chithigun23/DesktopSpeaker/ai-files/reports/web-viewer-realism-2026-11-03/mobile_gallery.jpg

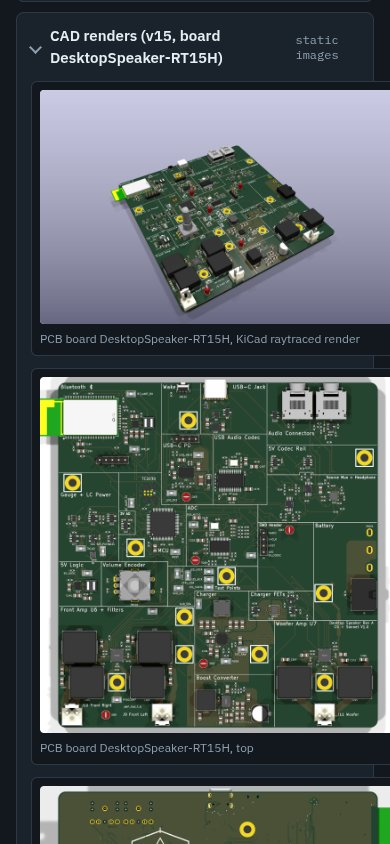
ai-files/reports/web-viewer-realism-2026-11-03/mobile_gallery.jpg
