chithigun23/DesktopSpeaker/ai-files/bom/hardware-buy-list.md

# Hardware and consumables buy list (one unit + second-unit column)

First compiled 2026-10-12; **updated 2026-11-03 for the fastener schedule and the CAD completeness review fixes** (`reports/fastener-schedule-2026-11-03.md`, `reports/project-review-cad-completeness-2026-11-03.md`, decisions in `reports/review-fixes-2026-11-03.md`). Everything needed to build one complete DesktopSpeaker that is NOT on `bom/DesktopSpeaker_JLC_BOM.csv` (SW101 is excluded from that BOM and is listed here). Machine-readable source: `bom/hardware-buy-list.csv`; this file is rendered from it by `helpers/render_hardware_buylist_md.py` (# = CSV data row, numbering stable: new lines are appended at the end, superseded lines keep their number with quantity 0 and a dated note).

**All prices and stock figures are snapshots (2026-10-12 or 2026-11-03, date per line; some from search-result snippets). They are not quotes. Re-check every line at order time. Shipping, GST/import duty and currency fees are not included.** Digi-Key, Mouser, LCSC, Parts Express and Tag-Connect prices are USD; Australian stores are AUD (Core, Jaycar and Bolt and Nut figures include GST). Digi-Key AU prices are AUD **ex GST**; Polymax is GBP inc VAT. Totals convert USD at an ASSUMED 1.50 AUD/USD and GBP at 2.00 AUD/GBP (rates not looked up).

Price status: **confirmed** = price read from the store page/listing; **estimate** = guessed or snippet-only figure; **TBD** = no source or quote; **printed** = made from the filament line, no purchase; lines marked *optional* or *superseded* are excluded from subtotals. Spares: at least 10 % on every new fastener and seal line (2026-11-03).

## Drivers

| # | Item | Qty (unit 1) | 2nd unit | Spec | Source / part number | Unit price | Line price | Stock / date | Status | Notes |
|---|---|---|---|---|---|---|---|---|---|---|
| 1 | Full-range driver Dayton Audio ND65-4 | 2 | 2 | 2.5 in aluminium cone, 4 ohm, 64 mm flange | [Parts Express (US)](https://www.parts-express.com/Dayton-Audio-ND65-4-2-1-2-Aluminum-Cone-Full-Range-Driver-290-204): 290-204 | USD 23.98 | USD 47.96 | 395 in stock (PE page via search, undated) | confirmed | Rear-mounted; needs 59.5 mm aperture (CAD has it). Solder tabs: no connectors needed at the driver. |
| 2 | Woofer Tang Band W3-2052SC | 1 | 1 | 3 in, 4 ohm, flange 82.55, cutout 76.2 | [Parts Express (US)](https://www.parts-express.com/Tang-Band-W3-2052SC-3-RBM-Neodymium-Subwoofer-4-Ohm-299-572): 299-572 | USD 29.98 | USD 29.98 | In stock, ships next business day (PE page 2026-10-12) | confirmed | 2026-11-03: CAD v13+ geometry: square 82.55 frame (R4), 4 x 3.4 holes on a 96.52 mm bolt circle (68.25 mm square), frame block 13.3, factory 3.3 mm foam gasket, seated directly on the floor (no ring, no recess); screws button post-Torx M3x20 (row 44). All are photo estimates (+-1.5): caliper the sample before printing; check its termination (PHR-2 pigtail in the photo, UNVERIFIED). Was: Bolt circle/hole size UNVERIFIED; measure before fixing screws (CAD v11.2 conflict, clamp-ring fallback). |

## Acoustic

| # | Item | Qty (unit 1) | 2nd unit | Spec | Source / part number | Unit price | Line price | Stock / date | Status | Notes |
|---|---|---|---|---|---|---|---|---|---|---|
| 3 | Acoustic stuffing Acousta-Stuf polyfill | 1 bag (454 g) | 0 (bag covers) | polyester fill; 2026-11-03: 6-8 g per unit in the woofer chamber only, loose, 10 mm off the magnet and the cone back (Qtc about 0.70); the main chamber gets the 10 mm foam lining (row 54). Was: polyester fill; about 30 g per unit (about 10 g woofer chamber, about 20 g main chamber, ASSUMED) | [Parts Express (US)](https://parts-express.com/Acousta-Stuf-Polyfill-1-lb.-Bag-260-317): 260-317 | USD 15.98 | USD 15.98 | In stock on product page; back-ordered on category page (conflicting snapshots) | confirmed | Tune by ear/measurement; one bag serves many units. |
| 4 | Acoustic grille cloth, black | 1 yd (70 in wide) | 0 (covers) | polyester, not flame retardant | [Parts Express (US)](https://www.parts-express.com/Speaker-Grill-Cloth-Black-Yard-70-Wide-260-335): 260-335 | USD 9.98 | USD 9.98 | Listed (category page 2026-10-12) | confirmed | Backs the front grille plate; Mellotone 260-332 is the flame-retardant option (USD 26.80/yd). 2026-11-03: also backs the woofer grille against debris (review S13); the yard covers both plates. |
| 54 | Acoustic lining for the main chamber, about 10 mm (wadding or open-cell foam) | 1 sheet | 0 (covers) | about 0.04 m2: top wall over the drivers (not under the cable path) and the side walls in front of the insert; keeps fibres off the PCB, encoder and jacks | [Jaycar (AU)](https://www.jaycar.com.au/650gsm-acrylic-speaker-dampening-material/p/AX3694): Jaycar AX3694 650 gsm acrylic speaker dampening material | TBD | TBD | not read (Jaycar returned 403) | TBD | 2026-11-03: UNVERIFIED (price, size and thickness not read; 650 gsm wadding is usually thicker than 10 mm uncompressed: trim or compress). Fallback Monacor MDM-3002 open-cell PU foam 480 x 378 x 10 mm, GBP 13.35 ex VAT (Rapid Online UK, UNVERIFIED). |

## Switch

| # | Item | Qty (unit 1) | 2nd unit | Spec | Source / part number | Unit price | Line price | Stock / date | Status | Notes |
|---|---|---|---|---|---|---|---|---|---|---|
| 5 | Battery rocker SW101 CW Industries GRB112B802BR1 | 1 | 1 | SPST 20 A/14 VDC, 20.2 mm hole + key, 0.187 in fastons, panel 1.5-2.5 | [Digi-Key](https://www.digikey.com/en/products/detail/cw-industries/GRB112B802BR1/2349683): GRB112B802BR1 (DK 2349683) | USD 5.09 | USD 5.09 | 7,073 (reports/sourcing-2026-10-12.md) | confirmed | Not on the JLC BOM (panel part). LED unused on the 1S rail. |

## Connectors

| # | Item | Qty (unit 1) | 2nd unit | Spec | Source / part number | Unit price | Line price | Stock / date | Status | Notes |
|---|---|---|---|---|---|---|---|---|---|---|
| 6 | Faston receptacle 0.187 in, fully insulated, 22-18 AWG | 3 | 3 | tab 0.187 x 0.032 in (4.75 x 0.8), red | [Digi-Key](https://www.digikey.com/en/products/result?keywords=2-520194-2): TE 2-520194-2 (DK A27806-ND) | USD 0.35 | USD 1.05 | 58,881 (DK 2026-10-12) | confirmed | 2 used (in/out), 1 to insulate the unused lamp tab. Tab thickness 0.032 assumed from the CAD stand-in (4.8 x 0.8). Note 2-520184-2 is the 0.250 in size (wrong). |
| 7 | J5 mating housing Molex Micro-Fit 3.0 receptacle 3-way | 1 | 1 | 43645-0300, 3.0 mm pitch | [Digi-Key](https://www.digikey.com/en/products/result?keywords=0436450300): Molex 43645-0300 (DK WM1846-ND) | USD 0.42 | USD 0.42 | 115,485 (DK 2026-10-12) | confirmed | Pack RFQ asks the vendor to fit this housing; then this line is a spare/service lead. |
| 8 | Micro-Fit female crimp, 18 AWG, tin (PACK+/PACK-) | 1 strip of 100 | 0 (covers) | 43030-0038, 18 AWG, insulation OD <= 1.85 | [Digi-Key](https://www.digikey.com/en/products/detail/molex/0430300038/6098601): Molex 43030-0038 (DK WM13070CT-ND) | USD 8.19 | USD 8.19 | 583,204 (DK 2026-10-12); cut tape min 100 | confirmed | 43030-0007 does NOT take 18 AWG (20-24 AWG only). Check silicone wire OD against 1.85 mm (FIT0585 OD not stated). |
| 9 | Micro-Fit female crimp, 20-24 AWG, tin (NTC pin) | 2 | 1 | 43030-0007 | [Digi-Key](https://www.digikey.com/en/products/result?keywords=0430300007): Molex 43030-0007 (DK WM1837-ND) | USD 0.2 | USD 0.40 | 701,377 (DK 2026-10-12) | confirmed | For the 24 AWG NTC lead; a 26 AWG lead needs a 26-30 AWG terminal instead. |
| 10 | J9-J11 mating housing JST VHR-2N | 3 (MOQ 20) | 0 (MOQ covers) | VH 3.96 mm, 2-way | [LCSC](https://datasheet.lcsc.com/lcsc/2304140030_JST-VHR-2N_C157900.pdf): JST VHR-2N (LCSC C157900) | USD 0.031 | USD 0.62 | about 249,600 (LCSC listing via search 2026-10-12) | confirmed | Order with the JLC/LCSC batch. Digi-Key alternative 455-VHR-2N-ND USD 0.11 (90,067). |
| 11 | JST VH crimp SVH-21T-P1.1 | 6 (MOQ 100) | 0 (MOQ covers) | 18-22 AWG | [LCSC](https://www.lcsc.com/product-detail/C160349.html): JST SVH-21T-P1.1 (LCSC C160349) | USD 0.0282 | USD 2.82 | 247,900 (LCSC 2026-10-12) | confirmed | Digi-Key sells it on full reels only. |

## Wire

| # | Item | Qty (unit 1) | 2nd unit | Spec | Source / part number | Unit price | Line price | Stock / date | Status | Notes |
|---|---|---|---|---|---|---|---|---|---|---|
| 12 | Speaker wire 20 AWG figure-8 | 1 m | 1 m | 2 x 20/0.18; drivers 2 x about 0.25 m + woofer about 0.15 m (J11 lead through the grommet) | [Core Electronics (AU)](https://core-electronics.com.au/20-awg-figure-8-speaker-cable-per-metre.html): AW2116 | AUD 1.7 | AUD 1.70 | 127 (Core 2026-10-12) | confirmed | Jaycar WB1704 (21 AWG, A$0.80/m) is an alternative. 2026-11-03 (review S9 slack for the assembly order): cut J9 about 110 mm, J10 modelled + 40 (about 336 / 292 mm), J11 adapter modelled + 40 (about 235 mm): about 0.7 m of pair; 1 m still covers. |
| 13 | Silicone wire 18 AWG, 1 m red + 1 m black | 1 pack (optional) | 0 (optional) | 0.75 mm2 tinned, 22 A, -60..200 C | [Core Electronics (AU)](https://core-electronics.com.au/high-temperature-resistant-silicone-wire-18awg-0-75mm2-1m-red-black.html): DFRobot FIT0585 | AUD 5.28 | AUD 5.28 | 17 (Core 2026-10-12) | confirmed (optional, excluded) | 2026-11-03: optional alternative for the rocker leads (more flexible; insulation OD not stated, too thick for Micro-Fit crimps). Default is the thin-wall 18 AWG wire of row 57 for both the rocker leads and a J5 service lead. Was: Rocker leads (2 x about 0.12 m) and a spare/DIY pack lead. RFQ lead is 150 mm but the CAD harness route is about 230 mm: align before ordering the pack. (2026-11-03: the 1S4P RFQ asks for about 180 mm; CAD v15 route about 131 mm.) |
| 57 | Thin-wall hook-up wire 18 AWG ETFE, OD 1.52 mm, 2 ft red + 2 ft black | 4 ft (2 + 2) | 4 ft | TE Raychem Spec 55, 19/30 tinned copper, 600 V, -65..150 C. Rocker SW101 leads 2 x about 150 mm with a 60-80 mm service loop; J5 service/spare lead (fits the Micro-Fit 43030-0038, insulation max 1.85) | [Digi-Key AU](https://www.digikey.com.au/en/products/detail/te-connectivity-raychem-cable-protection/55A0111-18-0/2399856): TE 55A0111-18-0 black (A$2.67/ft) + 55A0111-18-2 red (A$2.53/ft) | AUD 2.60 | AUD 10.40 | 2,217 ft black / 3,256 ft red (DK AU 2026-11-03) | confirmed | 2026-11-03: VERIFIED. Unit price is the mean of the two colours per foot (line = 2 x 2.67 + 2 x 2.53). 18 AWG kept for the rocker (pack current path, up to about 9 A); the 20 AWG 55A0111-20-x (OD 1.27, A$1.93/ft) was not chosen. Row 13 silicone becomes optional. |

## Mechanical

| # | Item | Qty (unit 1) | 2nd unit | Spec | Source / part number | Unit price | Line price | Stock / date | Status | Notes |
|---|---|---|---|---|---|---|---|---|---|---|
| 14 | Encoder knob (SW102) | 0 (superseded 2026-11-03) | 1 | 29 x 14 mm solid aluminium, grub screw, 1/4 in (6.35) bore | [Jaycar (AU)](https://www.jaycar.com.au/29mm-black-anodised-knob/p/HK7011): HK7011 | AUD 10.95 | AUD 0.00 | Available for delivery (Jaycar category page 2026-10-12) | superseded | 2026-11-03: superseded by row 64 (true 6 mm bore; the 6.35 bore sits 0.35 mm off-centre on the 6 mm shaft). Was: ASSUMED fit: 6.35 bore on the 6 mm D shaft with the grub screw on the flat (0.35 mm offset). 29 mm in the 36 mm dish (3.5 mm radial gap). No 30 mm 6 mm-D knob found in AU stock; UK alternative Cliff CL172989 (30 x 13, 6 mm set screw, GBP 7.01, Maplin Pro). |
| 15 | Heat-set insert M3 x 5.7, OD 4.6, hole 4.0 | 1 bag of 100 | 0 (51 + 46 = 97 of 100) | brass, 46 per unit (2026-11-03: lid 11, drivers 8, woofer 4, PCB 11, feet 4, knob cup 4, woofer-chamber insert 4); 51 with 10 % spares | [RS Australia](https://ie.rs-online.com/web/p/products/2040616): RS PRO 204-0616 | AUD 30 | AUD 30.00 | AUD price/stock NOT read (RS AU blocks fetch); IE price EUR 17.39 ex VAT per 100 | estimate | AUD figure is an estimate. Confirmed but expensive fallback: Amazon AU ruthex GE-M3x57-001 A$76.59 in stock (2026-10-12); 3DJake EUR 7.49 + EUR 40.49 DHL to AU. |
| 16 | Socket cap screw M3 x 10, 316 stainless | 0 (superseded 2026-11-03) | 0 (23+23 = 46) | ISO 4762 type; 23 per unit (8 drivers + 4 woofer + 11 lid) | [Miniature Bearings Australia](https://miniaturebearings.com.au/collections/screws-socket-cap-stainless): SC030M-010-C-SK-S6 | AUD 8.77 | AUD 0.00 | Available (store JSON 2026-10-12) | superseded | 2026-11-03: superseded everywhere (lid, drivers, knob cup, insert: row 40; woofer: row 44). Was: 2026-11-03: drivers and lid now use the countersunk post-Torx T10 M3x10 (lines 41-43); the woofer uses M3x20 since CAD v13 (not on this list). Was: Woofer screws may change (bolt circle unverified; M2.5 or clamp-ring fallback). |
| 17 | Socket cap screw M3 x 16, 304 stainless | 0 (superseded 2026-11-03) | 0 (covers) | 11 per unit (PCB H1-H9, HA1, HA2) | [Miniature Bearings Australia](https://miniaturebearings.com.au/collections/screws-socket-cap-stainless): SC030M-016-C-SK-S4 | AUD 7.68 | AUD 0.00 | Available (store JSON 2026-10-12) | superseded | 2026-11-03: superseded by button post-Torx M3x10 (row 43) on Wurth 971100321 M/F standoffs (row 46); ball-end hex keys are not used any more. Was: H8 sits under the knob dish floor: drive with a 2.5 mm ball-end key before the lid goes on. |
| 18 | Socket cap screw M3 x 6, 304 stainless (OPTIONAL) | 0 (8 if pads removed) | 0 | only if the 11 mm driver pads are removed (3 mm baffle) | [Miniature Bearings Australia](https://miniaturebearings.com.au/collections/screws-socket-cap-stainless): SC030M-006-C-SK-S4 (pack 100) | AUD 9.59 | AUD 0.00 | Available (store JSON 2026-10-12) | confirmed (optional, excluded) | Not needed for the v11.2 CAD (pads present). Excluded from subtotals. |
| 19 | Hex spacer M3 F/F 10 mm, 5.5 AF | 0 (superseded 2026-11-03) | 11 | steel zinc, WA-SSTII | [Digi-Key](https://www.digikey.com/en/products/result?keywords=970100321): Wurth 970100321 (DK 732-10541-ND) | USD 0.29 | USD 0.00 | 26,262 (DK 2026-10-12) | superseded | 2026-11-03: superseded by the M/F standoff Wurth 971100321 (row 46, steel) and a nylon standoff at H9 (row 47). Was: PCB stack: roof z 57 -> 10 mm spacer -> PCB -> M3x16. |
| 20 | Feet stud M3 M/F, 12 mm body, 6 mm male | 4 | 4 | steel; = RS 176-8061 | [Digi-Key](https://www.digikey.com/en/products/result?keywords=1768061): Wurth 971120321 (DK, page search) | USD 0.48 | USD 1.92 | 3,120 (DK 2026-10-12) | confirmed | The brief's "Wurth 1768061" is the RS stock number 176-8061; the Wurth MPN is 971120321. |
| 21 | Rubber foot disc 12.7 dia x 3.5 | 0 (superseded 2026-11-03) | 4 | 3M Bumpon SJ5312 clear PU dome, adhesive | [element14 AU](https://my.element14.com/3m/sj-5312-clear/feet-protective-bumper-pu-3-5mm/dp/2674622): 3M SJ-5312 CLEAR (e14 2674622) | AUD 0.35 | AUD 0.00 | AUD not read; Farnell IE EUR 0.19, 2,270-2,763 in stock | superseded | 2026-11-03: a glued bumper on the 5.5 AF stud end shears off when the speaker is slid (review S12): superseded by screw-in rubber feet (row 63). Was: 12.7 x 3.5 vs CAD 12 x 3: feet gap 15.5 instead of 15. Glue to the stud end (5.5 AF face is small; add CA/epoxy). |
| 22 | Nylon flat washer M3 (lid screw seal) | 0 (removed 2026-11-03, superseded) | 11 | 3.2 x 8.0 x 0.8 nylon | [Digi-Key](https://www.digikey.com/en/products/result?keywords=nylon%20washer%20M3%20flat): Essentra 16M03080080 | USD 0.1 | USD 0.00 | 30,563 (DK 2026-10-12) | superseded | 2026-11-03: removed: a flat washer cannot sit under the flush countersunk lid screws. The 4 lid screws inside the woofer-chamber loop get foam washers cut from the 1.5 mm sheet in boss counterbores (CAD v16) or a non-curing butyl dab. Was: Plain nylon washer, not a bonded sealing washer (none found in AU stock); add a dab of sealant if the lid leaks. |
| 23 | Snap bushing / grommet, woofer leads | 2 | 1 | Heyco 2000: 0.250 in (6.35) hole, panel <= 0.062 in (1.57), ID 0.140 in (3.56), PA66 black | [Digi-Key](https://azcus.digikey.com/en/products/detail/heyco-products-corporation/2000/15906424): Heyco 2000 (DK 3720-2000-ND) | USD 0.1 | USD 0.20 | 265,521 (DK via search 2026-10-12) | confirmed | 2026-11-03: CAD v16 sets the hole to 6.35 mm and the web to 1.5 mm (inside the 1.57 rating); no reaming. Re-checked on Digi-Key AU 2026-11-03: A$0.15 ex GST, 221,582 in stock, lead time 3 weeks. ID: Digi-Key 3.56 mm (0.140 in) but a GlobalSpec datasheet copy says 0.125 in (3.18): the J11 pair (2 x OD 1.75 = 3.5 x 1.75) needs the 3.56 figure: confirm on the part. Was: CAD hole is 6.0: ream to 6.35 or change the CAD to 6.35. Web is 1.6 (0.03 over the 1.57 rating, check fit). Seal leads with Sikaflex. |
| 24 | Hook-and-loop strap (battery) | 1 | 1 | 2026-11-03 (1S4P pack): loop about 330 mm (2 x (87 + 22) + anchors): order >= 350 mm. CE09642 is 300 mm (210 loop + 60 hook): too short for 1S4P; width NOT stated | [Core Electronics (AU)](https://core-electronics.com.au/hook-and-loop-strap-with-buckle.html): CE09642 | AUD 0.39 | AUD 0.39 | 399 (Core 2026-10-12) | estimate | 1S4P: one 20 mm strap around the brick in the X-Z plane (CAD v15, tunnels 22 x 2.5 in the two side anchor blocks). Order a >= 350 mm strap or cut one from the VELCRO ONE-WRAP 20 mm roll (element14 3499736, price not read). The price shown is for the 300 mm CE09642 (too short) and is kept as a placeholder. Width and buckle thickness UNVERIFIED. |
| 40 | Countersunk post-Torx (T10 security) machine screw M3 x 10, A2-70 (304) stainless | 30 | 27 | M3 x 0.5, 90 deg countersunk, head 5.90 x 2.00, T10 post (pin) Torx, length 10 overall incl. head; 27 per unit: 11 lid + 8 drivers (on cup washers, row 42) + 4 knob cup + 4 woofer-chamber insert; 30 with 10 % spares | [Bolt and Nut Australia (Hobson Engineering)](https://www.boltandnut.com.au/m3-x-0-50p-coarse-stainless-a2-70-g304-countersunk-post-torx-t10-machine-screws): 22CPTS310 (maker MPN YCXSA2M3X10) | AUD 0.63 | AUD 18.90 | 29,590 (page JSON 2026-11-03) | confirmed | 2026-11-03 fastener schedule: tiers per piece 10+ 1.00, 20+ 0.75, 30+ 0.63, 50+ 0.42 (50 cost AUD 21.00 and cover a second unit). Lid thread 6.0 below the lid, driver about 7.5 engaged (5.7 insert full). Was: qty 19, price not read. |
| 42 | Cup washer 6g (3.5 mm) G304 stainless, OD 11.0-11.4, ID 4.1-4.5, cup 2.1-2.3, 90 deg | 10 | 8 | under the countersunk M3 post-Torx heads on the 0.75 mm ND65 flanges (8 per unit) + 2 spares | [Bolt and Nut Australia (Hobson Engineering)](https://www.boltandnut.com.au/washers/cup-washers/6g-3-5mm-g304-stainless-cup-washers): 71CS6 | AUD 0.64 | AUD 6.40 | In stock (page 2026-11-03) | confirmed | 2026-11-03: replaces the unsourced 8 x 1.6 countersunk washer (same row). 10+ tier; 10 cost less than 9. Fit of the 5.90 head in the 6g cup calculated from geometry, not tested; CAD v16 checks the 11.4 OD against the ND65 basket ribs. |
| 43 | Button post-Torx (T10 security) machine screw M3 x 10, A2-70 (304) stainless | 12 | 10 | M3 x 0.5, button head 5.11-5.70 x 1.60-1.80, length 10 under the head; PCB H1-H8, HA1, HA2 into the Wurth 971100321 standoffs (8.4 mm in the steel thread); 10 per unit + 10 % + 1 so H9 can fall back to steel | [Bolt and Nut Australia (Hobson Engineering)](https://www.boltandnut.com.au/security-fasteners/machine-screws/m3-x-0-50p-coarse-stainless-a2-70-g304-button-post-torx-t10-machine-screws): 22BPTS310 | AUD 1.00 | AUD 12.00 | 20,345 (page JSON 2026-11-03) | confirmed | 2026-11-03 fastener schedule; replaces row 17 (M3x16 socket). Tiers 10+ 1.00, 20+ 0.70. H9 uses a nylon screw (row 48). |
| 44 | Button post-Torx (T10 security) machine screw M3 x 20, A2-70 (304) stainless | 5 | 4 | M3 x 0.5, button head 5.11-5.70 x 1.60-1.80, length 20 under the head; woofer W3-2052SC (frame 13.3 + factory gasket 3.3) | [Bolt and Nut Australia (Hobson Engineering)](https://www.boltandnut.com.au/security-fasteners/machine-screws/m3-x-0-50p-coarse-stainless-a2-70-g304-button-post-torx-t10-machine-screws): 22BPTS320 | AUD 1.60 | AUD 8.00 | 29,639 (page JSON 2026-11-03) | confirmed | 2026-11-03: replaces the never-listed ISO 4762 M3x20 (review 3.2 #1). Engagement 3.4 mm free / 4.4 mm compressed (marginal); 5.4-5.7 with the optional 2 mm floor-boss tweak after calipering. 20 is the longest M3 button post-Torx at Bolt and Nut. |
| 46 | Hex standoff M3 M/F, 10 mm body + 6 mm stud, 5.5 AF, steel zinc | 12 | 10 | PCB H1-H8, HA1, HA2: stud into the roof insert, button M3x10 into the female end; 10 per unit + 10 % + 1 for an H9 steel fallback | [Digi-Key](https://www.digikey.com/en/products/result?keywords=971100321): Wurth 971100321 (DK 732-10398-ND) | USD 0.33 | USD 3.96 | 32,433 (DK 2026-11-03) | confirmed | 2026-11-03: replaces row 19 (F/F 970100321 + M3x16). Female thread depth UNVERIFIED (RS listing: hole depth 10); if < 8.5 mm use button M3x8 (Bolt and Nut 22BPTS38). |
| 47 | Nylon (polyamide) hex standoff M3 M/F, 10 mm body + 8 mm stud, 6 mm hex, black (H9) | 2 | 1 | H9 only (nearest metal to the BM83 antenna, 16.3 mm): stud into the roof insert, nylon screw into the female end. **Trim the 8 mm stud to 6 mm** (pilot floor is 6.7 below the insert top) or add a nylon washer | [Digi-Key AU](https://www.digikey.com.au/en/products/detail/w%C3%BCrth-elektronik/971100365/9488760): Wurth 971100365 (DK 732-13056-ND) | AUD 1.33 | AUD 2.66 | 4,877 (DK AU 2026-11-03) | confirmed | 2026-11-03: VERIFIED. Wurth nylon M/F appears to come only with an 8 mm stud. Fallback Wurth 970100365 nylon F/F 10 mm (AUD 1.27, 2,424) is not usable here (no screw can enter the roof insert from below). Price ex GST (assumed; not labelled). |
| 48 | Nylon (PA66) machine screw M3 x 10, pan head Phillips (H9) | 2 | 1 | M3, 10 under the head, pan head 5.5 mm; through the PCB (1.6) into the nylon standoff (about 8.4 mm engaged) | [Digi-Key AU](https://www.digikey.com.au/en/products/detail/w%C3%BCrth-elektronik/97791003111/10056389): Wurth 97791003111 (DK 732-13706-ND) | AUD 0.38 | AUD 0.76 | 14,984 (DK AU 2026-11-03) | confirmed | 2026-11-03: VERIFIED. Not tamper-resistant (Phillips), acceptable inside the sealed box. Bolt and Nut showed no nylon M3 screw or standoff (partial read of the pan-head list; nylon washers only). |
| 63 | Screw-in rubber foot, M3 x 6 male stud, 8 mm dia x 8 mm (into the stud female end) | 5 | 4 | screws into the female end of the Wurth 971120321 foot stud (row 20); floor gap becomes 12 + 8 = 20 mm (CAD v16 updates the woofer gap and tipping). 4 + 1 spare | RS Components AU: RS PRO 196-1356 (M3 x 6 male buffer, 8 x 8 mm, 45 Shore A) | TBD | TBD | not read (RS AU returned 403) | TBD | 2026-11-03: UNVERIFIED. No 12-16 mm diameter buffer with an M3 stud was found anywhere (catalogue M3 buffers are 8 mm). Options: (a) this 8 x 8 M3 buffer on the stud (keeps the stud, small contact patch; a 12.7 mm Bumpon can be stuck on its face); (b) Ruland VMS8-8-M3-55-SSNR/10PK 8 x 8 (UNVERIFIED stock); (c) change the 4 foot inserts to M4 and drop the stud: Small Parts and Bearings CMB01513040MR60 15 x 13 mm M4 buffer (gap 13 mm; UNVERIFIED, site 429). Owner/CAD decision. Replaces row 21. |
| 64 | Encoder knob, knurled aluminium, 6.00 mm bore, 2 set screws, 31.75 mm skirt x 15.88 mm (SW102) | 1 | 1 | Kilo International DDS-90-4-7, black matte, skirted, arrow on the skirt; knurled body 23.5 mm. For the Alps EC11E18244AU 6 mm flat (D) shaft, 20 mm actuator (Alps product list: flat shaft, 20 mm) [the 6 mm diameter is from the CAD stand-in / EC11 family, D]. Tighten one set screw on the flat | [Digi-Key AU](https://www.digikey.com.au/en/products/detail/kilo-international/DDS-90-4-7/305224): Kilo DDS-90-4-7 (DK 305224) | AUD 26.82 | AUD 26.82 | 26 (DK AU 2026-11-03); maker lead time 12 weeks after stock | confirmed | 2026-11-03: VERIFIED (ex GST; A$29.50 inc). Replaces row 14 (6.35 bore). In the 36 mm cup: about 2.1 mm radial gap at the skirt; the knurled body above the skirt gives the grip the review S6 asked for; 15.88 tall vs the 14 mm stand-in, so CAD v16 must re-check the top height. No finger dimple. Fallbacks: Kilo DDS-75-3-7 (25.4 skirt, A$25.84, 37); Same Sky SAK-002 (28.9 x 12, 6 mm D bore: ideal, but MOQ 2268, not orderable); Altronics H6224 29 x 14 (A$5.05) has the 6.35 bore problem. |

## Seal

| # | Item | Qty (unit 1) | 2nd unit | Spec | Source / part number | Unit price | Line price | Stock / date | Status | Notes |
|---|---|---|---|---|---|---|---|---|---|---|
| 25 | Lid gasket cord, closed-cell EPDM sponge 3 mm | 0 (superseded 2026-11-03) | 0 (covers) | 0.75 m per unit (outer loop 0.51 + chamber U 0.23); allow 1 m | [Essentra Components AU](https://ecompreprod.essentracomponents.com/en-au/p/round-cord-gasket/551809): 551809 | AUD 9.52 | AUD 0.00 | Price from a search snippet of the Essentra AU preprod site; stock not read | superseded | 2026-11-03: 3 mm cord fills the 2.0 x 1.5 groove 235 % (review S4): superseded by 2 mm cord (row 50). Was: Verify on essentracomponents.com/en-au. Groove is 2 x 1.5: 3 mm sponge compresses about 50 %. |
| 26 | Driver/woofer gasket, closed-cell foam sheet 0.5-1 mm | 0 (superseded 2026-11-03) | 0 (covers) | 2 x 63 mm square rings (aperture 59.5) + 1 ring 83 OD/76.2 ID | NOT SOURCED: - | TBD | TBD | - | superseded | 2026-11-03: superseded by the sourced foam sheets rows 51-53 (3 mm for the driver gaskets per the coordinator; woofer ring only if the factory gasket is missing). Was: No source confirmed. PE gasket tape 260-542 is 3.2 mm thick and 12.7 wide: too thick/wide for the 0.5 mm recess. Use 0.5-1 mm neoprene/EPDM/PE foam sheet with adhesive. |
| 27 | PU sealant/adhesive Sikaflex-11FC, black 300 ml | 1 | 0 (covers) | 2026-11-03: grille plates and grommet leads only; the woofer-chamber insert is now screwed on a 1.5 mm foam gasket (removable), not bonded. Was: chamber insert to shell grooves, grille plates, grommet leads | [Bunnings (AU)](https://www.bunnings.com.au/sika-300ml-black-sikaflex-11fc-purform_p0628964): Sika 11FC black 300 ml (Bunnings p0628964) | AUD 27 | AUD 27.00 | Listed A$27 (Bunnings via search, undated) | confirmed | One PU product replaces separate epoxy/silicone. Needs a caulking gun. |
| 50 | Lid gasket cord, EPDM sponge 2 mm round | 2 m | 0 (covers) | lid groove 2.0 x 1.5: outer loop 0.51 + chamber U 0.23 = 0.75 m per unit; 2 m covers spares and one refit. Also usable for the woofer-chamber insert floor groove if CAD v16 cuts one | [Polymax (UK)](https://www.polymax.co.uk/epdm-sponge-cord-2mm): Polymax 2004200 | GBP 3.55 | GBP 7.10 | In stock (page 2026-11-03) | estimate | 2026-11-03: price VERIFIED (inc VAT, per metre); **closed-cell not stated on the page** (EPDM sponge cord normally is: confirm); 2.0 +-0.5 mm, 45 Shore A; AU freight not checked. No AU retail 2 mm source found (Associated Gaskets lists EPDM sponge cord from 3 mm). Replaces row 25. |
| 51 | Closed-cell foam sheet 2 mm, adhesive one side (connector-face seals) | about 150 x 100 mm | 0 (covers) | lid inner face around J1 (cut-out 8.6 x 2.9), J2/J3 (holes 5.0 or the v16 bore), SW100 (5.0): one die-cut piece or four pads; about 25 % compression against the connector faces | NOT SOURCED (Clark Rubber store cut suggested): - | TBD | TBD | - | TBD | 2026-11-03: UNVERIFIED: no A4-size adhesive 2 mm closed-cell sheet verified at an AU retailer (RS AU blocked fetches). Options: Clark Rubber or Foam Sales store cut; craft EVA self-adhesive A4 sheet (Spotlight/Officeworks, not verified, EVA is closed-cell). |
| 52 | Closed-cell neoprene self-adhesive tape 12 mm x 3 mm (driver gaskets, encoder washer) | 2 m | 0 (covers) | driver gaskets: 63 mm square frame of strips (ring width 1.75 mm at the flats, cut from the 12 mm strip), 2 drivers about 0.5 m; encoder washer ID 7 / **OD 12** (the strip is 12 mm wide; review asked OD 14) x 3 mm; woofer ring only if the sample has no factory gasket | [Clark Rubber (AU)](https://www.clarkrubber.com.au/products/15471p-neoprene-cr-self-adhesive-tape-3mm-black): Clark Rubber 15471P neoprene (CR) self-adhesive tape 3 mm | AUD 5.50 | AUD 11.00 | not shown (buy online or in store, 2026-11-03) | confirmed | 2026-11-03: price VERIFIED ("from" A$5.50 per metre on the category page; range stated closed-cell). Softer alternative Clark Rubber 15496P EPDM414 supersoft 12 x 3 mm from A$3.95/m. Replaces row 26. 3 mm is the coordinator choice: CAD v16 sets the driver recess for it. |
| 53 | Closed-cell foam sheet 1.5 mm, adhesive one side (woofer-chamber insert gasket, knob-cup ring, lid screw washers) | 1 piece about 200 x 150 mm | 0 (covers) | woofer-chamber insert floor gasket (removable insert), knob-cup flange ring (46 mm), 4 lid-screw washers ID 3.2 / OD 7.5 if CAD v16 adds the boss counterbores | [RS Components AU (or Clark Rubber store cut)](https://hkcn.rs-online.com/web/p/rubber-sheets/7336753): RS PRO 733-6731 closed-cell neoprene sponge 1.5 mm, 1 x 2 m (adhesive backing unconfirmed) | TBD | TBD | not read (RS AU returned 403) | TBD | 2026-11-03: UNVERIFIED (listings conflict on adhesive backing; 1 x 2 m is far more than needed). Alternatives: Inseal 3259 closed-cell PVC tape 1.5 x 30 mm x 50 m A$87.40 + GST (PB Tech, UNVERIFIED); a 2 mm cord in a groove instead of the flat gasket if CAD v16 chooses it. |
| 66 | Encoder foam washer ID 7 / OD 12 x 3 mm (cut from row 52) | 2 (1 + spare) | 1 | on the SW102 bushing top under the knob-cup floor, compresses to about 2.1 mm; closes the 1.25 mm radial shaft gap (review S1b, 28.5 mm2) | cut from row 52: - | - | - | - | cut (no purchase) | 2026-11-03: no purchase. |

## Grille

| # | Item | Qty (unit 1) | 2nd unit | Spec | Source / part number | Unit price | Line price | Stock / date | Status | Notes |
|---|---|---|---|---|---|---|---|---|---|---|
| 28 | Front grille plate 163 x 100, 0.8 mm, 2 x 56 dia perforated zones (2.0 holes / 3.0 pitch) | 1 order (5 pcs) | 0 (5 pcs) | SPEC CHANGE PROPOSED: 0.8 mm black FR4 with NPTH holes instead of aluminium | [JLCPCB (quote)](https://jlcpcb.com): own Gerber (to be drawn) | USD 15 | USD 15.00 | Not quoted | estimate | Estimate only. Metal option: Metal Mesh (Sefar AU) 1 mm aluminium 2.0/3.5 pitch, custom quote; RS PRO 202-7877 0.6 mm sheet is A$189/3 sheets with 1.5 mm holes (rejected). |
| 29 | Woofer grille disc 90 dia, 0.8 mm, holes to 64 dia | 1 order (5 pcs) | 0 (5 pcs) | same process as the front plate | [JLCPCB (quote)](https://jlcpcb.com): own Gerber (to be drawn) | USD 10 | USD 10.00 | Not quoted | estimate | Estimate only. |

## Print

| # | Item | Qty (unit 1) | 2nd unit | Spec | Source / part number | Unit price | Line price | Stock / date | Status | Notes |
|---|---|---|---|---|---|---|---|---|---|---|
| 30 | Filament PETG 1.75 mm, black, 1 kg | 1 | 1 | (384 + 101 + 60) cm3 x 1.27 g/cm3 = 692 g, +20 % = 831 g | [Jaycar (AU)](https://jaycar-prod.australia-southeast1.gcp.storefrontcloud.io/1-75mm-black-esun-petg-filament-1kg-roll/p/TL4465): eSUN PETG TL4465 | AUD 39.95 | AUD 39.95 | Listed A$39.95 (Jaycar via search, undated) | confirmed | STL volumes treated as solid (conservative). 831 g leaves little margin for a failed print. ASA is the heat/UV alternative. 2026-11-03: add the knob cup, 3 SW100 plungers and the tie bridges (small; volumes from CAD v16). One roll is tight: a second roll for reprints is advisable. |
| 67 | Printed main shell (PETG), incl. printed cable-tie bridges | 1 | 1 | CAD v16 (`ai-files/cad/v16/`): knob-cup opening and insert bosses, floor screw holes for the removable insert, tie bridges, cradle re-cut from the vendor drawing | printed (row 30): CAD v16 STL | - | - | - | printed (no purchase) | 2026-11-03: do not print before CAD v16 passes its insertion-path and tool-access check and the woofer has been calipered. |
| 68 | Printed rear lid 4 mm (PETG) | 1 | 1 | CAD v16: SW100 counterbore 7.4 x 1.0, gasket groove 2.0 x 1.5, 11 countersinks; vents drilled after printing (row 65) | printed (row 30): CAD v16 STL | - | - | - | printed (no purchase) | 2026-11-03: outer face on the bed; labels (if added in v16) print mirrored. |
| 69 | Printed woofer-chamber insert (PETG), removable | 1 | 1 | CAD v16: 4 boss feet with inserts for the floor screws, foam gasket land, grommet hole 6.35 / web 1.5 | printed (row 30): CAD v16 STL | - | - | - | printed (no purchase) | 2026-11-03: roof down, no supports (as v15). |
| 70 | Printed knob cup (PETG), new | 1 | 1 | CAD v16: 36 mm dish, 3 mm wall and floor, 8.5 shaft hole, 46 mm flange, 4 countersunk screw holes | printed (row 30): CAD v16 STL | - | - | - | printed (no purchase) | 2026-11-03: new part (review M1 option b). |
| 71 | Printed SW100 plunger (PETG), 3 variants | 3 (fit 1) | 3 | nub lengths 0.4 / 0.6 / 0.8 mm; shank 4.6, flange 7.0 x 0.8, nub 1.8 dia | printed (row 30): CAD v16 STL | - | - | - | printed (no purchase) | 2026-11-03: keep the variant that clicks without preload (TE travel unknown, about 0.25 mm assumed). |

## Battery

| # | Item | Qty (unit 1) | 2nd unit | Spec | Source / part number | Unit price | Line price | Stock / date | Status | Notes |
|---|---|---|---|---|---|---|---|---|---|---|
| 31 | 1S4P 21700, 20 Ah (4 x INR21700-50S, same lot, matched within 10 mV before welding), PCM >= 10 A continuous / 20 A for 1 s, over-current trip 12-20 A, charge limit >= 5 A, OV 4.25 V, per-cell fusible links, 10k NTC (B3435) glued between the two middle cells, max 87.0 x 75.0 x 22.3 mm including wrap, PCM, fuse and TCO, 15 A PACK+ fuse, about 85 C thermal cut-off, PCM on the positive end, thin-wall 18 AWG leads (OD <= 1.7) about 180 mm, Micro-Fit 43645-0300 | 1 | 1 | Owner decision 2026-11-03 (was 1S2P 10 Ah, max 73 x 44 x 22); CAD v15 cradle allows 87.4 x 75.7; see reports/battery-pack-rfq.md | [RFQ: Keeppower / CM Batteries](https://cmbatteries.com/project/1s2p-battery-pack/): quote | TBD | TBD | No price; quote needed | TBD | PLACEHOLDER: not in any subtotal. No price; cell price unknown. Ask the vendor for the fusing and PCM specification (part number, OCP trip and delay, OV, charge limit, drain). UN38.3 documents and shipping to AU not confirmed. 2026-11-03 review fixes: the RFQ adds a 15 A fuse in PACK+ and an about 85 C thermal cut-off (rows 60-61) and limits the thickness to 22.3 mm (cradle usable thickness; 23.0 superseded). |
| 32 | Spare NTC 103AT-2 (10k, B 3435) | 1 | 1 | Semitec 103AT-2 | [Digi-Key](https://www.digikey.com/en/products/result?keywords=103AT-2): 4316-103AT-2-ND | USD 0.68 | USD 0.68 | 5,077 (DK 2026-10-12) | confirmed | For bench testing of the TS network or a DIY pack. |
| 60 | PACK+ fuse 15 A (fitted by the pack vendor; RFQ item 2) | 1 (in the pack) | 1 (in the pack) | secondary protection at the PCM output: carries 10 A continuous and 20 A for 1 s; interrupting rating at 5 V DC above the pack short-circuit current. Example proposed to the vendor: Littelfuse NANO2 0453015.MR (15 A, 65 V, 6.1 x 2.7 x 2.7 mm SMD) | [Pack vendor (RFQ)](https://www.digikey.com.au/en/products/detail/littelfuse-inc/0453015-MR/552266): example Littelfuse 0453015.MR (DK F3142CT-ND, A$5.02 ex GST, 7,141 in stock) | TBD | TBD | vendor to state | TBD | 2026-11-03: part of the pack quote, not a separate purchase (placeholder outside every subtotal). The 0453015 listing is VERIFIED; its 50 A breaking rating (at rated voltage) is UNVERIFIED as adequate for a 4P short (hundreds of A): the vendor must state the interrupting rating. There is no 15 A part in the Littelfuse 456 series (it starts at 20 A). |
| 61 | Thermal cut-off about 85 C (fitted by the pack vendor; RFQ item 2) | 1 (in the pack) | 1 (in the pack) | in thermal contact with the cells, in series with PACK+; >= 15 A DC breaking; hold current >= 10 A at 45 C. Example proposed: Bourns (Komatsulite) NR85AB0 mini-breaker, 85 +-5 C trip, 40 C reset, 5 mOhm, breaks 60 A at 5 V DC | [Pack vendor (RFQ)](https://www.digikey.com.au/en/products/result?keywords=NR85AB0): example Bourns NR85AB0 (DK NR85AB0-ND, A$2.54 ex GST, 19,995 in stock) | TBD | TBD | vendor to state | TBD | 2026-11-03: part of the pack quote (placeholder outside every subtotal). Datasheet https://www.bourns.com/docs/Product-Datasheets/nr.pdf read by the sourcing agent: the A-type also trips on self-heating, about 13 A at room temperature and less when warm, so the hold current at 45 C must be confirmed against the 8.5 A amplifier peaks. Tabs must be welded, not reflowed. Vendor-only alternative Bourns AC85ABD (35 A / 28 V, MOQ 3000). |
| 62 | Inline mini-blade fuse holder + 15 A mini blade fuse (OPTIONAL fallback) | 0 (1 if the vendor declines the fuse) | 0 | in the PACK+ lead between the pack and J5 if the pack vendor cannot fit the 15 A fuse (the 180 mm lead has about 49 mm of slack); confirm the holder leads take 16-18 AWG | [Altronics / Jaycar (AU)](https://www.altronics.com.au/p/s6035-30a-in-line-mount-mini-blade-fuse-holder/): Altronics S6035 holder (A$7.95, in stock) + Jaycar SF1915 15 A mini blade (A$1.30, snippet) | AUD 9.25 | AUD 0.00 | holder in stock; fuse stock not read (2026-11-03) | confirmed (optional, excluded) | 2026-11-03: holder VERIFIED, fuse UNVERIFIED (Altronics S5919 15 A out of stock; S5485 low-profile A$1.15 snippet). Excluded from subtotals. CAD would need to model the holder. |

## Tools

| # | Item | Qty (unit 1) | 2nd unit | Spec | Source / part number | Unit price | Line price | Stock / date | Status | Notes |
|---|---|---|---|---|---|---|---|---|---|---|
| 33 | ST-LINK/V3 MINIE debugger | 1 | 0 | STDC14 output, USB-C | [Digi-Key](https://www.digikey.com/en/products/result?keywords=STLINK-V3MINIE): STLINK-V3MINIE (DK 497-STLINK-V3MINIE-ND) | USD 25.51 | USD 25.51 | 3,490 (DK 2026-10-12) | confirmed | One per workbench, not per unit. |
| 34 | Tag-Connect cable for J7 (legged), STDC14 | 1 | 0 | TC2030 6-pin legged to 14-pin STDC14 (SWD + SWO) | [Tag-Connect (direct)](https://www.tag-connect.com/product/tc2030-ctx-stdc14-for-use-with-stm32-processors-with-stlink-v3): TC2030-CTX-STDC14 | USD 43 | USD 43.00 | Price from tag-connect.com via search; stock not read | confirmed | Replaces the brief's TC2030-IDC-NL: J7 is the legged footprint and the IDC cable would need a separate adapter to the V3MINIE. Digi-Key search found no TC2030-IDC-NL. |
| 35 | USB-I2C/UART adapter, 3.3 V (J4 STUSB4500 NVM, J8 BM83 UART) | 1 | 0 | Adafruit MCP2221A breakout, USB-C | [Core Electronics (AU)](https://core-electronics.com.au/adafruit-mcp2221a-breakout-general-purpose-usb-to-gpio-adc-i2c-stemma-qt-qwiic.html): ADA4471 | AUD 12.3 | AUD 12.30 | OUT OF STOCK on the product page (2026-10-12) | confirmed | UNVERIFIED that MCP2221A UART speed suits isUpdate/Config Tool; a CP2102 3.3 V module is the fallback for J8. |
| 36 | Female-female jumper wires 20 cm, 40 pcs | 1 | 0 | 2.54 mm Dupont for J4/J6/J8 | [Core Electronics (AU)](https://core-electronics.com.au/solderless-breadboard-jumper-cable-wires-female-female-40-pieces.html): CE05098 | AUD 3.95 | AUD 3.95 | Listed (Core via search 2026-10-12) | confirmed |  |
| 37 | USB-C PD tester (PDO/contract readout, up to 240 W EPR) | 1 | 0 | FNIRSI FNB-C2 | [Core Electronics (AU)](https://core-electronics.com.au/test-equipment/usb-meters.html): CE11101 | AUD 58.49 | AUD 58.49 | Listed A$58.49 (Core via search, stock not read) | confirmed | Cheaper V/I-only option: Adafruit ADA6271 A$28.05. |
| 38 | Heat-set insert tip, Hakko T18 (OPTIONAL) | 0 | 0 | M3 / #4-40 | [Core Electronics (AU)](https://core-electronics.com.au/heat-set-insert-for-soldering-irons-4-40-m3-inserts.html): ADA4239 | AUD 22.2 | AUD 0.00 | Listed (Core via search) | confirmed (optional, excluded) | Only if the iron takes Hakko T18 tips. Excluded from subtotals. |
| 39 | Crimp tool for Micro-Fit and VH open-barrel (OPTIONAL) | 0 | 0 | open-barrel ratchet crimper, 18-24 AWG | user choice: - | TBD | TBD | - | TBD (optional, excluded) | Not priced. Avoid by having the pack vendor terminate J5 and by soldering/ordering pre-crimped VH leads. |
| 41 | T10 x 25 mm post-Torx (security, pin) driver bit | 2 | 0 | 1/4 in hex insert bit, T10 with centre hole for the post; Alpha TXSE1025; one + spare | [Bolt and Nut Australia](https://www.boltandnut.com.au/t10-x-25mm-alpha-post-torx-insert-security-standard-driver-bit): 11PT1025A (Alpha TXSE1025) | AUD 7.00 | AUD 14.00 | In stock (page 2026-11-03) | confirmed | 2026-11-03: standalone price 9.00, 2+ 7.00; the screw pages offer it as a bundle at AUD 3.00 (quantity rule not verified). A plain T10 bit does not fit the post. Was: qty 1, bundle AUD 3.00. |
| 45 | T10 post-Torx L-key 90 mm, short arm 19 mm | 2 | 0 | Hobson ISKPT10, alloy tool steel; one for the PCB and woofer screws, one to cut to about 8 mm short arm for H8 (fallback once the knob cup is removable) | [Bolt and Nut Australia](https://www.boltandnut.com.au/t10-x-90mm-hobson-post-torx-security-allen-key): 11PTK10H (Hobson ISKPT10) | AUD 6.00 | AUD 12.00 | In stock (page 2026-11-03) | confirmed | 2026-11-03: standalone 9.00, 2+ 6.00; bundle price 5.00 on the screw pages (quantity rule not verified). Ball-end keys do not fit post-Torx. HA1/HA2 are about 120 mm deep: check the reach with the real key. |
| 49 | 1/4 in hex magnetic bit holder / extension 300 mm | 1 | 0 | for the 8 driver screws driven through the empty shell (about 190 mm deep); takes 25 mm insert bits | [Bunnings (AU)](https://www.bunnings.com.au/kango-300mm-hypertorque-impact-magnetic-bit-holder_p0727956): Kango 300 mm HyperTorque impact magnetic bit holder (Bunnings I/N 0727956) | AUD 19.99 | AUD 19.99 | store stock only (page 2026-11-03) | confirmed | 2026-11-03: VERIFIED page. Check that the post-Torx bit sits fully in the holder. Fallback Wera 05160981001 300 mm (UNVERIFIED for AU). |
| 65 | PCB drill bit set 0.3-1.2 mm, 10 pcs (0.5 mm for the vents) | 1 set | 0 | two 0.5 mm pressure-equalisation holes through the printed lid (woofer zone and main chamber), in a pin vice or drill stand | [Altronics (AU)](https://www.altronics.com.au/product/t2329-pcb-drill-set-10pk): Altronics T2329 | AUD 16.95 | AUD 16.95 | In stock (page 2026-11-03) | confirmed | 2026-11-03: price/stock VERIFIED; carbide and 1/8 in shank not stated on the page. Carbide bits are brittle: use a stand. Cover each hole inside with a dot of grille cloth (row 4) or felt. |

## Consumables

| # | Item | Qty (unit 1) | 2nd unit | Spec | Source / part number | Unit price | Line price | Stock / date | Status | Notes |
|---|---|---|---|---|---|---|---|---|---|---|
| 55 | Nylon cable ties 2.5 x 100 mm, black UV-stabilised, pack of 100 | 1 pack | 0 (covers) | 9 anchor points (review M4) + driver lead ties; pack covers many units | [Altronics (AU)](https://www.altronics.com.au/product/h4031a-100mm-black-uv-resistant-cable-ties-pk-100): Altronics H4031A | AUD 4.55 | AUD 4.55 | stock not shown (page 2026-11-03) | confirmed | 2026-11-03: VERIFIED price. Natural colour H4012A same price. Jaycar HP1203 is 2.0 mm wide. |
| 56 | Adhesive cable-tie mounts 21 x 21 mm, pack of 25 | 1 pack | 0 (covers) | where CAD v16 does not print a tie bridge; add a dab of CA glue on PETG | [Altronics (AU)](https://www.altronics.com.au/p/h4110a-21mm-adhesive-cable-tie-mounts-pk-25/): Altronics H4110A | AUD 9.15 | AUD 9.15 | In stock (page 2026-11-03) | confirmed | 2026-11-03: VERIFIED. Maximum tie width not stated (this size normally takes 2.5-4.8 mm). Needs a 21 mm flat land: check against the wall curvature in CAD v16. |
| 58 | Heat-shrink assortment 2:1 black, 160 pcs x 100 mm (1.6-9.5 mm) | 1 pack | 0 (covers) | J11 splice sleeves in the woofer chamber, rocker and J5 service-lead joints, lamp-tab insulation backup | [Altronics (AU)](https://www.altronics.com.au/p/w0886-160pc-100mm-black-heatshrink-pack/): Altronics W0886 | AUD 22.95 | AUD 22.95 | In stock (page 2026-11-03) | confirmed | 2026-11-03: VERIFIED. Count per size not stated. Review 3.2 #11 (heat-shrink absent). |
| 59 | Polyimide (Kapton) tape 12 mm x 33 m | 1 roll | 0 (covers) | insulation where leads cross metal (driver baskets, PCM edge, splices); 60 um, 260 C | [Altronics (AU)](https://www.altronics.com.au/p/t2972a-12mm-x-33m-high-temperature-polyimide-tape/): Altronics T2972A | AUD 14.50 | AUD 14.50 | In stock (page 2026-11-03) | confirmed | 2026-11-03: VERIFIED. Review 3.2 #11 (Kapton absent). |

## Subtotals per source (unit 1 order; second-unit extra)

| Source | Currency | Confirmed, unit 1 | Confirmed, 2nd-unit extra | Estimate, unit 1 | Estimate, 2nd-unit extra |
|---|---|---|---|---|---|
| Parts Express (US) | USD | 103.90 | 77.94 | 0.00 | 0.00 |
| Digi-Key | USD | 47.42 | 12.76 | 0.00 | 0.00 |
| LCSC | USD | 3.44 | 0.00 | 0.00 | 0.00 |
| Core Electronics (AU) | AUD | 76.44 | 1.70 | 0.39 | 0.39 |
| RS Australia | AUD | 0.00 | 0.00 | 30.00 | 0.00 |
| Bunnings (AU) | AUD | 46.99 | 0.00 | 0.00 | 0.00 |
| JLCPCB (quote) | USD | 0.00 | 0.00 | 25.00 | 0.00 |
| Jaycar (AU) | AUD | 39.95 | 39.95 | 0.00 | 0.00 |
| Tag-Connect (direct) | USD | 43.00 | 0.00 | 0.00 | 0.00 |
| Bolt and Nut Australia (Hobson Engineering) | AUD | 45.30 | 38.53 | 0.00 | 0.00 |
| Bolt and Nut Australia | AUD | 26.00 | 0.00 | 0.00 | 0.00 |
| Digi-Key AU | AUD | 40.64 | 38.93 | 0.00 | 0.00 |
| Polymax (UK) | GBP | 0.00 | 0.00 | 7.10 | 0.00 |
| Clark Rubber (AU) | AUD | 11.00 | 0.00 | 0.00 | 0.00 |
| Altronics (AU) | AUD | 68.10 | 0.00 | 0.00 | 0.00 |

- **Unit 1, confirmed prices: about A$651.06** (A$410.61 build parts + A$240.44 one-off tools).
- Plus estimates: about A$82.09. **Unit 1 including estimates: about A$733.15.**
- Second unit extra (from the 2nd-unit column x unit price): about A$255.55.
- **Not included anywhere:** the battery pack (RFQ, no price; the 15 A fuse and thermal cut-off are asked from the pack vendor), lines marked TBD, optional or superseded, printed parts (filament line only), shipping and duty, the PCB/stencil order and the electronics BOM. **This is a partial cost, not a complete product cost.**

## Lines without a confirmed source or price

- #15 Heat-set insert M3 x 5.7, OD 4.6, hole 4.0: estimate (AUD figure is an estimate. Confirmed but expensive fallback: Amazon AU ruthex GE-M3x57-001 A$76.59 in stock (2026-10-12); 3DJake EUR 7.49 + EUR 40.49 DHL to AU.)
- #24 Hook-and-loop strap (battery): estimate (1S4P: one 20 mm strap around the brick in the X-Z plane (CAD v15, tunnels 22 x 2.5 in the two side anchor blocks). Order a >= 350 mm strap or cut one from the VELCRO ONE-WRAP 20 mm roll (element14 3499736, price not read)
- #28 Front grille plate 163 x 100, 0.8 mm, 2 x 56 dia perforated zones (2.0 holes / 3.0 pitch): estimate (Estimate only. Metal option: Metal Mesh (Sefar AU) 1 mm aluminium 2.0/3.5 pitch, custom quote; RS PRO 202-7877 0.6 mm sheet is A$189/3 sheets with 1.5 mm holes (rejected).)
- #29 Woofer grille disc 90 dia, 0.8 mm, holes to 64 dia: estimate (Estimate only.)
- #31 1S4P 21700, 20 Ah (4 x INR21700-50S, same lot, matched within 10 mV before welding), PCM >= 10 A continuous / 20 A for 1 s, over-current trip 12-20 A, charge limit >= 5 A, OV 4.25 V, per-cell fusible links, 10k NTC (B3435) glued between the two middle cells, max 87.0 x 75.0 x 22.3 mm including wrap, PCM, fuse and TCO, 15 A PACK+ fuse, about 85 C thermal cut-off, PCM on the positive end, thin-wall 18 AWG leads (OD <= 1.7) about 180 mm, Micro-Fit 43645-0300: TBD (PLACEHOLDER: not in any subtotal. No price; cell price unknown. Ask the vendor for the fusing and PCM specification (part number, OCP trip and delay, OV, charge limit, drain). UN38.3 documents and shipping to AU not conf)
- #50 Lid gasket cord, EPDM sponge 2 mm round: estimate (2026-11-03: price VERIFIED (inc VAT, per metre); **closed-cell not stated on the page** (EPDM sponge cord normally is: confirm); 2.0 +-0.5 mm, 45 Shore A; AU freight not checked. No AU retail 2 mm source found (Associate)
- #51 Closed-cell foam sheet 2 mm, adhesive one side (connector-face seals): TBD (2026-11-03: UNVERIFIED: no A4-size adhesive 2 mm closed-cell sheet verified at an AU retailer (RS AU blocked fetches). Options: Clark Rubber or Foam Sales store cut; craft EVA self-adhesive A4 sheet (Spotlight/Officework)
- #53 Closed-cell foam sheet 1.5 mm, adhesive one side (woofer-chamber insert gasket, knob-cup ring, lid screw washers): TBD (2026-11-03: UNVERIFIED (listings conflict on adhesive backing; 1 x 2 m is far more than needed). Alternatives: Inseal 3259 closed-cell PVC tape 1.5 x 30 mm x 50 m A$87.40 + GST (PB Tech, UNVERIFIED); a 2 mm cord in a gro)
- #54 Acoustic lining for the main chamber, about 10 mm (wadding or open-cell foam): TBD (2026-11-03: UNVERIFIED (price, size and thickness not read; 650 gsm wadding is usually thicker than 10 mm uncompressed: trim or compress). Fallback Monacor MDM-3002 open-cell PU foam 480 x 378 x 10 mm, GBP 13.35 ex VAT ()
- #60 PACK+ fuse 15 A (fitted by the pack vendor; RFQ item 2): TBD (2026-11-03: part of the pack quote, not a separate purchase (placeholder outside every subtotal). The 0453015 listing is VERIFIED; its 50 A breaking rating (at rated voltage) is UNVERIFIED as adequate for a 4P short (hun)
- #61 Thermal cut-off about 85 C (fitted by the pack vendor; RFQ item 2): TBD (2026-11-03: part of the pack quote (placeholder outside every subtotal). Datasheet https://www.bourns.com/docs/Product-Datasheets/nr.pdf read by the sourcing agent: the A-type also trips on self-heating, about 13 A at ro)
- #63 Screw-in rubber foot, M3 x 6 male stud, 8 mm dia x 8 mm (into the stud female end): TBD (2026-11-03: UNVERIFIED. No 12-16 mm diameter buffer with an M3 stud was found anywhere (catalogue M3 buffers are 8 mm). Options: (a) this 8 x 8 M3 buffer on the stud (keeps the stud, small contact patch; a 12.7 mm Bumpon)

## Superseded lines (kept for history, quantity 0)

- #14 Encoder knob (SW102): 0 (superseded 2026-11-03)
- #16 Socket cap screw M3 x 10, 316 stainless: 0 (superseded 2026-11-03)
- #17 Socket cap screw M3 x 16, 304 stainless: 0 (superseded 2026-11-03)
- #19 Hex spacer M3 F/F 10 mm, 5.5 AF: 0 (superseded 2026-11-03)
- #21 Rubber foot disc 12.7 dia x 3.5: 0 (superseded 2026-11-03)
- #22 Nylon flat washer M3 (lid screw seal): 0 (removed 2026-11-03, superseded)
- #25 Lid gasket cord, closed-cell EPDM sponge 3 mm: 0 (superseded 2026-11-03)
- #26 Driver/woofer gasket, closed-cell foam sheet 0.5-1 mm: 0 (superseded 2026-11-03)

## Design points found while sourcing (2026-10-12, refreshed 2026-11-03)

- Micro-Fit crimps: 43030-0007 is 20-24 AWG only. PACK+/PACK- 18 AWG need 43030-0038 (insulation OD <= 1.85; use thin-wall wire, OD <= 1.7). Pin 2 (NTC, 24 AWG) uses 43030-0007.
- Pack lead: RFQ about 180 mm against the 131 mm CAD v15 route; the slack is dressed on a tie point on the J5 path.
- Tag-Connect: J7 is the legged TC2030 footprint and the STLINK-V3MINIE has STDC14, so TC2030-CTX-STDC14 plugs straight in.
- J4 (PD controller I2C) and J8 (BM83 UART) need a 3.3 V USB adapter. The MCP2221A UART speed for isUpdate/Config Tool is unverified.
- Grilles: proposed as 0.8 mm black FR4 with NPTH holes from JLCPCB (CAD mass still uses steel). Both grilles are backed with the black cloth (row 4).
- Filament: about 692 g solid-volume basis (+20 % = 831 g) before the knob cup, plungers and tie bridges: one roll per unit is tight.
- Grommet: Heyco 2000 needs a 6.35 mm hole and a panel of at most 1.57 mm: CAD v16 uses 6.35 / 1.5.
- Feet: Wurth 971120321 = RS 176-8061 (M3 M/F, 12 mm body, 6 mm stud); the rubber foot screws into its female end (row 63).
- Rocker fastons: TE 2-520194-2 (0.187 x 0.032 in tab assumed from the CAD stand-in).
- History: the 2026-10-12 version of this file (hand-written, with the A$473.59 confirmed snapshot) is in git history and `ai-files/backups/hardware-buy-list.md.pre-reviewfix-20261103`.

## Tools note (2026-11-03)

- Every enclosure screw is **T10 post-Torx (pin Torx)**: a plain T10 bit or key does not fit, and **ball-end keys do not work with post-Torx**. The old "2.5 mm ball-end hex key" instructions (M3x16 socket screws) are superseded.
- Bits: T10 post-Torx 25 mm insert bits (row 41, x2: one + spare) in a 1/4 in driver. The 8 driver screws are driven through the empty shell, about 190 mm deep: use the **1/4 in bit extension of 200 mm or more** (row 49) before the woofer-chamber insert goes in.
- L-keys: T10 post-Torx 90 mm L-key (row 45, x2). Short arm 19 mm. **H8** (under the knob dish) has 11.7 mm of headroom when the dish is part of the shell: cut the short arm of the second key to about 8 mm. With the separate knob cup (CAD v16) H8 is reached from above with the cup removed, so the cut key is a fallback. HA1/HA2 are about 120 mm in from the rear opening: check the reach with the real key.
- Woofer screws (M3x20 button) are driven before the insert goes in (77 mm vertical space): L-key or a stubby 1/4 in holder.
- Vent holes: 0.5 mm carbide PCB drill (row 65) in a pin vice; do not print 1 mm holes.
- Heat-set inserts: soldering iron with an M3 insert tip (row 38 optional) or a plain conical tip.
