chithigun23/DesktopSpeaker/ai-files/reports/cad-v14-2026-11-03.md

# CAD v14: rebuild from the RT-14 routing draft (2026-11-03)

Agent: "CAD v14 rebuild from RT-14". Input: board `ai-files/pcb/work-route14/RT-14.kicad_pcb` (SHA-256 `a200d97b...cdc4eb9a`). Pipeline: the v13 scripts copied to `ai-files/cad/v14/scripts/`; the enclosure is the v13 2-cell (1S2P) design, unchanged (the 4-cell variant in `ai-files/cad/v13p4` is not included). Nothing in `DesktopSpeaker-kicad/`, `ai-files/cad/v13/`, `ai-files/cad/v13p4/` or earlier work folders was edited. Not committed.

## 1. Result

| Item | v13 (RT-3) | v14 (RT-14) |
|---|---|---|
| Board | RT-3 + models-v13 map | RT-14 routing draft (12 unconnected, DRC 0). The models-v13 map was already present on the board: 0 footprints changed |
| Footprint errors (audit) | 4 open, modelled as drawn | **0 open**: J2/J3 pegs, U1 pad 56, SW100, C275 are fixed on RT-14 (checked in the board file) |
| Board parts with a model / within 0.5 mm | 346 / 340 | 346 / 340. PCB nodes: **340 `<0.5mm`, 6 unverified** (SW100 placement now verified; v13 had 339 / 7) |
| Solids / unintended / intended overlaps | 164 / 0 / 89 | **164 / 0 / 89** (same pairs; J2/J3 vs board 3.72 -> 2.82 mm3: the front pegs now sit in their holes) |
| Woofer chamber net | 0.525 L (gross 0.627) | **0.525 L** (gross 0.627, displaced 0.103 + 0.020 front air) |
| Main chamber net | 1.962 L | **1.962 L** (gross 2.182, displaced 0.220) |
| Printed bodies | 380.5 / 59.5 / 102.4 cm3 | **380.5 / 59.5 / 102.4 cm3**. 3 valid single solids, no supports; the STLs are byte-identical to v13 |
| Lid cutouts (radial) | J1 1.53, J2/J3 1.25, SW100 1.5 | same; all aligned. Bore centres are unchanged (SW100 X -14.68, Z 70.30) |
| SW100 actuator tip to lid inner / outer face | 2.80 / 6.80 mm | **0.50 / 4.50 mm** (tip at the board edge, 0.00 mm past it) |
| Tightest part (excluding knob/shaft) | C288/C301 2.00 mm | **SW100 1.35 mm to the lid**, then J2/J3 1.51, J1 1.53, J5 1.55, J11 1.61, C288/C301 2.00, R209 2.01 |

## 2. Changes

### 2.1 Scripts (`ai-files/cad/v14/scripts/`, copies of v13)
- Paths and versions: default CAD_OUT is `cad/v14` and WORKDIR is `pcb/work-cad14`; version "v14"; board "RT-14".
- `rebuild_cad.sh`: the fit_check baseline can now be overridden with `OLD_STEP`/`OLD_LAYOUT`. The default is **the v13 board** (`ai-files/pcb/work-cad13/board.step` + `layout.json`, RT-3), so `moved_mm` shows RT-3 -> RT-14.
- Content changes, needed because RT-14 fixed the footprints (otherwise the site would still say "not fixed"):
  - `build_speaker_cad.py`: `FP_ERR` notes now say "fixed in RT-14"; the SW100 "placement unverified" special case is removed.
  - `make_web_meta.py`: `FOOTPRINT_ERRORS` is now empty; new `FOOTPRINT_FIXES` (meta `accuracy_audit.footprint_fixes_rt14`, per node `footprint_fixed`); the SW100 special case is removed; the title, board and copper descriptions are updated; `changes_vs_v13` replaces `changes_vs_v12`.
- No geometry parameter changed.

### 2.2 Board differences RT-3 -> RT-14 (42 references)
Exact minimum distance to every enclosure body. This was computed with a scratch FreeCAD script with no bounding-box prefilter (`fit.json` `nearest` is prefiltered to 6 mm and reports the shell for far parts). Harness = the nearer schematic harness tube.

| ref | moved mm | rot deg | min to enclosure | harness mm |
|---|---|---|---|---|
| C106 | 1.65 | -90 -> -90 | 5.53 Screw_M3x16_PcbScrew_3_H3 | 40.9 |
| C110 | 0.29 | -90 -> -90 | 8.19 Standoff_M3_10mm_PcbScrew_3_H3 | 43.63 |
| C212 | 0.35 | 90 -> 90 | see C215 | - |
| C230 | 5.76 | 0 -> -90 | 11.60 Insert_woofer_chamber | 43.09 |
| C231 | 5.41 | -90 -> -90 | 11.60 Insert_woofer_chamber | 42.11 |
| C232 | 5.85 | 0 -> 0 | 11.60 Insert_woofer_chamber | 40.0 |
| C233 | 8.06 | 180 -> 180 | 11.60 Insert_woofer_chamber | 38.97 |
| C236 | 0.81 | -90 -> -90 | 11.60 Insert_woofer_chamber | 41.03 |
| C237 | 7.46 | 90 -> 180 | 11.60 Insert_woofer_chamber | 40.21 |
| C238 | 7.11 | 90 -> 0 | 11.60 Insert_woofer_chamber | 42.18 |
| C239 | 7.09 | 0 -> 0 | 11.60 Insert_woofer_chamber | 40.58 |
| C240 | 5.19 | 0 -> 0 | 11.60 Insert_woofer_chamber | 40.23 |
| C275 | 0.00 | 0 -> 0 | 12.06 Insert_woofer_chamber | 21.82 |
| R102 | 3.55 | 0 -> -90 | 7.09 Screw_M3x16_PcbScrew_3_H3 | 42.59 |
| R110 | 0.00 | 90 -> -90 | 11.60 Insert_woofer_chamber | 32.48 |
| R113 | 0.08 | 90 -> 90 | 4.74 Lid_rear | 83.82 |
| R142 | 2.42 | 180 -> 180 | 11.60 Insert_woofer_chamber | 102.0 |
| R209 | 0.01 | 90 -> 90 | 2.01 Screw_M3x16_PcbScrew_2_H2 | 49.43 |
| R220 | 2.22 | 0 -> 180 | 11.60 Insert_woofer_chamber | 43.34 |
| R221 | 5.12 | 90 -> -90 | 11.60 Insert_woofer_chamber | 41.62 |
| R222 | 2.84 | -90 -> 90 | 11.60 Insert_woofer_chamber | 40.87 |
| R223 | 8.85 | -90 -> 90 | 11.60 Insert_woofer_chamber | 38.95 |
| R225 | 5.79 | 90 -> 180 | 11.60 Insert_woofer_chamber | 49.38 |
| R226 | 5.68 | 180 -> -90 | 11.60 Insert_woofer_chamber | 42.53 |
| R227 | 6.51 | 90 -> -90 | 11.60 Insert_woofer_chamber | 41.52 |
| R228 | 7.91 | 90 -> 90 | 11.60 Insert_woofer_chamber | 40.28 |
| R229 | 7.47 | 90 -> 90 | 11.60 Insert_woofer_chamber | 39.53 |
| R230 | 8.76 | -90 -> -90 | 11.60 Insert_woofer_chamber | 42.76 |
| R231 | 7.72 | -90 -> -90 | 11.60 Insert_woofer_chamber | 42.9 |
| R234 | 8.82 | 0 -> 0 | 11.60 Insert_woofer_chamber | 39.52 |
| R235 | 9.99 | -90 -> 90 | 11.60 Insert_woofer_chamber | 42.74 |
| R237 | 4.84 | 180 -> 0 | 11.60 Insert_woofer_chamber | 35.49 |
| R238 | 3.27 | -90 -> 0 | 11.60 Insert_woofer_chamber | 35.39 |
| R258 | 5.73 | -90 -> -90 | 8.07 Standoff_M3_10mm_PcbScrew_6_H6 | 28.8 |
| R262 | 5.40 | 90 -> -90 | 11.60 Insert_woofer_chamber | 82.51 |
| SW100 | 2.29 | 0 -> 0 | 1.35 Lid_rear | 80.7 |
| TP12 | 3.10 | 0 -> 0 | 3.15 Screw_M3x16_PcbScrew_2_H2 | 53.05 |
| TP14 | 3.10 | 0 -> 0 | 3.06 Screw_M3x16_PcbScrew_2_H2 | 52.65 |
| TP2 | 1.00 | 0 -> 0 | 2.55 Screw_M3x16_PcbScrew_3_H3 | 39.54 |
| TP20 | 40.78 | 0 -> 0 | 8.54 Standoff_M3_10mm_PcbScrew_4_H4 | 70.58 |
| U8 | 6.99 | 0 -> 0 | 11.60 Insert_woofer_chamber | 40.29 |
| U9 | 3.35 | 0 -> 180 | 11.60 Insert_woofer_chamber | 40.77 |

- C212 (0.35 mm) has no solid of its own: it is 0.14 mm from C215, and the per-reference split assigns its model to C215. C215 shows a "moved 0.53" artefact for the same reason.
- R110 changed only its rotation; C275 changed only its footprint.

## 3. Checks and fit findings

### 3.1 OK
- Interference: 0 unintended. The 89 intended overlaps are the same pairs as v13 (49 thread engagements, 38 inserts, 2 J2/J3 nose-in-board).
- Woofer chamber net 0.525 L (in the 0.525 +- 0.05 window); main 1.962 L.
- Print bodies valid; lid cutouts aligned.
- **TP20** (moved 40.8 mm to (123.9, 111.25), Keystone 5015, 1.5 mm high):
  - 8.54 mm from the H4 PCB spacer (8.77 to its M3x16 head), 11.6 mm from the insert roof, 11.99 mm from the shell.
  - Woofer harness 70.6 mm; 26.9 mm under the top wall.
- **Moved parts:** all clear.
  - Tightest: TP2 2.55 mm to the H3 screw head (v13 3.52), TP14 3.06 and TP12 3.15 to the H2 head (they swapped places).
  - SW100 1.35 mm to the lid; R113 4.74 mm to the lid.
  - R225 and R142: 11.6 mm to the insert roof (next body 12.05 / 13.8 mm).
  - Jack-switch block (C230-C240, R220-R238, U8, U9): 11.6 mm to the insert roof and >= 17.9 mm to the screws and woofer.
- **C275** CP_Elec_6.3x7.7 (same position): 7.7 mm high, 20.7 mm under the top wall, 12.06 mm to the insert roof, 13.39 mm to the right ND65, 21.8 mm to the woofer harness.
- **J2/J3:** the two 0.448 mm3 peg/board collisions per jack in v13 are gone (pegs in the x -4.75 NPTH). Lid bores unchanged (radial 1.25, 1.51 mm from the lid).
- **U1 pad 56:** pad-only change. Model and offset unchanged; 6.05 mm from the shell.
- fit_check distance artefacts guarded: C244 and R223 vs the woofer harness (true distance about 40 mm).

### 3.2 Problems
1. **SW100 still cannot be pressed through the lid.**
   - The redrawn TE footprint (switch moved 2.295 mm, y 25.245 -> 22.95) puts the actuator tip exactly at the board edge (Y 202.10). That is 0.50 mm short of the lid inner face and 4.50 mm behind the outer face (RT-5 estimate 4.5 mm: confirmed). The switch body is 1.35 mm from the lid.
   - A printed plunger in the 5.0 bore must bridge 4.50 mm plus its protrusion and travel.
   - Only 0.5 mm is free behind the lid, so a retaining collar needs a counterbore in the lid inner face. This is not modelled: v14 keeps the v13 lid.
   - Switch travel was not extracted (the TE PDF is a drawing without text).
2. **Woofer screw engagement is marginal** (unchanged): M3x20 gives 3.4 / 4.4 mm in the 5.7 mm insert; M3x22 would give 5.4-6.4 mm.
3. The pcb.glb vs CAD component box differs for SW102 (0.77) and C275 (1.0). This is an exporter difference, as in v13.

### 3.3 Screw table
Unchanged from v13 (ND65 M3x10 ok, woofer M3x20 marginal, PCB M3x16 ok, lid M3x10 ok, feet studs ok).

## 4. Web export (published to `ai-files/website/desktopSpeaker-site/cad/`)
Staged first in `ai-files/cad/v14/web-staging/`; all checks passed, then cad files only were copied. No `app.js`, `index.html` or `data/` changes.

| File | Size | Notes |
|---|---|---|
| `enclosure.glb` | 13.8 MB | 108 mesh nodes, 474,801 triangles; mesh/B-rep volume 0.996-1.001 for every node |
| `pcb.glb` | 15.4 MB | 413 meshes, 415,736 triangles |
| `pcb_copper.glb` | 24.9 MB | optional; RT-14 copper (v13 18.1 MB) |
| `meta.json` / `cad_status.json` | | version "v14", title "DesktopSpeaker internal CAD v14 (RT-14 draft): board RT-14 + models-v13 accurate models"; `footprint_fixes_rt14`, `changes_vs_v13`, v14 checks/findings/open items |
| `renders/` | | 9 PNG, new for v14 (three.js r128 page, scratch copy `cad14_preview/preview.html`, the v13 page with the v14 label) |
| `downloads/` | | 3 STL (identical to v13) + `DesktopSpeaker_internal.step` (48.8 MB, RT-14 board) + `SHA256SUMS` (verified) |

**Validation** (`ai-files/cad/v14/work/glb_validation.json`):
- No extensions.
- Board body 0.084 mm; hole walls on the standoff axes <= 0.007 mm.
- Component boxes vs CAD <= 0.005 mm for J1, J2, J3, J5, J9, J11, SW100, U1, U2, U24, TP1, U3, L201, J4; TP23 0.11 mm.
- Headless Chrome load: 1009 meshes, 890,537 triangles, all 9 views DONE. Renders inspected.

## 5. Owner asks
1. **SW100:** approve a printed lid plunger (bridges 4.50 mm, collar pocket in the lid inner face) or another press solution; confirm the switch travel.
2. Caliper the W3-2052SC before printing; choose M3x20 (marginal) or source M3x22.
3. Make a JST-PH to VH adapter lead for the woofer pigtail to J11.
4. Select the knob, rubber feet, PCM board, gaskets and grommet (still placeholders).
5. Coordinator: confirm the TP20 relocation (RT-14 report); for CAD it is fine.

## 6. Files and rebuild
- `ai-files/cad/v14/`:
  - Model and outputs: FCStd, STEP, `print/*.stl`, `renders/` (14 FreeCAD renders), `interference.md`, `volumes.md`, `meta.json`.
  - `fit_findings.json`: hand-written for v14, including the `moved_parts` list.
  - `scripts/`, `work/`, `web-staging/` (about 100 MB duplicate of the site files; do not commit).
- `ai-files/pcb/work-cad14/`: board copy, `board.step`, `layout.json`, raw GLBs and logs (scratch, 80 MB).
- Site: `ai-files/website/desktopSpeaker-site/cad/` (the files listed in 4).
- Command (run end to end in this session; the web PNGs were made afterwards with the preview page):
  ```
  PYVENV=<venv with numpy> ai-files/cad/v14/scripts/rebuild_cad.sh BOARD [LIB] [CAD_OUT] [WEB_OUT] [WORKDIR]
  ```

## Iterations
- Build, check, fit and export: 1 each, no failures.
