chithigun23/DesktopSpeaker/ai-files/reports/routing-toolchain-oct-2026-11-01.md

# Routing toolchain: exact-octilinear A* router `route_oct` (2026-11-01)

Agent: "Routing toolchain: exact-octilinear A* router". Scratch work only: boards in `ai-files/pcb/work-oct/`, code in `ai-files/helpers/route_oct*`. Nothing in `DesktopSpeaker-kicad/` was edited. No rule, net class or board-setup value was changed (rule AG1); every final board's `.kicad_dru` and `.kicad_pro` have the same SHA-256 as the project files. Nothing committed. Board under test: copy of `DesktopSpeaker-kicad/DesktopSpeaker.kicad_pcb` at commit 2858f93 (sha256 d5ae57fb..., the same file the Freerouting trial used); placement was not changed. Headless throughout: KiCad 10.0.7 AppImage `kicad-cli` and `python3.11`. The AppImage python has no numpy, so the routing core runs in a scratch venv (numpy 2.5.4, shapely 2.2.0) that reads a pcbnew JSON export.

**Verdict first.**
- **Geometry: solved by construction.** An independent checker confirmed it on every routed board:
  - 100.000 % of routed length exactly 0/45/90 deg (max deviation 0.0000 deg);
  - 0 corners of 90 deg away from pads, 0 colinear splits, 0 dangling ends, 0 bend-spacing faults, 0 shorts;
  - 0 clearance or width DRC errors under the frozen rules, sentinel rule fires, stage locks verified.
  - Three defect classes surfaced on the 140-net run and were fixed in code: paths touching themselves, an in-pad dogleg meeting a second stub at 45 deg, and NPTH edge clearance. The fixes were re-verified on the trial set and on one hard run (section 5).
- **Completion: not solved.**
  - Trial set (Freerouting's 11 nets, 38 airwires): 15-17 closed. Freerouting: 17.
  - All 140 signal nets (283 connections): 130-136 closed (46-48 %); 34-37 nets complete.
  - Median length / octilinear minimum on complete nets: 1.14-1.16. 95th percentile: 4.6. The strict runs pass the 1.15 median and the LA2 run does not; all runs fail the 1.4 p95.

Go / no-go: **no-go as an unattended router for the restart; go as the geometry and checking engine** for nets whose escapes and topology are already free (section 7).

## 1. Files and command line

| file | role |
|---|---|
| `helpers/route_oct.py` | router (one stage per call) |
| `helpers/route_oct_core.c` | C core: octilinear A* with forced runs after bends and vias, scanline polygon fill; compiled by `route_oct.py` with gcc into the work folder |
| `helpers/route_oct_rules.py` | clearance model transcribed from `DesktopSpeaker.kicad_dru`; refuses to run if the rule file's SHA-256 differs |
| `helpers/route_oct_export.py` | pcbnew (AppImage python) export of pads, tracks, vias, zone fills, rule areas, courtyards and outline to JSON |
| `helpers/route_oct_strip.py` | text-level strip of nets (by list, or `--all-signals`) |
| `helpers/route_oct_order.py` | stage assignment (OR1) and order inside a stage (OR2) |
| `helpers/route_oct_refill.py` | zone refill in a separate pcbnew process |
| `helpers/route_oct_stage.sh` | one locked stage: export, route, refill, DRC (restores pristine project files beside each board) |
| `helpers/route_oct_lock.py` | canonical SHA-256 of a stage's copper (manifest) |
| `helpers/route_oct_check.py` | independent measurement (does not import the router) |
| `helpers/route_oct_sentinel.sh` | proves the rule file is read (one sentinel rule appended on a copy) |
| `helpers/route_oct_debug.py` | PNG of the A* window rasters for one connection (diagnosis) |
| `pcb/work-oct/run_all.sh` | S1..S3 for one net file with its own manifest |

```
cd ai-files/pcb/work-oct ; V=<venv>/bin/python ; K=~/Applications/kicad.AppImage
# prepare a stripped copy (project .kicad_pro/.kicad_dru copied beside it as STEM.kicad_pro/.kicad_dru)
python3 ../../helpers/route_oct_strip.py base.kicad_pcb H0-raw.kicad_pcb --all-signals base.kicad_pro --list H0.nets.txt
$K python3.11 ../../helpers/route_oct_refill.py H0-raw.kicad_pcb H0.kicad_pcb
$K python3.11 ../../helpers/route_oct_export.py H0.kicad_pcb H0.geo.json
python3 ../../helpers/route_oct_order.py H0.geo.json H0.nets.txt hard-nets.txt
# route S1..S3 (each stage: export -> route -> refill -> DRC), final parameter set
sh run_all.sh Hfa- hard-nets.txt H0 --via-cost 1.5 --pair-avoid 1 --hweight 1 --max-exp 3e7
# measure
$K python3.11 ../../helpers/route_oct_export.py Hfa-3.kicad_pcb Hfa-3.geo.json
$V ../../helpers/route_oct_check.py Hfa-3.kicad_pcb Hfa-3.geo.json hard-nets.txt --drc Hfa-3.drc.json --manifest Hfa--manifest.json \
   --rules Hfa-3.kicad_dru Hfa-3.kicad_pro --json Hfa-3.check.json
sh ../../helpers/route_oct_sentinel.sh $PWD Hfa-3
```
Net file lines: `STAGE NET [pair=<partner>] [bcu=no|gnd|yes] [width=mm]`. Router options are listed by `route_oct.py --help`.

## 2. Design

- **Lattice and layers.**
  - 0.05 mm grid. Routing only on F.Cu and B.Cu; In1 and In2 are never used.
  - Moves are the 8 lattice directions, so every routed segment is exactly 0/45/90 deg.
  - The lattice origin is chosen per connection (up to 2 candidates) so the pad centre lines fall on lattice lines. Angles depend only on coordinate differences, so exactness is kept. This removes the 0.005-0.025 mm offsets that 1172 of 1192 pads have from a fixed 0.05 mm grid.
- **Bends.**
  - A* state = (layer, cell, direction). The only direction change is +-45 deg.
  - Each bend is followed by a forced straight run of max(0.4 mm, 3 x width): 15 cells orthogonal or 11 diagonal at 0.25 mm. So 90 or 135 deg corners and short segments between bends cannot be generated.
  - A via is followed by the same forced run.
- **Pads.** Stubs are computed in integer nanometres.
  - Variant A runs along the pad axis on a lattice line to a node at least pad edge + 0.3 mm. When the centre is off that line, an octilinear micro-dogleg of at most 0.035 mm sits inside the pad copper; the checker counts these as `micro_segs_in_pad`. Since the last fix, a pad's second track starts on the lattice line inside the pad with no centre dogleg.
  - Variants B+/B- run on the exact pad centre line, then at 45 deg to the first lattice node.
  - Exit directions:
    - fine-pitch pads (part with >= 8 pads, pad <= 0.45 mm wide) leave outward only (FO1);
    - other elongated pads leave along their long axis;
    - square-ish pads may leave in 4 directions.
  - Stubs may neck to 0.2 mm only inside the neck_ic areas, and USB inside NECK_U2_USB, as the rule file allows.
  - Facing pads on a common line are joined by one straight segment (LE5).
- **Topology.**
  - Multi-pin nets are routed as a daisy chain: exact search over orders up to 7 pads, otherwise nearest-neighbour plus 2-opt, using octilinear distance, with fine-pitch pads pushed to the chain ends.
  - A second connection at a fine-pitch pad branches at its stub node.
  - The post-pass only merges colinear segments; there is no shortcut step.
- **Clearances.**
  - Each connection gets window rasters built from shapely buffers of every foreign item: clearance + w/2 + 0.04 mm sweep margin, filled by a C scanline.
  - Clearance values:
    - max of the matching class rules: audio 0.5, clk 0.4, vbus 0.4, pvdd 0.3, switch 1.0/2.0, USB pair 0.15;
    - 0.2 inside the neck_ic areas, as DRC uses, but the switch-node clearances are kept there;
    - edge 0.5 (NPTH holes included), hole 0.25;
    - antenna keep-out, BKO_* on B.Cu, J7 no-via.
  - Vias also clear In1/In2 copper and In2 islands, every SMD pad by 0.25 mm, and holes by 0.3 mm.
  - Every committed segment and via is re-checked exactly with shapely (DRC semantics, against foreign copper and against the path itself) before it is accepted.
- **Reference plane.**
  - Sensitive nets (I2S_CLK, AUDIO, AUD_SDA/SCL) are F.Cu only (`bcu=no`) in the strict policy. USB uses `bcu=gnd` in both policies because the USB-C row interleave needs a jumper.
  - The LA2 policy allows all sensitive nets on B.Cu, but only over In2 GND.
  - Other nets:
    - B.Cu step x1.3 over In2 GND and x3.9 over islands or voids;
    - B.Cu forbidden over POWER_HI, PVDD and SPK_OUT islands;
    - F.Cu step +2 over an In1 void;
    - +10 % against the layer direction (F horizontal, B vertical).
- **Spacing (SP1).** For I2S_CLK and USB nets, every other signal track gets a 0.6 mm halo, and vice versa. The halo is hard outside the neck areas and is dropped within 1.2 mm of the connection's own pads. USB_DN is routed after USB_DP with a x0.6 cost on the 0.15-0.25 mm gap rail.
- **Order and locks.**
  - Stages (OR1): S1 USB, clocks and I2S; S2 audio plus amplifier I2C; S3 the rest.
  - Inside a stage (OR2): fine-pitch nets first, then longest MST first.
  - Before a stage, the escape (stub plus forced run) of every fine-pitch pad of the nets still to route is reserved. There is also a soft cost near pads of nets still to route.
  - Rip-up and reroute is transactional:
    1. A conflict search makes same-stage copper passable at a penalty.
    2. The hit nets (max 3) are ripped and everything is rerouted.
    3. The change is rolled back unless the group's completed connections increase.
  - Each stage writes a manifest entry with the SHA-256 of its canonical copper. The next stage refuses to run if an earlier stage's copper has changed.
- **Write-back.** `segment`/`via` blocks are inserted as text. Zones are refilled in a separate pcbnew process with pristine copies of the project `.kicad_pro/.kicad_dru` beside the board. pcbnew's save rewrites the `.kicad_pro`; it only adds `td_enabled: false` defaults and the file name (checked), and the script restores the pristine copy.

## 3. Validation method

- **Strip.** For the 11 nets, `route_oct_strip.py` removed exactly what the Freerouting trial removed: 273 segments, 1 arc, 65 vias, 193 teardrops.
  - Refilled stripped board: DRC 0 violations / 38 unconnected. Untouched copy: 0 / 0.
  - Full signal strip (`--all-signals`): 140 nets (1461 segments, 13 arcs, 335 vias, 1162 teardrops); DRC 0 violations / 279 unconnected.
- **Measurement.** `route_oct_check.py` parses the saved board.
  - Calibrated on the original board for the 11 nets: it reproduces the trial report's 1433.8 mm, 38.72 % exact and 65 vias.
  - It is stricter than KiCad: it also flags 19 dangling or overlapping joints in the original copper.
  - `r7_metrics.py` and `r7_bench.py` were run as well. Whole-board acute joints (< 80 deg) were 33 before and after routing, so the router added none.
- **DRC.** `kicad-cli pcb drc --severity-all --all-track-errors` on every refilled stage board.
  - Sentinel (`route_oct_sentinel.sh`): a copy with one appended rule (I2S_CLK width >= 5 mm) fires: 81 track-width violations on the base board, "FIRES" on the final trial board.
- **Rules.** SHA-256 of `.kicad_dru` and `.kicad_pro` of every final board equals the project files (checker key `rules`).

- **Process notes.**
  - Two background pipelines once ran concurrently on the same files. That produced a false lock violation; those runs were discarded.
  - An `ln -sf` in the first version of the sentinel script followed an existing symlink and created a stray symlink `DesktopSpeaker-kicad/kicad-library/kicad-library`. It was removed and the script fixed. `git status` of `DesktopSpeaker-kicad/` now shows only the `.kicad_prl` change that predates this work.
  - `ai-files/pcb/work-oct/` holds about 0.8 GB of scratch boards; commit only the helpers and this report.
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
