chithigun23/DesktopSpeaker/ai-files/Battery_Charger-storage-wake-preview.png

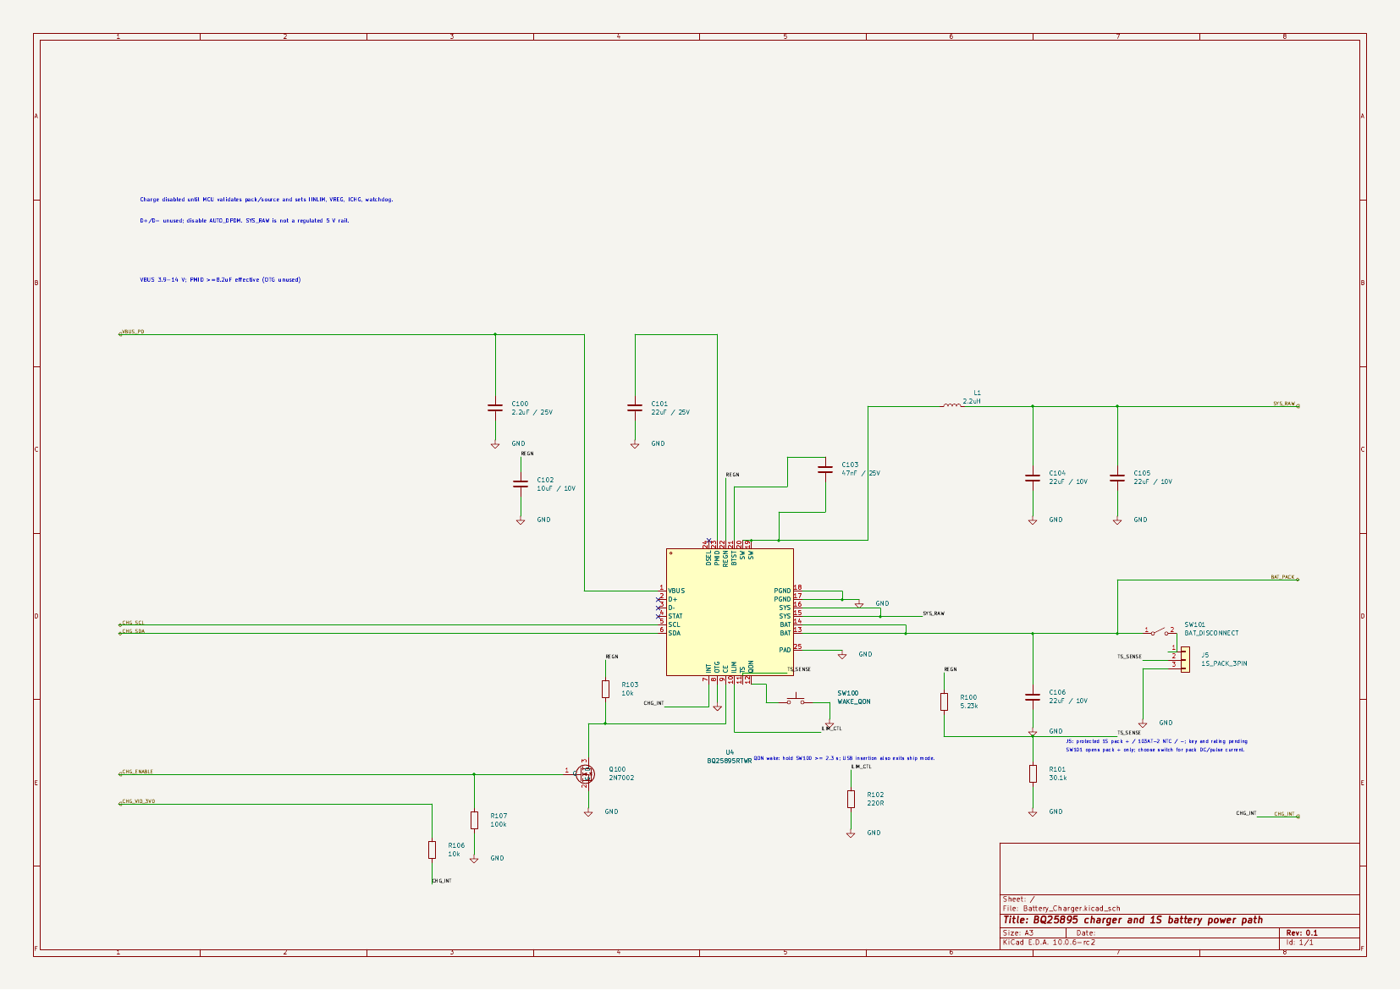
ai-files/Battery_Charger-storage-wake-preview.png
