chithigun23/DesktopSpeaker/ai-files/cad/models-v13/downloads/tangband_W3-2052SC/img_ALT_2.jpg

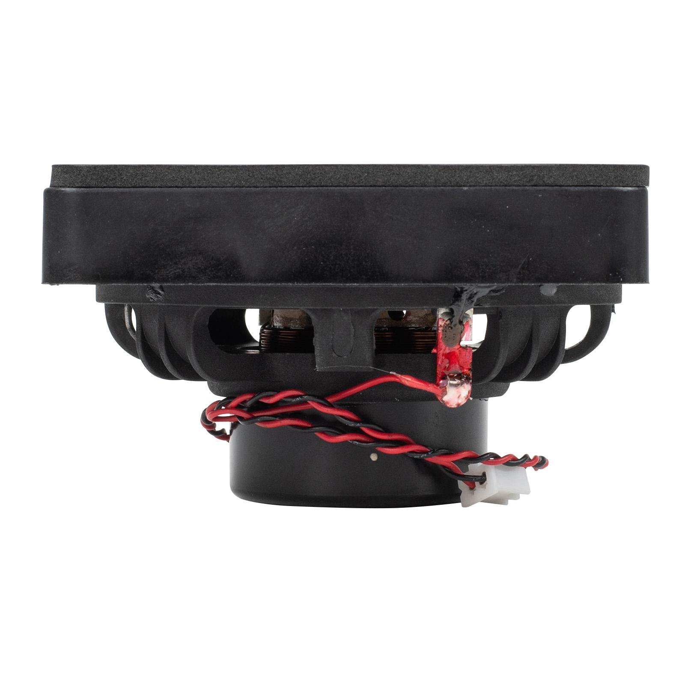
ai-files/cad/models-v13/downloads/tangband_W3-2052SC/img_ALT_2.jpg
