chithigun23/DesktopSpeaker/ai-files/cad/models-v13/renders/after_front_J1_J2_SW100.png

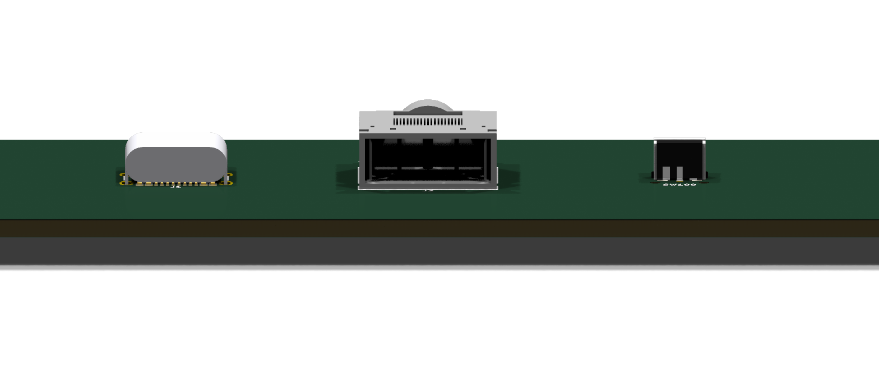
ai-files/cad/models-v13/renders/after_front_J1_J2_SW100.png
