chithigun23/DesktopSpeaker/ai-files/cad/models-v13/renders/after_g1.png

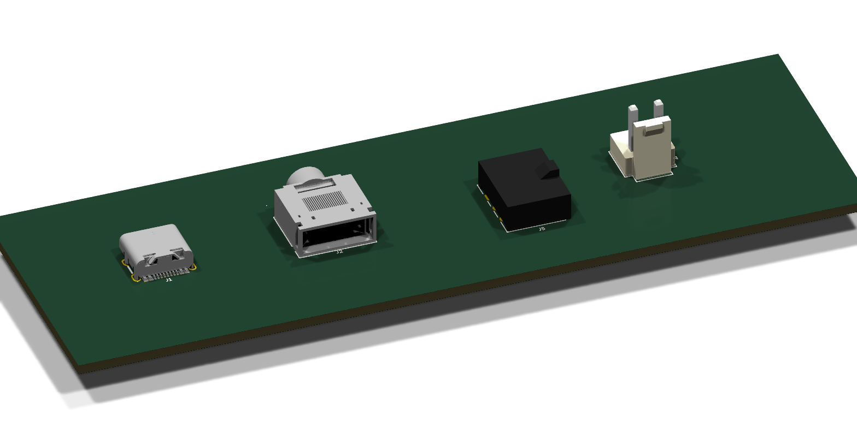
ai-files/cad/models-v13/renders/after_g1.png
