chithigun23/DesktopSpeaker/ai-files/cad/models-v13/renders/after_g2.png

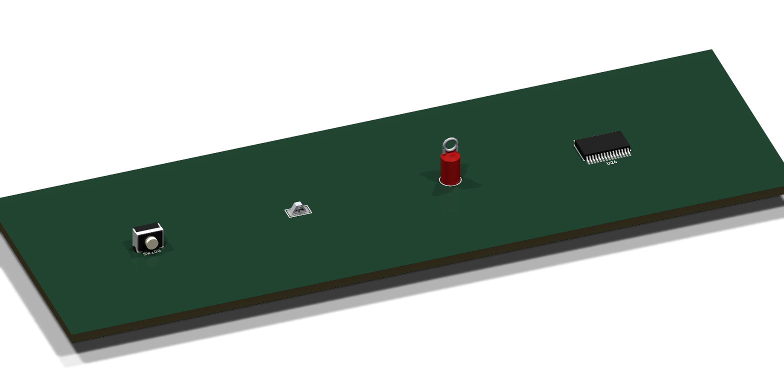
ai-files/cad/models-v13/renders/after_g2.png
