chithigun23/DesktopSpeaker/ai-files/cad/models-v13/renders/after_rear_J5_J9_TP1_U1.png

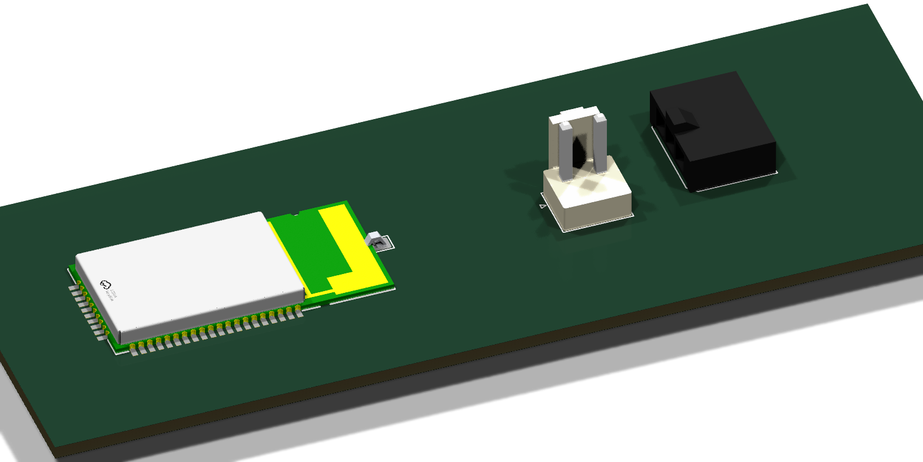
ai-files/cad/models-v13/renders/after_rear_J5_J9_TP1_U1.png
