chithigun23/DesktopSpeaker/ai-files/cad/models-v13/renders/before_g2.png

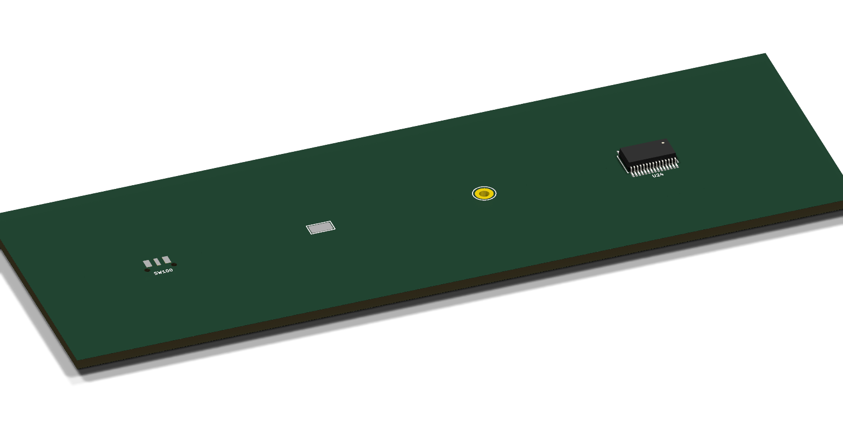
ai-files/cad/models-v13/renders/before_g2.png
