chithigun23/DesktopSpeaker/ai-files/cad/models-v13/renders/mech_2.png

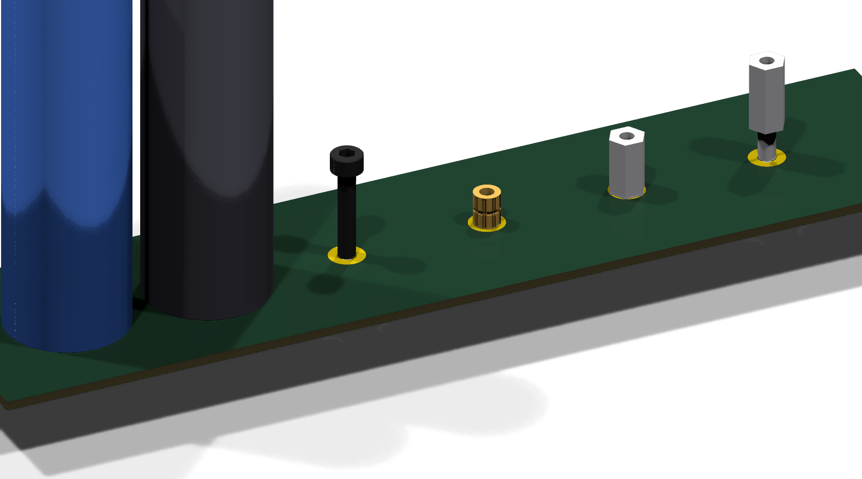
ai-files/cad/models-v13/renders/mech_2.png
