chithigun23/DesktopSpeaker/ai-files/cad/v13p4/2P/renders/batt_open_view.png

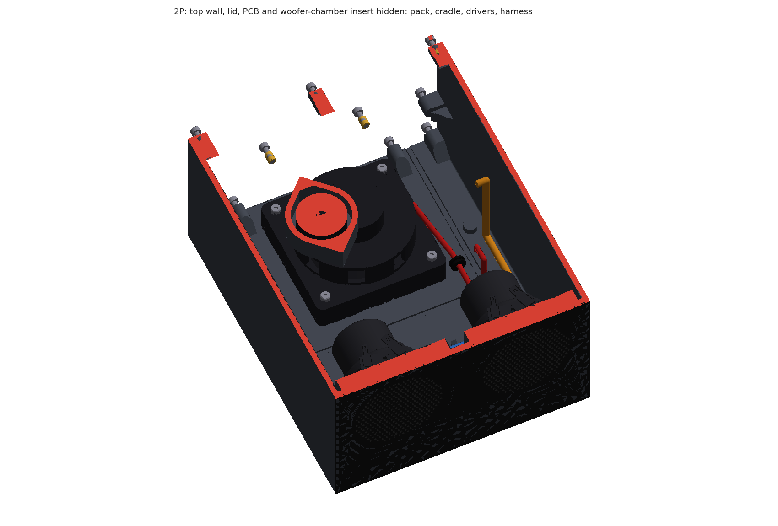
ai-files/cad/v13p4/2P/renders/batt_open_view.png
