chithigun23/DesktopSpeaker/ai-files/cad/v13p4/2P/renders/batt_section_x0_side.png

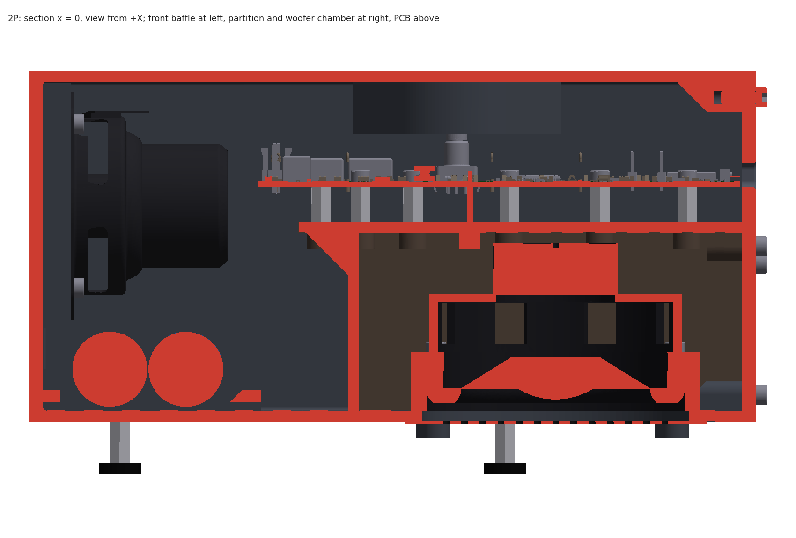
ai-files/cad/v13p4/2P/renders/batt_section_x0_side.png
