chithigun23/DesktopSpeaker/ai-files/cad/v13p4/2P/renders/batt_section_y40_front.png

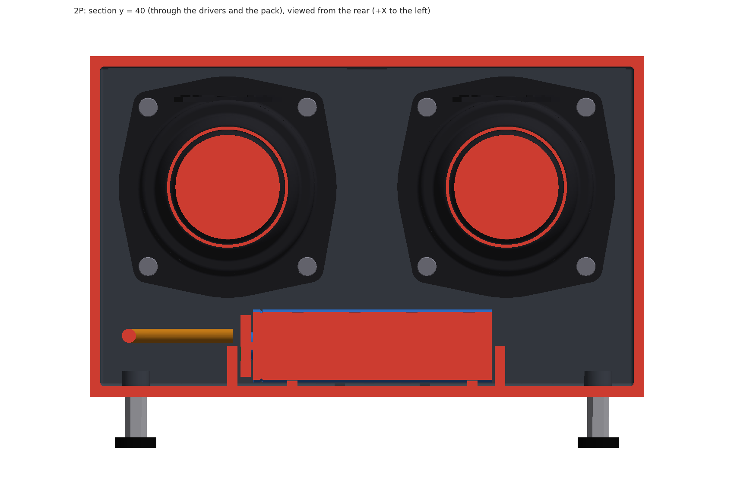
ai-files/cad/v13p4/2P/renders/batt_section_y40_front.png
