chithigun23/DesktopSpeaker/ai-files/cad/v13p4/2P/renders/batt_section_z15_top.png

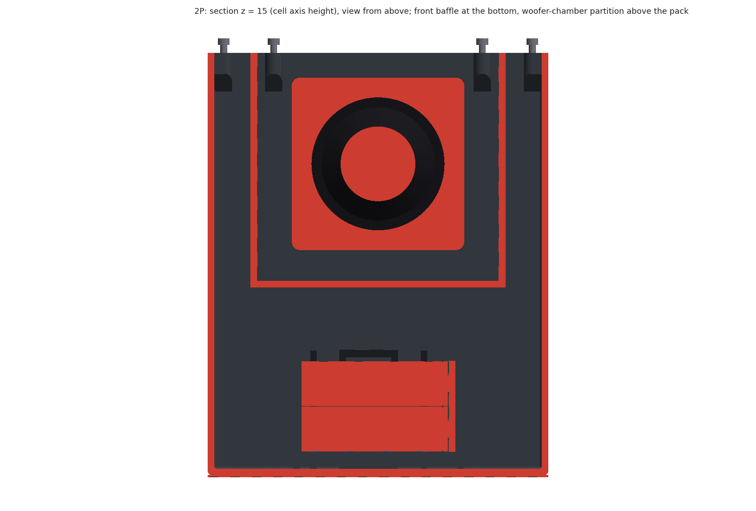
ai-files/cad/v13p4/2P/renders/batt_section_z15_top.png
