chithigun23/DesktopSpeaker/ai-files/cad/v13p4/4P/renders/batt_section_x10.85_side.png

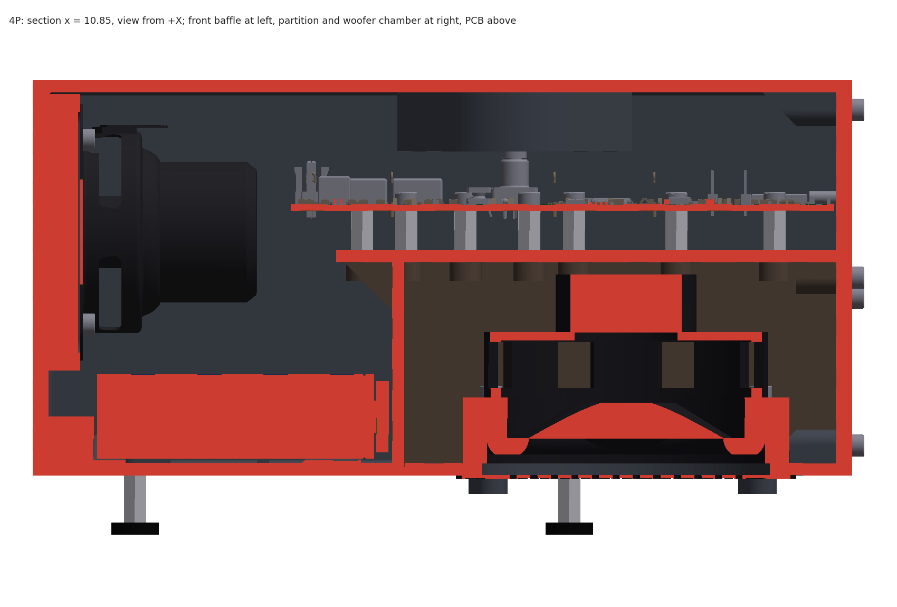
ai-files/cad/v13p4/4P/renders/batt_section_x10.85_side.png
