chithigun23/DesktopSpeaker/ai-files/cad/v15/renders/exploded_front_right.png

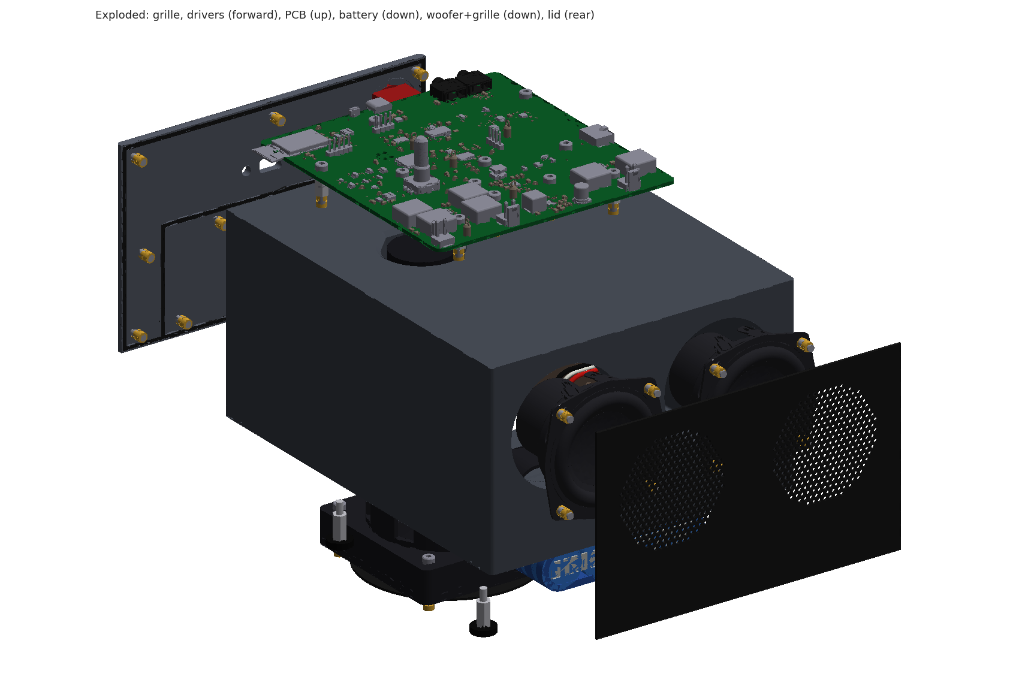
ai-files/cad/v15/renders/exploded_front_right.png
