chithigun23/DesktopSpeaker/ai-files/cad/v15/renders/exploded_rear_left.png

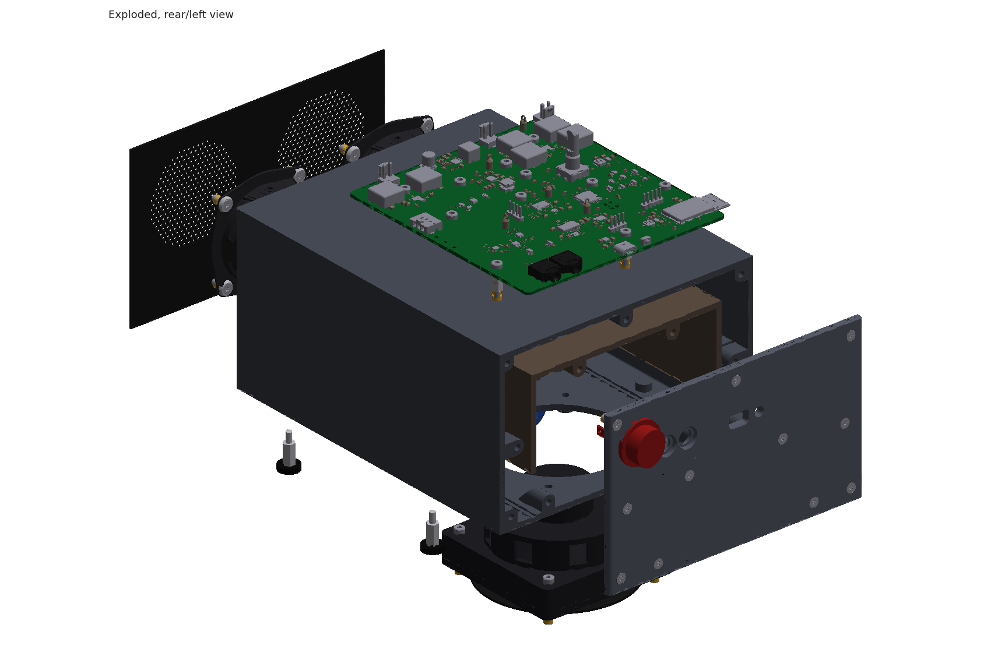
ai-files/cad/v15/renders/exploded_rear_left.png
