chithigun23/DesktopSpeaker/ai-files/cad/v15/renders/open_top_view.png

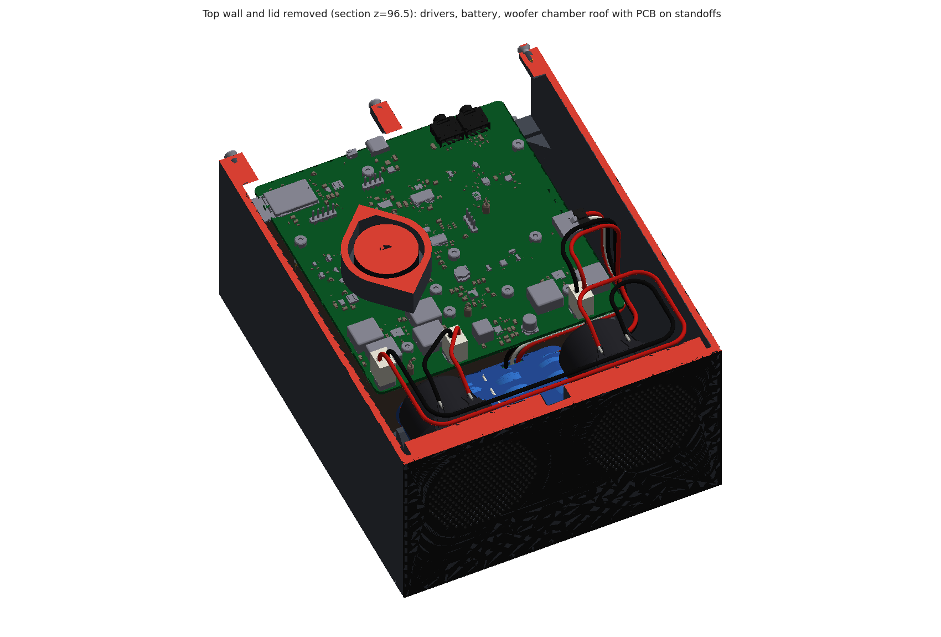
ai-files/cad/v15/renders/open_top_view.png
