chithigun23/DesktopSpeaker/ai-files/cad/v15/renders/rear_lid_drawing.png

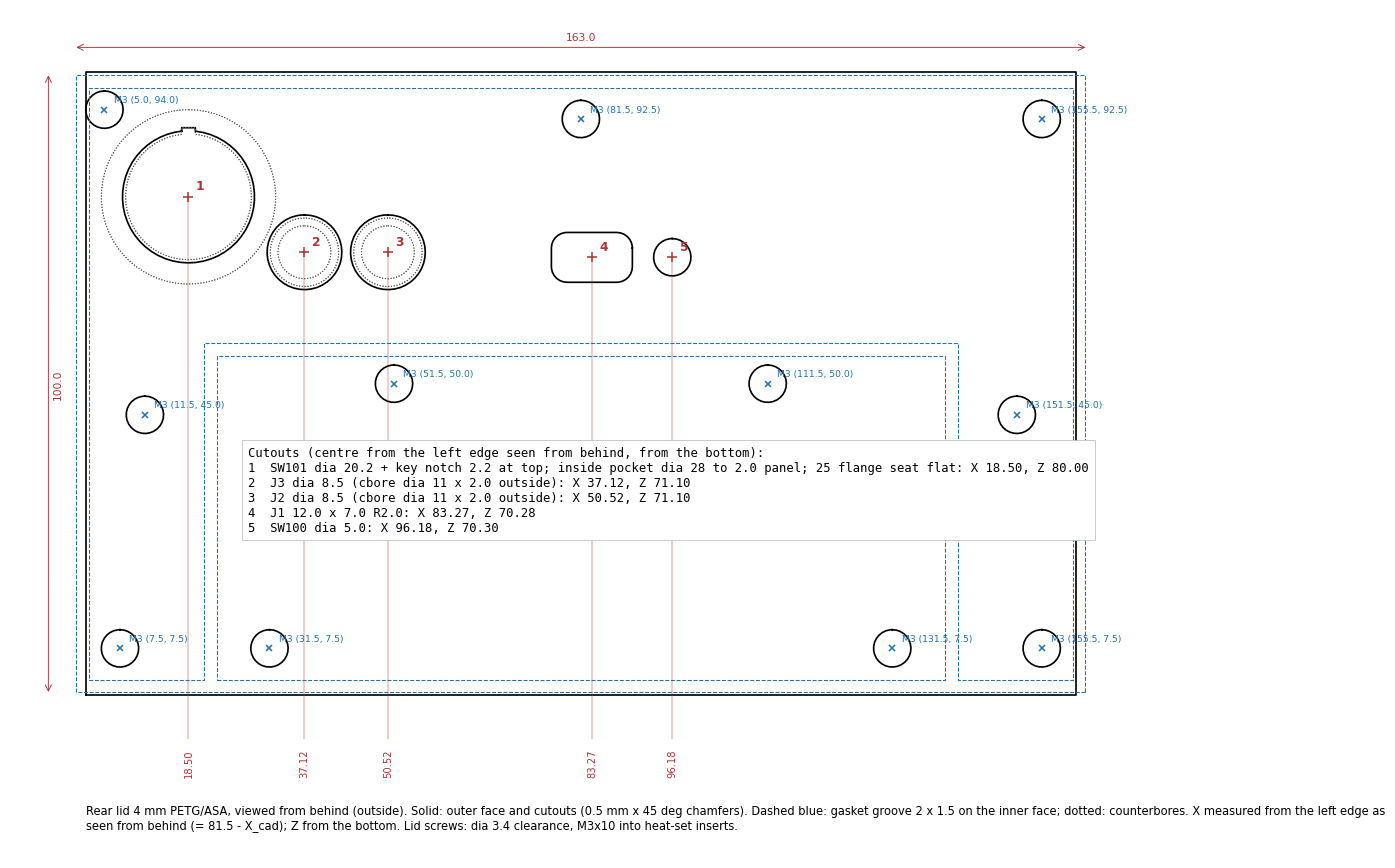
ai-files/cad/v15/renders/rear_lid_drawing.png
