chithigun23/DesktopSpeaker/ai-files/cad/v15/renders/section_x0_woofer.png

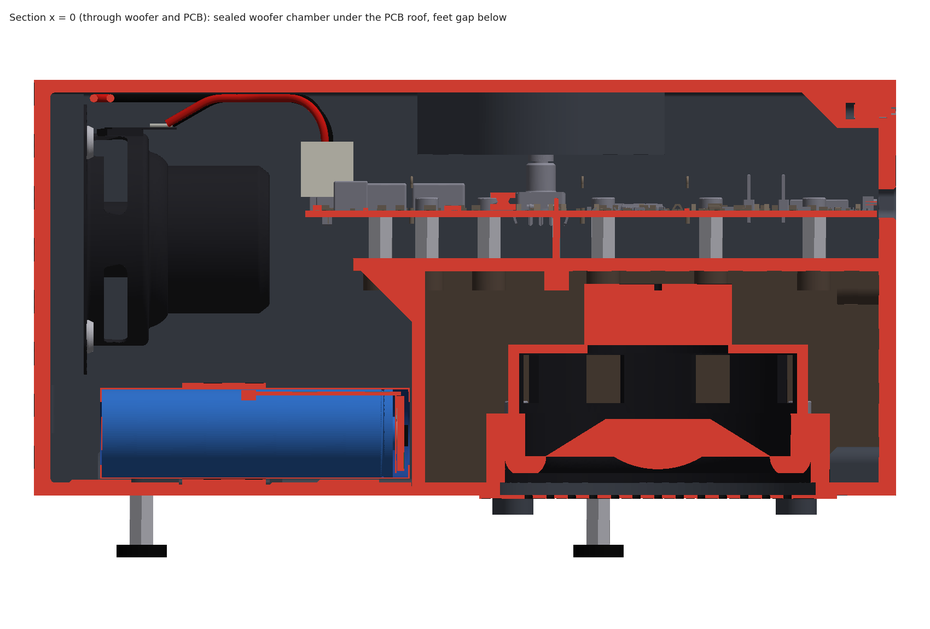
ai-files/cad/v15/renders/section_x0_woofer.png
