chithigun23/DesktopSpeaker/ai-files/cad/v15/renders/section_x-41_driver.png

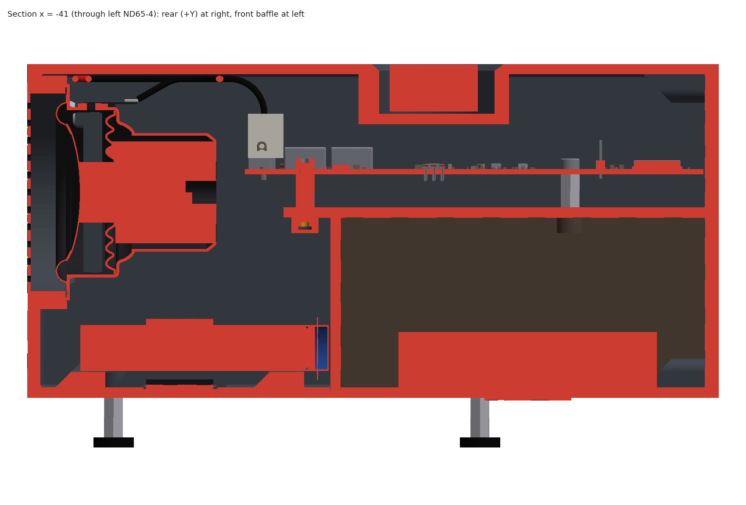
ai-files/cad/v15/renders/section_x-41_driver.png
