chithigun23/DesktopSpeaker/ai-files/cad/v15/renders/section_z75_top.png

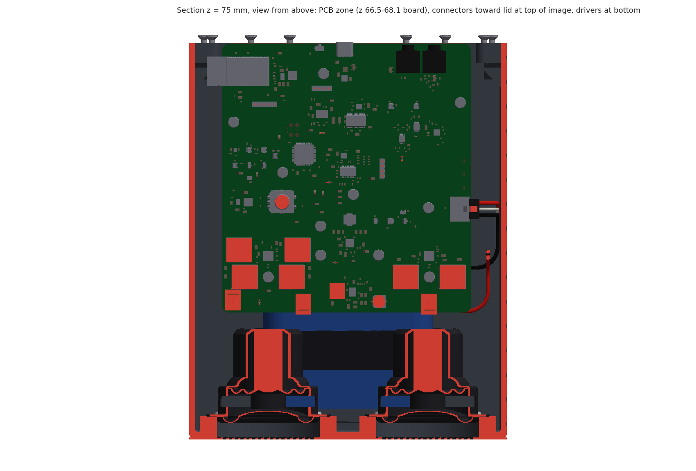
ai-files/cad/v15/renders/section_z75_top.png
