chithigun23/DesktopSpeaker/ai-files/cad/v15/renders/v15_pack_nickel_links.png

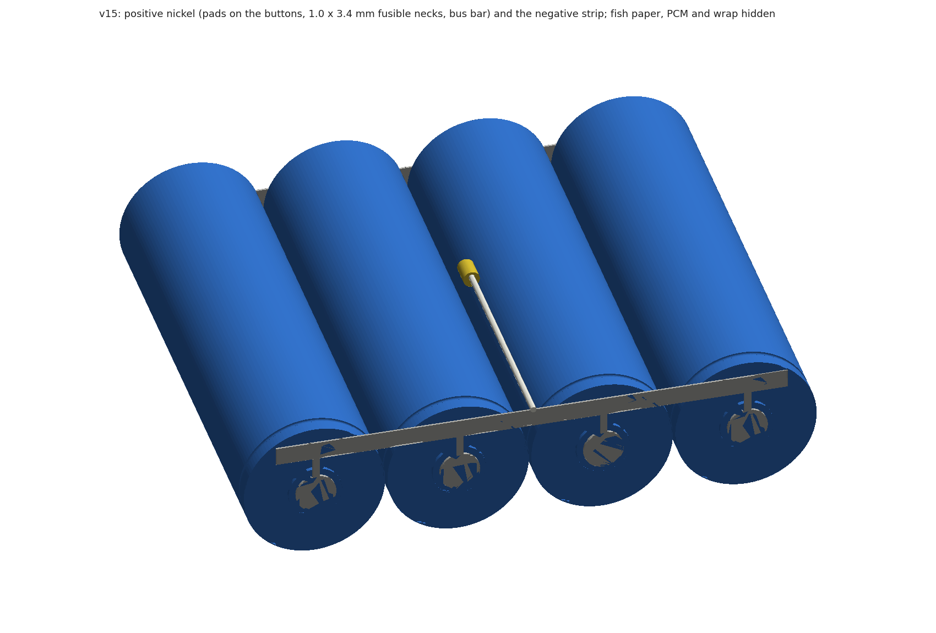
ai-files/cad/v15/renders/v15_pack_nickel_links.png
