chithigun23/DesktopSpeaker/ai-files/cad/v15/renders/v15_pack_positive_end.png

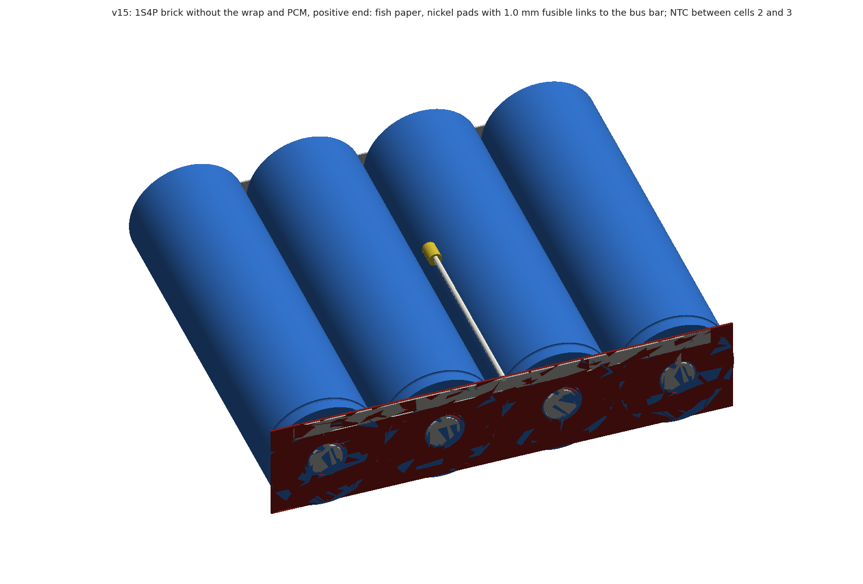
ai-files/cad/v15/renders/v15_pack_positive_end.png
