chithigun23/DesktopSpeaker/ai-files/cad/v15/renders/v15_pack_section_strap.png

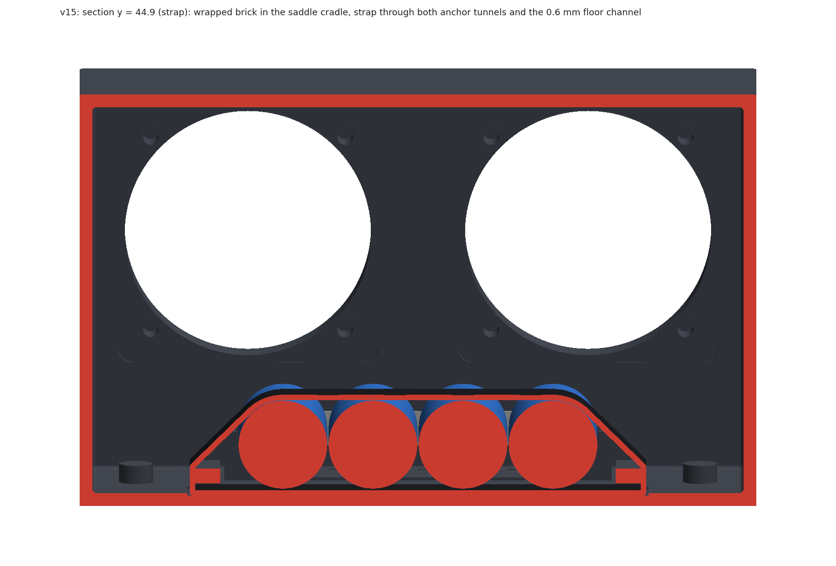
ai-files/cad/v15/renders/v15_pack_section_strap.png
