chithigun23/DesktopSpeaker/ai-files/candidates/Battery_Charger-candidate-page.png

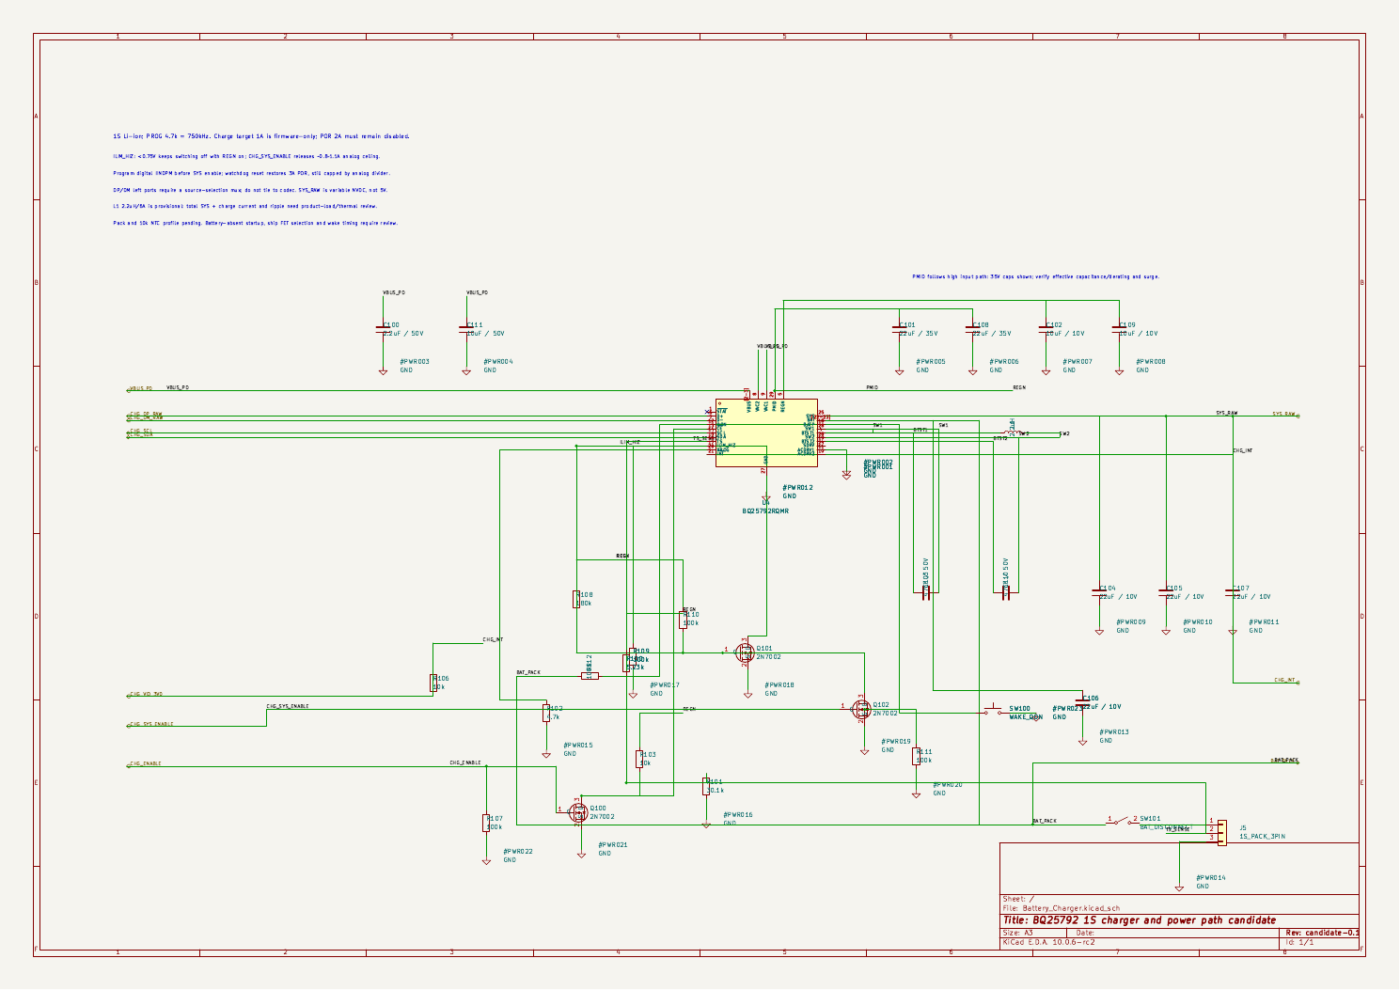
ai-files/candidates/Battery_Charger-candidate-page.png
