chithigun23/DesktopSpeaker/ai-files/candidates/REF0038A_alignment_top.png

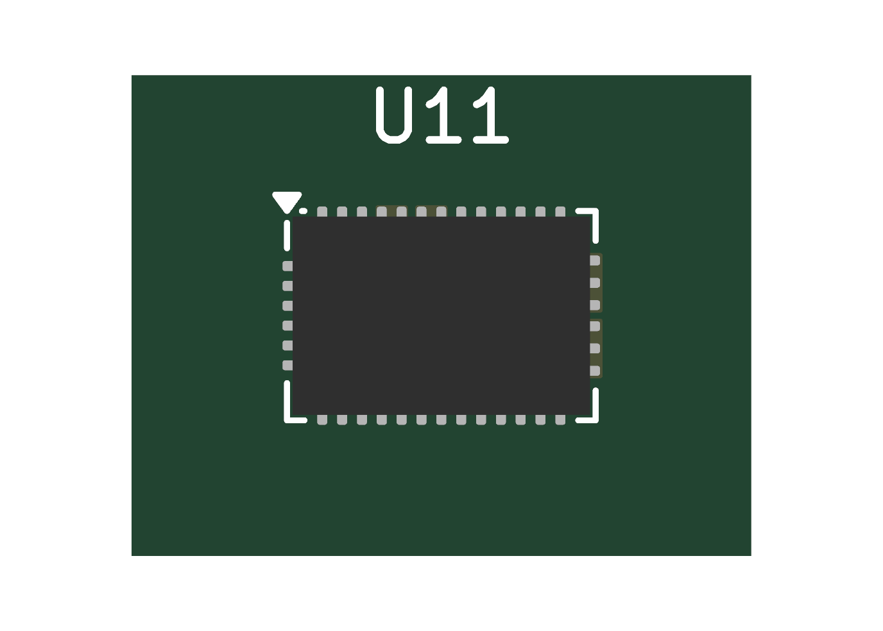
ai-files/candidates/REF0038A_alignment_top.png
