chithigun23/DesktopSpeaker/ai-files/candidates/REF0038A_iso.png

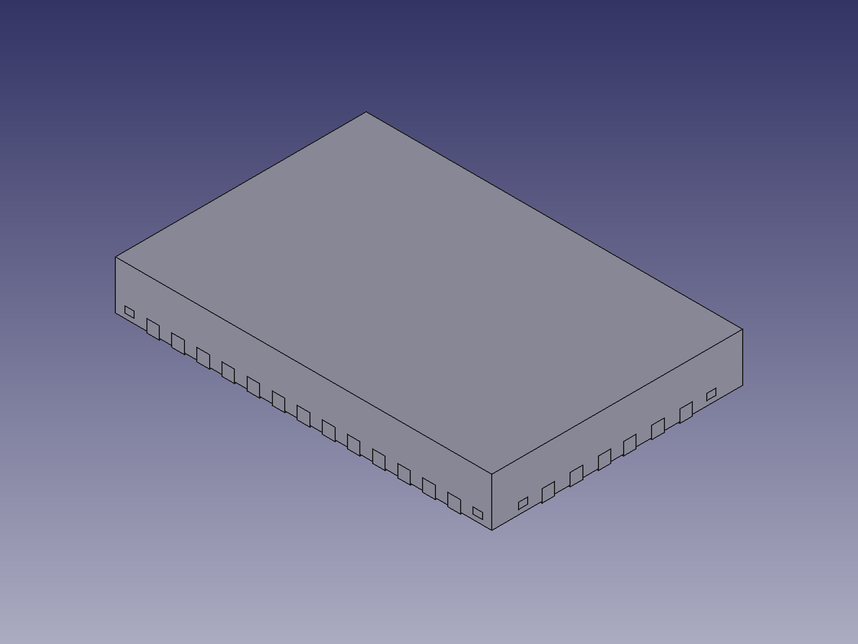
ai-files/candidates/REF0038A_iso.png
