chithigun23/DesktopSpeaker/ai-files/candidates/TPS3839-pinmap-05.png

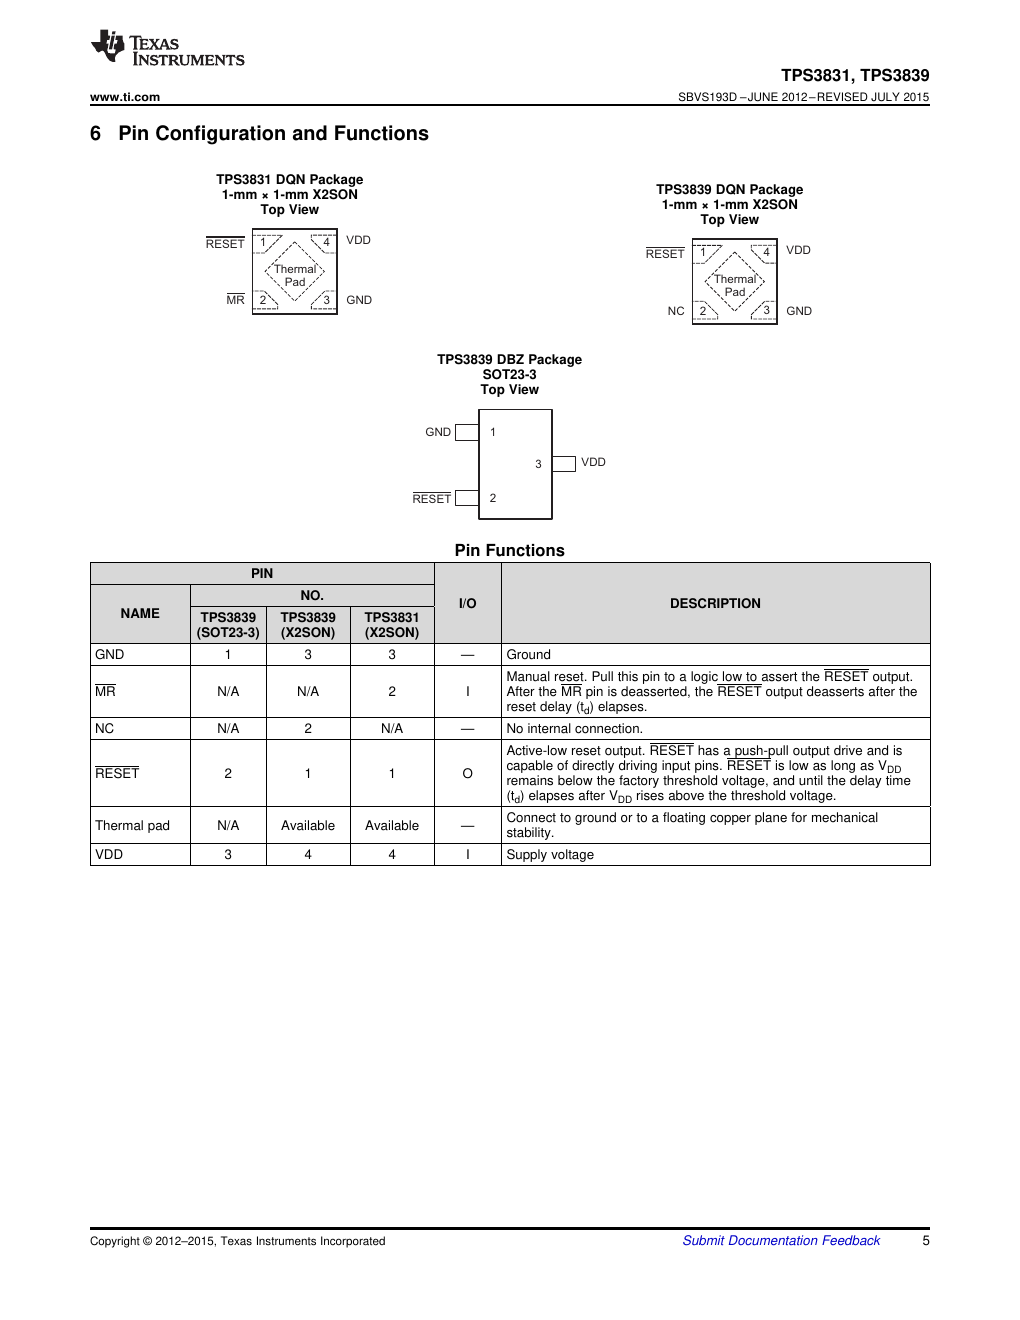
ai-files/candidates/TPS3839-pinmap-05.png
