chithigun23/DesktopSpeaker/ai-files/candidates/TPS25730D_USB_PD_candidate-page.png

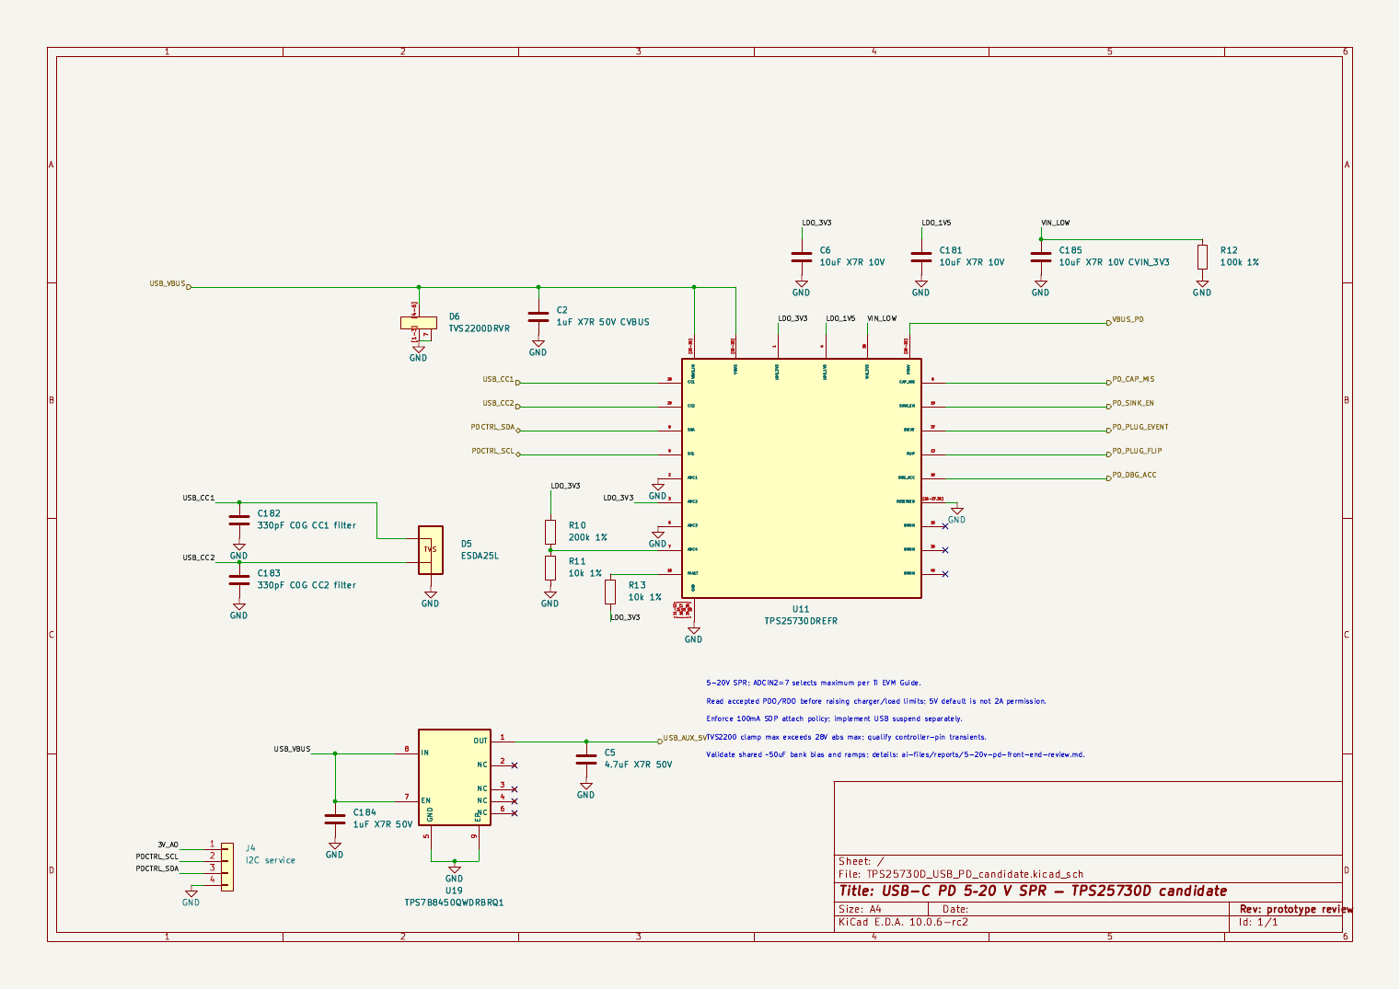
ai-files/candidates/TPS25730D_USB_PD_candidate-page.png
