chithigun23/DesktopSpeaker/ai-files/pcb/layout-top-full.png

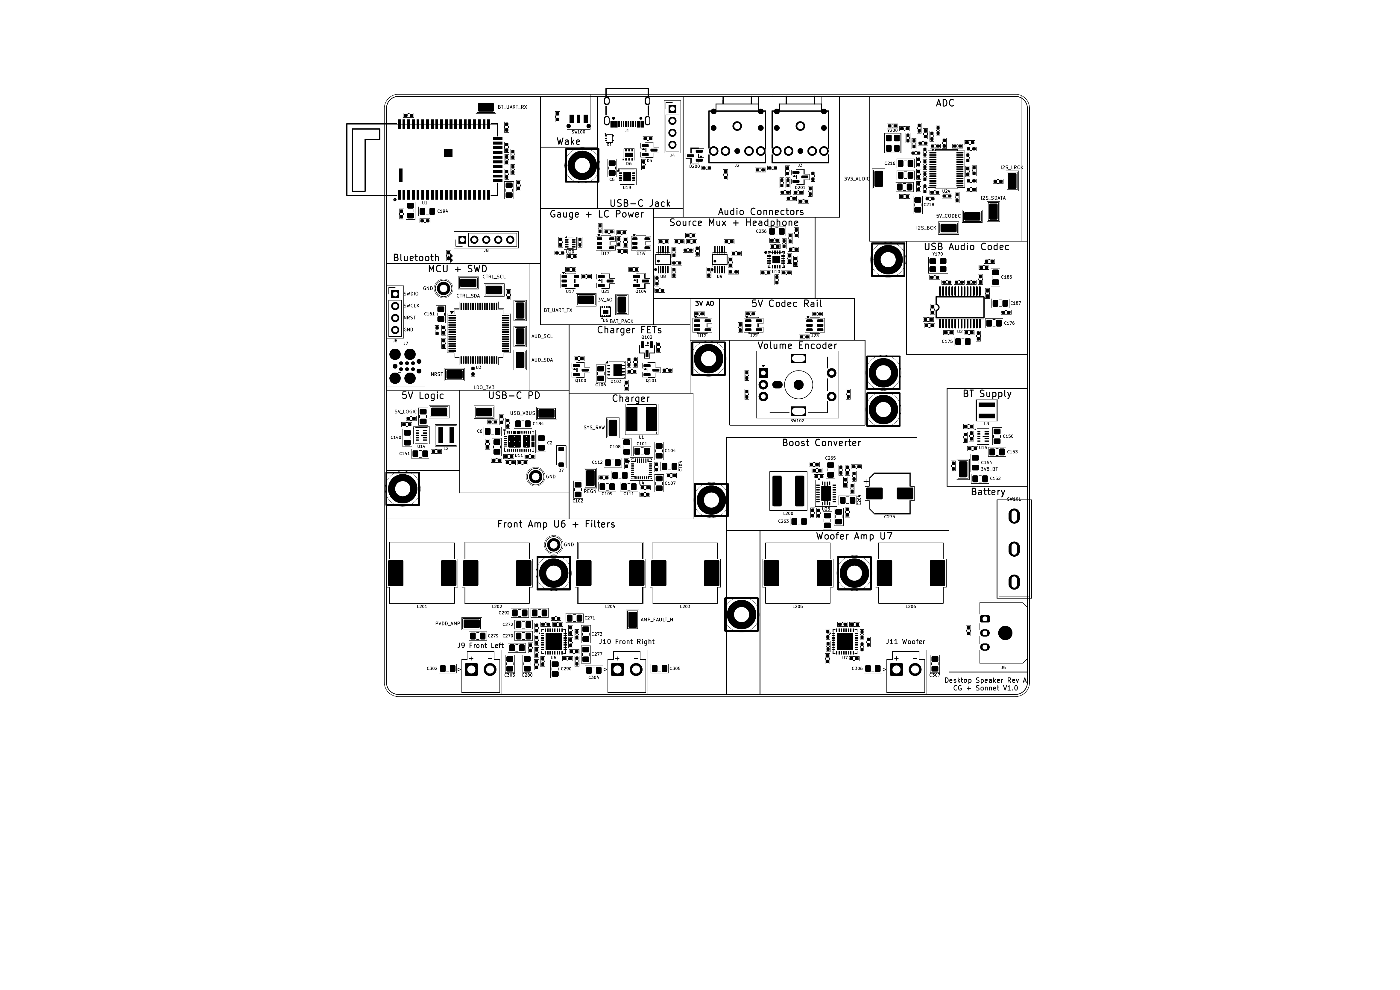
ai-files/pcb/layout-top-full.png
