chithigun23/DesktopSpeaker/ai-files/pcb/layout-v8-top.png

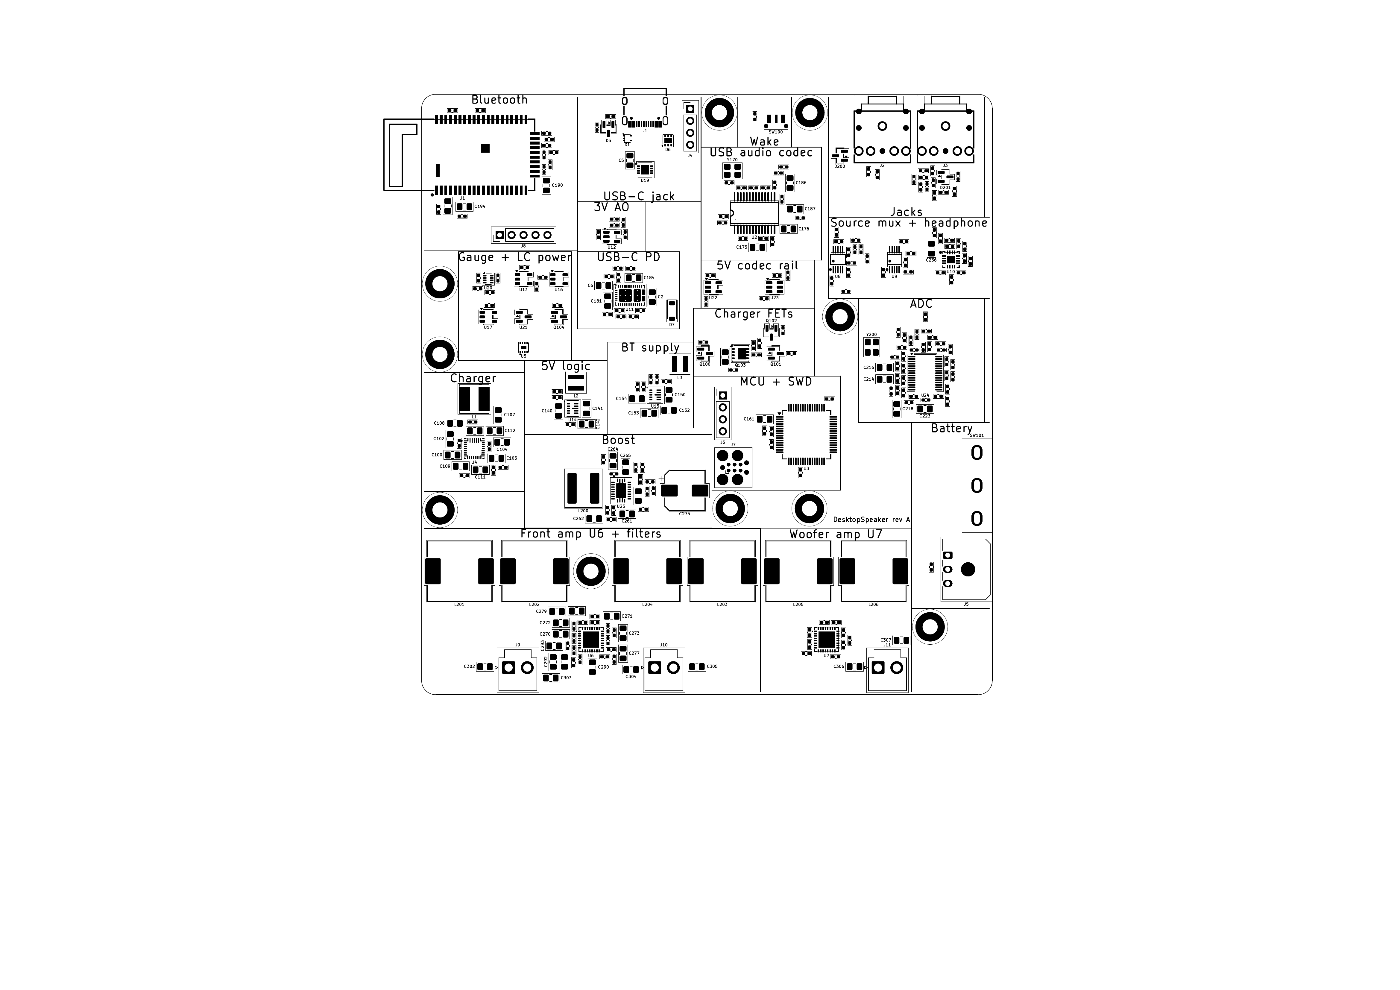
ai-files/pcb/layout-v8-top.png
