chithigun23/DesktopSpeaker/ai-files/pcb/layout-v9-top.png

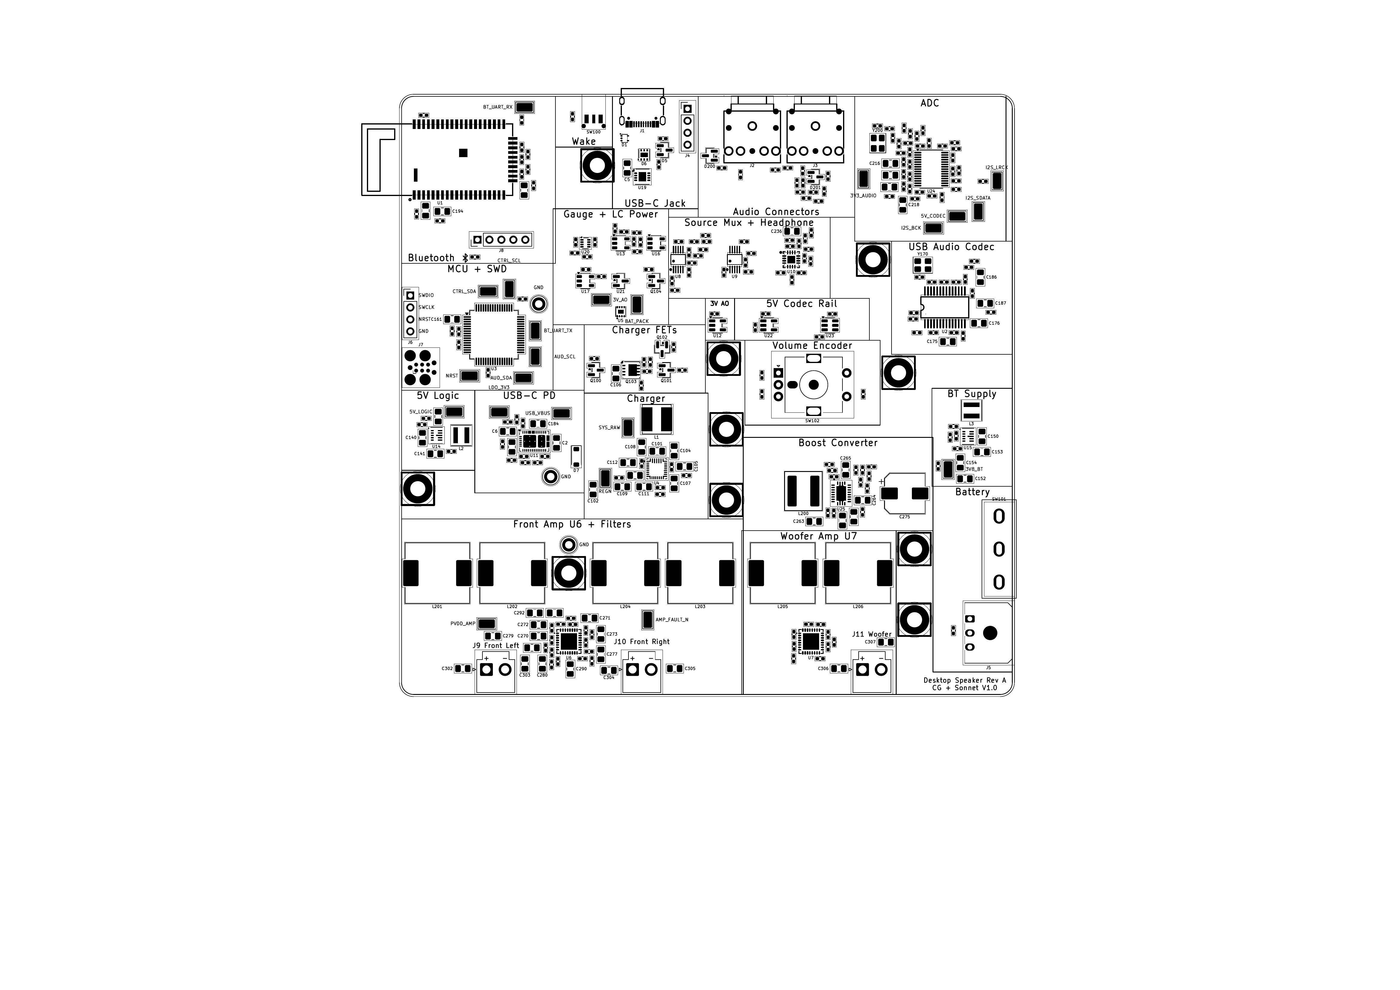
ai-files/pcb/layout-v9-top.png
