chithigun23/DesktopSpeaker/ai-files/pcb/layout-v10-top.png

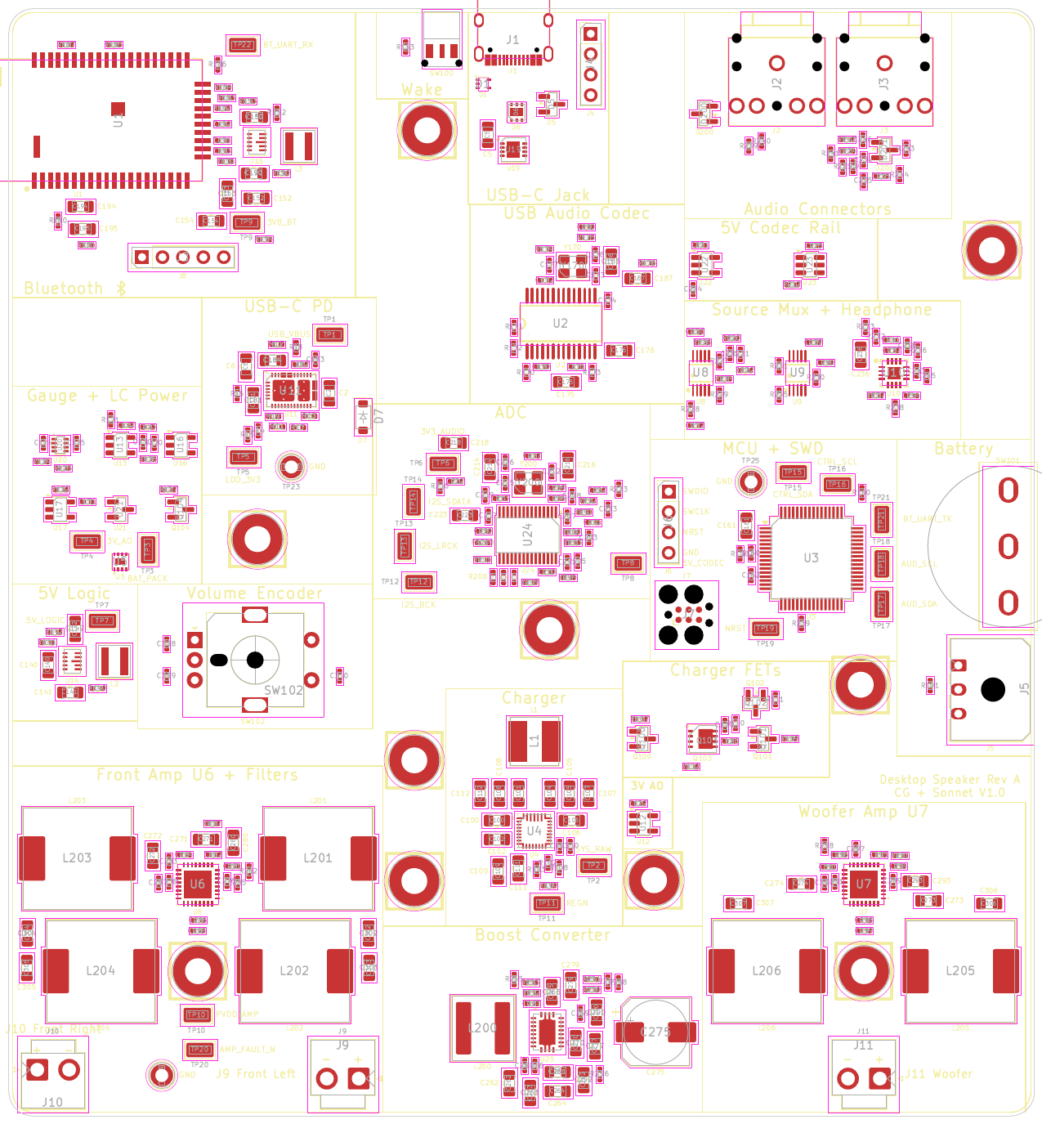
ai-files/pcb/layout-v10-top.png
