chithigun23/DesktopSpeaker/ai-files/pcb/layout-v10b-top.png

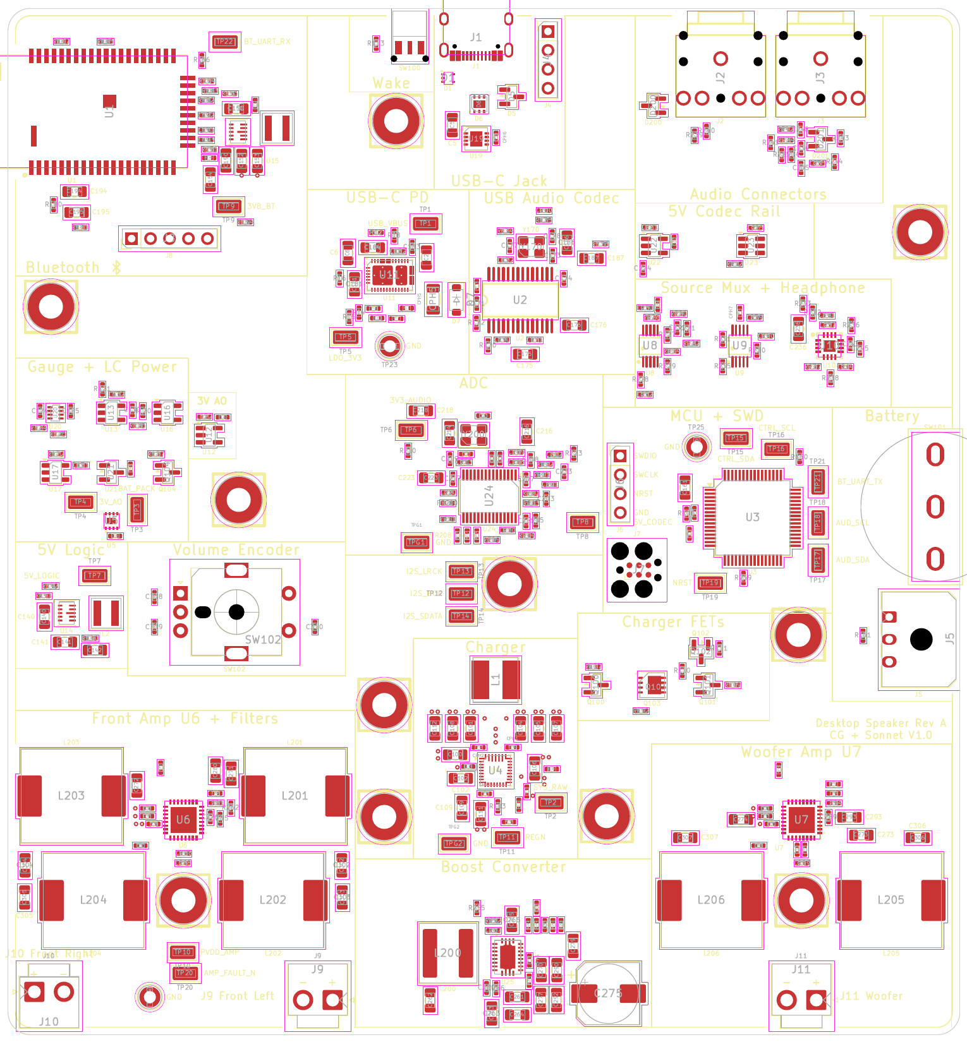
ai-files/pcb/layout-v10b-top.png
