chithigun23/DesktopSpeaker/ai-files/pcb/reference-bspd-silkscreen.png

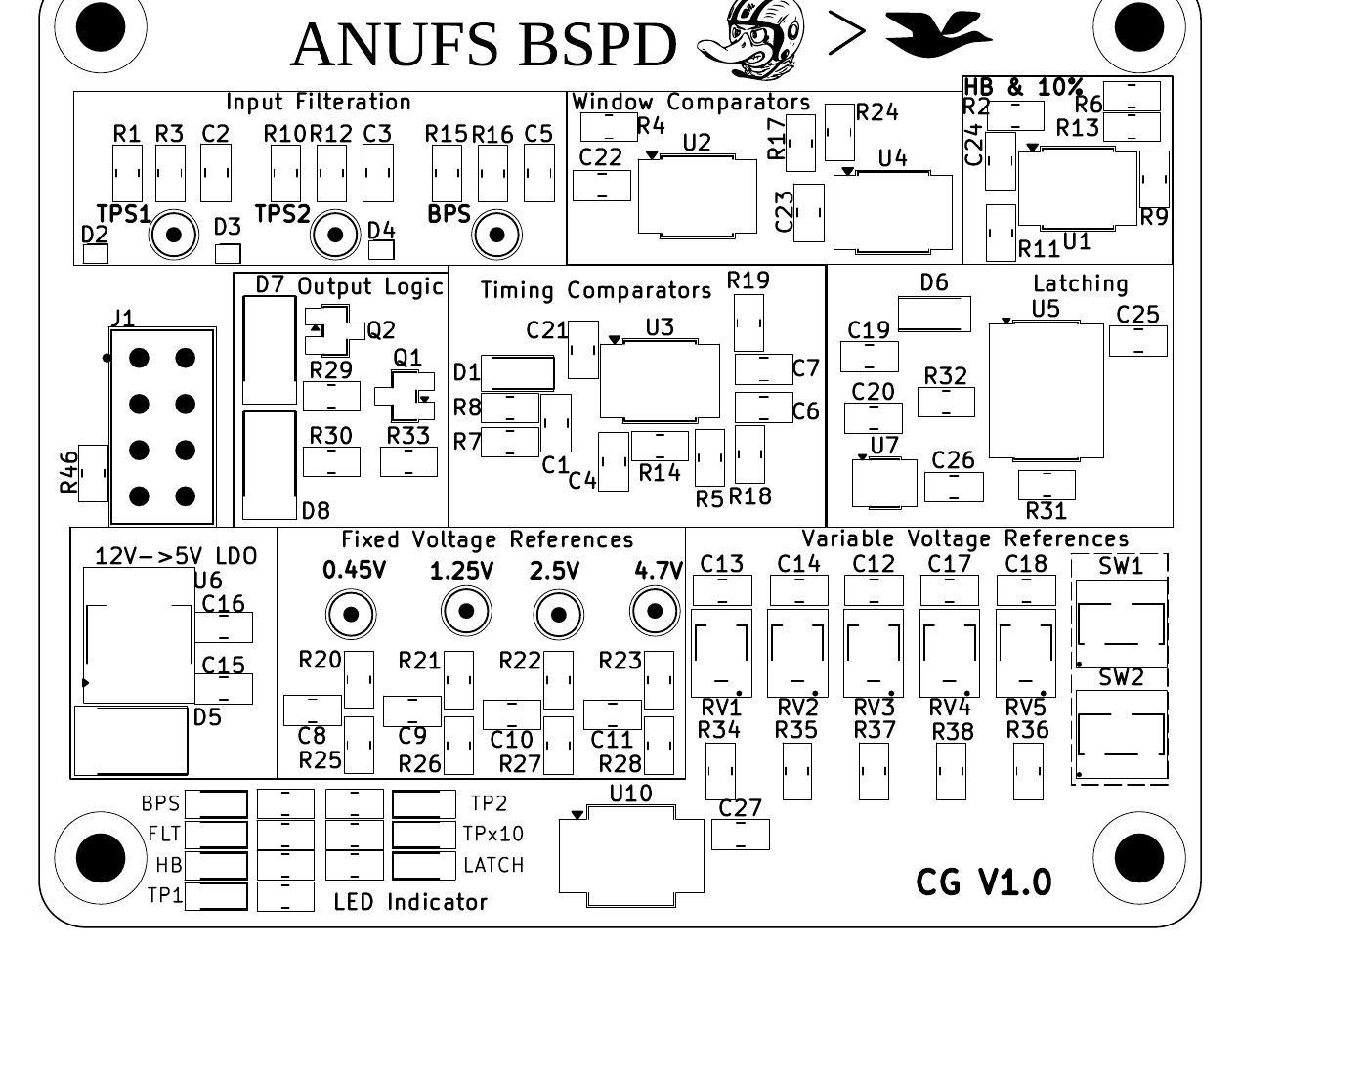
ai-files/pcb/reference-bspd-silkscreen.png
