chithigun23/DesktopSpeaker/ai-files/pcb/renders/board-r8-iso-4k.png

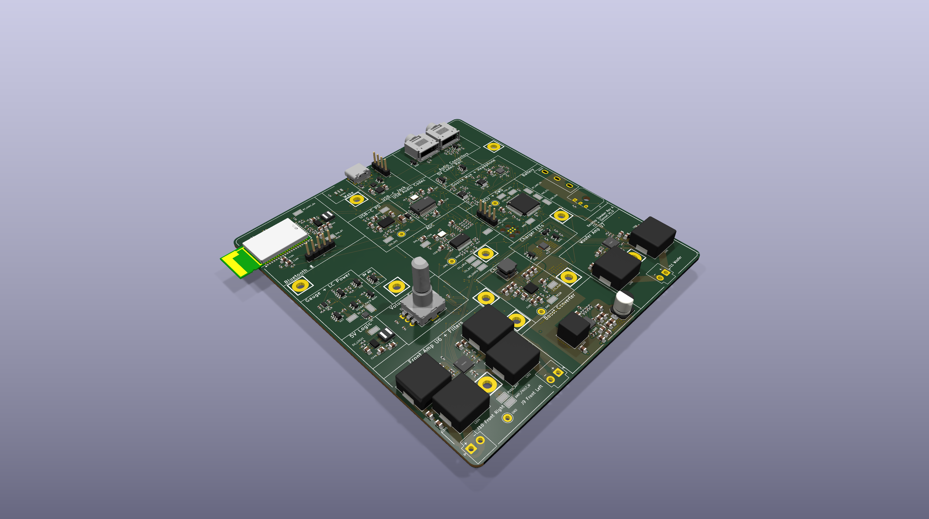
ai-files/pcb/renders/board-r8-iso-4k.png
