chithigun23/DesktopSpeaker/ai-files/pcb/route-p0-plot-F.Cu.png

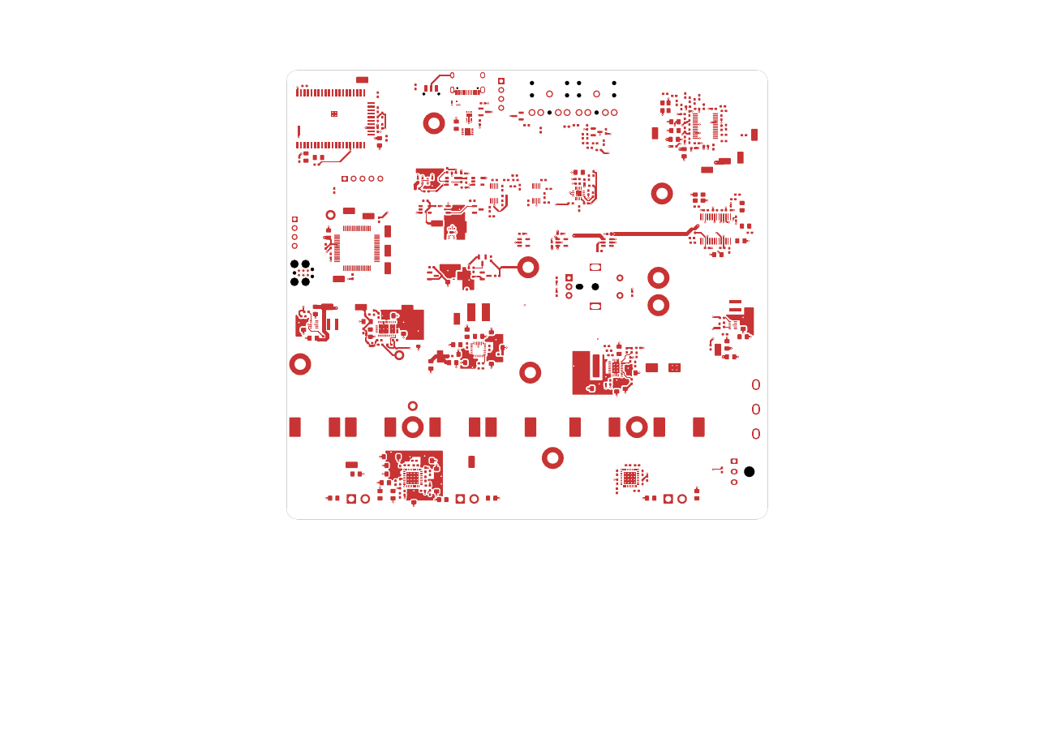
ai-files/pcb/route-p0-plot-F.Cu.png
