chithigun23/DesktopSpeaker/ai-files/pcb/route-p0-plot-In2.Cu.png

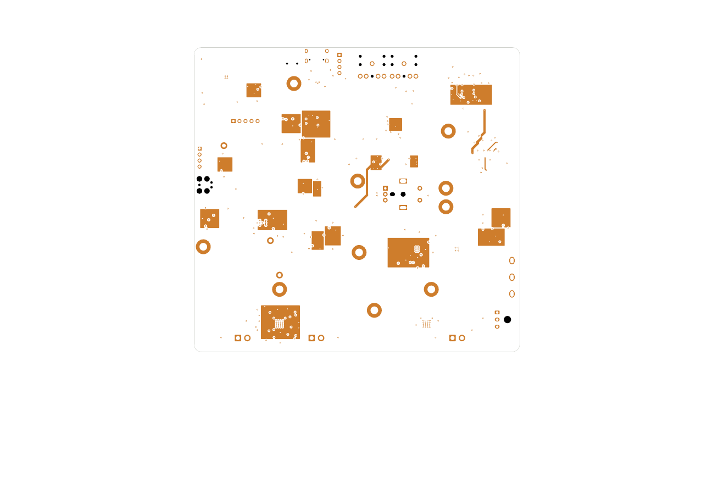
ai-files/pcb/route-p0-plot-In2.Cu.png
