chithigun23/DesktopSpeaker/ai-files/pcb/route-p0-top.png

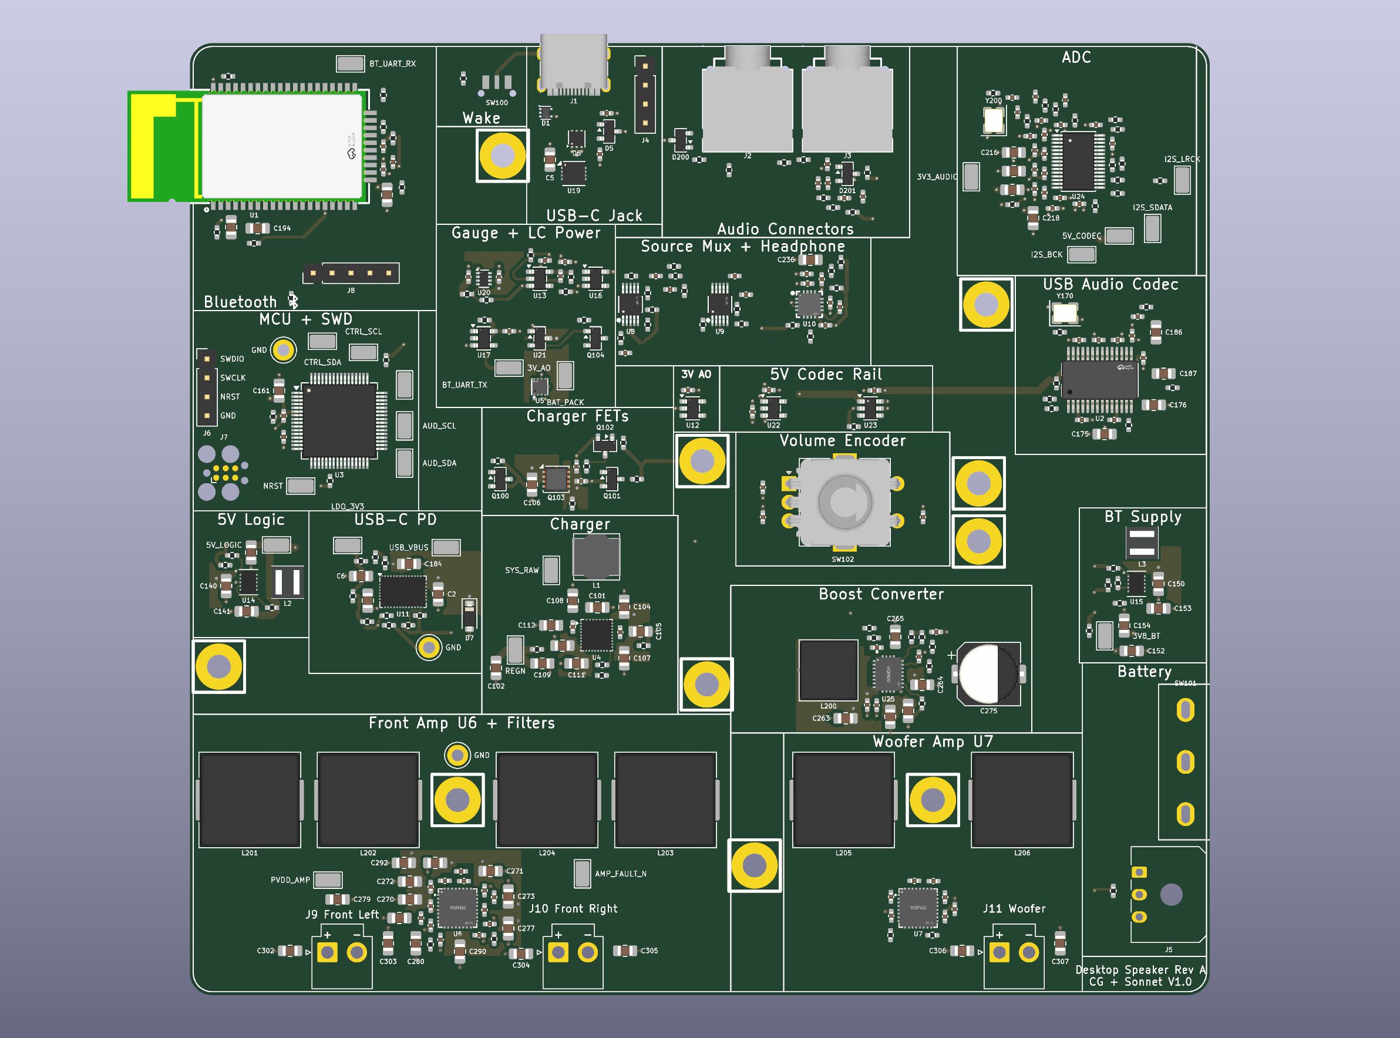
ai-files/pcb/route-p0-top.png
