chithigun23/DesktopSpeaker/ai-files/pcb/route-p2-top.png

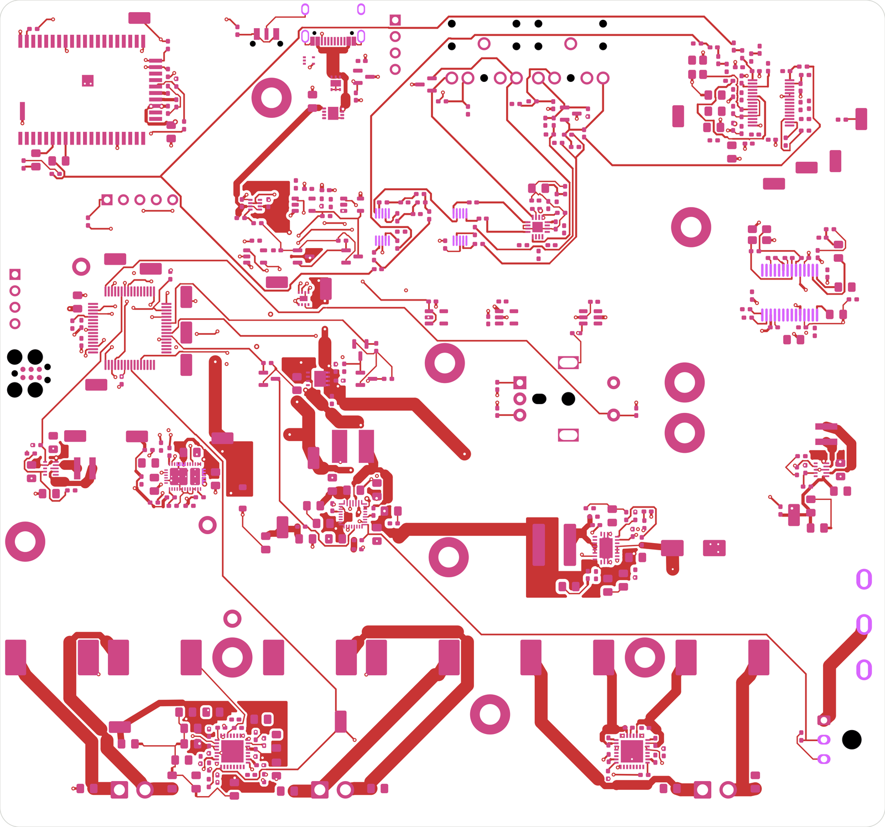
ai-files/pcb/route-p2-top.png
