chithigun23/DesktopSpeaker/ai-files/pcb/route-p3-top.png

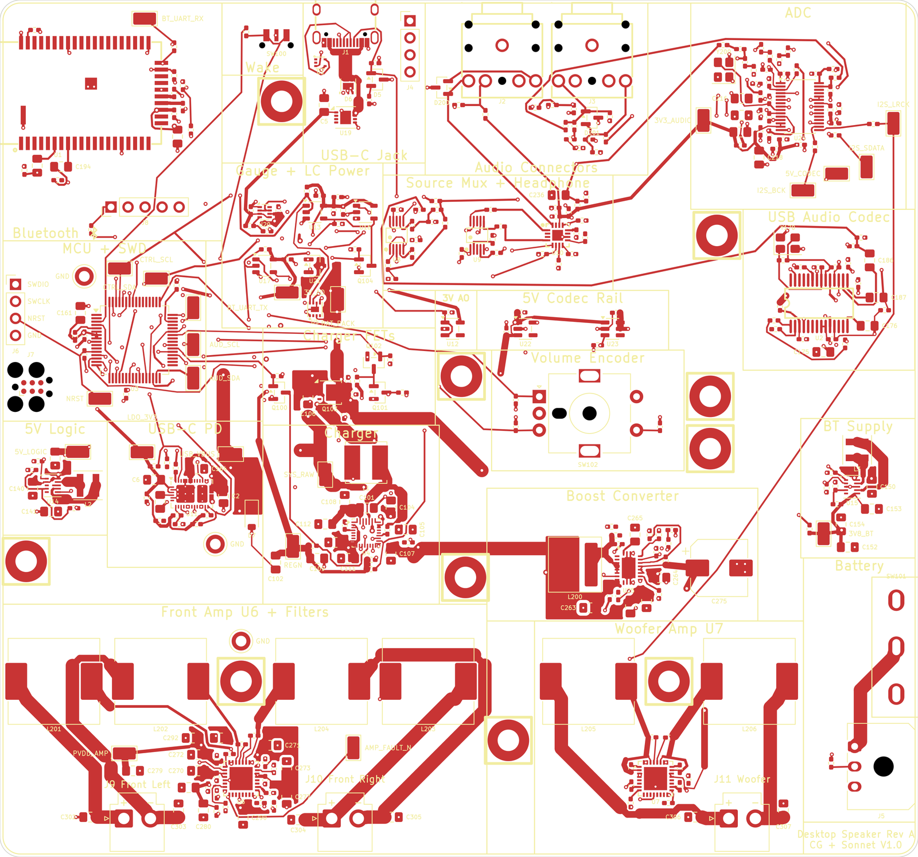
ai-files/pcb/route-p3-top.png
