chithigun23/DesktopSpeaker/ai-files/pcb/route-r6a-power-F.png

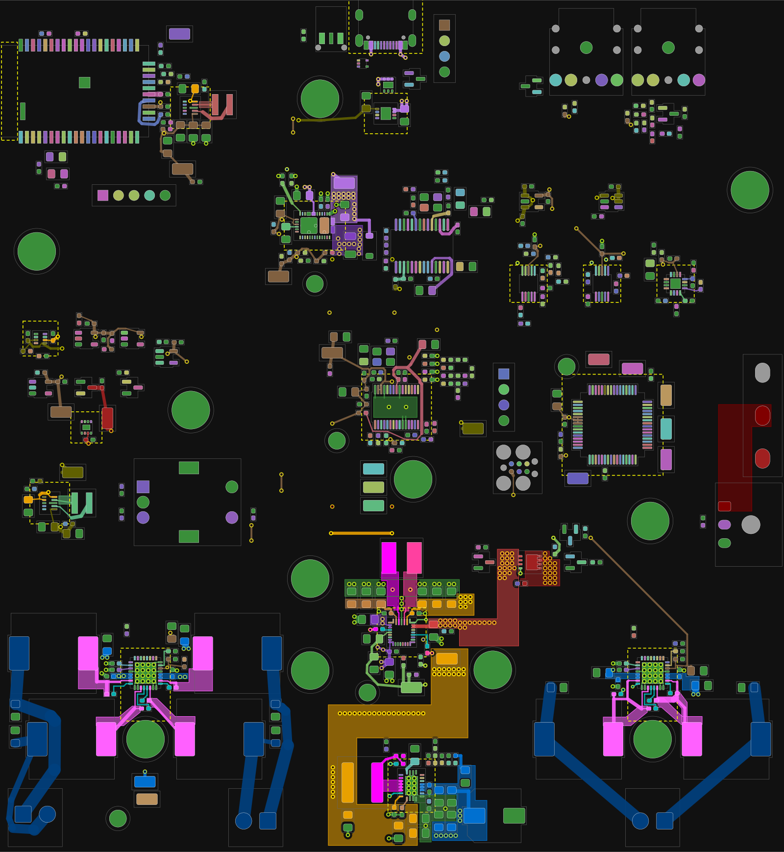
ai-files/pcb/route-r6a-power-F.png
