chithigun23/DesktopSpeaker/ai-files/pcb/route-r6a-power-In2B.png

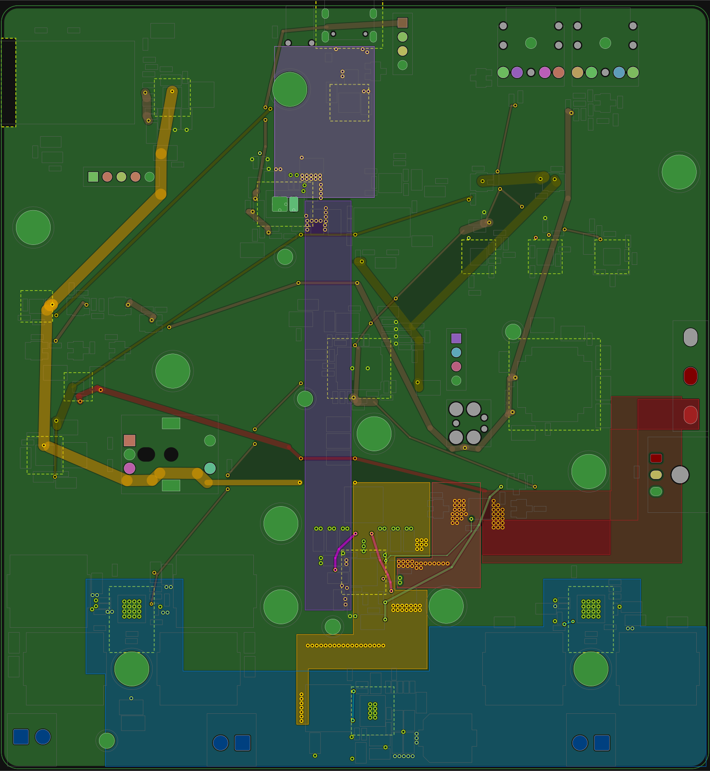
ai-files/pcb/route-r6a-power-In2B.png
