chithigun23/DesktopSpeaker/ai-files/pcb/route-r6b-bottom.png

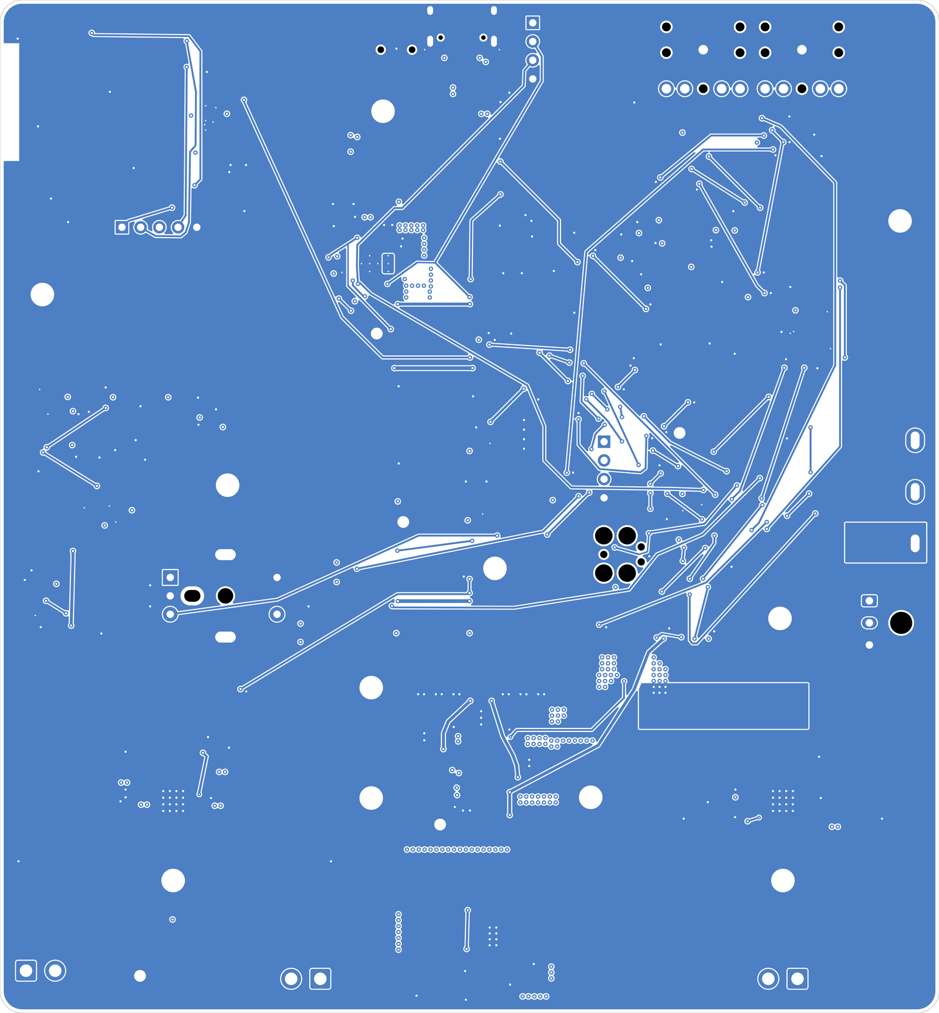
ai-files/pcb/route-r6b-bottom.png
