chithigun23/DesktopSpeaker/ai-files/pcb/route-r6b-top.png

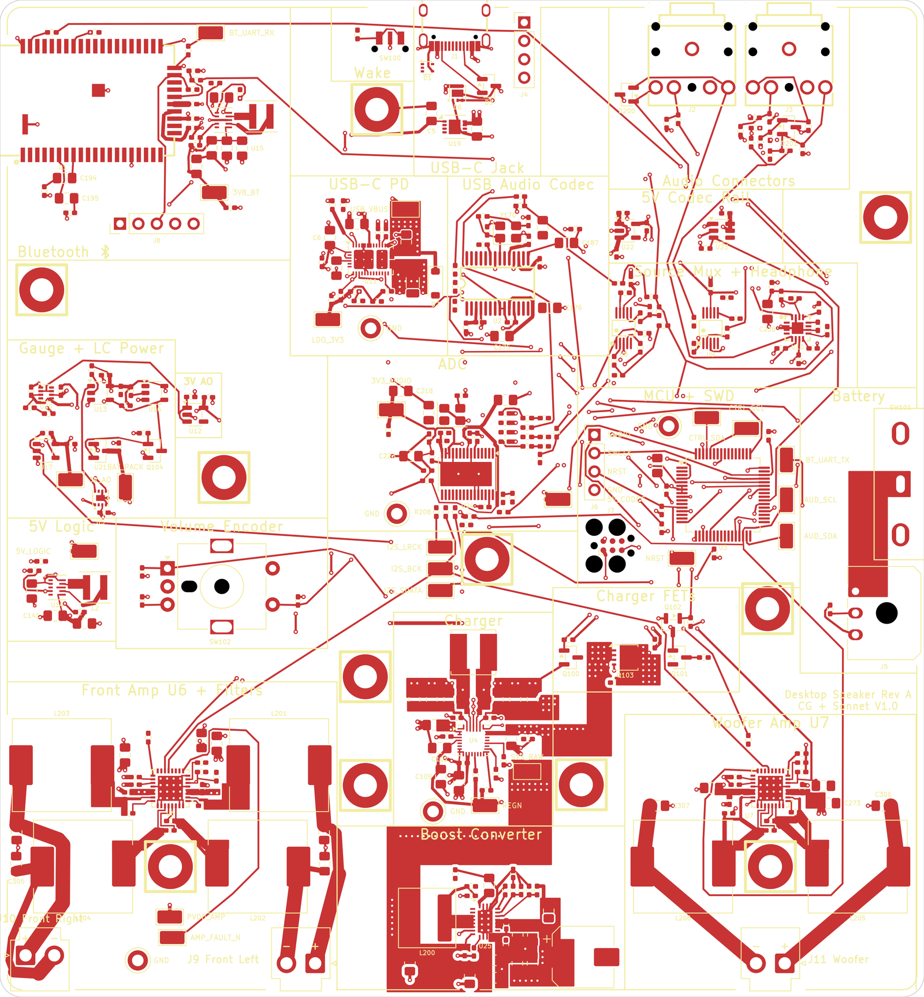
ai-files/pcb/route-r6b-top.png
