chithigun23/DesktopSpeaker/ai-files/pcb/route-r6c-bottom.png

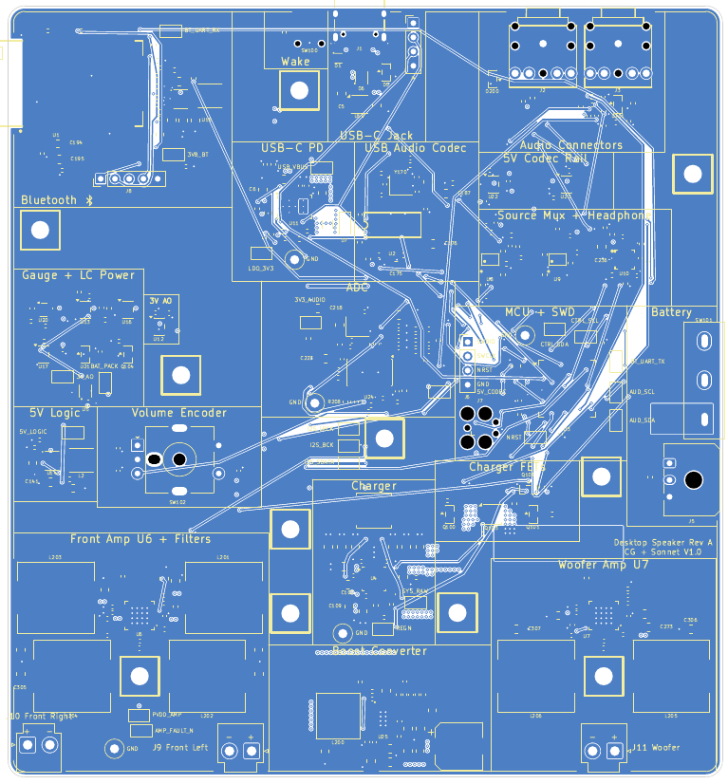
ai-files/pcb/route-r6c-bottom.png
