chithigun23/DesktopSpeaker/ai-files/pcb/route-r6c-top.png

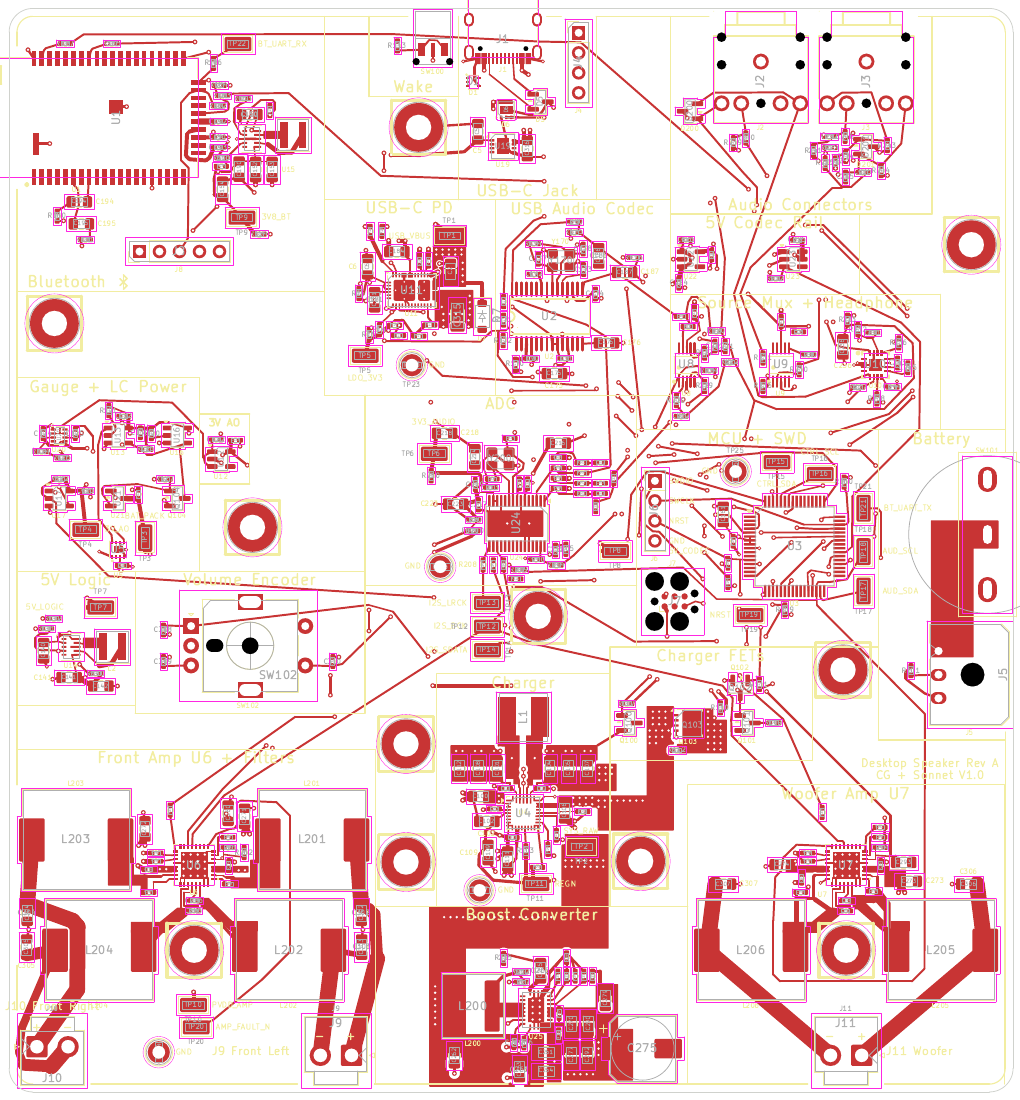
ai-files/pcb/route-r6c-top.png
