chithigun23/DesktopSpeaker/ai-files/pcb/route-r6f-bottom.png

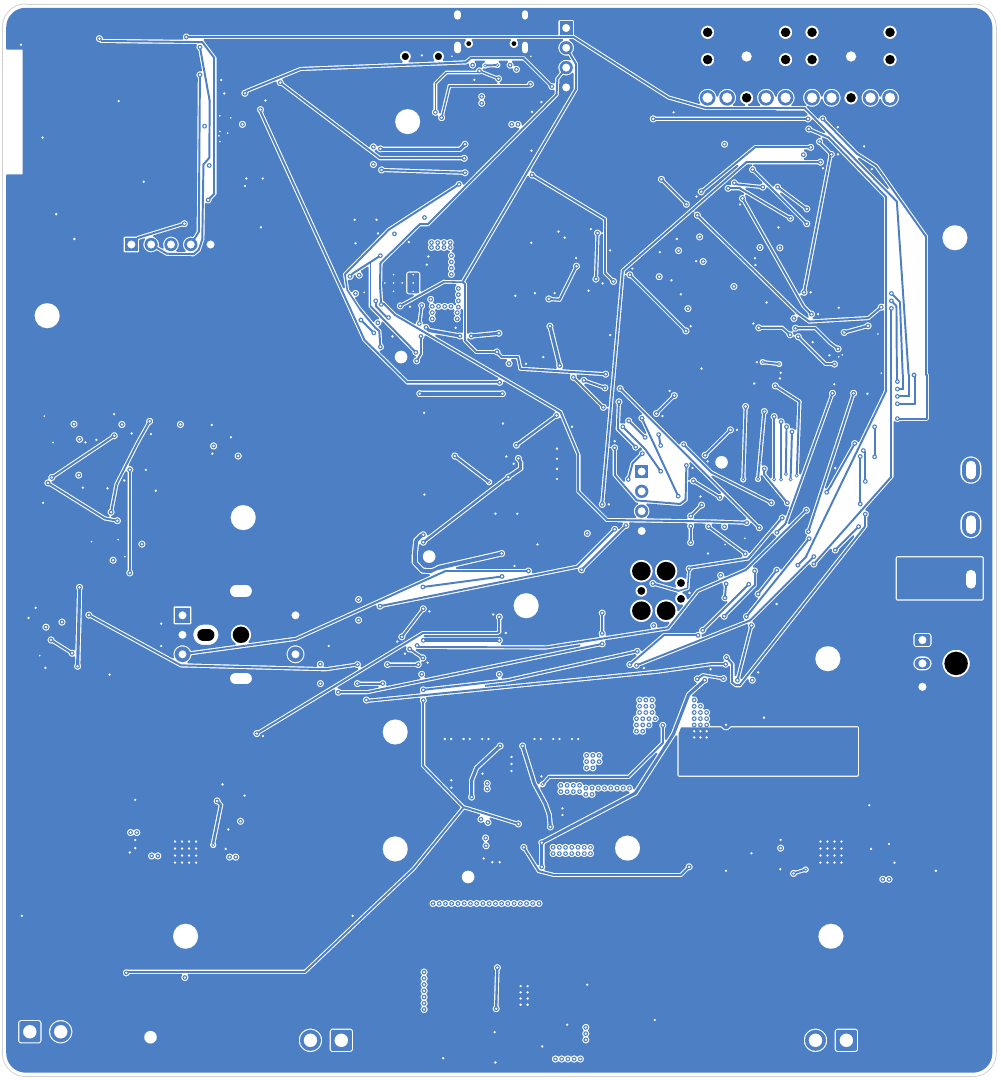
ai-files/pcb/route-r6f-bottom.png
