chithigun23/DesktopSpeaker/ai-files/pcb/route-r6g-bottom.png

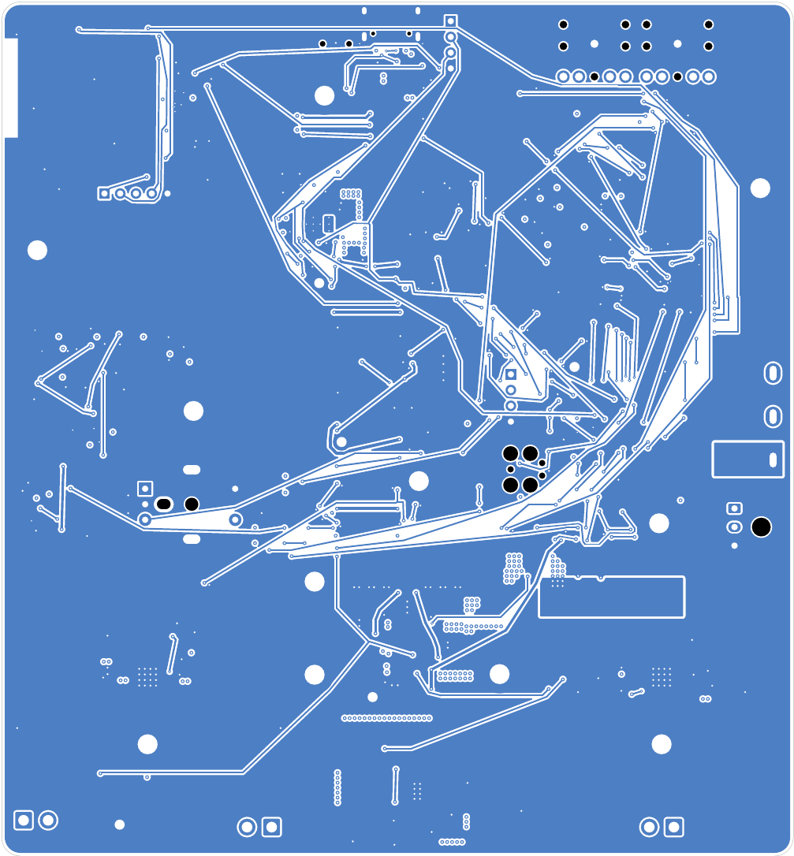
ai-files/pcb/route-r6g-bottom.png
