chithigun23/DesktopSpeaker/ai-files/pcb/route-r6h-bottom.png

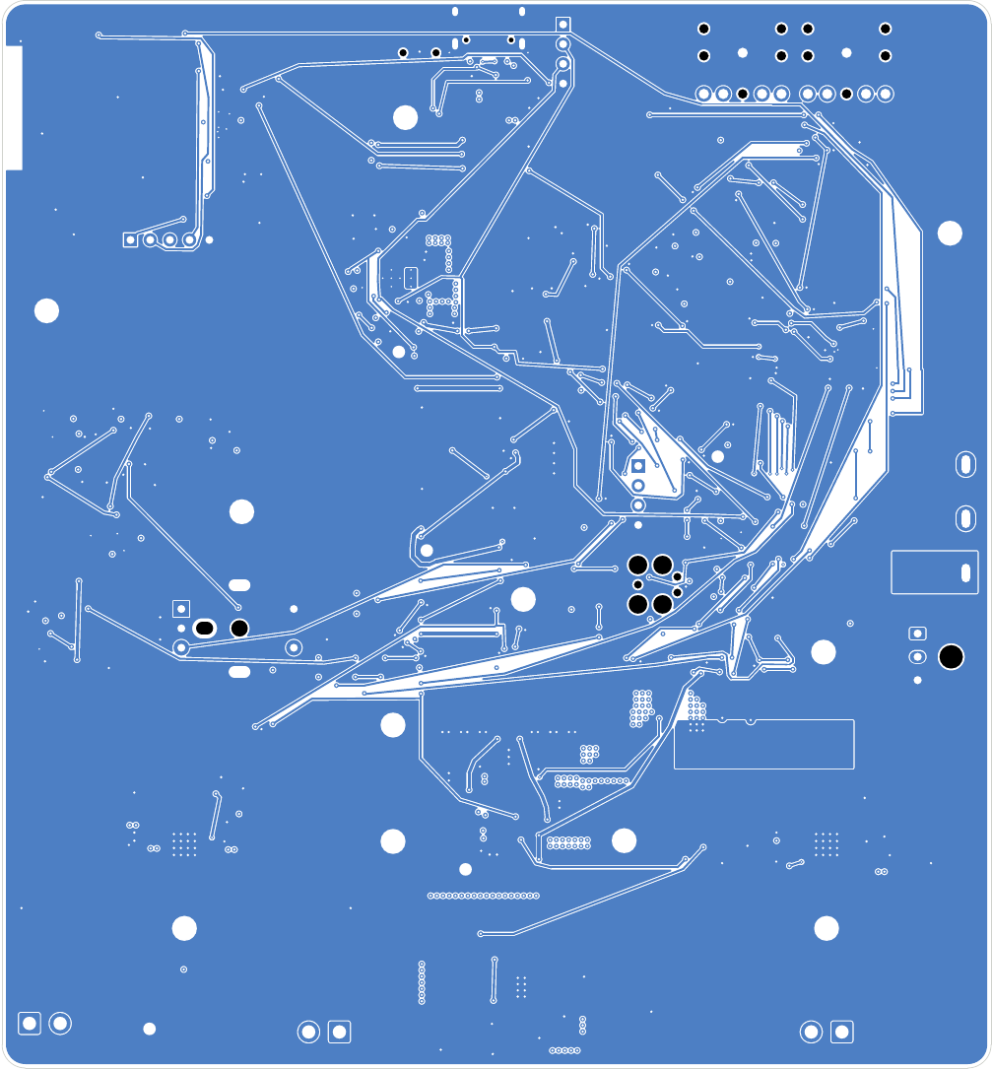
ai-files/pcb/route-r6h-bottom.png
