chithigun23/DesktopSpeaker/ai-files/pcb/route-r6h-top.png

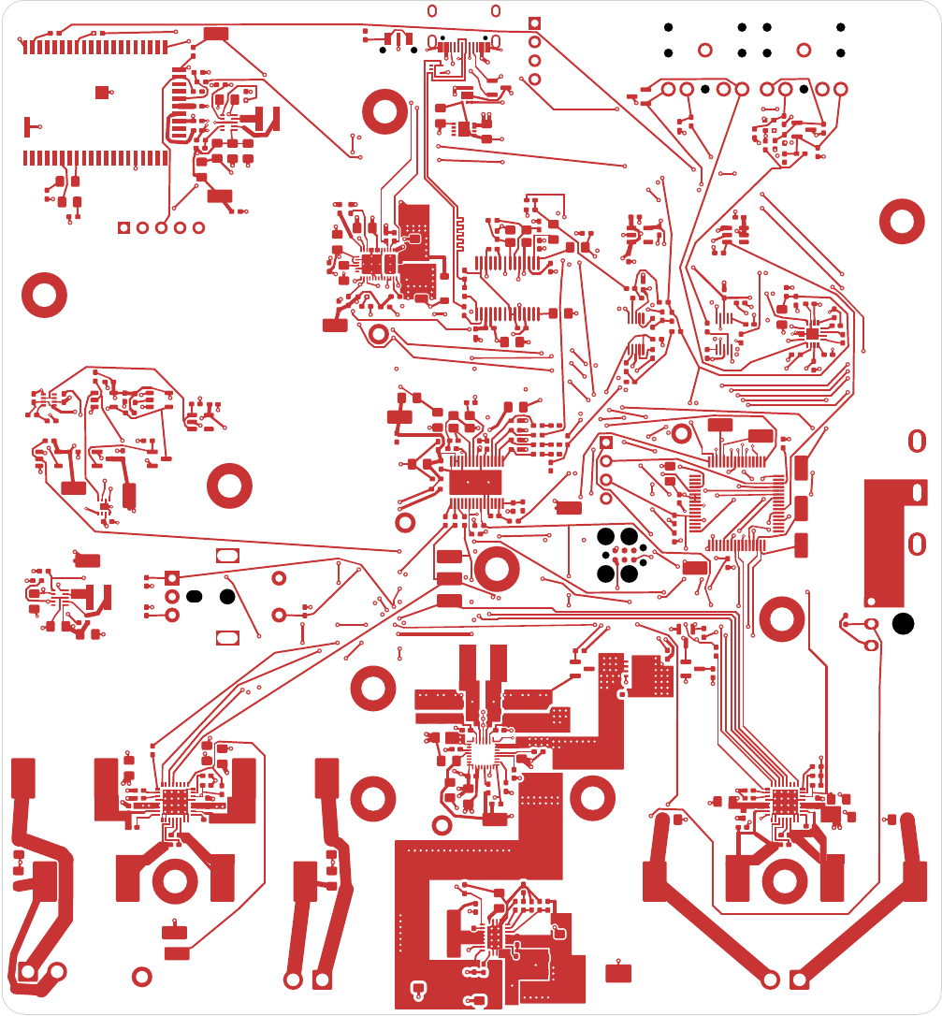
ai-files/pcb/route-r6h-top.png
