chithigun23/DesktopSpeaker/ai-files/pcb/route-r6i-in2.png

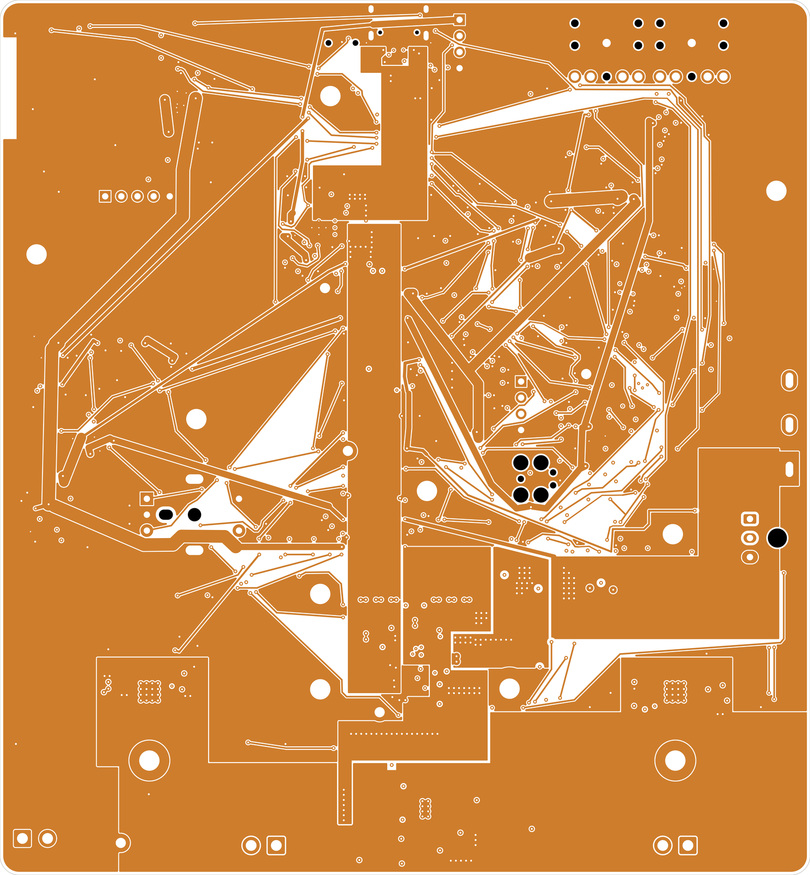
ai-files/pcb/route-r6i-in2.png
