chithigun23/DesktopSpeaker/ai-files/pcb/route-r6j-in2.png

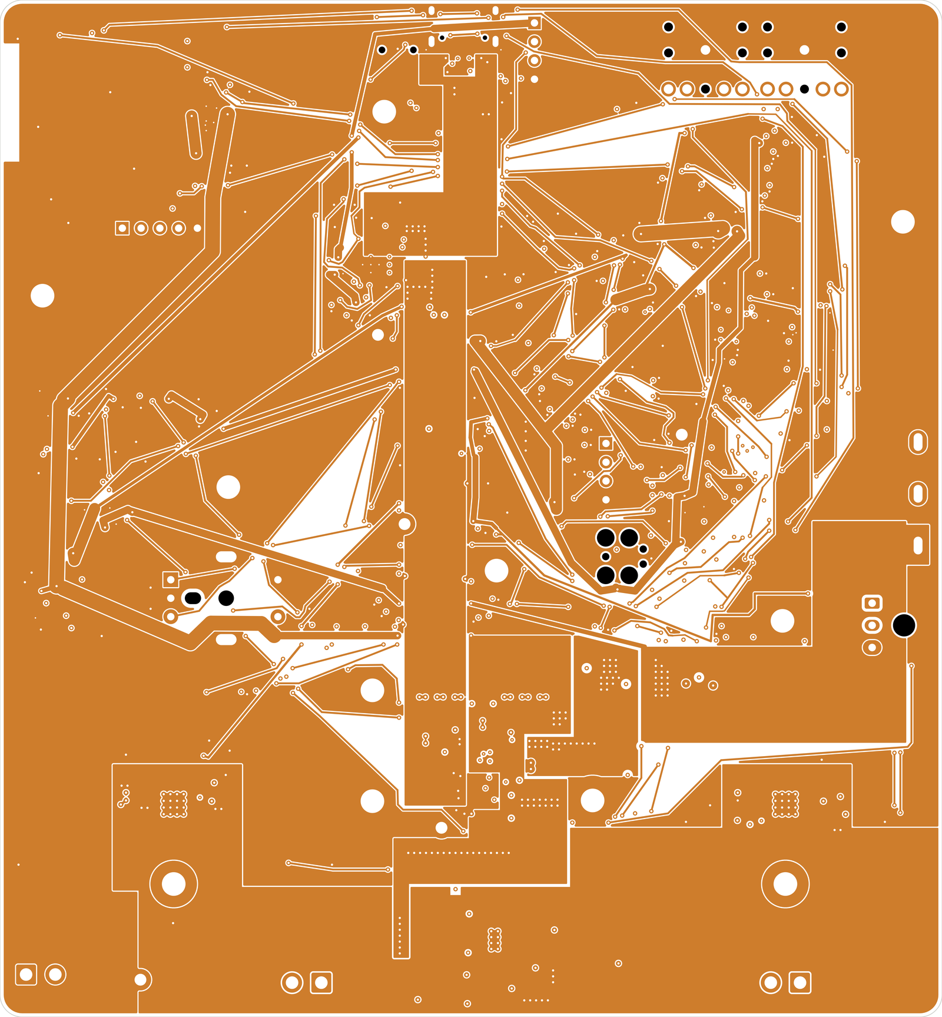
ai-files/pcb/route-r6j-in2.png
