chithigun23/DesktopSpeaker/ai-files/pcb/route-r6j-top.png

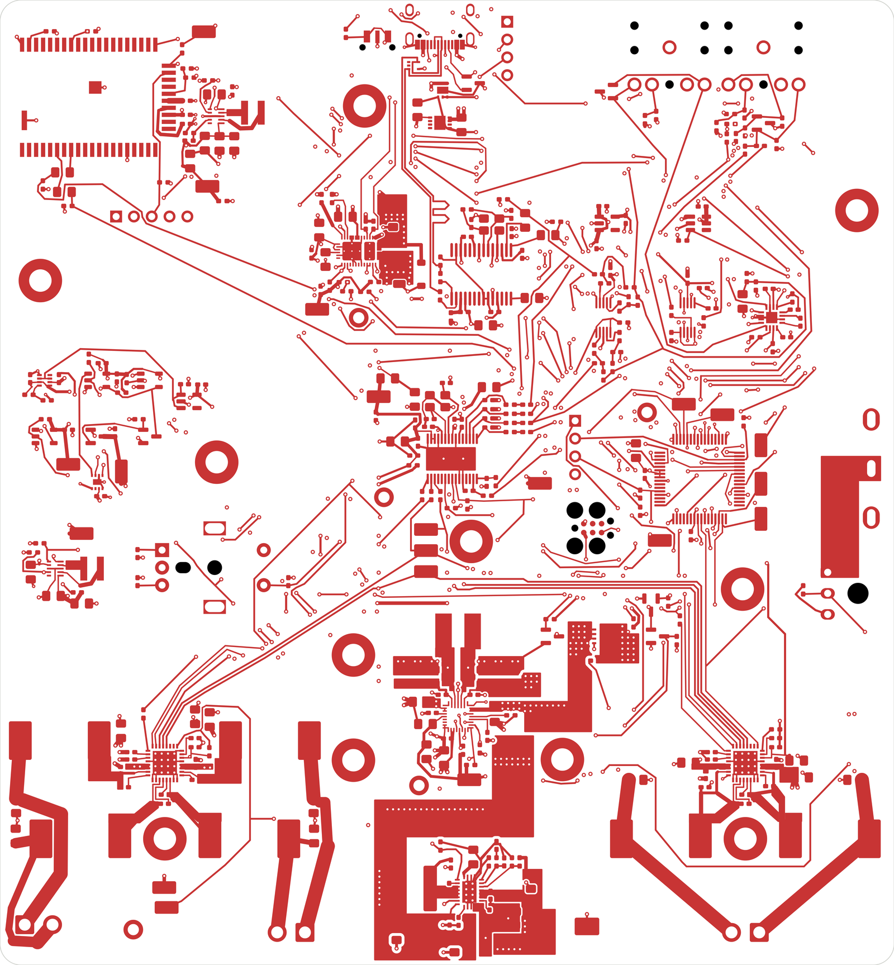
ai-files/pcb/route-r6j-top.png
