chithigun23/DesktopSpeaker/ai-files/pcb/route-r6k-bottom.png

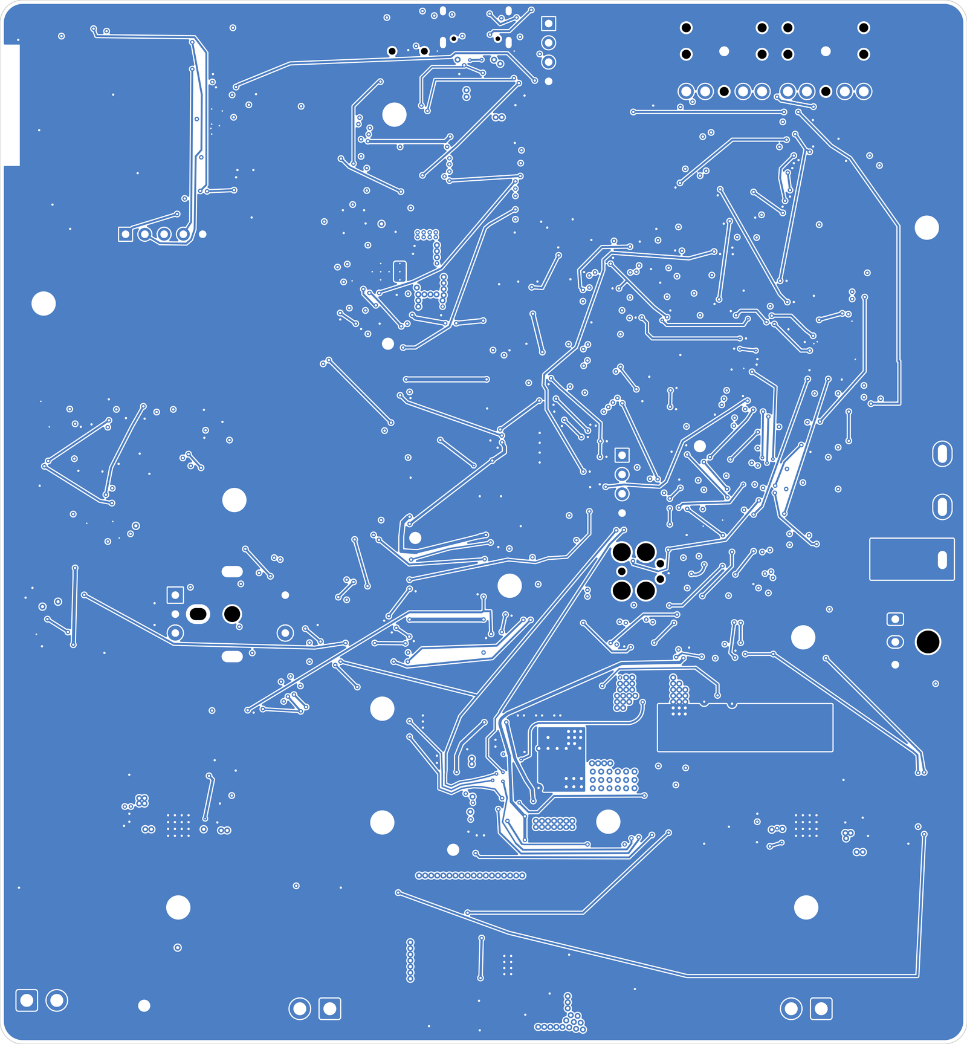
ai-files/pcb/route-r6k-bottom.png
