chithigun23/DesktopSpeaker/ai-files/pcb/route-r6l-in2.png

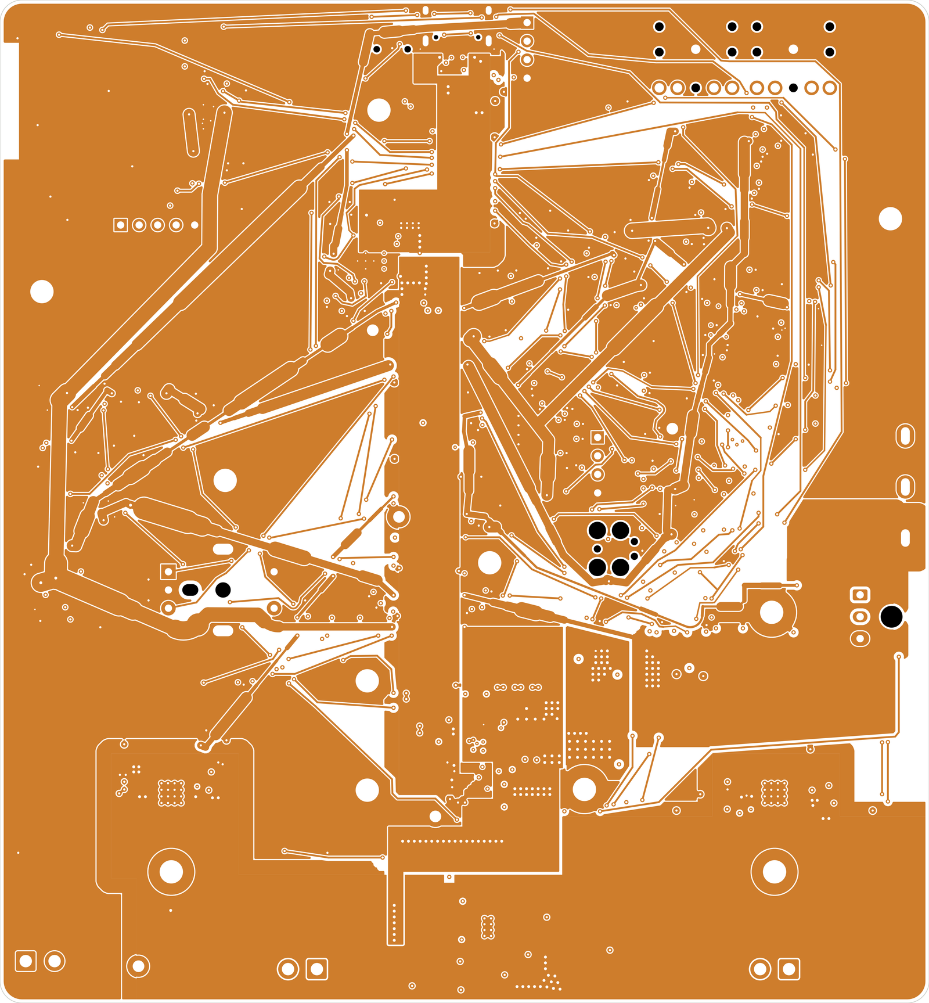
ai-files/pcb/route-r6l-in2.png
