chithigun23/DesktopSpeaker/ai-files/pcb/route-r6n-top.png

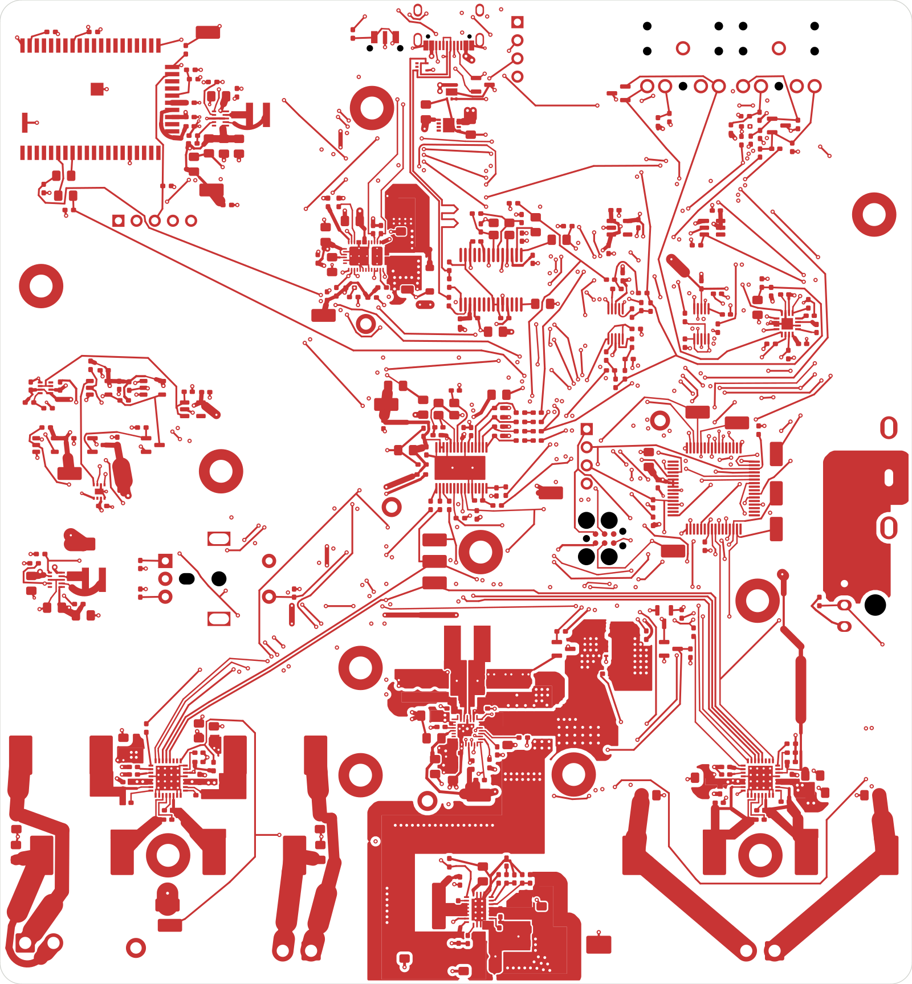
ai-files/pcb/route-r6n-top.png
