chithigun23/DesktopSpeaker/ai-files/pcb/route-r6p-bottom.png

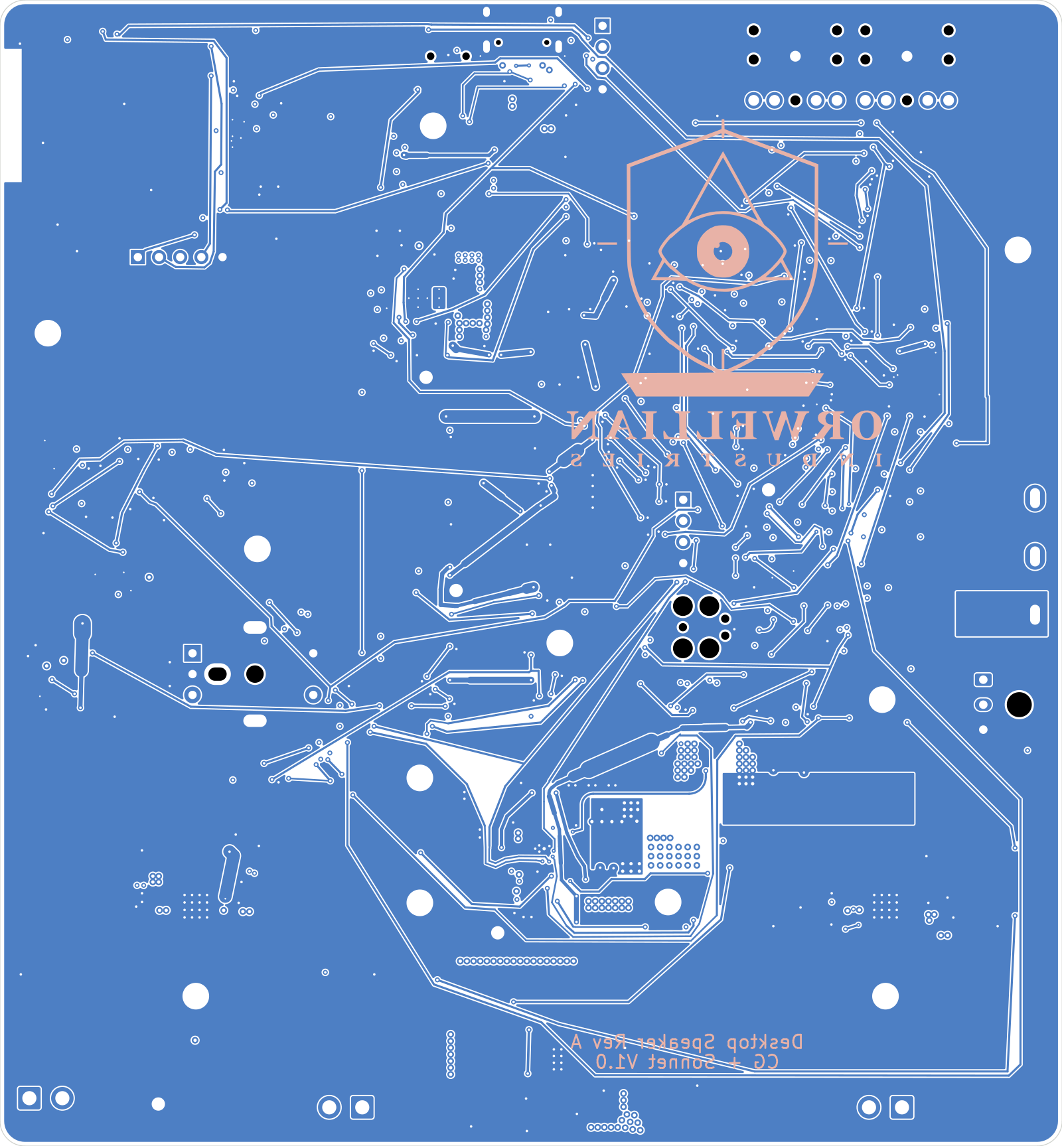
ai-files/pcb/route-r6p-bottom.png
