chithigun23/DesktopSpeaker/ai-files/pcb/work-route3/evidence/rt2-silk-mask.png

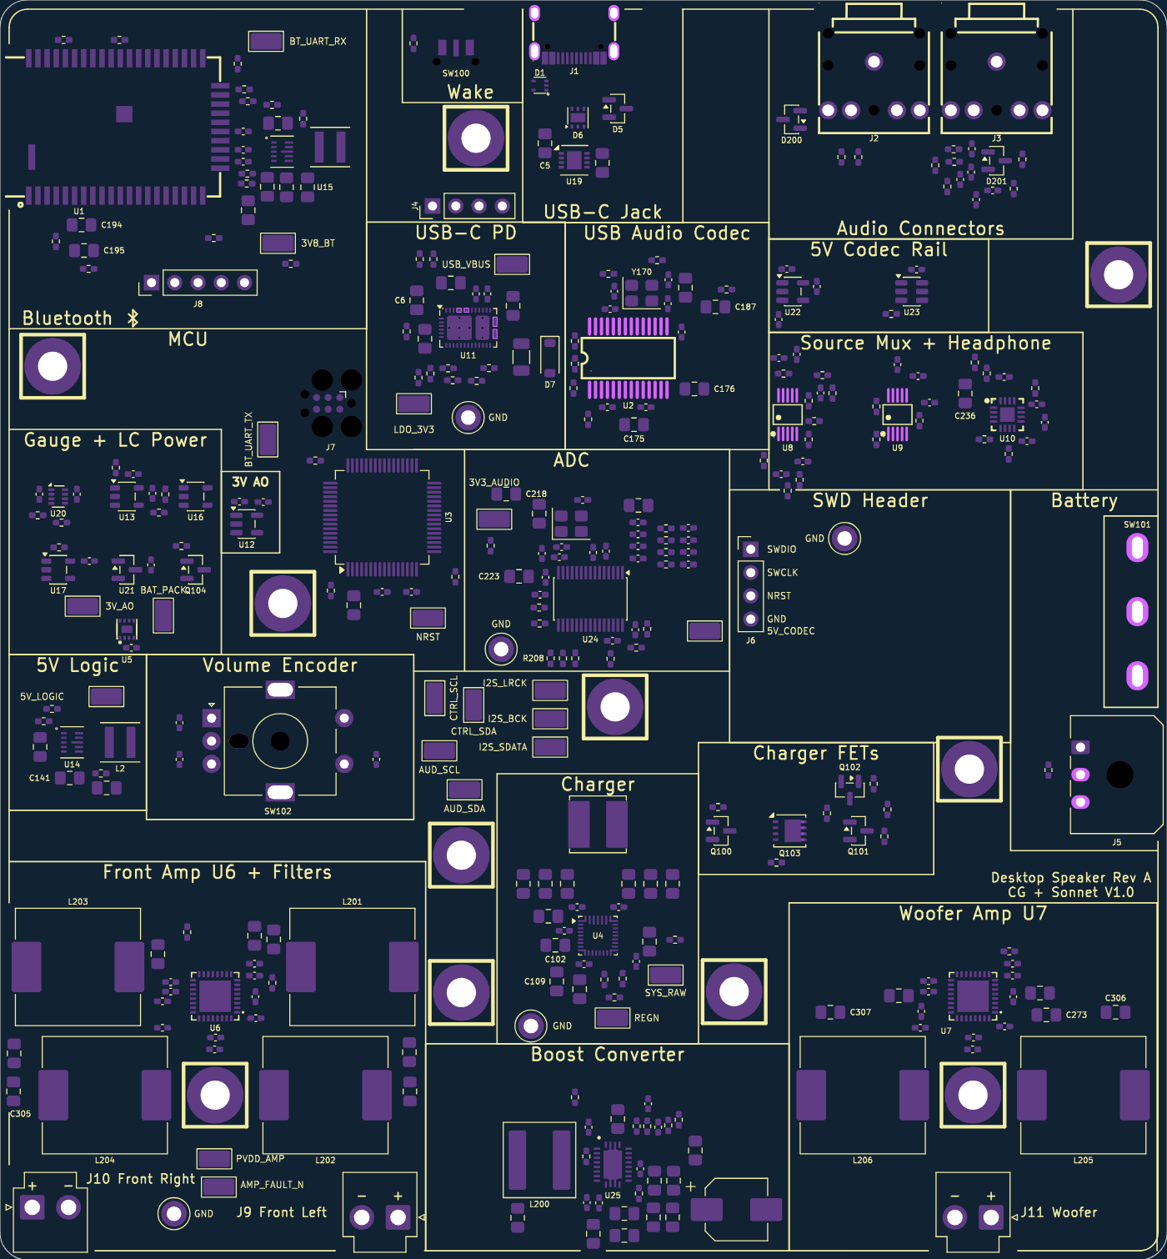
ai-files/pcb/work-route3/evidence/rt2-silk-mask.png
