chithigun23/DesktopSpeaker/ai-files/pcb/work-route4/evidence/u4-before.png

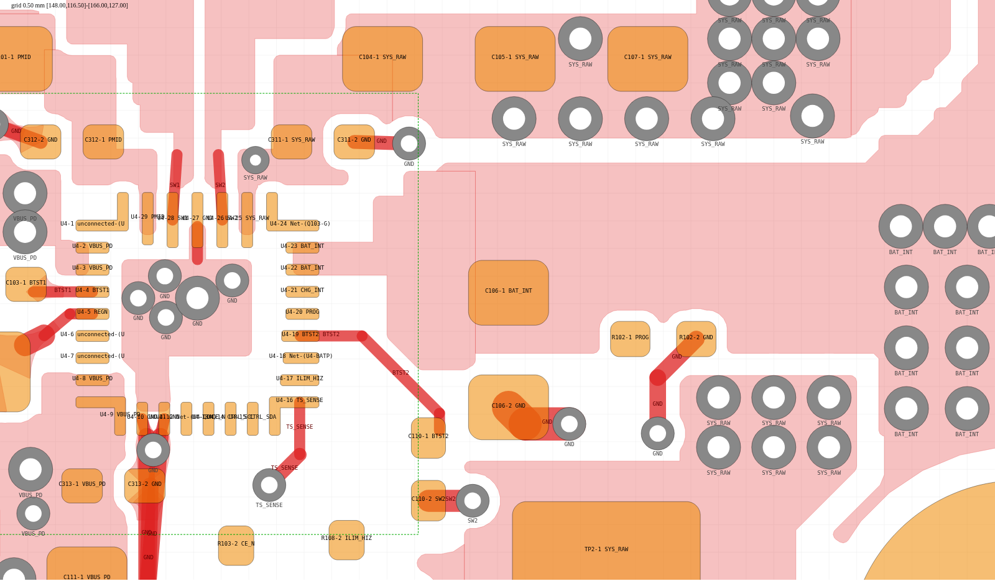
ai-files/pcb/work-route4/evidence/u4-before.png
