chithigun23/DesktopSpeaker/ai-files/pcb/work-route6/evidence/rt6-B.png

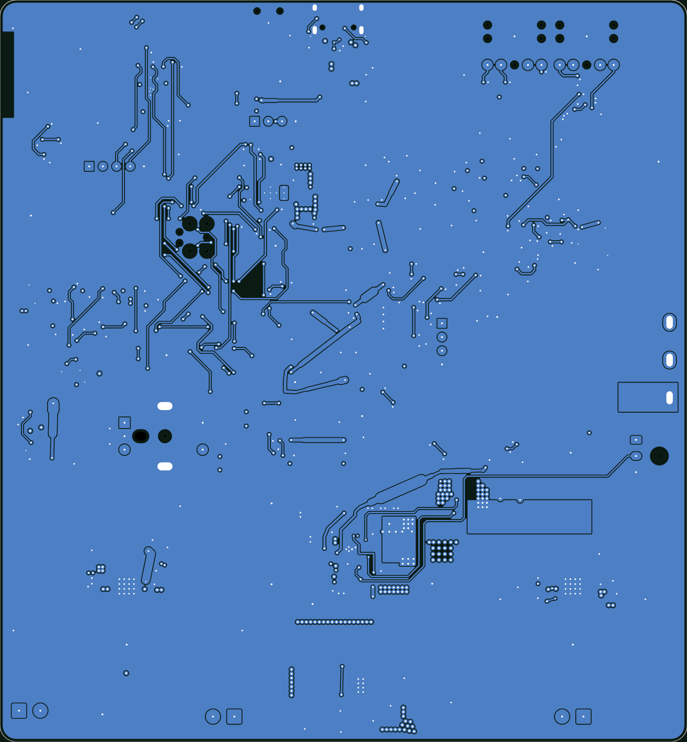
ai-files/pcb/work-route6/evidence/rt6-B.png
