chithigun23/DesktopSpeaker/ai-files/pcb/work-route6/evidence/u4-east-B.png

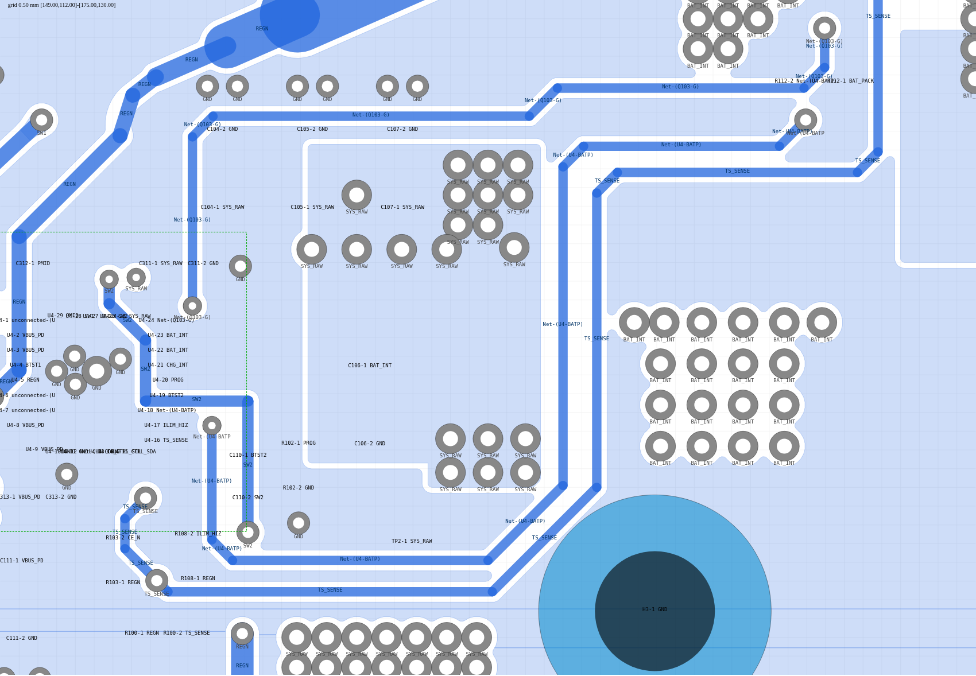
ai-files/pcb/work-route6/evidence/u4-east-B.png
