chithigun23/DesktopSpeaker/ai-files/pcb/work-route6/evidence/u4-fanout-F.png

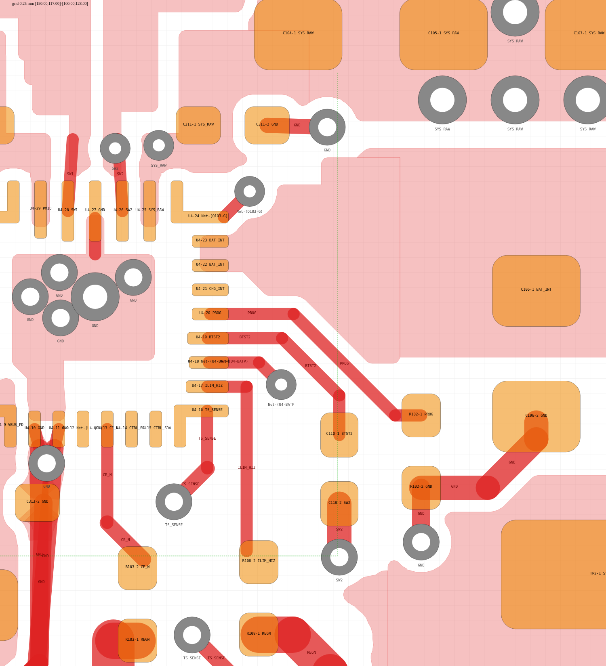
ai-files/pcb/work-route6/evidence/u4-fanout-F.png
