chithigun23/DesktopSpeaker/ai-files/pcb/work-route7/evidence/u4s.png

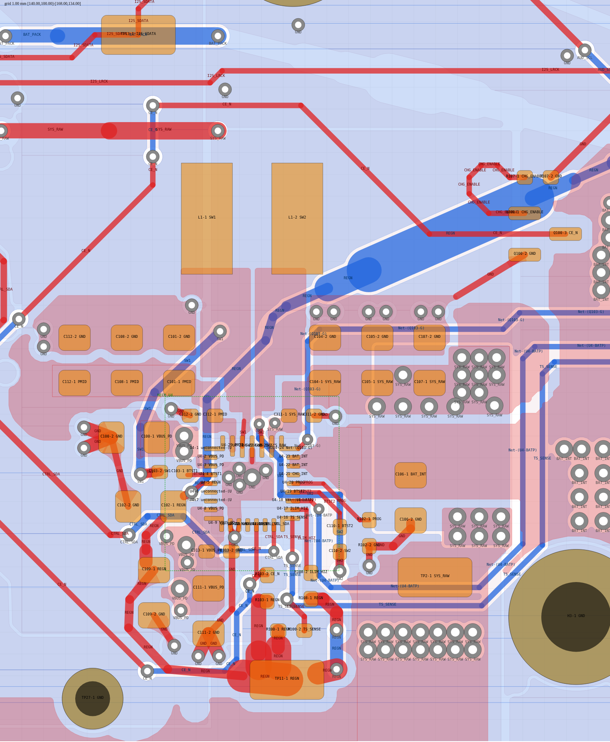
ai-files/pcb/work-route7/evidence/u4s.png
