chithigun23/DesktopSpeaker/ai-files/pcb/work-route7/evidence/u6fan.png

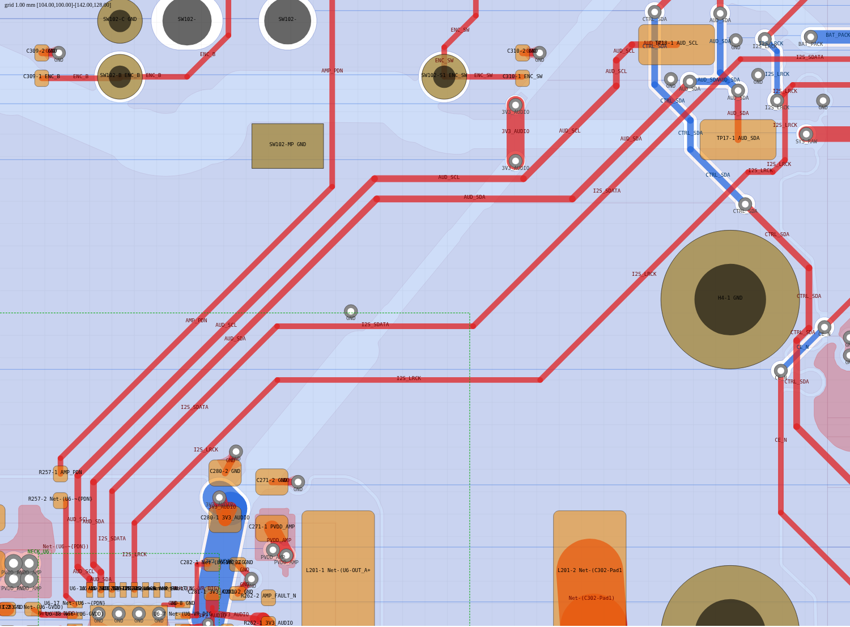
ai-files/pcb/work-route7/evidence/u6fan.png
