chithigun23/DesktopSpeaker/ai-files/pcb/work-route7/evidence/u24.png

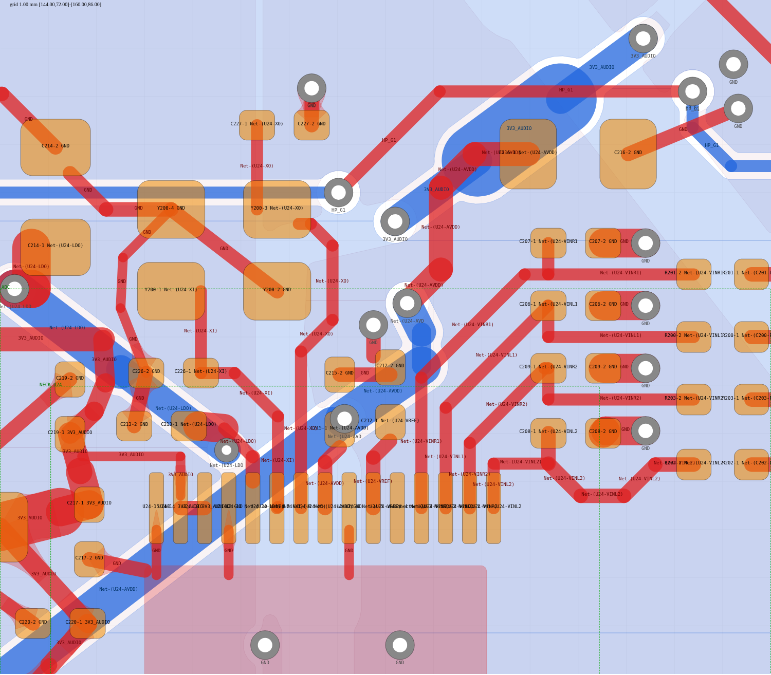
ai-files/pcb/work-route7/evidence/u24.png
