chithigun23/DesktopSpeaker/ai-files/pcb/work-route7/evidence/u25.png

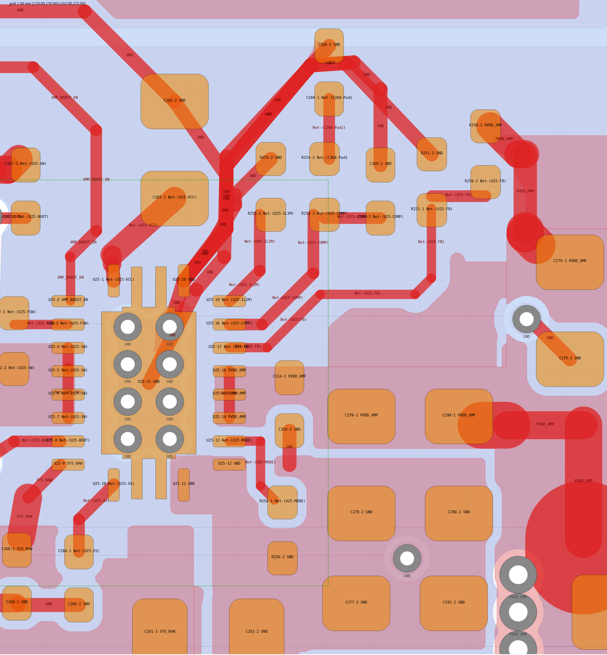
ai-files/pcb/work-route7/evidence/u25.png
