chithigun23/DesktopSpeaker/ai-files/pcb/work-route8/evidence/q101.png

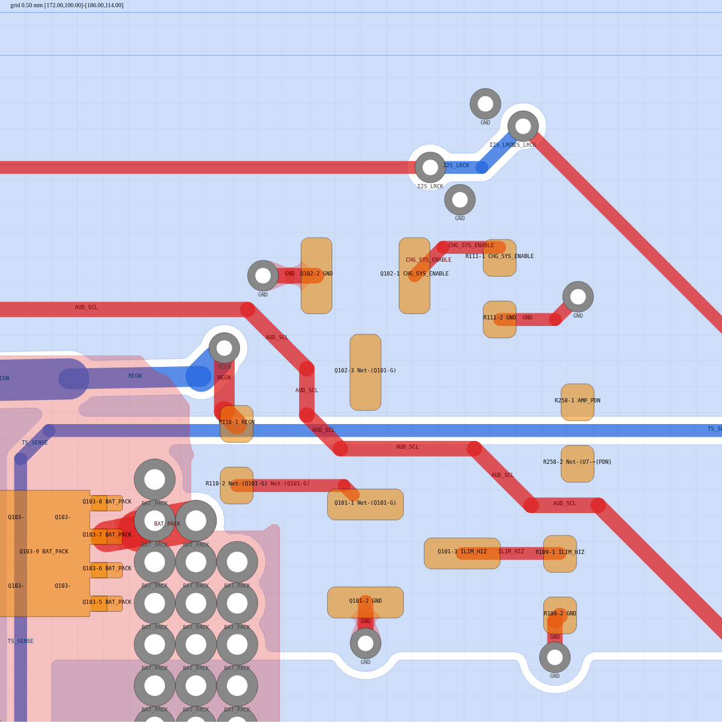
ai-files/pcb/work-route8/evidence/q101.png
