chithigun23/DesktopSpeaker/ai-files/pcb/work-route8/evidence/u3-B-In2.png

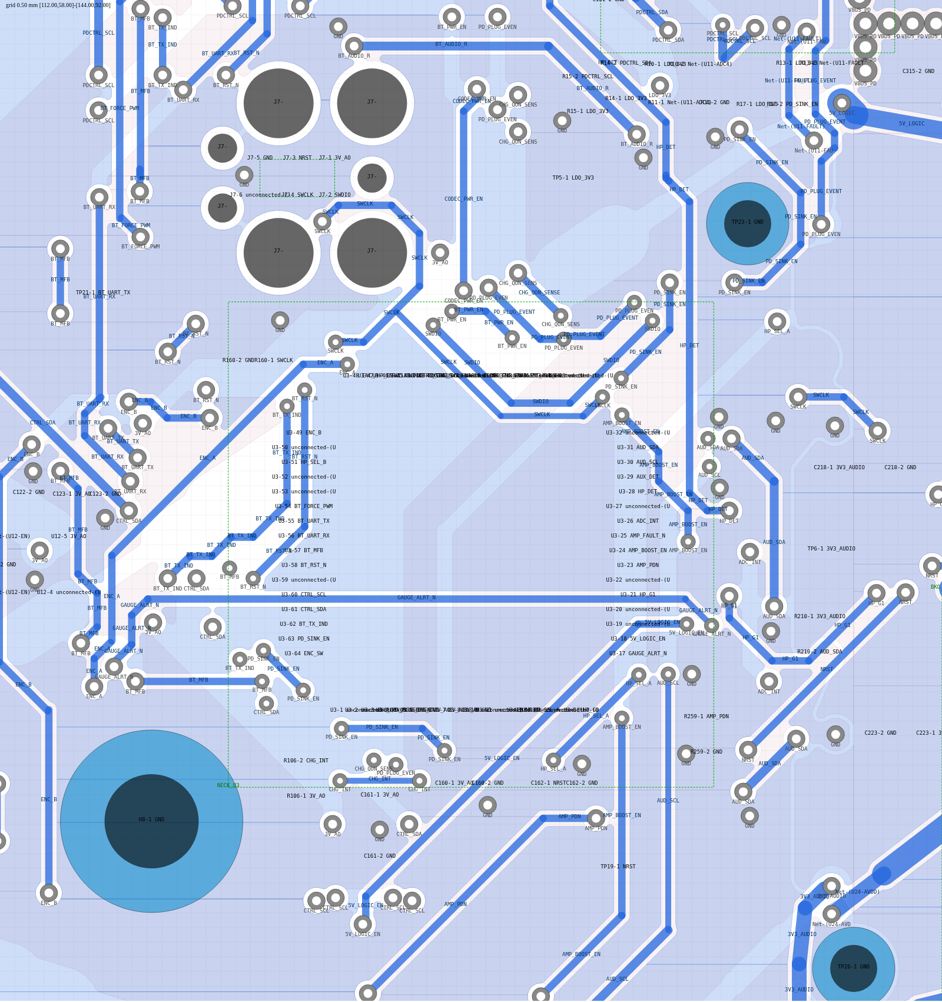
ai-files/pcb/work-route8/evidence/u3-B-In2.png
