chithigun23/DesktopSpeaker/ai-files/pcb/work-route8/evidence/u3-F.png

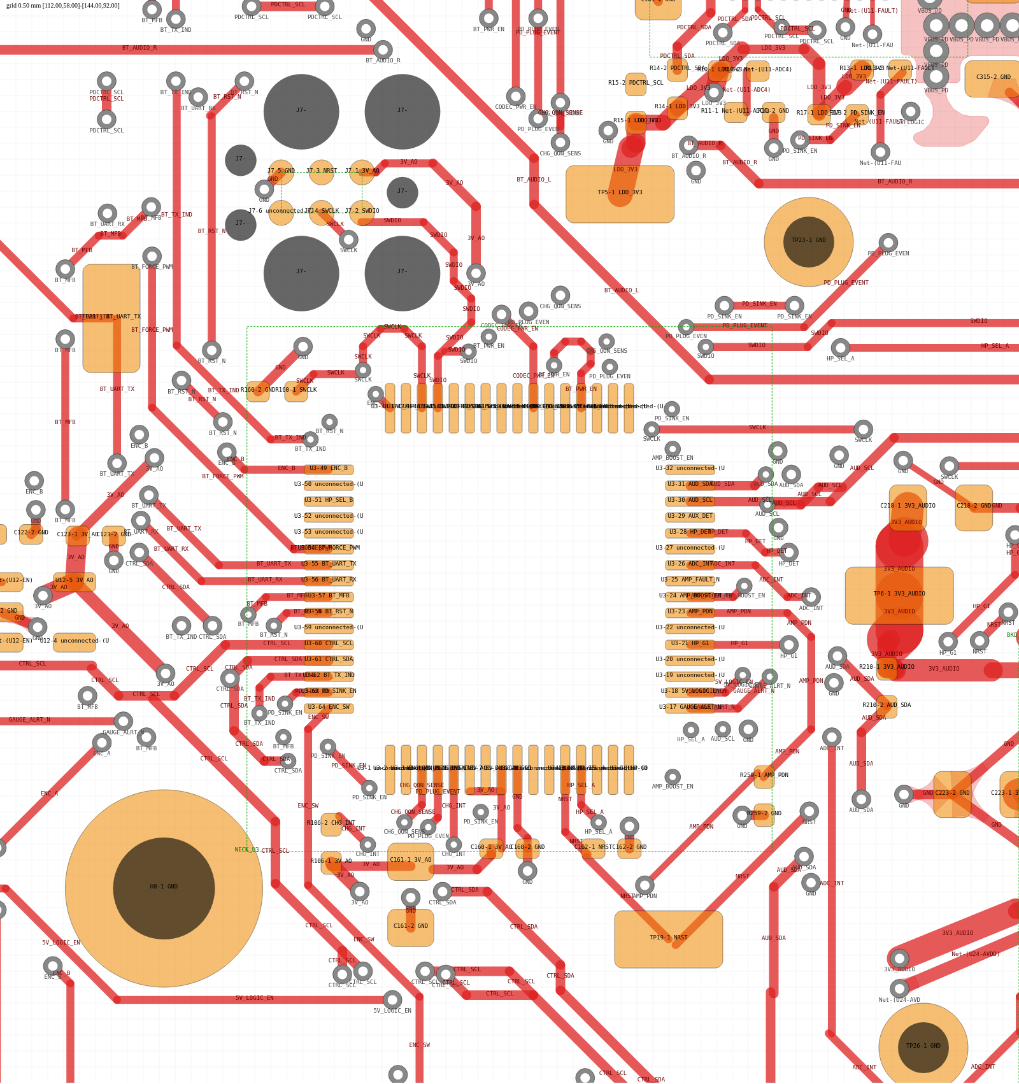
ai-files/pcb/work-route8/evidence/u3-F.png
