chithigun23/DesktopSpeaker/ai-files/pcb/work-route9/evidence/rt9-syscfg.png

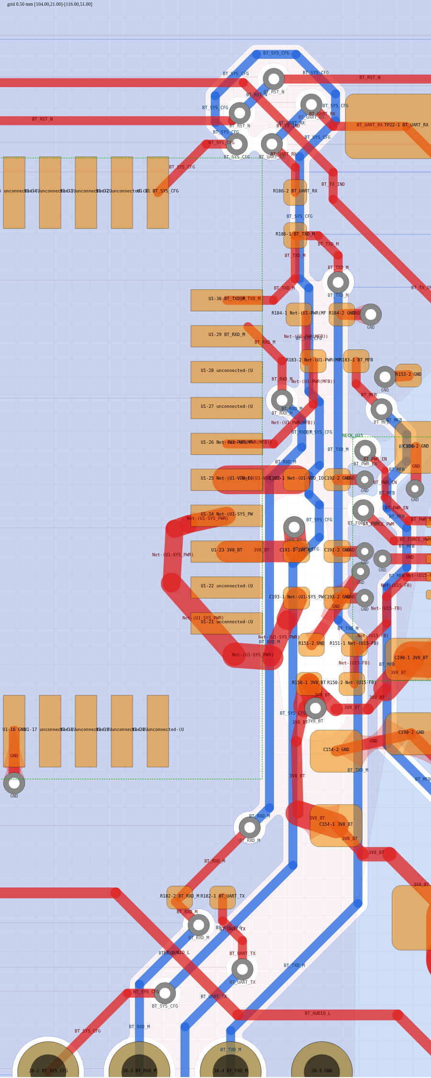
ai-files/pcb/work-route9/evidence/rt9-syscfg.png
