chithigun23/DesktopSpeaker/ai-files/pcb/work-route9p/evidence/rt9p-sda33.png

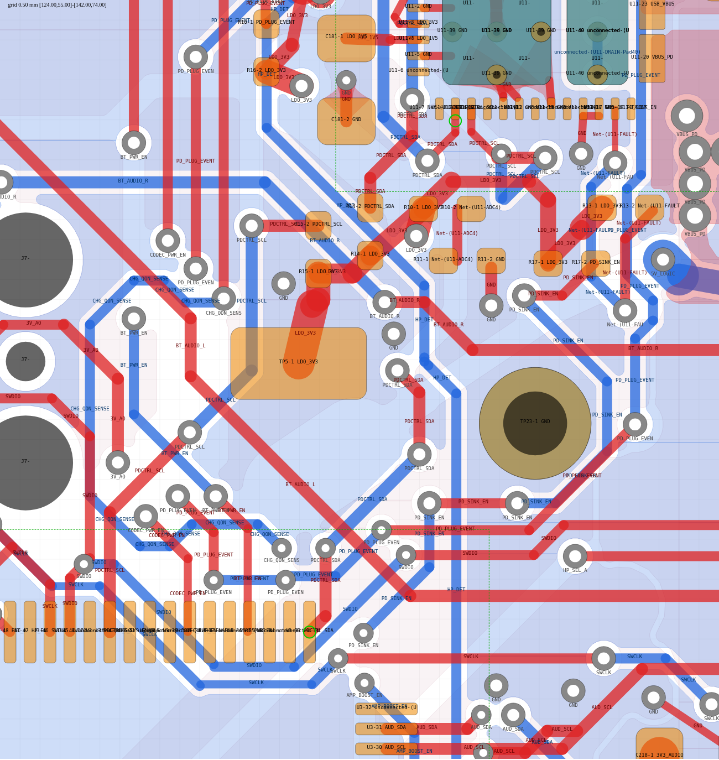
ai-files/pcb/work-route9p/evidence/rt9p-sda33.png
