chithigun23/DesktopSpeaker/ai-files/pcb/work-route10/evidence/cause-q102-r258.png

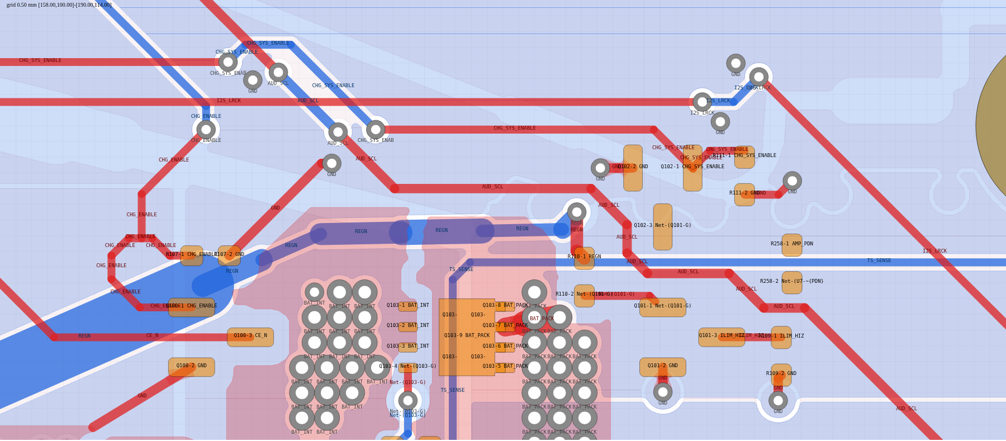
ai-files/pcb/work-route10/evidence/cause-q102-r258.png
