chithigun23/DesktopSpeaker/ai-files/pcb/work-route10/evidence/cause-r262.png

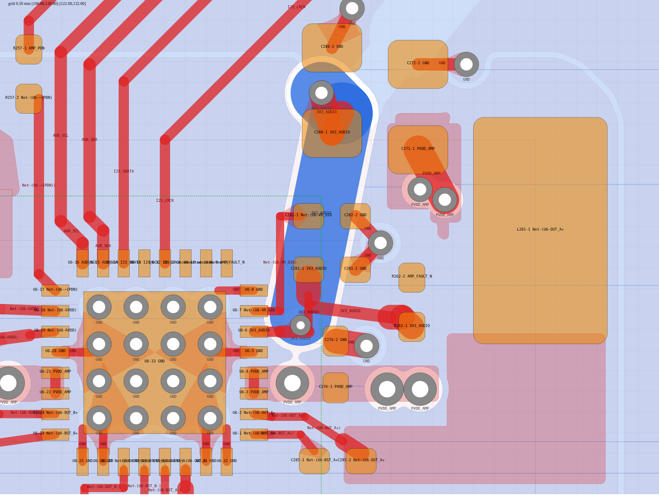
ai-files/pcb/work-route10/evidence/cause-r262.png
