chithigun23/DesktopSpeaker/ai-files/pcb/work-route10/evidence/cause-u4.png

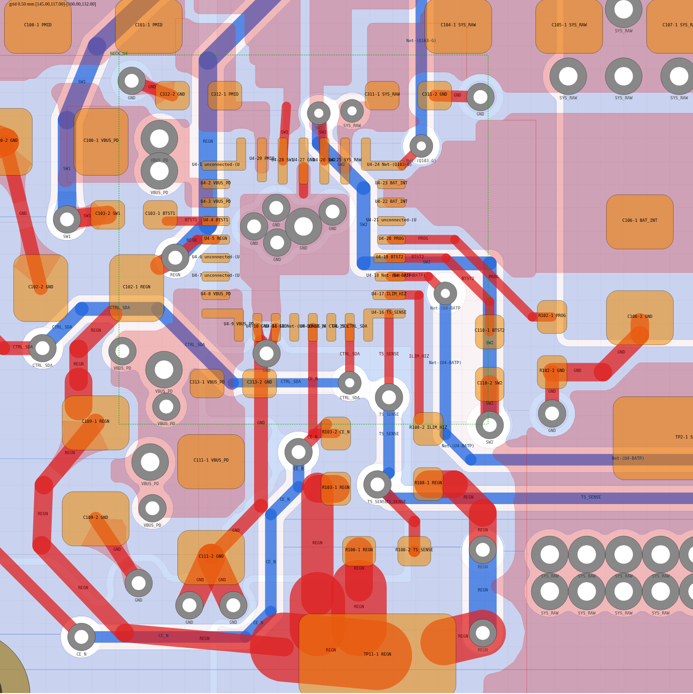
ai-files/pcb/work-route10/evidence/cause-u4.png
