chithigun23/DesktopSpeaker/ai-files/pcb/work-route10/evidence/cause-u14.png

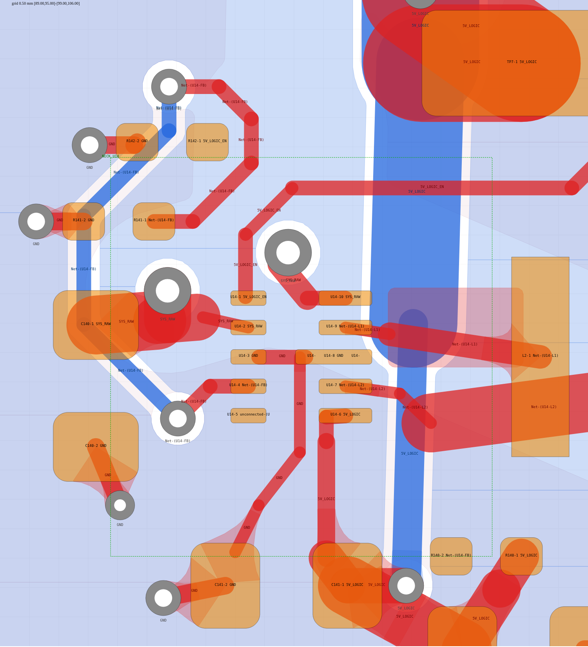
ai-files/pcb/work-route10/evidence/cause-u14.png
