chithigun23/DesktopSpeaker/ai-files/pcb/work-route10/evidence/rt10-chg-east.png

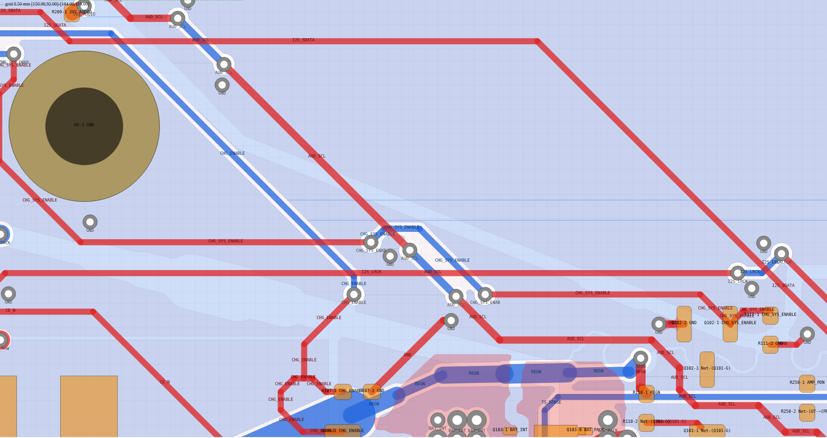
ai-files/pcb/work-route10/evidence/rt10-chg-east.png
