chithigun23/DesktopSpeaker/ai-files/pcb/work-route10/evidence/rt10-In2.png

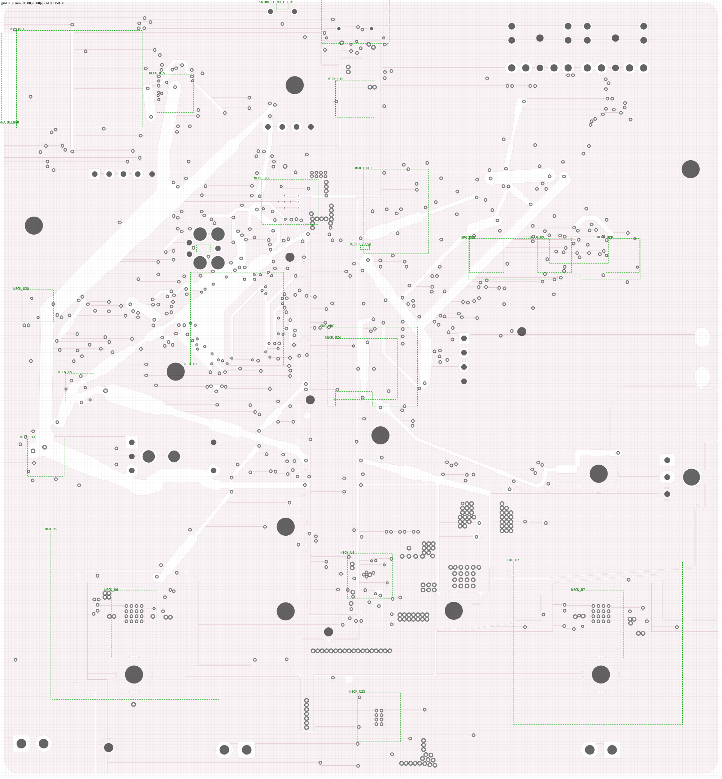
ai-files/pcb/work-route10/evidence/rt10-In2.png
