chithigun23/DesktopSpeaker/ai-files/pcb/work-route11/evidence/a10-block.png

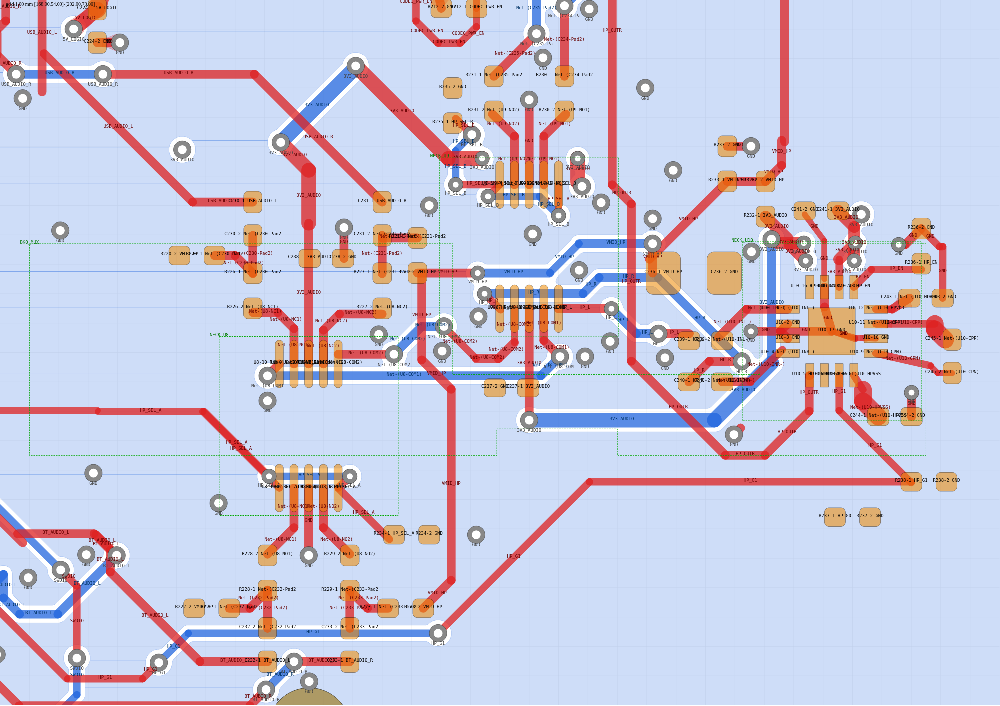
ai-files/pcb/work-route11/evidence/a10-block.png
