chithigun23/DesktopSpeaker/ai-files/pcb/work-route11/evidence/f14-mid.png

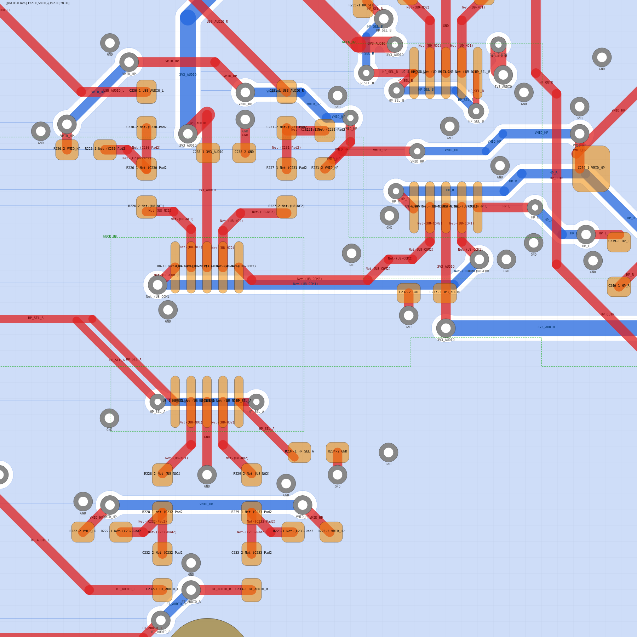
ai-files/pcb/work-route11/evidence/f14-mid.png
