chithigun23/DesktopSpeaker/ai-files/pcb/work-route11/evidence/i2c-u9.png

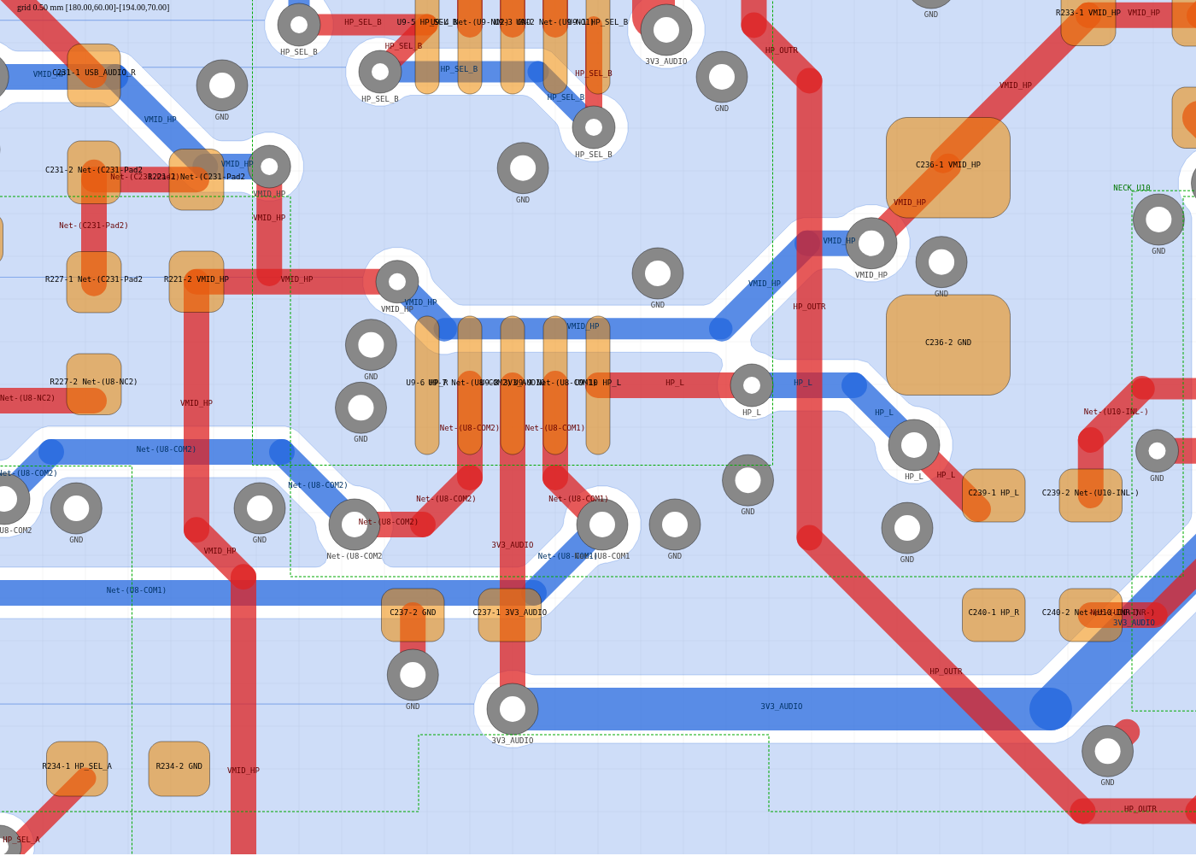
ai-files/pcb/work-route11/evidence/i2c-u9.png
