chithigun23/DesktopSpeaker/ai-files/pcb/work-route11/evidence/p3-block.png

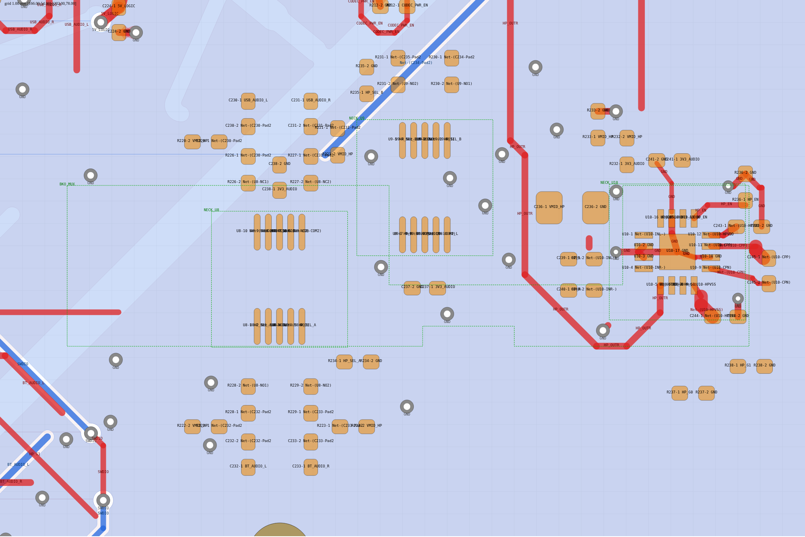
ai-files/pcb/work-route11/evidence/p3-block.png
