chithigun23/DesktopSpeaker/ai-files/pcb/work-route11/evidence/r17-jack.png

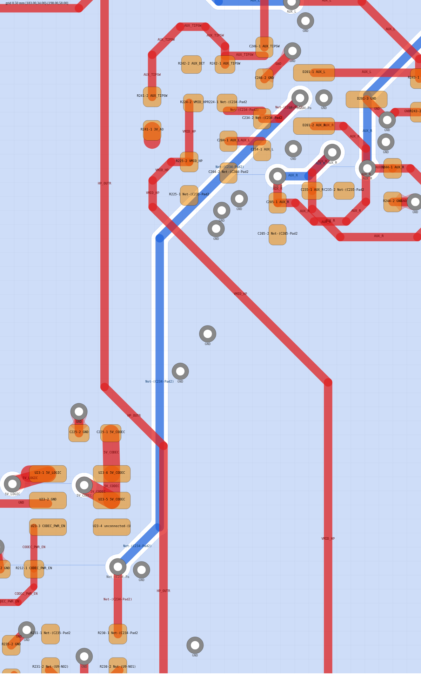
ai-files/pcb/work-route11/evidence/r17-jack.png
