chithigun23/DesktopSpeaker/ai-files/pcb/work-route11/evidence/rt10-hub.png

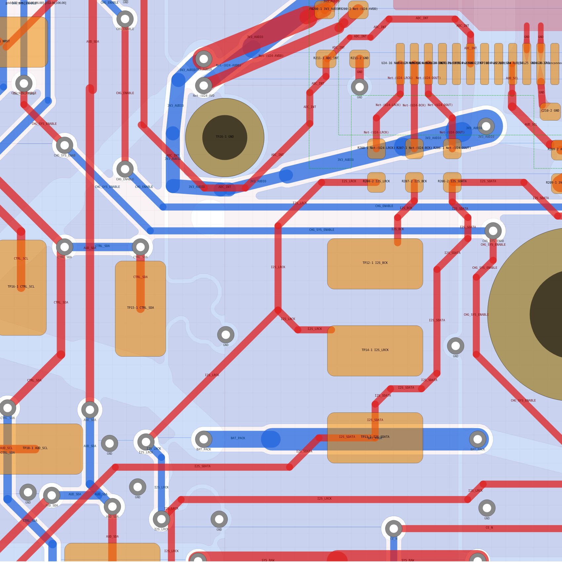
ai-files/pcb/work-route11/evidence/rt10-hub.png
