chithigun23/DesktopSpeaker/ai-files/pcb/work-route11/evidence/rt10-mux-B.png

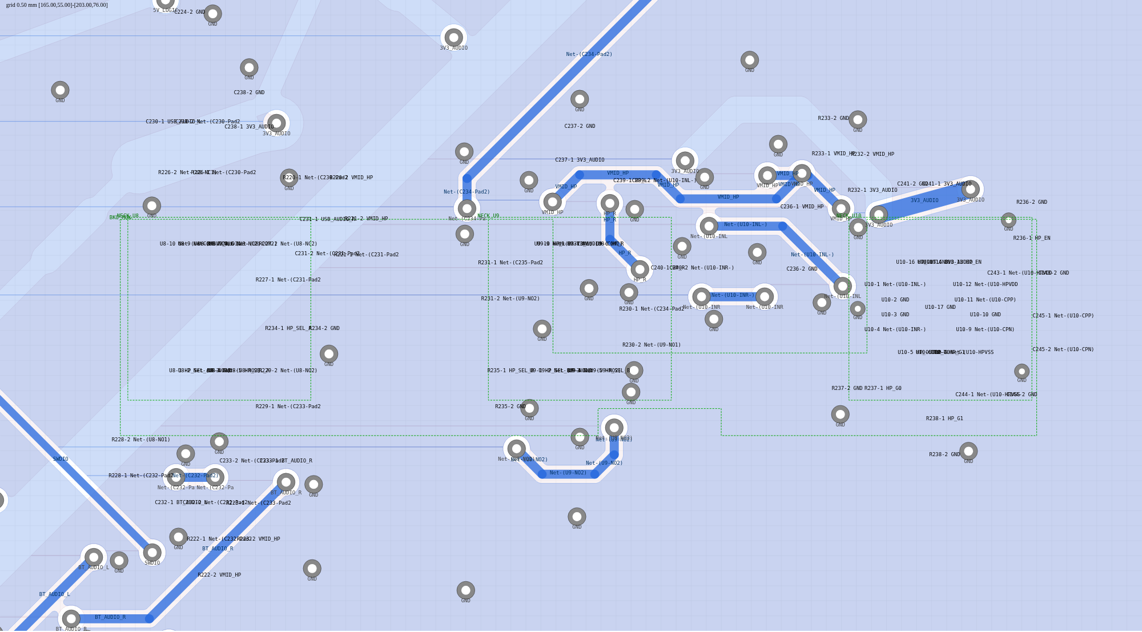
ai-files/pcb/work-route11/evidence/rt10-mux-B.png
