chithigun23/DesktopSpeaker/ai-files/pcb/work-route11/evidence/rt10-u8.png

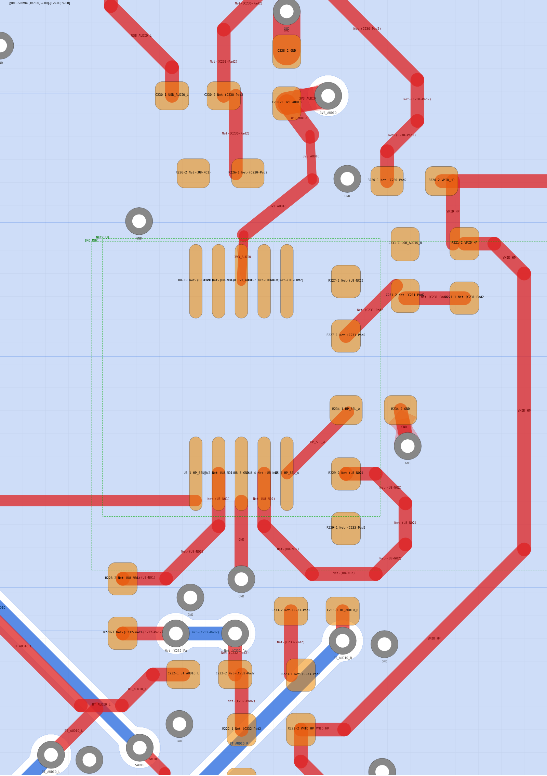
ai-files/pcb/work-route11/evidence/rt10-u8.png
