chithigun23/DesktopSpeaker/ai-files/pcb/work-route11/evidence/rt10-u9u10.png

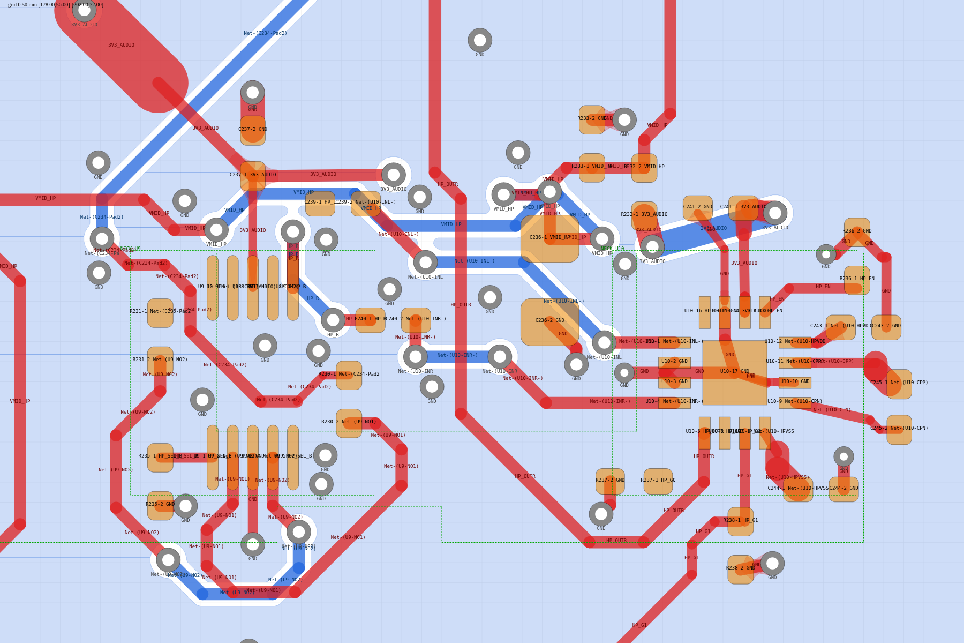
ai-files/pcb/work-route11/evidence/rt10-u9u10.png
