chithigun23/DesktopSpeaker/ai-files/pcb/work-route11/evidence/rt11-B.png

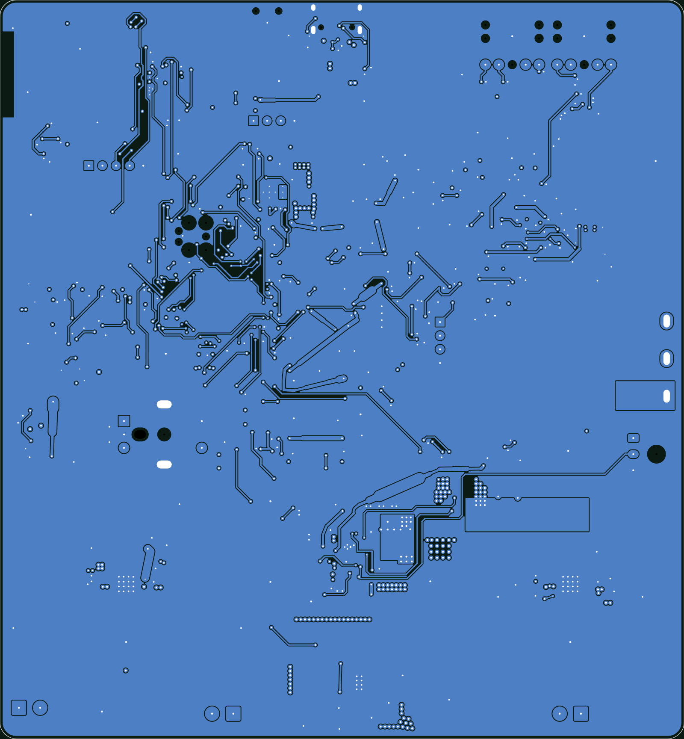
ai-files/pcb/work-route11/evidence/rt11-B.png
