chithigun23/DesktopSpeaker/ai-files/pcb/work-route11/evidence/rt11-block-In2.png

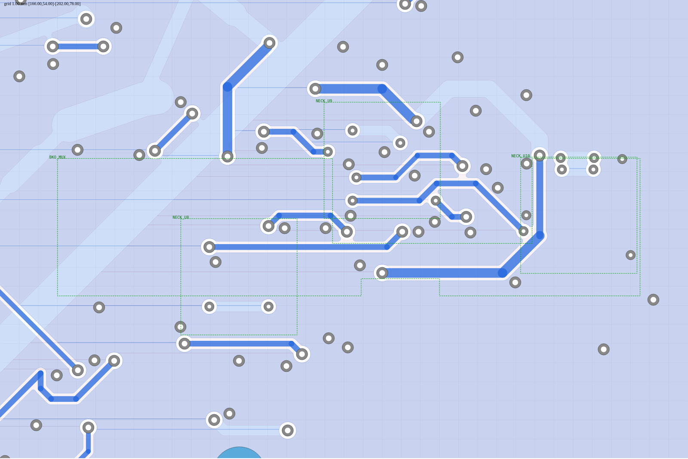
ai-files/pcb/work-route11/evidence/rt11-block-In2.png
