chithigun23/DesktopSpeaker/ai-files/pcb/work-route11/evidence/rt11-F.png

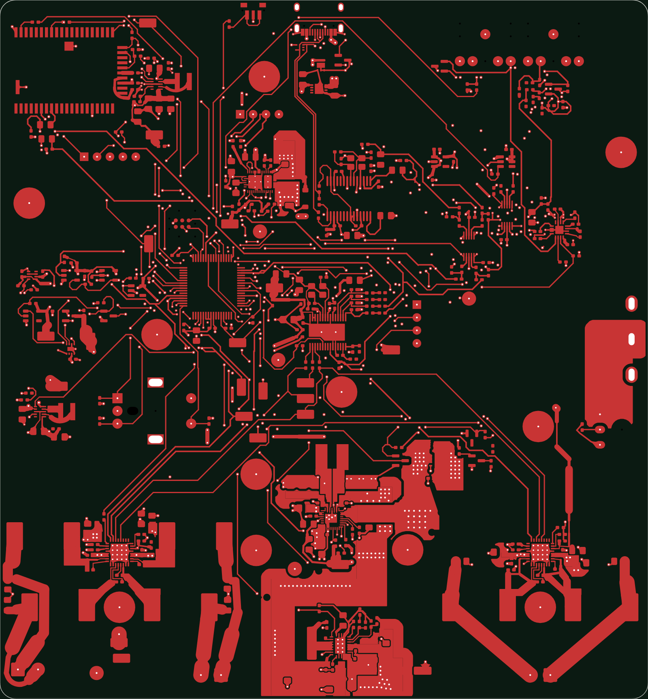
ai-files/pcb/work-route11/evidence/rt11-F.png
