chithigun23/DesktopSpeaker/ai-files/pcb/work-route12/evidence/rt11-r262.png

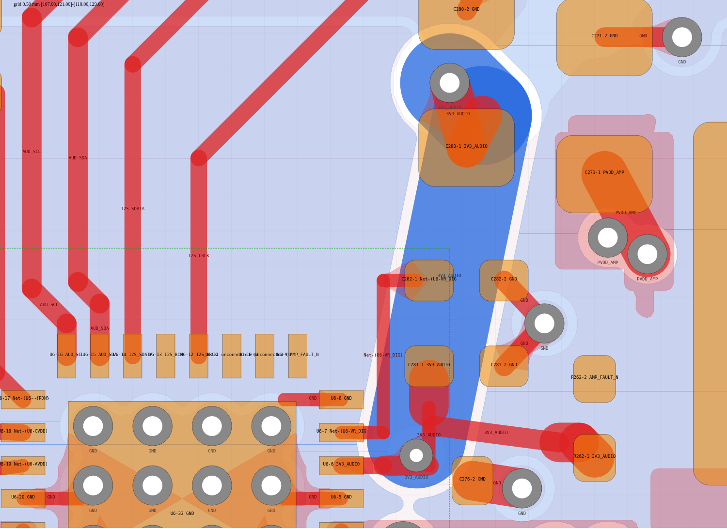
ai-files/pcb/work-route12/evidence/rt11-r262.png
