chithigun23/DesktopSpeaker/ai-files/pcb/work-route12/evidence/rt12-r258u7.png

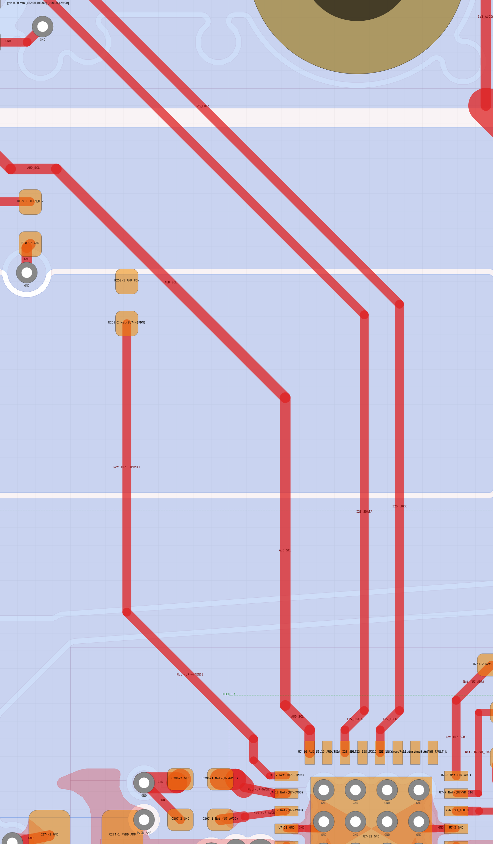
ai-files/pcb/work-route12/evidence/rt12-r258u7.png
