chithigun23/DesktopSpeaker/ai-files/pcb/work-route12/evidence/rt12-u17.png

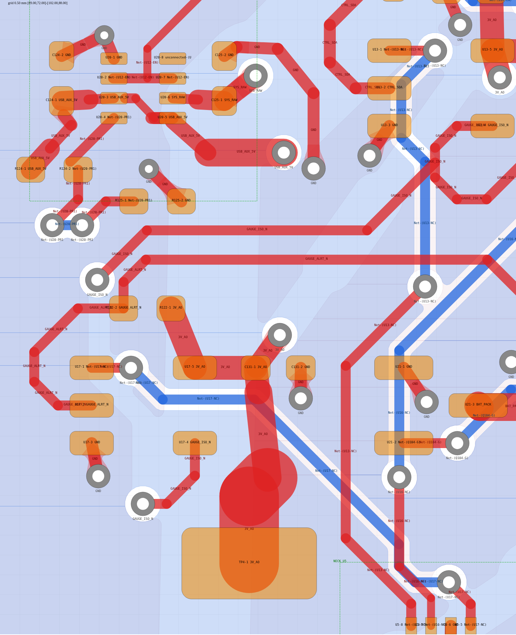
ai-files/pcb/work-route12/evidence/rt12-u17.png
