chithigun23/DesktopSpeaker/ai-files/pcb/work-route13/evidence/rt13-B.png

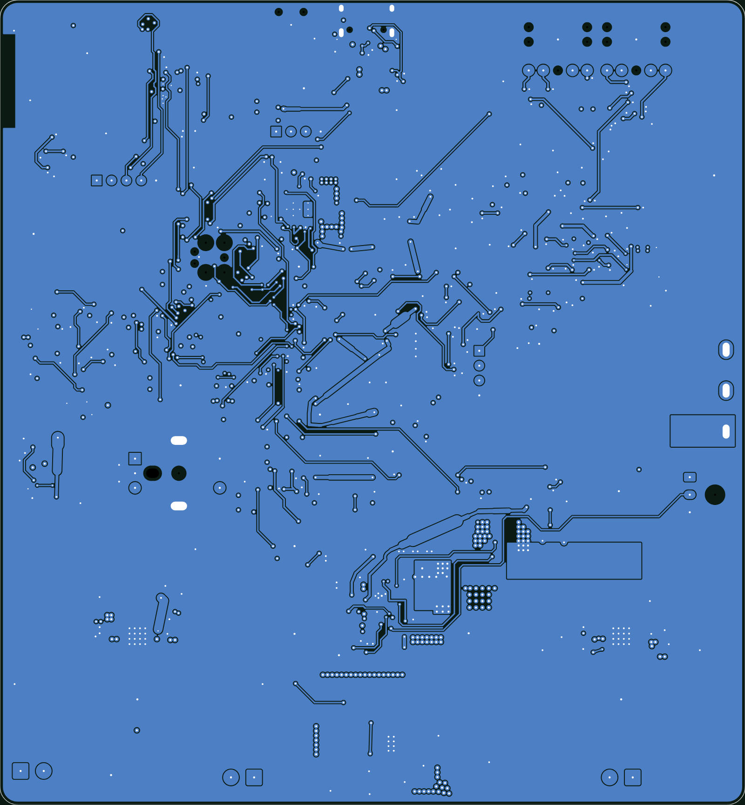
ai-files/pcb/work-route13/evidence/rt13-B.png
