chithigun23/DesktopSpeaker/ai-files/pcb/work-route13/evidence/rt13-u4.png

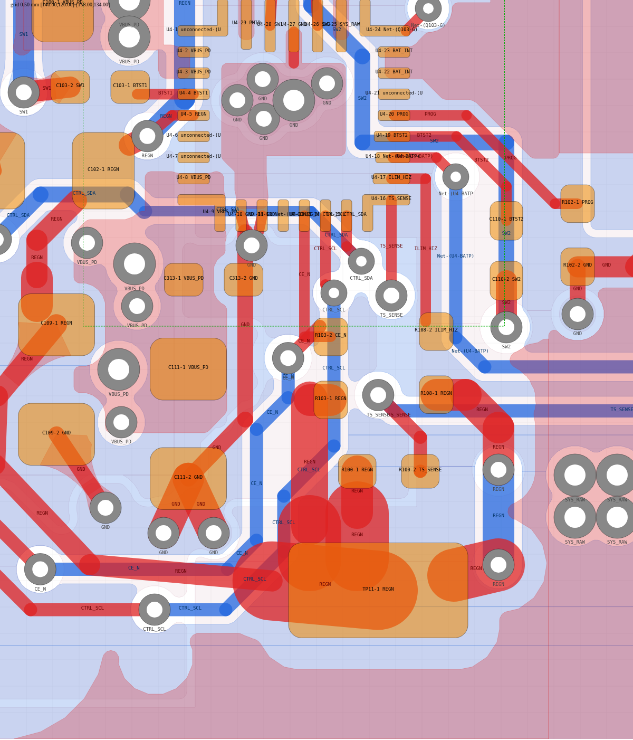
ai-files/pcb/work-route13/evidence/rt13-u4.png
