chithigun23/DesktopSpeaker/ai-files/pcb/work-route14/evidence/rt13p-u4qon.png

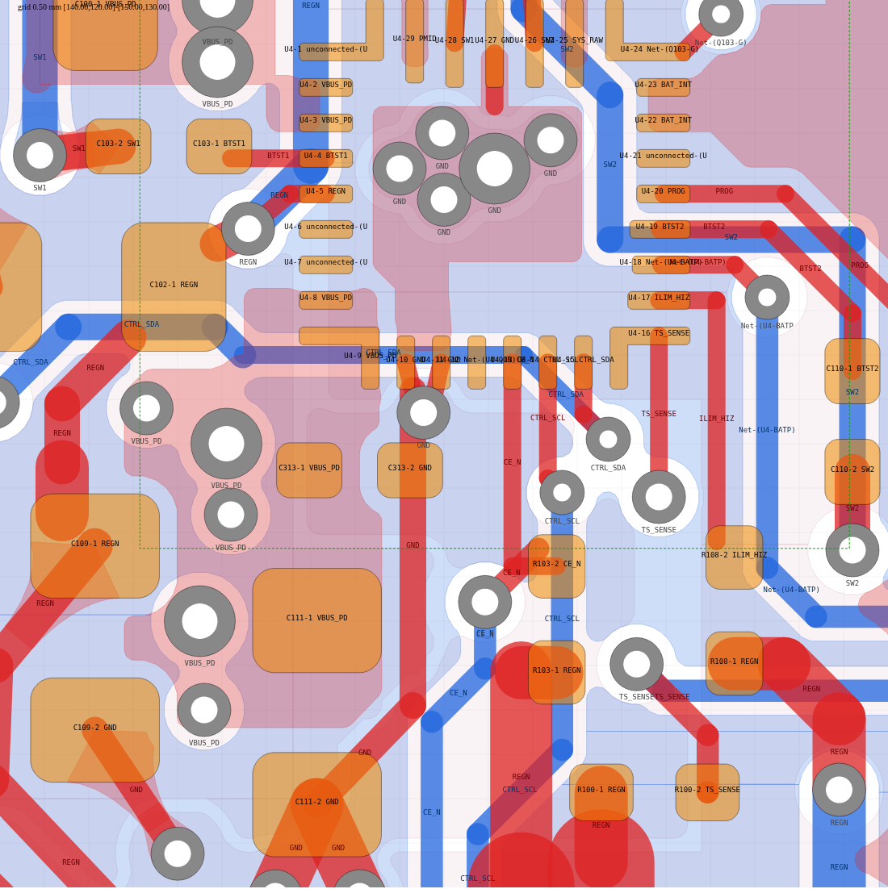
ai-files/pcb/work-route14/evidence/rt13p-u4qon.png
