chithigun23/DesktopSpeaker/ai-files/pcb/work-route14/evidence/rt14-qon.png

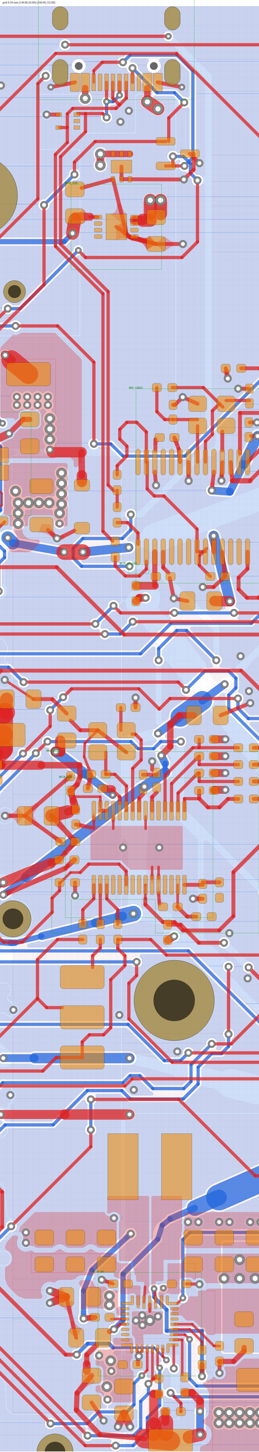
ai-files/pcb/work-route14/evidence/rt14-qon.png
