chithigun23/DesktopSpeaker/ai-files/pcb/work-route15/evidence/rt15-audscl.png

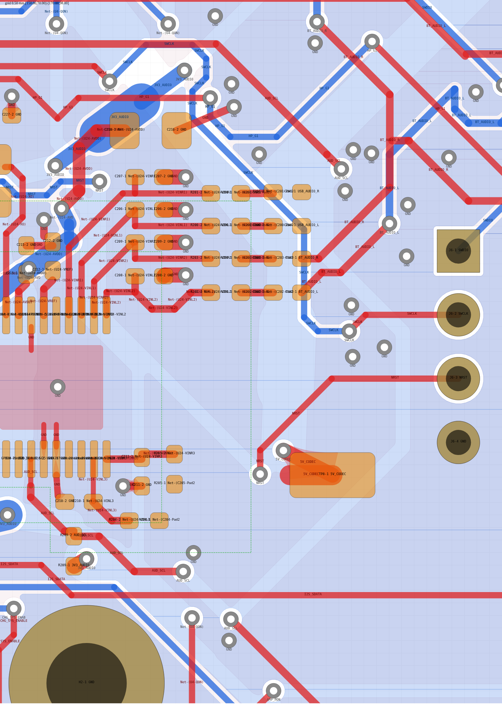
ai-files/pcb/work-route15/evidence/rt15-audscl.png
