chithigun23/DesktopSpeaker/ai-files/previews/adopt-r6m-MCU-p7.png

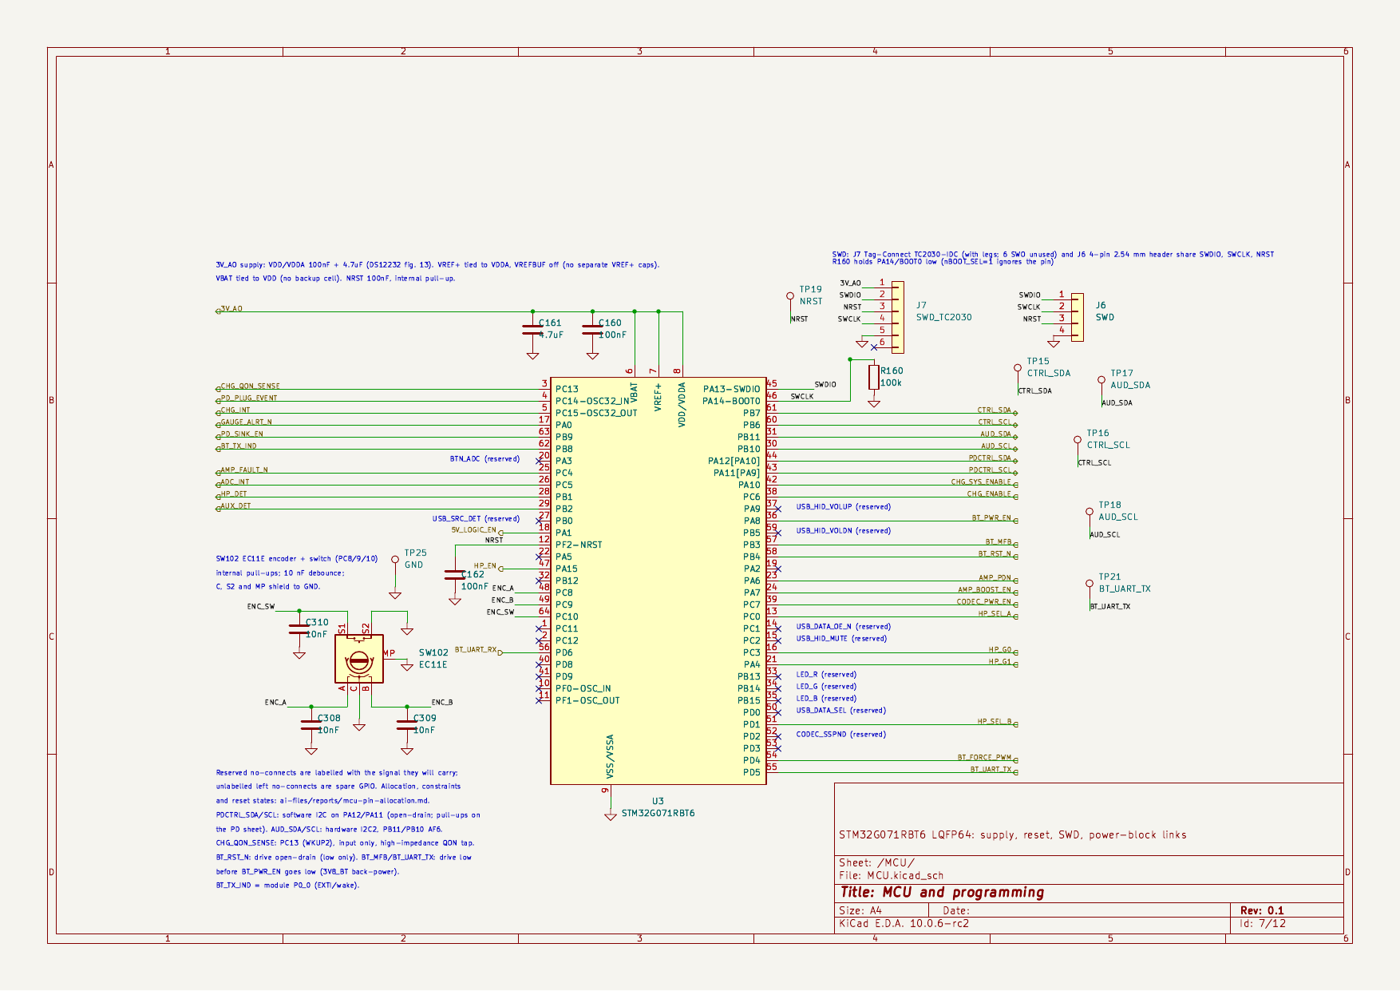
ai-files/previews/adopt-r6m-MCU-p7.png
