chithigun23/DesktopSpeaker/ai-files/previews/sync-c275-after-6.3x7.7-iso.png

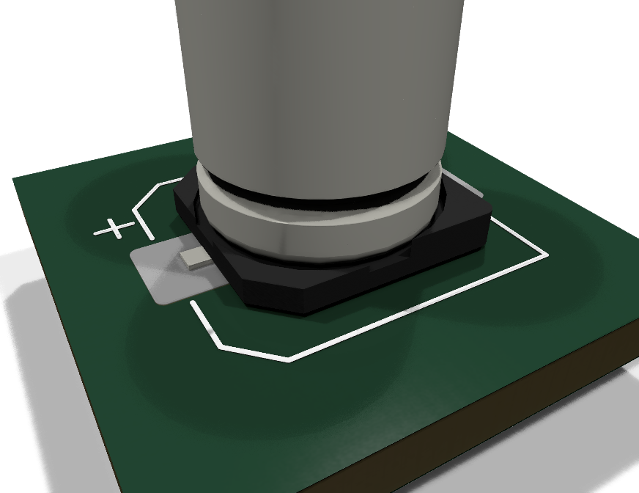
ai-files/previews/sync-c275-after-6.3x7.7-iso.png
