chithigun23/DesktopSpeaker/ai-files/previews/sync-c275-after-top.png

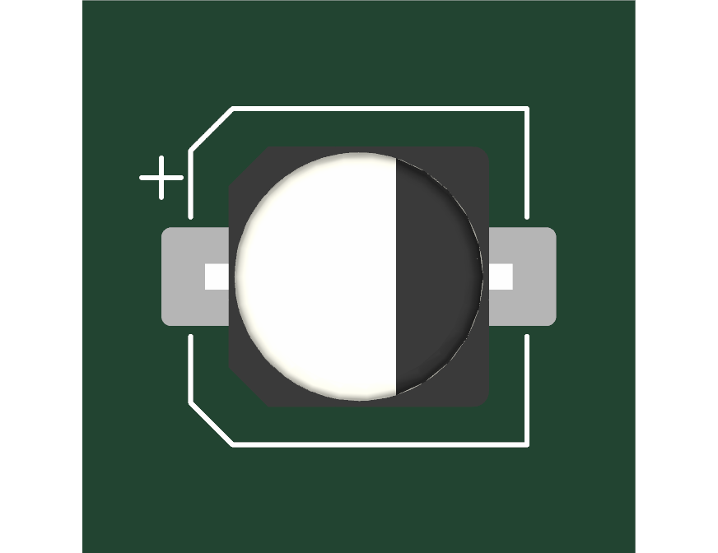
ai-files/previews/sync-c275-after-top.png
