chithigun23/DesktopSpeaker/ai-files/previews/sync-y200-schematic-crop.png

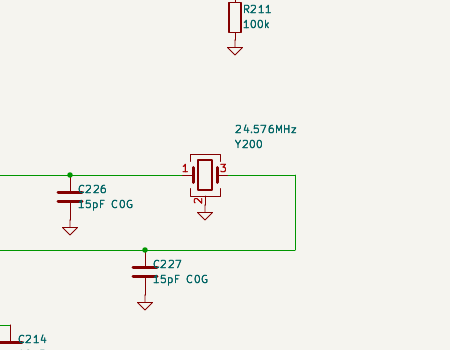
ai-files/previews/sync-y200-schematic-crop.png
