chithigun23/DesktopSpeaker/ai-files/reports/amp/amp-1.png

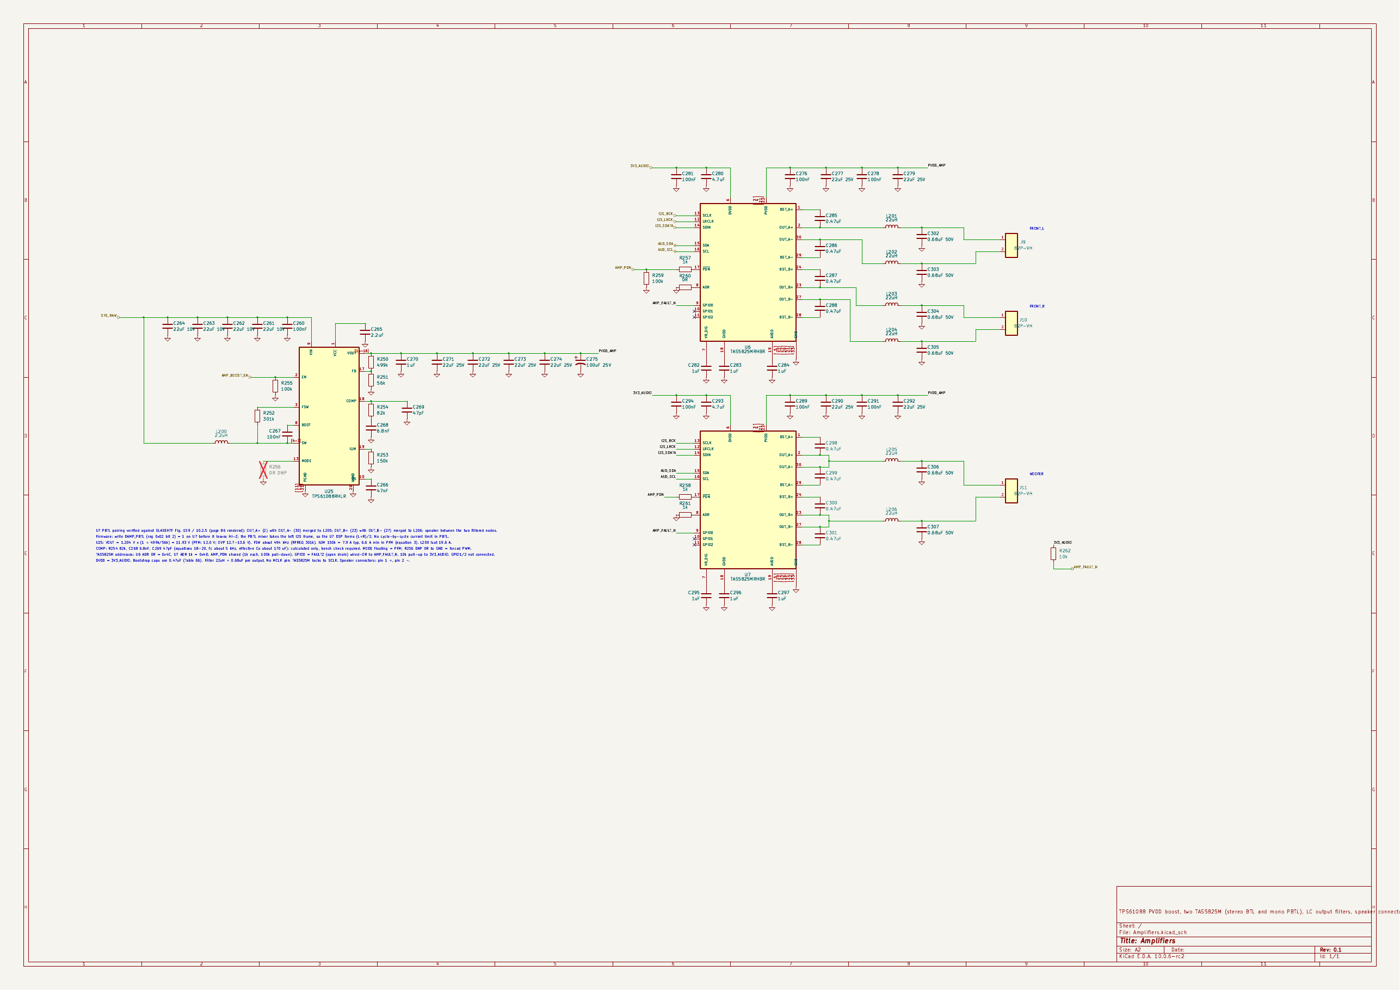
ai-files/reports/amp/amp-1.png
