chithigun23/DesktopSpeaker/ai-files/reports/amp/crop1-1.png

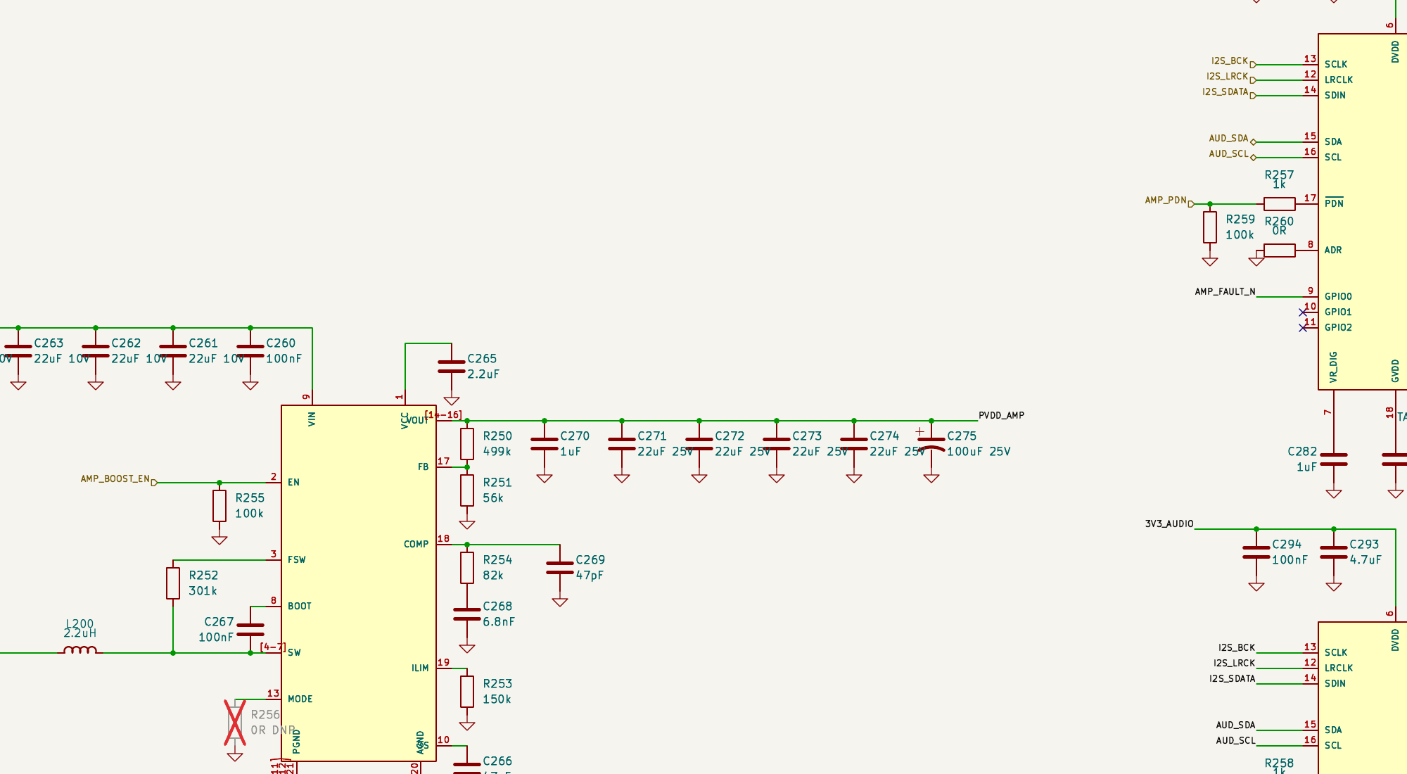
ai-files/reports/amp/crop1-1.png
