chithigun23/DesktopSpeaker/ai-files/reports/amp/crop2-1.png

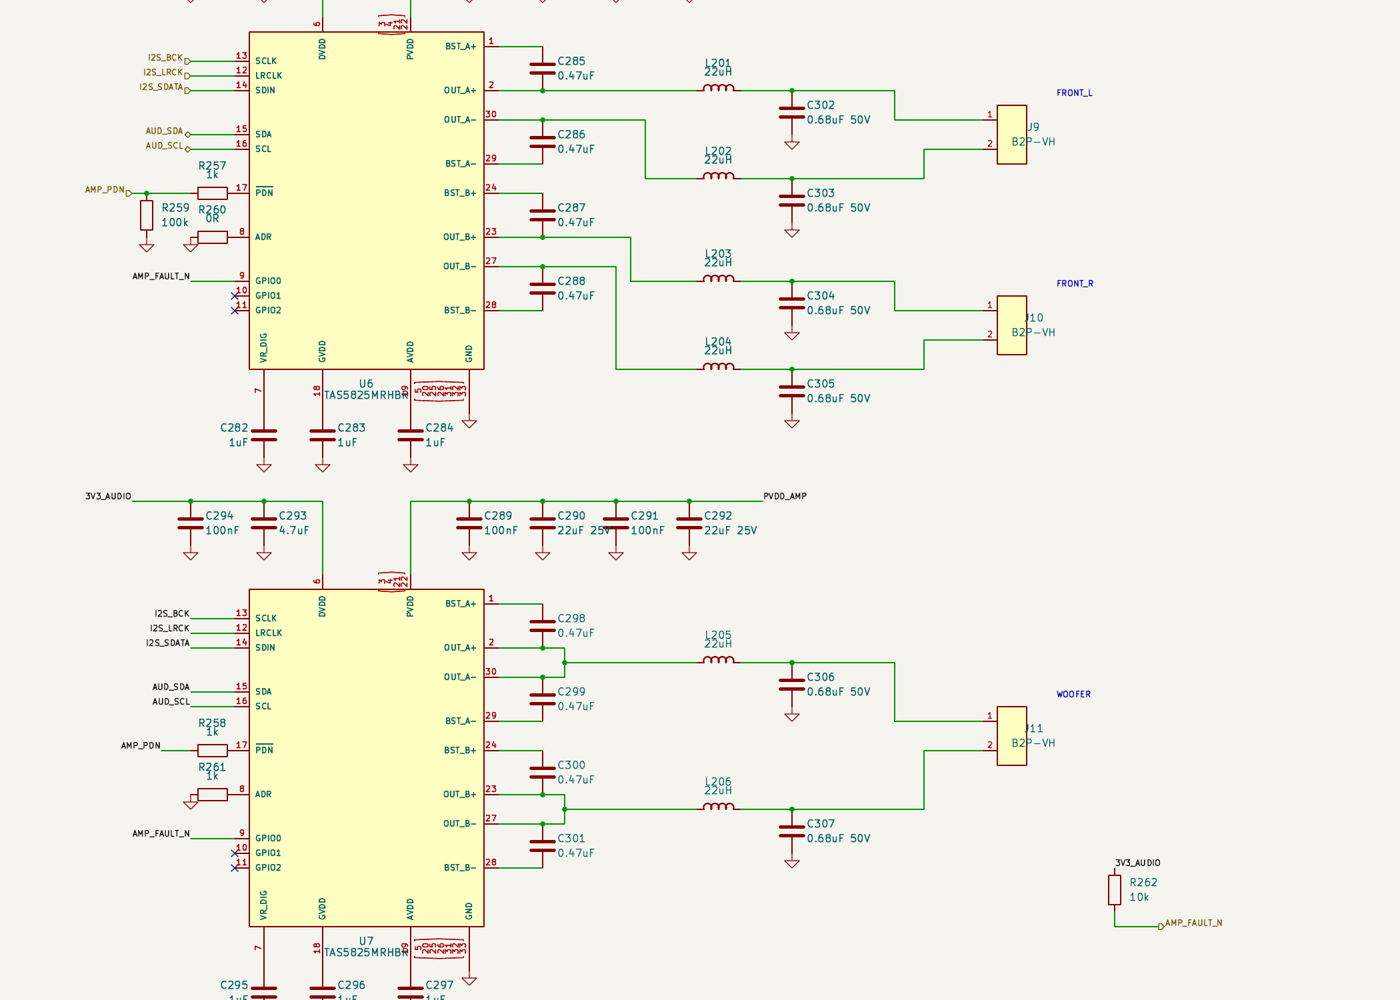
ai-files/reports/amp/crop2-1.png
