chithigun23/DesktopSpeaker/ai-files/reports/aux-mux-review/candidate-page.png

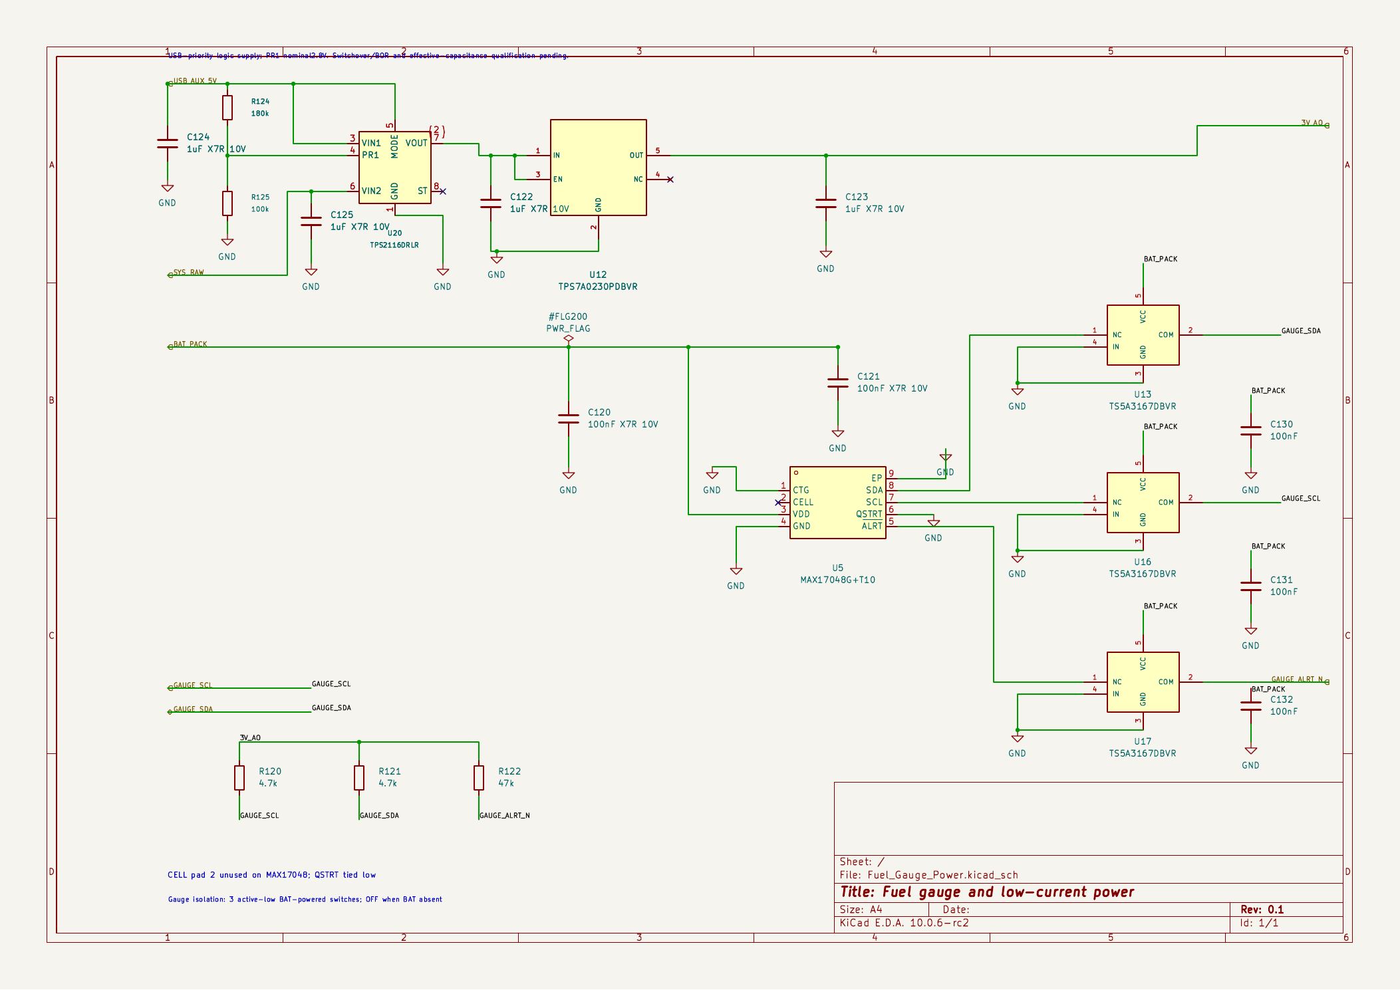
ai-files/reports/aux-mux-review/candidate-page.png
