chithigun23/DesktopSpeaker/ai-files/reports/Bluetooth-model-import-preview.png

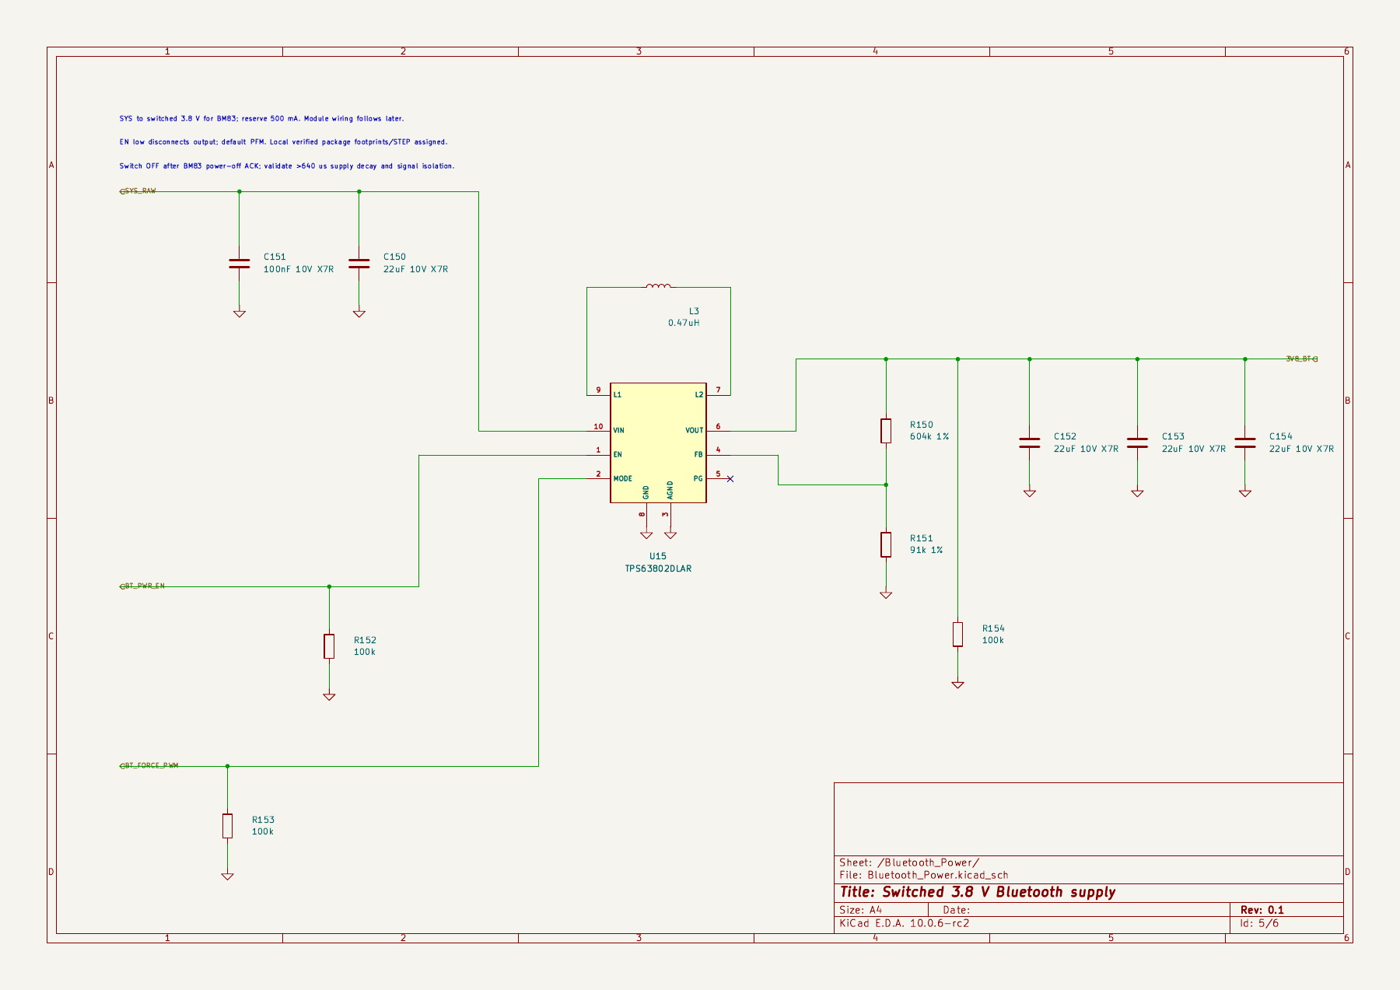
ai-files/reports/Bluetooth-model-import-preview.png
