chithigun23/DesktopSpeaker/ai-files/reports/bq25792-board-layout.png

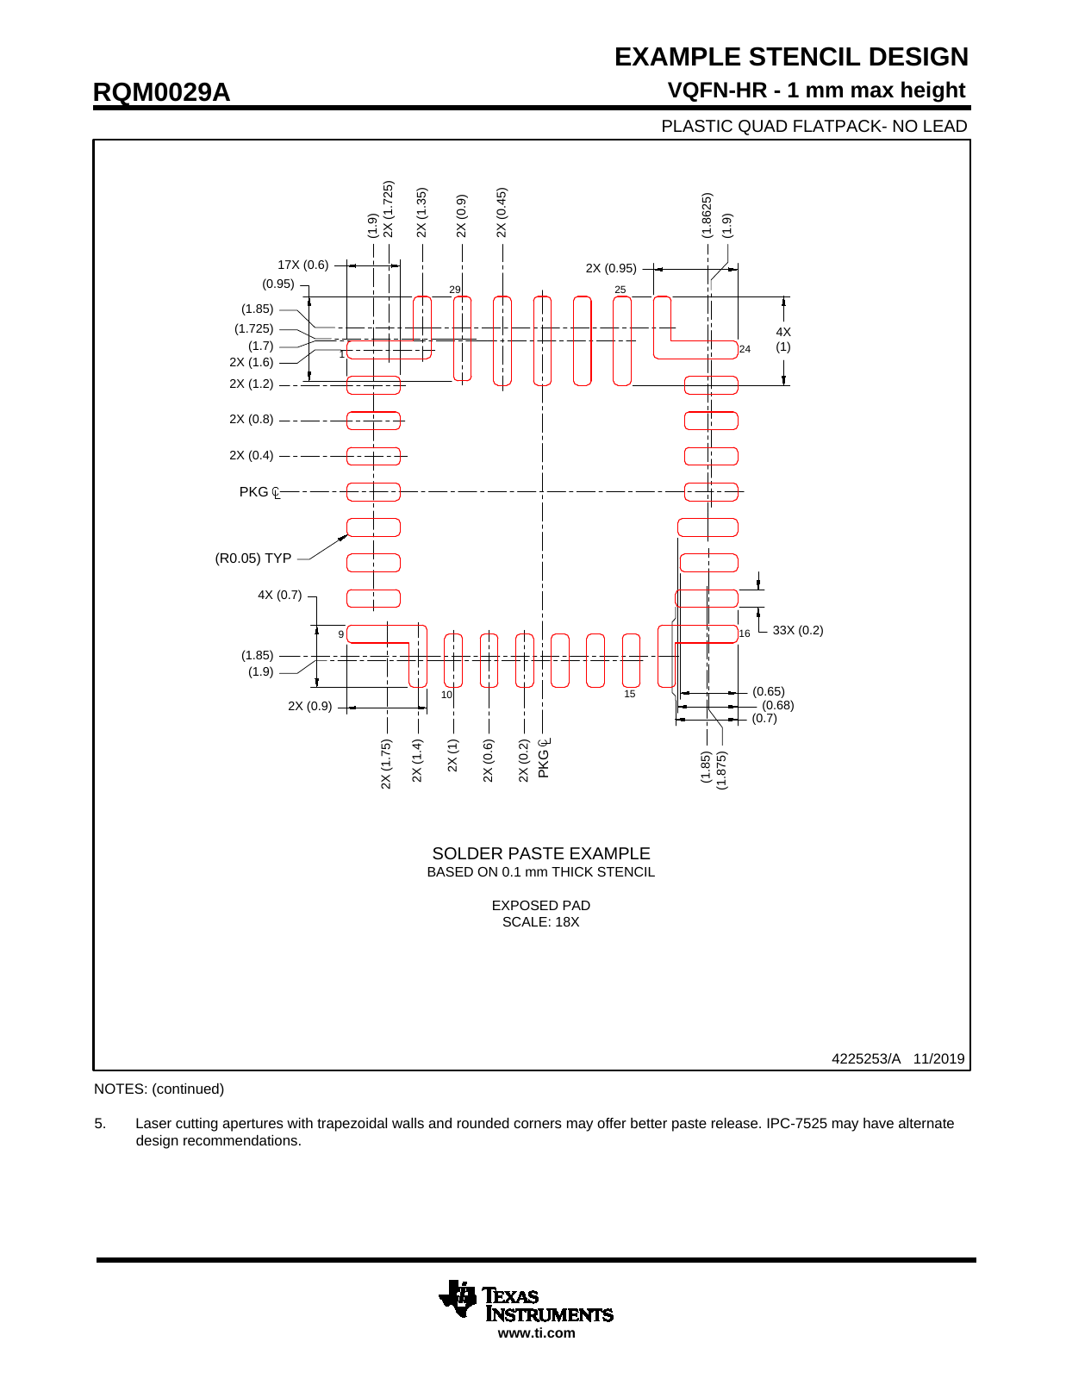
ai-files/reports/bq25792-board-layout.png
