chithigun23/DesktopSpeaker/ai-files/reports/bq25792-package-outline.png

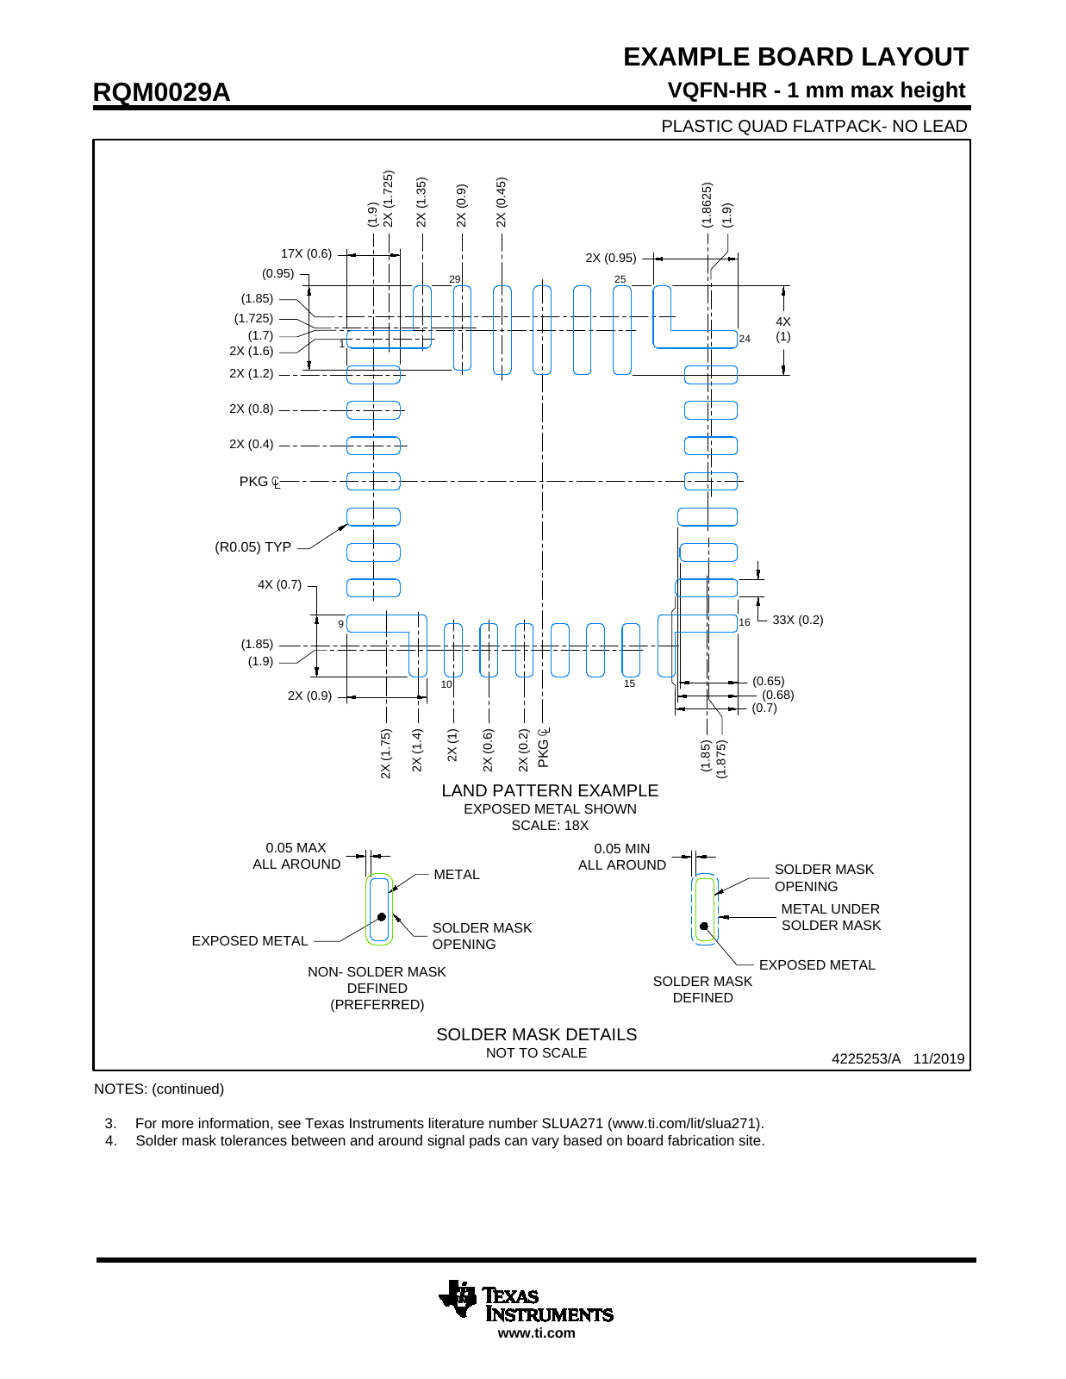
ai-files/reports/bq25792-package-outline.png
