chithigun23/DesktopSpeaker/ai-files/reports/bq25792-ship-047.png

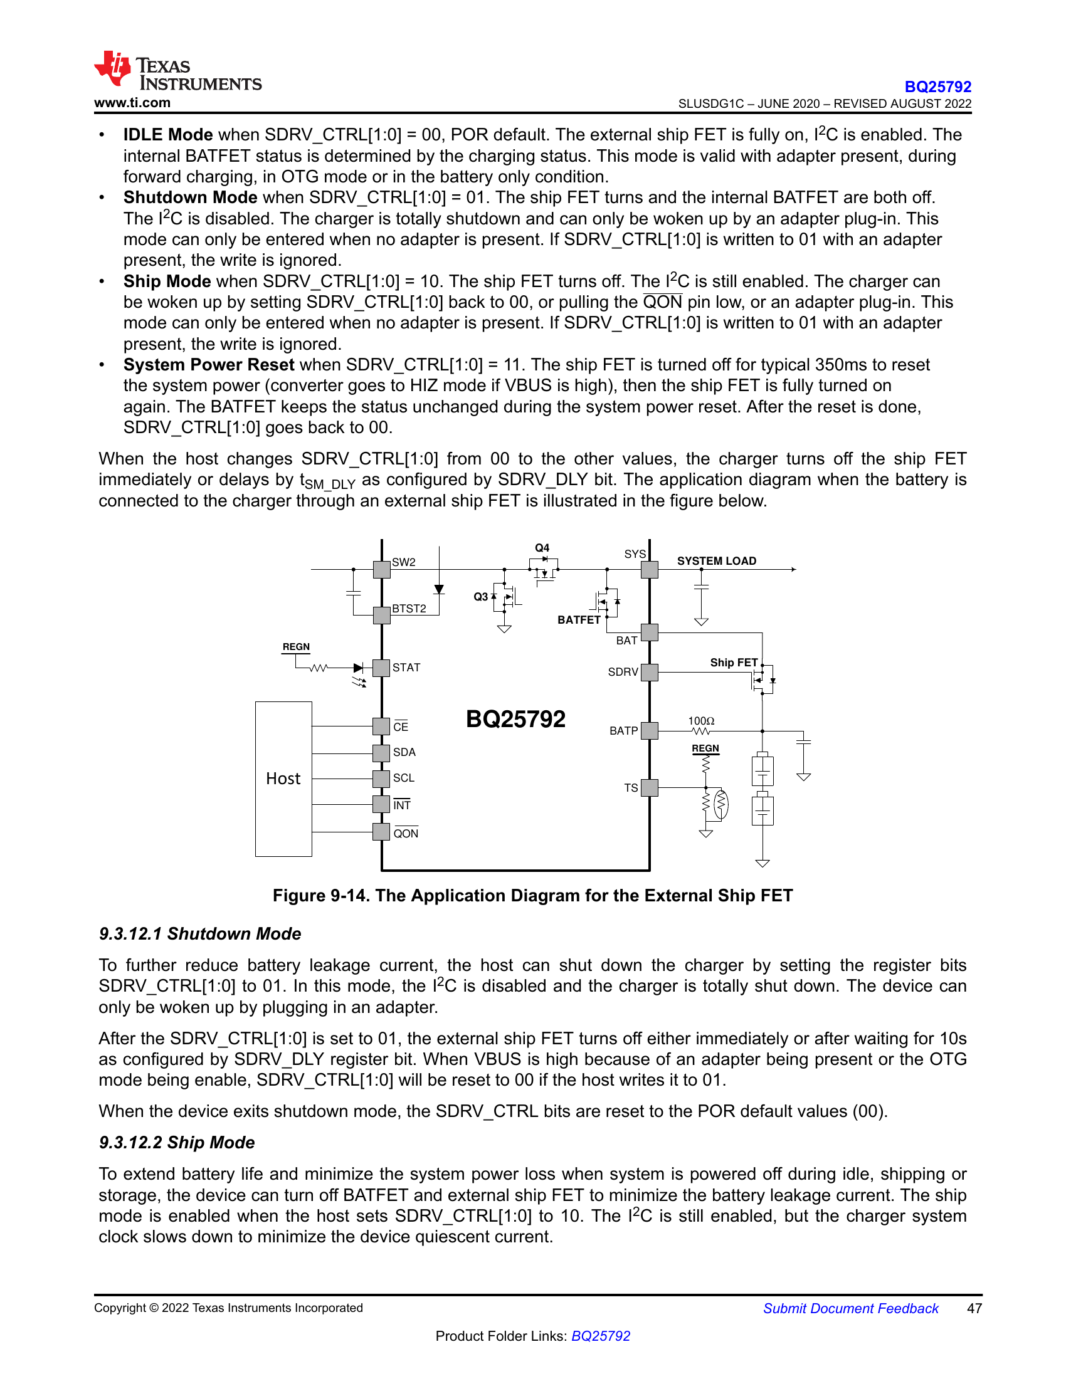
ai-files/reports/bq25792-ship-047.png
