chithigun23/DesktopSpeaker/ai-files/reports/bq25792-symbol-svg/BQ25792RQMR_unit1.png

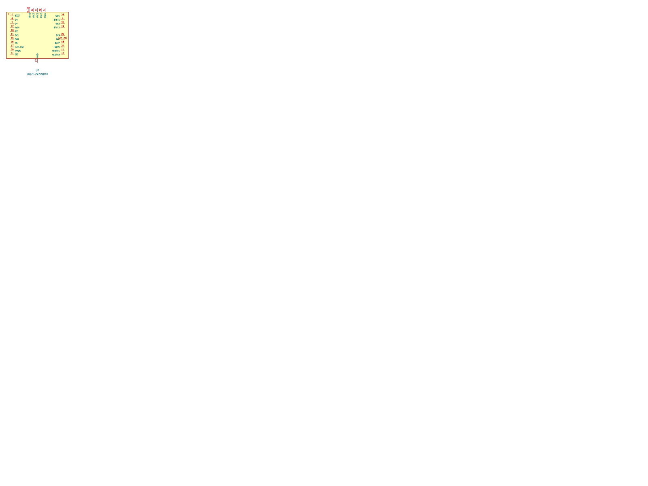
ai-files/reports/bq25792-symbol-svg/BQ25792RQMR_unit1.png
