chithigun23/DesktopSpeaker/ai-files/reports/bq25792-ti-render/page-140.png

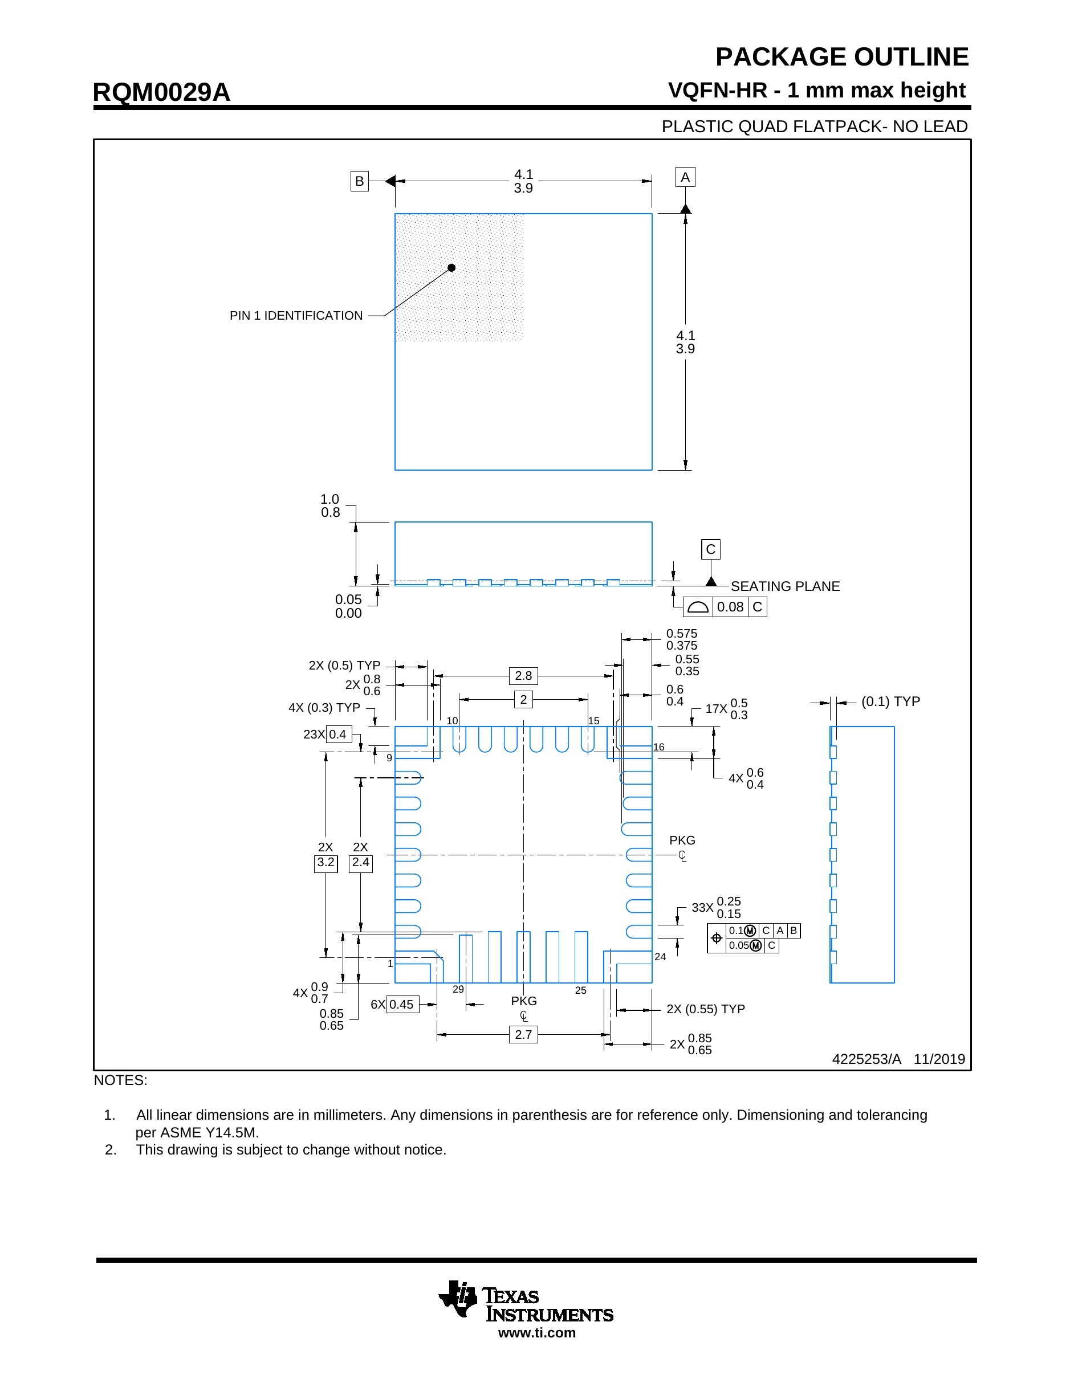
ai-files/reports/bq25792-ti-render/page-140.png
