chithigun23/DesktopSpeaker/ai-files/reports/charger-current-passives.png

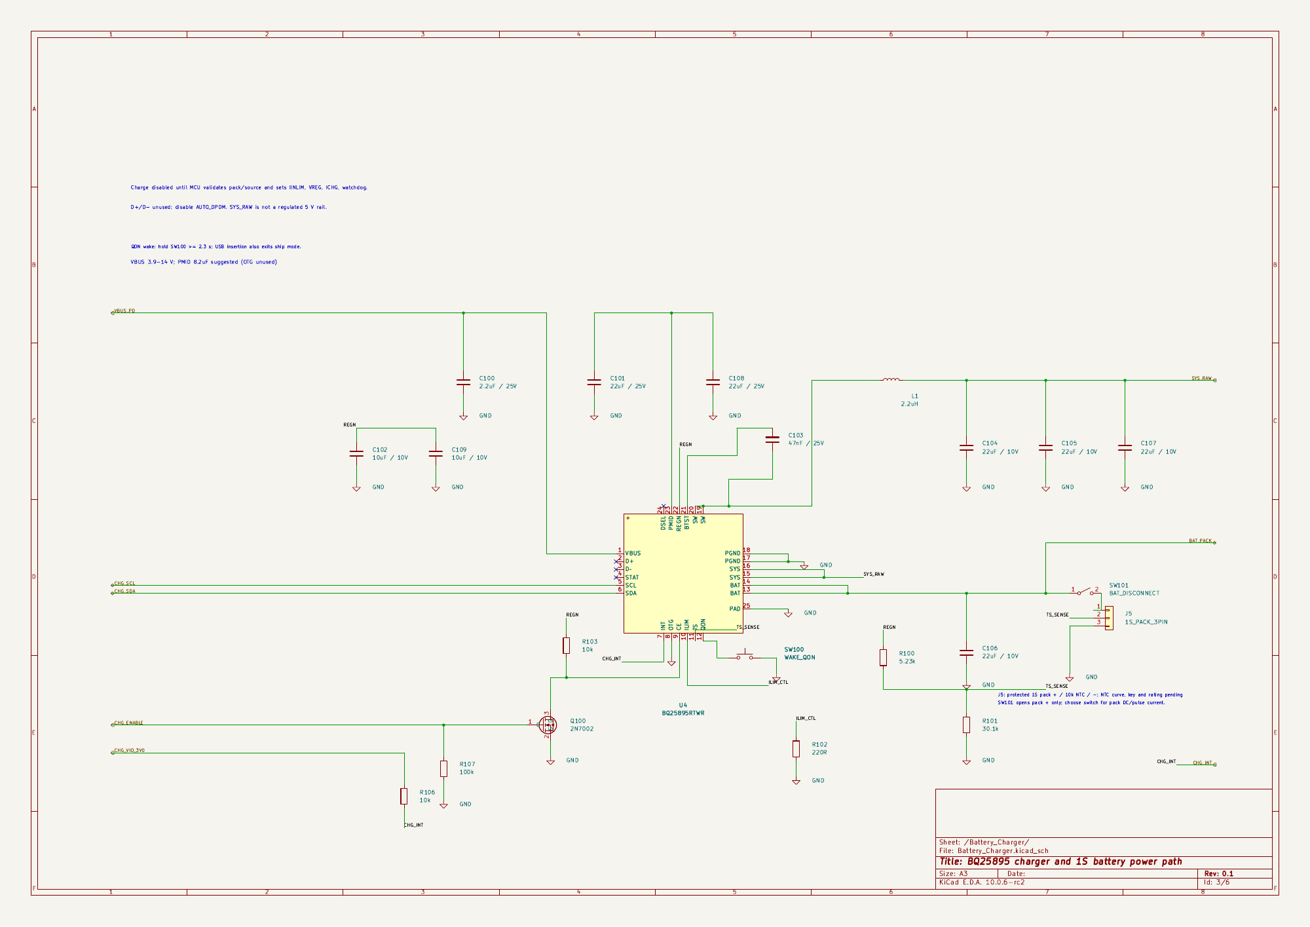
ai-files/reports/charger-current-passives.png
