chithigun23/DesktopSpeaker/ai-files/reports/codec-d4-c103.png

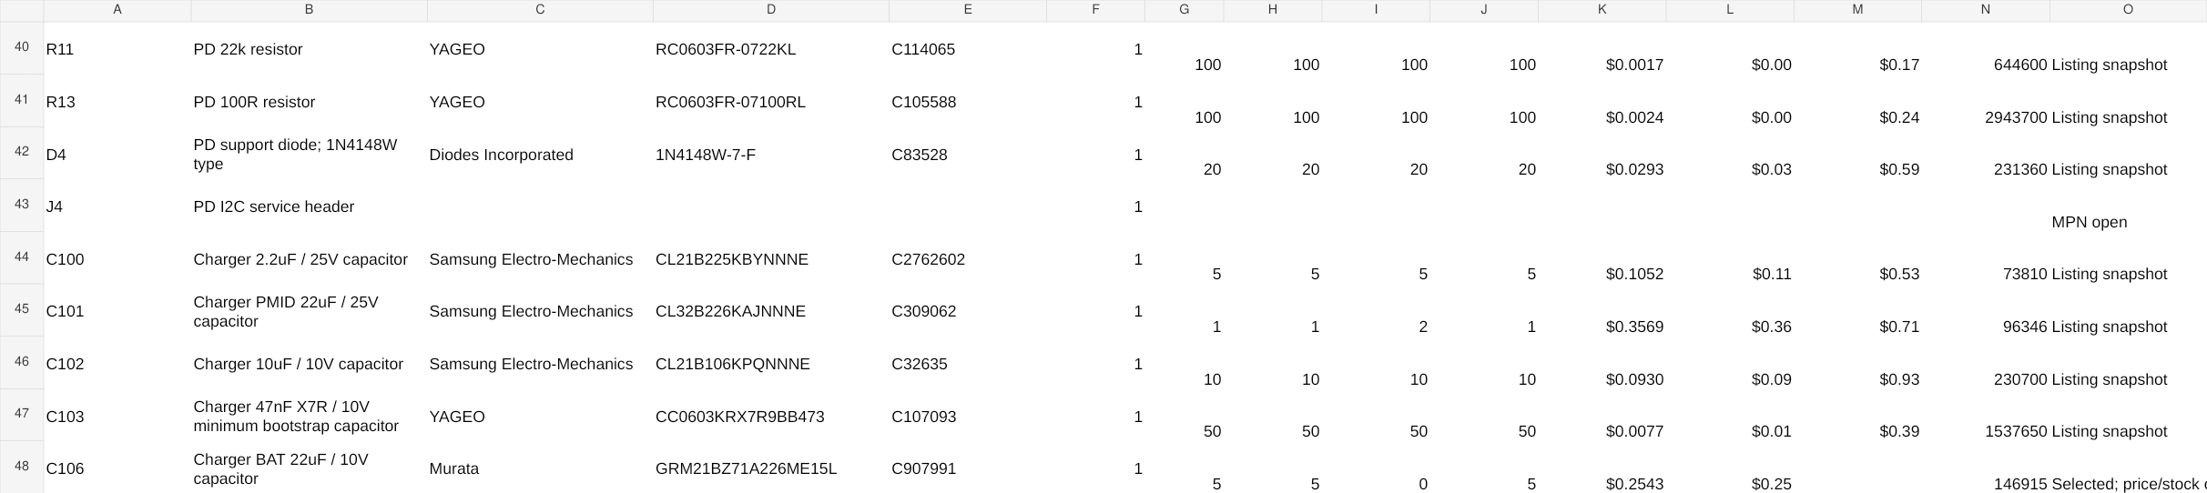
ai-files/reports/codec-d4-c103.png
