chithigun23/DesktopSpeaker/ai-files/reports/codec-resistor-split.png

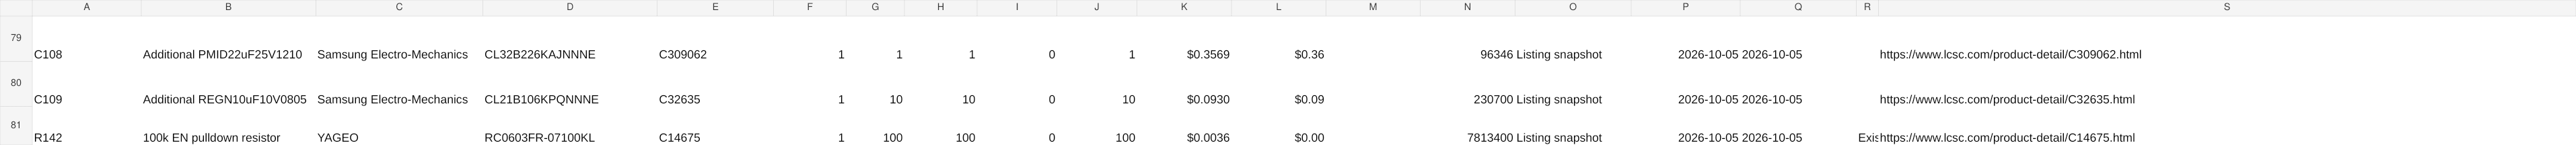
ai-files/reports/codec-resistor-split.png
