chithigun23/DesktopSpeaker/ai-files/reports/codec-resistors.png

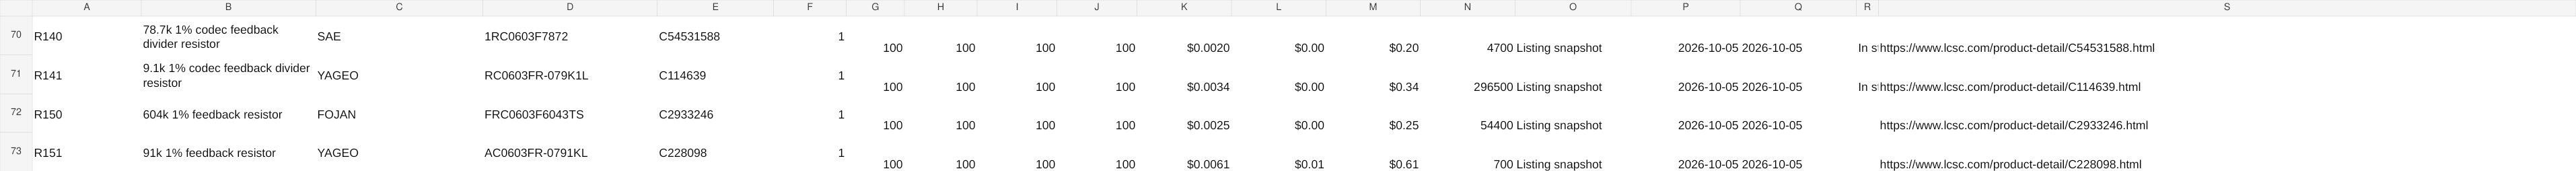
ai-files/reports/codec-resistors.png
