chithigun23/DesktopSpeaker/ai-files/reports/codec-totals.png

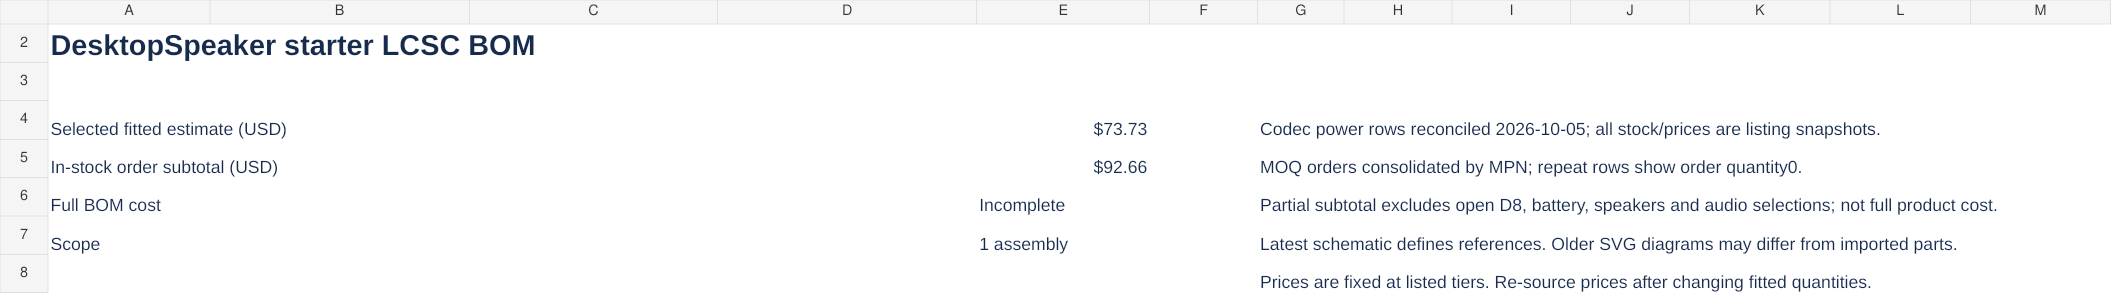
ai-files/reports/codec-totals.png
