chithigun23/DesktopSpeaker/ai-files/reports/critical-power-page-2.png

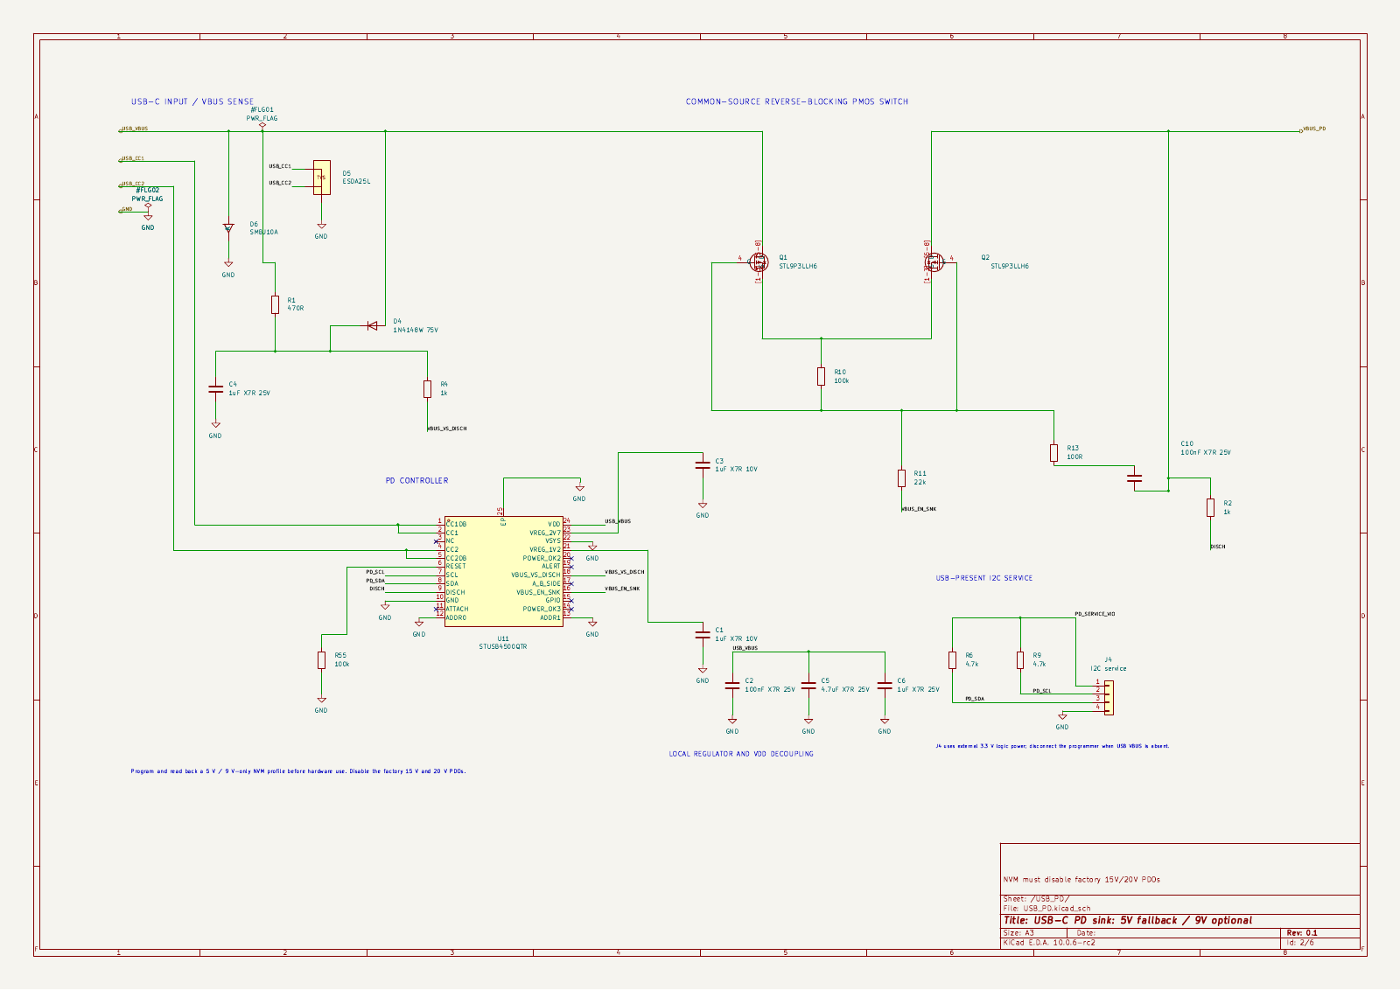
ai-files/reports/critical-power-page-2.png
