chithigun23/DesktopSpeaker/ai-files/reports/critical-power-page-4.png

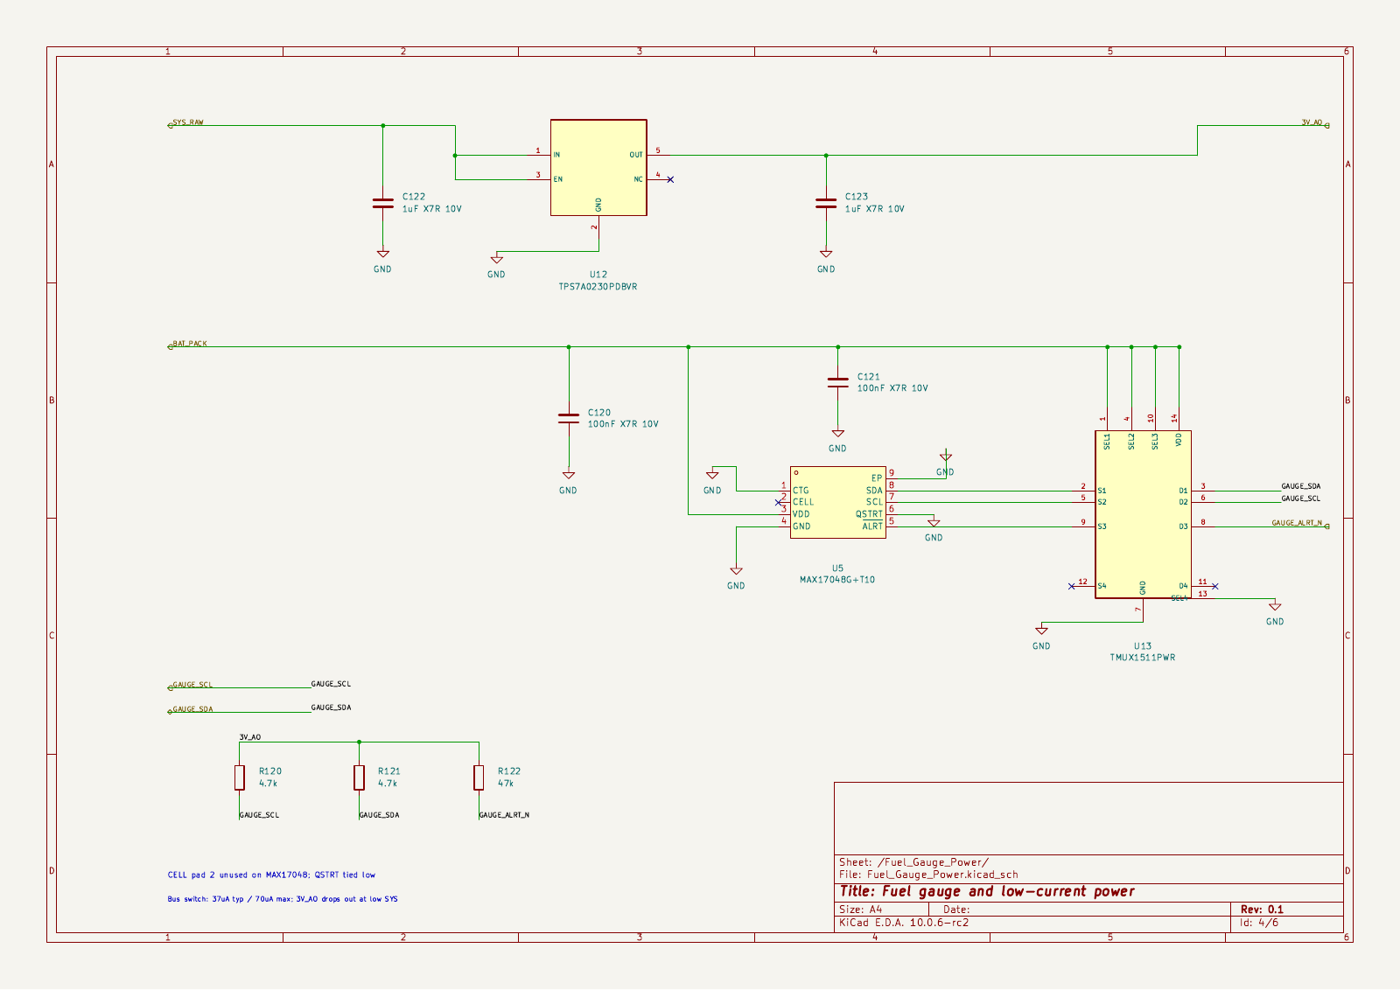
ai-files/reports/critical-power-page-4.png
