chithigun23/DesktopSpeaker/ai-files/reports/critical-power-page-5.png

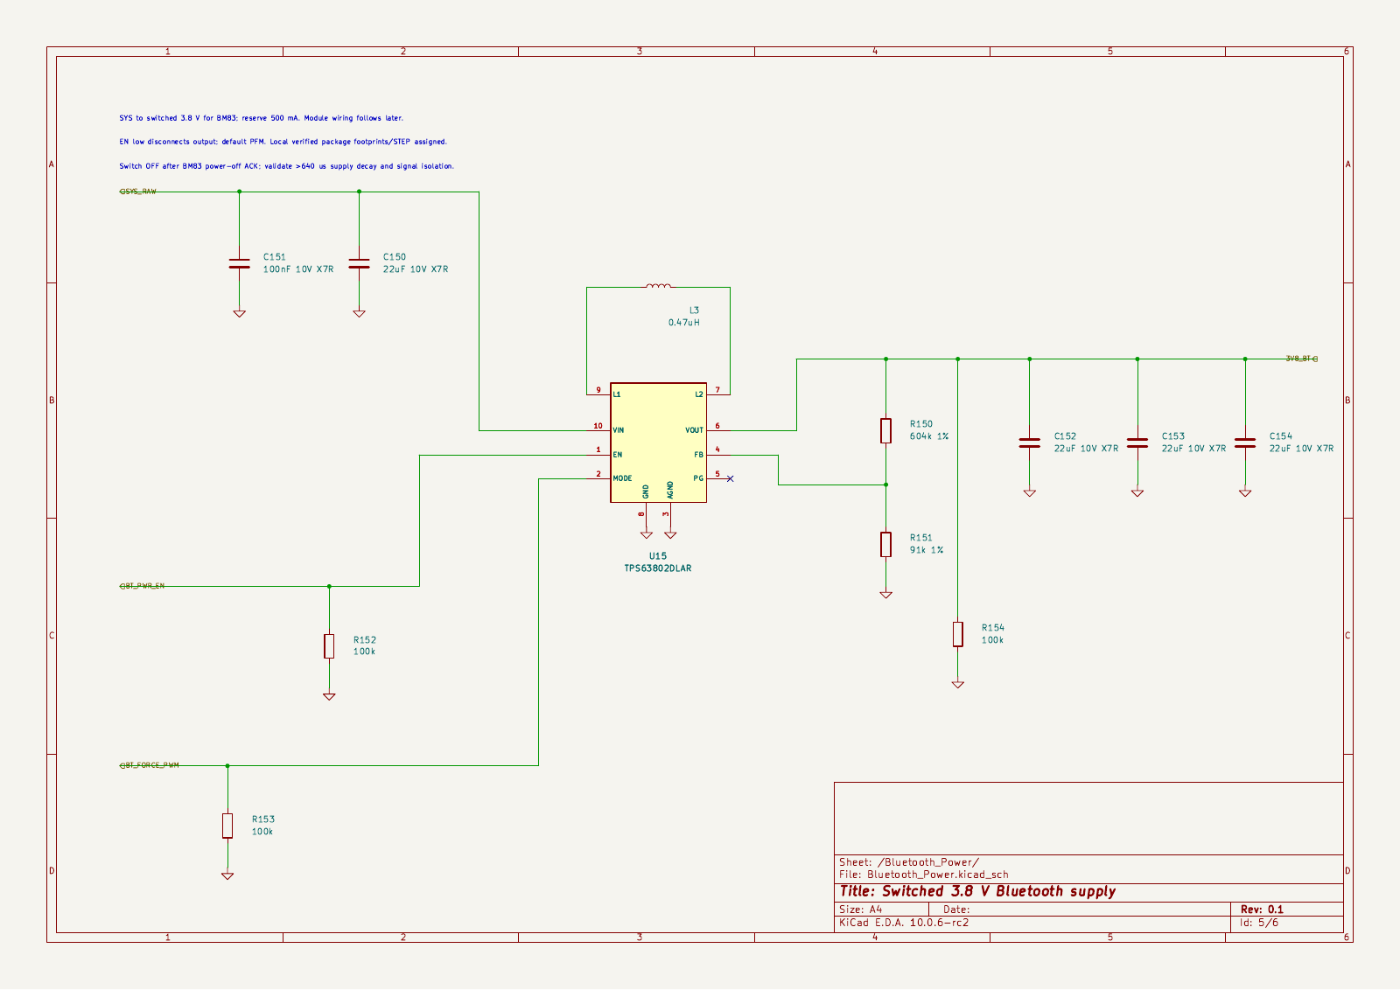
ai-files/reports/critical-power-page-5.png
