chithigun23/DesktopSpeaker/ai-files/reports/critical-power-page-6.png

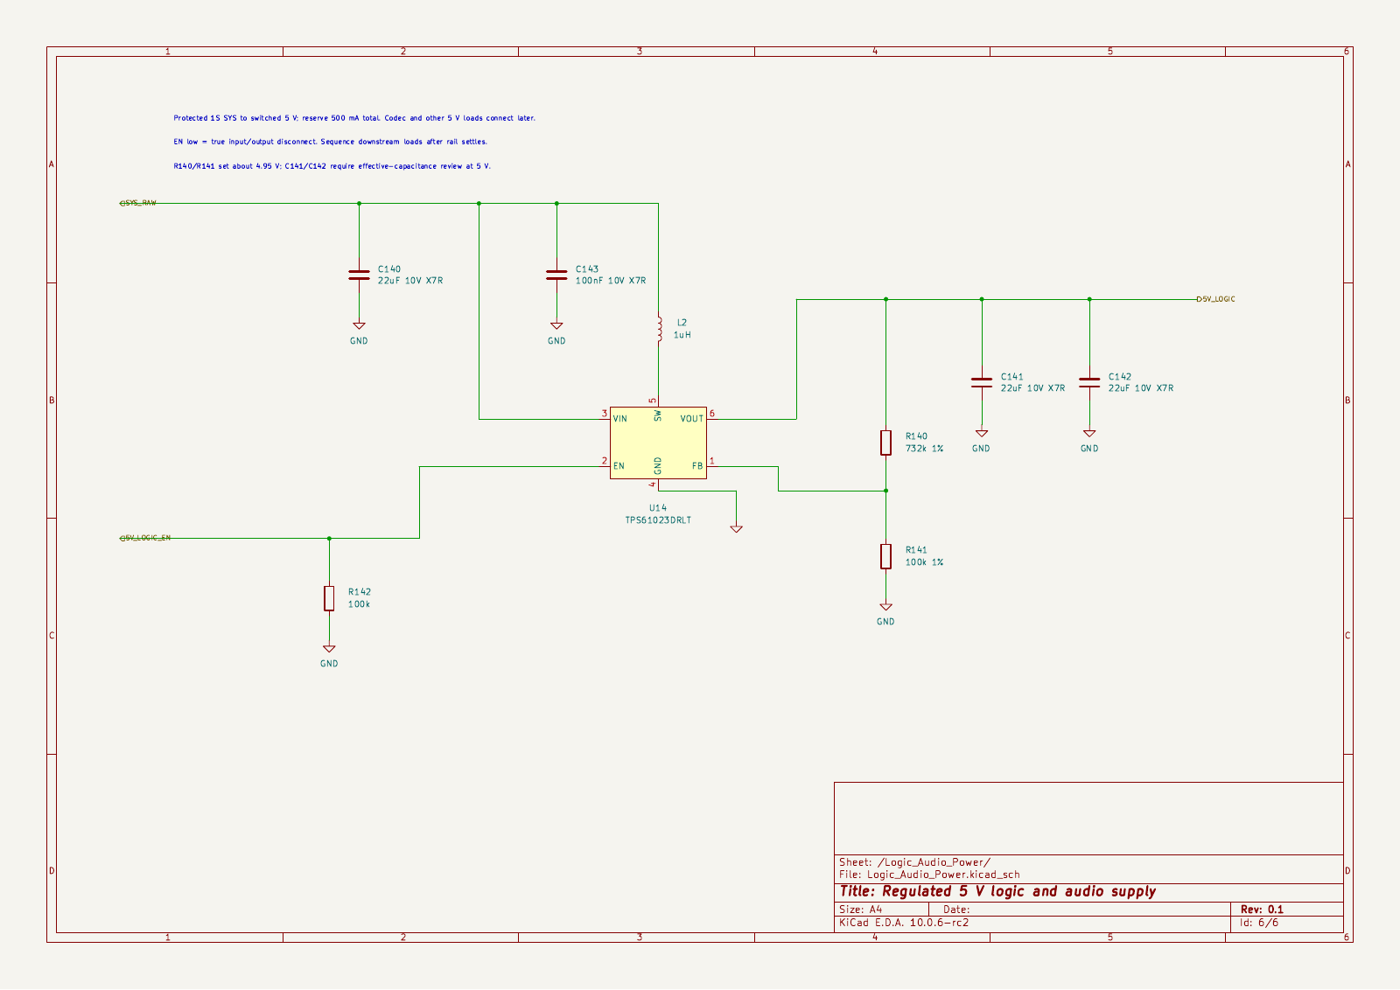
ai-files/reports/critical-power-page-6.png
