chithigun23/DesktopSpeaker/ai-files/reports/critical-power-root-1.png

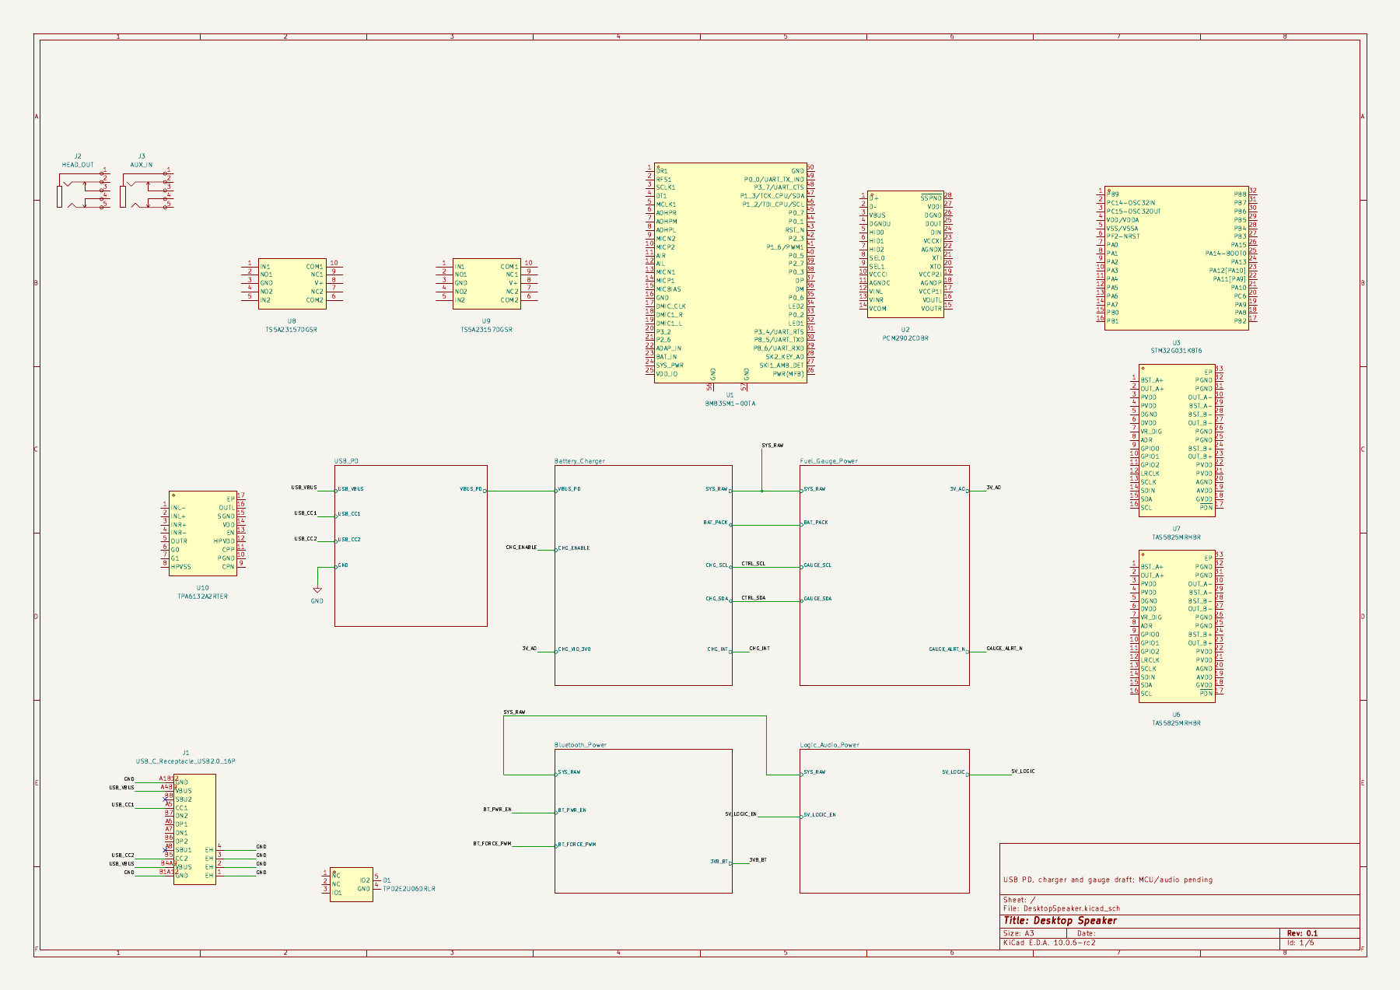
ai-files/reports/critical-power-root-1.png
