chithigun23/DesktopSpeaker/ai-files/reports/csd17579-package-09.png

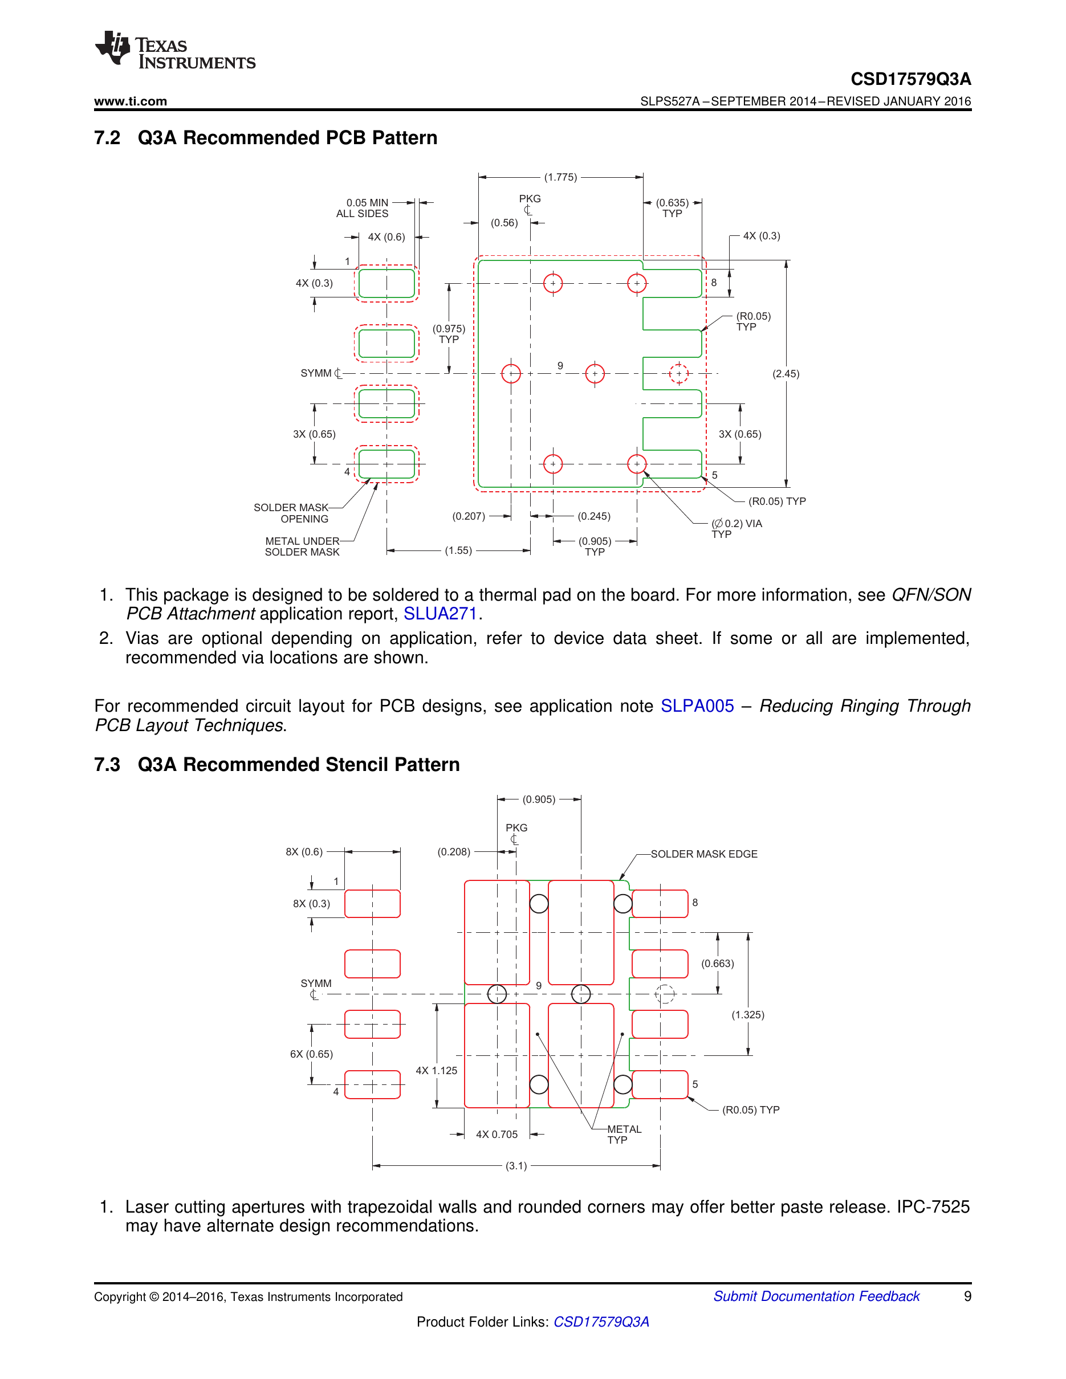
ai-files/reports/csd17579-package-09.png
