chithigun23/DesktopSpeaker/ai-files/reports/CSD17579Q3A_footprint.png

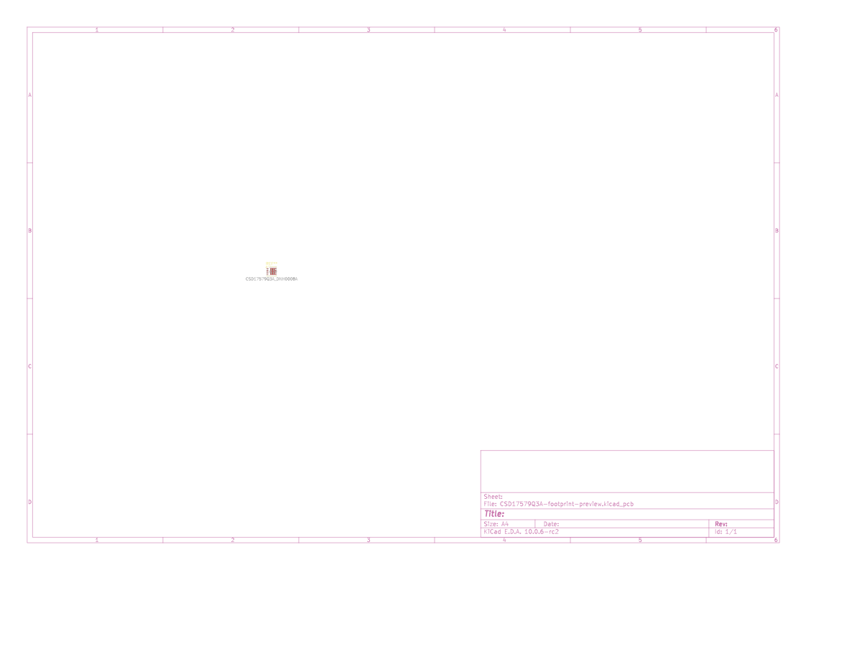
ai-files/reports/CSD17579Q3A_footprint.png
