chithigun23/DesktopSpeaker/ai-files/reports/csd-stencil-review/datasheet-pdf-page10-10.png

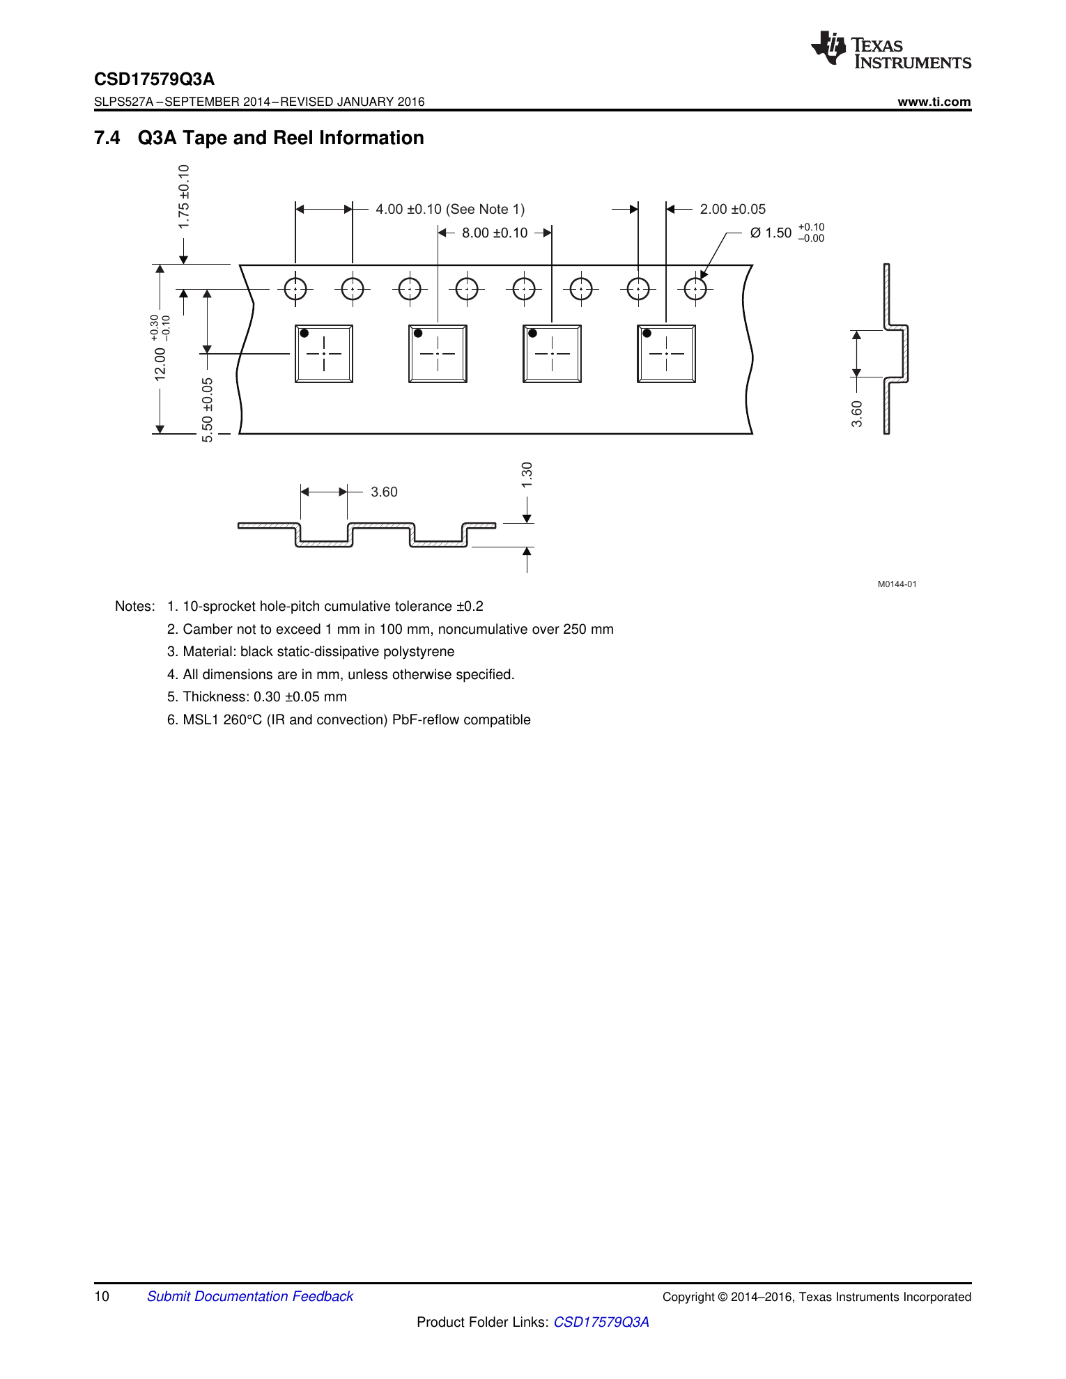
ai-files/reports/csd-stencil-review/datasheet-pdf-page10-10.png
