chithigun23/DesktopSpeaker/ai-files/reports/csd-stencil-review/footprint-large-1.png

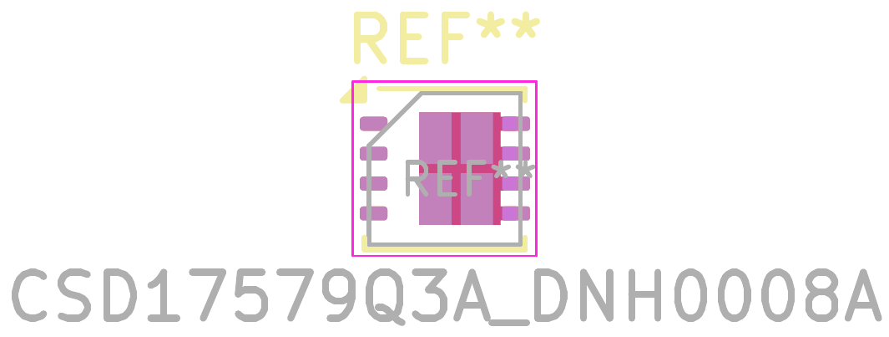
ai-files/reports/csd-stencil-review/footprint-large-1.png
