chithigun23/DesktopSpeaker/ai-files/reports/current-review-page-2.png

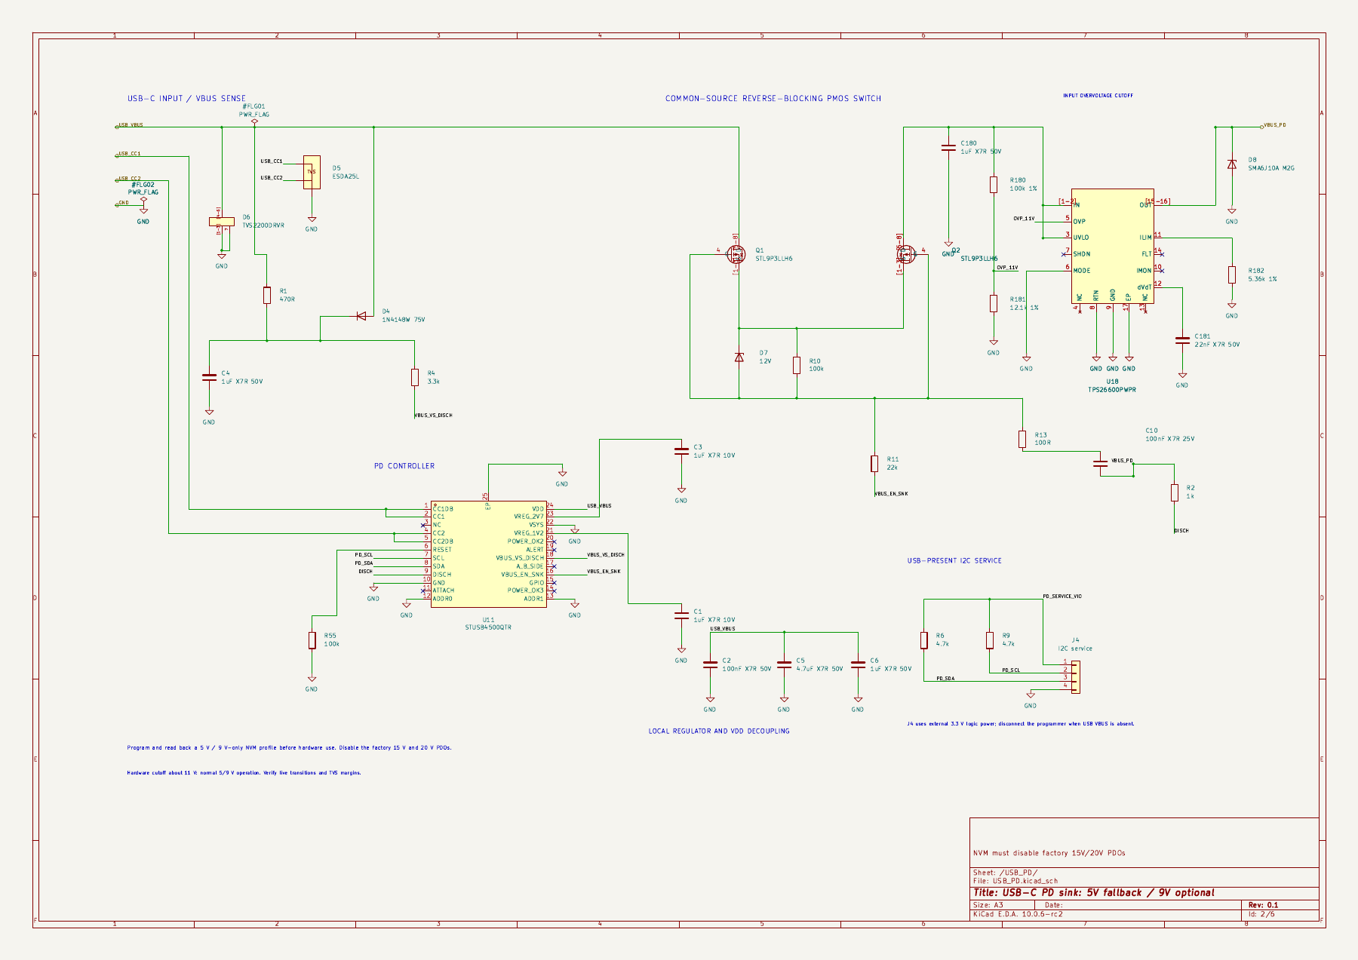
ai-files/reports/current-review-page-2.png
