chithigun23/DesktopSpeaker/ai-files/reports/current-review-page-3.png

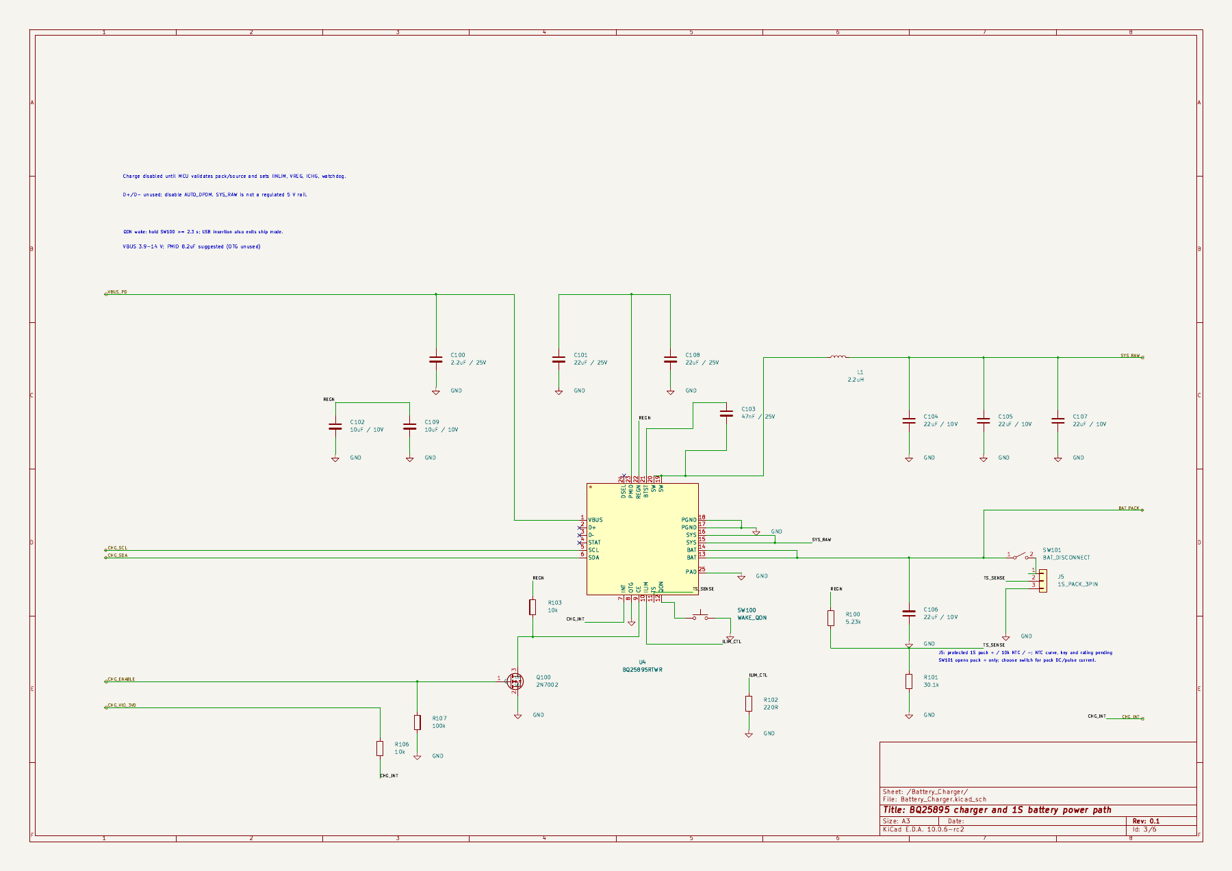
ai-files/reports/current-review-page-3.png
