chithigun23/DesktopSpeaker/ai-files/reports/current-review-page-4.png

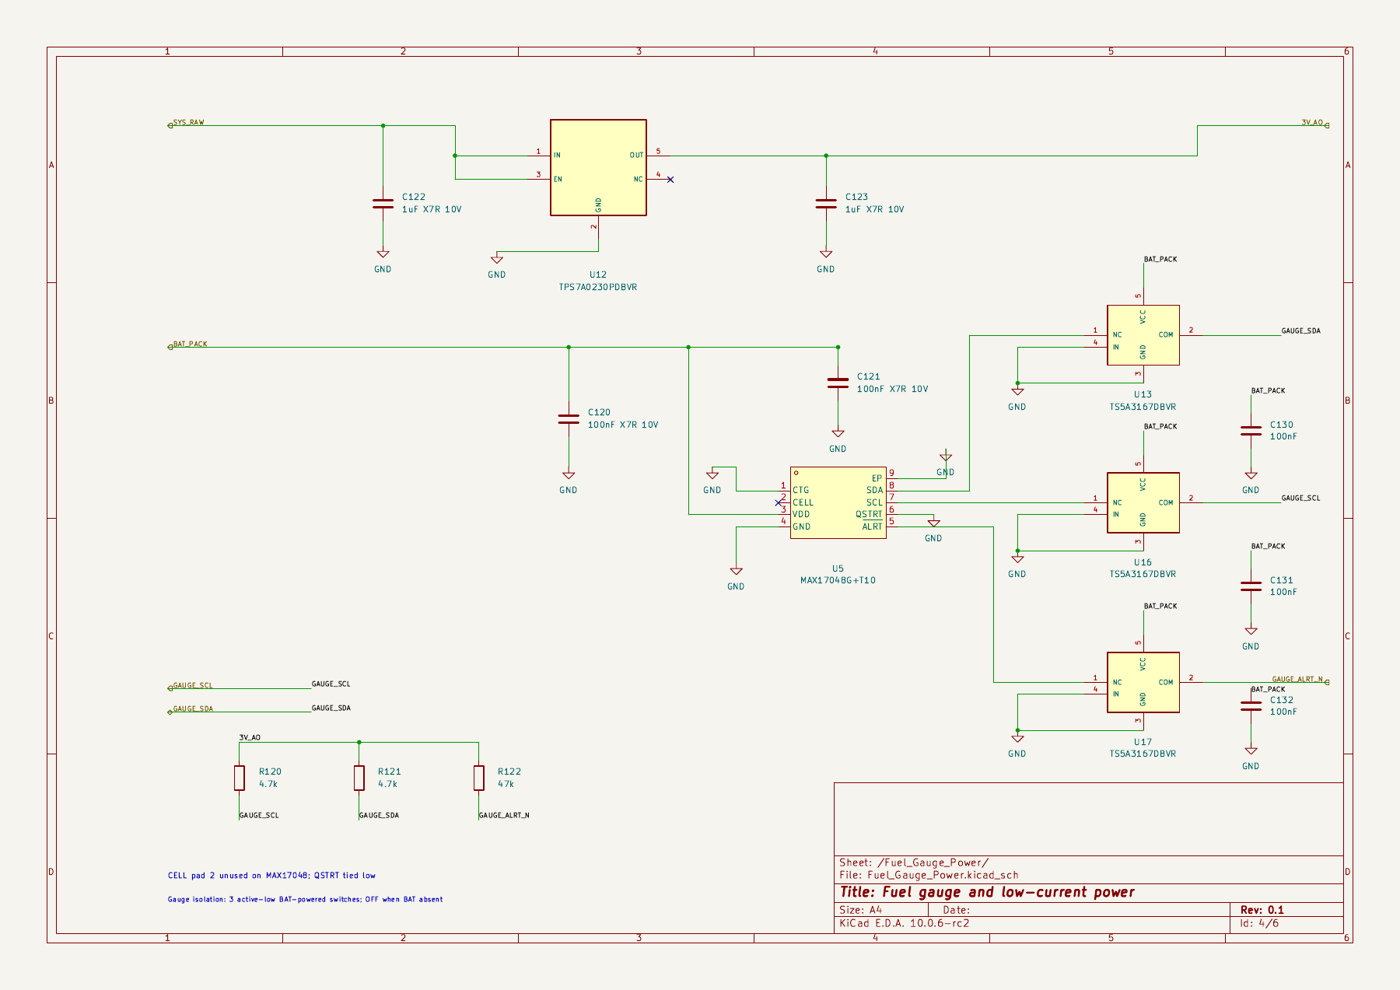
ai-files/reports/current-review-page-4.png
