chithigun23/DesktopSpeaker/ai-files/reports/efuse-after-inrush-detail.png

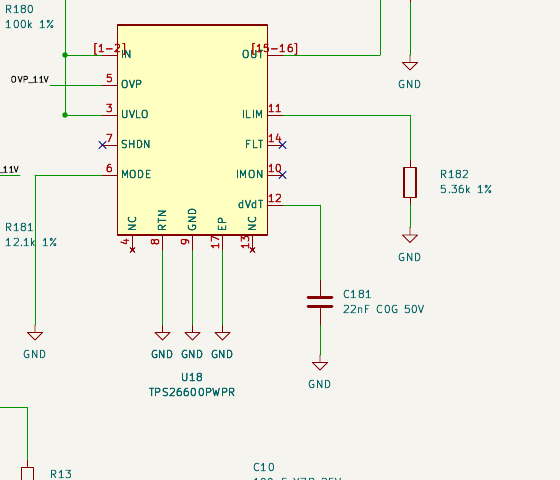
ai-files/reports/efuse-after-inrush-detail.png
