chithigun23/DesktopSpeaker/ai-files/reports/efuse-before-inrush-detail.png

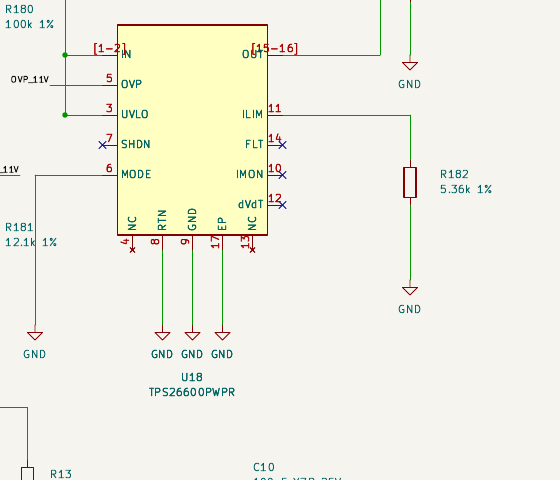
ai-files/reports/efuse-before-inrush-detail.png
