chithigun23/DesktopSpeaker/ai-files/reports/efuse-model-corrected-native.png

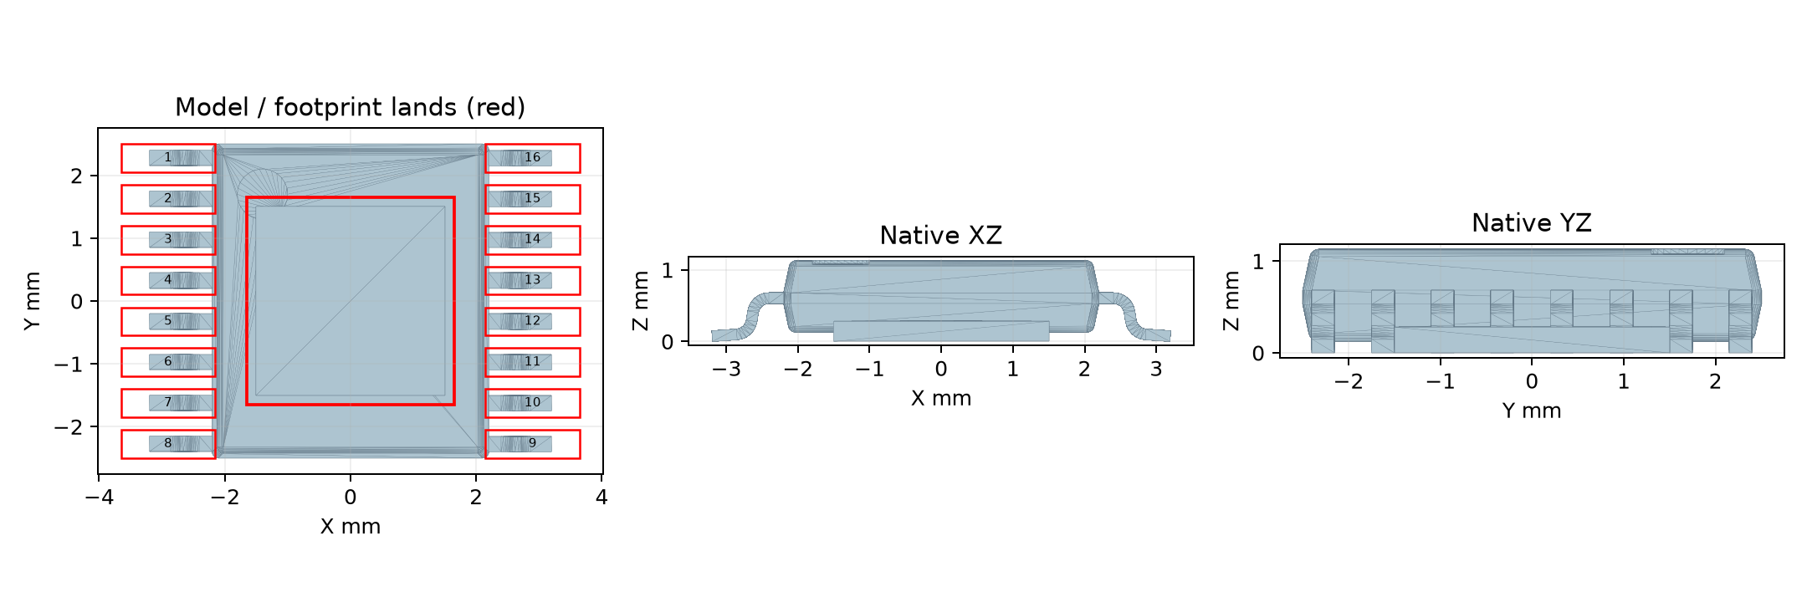
ai-files/reports/efuse-model-corrected-native.png
