chithigun23/DesktopSpeaker/ai-files/reports/erc-cleanup/j1-after-01.png

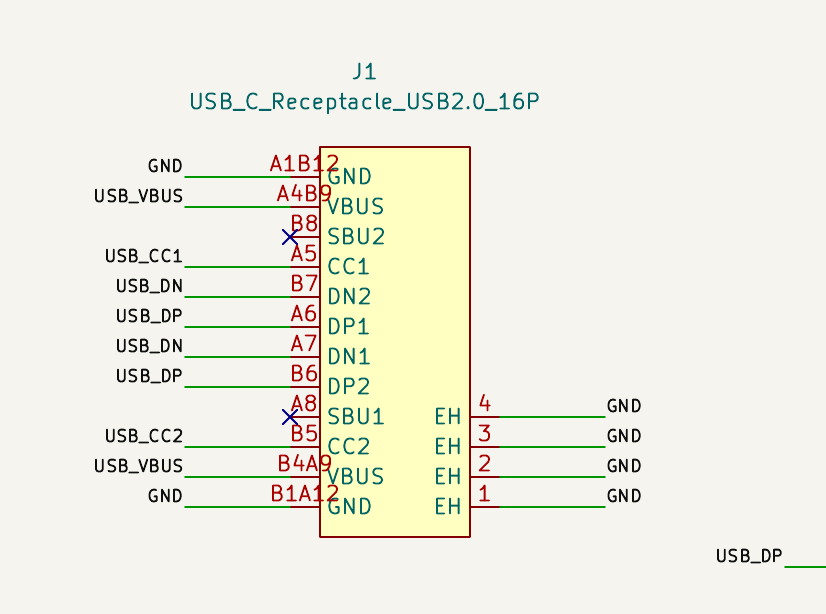
ai-files/reports/erc-cleanup/j1-after-01.png
