chithigun23/DesktopSpeaker/ai-files/reports/erc-cleanup/j1-before-01.png

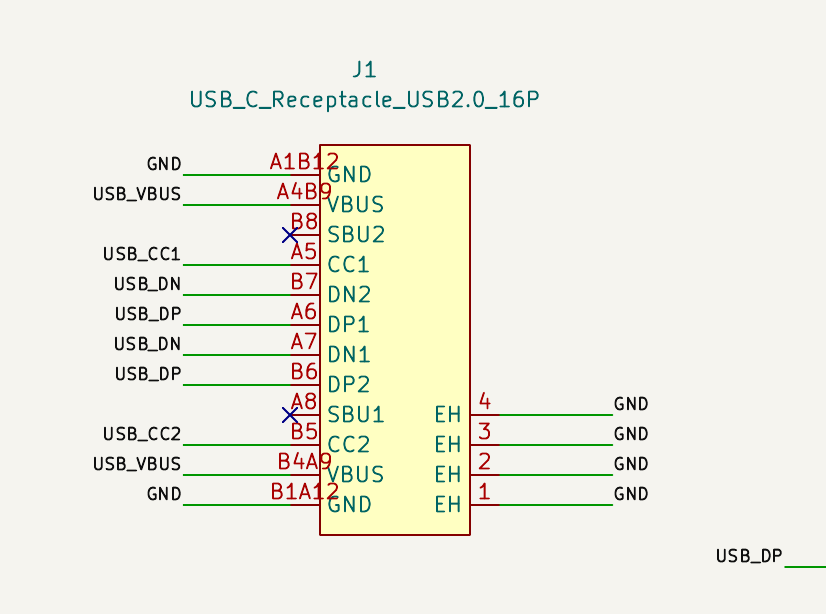
ai-files/reports/erc-cleanup/j1-before-01.png
