chithigun23/DesktopSpeaker/ai-files/reports/erc-cleanup/usba-after-08.png

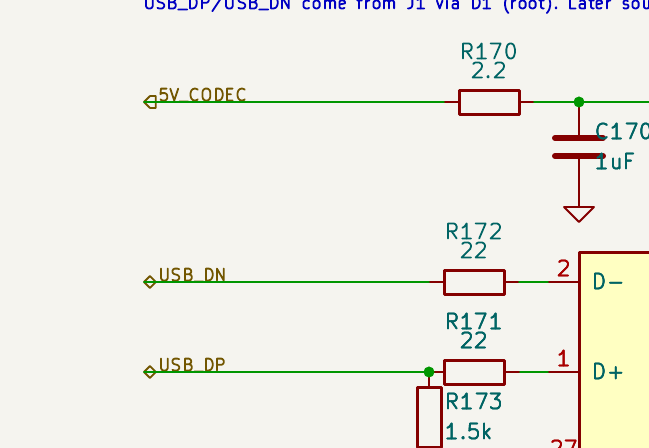
ai-files/reports/erc-cleanup/usba-after-08.png
