chithigun23/DesktopSpeaker/ai-files/reports/final-usb-pd-preview.png

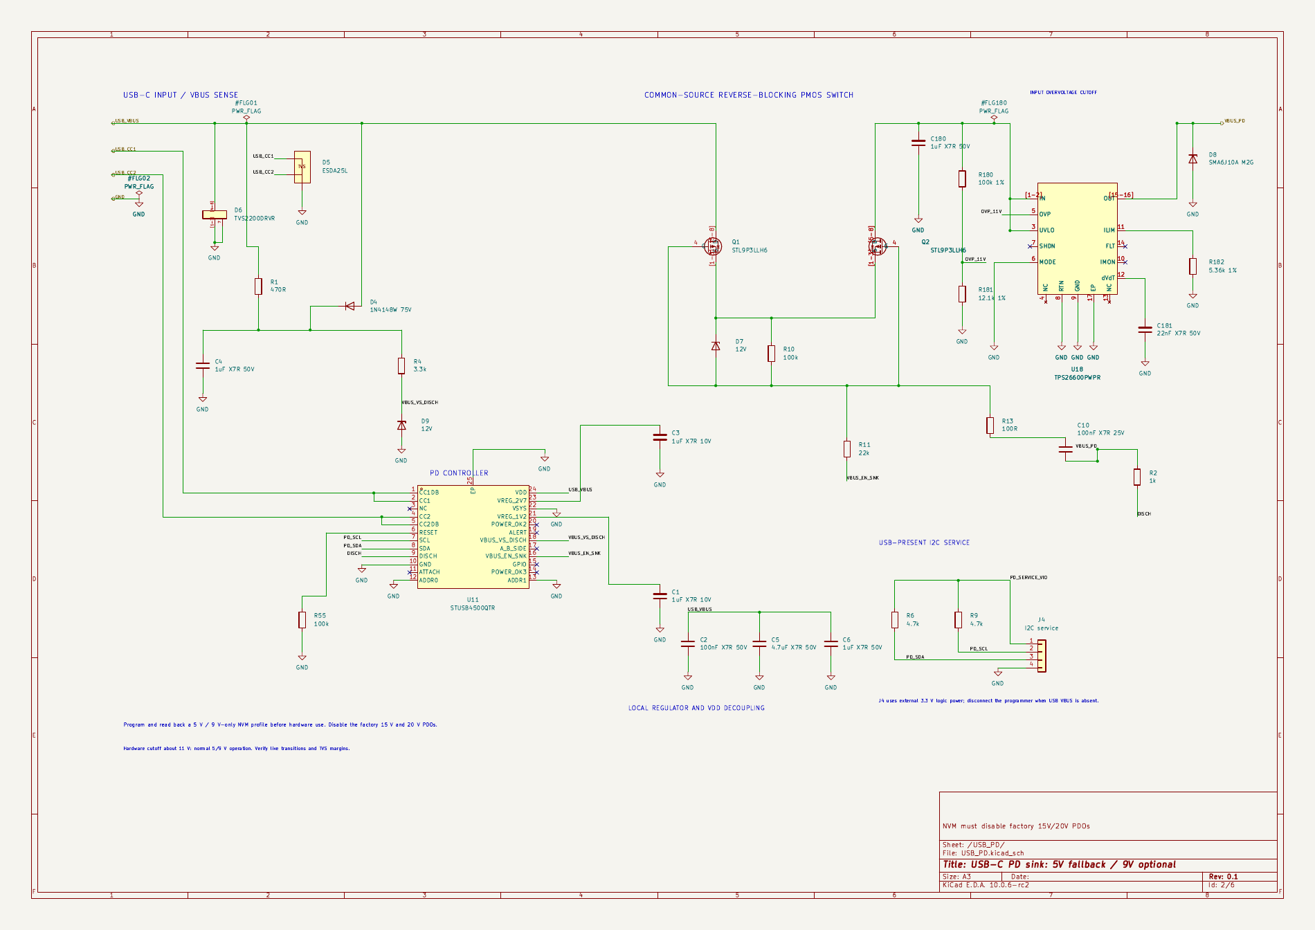
ai-files/reports/final-usb-pd-preview.png
