chithigun23/DesktopSpeaker/ai-files/reports/fixed-metadata-page-3.png

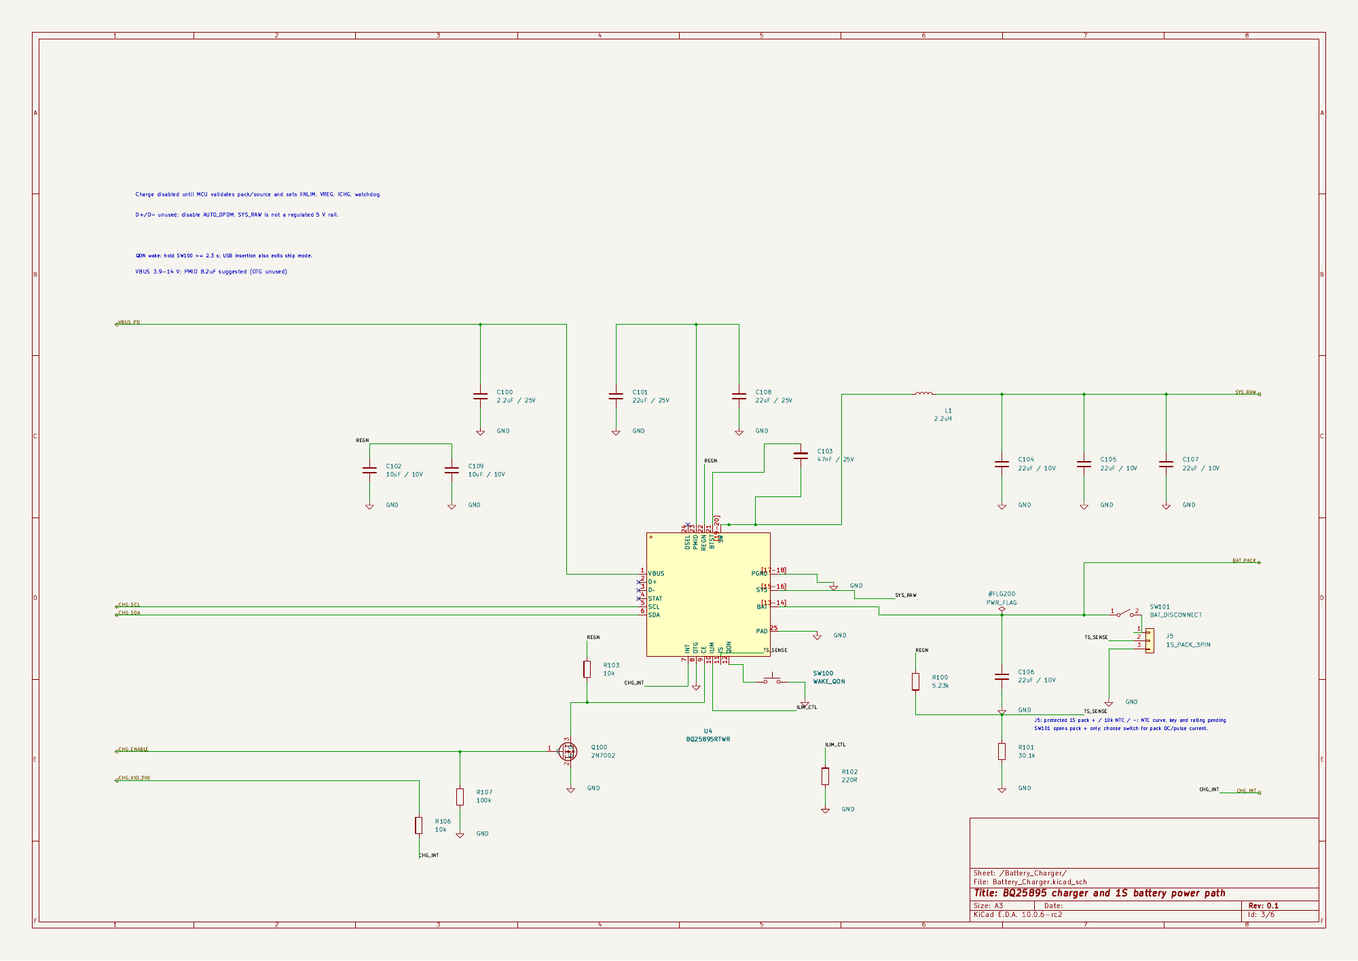
ai-files/reports/fixed-metadata-page-3.png
