chithigun23/DesktopSpeaker/ai-files/reports/gauge-voltage-domain-preview.png

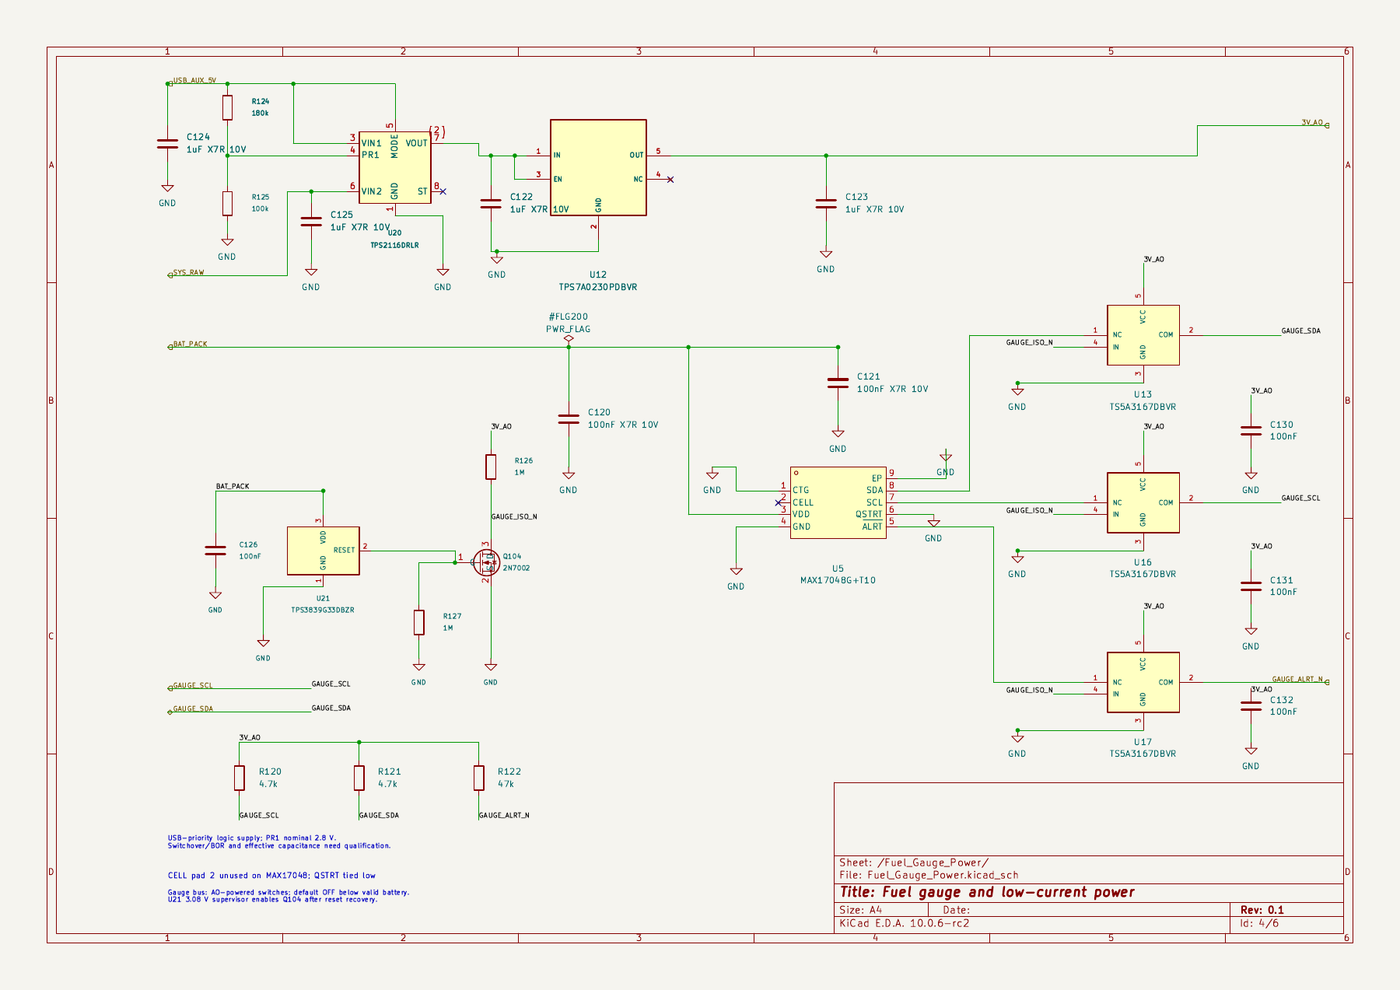
ai-files/reports/gauge-voltage-domain-preview.png
