chithigun23/DesktopSpeaker/ai-files/reports/pd-integrated-review.png

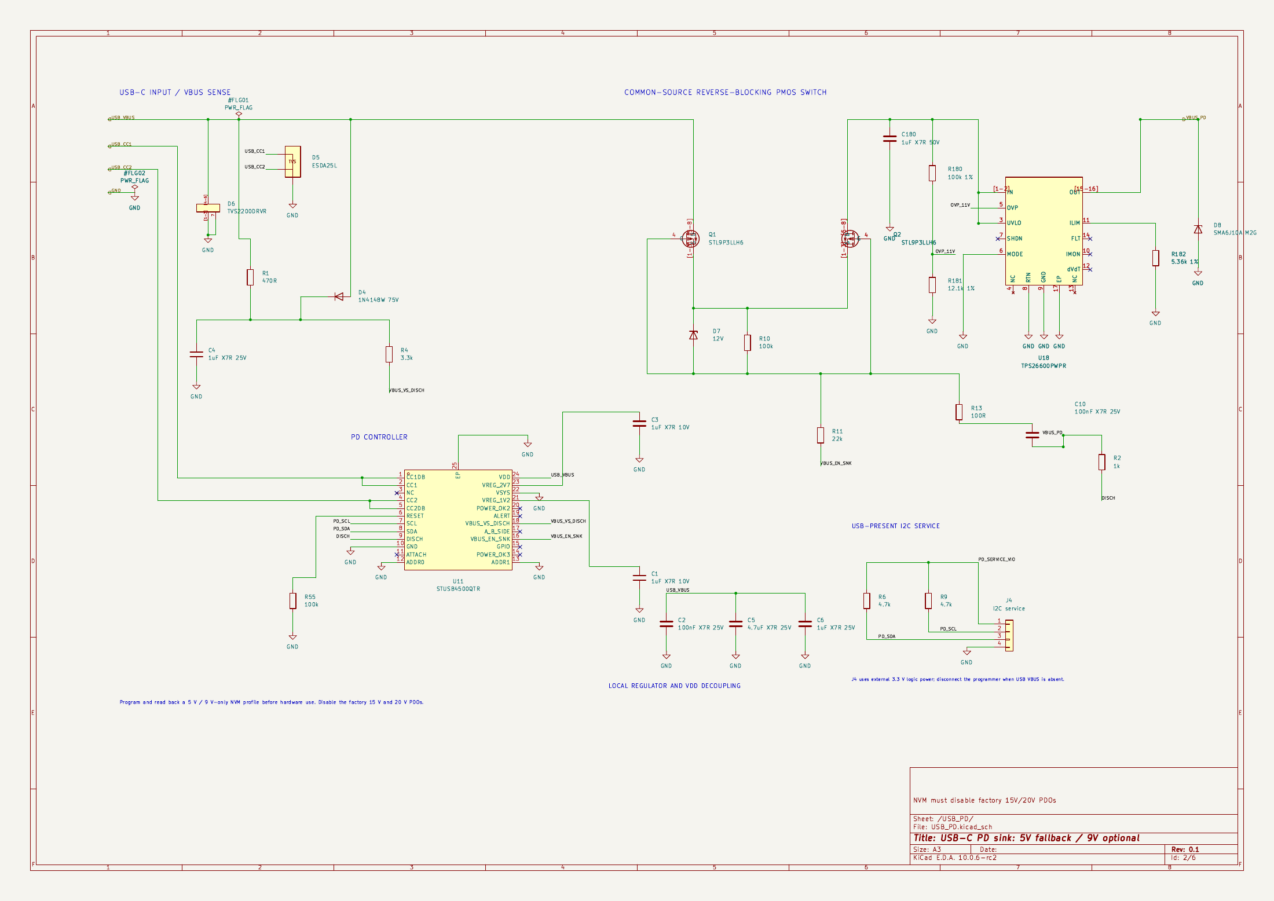
ai-files/reports/pd-integrated-review.png
