chithigun23/DesktopSpeaker/ai-files/reports/pd-ovp-page2.png

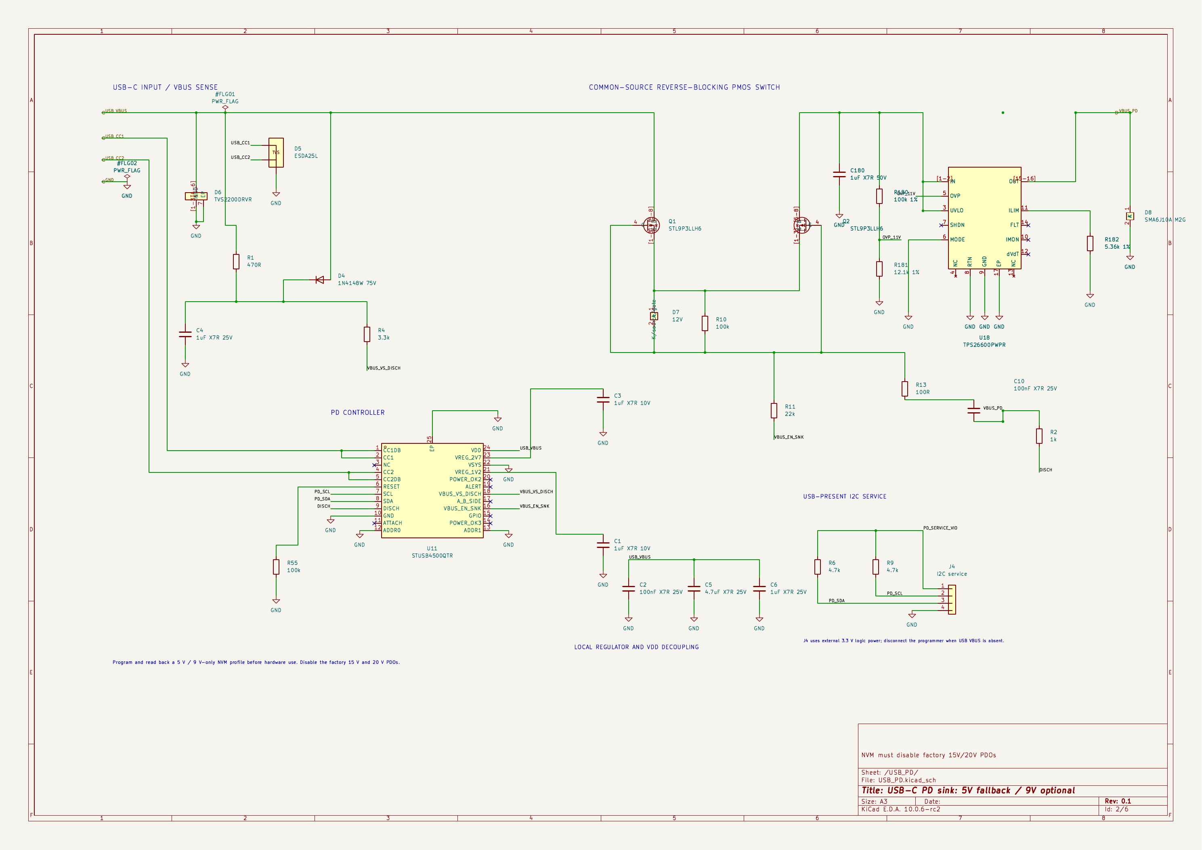
ai-files/reports/pd-ovp-page2.png
