chithigun23/DesktopSpeaker/ai-files/reports/power-model-alignment.png

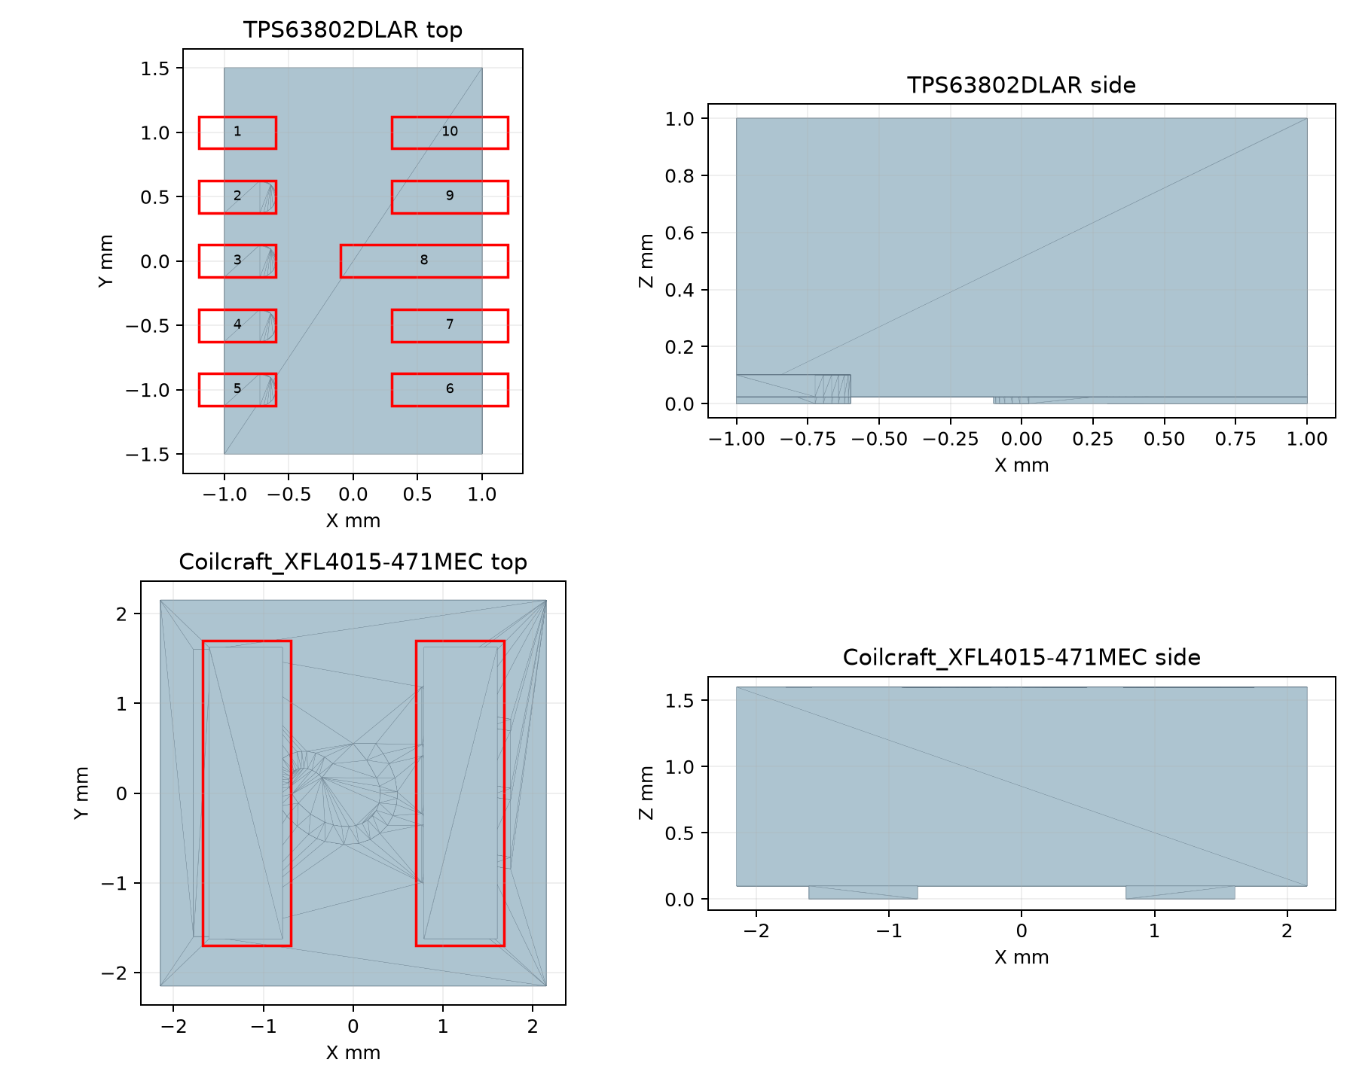
ai-files/reports/power-model-alignment.png
