chithigun23/DesktopSpeaker/ai-files/reports/review-2026-11-03/driver_screw_L1_L2_access_section.png

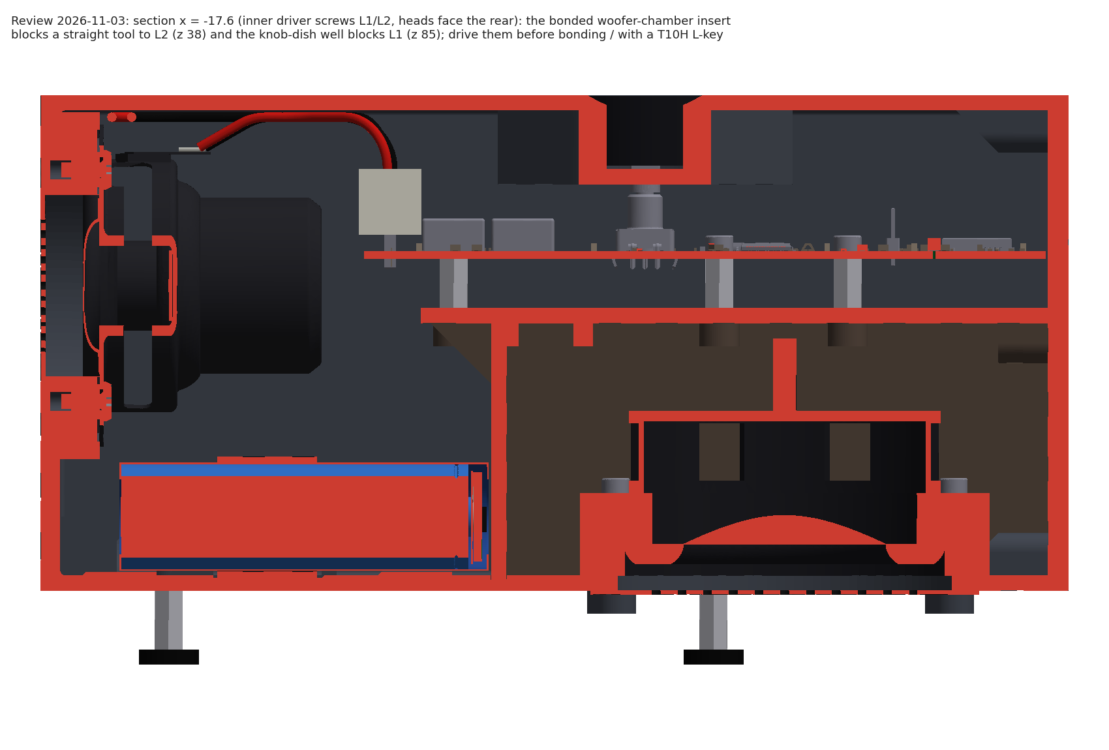
ai-files/reports/review-2026-11-03/driver_screw_L1_L2_access_section.png
