chithigun23/DesktopSpeaker/ai-files/reports/review-2026-11-03/encoder_dish_section.png

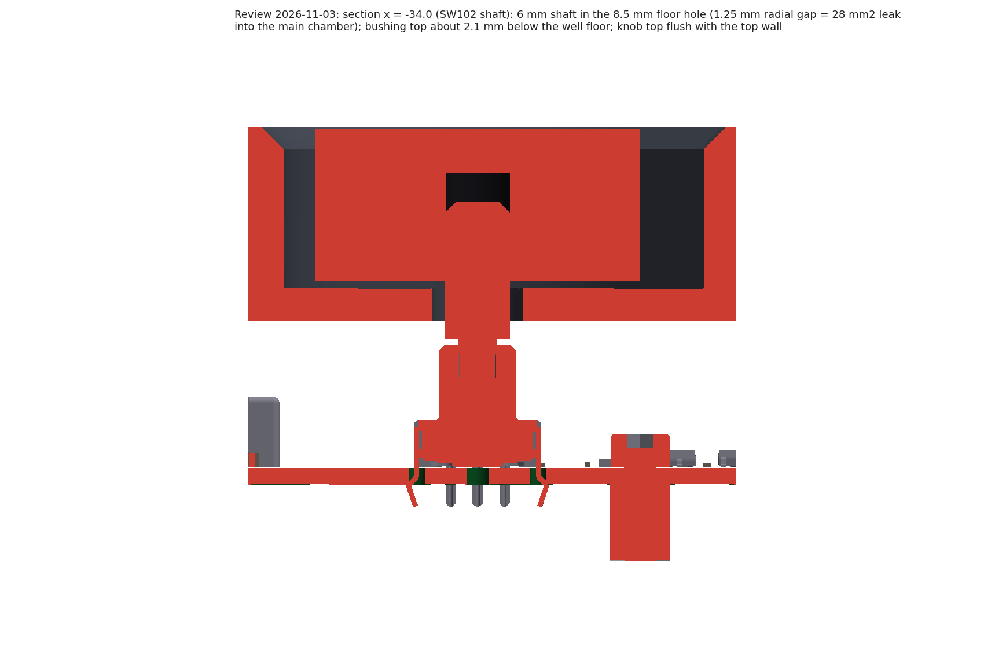
ai-files/reports/review-2026-11-03/encoder_dish_section.png
