chithigun23/DesktopSpeaker/ai-files/reports/review-2026-11-03/jack_J2_recess_section.png

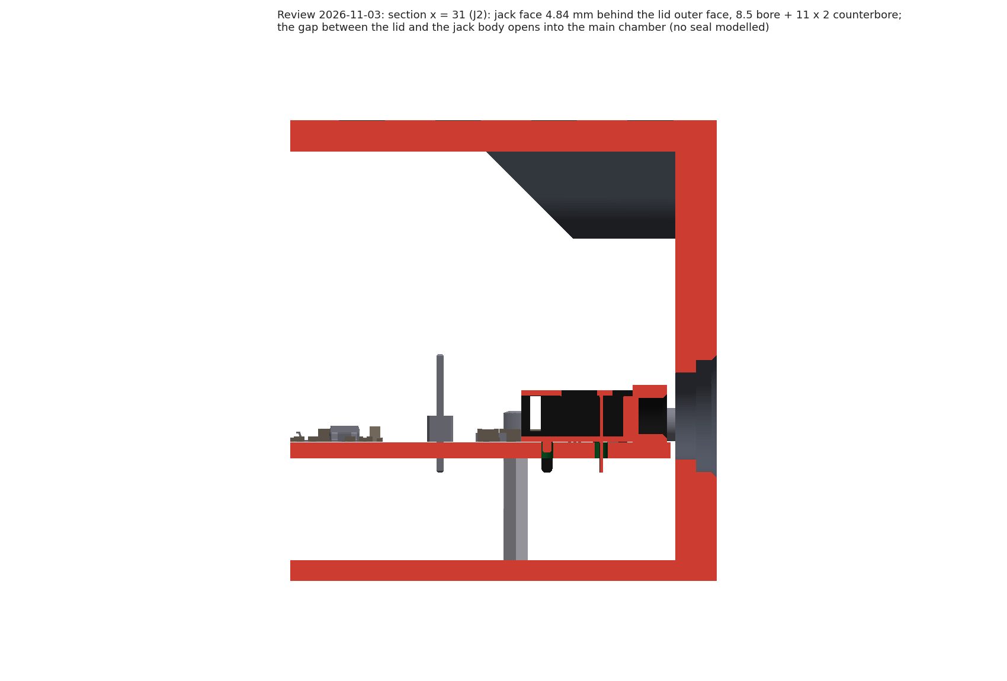
ai-files/reports/review-2026-11-03/jack_J2_recess_section.png
