chithigun23/DesktopSpeaker/ai-files/reports/review-active-gauge-2026-10-05.png

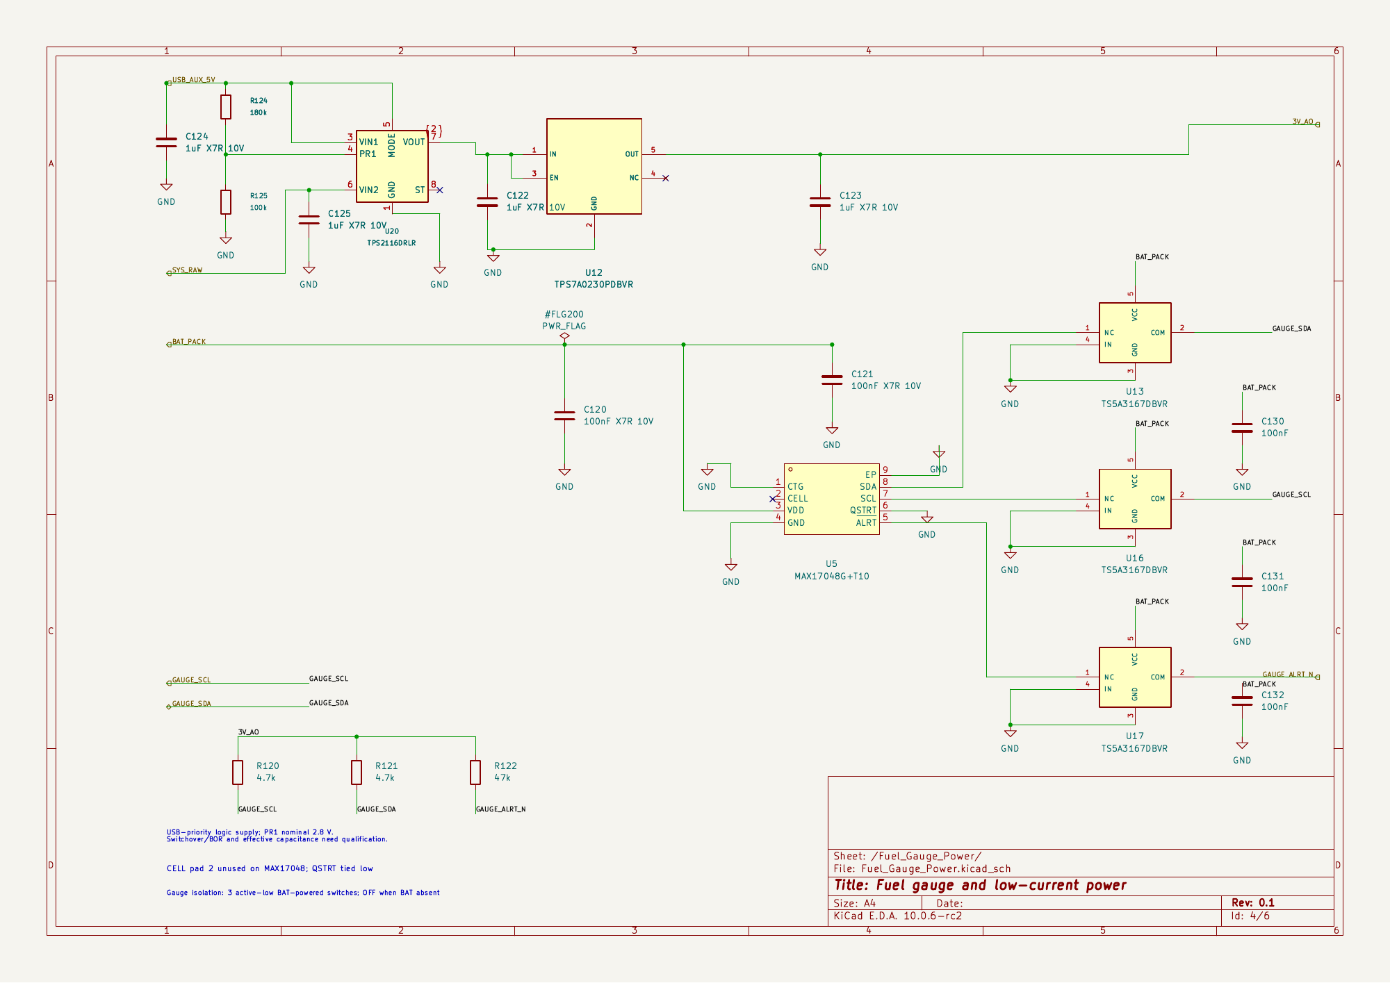
ai-files/reports/review-active-gauge-2026-10-05.png
