chithigun23/DesktopSpeaker/ai-files/reports/tps2116-ti-render/page-20.png

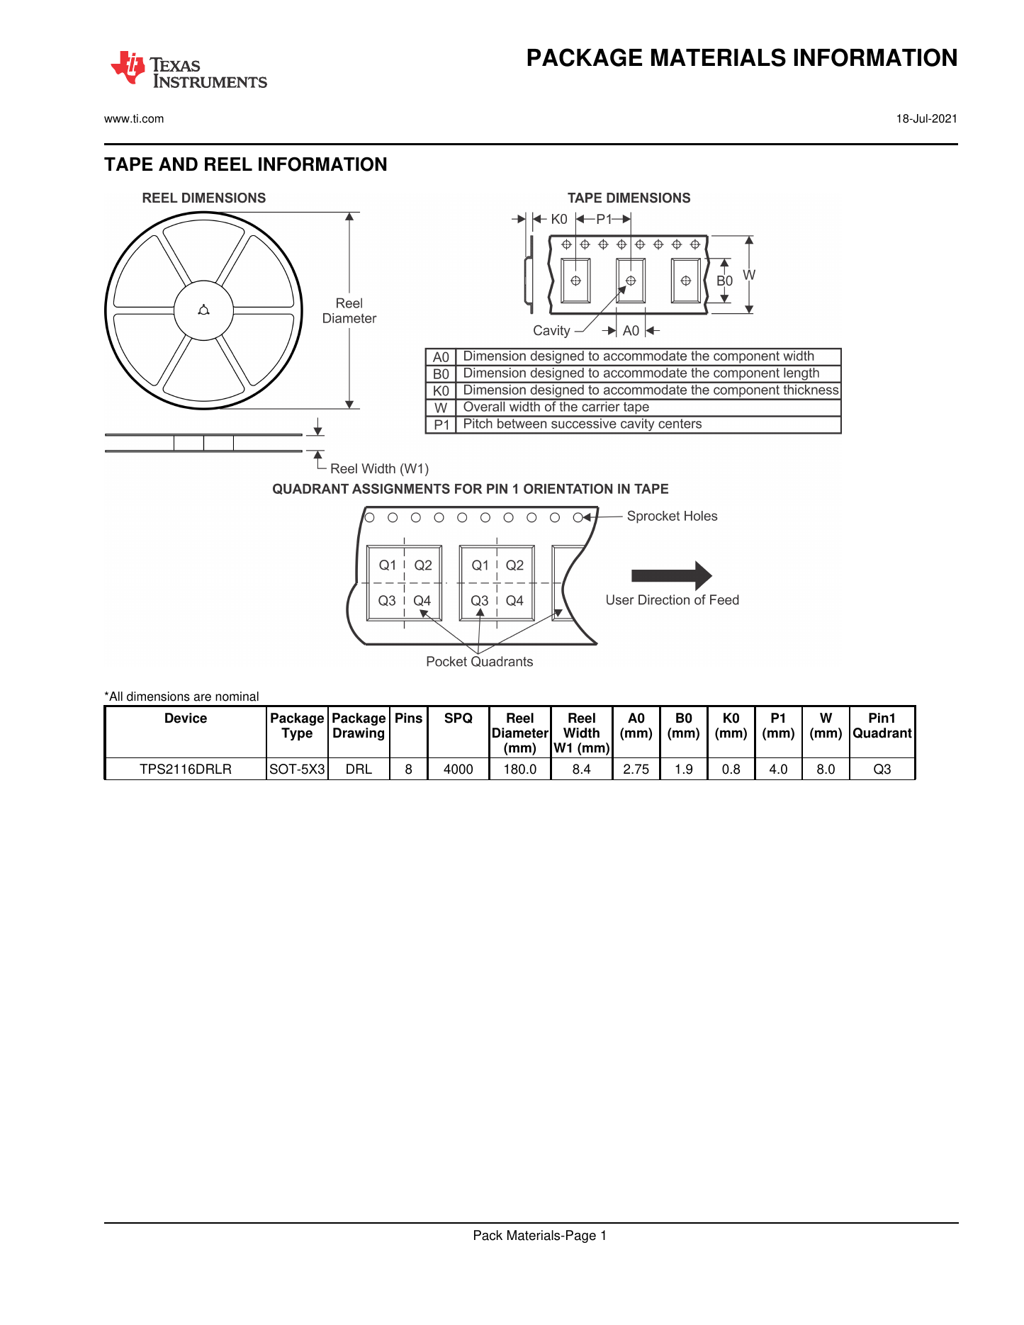
ai-files/reports/tps2116-ti-render/page-20.png
