chithigun23/DesktopSpeaker/ai-files/reports/tps2116-ti-render/page-21.png

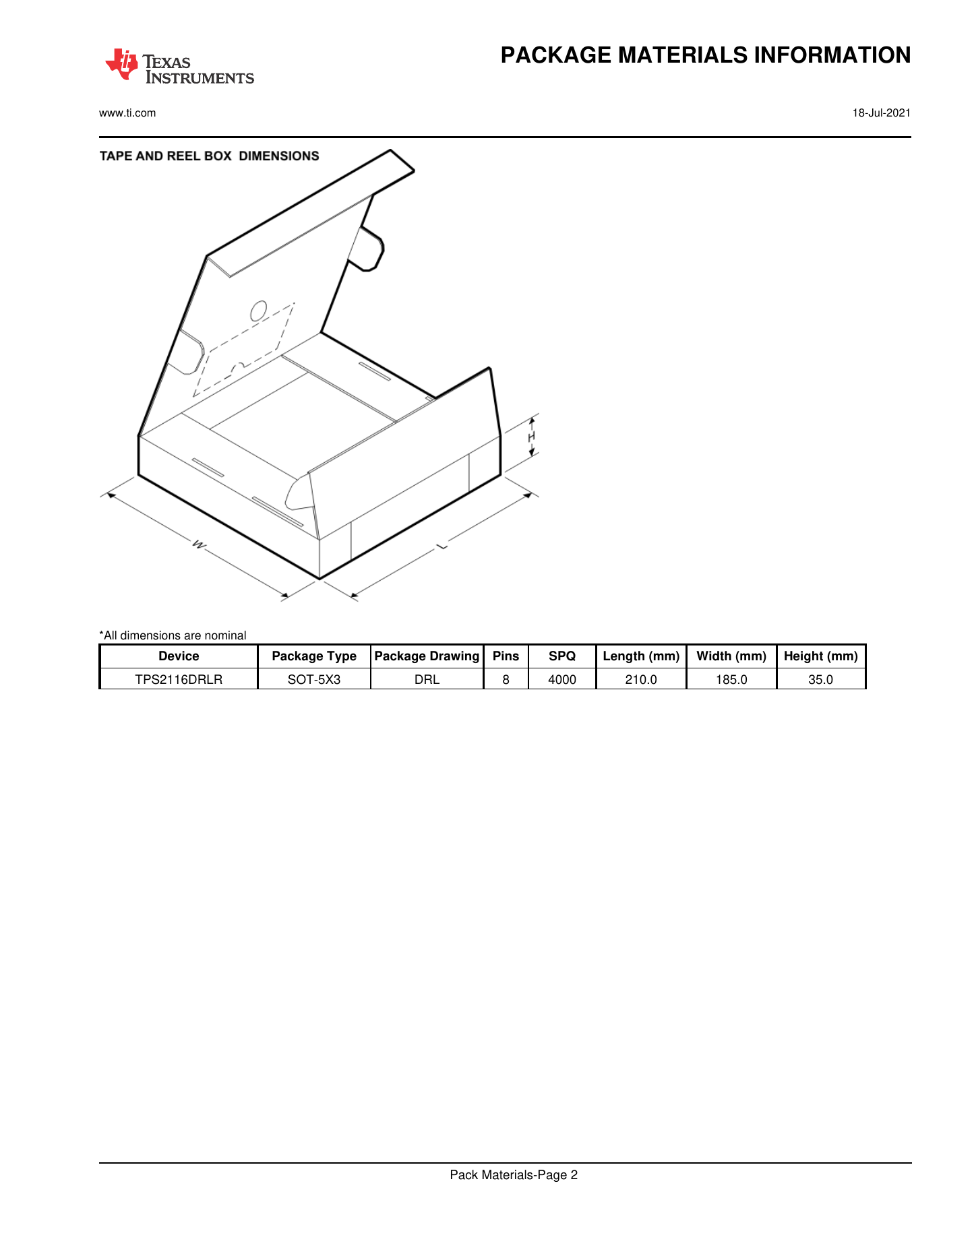
ai-files/reports/tps2116-ti-render/page-21.png
