chithigun23/DesktopSpeaker/ai-files/reports/tps25730-capacitance-table.png

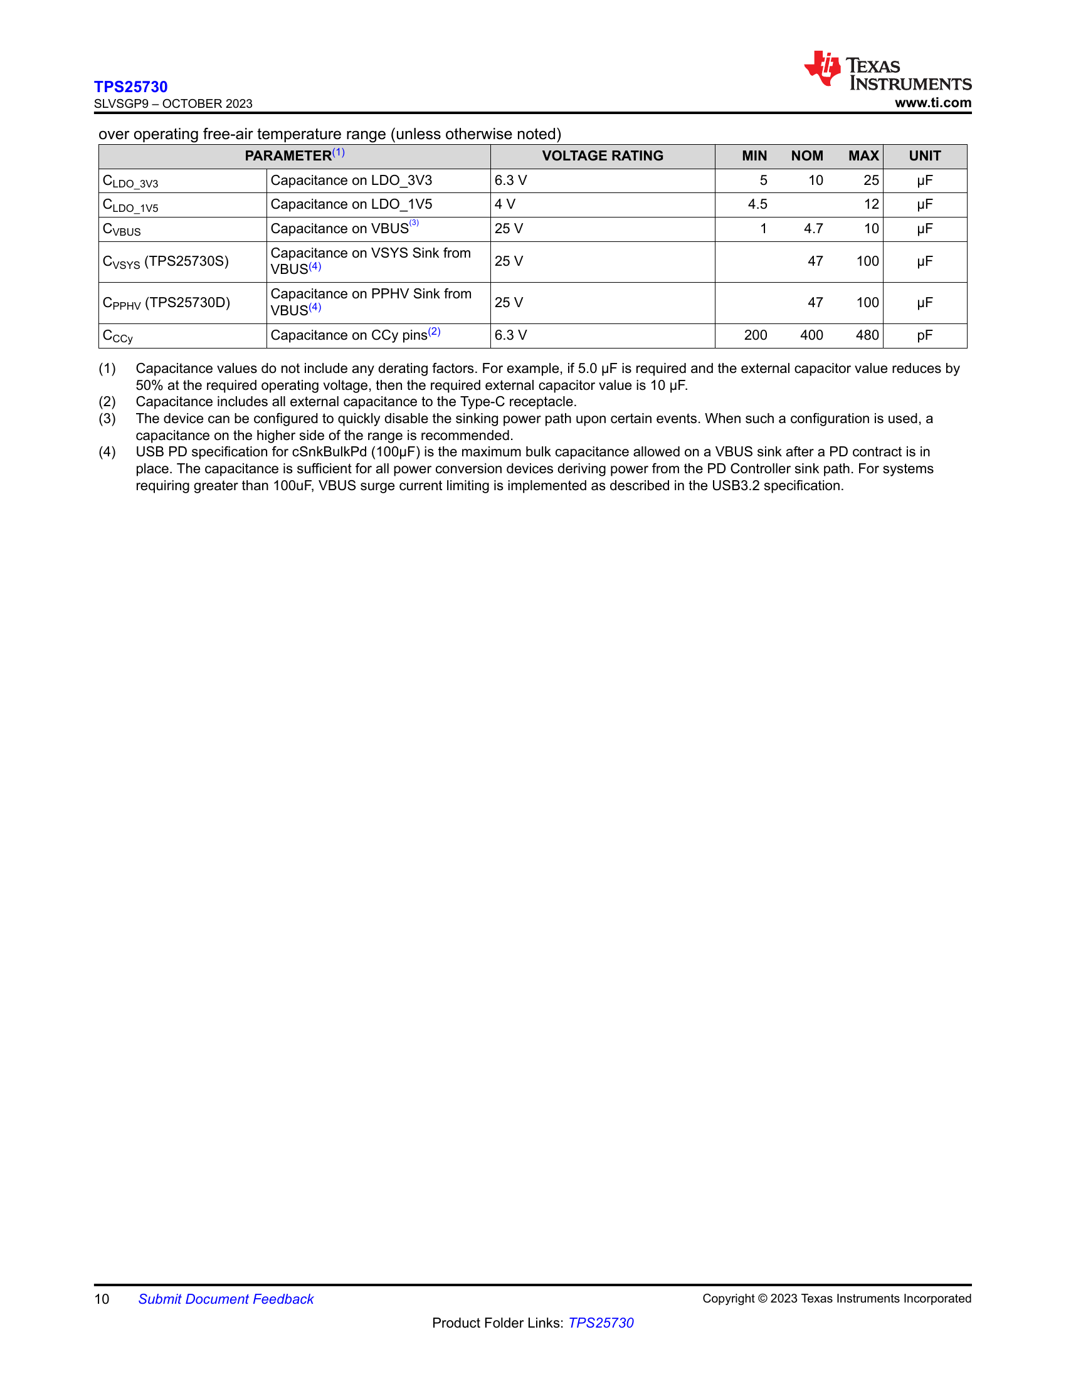
ai-files/reports/tps25730-capacitance-table.png
