chithigun23/DesktopSpeaker/ai-files/reports/tps25730d-first-review.png

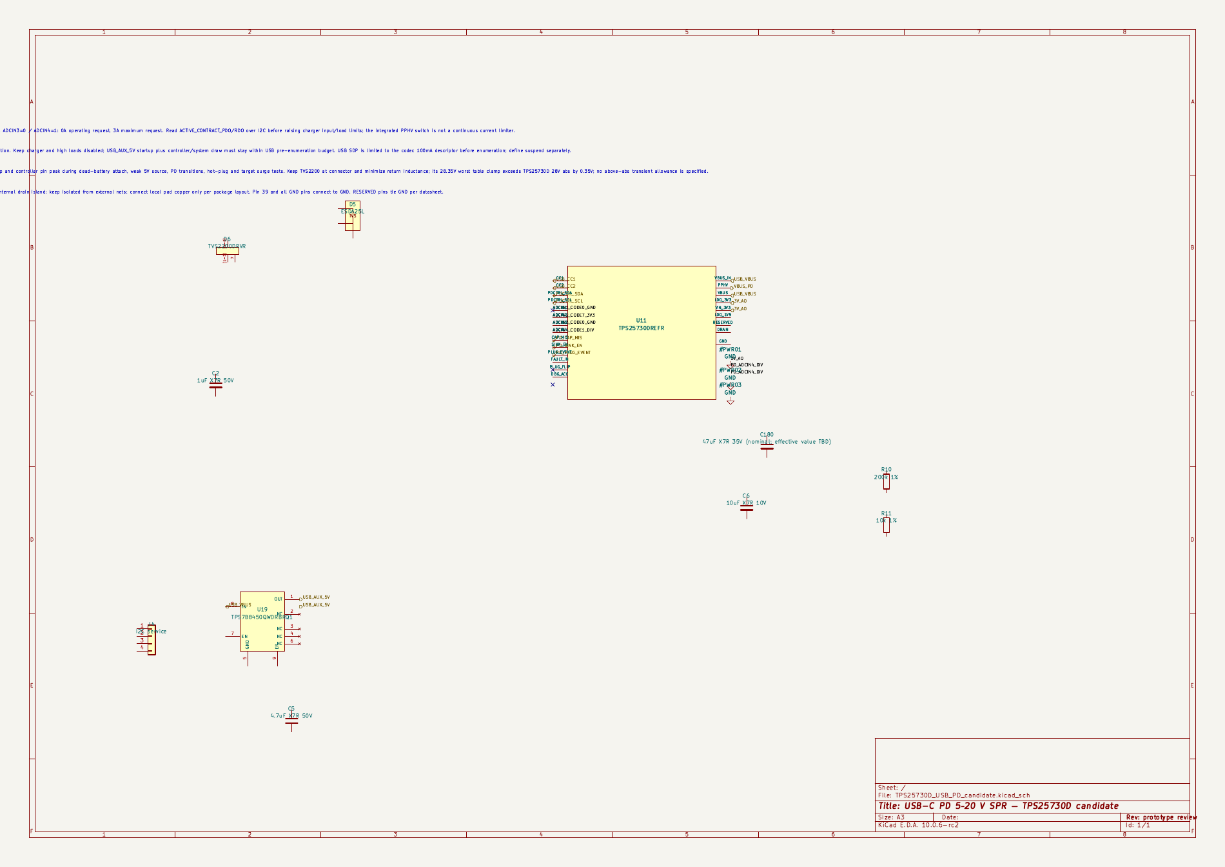
ai-files/reports/tps25730d-first-review.png
