chithigun23/DesktopSpeaker/ai-files/reports/TPS63802-board.png

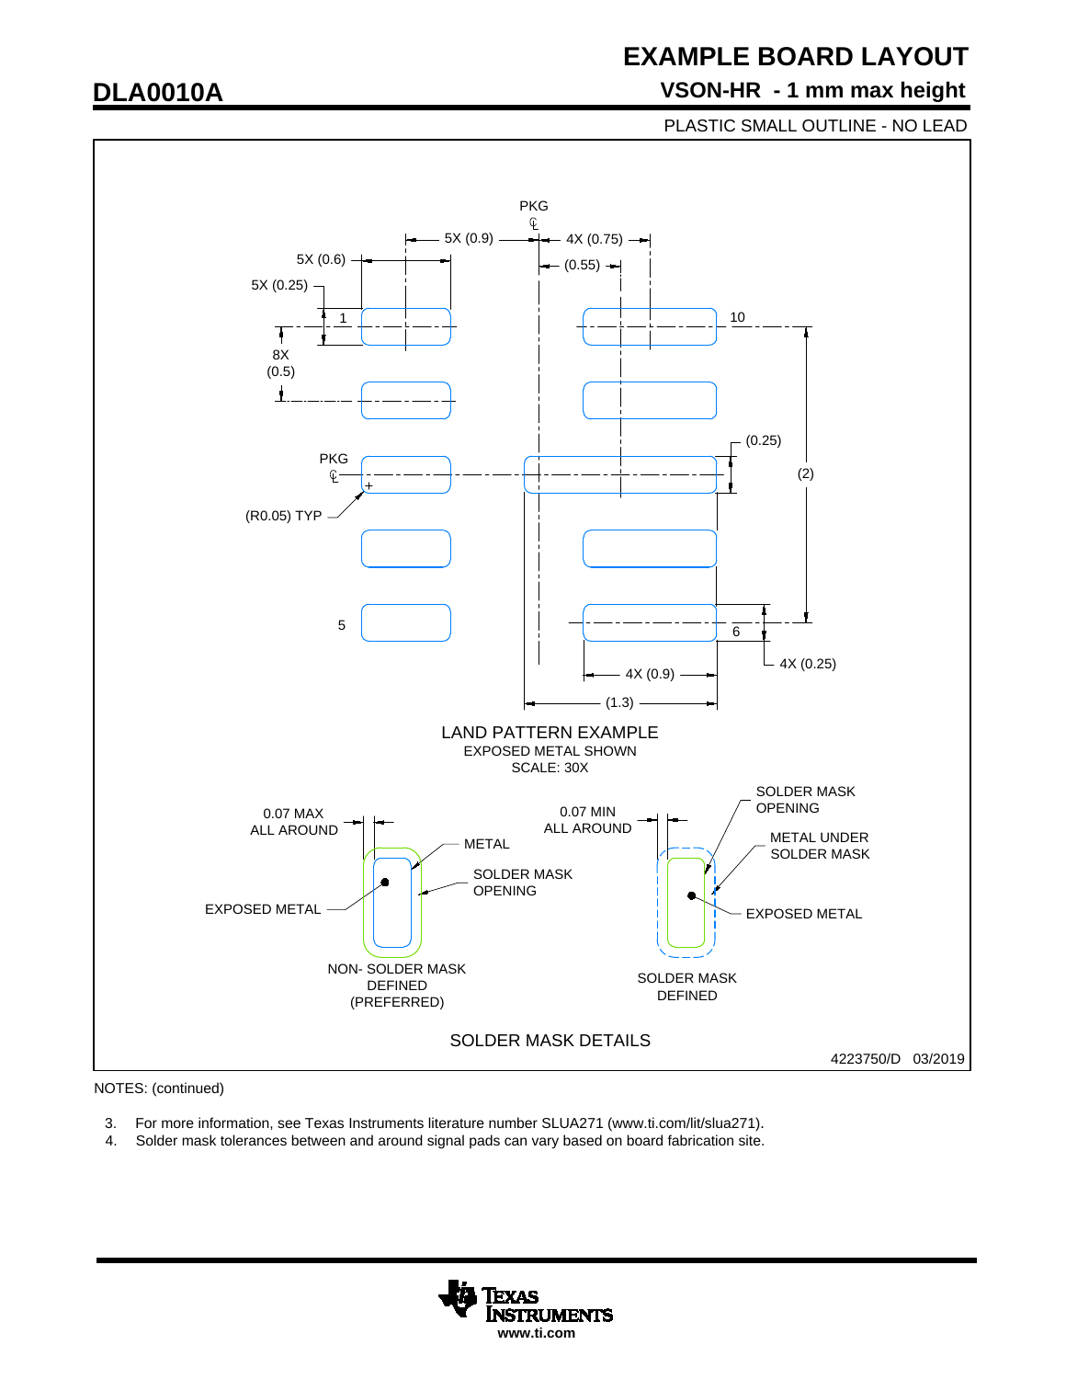
ai-files/reports/TPS63802-board.png
