chithigun23/DesktopSpeaker/ai-files/reports/TPS63802-land.png

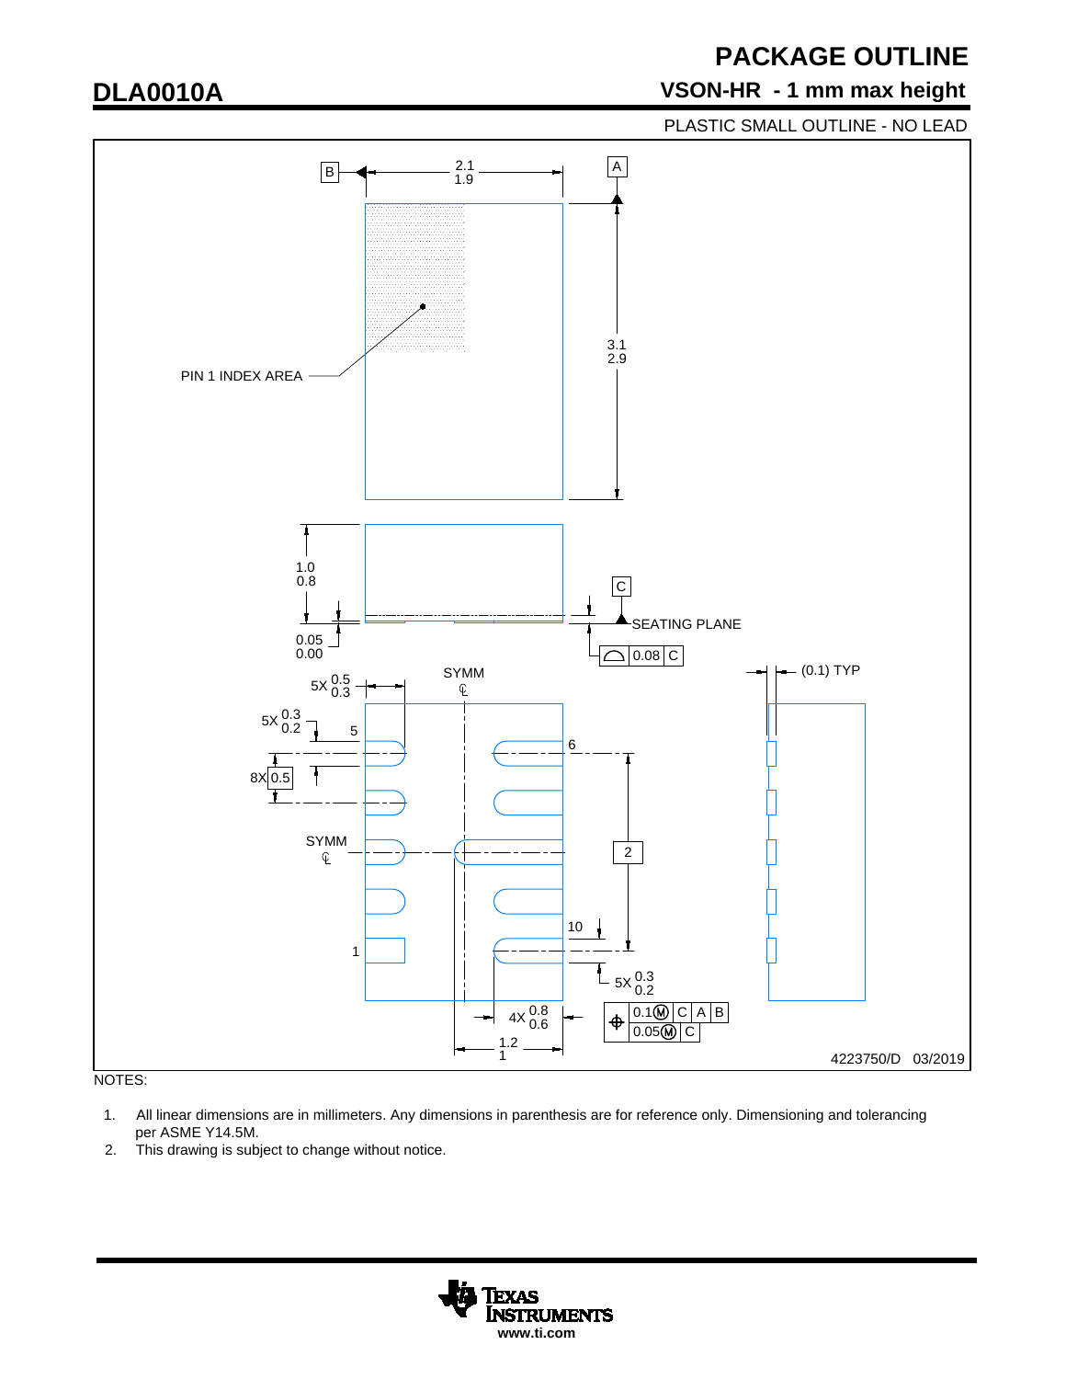
ai-files/reports/TPS63802-land.png
