chithigun23/DesktopSpeaker/ai-files/reports/u14-supply/after.png

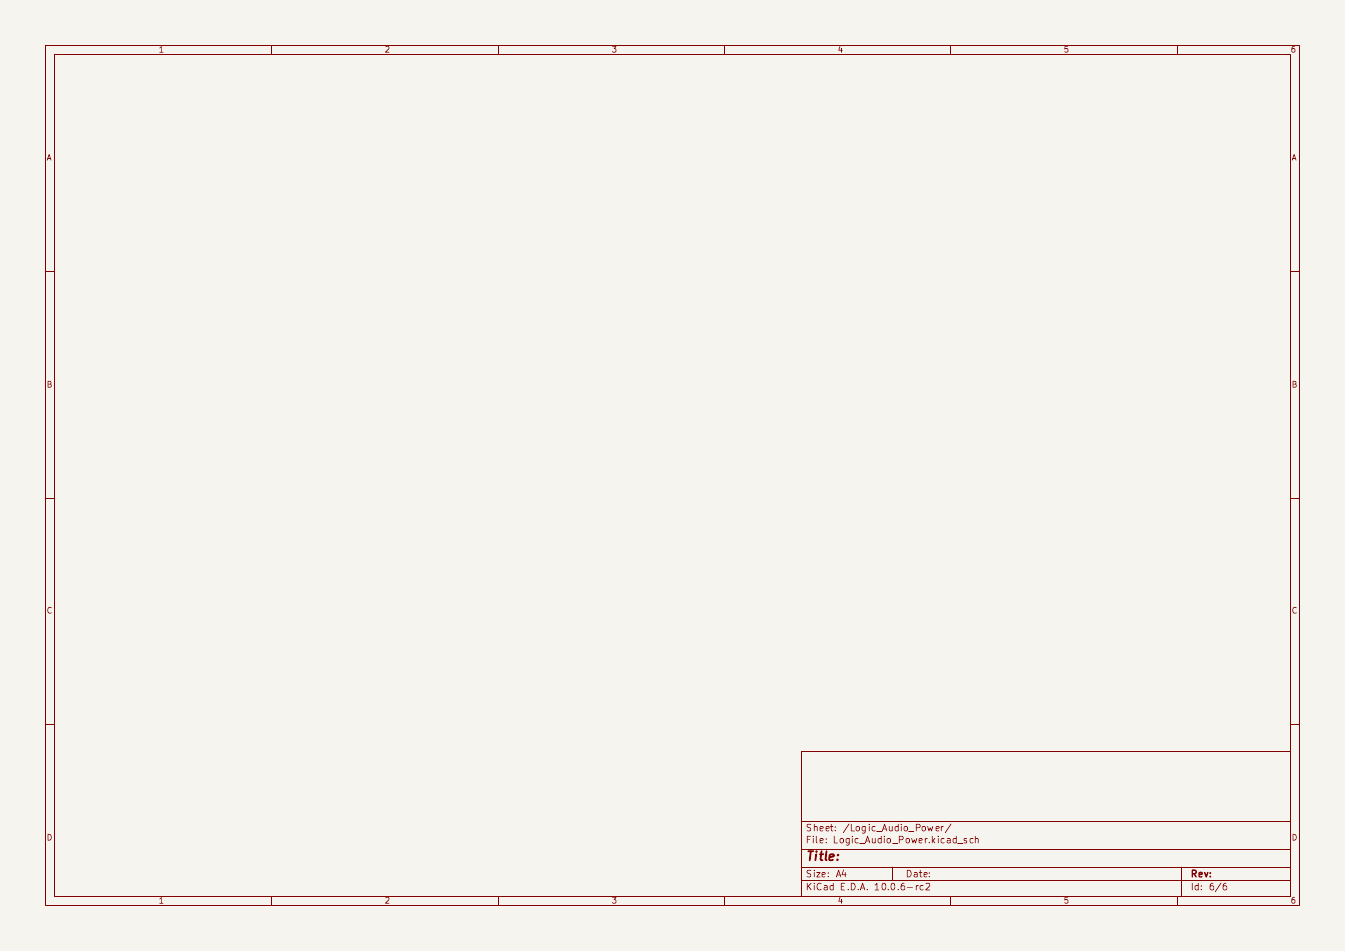
ai-files/reports/u14-supply/after.png
