chithigun23/DesktopSpeaker/ai-files/reports/u14-supply/logic.png

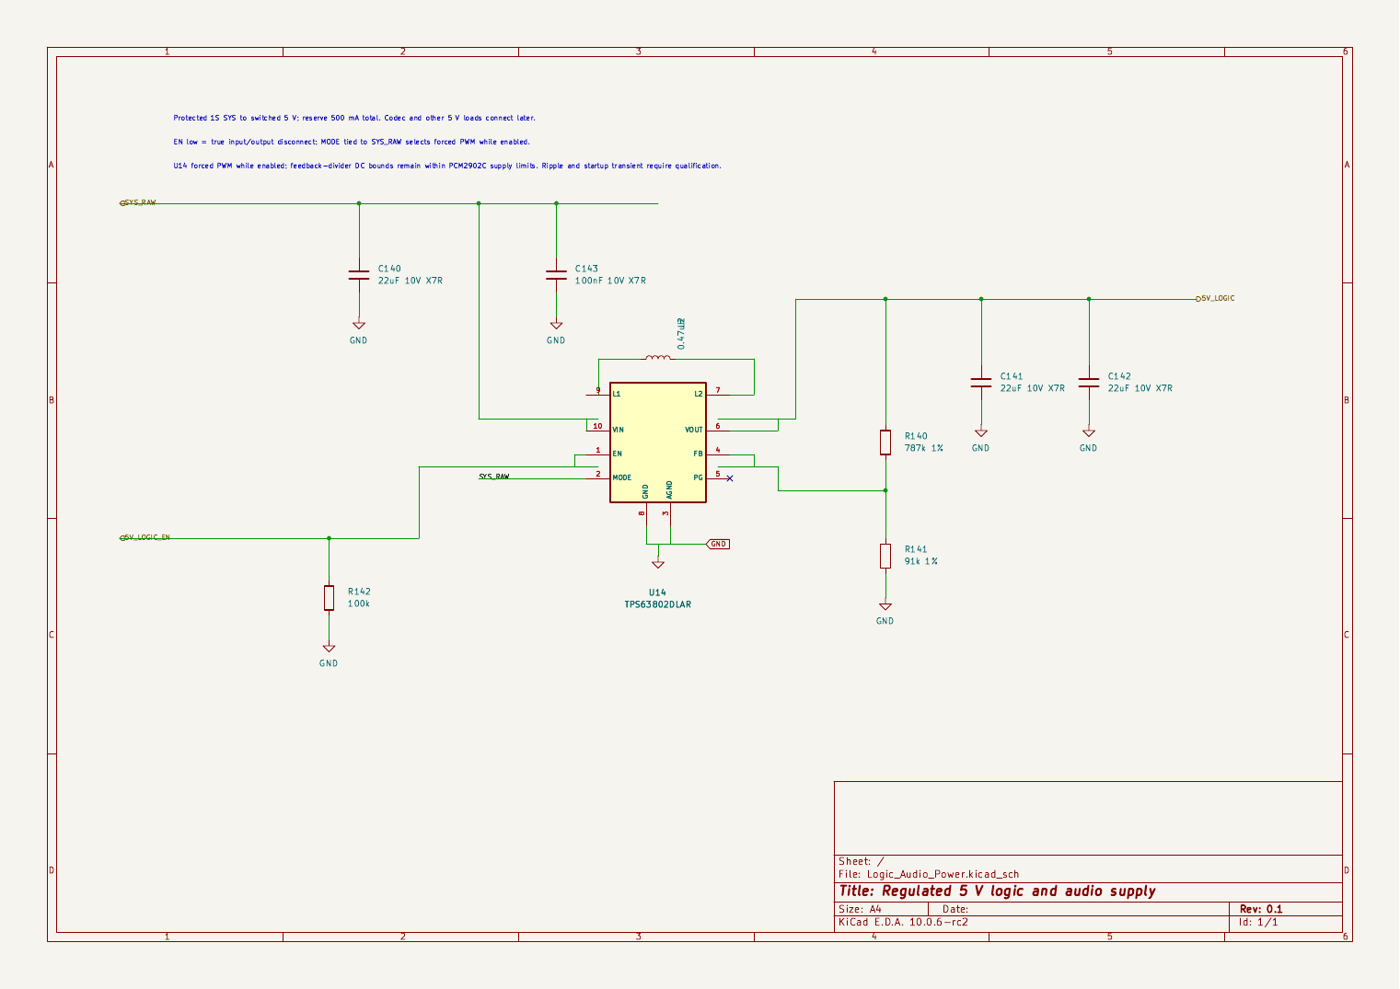
ai-files/reports/u14-supply/logic.png
