chithigun23/DesktopSpeaker/ai-files/reports/usb-aux-pd-review.png

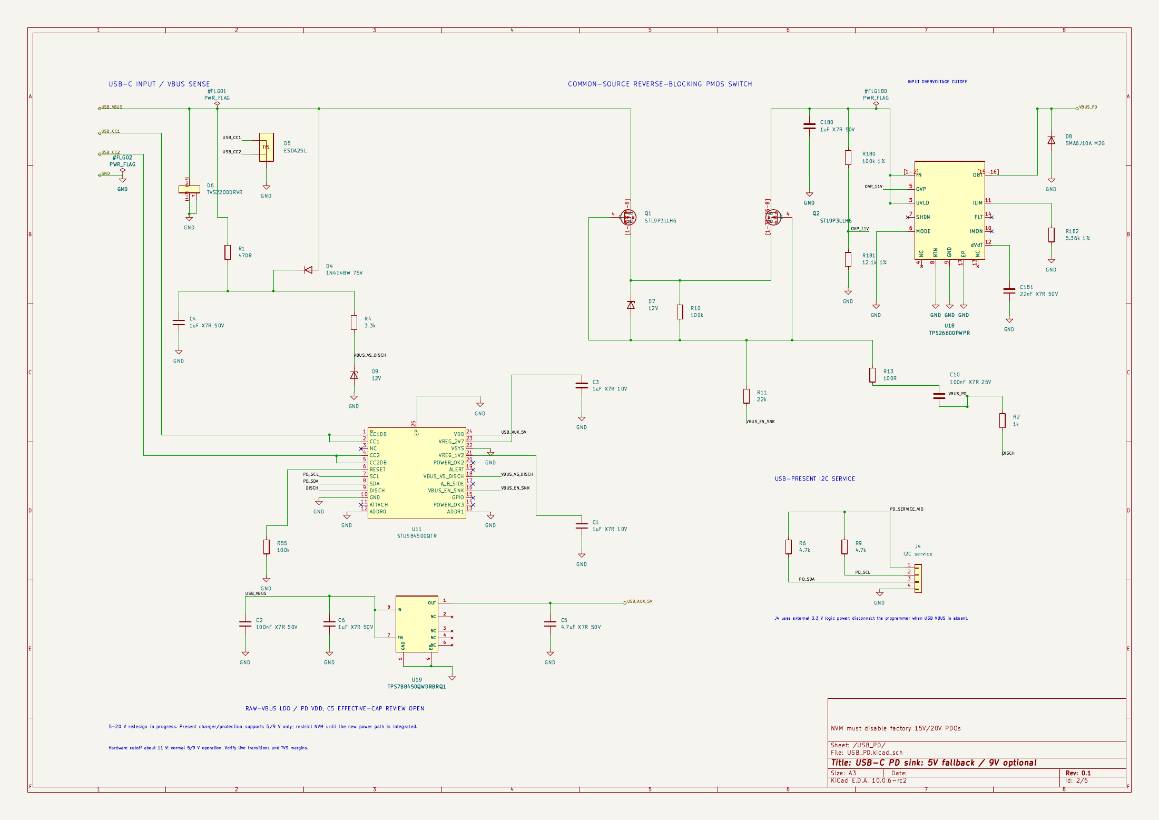
ai-files/reports/usb-aux-pd-review.png
