chithigun23/DesktopSpeaker/ai-files/reports/vdd-ldo-open-selections.png

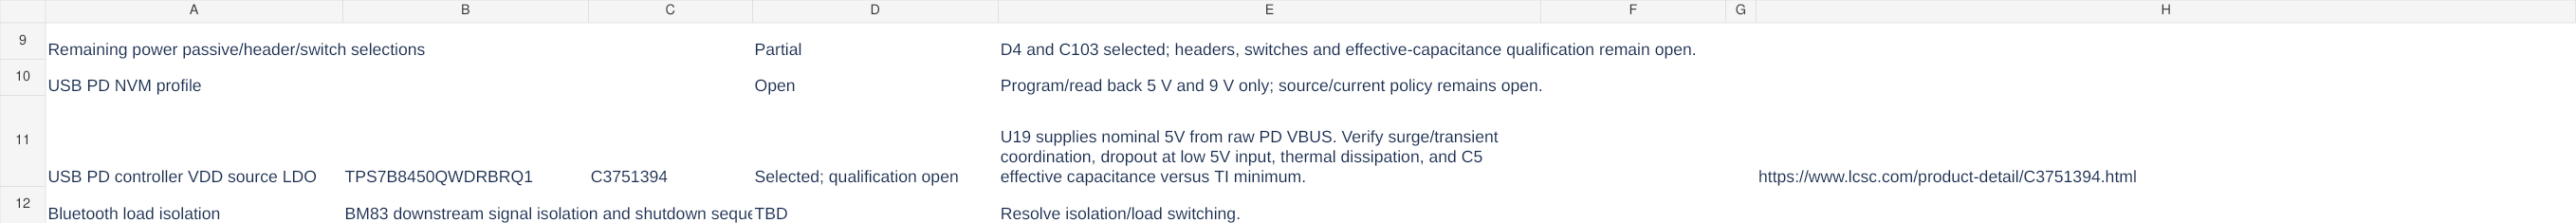
ai-files/reports/vdd-ldo-open-selections.png
