chithigun23/DesktopSpeaker/ai-files/reports/vdd-ldo-preview.png

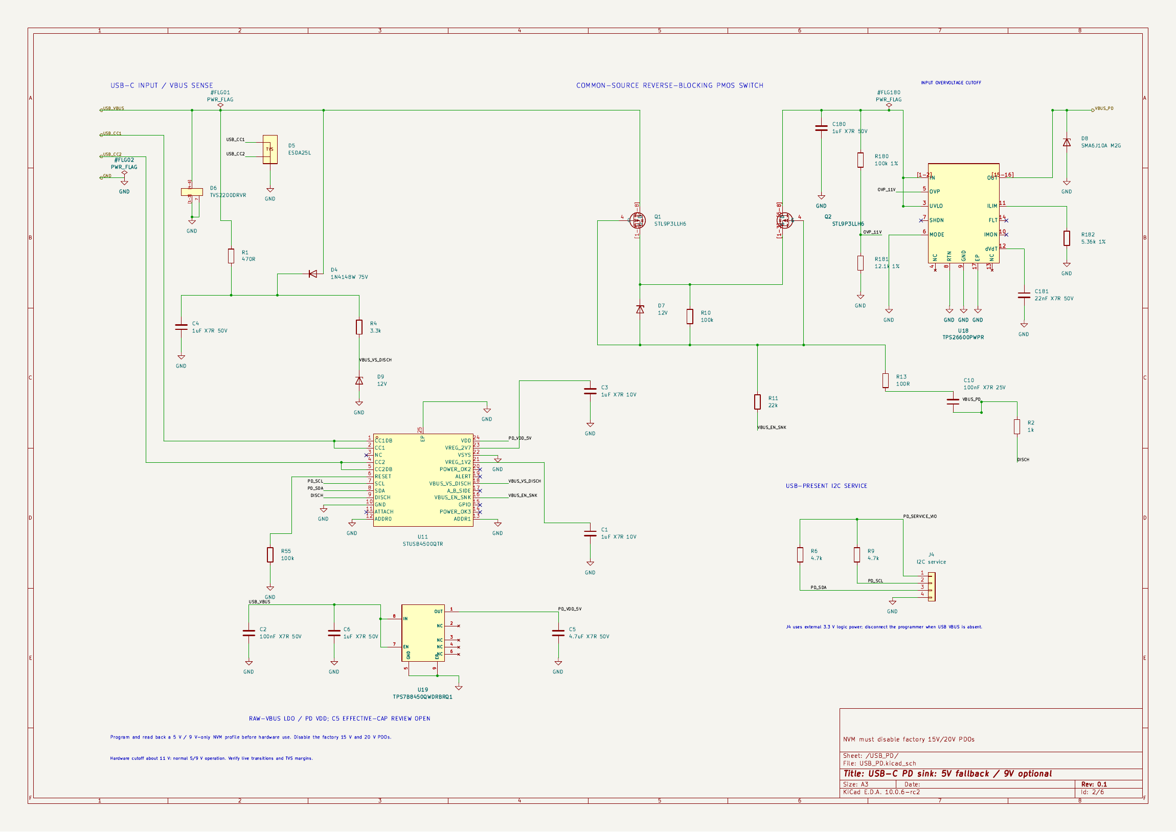
ai-files/reports/vdd-ldo-preview.png
