chithigun23/DesktopSpeaker/ai-files/reports/web-viewer-realism-2026-11-03/after_full_iso_dark.jpg

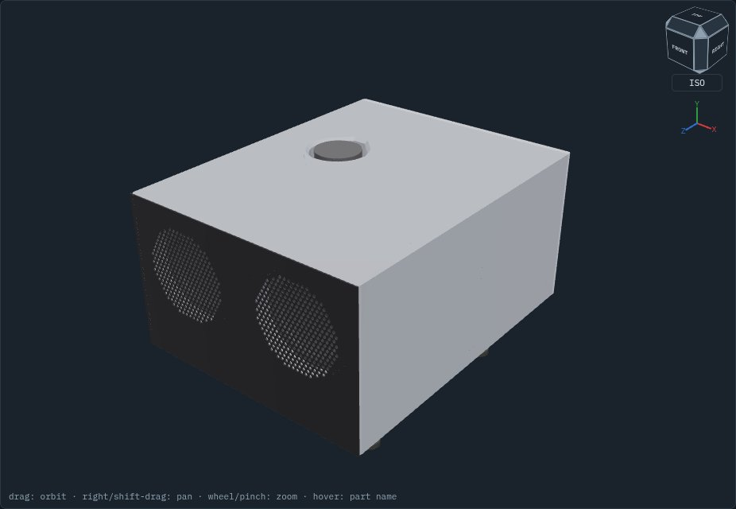
ai-files/reports/web-viewer-realism-2026-11-03/after_full_iso_dark.jpg
