chithigun23/DesktopSpeaker/ai-files/reports/web-viewer-realism-2026-11-03/after_pcb_top.jpg

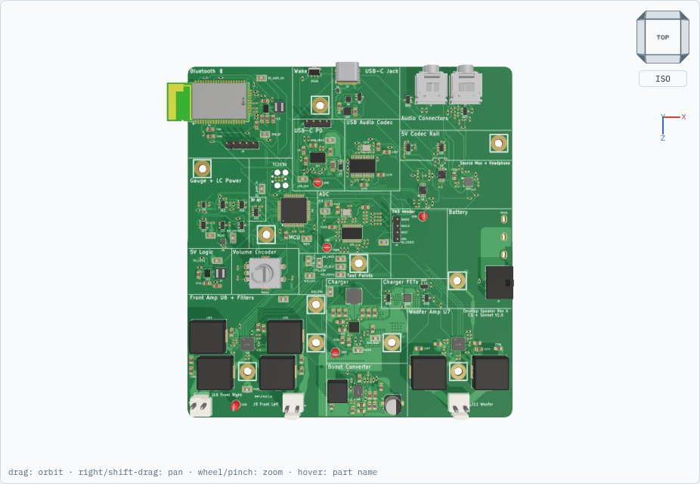
ai-files/reports/web-viewer-realism-2026-11-03/after_pcb_top.jpg
