chithigun23/DesktopSpeaker/ai-files/reports/web-viewer-realism-2026-11-03/before_after_bottom_mcu_amp.jpg

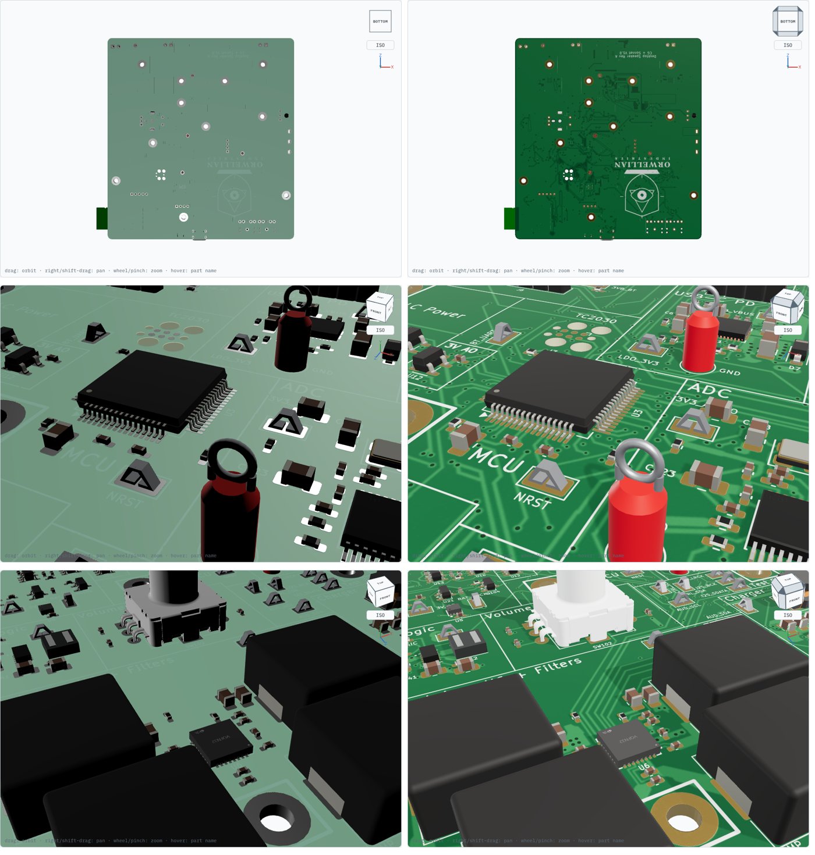
ai-files/reports/web-viewer-realism-2026-11-03/before_after_bottom_mcu_amp.jpg
