chithigun23/DesktopSpeaker/ai-files/reports/web-viewer-realism-2026-11-03/before_after_enclosure_iso.jpg

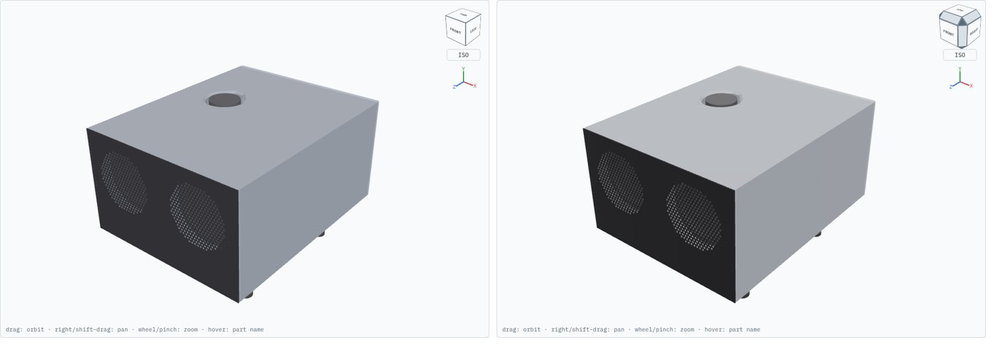
ai-files/reports/web-viewer-realism-2026-11-03/before_after_enclosure_iso.jpg
