chithigun23/DesktopSpeaker/ai-files/reports/web-viewer-realism-2026-11-03/before_after_full_top_oblique.jpg

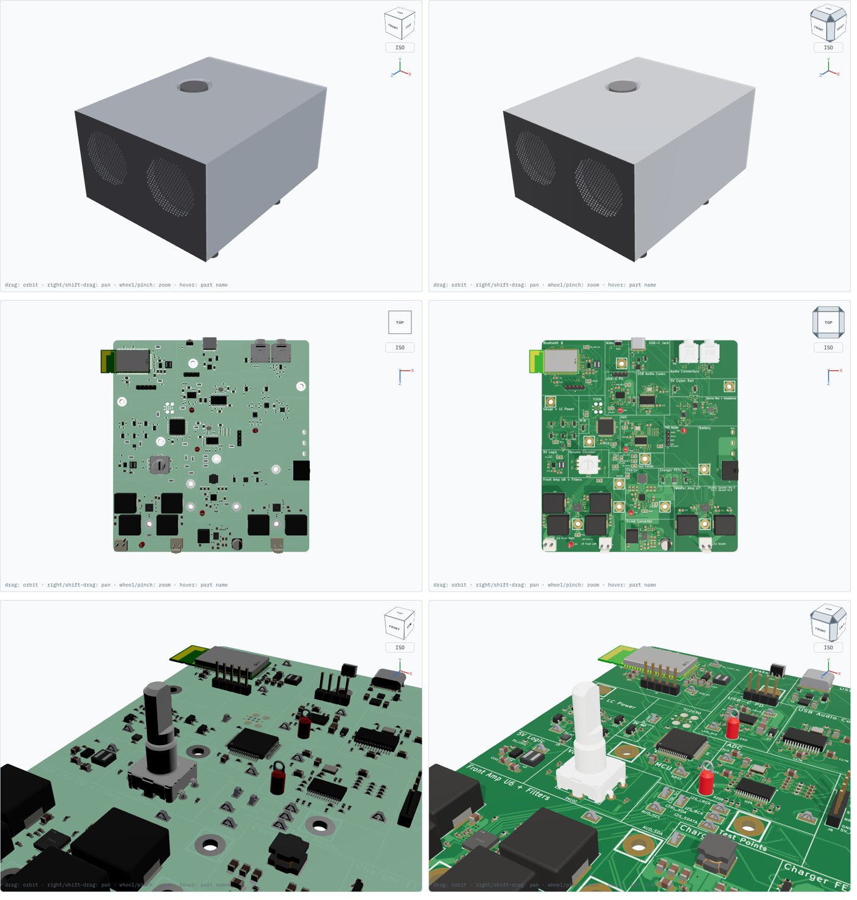
ai-files/reports/web-viewer-realism-2026-11-03/before_after_full_top_oblique.jpg
