chithigun23/DesktopSpeaker/ai-files/reports/web-viewer-realism-2026-11-03/cube_hover_face_edge_corner_dark_tap.jpg

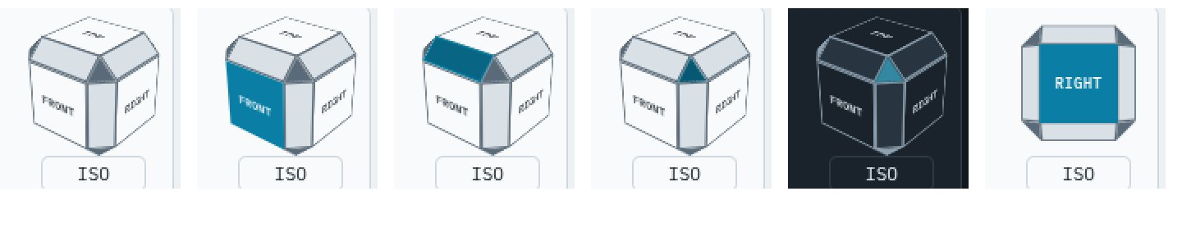
ai-files/reports/web-viewer-realism-2026-11-03/cube_hover_face_edge_corner_dark_tap.jpg
