chithigun23/DesktopSpeaker/ai-files/reports/web-viewer-realism-2026-11-03/cube_snapped_views.jpg

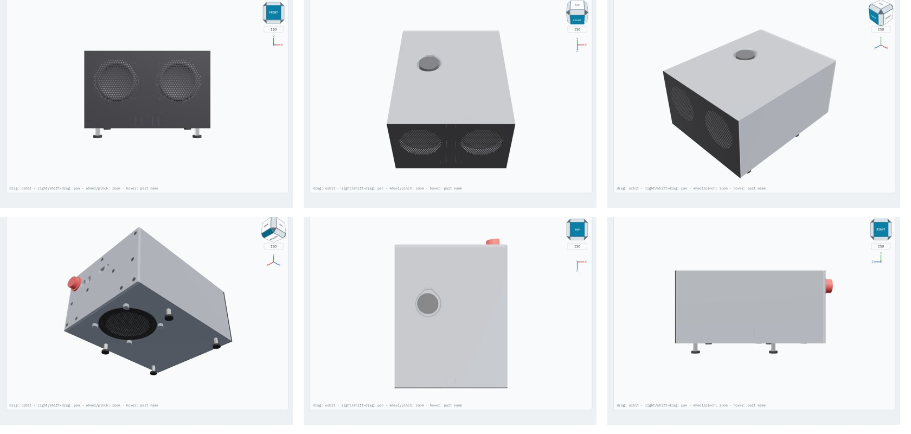
ai-files/reports/web-viewer-realism-2026-11-03/cube_snapped_views.jpg
