chithigun23/DesktopSpeaker/ai-files/reports/web-viewer-realism-2026-11-03/mobile_390px_light_dark.jpg

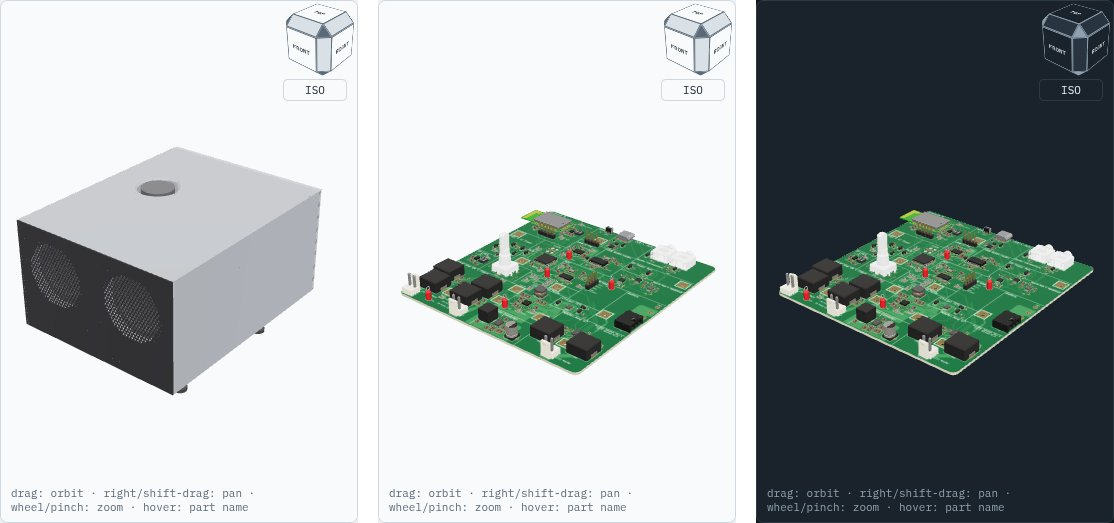
ai-files/reports/web-viewer-realism-2026-11-03/mobile_390px_light_dark.jpg
