chithigun23/DesktopSpeaker/ai-files/reports/website-build-evidence/nc-specs.png

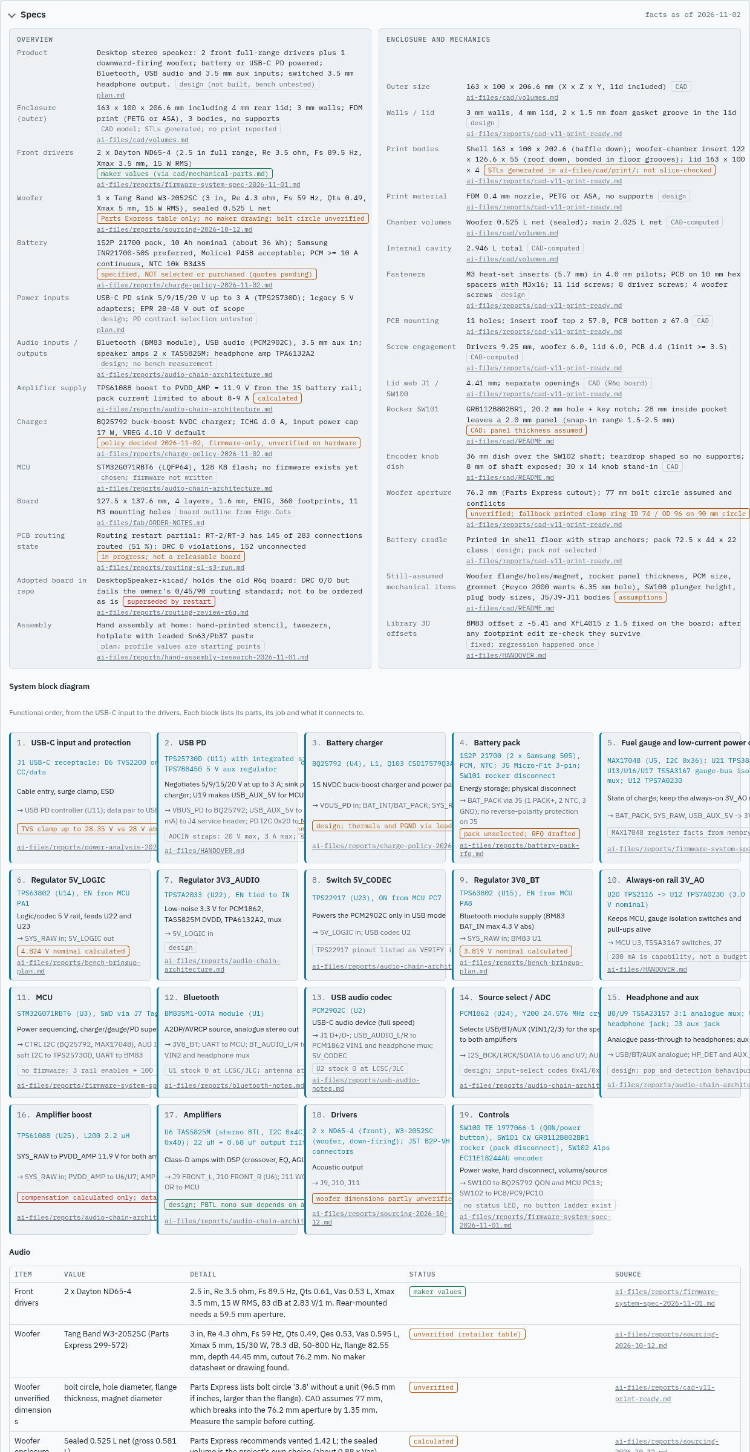
ai-files/reports/website-build-evidence/nc-specs.png
