chithigun23/DesktopSpeaker/ai-files/website/desktopSpeaker-site/cad/pcb_textures/bottom_rmb.jpg

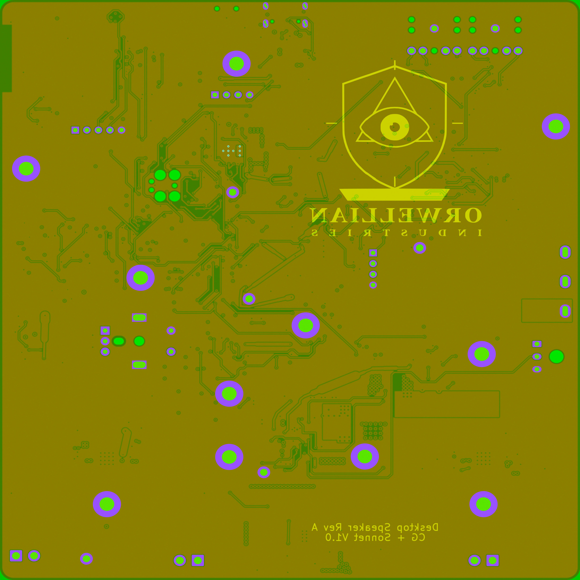
ai-files/website/desktopSpeaker-site/cad/pcb_textures/bottom_rmb.jpg
