chithigun23/DesktopSpeaker/ai-files/website/desktopSpeaker-site/cad/pcb_textures/top_albedo_2k.jpg

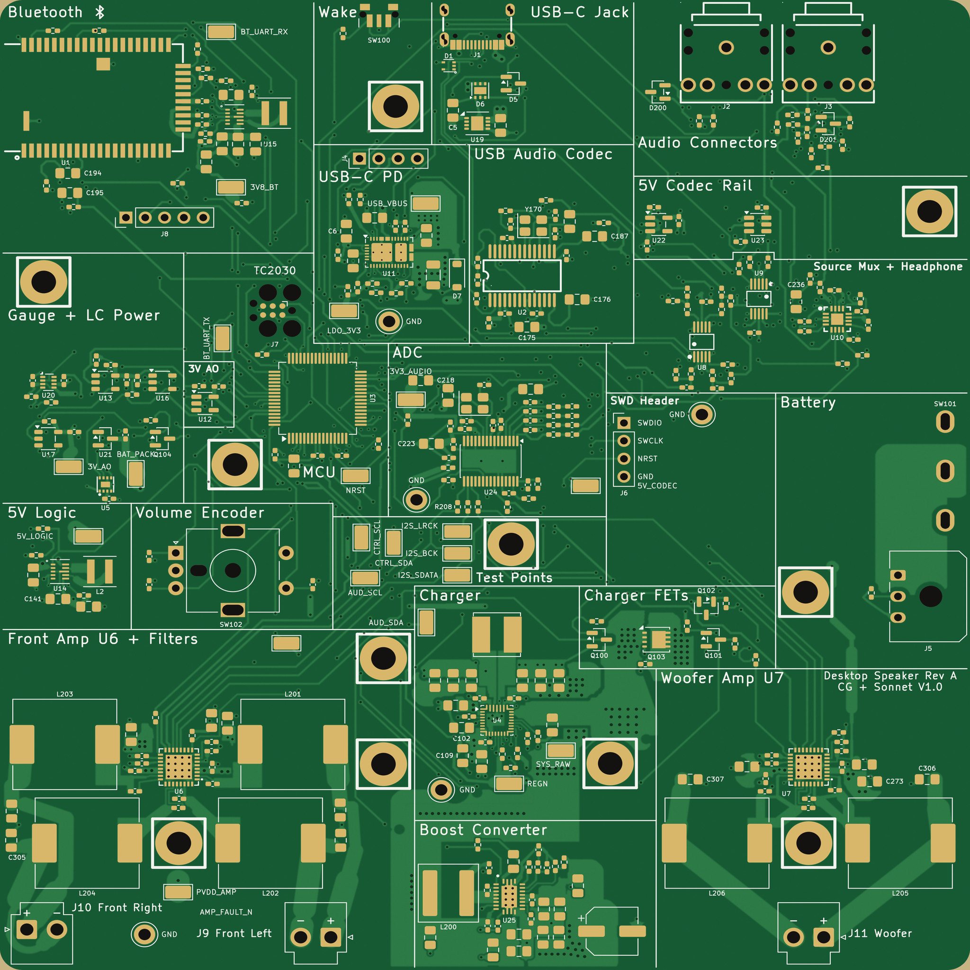
ai-files/website/desktopSpeaker-site/cad/pcb_textures/top_albedo_2k.jpg
