chithigun23/DesktopSpeaker/ai-files/website/desktopSpeaker-site/cad/pcb_textures/top_rmb.jpg

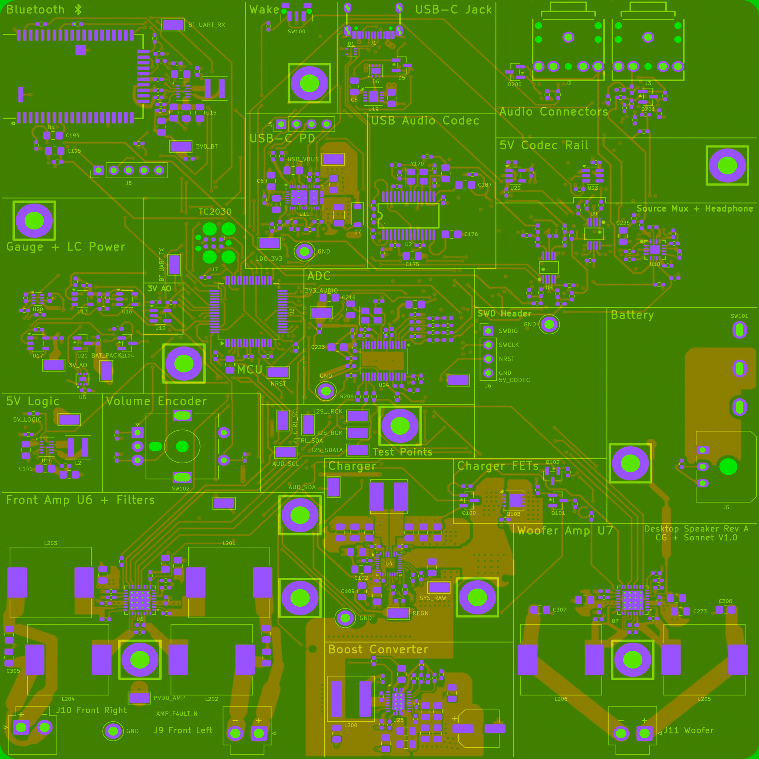
ai-files/website/desktopSpeaker-site/cad/pcb_textures/top_rmb.jpg
