chithigun23/DesktopSpeaker/ai-files/website/desktopSpeaker-site/cad/renders/exploded.png

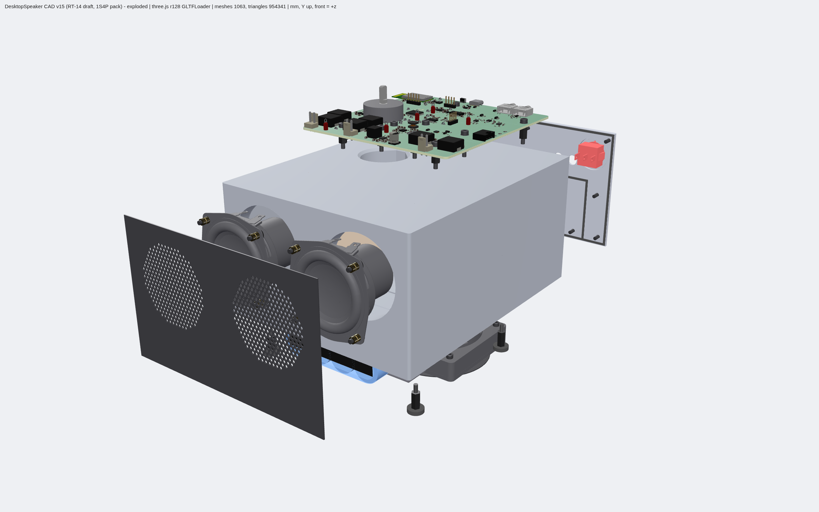
ai-files/website/desktopSpeaker-site/cad/renders/exploded.png
