chithigun23/DesktopSpeaker/ai-files/website/desktopSpeaker-site/cad/renders/front.png

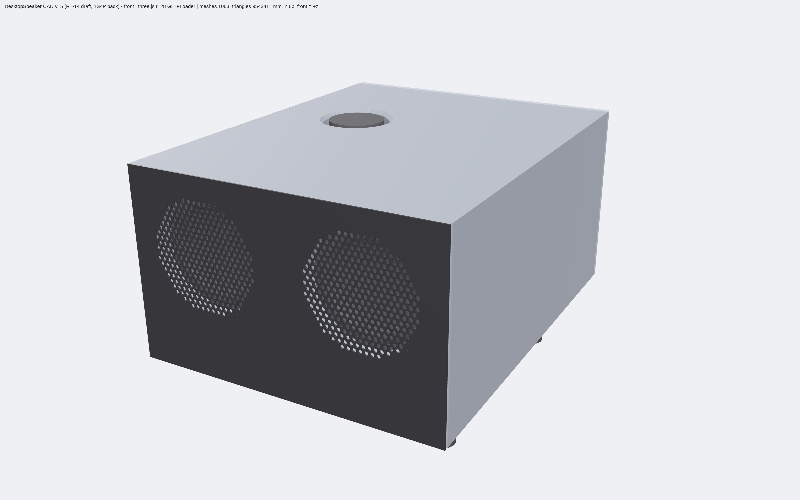
ai-files/website/desktopSpeaker-site/cad/renders/front.png
