chithigun23/DesktopSpeaker/ai-files/website/desktopSpeaker-site/cad/renders/open_top.png

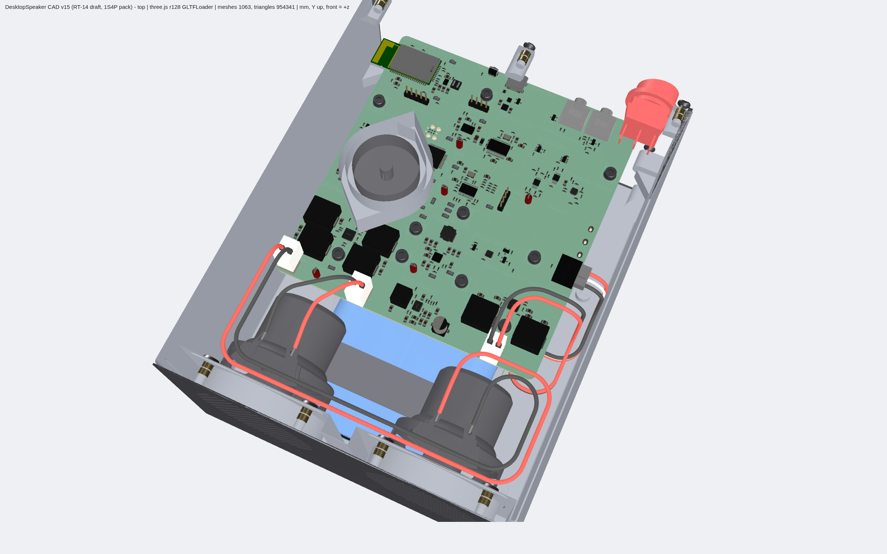
ai-files/website/desktopSpeaker-site/cad/renders/open_top.png
