chithigun23/DesktopSpeaker/ai-files/website/desktopSpeaker-site/cad/renders/pcb.png

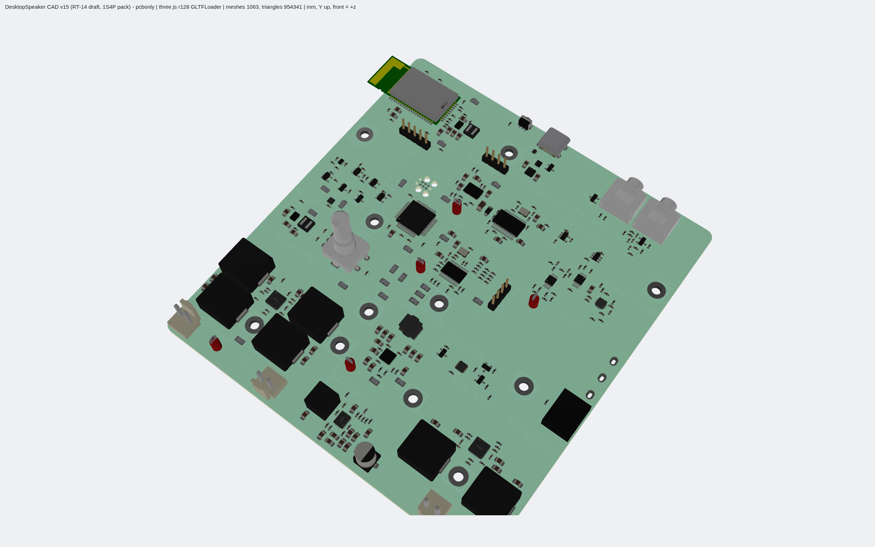
ai-files/website/desktopSpeaker-site/cad/renders/pcb.png
