chithigun23/DesktopSpeaker/ai-files/website/desktopSpeaker-site/cad/renders/pcb_real_iso.png

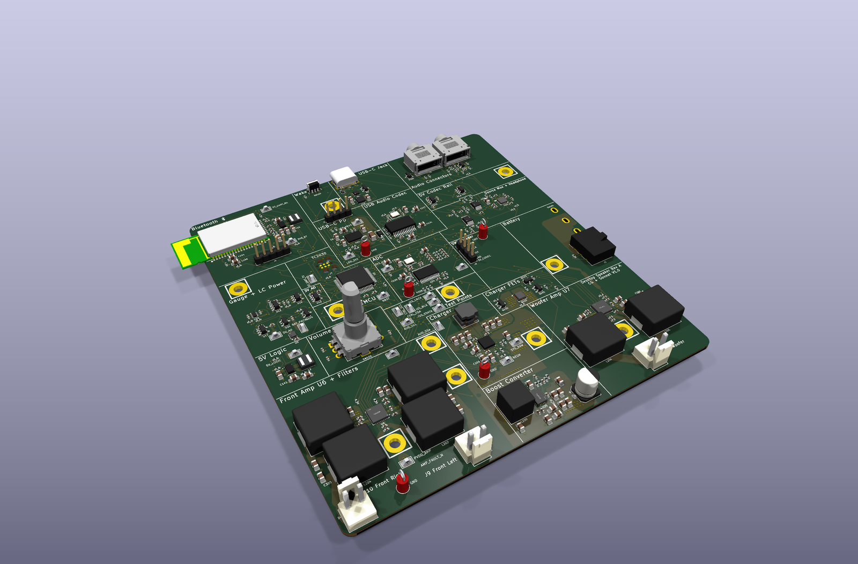
ai-files/website/desktopSpeaker-site/cad/renders/pcb_real_iso.png
