chithigun23/DesktopSpeaker/ai-files/website/desktopSpeaker-site/cad/renders/pcb_real_top.png

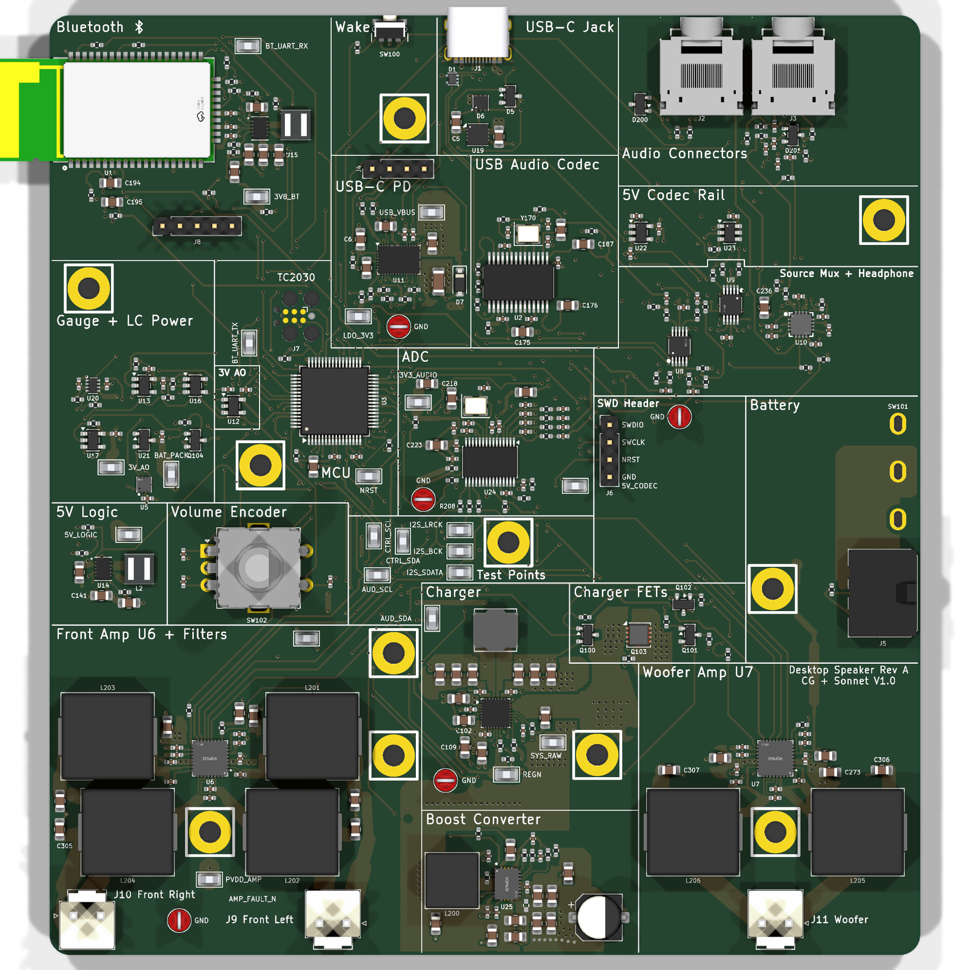
ai-files/website/desktopSpeaker-site/cad/renders/pcb_real_top.png
