chithigun23/DesktopSpeaker/ai-files/website/desktopSpeaker-site/cad/renders/rear.png

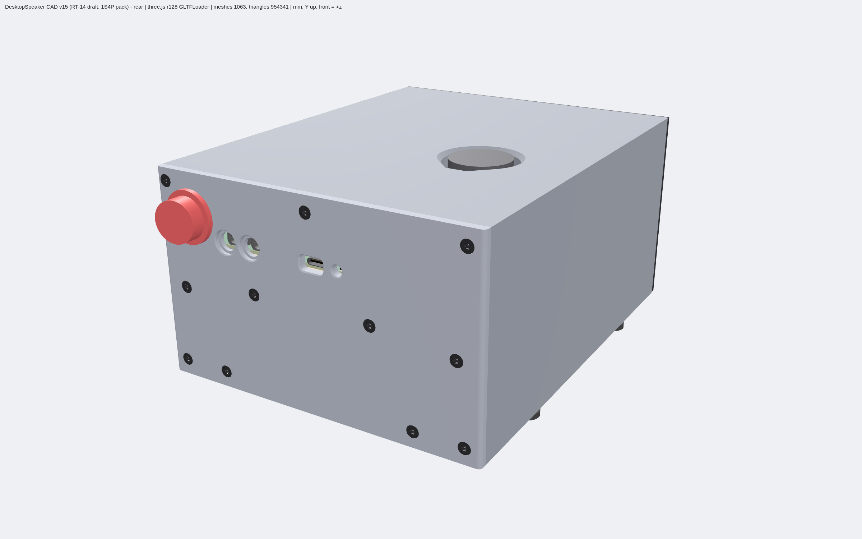
ai-files/website/desktopSpeaker-site/cad/renders/rear.png
