chithigun23/DesktopSpeaker/ai-files/website/desktopSpeaker-site/cad/renders/section_woofer.png

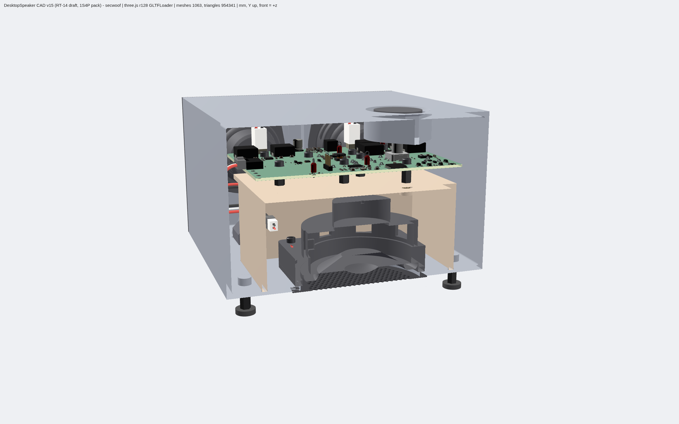
ai-files/website/desktopSpeaker-site/cad/renders/section_woofer.png
