chithigun23/DesktopSpeaker/ai-files/website/desktopSpeaker-site/cad/renders/section_x0.png

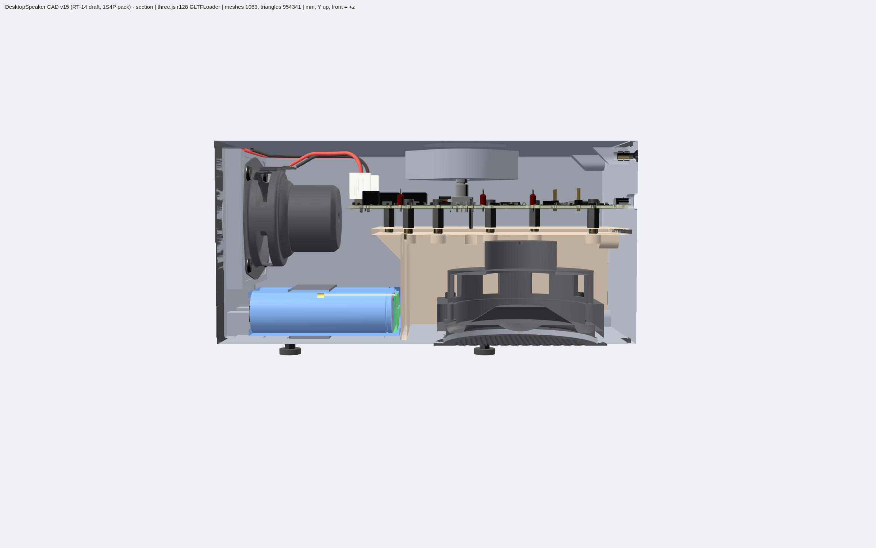
ai-files/website/desktopSpeaker-site/cad/renders/section_x0.png
