chithigun23/DesktopSpeaker/ai-files/website/desktopSpeaker-site/cad/renders/underside.png

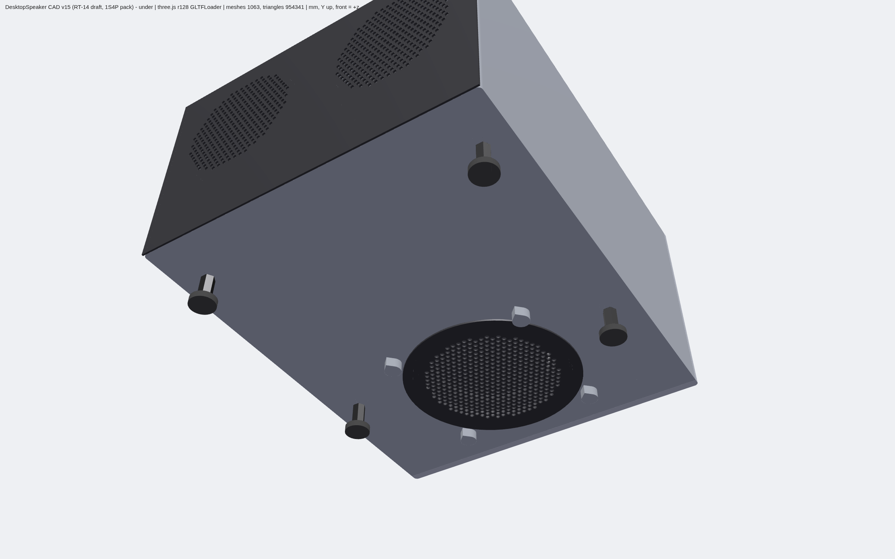
ai-files/website/desktopSpeaker-site/cad/renders/underside.png
