chithigun23/DesktopSpeaker/ai-files/website/desktopSpeaker-site/cad/renders/v15_driver_screw_section.png

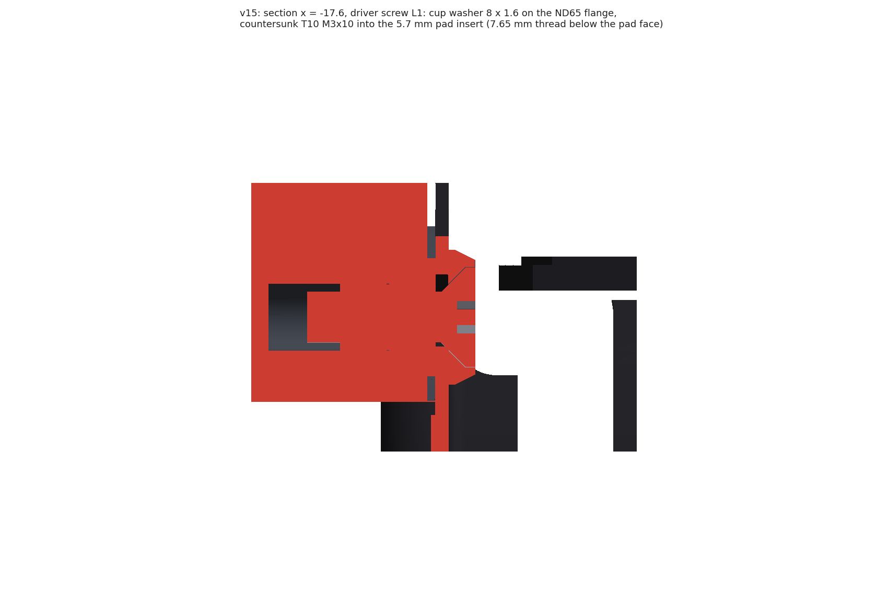
ai-files/website/desktopSpeaker-site/cad/renders/v15_driver_screw_section.png
