chithigun23/DesktopSpeaker/ai-files/website/desktopSpeaker-site/cad/renders/v15_lid_countersunk.png

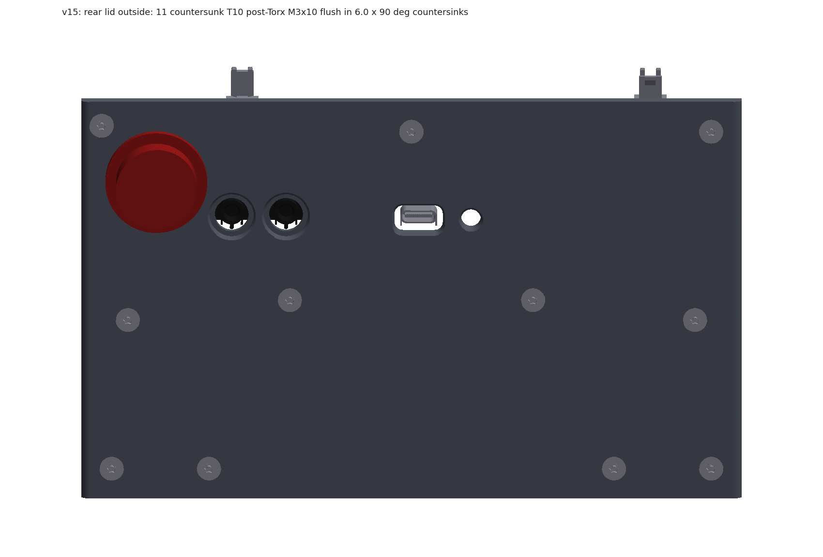
ai-files/website/desktopSpeaker-site/cad/renders/v15_lid_countersunk.png
