chithigun23/DesktopSpeaker/ai-files/website/desktopSpeaker-site/routing/rt2_silk.png

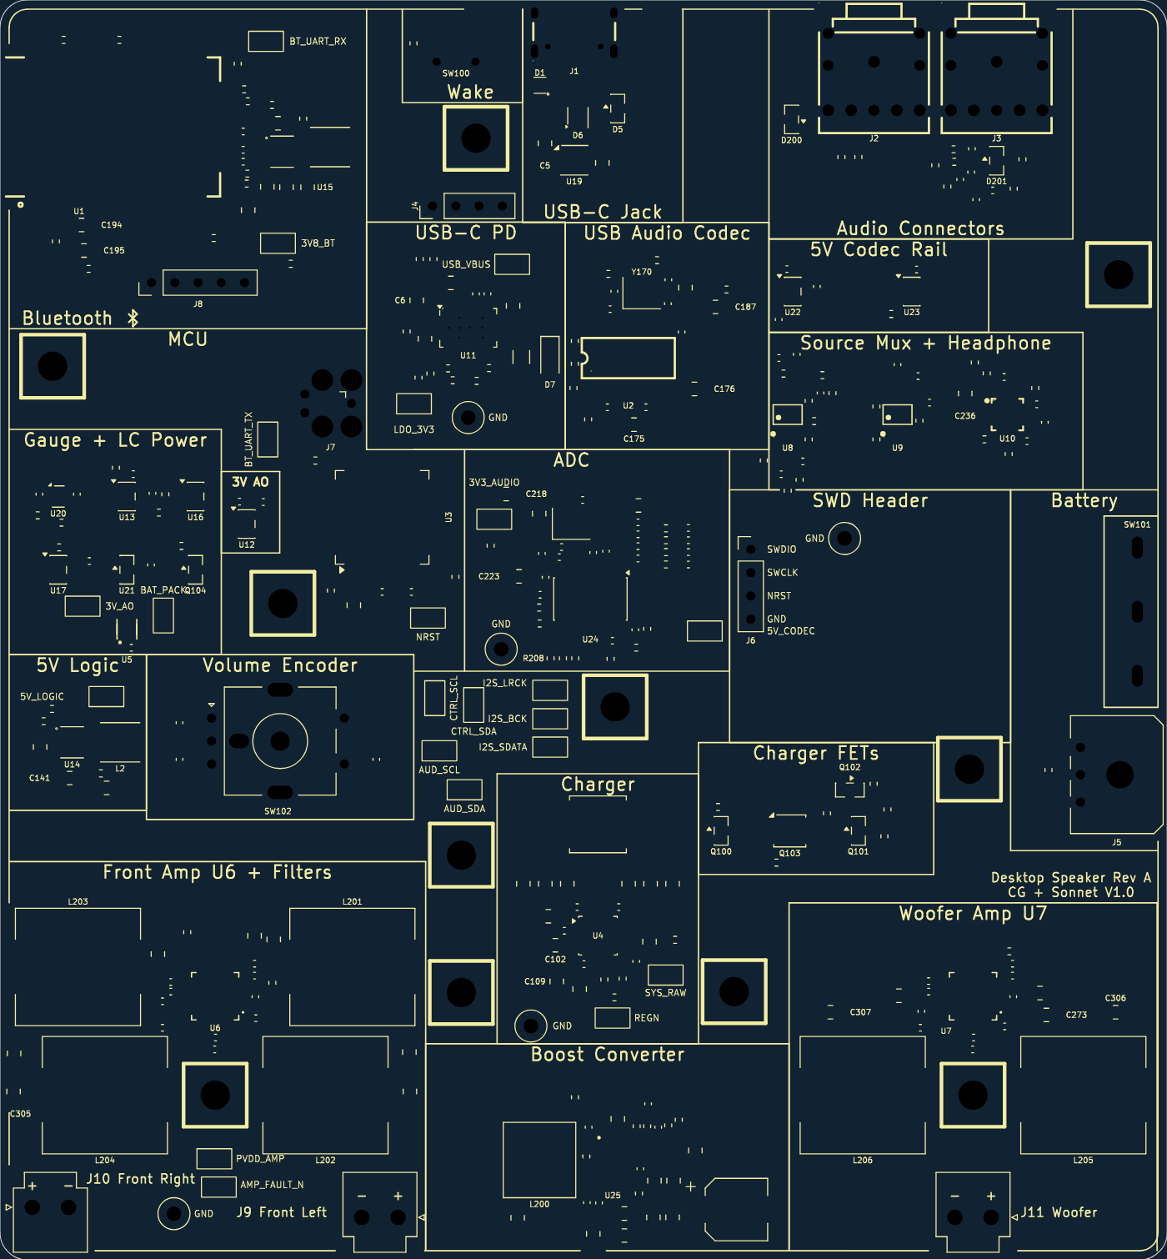
ai-files/website/desktopSpeaker-site/routing/rt2_silk.png
