chithigun23/DesktopSpeaker/ai-files/website/desktopSpeaker-site/routing/rt4_back.png

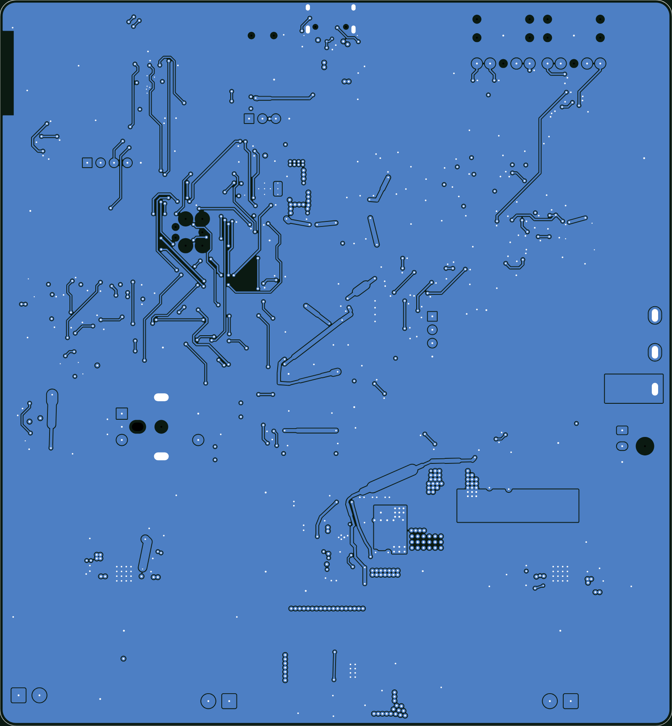
ai-files/website/desktopSpeaker-site/routing/rt4_back.png
