chithigun23/DesktopSpeaker/ai-files/website/desktopSpeaker-site/routing/rt13_back.png

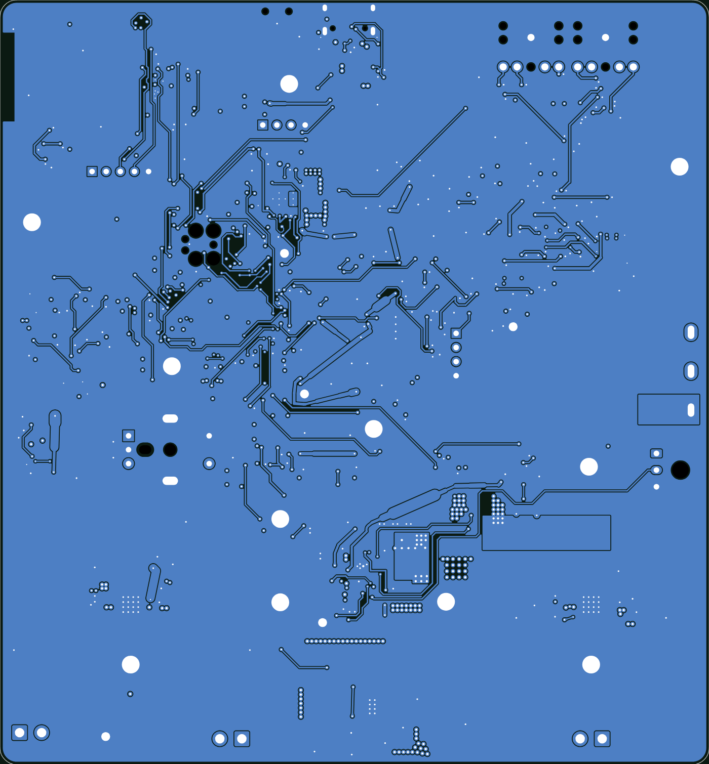
ai-files/website/desktopSpeaker-site/routing/rt13_back.png
