chithigun23/DesktopSpeaker/ai-files/website/routing-progress/rt8_back.png

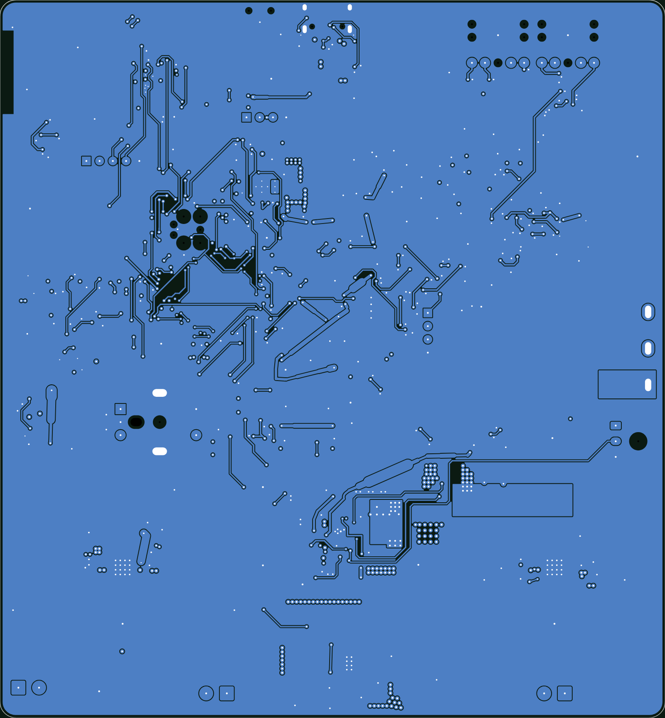
ai-files/website/routing-progress/rt8_back.png
