chithigun23/DesktopSpeaker/ai-files/cad/mechanical-bom.md

# Mechanical bill of parts (current design 2026-11-03: CAD v15 geometry + review-fix decisions; CAD v16 pending)

> **2026-11-03 (review fixes).** This table states the **current design**: CAD v15 (`ai-files/cad/v15/`) plus the decisions taken after `reports/project-review-cad-completeness-2026-11-03.md` and `reports/fastener-schedule-2026-11-03.md` (record: `reports/review-fixes-2026-11-03.md`; HANDOVER "Review fixes 2026-11-03"). Rows marked **(v16)** are decided but not yet modelled: CAD v16 (`ai-files/cad/v16/`) builds them and may refine the numbers. Buy-list row numbers refer to `ai-files/bom/hardware-buy-list.csv` / `.md` (# column). The previous table (v11 print-ready, with the 1S4P/screw notes of earlier on 2026-11-03) is kept unchanged under "History" at the end. Superseded statements: woofer bolt circle 77 and the 83.4 x 1.0 flange recess (CAD v13+ uses the square 82.55 frame, 96.52 bolt circle, factory 3.3 mm gasket, no recess); rocker body "about 11 behind the panel" (CAD stand-in 22.4); M3x16 socket PCB screws and F/F spacers; nylon lid washers; 3 mm lid cord; bonded insert; grommet 6.0 hole / 1.6 web; RFQ thickness 23.0.

| Item | Qty | Spec / source | Model / status |
|---|---|---|---|
| Printed main shell (baffle, walls, driver pads, woofer seat and bosses, lid bosses, feet bosses, battery cradle, printed cable-tie bridges) | 1 | PETG, 163 x 100 x 202.6, baffle down, no supports. **(v16)** top wall gets a 42 mm opening with a 1 mm recess for the 46 mm knob-cup flange and 4 insert bosses; floor gets 4 countersunk screw holes for the removable woofer-chamber insert; tie bridges (slot 3.0 x 1.4, bridge 1.5) at the review M4 positions; cradle re-cut from the vendor drawing (usable thickness 22.3) | parametric (v15), v16 pending |
| Printed knob cup **(new, v16)** | 1 | the former shell dish as a separate part: 36 mm dish, 3 mm wall and floor, 8.5 mm shaft hole, 46 mm flange; drops in from above after the PCB; **4 x countersunk post-Torx M3x10 into 4 inserts**; sealed with a ring cut from the 1.5 mm foam sheet (row 53). Lets the PCB slide in under the top wall (review finding 1, option M1(b)); H8 is reachable from above with the cup out | v16 |
| Printed woofer-chamber insert (partition, side walls, roof, PCB shelf, bosses, grommet boss) | 1 | 122 x 126.6 x 55, roof down, no supports. **Removable (v16):** sits on a 1.5 mm closed-cell foam gasket (row 53) in the floor grooves and is held by **4 x countersunk post-Torx M3x10 from below through the floor into 4 inserts** in bosses on the insert wall feet (replaces the Sikaflex bond). Service order: lid, PCB, woofer, insert, then battery or drivers. Grommet hole **6.35 mm, web 1.5 mm** for the Heyco 2000 (v16; v15 had 6.0 / 1.6). Roof stiffening ribs (review S16) left to CAD v16 | parametric (v15), v16 pending |
| Printed rear lid 4 mm | 1 | 163 x 100 x 4, outer face down; gasket groove 2.0 x 1.5; cut-outs USB-C 12 x 7 R2, SW100 5.0, jacks 8.5 (+ 11 x 2.0 counterbore outside), rocker 20.2 + key notch (28 mm pocket, 2.0 mm panel); 11 countersinks 6.0 x 90 deg. **(v16)** SW100 counterbore 7.4 x 1.0 on the inner face; review S7 openings (USB-C 13.0 x 7.5, jack bores 10.0) and S14 debossed labels are CAD-agent scope | parametric (v15), v16 pending |
| Printed SW100 plunger **(new, v16)** | 3 variants (fit 1) | PETG; shank 4.6 through the 5.0 bore, flange 7.0 x 0.8 in the lid counterbore, nub 1.8 dia; **nub lengths 0.4 / 0.6 / 0.8 mm**: keep the one that clicks without preload; outer face 0.3-0.5 below the lid face (recessed against accidental ship/wake presses). Fitted from inside before the lid | v16 |
| Dayton Audio ND65-4 full-range | 2 | PE 290-204, 4 ohm, 64 mm square flange 0.75 mm, two flat solder tabs (leads soldered; polarity mark to check on the part) | real maker STEP |
| Driver gasket, closed-cell foam **3 mm** (row 52) | 2 | 63 mm square ring, 59.5 mm hole, adhesive one side. Coordinator choice 2026-11-03: 3 mm foam (the v15 pad recess is 0.5 mm; **CAD v16 sets the recess/stand-off for 3 mm foam**; the review S10 suggestion was 0.8-1.0 mm) | v16 |
| Tang Band W3-2052SC woofer | 1 | PE 299-572. **Square frame 82.55 (R4), 4 holes 3.4 on a 96.52 mm bolt circle (68.25 mm square pattern), frame block 13.3, factory foam gasket 3.3, total 47.75**; seated directly on the floor inner face (no ring pad, no recess); cutout 76.2. All woofer dimensions are **photo estimates (+-1.5 mm)**: caliper the sample before printing. Termination: PHR-2 pigtail seen in the photo, **UNVERIFIED** (confirm on the sample) | models-v13 STEP (photo-based) |
| Woofer screws: button post-Torx T10 M3x20, A2-70 (Bolt and Nut 22BPTS320, row 44) | 4 | head on the frame back, through frame 13.3 + gasket 3.3 into the seat inserts: engagement 3.4 mm (gasket free) / 4.4 mm (1 mm compressed): marginal. Optional 2 mm floor-boss tweak (fastener schedule section 3) gives 5.4-5.7 after calipering. Replaces the unlisted ISO 4762 M3x20 | parametric |
| Woofer gasket | 0 (spare ring only if needed) | factory 3.3 mm gasket assumed (CAD). If the sample has none, cut an 83 OD / 76.2 ID ring from the 3 mm sheet (row 52) | none |
| Cell Samsung INR21700-50S (5 Ah) | 4 | 1S4P, 20 Ah, about 72 Wh, 4 side by side, axes front to back. CAD v15 brick **86.85 x 74.47 x 21.75**; RFQ maximum **87.0 x 75.0 x 22.3** including wrap, PCM, fuse and TCO (23.0 superseded) | models-v13 cell STEP |
| Pack PCM + 10k NTC + **15 A PACK+ fuse + about 85 C thermal cut-off** | 1 | examples proposed to the vendor: Littelfuse 0453015.MR fuse, Bourns NR85AB0 mini-breaker (hold current >= 10 A at 45 C to confirm). PCM on the + end at the rear, 0.63 mm from the partition (rear stop); CAD v15 PCM 60 x 18 x 1.6 + parts. PCM >= 10 A / 20 A 1 s, OCP trip 12-20 A, charge >= 5 A, OV 4.25 V, per-cell fusible links, NTC between the middle cells; secondary fuse and TCO per RFQ item 2 (rows 60-61). Vendor drawing pending (`reports/battery-pack-rfq.md`) | box (vendor drawing pending) |
| Pack stop ribs / pads (review S5) | 2 | printed ribs on the partition at x +-37 with 0.5 mm EVA/PORON pads, clear of the PCM: CAD-agent scope, confirm on the vendor drawing | v16 (proposed) |
| Hook-and-loop strap 20 mm | 1 | around the brick through the two 22 x 2.5 tunnels; path 243 mm + overlap: **order >= 350 mm** (row 24) | modelled path (v15) |
| Pack harness to J5 (Micro-Fit 3.0, 3-way) | 1 | Molex 43645-0300 + 43030-0038 (2 x 18 AWG **thin-wall, OD <= 1.7**) + 43030-0007 (24 AWG NTC); vendor-terminated, lead about 180 mm (CAD route 131 mm: slack dressed on a tie point). Thin-wall wire for a service lead: row 57 | swept wires (v15) |
| Front driver leads J9, J10; woofer adapter J11 | 3 pairs | 20 AWG figure-8 (row 12), VHR-2N + SVH-21T-P1.1. **Cut lengths (review S9):** J9 about 110 mm, J10 modelled + 40 (about 336 / 292 mm), J11 adapter modelled + 40 (about 235 mm); all tied to the anchors. J11 passes the Heyco 2000 grommet; splice to the woofer termination with heat-shrink (row 58) | swept wires (v15) |
| Cable management | 9 anchors | printed tie bridges in the shell (v16) or adhesive tie mounts (row 56) at: 3 on the J10 path (top wall: over the left driver, centre, over the right driver), 1 over the left driver for J9, 2 on the right side wall for J5 (drop at x 77, near the grommet boss), 1 on the insert roof edge for J11, 1 inside the woofer chamber for the inline pair and splices. Ties 2.5 x 100 (row 55). Each ND65 lead also tied or glued to its basket next to the tab; foam tape where a lead crosses a basket | v16 |
| Heyco 2000 snap bushing | 1 (+1 spare) | 6.35 mm hole, panel <= 1.57 mm (CAD v16: 6.35 / 1.5), ID 3.56; seal the leads with a dab of Sikaflex | modelled (v15) |
| Lid gasket: EPDM sponge cord **2 mm** (row 50, Polymax 2004200, closed-cell to confirm) | about 0.75 m (buy >= 1 m) | in the 2.0 x 1.5 groove (outer loop 0.51 + chamber U 0.23). Replaces the 3 mm cord (235 % groove fill). Check closure with a paper strip at first fit | groove only |
| Connector-face seals: 2 mm closed-cell foam, adhesive (row 51) | 1 die-cut piece (or 4) | on the lid inner face: J1 cut-out 8.6 x 2.9, J2/J3 holes 5.0 aligned with the bores (open with the bores if v16 widens them), SW100 hole 5.0 around the plunger. 1.5 mm gap to the connector faces: about 25 % compression | v16 |
| Encoder foam washer (cut from the 3 mm x 12 mm neoprene tape, row 52; washer row 66) | 1 (+1 spare) | ID 7.0 / **OD 12** (tape width; review asked 14) / 3.0 on the encoder bushing under the knob-cup floor (compresses to about 2.1 mm) | v16 |
| Lid screw seals inside the woofer-chamber loop (LidScrew 6, 7, 10, 11) | 4 | foam washers ID 3.2 / OD 7.5 in 7.6 x 0.7 counterbores on the boss tops if CAD v16 adds them (review S2); otherwise a non-curing butyl dab. The 11 nylon flat washers are **removed** (they cannot sit under flush countersunk heads) | v16 / none |
| Pressure-equalisation vents | 2 | one 0.5 mm hole through the lid in the woofer zone and one in the main-chamber zone, drilled with a 0.5 mm carbide PCB drill (row 65), each covered inside with a dot of grille cloth or felt. Do not print a 1 mm hole | drill after print |
| Damping, woofer chamber | 6-8 g | Acousta-Stuf polyfill (row 3), loose, kept 10 mm off the magnet and cone | not modelled |
| Damping, main chamber | about 0.04 m2 (buy a sheet) | 10 mm open-cell acoustic foam lining (row 54) on the top wall over the drivers (not under the cable path) and the side walls in front of the insert; CAD v16 adds a 10 mm placeholder to the volume report | v16 placeholder |
| Front grille plate 0.8 mm, 2.0 holes / 3.0 pitch | 1 | 163 x 100, 2 x 56 perforated zones, bonded, backed with black acoustic cloth (row 4). CAD mass uses steel; the buy list proposes FR4 (state in v16) | parametric |
| Woofer grille plate 0.8 mm, dia 90, holes to dia 64 | 1 | bonded under the floor, **backed with the same black cloth** (row 4) against debris | parametric |
| Countersunk post-Torx T10 M3x10, A2-70 (Bolt and Nut 22CPTS310, row 40) | **27** | lid 11 (flush in 6.0 x 90 countersinks, 6.0 mm thread below the lid), drivers 8 (on cup washers; about 7.5 mm engaged), knob cup 4, woofer-chamber insert 4. Head 5.90 x 2.00, 90 deg | parametric |
| Cup washer 6g G304 (Bolt and Nut 71CS6, row 42) | 8 | OD 11.0-11.4, ID 4.1-4.5, cup 2.1-2.3, 90 deg: under the driver screw heads on the 0.75 mm ND65 flange (CAD v16: 11.2 x 2.2, check against the basket ribs) | parametric (v15: 8 x 1.6) |
| PCB standoff Wurth 971100321, M/F 10 mm + 6 mm stud, steel (row 46) | 10 | H1-H8, HA1, HA2: stud into the roof insert, button screw into the female end (8.4 mm in steel thread; female depth UNVERIFIED, >= 8.5 needed, else button M3x8). Replaces the F/F spacer + M3x16 socket screw | v16 model swap |
| PCB screw: button post-Torx T10 M3x10 (Bolt and Nut 22BPTS310, row 43) | 10 | H1-H8, HA1, HA2 | parametric |
| H9 (nearest metal to the BM83 antenna, 16.3 mm): nylon M3 standoff Wurth 971100365 (M/F, 10 mm body, 6 mm hex, **8 mm stud: trim to 6 mm**) + nylon pan M3x10 Wurth 97791003111 (rows 47-48) | 1 + 1 | replaces steel at H9 only; same 10 mm body height (6 mm hex instead of 5.5) | v16 model swap |
| Heat-set insert M3 x 5.7 (OD 4.6, pilot 4.0) | **46** | lid 11, drivers 8, woofer 4, PCB 11, feet 4, knob cup 4, woofer-chamber insert 4 (row 15) | parametric |
| Foot: Wurth 971120321 M/F stud (12 mm body, M3 male 6) | 4 | male end into the floor insert; unchanged | parametric |
| Foot: screw-in rubber buffer with M3 x 6 male stud, 8 x 8 mm (row 63, RS PRO 196-1356, UNVERIFIED) | 4 (+1) | screws into the stud's female end; replaces the glued 12.7 mm Bumpon (would shear off when slid). Floor gap becomes 12 + 8 = 20 mm: CAD v16 updates the woofer gap and tipping. No 12-16 mm M3-stud buffer exists in catalogues; the alternative is M4 foot inserts with a 15 x 13 mm M4 buffer and no stud (gap 13 mm): owner/CAD decision | v16 |
| SW101 rocker CW Industries GRB112B802BR1 | 1 | 20.2 hole + key, snap-in panel 1.5-2.5 (lid pocket 2.0), 3 x 0.187 in fastons; **CAD stand-in body 22.4 mm behind the panel** (meta `body_depth_behind_panel`; the earlier "about 11" is superseded; measure the real part). Leads: 2 x 18 AWG thin-wall about 150 mm each with a 60-80 mm service loop (row 57), clear of J3; insulate the unused lamp tab (row 7) | stand-in |
| Encoder knob (SW102 = Alps EC11E18244AU, 6 mm flat (D) metal shaft, 20 mm actuator length) | 1 | **Kilo International DDS-90-4-7** (row 64, Digi-Key AU, VERIFIED): knurled aluminium, true 6.00 mm bore, 2 set screws (one on the flat), 31.75 mm skirt x 15.88 mm, knurled body 23.5 mm; about 2.1 mm radial gap in the 36 mm cup. Taller than the 14 mm stand-in: CAD v16 re-checks the top height. Replaces the Jaycar HK7011 (6.35 bore, 0.35 mm off-centre) | stand-in |
| Labels | - | lid deboss (USB-C 5-20 V 3 A, HP OUT, AUX IN, WAKE, BATT OFF/ON) and a pack rating label: CAD-agent scope (review S14) | v16 (proposed) |
| Status indicator | 0 | **none in v1** (owner/coordinator decision 2026-11-03): BM83 voice prompts and phone battery reporting instead; revisit at the next board revision | none |

Counts (current design): 41 screws (27 countersunk M3x10 + 10 button M3x10 + 4 button M3x20) + 1 nylon M3x10 at H9; 46 inserts; 10 steel M/F standoffs + 1 nylon standoff; 8 cup washers; 4 feet studs + 4 screw-in rubber feet; 0 lid washers; printed bodies: shell, lid, woofer-chamber insert, knob cup, SW100 plunger (3 variants).

---

## History (table as of 2026-11-03 before the review fixes; v11 print-ready basis)

Original title: "Mechanical bill of parts (v11 print-ready, 2026-10-12, from DesktopSpeaker_internal.FCStd)".

Generated by hand from `build_speaker_cad.py` (DETAIL=1) and `work/meta.json`. Counts follow the model.

> 2026-11-03: pack decision 1S4P (owner). The battery lines below are updated for CAD v15 (`ai-files/cad/v15/`, `BATT=4P`); the v11 values are kept in brackets as history. The other lines are unchanged from v11.

| Item | Qty | Spec / source | Model |
|---|---|---|---|
| Printed main shell (baffle + walls + driver pads + woofer ring + lid bosses + feet bosses + battery cradle + encoder knob dish) | 1 | PETG/ASA, 163 x 100 x 202.6, baffle down, no supports, `print/DesktopSpeaker_shell.stl` | parametric |
| Printed woofer chamber insert (partition + side walls + roof + PCB shelf + bosses + grommet boss) | 1 | 122 x 126.6 x 55, roof down, no supports; bonded and sealed into the floor grooves (epoxy or PU sealant) | parametric |
| Printed rear lid 4 mm | 1 | 163 x 100 x 4, outer face down; gasket groove 2 x 1.5; cutouts USB-C 12 x 7 R2, SW100 5.0 (4.4 mm web, R6q), jacks 8.5 (+ 11 x 2.0 counterbore outside), rocker 20.2 + key notch (28 mm inside pocket, 2.0 mm panel) | parametric |
| Dayton Audio ND65-4 full-range | 2 | PE 290-204, 4 ohm, 64 mm flange | real maker STEP |
| Tang Band W3-2052SC woofer | 1 | PE 299-572, cutout 76.2, flange 82.55, 44.45 deep; bolt circle 77 ASSUMED and conflicts with the 76.2 cutout (see report v11.2) | parametric |
| Cell Samsung INR21700-50S (5 Ah) | 4 (v11: 2) | 1S4P = 20 Ah, about 72 Wh: 4 side by side in X, axes front to back, brick 86.8 x 73.7 x 21.7 (cells at the datasheet maximum 21.25 x 70.62 on a 21.7 pitch). RFQ maximum 87.0 x 75.0 x 23.0 including wrap and PCM. (v11: 21.7 dia x 70.2, 2P = 10 Ah) | models-v13 cell STEP |
| Pack PCM/protection board + 10k NTC | 1 | on the cell + end at the rear, 1.0 mm from the woofer-chamber partition (the partition is the rear stop); placeholder 60 x 3 x 18. PCM >= 10 A continuous / 20 A for 1 s, OCP trip 12-20 A, charge >= 5 A, OV 4.25 V, per-cell fusible links; NTC between the two middle cells. TO BE SOURCED (`reports/battery-pack-rfq.md`) | box |
| Hook-and-loop strap 20 mm | 1 | 1S4P: one strap around the brick in the X-Z plane at y 44.9, through the 22 x 2.5 tunnels of the two side anchor blocks; CAD v15 path 243 mm (centreline) + 60-80 mm buckle overlap = about 300-320 mm (feasibility estimate 330): **order >= 350 mm** (v11: about 250 mm) | not modelled |
| Pack harness to J5 (Micro-Fit 3.0, 3 way) | 1 | 2026-11-03 (CAD v15): Molex 43645-0300 + 43030-0038 (2 x 18 AWG thin-wall, OD <= 1.85) and 43030-0007 (24 AWG NTC); route: out of the receptacle toward the right wall, down at x 77, forward at z 35-39 (stacked), across under the grommet boss at y 87.4, down onto the PCM top-edge pads through a wrap slit; about 131 mm modelled (cut 140; RFQ lead about 180 with slack). First bend R 9.5 at the receptacle (5.3 x OD: the receptacle faces the wall with 11.05 mm free) (v11: about 230 mm along the floor) | swept wires, housing, crimps |
| Woofer adapter lead J11 -> woofer (2 x 20 AWG, OD 1.75) | 1 pair | 2026-11-03 (CAD v15): JST VHR-2N + 2 x SVH-21T-P1.1 at J11, about 195 mm modelled (cut 205), touching pair through the Heyco 2000 grommet (moved to x 50, z 47), solder splice + heat-shrink to 24 AWG tails, inline JST-PH-compatible 2-pin male mating the woofer pigtail PHR-2 (PH is rated 2 A at 24 AWG: keep the woofer AGL ceiling; re-terminating the pigtail is the alternative) | swept wires, housings, crimps |
| Front driver leads J9 -> left ND65, J10 -> right ND65 (2 x 20 AWG each) | 2 pairs | 2026-11-03 (CAD v15): VHR-2N + SVH-21T-P1.1 at J9/J10, soldered on the ND65 solder tabs (the ND65-4 has two flat solder tabs, no quick-connect); J9 about 50-55 mm, J10 about 252-296 mm modelled (forward over the left driver, across the front, up the right side) | swept wires, housings, crimps |
| Rubber grommet, 6 mm hole, 1.6 mm panel, ID >= 3.4 | 1 | e.g. a 6.4/6.0 mm snap grommet, TO BE SELECTED; seal the leads with a drop of silicone | stand-in |
| Foam cord 3 mm (closed cell EPDM/neoprene) | about 0.75 m | lid groove: outer loop 0.51 m + chamber U 0.23 m | groove fill |
| Driver gasket 0.5 mm foam, 63 mm square minus 59.5 aperture | 2 | in the pad recesses | recess only |
| Woofer gasket 0.5-1 mm foam ring 83 OD / 70 ID | 1 | in the 83.4 x 1.0 flange recess | recess only |
| Screw M3x10 countersunk post-Torx T10, A2-70 (Hobson Engineering, boltandnut.com.au) | 19 | 2026-11-03 (CAD v15): 8 drivers (on cup washers, the 0.75 mm ND65 flange cannot be countersunk) + 11 lid (flush in 6.0 x 90 deg countersinks). Head 5.90 x 2.00, 90 deg; needs a T10 post-Torx bit. Thread below the lid inner face 6.0, below the driver pad face 7.65 (insert 5.7 fully engaged). (v11: 23 x ISO 4762 M3x10 incl. 4 woofer; the woofer uses M3x20 since v13) | parametric (vendor-page values) |
| Countersunk (cup / finishing) washer M3, about 8 x 1.6 | 8 | under the driver screw heads on the ND65 flange; not sourced | parametric |
| Screw M3x16 socket cap ISO 4762 | 11 | PCB (11 holes H1-H9, HA1, HA2; 4.4 mm into the insert) | parametric |
| Nylon sealing washer M3 | 0 (was 11) | 2026-11-03: not usable under the flush countersunk lid screws; seal the lid holes inside the gasket loops with sealant (owner decision) | not modelled |
| Heat-set insert M3 x 5.7 (OD 4.6, pilot 4.0) | 38 | 34 screws + 4 feet studs | parametric |
| Hex spacer M3 x 10, 5.5 AF, through (or F/F) | 11 | PCB holes, on the flat insert roof/shelf | parametric |
| Foot: Wurth 1768061 spacer stud (12 mm body, M3 male 6) | 4 | | parametric |
| Rubber disc 12 dia x 3 | 4 | glued on stud ends (gap 15 mm total) | parametric |
| Front grille plate 0.8 mm, 2.0 holes / 3.0 pitch | 1 | 163 x 100, 2 x 56 dia perforated zones, bonded, black + acoustic cloth | parametric |
| Woofer grille plate 0.8 mm, dia 90, holes to dia 64 | 1 | bonded under the floor | parametric |
| SW101 rocker CW Industries GRB112B802BR1 | 1 | 20.2 hole + 2.2 key notch at the top, 25 flange outside, snap-in 1.5-2.5 (lid pocket to 2.0), body about 11 behind the panel, 3 x 4.8 fastons (3 crimp receptacles) | stand-in |
| Encoder knob D30 x 14, 6 mm D-shaft (EC11E, 20 mm shaft) | 1 | sits in the 36 mm top-wall dish, 8 mm shaft engagement; TO BE SELECTED | stand-in |
| Acoustic damping | as needed | not modelled | none |

Counts (v11): 34 screws (23 M3x10 + 11 M3x16), 38 inserts, 11 spacers, 11 sealing washers, 3 printed bodies. v10 counts: 29 screws, 33 inserts, 10 standoffs, 2 printed bodies (the v10 shell was not printable as one piece: 58 mm cantilever posts and an unsupported partition).
