chithigun23/DesktopSpeaker/ai-files/reports/sourcing-2026-10-12.md

# Sourcing: woofer drawing, encoder, rocker, battery pack (accessed 2026-10-12)

## 1. Tang Band W3-2052SC (Parts Express 299-572)

Source: https://www.parts-express.com/Tang-Band-W3-2052SC-3-RBM-Neodymium-Subwoofer-4-Ohm-299-572 (specs table). No maker PDF or dimension drawing was found (searches returned nothing; the page's "Manuals & Resources" tab links no file in the fetched HTML). `ai-files/datasheets/TangBand_W3-2052SC.pdf` was therefore NOT created.

| Item | Parts Express value | mm | CAD assumption | Difference |
|---|---|---|---|---|
| Overall outside diameter | 3.25 in | 82.55 | 82.6 | none |
| Flange thickness | not given | - | 4 | unverified |
| Baffle cutout diameter | 3 in | 76.2 | aperture 70 | CAD is 6.2 mm SMALLER than the maker cutout; check cone/surround clearance |
| Mounting holes | 4, diameter not given | - | 4 x 3.5 | count matches; diameter unverified |
| Bolt circle | "3.8" (unit not stated) | 96.5 if inches | 77 | inconsistent: 96.5 mm exceeds the 82.55 mm flange, so the unit or value is suspect; 77 mm unverified |
| Depth | 1.75 in | 44.45 | 44.5 | none (reference point behind flange not stated) |
| Magnet diameter | not given (neodymium) | - | 40 | unverified |
| Nominal / cone | 3 in; Sd 28.8 cm2; voice coil 1 in | - | - | - |
| Fs / Qts / Qes / Qms | 59 Hz / 0.49 / 0.53 / 6.48 | - | - | - |
| Vas | 0.021 ft3 | 0.595 L | README "Vas 0.59" | none |
| Recommended volume | vented 0.05 ft3 (1.42 L), F3 44 Hz; no sealed figure | - | sealed 0.525 L net | PE recommends a vented 1.42 L; sealed 0.525 L is our own choice (about 0.88 x Vas) |
| Other | Re 4.3 ohm, Le 1 mH, BL 6.6, Mms 14.8 g, Xmax 5 mm, 15/30 W, 78.3 dB, 50-800 Hz | - | - | - |

Do not confuse with loudspeakerdatabase "W3-2052S" (Fs 50, Qts 0.34, Vas 0.89 L; https://loudspeakerdatabase.com/TangBand/W3-2052S via search snippet): a different model/revision.

Recommendation: enlarge the aperture toward 76.2 mm (or measure the real driver's cone/surround), and measure flange thickness, hole diameter, bolt circle and magnet with calipers when the sample arrives. Do not cut the print before that.

## 2. Volume encoder SW102

Alps EC11E catalog (saved `ai-files/datasheets/Alps_EC11E.pdf`, from https://tech.alpsalpine.com/cms.media/product_catalog_ec_01_ec11e_en_611f078659.pdf): all candidates are vertical, flat shaft, actuator length 20 mm, detent torque 10 +/-7 mN.m, 15,000 cycles, 10 mA 5 V DC. Body dimension drawings (Nos. 1-3) are images in the PDF and were not read; footprint equivalence rests on the same 11 mm EC11E series (unverified from the drawing).

| Part | LCSC | Stock | Price 1 / 10 | Pulses/detents | Switch (travel) |
|---|---|---|---|---|---|
| EC11E15244G1 (current) | C370970 | 0 | $2.20 / $1.90 | 15 / 30 | yes (0.5 mm) |
| EC11E18244A5 | C255515 | 438 | $2.4246 / $2.0932 | 18 / 36 | yes (1.5 mm) |
| EC11E18244AU | C202365 | 398 | $2.2213 / $1.8892 | 18 / 36 | yes (0.5 mm) |

Sources: https://www.lcsc.com/product-detail/C255515.html, https://www.lcsc.com/product-detail/C202365.html, https://www.lcsc.com/product-detail/C370970.html (stock/prices as fetched 2026-10-12; LCSC shows prices that vary between snapshots).

Recommendation: EC11E18244AU (C202365): same 0.5 mm switch travel as the current G1, 18/36 instead of 15/30. A5 is the alternative (1.5 mm travel). Firmware/step counting: 36 detents = 2 edges per detent either way; check the quadrature decoder counts per detent.

## 3. Battery disconnect rocker SW101

LCSC finds: no suitable in-stock round 20 mm rocker with a stated DC rating.
- Shou Han KCD1-201-R C5884429: not available; PC-pin, 23 x 20.5 mm, height 25 mm (https://www.lcsc.com/product-detail/Rocker-Switches_SHOU-HAN-KCD1-201-R_C5884429.html).
- Switch Components RC-1A-DC-1-UL C6637735: out of stock, $7.45, no DC rating or mechanicals listed.
- Shou Han KCD1-202-R C5884426 (20 A, solder lug): stock not confirmed, datasheet not readable.

Fallback candidates (Digi-Key):
1. CW Industries GRB112B802BR1 (red LED, SPST): 7,073 in stock, $5.09 qty 1 / $4.39 qty 10, 12 week factory lead time (https://www.digikey.com/en/products/detail/cw-industries/GRB112B802BR1/2349683). Drawing (https://www.cwind.com/sites/cwind/files/grb112b802br1.pdf, read as image): 20 A 14 VDC (16 A 125 VAC, 10 A 250 VAC), hole 20.2 mm with a 2.2 mm key notch, 0.187 in (4.8 mm) faston terminals x3, flange 25 mm, 11.5 mm above panel, overall 22.4 mm (terminals about 11 mm behind the panel, approximate), IP65. Panel thickness 1.5-2.5 mm (the drawing also shows 19.0 mm hole, 0.7-2.5 mm). Does NOT cover 4 mm. The LED needs 12 VDC (can be left unused only if pin wiring allows; lamp is dependent on pin 3).
2. Switch Components RA1-1A-DC-2-GL (green LED 14 VDC): $2.79 marketplace, 20 A DC, 20.2 mm cutout, 0.187 in faston (https://azcus.digikey.com/en/products/detail/switch-components/RA1-1A-DC-2-GL/11492856); thickness and depth not checked.
3. E-Switch RR511D1121 (20.0 mm cutout, 20 A AC only, no DC rating) - not recommended.

Recommendation: GRB112B802BR1, with a local 2.0-2.5 mm pocket/counterbore in the 4 mm lid around the hole (the snap-in needs 1.5-2.5 mm). 14 VDC rating is below the 16 V maximum: acceptable for a battery-side disconnect at 3.6-4.2 V per cell only if this switch is on the 1S battery rail; if on a 12-16 V rail, verify with the maker.

## 4. Battery pack, 1S2P 21700

> 2026-11-03: the owner chose 1S4P (4 x INR21700-50S, 20 Ah). Ask the vendors below for the 1S4P pack in `battery-pack-rfq.md`; the 1S2P findings are history.

Ready-made, 2P with NTC and 8 A+ PCM, was not found as a catalog item; all are quote-based.
1. Keeppower 1S2P 21700 pack (https://keeppower.com.cn/products_detail.php?id=792): 6000 mAh cells, 12 Ah typ / 10 Ah min, max outline 72.5 x 44.0 x 22.0 mm (matches the 73 x 43 x 22 target), AMASS XT30U connector, customizable capacity, discharge current and connectors; certifications UN38.3, IEC62133. PCM current, NTC, price, MOQ, lead time not listed: request quote. 
2. CM Batteries 1S2P 21700 10 Ah (https://cmbatteries.com/project/1s2p-battery-pack/): 10 Ah nominal (9.7 min), 3.65 V, 10 A continuous, 25-40 A burst, charge 2 A std / 5 A max, 152.8 g, samples with no MOQ. Outline, NTC, connector, price, lead time not listed: quote.
3. DIY: 2 x Samsung INR21700-50S + 1S PCM (about 10 A) + cell holder/nickel strip. A PCM with a 10 k NTC lead was not found in retail searches (1S boards found are 1-10 A without NTC, e.g. https://scccltd.com/products/18650-battery-protection-module-3-7v-10a). Not verified.
Also seen: Epoch 21700 5000 mAh single-cell pack with PCB, 5 A only (https://www.18650batterystore.com:443/products/epoch-batteries-21700-5000mah-5a-battery-with-pcb-and-6-leads): too weak and 1P.

Recommendation: ask Keeppower and CM Batteries to quote the 1S2P with a 10 k NTC (B 3435 K), PCM >= 10 A continuous and 5 A charge, specifying the NTC part so it matches the charger 103AT network. Australia shipping not confirmed for any (cell shipping needs UN38.3 documents, which both list).

## Unverified
- Woofer: flange thickness, hole diameter, true bolt circle (PE "3.8" has no unit), magnet diameter, depth reference, any maker drawing; no PDF saved.
- Aperture 70 vs maker cutout 76.2.
- Alps body outlines/pin layout from drawings (images, not read); LCSC shaft fields are blank on LCSC; shaft length/flat taken from the Alps catalog only.
- LCSC stock/prices are as returned by the page fetch on 2026-10-12 and vary.
- Rocker: depth behind panel (approx 11 mm read off an image), DC rating at 16 V, KCD1-202-R stock, RA1-1A-DC-2-GL mechanicals, whether the LED version suits an unlit use.
- Battery packs: PCM ratings other than CM's 10 A, NTC presence/beta, outline of CM pack, prices, lead times, Australia shipping.
