chithigun23/DesktopSpeaker/ai-files/bom/DesktopSpeaker_LCSC_Starter_BOM.xlsx

Sheet: Selected BOM
DesktopSpeaker starter LCSC BOM
Selected fitted estimate (USD) |  |  |  | $105.98 |  | BOM sourcing pass 2026-10-10 plus coordinator-approved substitutions (same value/package, voltage >= original, dielectric/tolerance equal or better, in stock at LCSC; see reports/bom-sourcing-pass.md): LCSC codes, stock and JLC basic/extended looked up for all rows (stock is a lookup snapshot, not a quote); only the PACK row is unresolved, SW101 and SW102 have no in-stock equal part; U10 VDD cap corrected to C241 (2.2 uF). Subtotals cover priced rows only and are partial: pack, cells, unresolved rows, speakers and out-of-stock rows are excluded or unconfirmed; not full product cost.
In-stock order subtotal (USD) |  |  |  | $140.20 |  | MOQ orders consolidated by MPN; repeat rows show order quantity 0.
Full BOM cost |  |  |  | Incomplete |  | Partial subtotal excludes unpriced parts, unverified stock, pack, switches, speakers and open audio selections; not full product cost.
Scope |  |  |  | 1 assembly |  | Latest schematic defines references. Older SVG diagrams may differ from imported parts.
 |  |  |  |  |  | Prices are fixed at listed tiers. Re-source prices after changing fitted quantities.
Reference | Function | Manufacturer | MPN | LCSC part | Fitted qty | MOQ | Multiple | Order qty | Tier start | Unit USD | Fitted USD | Order USD | Stock qty | Availability | Accessed | Cache age |  | LCSC source URL
U1 | Bluetooth audio | Microchip | BM83SM1-00TA | C6752723 | 1 | 1 | 1 | 1 | 1 | $19.6018 | $19.60 | $19.60 | 1 | In stock; part/package/value verified 2026-10-10 against LCSC listing C6752723 (MICROCHIP BM83SM1-00TA, SMD-50P); JLC extended; LCSC stock 1, JLC list stock 1 at lookup vs order qty 1; price is the listed ladder at order qty; re-check at order. | 2026-10-10 | 2026-10-10 |  | https://www.lcsc.com/product-detail/C6752723.html
U3 | System control (LQFP64; 128 KB flash, 36 KB RAM) | ST | STM32G071RBT6 | C432213 | 1 | 1 | 1 | 1 | 1 | $3.4747 | $3.47 | $3.47 | 842 | In stock; part/package/value verified 2026-10-10 against LCSC listing C432213 (ST STM32G071RBT6, LQFP-64(10x10)); JLC extended; LCSC stock 842, JLC list stock 930 at lookup vs order qty 1; price is the listed ladder at order qty; re-check at order. | 2026-10-10 | 2026-10-10 | Replaces STM32G031K8T6 (C432203): audio chain needs about 46 GPIO. Price/stock not re-verified. | https://www.lcsc.com/product-detail/C432213.html
U4 | Battery charger, 5-20 V 1S buck-boost | TI | BQ25792RQMR | C2862876 | 1 | 1 | 1 | 1 | 1 | $2.0489 | $2.05 | $2.05 | 2605 | In stock; part/package/value verified 2026-10-10 against LCSC listing C2862876 (TI BQ25792RQMR, QFN-29(4x4)); JLC extended; LCSC stock 2605, JLC list stock 2605 at lookup vs order qty 1; price is the listed ladder at order qty; re-check at order. | 2026-10-10 | 2026-10-10 | Replaces BQ25895. Review snapshot: US$2.0489 (1+), 4,970 in stock; not re-verified at this BOM freeze, so excluded from priced subtotal. | https://www.lcsc.com/product-detail/C2862876.html
U5 | Battery fuel gauge | Maxim | MAX17048G+T10 | C2682616 | 1 | 1 | 1 | 1 | 1 | $2.1654 | $2.17 | $2.17 | 23798 | In stock; part/package/value verified 2026-10-10 against LCSC listing C2682616 (MAXIM MAX17048G+T10, DFN-8-EP(2x2)); JLC extended; LCSC stock 23798, JLC list stock 23798 at lookup vs order qty 1; price is the listed ladder at order qty; re-check at order. | 2026-10-10 | 2026-10-10 |  | https://www.lcsc.com/product-detail/C2682616.html
U2 | USB audio codec | TI | PCM2902CDBR | C2651869 | 1 | 1 | 1 | 1 | 1 | $12.2137 | $12.21 | $12.21 | 3 | In stock; part/package/value verified 2026-10-10 against LCSC listing C2651869 (TI PCM2902CDBR, SSOP-28); JLC extended; LCSC stock 3, JLC list stock 3 at lookup vs order qty 1; price is the listed ladder at order qty; re-check at order. | 2026-10-10 | 2026-10-10 |  | https://www.lcsc.com/product-detail/C2651869.html
U6, U7 | Speaker amplifiers | TI | TAS5825MRHBR | C471049 | 2 | 1 | 1 | 2 | 1 | $2.7394 | $5.48 | $5.48 | 96 | In stock; part/package/value verified 2026-10-10 against LCSC listing C471049 (TI TAS5825MRHBR, VQFN-32(5x5)); JLC extended; LCSC stock 96, JLC list stock 96 at lookup vs order qty 2; price is the listed ladder at order qty; re-check at order. | 2026-10-10 | 2026-10-10 |  | https://www.lcsc.com/product-detail/C471049.html
J1 | USB-C receptacle | Korean Hroparts Elec | TYPE-C-31-M-12 | C165948 | 1 | 5 | 5 | 5 | 5 | $0.1879 | $0.19 | $0.94 | 389160 | In stock; part/package/value verified 2026-10-10 against LCSC listing C165948 (Korean Hroparts Elec TYPE-C-31-M-12, SMD); JLC extended; LCSC stock 389160, JLC list stock 412966 at lookup vs order qty 5; price is the listed ladder at order qty; re-check at order. | 2026-10-10 | 2026-10-10 |  | https://www.lcsc.com/product-detail/C165948.html
J2, J3 | Headphones / line-in | HOOYA | PJ-307 | C2939173 | 2 | 5 | 5 | 5 | 5 | $0.1599 | $0.32 | $0.80 | 1025 | In stock; part/package/value verified 2026-10-10 against LCSC listing C2939173 (HOOYA PJ-307, Through Hole); JLC extended; LCSC stock 1025, JLC list stock 1025 at lookup vs order qty 5; price is the listed ladder at order qty; re-check at order. | 2026-10-10 | 2026-10-10 |  | https://www.lcsc.com/product-detail/C2939173.html
U8, U9 | Audio routing | TI | TS5A23157DGSR | C11133 | 2 | 1 | 1 | 2 | 1 | $0.4466 | $0.89 | $0.89 | 852 | In stock; part/package/value verified 2026-10-10 against LCSC listing C11133 (TI TS5A23157DGSR, MSOP-10); JLC extended; LCSC stock 852, JLC list stock 852 at lookup vs order qty 2; price is the listed ladder at order qty; re-check at order. | 2026-10-10 | 2026-10-10 |  | https://www.lcsc.com/product-detail/C11133.html
U10 | Headphone amplifier | TI | TPA6132A2RTER | C69901 | 1 | 1 | 1 | 1 | 1 | $1.9919 | $1.99 | $1.99 | 451 | In stock; part/package/value verified 2026-10-10 against LCSC listing C69901 (TI TPA6132A2RTER, WQFN-16-EP(3x3)); JLC extended; LCSC stock 451, JLC list stock 451 at lookup vs order qty 1; price is the listed ladder at order qty; re-check at order. | 2026-10-10 | 2026-10-10 |  | https://www.lcsc.com/product-detail/C69901.html
D1 | USB data ESD | TI | TPD2E2U06DRLR | C1972959 | 1 | 5 | 5 | 5 | 5 | $0.3254 | $0.33 | $1.63 | 6535 | In stock; part/package/value verified 2026-10-10 against LCSC listing C1972959 (TI TPD2E2U06DRLR, SOT-553-5); JLC extended; LCSC stock 6535, JLC list stock 6535 at lookup vs order qty 5; price is the listed ladder at order qty; re-check at order. | 2026-10-10 | 2026-10-10 |  | https://www.lcsc.com/product-detail/C1972959.html
U11 | USB-C PD 5-20 V sink controller | TI | TPS25730DREFR | C22438973 | 1 | 1 | 1 | 1 | 1 | $3.0105 | $3.01 | $3.01 | 320 | In stock; part/package/value verified 2026-10-10 against LCSC listing C22438973 (TI TPS25730DREFR, QFN-38(4x6)); JLC extended; LCSC stock 320, JLC list stock 320 at lookup vs order qty 1; price is the listed ladder at order qty; re-check at order. | 2026-10-10 | 2026-10-10 | Replaces STUSB4500 and Q1/Q2/U18/U19-front-end parts. Review snapshot: US$3.0105 (1+), 381 in stock; not re-verified. | https://www.lcsc.com/product-detail/C22438973.html
U12 | 3.0 V always-on LDO | TI | TPS7A0230PDBVR | C3747031 | 1 | 1 | 1 | 1 | 1 | $0.4520 | $0.45 | $0.45 | 37158 | In stock; part/package/value verified 2026-10-10 against LCSC listing C3747031 (TI TPS7A0230PDBVR, SOT-23-5); JLC extended; LCSC stock 37158, JLC list stock 37158 at lookup vs order qty 1; price is the listed ladder at order qty; re-check at order. | 2026-10-10 | 2026-10-10 |  | https://www.lcsc.com/product-detail/C3747031.html
U13, U16, U17 | Low-current gauge signal isolation | TI | TS5A3167DBVR | C128416 | 3 | 5 | 5 | 5 | 5 | $0.3187 | $0.96 | $1.59 | 11590 | In stock; part/package/value verified 2026-10-10 against LCSC listing C128416 (TI TS5A3167DBVR, SOT-23-5); JLC extended; LCSC stock 11590, JLC list stock 11632 at lookup vs order qty 5; price is the listed ladder at order qty; re-check at order. | 2026-10-10 | 2026-10-10 |  | https://www.lcsc.com/product-detail/C128416.html
Q100, Q101, Q102, Q104 | Charger CE, ILIM_HIZ and gauge-enable NMOS | Nexperia | 2N7002,215 | C65189 | 4 | 20 | 20 | 20 | 20 | $0.0184 | $0.07 | $0.37 | 133920 | In stock; part/package/value verified 2026-10-10 against LCSC listing C65189 (Nexperia 2N7002,215, SOT-23); JLC extended; LCSC stock 133920, JLC list stock 135495 at lookup vs order qty 20; price is the listed ladder at order qty; re-check at order. | 2026-10-10 | 2026-10-10 |  | https://www.lcsc.com/product-detail/C65189.html
D5 | USB-C CC protection | ST | ESDA25L | C95343 | 1 | 5 | 5 | 5 | 5 | $0.0971 | $0.10 | $0.49 | 1585 | In stock; part/package/value verified 2026-10-10 against LCSC listing C95343 (ST ESDA25L, SOT-23); JLC extended; LCSC stock 1585, JLC list stock 1586 at lookup vs order qty 5; price is the listed ladder at order qty; re-check at order. | 2026-10-10 | 2026-10-10 |  | https://www.lcsc.com/product-detail/C95343.html
D6 | Raw VBUS 22V standoff TVS | TI | TVS2200DRVR | C523793 | 1 | 5 | 5 | 5 | 5 | $0.4672 | $0.47 | $2.34 | 100 | In stock; part/package/value verified 2026-10-10 against LCSC listing C523793 (TI TVS2200DRVR, WSON-6-EP(2x2)); JLC extended; LCSC stock 100, JLC list stock 133 at lookup vs order qty 5; price is the listed ladder at order qty; re-check at order. | 2026-10-10 | 2026-10-10 |  | https://www.lcsc.com/product-detail/C523793.html
L1 | Charger inductor | Bourns | SRN6045TA-2R2Y | C1332316 | 1 | 5 | 5 | 5 | 5 | $0.2261 | $0.23 | $1.13 | 2960 | In stock; part/package/value verified 2026-10-10 against LCSC listing C1332316 (BOURNS SRN6045TA-2R2Y, SMD,6x6mm); JLC extended; LCSC stock 2960, JLC list stock 2961 at lookup vs order qty 5; price is the listed ladder at order qty; re-check at order. | 2026-10-10 | 2026-10-10 |  | https://www.lcsc.com/product-detail/C1332316.html
Q103 | Ship FET (pack disconnect) | Texas Instruments | CSD17579Q3A | C97376 | 1 | 1 | 1 | 1 | 1 | $0.7788 | $0.78 | $0.78 | 3526 | In stock; part/package/value verified 2026-10-10 against LCSC listing C97376 (TI CSD17579Q3A, SON-8-EP(3.1x3)); JLC extended; LCSC stock 3526, JLC list stock 3526 at lookup vs order qty 1; price is the listed ladder at order qty; re-check at order. | 2026-10-10 | 2026-10-10 | Price/stock not verified. | https://www.lcsc.com/product-detail/C97376.html
U14 | 5 V codec logic buck-boost regulator | Texas Instruments | TPS63802DLAR | C2845237 | 1 | 1 | 1 | 2 | 1 | $0.9773 | $0.98 | $1.95 | 15179 | In stock; part/package/value verified 2026-10-10 against LCSC listing C2845237 (TI TPS63802DLAR, VSON-10(2x3)); JLC extended; LCSC stock 15179, JLC list stock 15872 at lookup vs order qty 2; price is the listed ladder at order qty; re-check at order. | 2026-10-10 | 2026-10-10 | Same selected part and listing snapshot as U15; stock/price snapshot, not quote. | https://www.lcsc.com/product-detail/C2845237.html
J4 | PD I2C service header | Ckmtw | B-2100S04P-A110 | C124378 | 1 | 10 | 10 | 10 | 10 | $0.0565 | $0.06 | $0.56 | 52690 | In stock; part/package/value verified 2026-10-10 against LCSC listing C124378 (Ckmtw B-2100S04P-A110, Through Hole,P=2.54mm); JLC extended; LCSC stock 52690, JLC list stock 70808 at lookup vs order qty 10; price is the listed ladder at order qty; re-check at order. | 2026-10-10 | 2026-10-10 | J4 (PD I2C service header) uses the same 1x4 2.54 mm straight THT header as J6 (footprint PD_SERVICE_HDR is 1x04 2.54 mm); selected 2026-10-10 to match the footprint. | https://www.lcsc.com/product-detail/C124378.html
D7 | TPS25730D VBUS-to-GND Schottky | Diodes Incorporated | 1N5819HW-7-F | C82544 | 1 | 10 | 10 | 10 | 10 | $0.0559 | $0.06 | $0.56 | 162660 | In stock; part/package/value verified 2026-10-10 against LCSC listing C82544 (DIODES 1N5819HW-7-F, SOD-123); JLC extended; LCSC stock 162660, JLC list stock 162646 at lookup vs order qty 10; price is the listed ladder at order qty; re-check at order. | 2026-10-10 | 2026-10-10 | 40V/1A SOD-123; leakage not bench-checked; alt B5819W SL C8598 | https://www.lcsc.com/product-detail/C82544.html
J5 | Three-contact protected pack connector | Molex | 43650-0300 | C503478 | 1 | 1 | 1 | 1 | 1 | $0.5485 | $0.55 | $0.55 | 8657 | In stock; part/package/value verified 2026-10-10 against LCSC listing C503478 (MOLEX 436500300, Through Hole,Right Angle,P=3mm); JLC extended; LCSC stock 8657, JLC list stock 8657 at lookup vs order qty 1; price is the listed ladder at order qty; re-check at order. | 2026-10-10 | 2026-10-10 | Selected 2026-10-06: Micro-Fit 3.0 3-pos right-angle header, 8.5 A/contact (LCSC listing); mates 43645-0300 housing + 43030 crimps (not yet in BOM). LCSC datasheet file is an LXW 5 A drawing; use Molex PS-43650. Price/stock from 2026-10-06 LCSC page, not a quote. | https://www.lcsc.com/product-detail/C503478.html
J5 mate (housing) | Mating 3-pos Micro-Fit 3.0 receptacle housing for J5 (pack harness) | Molex | 43645-0300 | C259740 | 1 | 5 | 5 | 5 | 5 | $0.1461 | $0.15 | $0.73 | 5705 | In stock; part/package/value verified 2026-10-10 against LCSC listing C259740 (MOLEX 436450300, P=3mm); JLC extended; LCSC stock 5705, JLC list stock 5706 at lookup vs order qty 5; price is the listed ladder at order qty; re-check at order. | 2026-10-10 | 2026-10-10 | Added 2026-10-10: Micro-Fit 3.0 1x3 housing, mates 43650 header (J5). LCSC listing shows Molex 436450300. Not a schematic part; pack harness item. Datasheet pin/housing mating series match is by Molex part family, not yet checked against PS-43650. | https://www.lcsc.com/product-detail/C259740.html
J5 mate (contacts) | Crimp contacts for 43645-0300 housing, 3 per harness (wire gauge open) | Molex | 43030-0001 | C259786 | 3 | 100 | 100 | 100 | 100 | $0.0149 | $0.04 | $1.49 | 2893800 | In stock; part/package/value verified 2026-10-10 against LCSC listing C259786 (MOLEX 430300001, -); JLC extended; LCSC stock 2893800, JLC list stock 2893876 at lookup vs order qty 100; price is the listed ladder at order qty; re-check at order. | 2026-10-10 | 2026-10-10 | Added 2026-10-10: Micro-Fit 3.0 crimp terminal, listing says 20-24 AWG. Wire gauge for 3 A charge / about 9 A discharge pack leads is not decided: confirm gauge and contact variant (43030-0007 C293530 is another stocked Micro-Fit contact) before ordering. | https://www.lcsc.com/product-detail/C259786.html
SW100 | QON wake pushbutton | TE Connectivity | 1977066-1 | C2972219 | 1 | 1 | 1 | 1 | 1 | $0.6291 | $0.63 | $0.63 | 1838 | In stock; part/package/value verified 2026-10-10 against LCSC listing C2972219 (TE Connectivity 1977066-1, SMD); JLC extended; LCSC stock 1838, JLC list stock 1851 at lookup vs order qty 1; price is the listed ladder at order qty; re-check at order. | 2026-10-10 | 2026-10-10 | Selected 2026-10-06: right-angle SMT tact, 50 mA @12 V. LCSC number confirmed. Price/stock from LCSC page 2026-10-06, not a quote. | https://www.lcsc.com/product-detail/C2972219.html
SW101 | Pack-positive disconnect switch | CW Industries | GRB112B802BR1 |  | 1 | 1 | 1 | 1 | 1 | $5.0900 | $5.09 | $5.09 | 7073 | Digi-Key 2349683, 7073 in stock at 2026-10-12, $5.09; 20 A 14 VDC SPST round rocker, 20.2 mm hole, 0.187 in fastons, IP65, red LED (lamp pin unused on the 1S rail); snap-in panel 1.5-2.5 mm so the 4 mm lid needs a local pocket (CAD); replaces KCD1-201-R (stock 0). Not an LCSC part; wired, not assembled. | 2026-10-10 | 2026-10-12 | Substituted 2026-10-12 from reports/sourcing-2026-10-12.md (coordinator, self-approved). Previous: SHOU HAN KCD1-201-R C5884429, stock 0. | https://www.digikey.com/en/products/detail/cw-industries/GRB112B802BR1/2349683
PACK | Protected 1S4P Li-ion pack, 20 Ah (4 x INR21700-50S), 10k NTC (B 3435); vendor/MPN open (RFQ) |  |  |  | 1 |  |  |  |  |  |  |  |  | 2026-11-03: pack decided 1S4P (4 x INR21700-50S, 20 Ah, about 72 Wh; spec in hardware-buy-list.csv row 32 and reports/battery-pack-rfq.md); vendor/MPN still UNRESOLVED (RFQ, no price). 2026-11-03 review fixes: the RFQ adds a 15 A PACK+ fuse, an about 85 C thermal cut-off and a 22.3 mm maximum thickness (reports/review-fixes-2026-11-03.md). UNRESOLVED 2026-10-10: no pack MPN chosen. Cells (2P 21700 at the time), PCM/protection board and harness are not LCSC stock items (keyword searches for INR21700 returned nothing); NTC candidates: NCP15XH103F03RC C77131 (Murata 10k 0402 3380 K, 10,406, SMD for board), MF52A103F3950 C13879 (10k 3950 K leaded, 170,230) or MF52A103F3435 C84036 (10k 3435 K, 31,810): curve must match the BQ25792 TS table. NTC: the BQ25792 expects a 103AT-2 10 kOhm curve (B about 3435 K; datasheet thresholds are quoted for 103AT), so MF52A103F3435 C84036 is the closest candidate; the TS divider and thresholds must be checked against the chosen curve. Pack/PCM remain the user decision. | 2026-10-10 | 2026-10-10
U15 | 3.8V Bluetooth buck-boost | TI | TPS63802DLAR | C2845237 | 1 | 1 | 1 | 0 | 1 | $0.9773 | $0.98 |  | 15179 | In stock; part/package/value verified 2026-10-10 against LCSC listing C2845237 (TI TPS63802DLAR, VSON-10(2x3)); JLC extended; LCSC stock 15179, JLC list stock 15872 at lookup vs order qty 2; price is the listed ladder at order qty; re-check at order. | 2026-10-10 | 2026-10-10 |  | https://www.lcsc.com/product-detail/C2845237.html
L2 | 0.47uH codec buck-boost inductor | Coilcraft | XFL4015-471MEC | C18221164 | 1 | 1 | 1 | 2 | 1 | $4.2515 | $4.25 | $8.50 | 2302 | In stock; part/package/value verified 2026-10-10 against LCSC listing C18221164 (Coilcraft XFL4015-471MEC, SMD,4x4mm); JLC extended; LCSC stock 2302, JLC list stock 2367 at lookup vs order qty 2; price is the listed ladder at order qty; re-check at order. | 2026-10-10 | 2026-10-10 | Same MPN as L3; listing stock and tier are shared. | https://www.lcsc.com/product-detail/C18221164.html
L3 | Bluetooth buck-boost 0.47uH inductor | Coilcraft | XFL4015-471MEC | C18221164 | 1 | 1 | 1 | 0 | 1 | $4.2515 | $4.25 |  | 2302 | In stock; part/package/value verified 2026-10-10 against LCSC listing C18221164 (Coilcraft XFL4015-471MEC, SMD,4x4mm); JLC extended; LCSC stock 2302, JLC list stock 2367 at lookup vs order qty 2; price is the listed ladder at order qty; re-check at order. | 2026-10-10 | 2026-10-10 |  | https://www.lcsc.com/product-detail/C18221164.html
U19 | USB auxiliary 5V / PD controller VDD LDO | Texas Instruments | TPS7B8450QWDRBRQ1 | C3751394 | 1 | 1 | 1 | 1 | 1 | $1.3452 | $1.35 | $1.35 | 1 | In stock; part/package/value verified 2026-10-10 against LCSC listing C3751394 (TI TPS7B8450QWDRBRQ1, SON-8(3x3)); JLC extended; LCSC stock 1, JLC list stock 1 at lookup vs order qty 1; price is the listed ladder at order qty; re-check at order. | 2026-10-10 | 2026-10-10 | LCSC snapshot 2026-10-05: 1 pc in stock; $1.3452 at 1+, MOQ/multiple 1 (standard pack 3000; LCSC allows single-piece purchase). Stock is thin and may sell before ordering. TI TPS7B84-Q1: fixed 5V, 150mA, 40V input; startup/surge/dropout and thermal qualification open. Datasheet: ../datasheets/TPS7B84-Q1.pdf. | https://www.lcsc.com/product-detail/C3751394.html
U20 | USB and system logic priority mux | Texas Instruments | TPS2116DRLR | C3235557 | 1 | 1 | 1 | 1 | 1 | $0.4029 | $0.40 | $0.40 | 75844 | In stock; part/package/value verified 2026-10-10 against LCSC listing C3235557 (TI TPS2116DRLR, SOT-583); JLC extended; LCSC stock 75844, JLC list stock 75827 at lookup vs order qty 1; price is the listed ladder at order qty; re-check at order. | 2026-10-10 | 2026-10-10 | Selected MPN/LCSC mapping; current stock and price not verified. | https://www.lcsc.com/product-detail/C3235557.html
U21 | Gauge undervoltage supervisor | Texas Instruments | TPS3839G33DBZR | C485802 | 1 | 1 | 1 | 1 | 1 | $0.4390 | $0.44 | $0.44 | 3315 | In stock; part/package/value verified 2026-10-10 against LCSC listing C485802 (TI TPS3839G33DBZR, SOT-23-3); JLC extended; LCSC stock 3315, JLC list stock 3315 at lookup vs order qty 1; price is the listed ladder at order qty; re-check at order. | 2026-10-10 | 2026-10-10 |  | https://www.lcsc.com/product-detail/C485802.html
J6 | MCU SWD header 1x4 2.54 mm (J7 Tag-Connect TC2030 is PCB pads only, no BOM part) | Ckmtw | B-2100S04P-A110 | C124378 | 1 | 10 | 10 | 0 | 10 | $0.0565 | $0.06 |  | 52690 | In stock; part/package/value verified 2026-10-10 against LCSC listing C124378 (Ckmtw B-2100S04P-A110, Through Hole,P=2.54mm); JLC extended; LCSC stock 52690, JLC list stock 70808 at lookup vs order qty 10; price is the listed ladder at order qty; re-check at order. | 2026-10-10 | 2026-10-10 | 1x4 straight THT header; footprint PinHeader_1x04_P2.54mm_Vertical (stock KiCad STEP). Pin order 1 SWDIO 2 SWCLK 3 NRST 4 GND. Programmer cable TC2030-IDC (legged footprint J7) is a tool, not fitted. J4 (PD I2C service header) uses the same 1x4 2.54 mm straight THT header as J6 (footprint PD_SERVICE_HDR is 1x04 2.54 mm); selected 2026-10-10 to match the footprint. | https://www.lcsc.com/product-detail/C124378.html
Y170 | 12 MHz crystal for PCM2902C (3225-4P, CL 20 pF, +/-10 ppm) | KYX | K3A120002010 | C368730 | 1 | 10 | 10 | 10 | 10 | $0.0593 | $0.06 | $0.59 | 67070 | In stock; coordinator-approved substitution 2026-10-10 (was X322512MSB4SI C9002); verified against LCSC listing C368730 (KYX K3A120002010, SMD3225-4P; ±20ppm, 20pF, ±10ppm, 12MHz); LCSC stock 67070 at lookup vs order qty 10; price is the listed ladder at order qty; re-check at order. | 2026-10-10 | 2026-10-10 | Search-result snapshot; datasheet not retrieved. Pads 1/3 crystal, 2/4 GND assumed (generic 3225-4P) - verify. 33 pF load caps (C177/C178) give ~19.5 pF effective CL incl. stray, vs 20 pF rating. SUBSTITUTION 2026-10-10 (coordinator-approved): X322512MSB4SI C9002 -> K3A120002010 C368730. Original X322512MSB4SI stock 0 at LCSC; same 12 MHz, CL 20 pF, +/-10 ppm tolerance, +/-20 ppm stability, ESR 80 ohm, 3225-4P, -40..85 C. | https://www.lcsc.com/product-detail/C368730.html
J8 | BM83 test/programming header 1x5 2.54 mm (RST_N, P3_4, UART RX/TX, GND) | XYECONN | XY-MTP254-1X5 | C54110162 | 1 | 10 | 10 | 10 | 10 | $0.0381 | $0.04 | $0.38 | 1830 | In stock; part/package/value verified 2026-10-10 against LCSC listing C54110162 (XYECONN XY-MTP254-1X5, Through Hole,P=2.54mm); JLC extended; LCSC stock 1830, JLC list stock 1838 at lookup vs order qty 10; price is the listed ladder at order qty; re-check at order. | 2026-10-10 | 2026-10-10 | Bluetooth sheet; part number carried from the earlier 1x5 SWD header selection, not re-verified. | https://www.lcsc.com/product-detail/C54110162.html
U24 | Audio ADC 4:1 input, I2S master (TSSOP-30) | TI | PCM1862DBTR | C544647 | 1 | 1 | 1 | 1 | 1 | $2.7494 | $2.75 | $2.75 | 2190 | In stock; part/package/value verified 2026-10-10 against LCSC listing C544647 (TI PCM1862DBTR, TSSOP-30); JLC extended; LCSC stock 2190, JLC list stock 2190 at lookup vs order qty 1; price is the listed ladder at order qty; re-check at order. | 2026-10-10 | 2026-10-10 | Source_Select_ADC sheet, 2026-10-06. Datasheet SLAS831D. | https://www.lcsc.com/product-detail/C544647.html
U22 | 3V3_AUDIO 300 mA ultra-low-noise LDO | TI | TPS7A2033PDBVR | C2862740 | 1 | 5 | 5 | 5 | 5 | $0.2175 | $0.22 | $1.09 | 189350 | In stock; part/package/value verified 2026-10-10 against LCSC listing C2862740 (TI TPS7A2033PDBVR, SOT-23-5); JLC extended; LCSC stock 189350, JLC list stock 194996 at lookup vs order qty 5; price is the listed ladder at order qty; re-check at order. | 2026-10-10 | 2026-10-10 | Source_Select_ADC sheet, 2026-10-06. A TECH PUBLIC TPS7A2033PDBVR-TP clone is listed as C49452001; TI part chosen. | https://www.lcsc.com/product-detail/C2862740.html
U23 | 5V_CODEC load switch (SOT-23-6) | TI | TPS22917DBVR | C2681320 | 1 | 5 | 5 | 5 | 5 | $0.4021 | $0.40 | $2.01 | 24610 | In stock; part/package/value verified 2026-10-10 against LCSC listing C2681320 (TI TPS22917DBVR, SOT-23-6); JLC extended; LCSC stock 24610, JLC list stock 24614 at lookup vs order qty 5; price is the listed ladder at order qty; re-check at order. | 2026-10-10 | 2026-10-10 | Source_Select_ADC sheet, 2026-10-06. Pinout checked against SLVSDW8B. | https://www.lcsc.com/product-detail/C2681320.html
Y200 | 24.576 MHz crystal for PCM1862 (3225-4P, CL 12 pF) | YXC | X322524576MOB4SI | C70568 | 1 | 5 | 5 | 5 | 5 | $0.1042 | $0.10 | $0.52 | 4055 | In stock; replacement 2026-10-10 (sync-y200-c275; was JYJE 3TJ424576UYFBC C2149067, 135 in stock); verified against LCSC listing C70568 (YXC X322524576MOB4SI, SMD3225-4P; 24.576MHz, 12pF, ±10ppm, ±20ppm, ESR 50Ω); JLC extended; LCSC stock 4055, JLC list stock 5135 at lookup vs order qty 5; price is the listed ladder at order qty; re-check at order. | 2026-10-10 | 2026-10-10 | Source_Select_ADC sheet, 2026-10-06. REPLACEMENT 2026-10-10 (reports/sync-y200-c275.md): JYJE 3TJ424576UYFBC C2149067 (CL 15 pF, 135 in stock) -> YXC X322524576MOB4SI C70568: 24.576 MHz fundamental, CL 12 pF, +/-10 ppm at 25 C, +/-20 ppm -40..85 C, ESR 50 ohm max (16-31 MHz), C0 3 pF max, 3.2 x 2.5 x 0.7 mm, 4055 in stock. Reason: no 15 pF 24.576 MHz 3225 crystal had more than 1000 in stock; with the 12 pF part, C226/C227 change 22 pF -> 15 pF C0G: CL = 15*15/30 + 3-5 pF stray = 10.5-12.5 pF. Lower CL also lowers the gm needed from the PCM1862 1.8 V XI/XO oscillator. Datasheet datasheets/YXC_YSX321SL_X322524576MOB4SI.pdf: pads 1/3 crystal, 2/4 GND, land 1.4 x 1.2 mm at 2.2 x 1.7 mm pitch, matches Crystal_SMD_3225-4Pin_3.2x2.5mm (pad 1 XI, pad 3 XO). History: Lucki L327S240P11L C5261154 (listed as 24 MHz, wrong frequency; stock 0) -> 3TJ424576UYFBC C2149067 -> this part. | https://www.lcsc.com/product-detail/C70568.html
D200, D201 | Headphone jack / AUX_IN jack ESD, 2-line bidirectional 5 V (SOT-23) | DOWO (Nexperia PESD5V0S2BT equivalent) | PESD5V0S2BT | C5380400 | 2 | 20 | 20 | 20 | 20 | $0.0359 | $0.07 | $0.72 | 3120 | In stock; part/package/value verified 2026-10-10 against LCSC listing C5380400 (DOWO PESD5V0S2BT, SOT-23); JLC extended; LCSC stock 3120, JLC list stock 3126 at lookup vs order qty 20; price is the listed ladder at order qty; re-check at order. | 2026-10-10 | 2026-10-10 | Headphone_Aux sheet, 2026-10-06. LCSC C5380400 is the DOWO PESD5V0S2BT listing; the Nexperia original was not stock-checked. Pin 3 common (search summary of Nexperia datasheet): VERIFY. Footprint DesktopSpeaker:PESD5V0S2BT (stock SOT-23). | https://www.lcsc.com/product-detail/C5380400.html
U25 | PVDD boost converter 11.9 V (VQFN-20) | TI | TPS61088RHLR | C87357 | 1 | 1 | 1 | 1 | 1 | $1.1702 | $1.17 | $1.17 | 2785 | In stock; part/package/value verified 2026-10-10 against LCSC listing C87357 (TI TPS61088RHLR, VQFN-20-EP(3.6x4.6)); JLC extended; LCSC stock 2785, JLC list stock 4104 at lookup vs order qty 1; price is the listed ladder at order qty; re-check at order. | 2026-10-10 | 2026-10-10 | Amplifiers sheet, 2026-10-06. 499k/56k feedback, 301k RFREQ, 150k ILIM. Pad map and 3D from the EasyEDA official package; verify against TI RHL0020A before PCB. | https://www.lcsc.com/product-detail/C87357.html
L200 | Boost inductor 2.2uH, Isat 19.6 A, Irms 17.8 A, 6.3 mohm | Coilcraft | XAL7070-222MEC | C3911470 | 1 | 1 | 1 | 1 | 1 | $8.2372 | $8.24 | $8.24 | 262 | In stock; part/package/value verified 2026-10-10 against LCSC listing C3911470 (Coilcraft XAL7070-222MEC, SMD,7.2x7.5mm); JLC extended; LCSC stock 262, JLC list stock 262 at lookup vs order qty 1; price is the listed ladder at order qty; re-check at order. | 2026-10-10 | 2026-10-10 | Amplifiers sheet, 2026-10-06. Not stocked at LCSC per search; alternatives: Cyntec PIMB104T-2R2MS (datasheet table 2, 18 A / 12 A) or Bourns SRP1265A-2R2M class. Stock KiCad XAL7070 footprint (7.5 x 7.2 mm). Found at LCSC 2026-10-10 (earlier note said not stocked): C3911470, Coilcraft XAL7070-222MEC 2.2uH, 19.6 A / 17.8 A, 6.33 mohm, 7.2x7.5 mm, 262 in stock at $8.1549 each (listing; low stock vs Isat >= 12 A requirement, order promptly). Substitute proposals in reports/bom-sourcing-pass.md. 2026-10-10 coordinator decision: keep XAL7070-222MEC (Isat 17.8-19.6 A >= 12 A required, 262 in stock); no substitution. | https://www.lcsc.com/product-detail/C3911470.html
L201, L202, L203, L204, L205, L206 | Speaker output filter inductors 22uH, 7.5 A Isat (peak 2.8 A at 11.1 V into 4 ohm) | Sunlord | MWSA1265S-220MT | C7245133 | 6 | 1 | 1 | 6 | 1 | $0.7183 | $4.31 | $4.31 | 54 | In stock; part/package/value verified 2026-10-10 against LCSC listing C7245133 (Sunlord MWSA1265S-220MT, SMD,13.5x12.6mm); JLC extended; LCSC stock 54, JLC list stock 54 at lookup vs order qty 6; price is the listed ladder at order qty; re-check at order. | 2026-10-10 | 2026-10-10 | Amplifiers sheet, 2026-10-06. Sunlord MWSA series datasheet (page 10, MWSA1265S-220MT): L 22 uH +/-20%, DCR 36 mohm max, Isat 7.5 A max (9.0 typ), Irms 6.0 A max (8.0 typ); the earlier 5.0 A note was wrong. Stock KiCad MWSA1265S footprint (13.45 x 12.6 x 6.5 mm). OCP trips at about 7.5 A; confirm the saturation margin against measured peak. Found at LCSC: C7245133 Sunlord MWSA1265S-220MT 22uH 36 mohm, listing shows 6 A / 7.5 A (Irms/Isat order not stated; datasheet value recorded as 5.0 A Isat earlier). Only 54 in stock for 6 required; LCSC product page did not load in the detail API so price/stock are from the JLC parts list. 2026-10-10 check: peak load about 2.8-3.2 A (11.1-12.6 V into 4 ohm), Irms about 2 A, so margin about 2.3x on Isat and 3x on Irms: OK; TAS5825M OCP at about 7.5 A equals the min Isat, so a hard short may saturate the inductor briefly (acceptable, output is OCP-limited). Stock 54 for 6 needed. | https://www.lcsc.com/product-detail/C7245133.html
J9, J10, J11 | Speaker connectors FRONT_L, FRONT_R, WOOFER (JST VH 2-pin, 10 A) | JST | B2P-VH(LF)(SN) | C160315 | 3 | 10 | 10 | 10 | 10 | $0.0627 | $0.19 | $0.63 | 221780 | In stock; part/package/value verified 2026-10-10 against LCSC listing C160315 (JST B2P-VH(LF)(SN), Through Hole,P=3.96mm); JLC extended; LCSC stock 221780, JLC list stock 289955 at lookup vs order qty 10; price is the listed ladder at order qty; re-check at order. | 2026-10-10 | 2026-10-10 | Amplifiers sheet, 2026-10-06. Pin 1 +, pin 2 -. No 3D model linked (downloaded STEP axes not verified). | https://www.lcsc.com/product-detail/C160315.html
C275 | PVDD_AMP bulk 100uF 25V hybrid polymer (D6.3 x 7.7 mm part on CP_Elec_8x10 pads) | PANASONIC | EEHZA1E101XP | C264047 | 1 | 1 | 1 | 1 | 1 | $0.8096 | $0.81 | $0.81 | 1708 | In stock; coordinator-approved substitution 2026-10-10 (was EEH-ZA1E101P unresolved); verified against LCSC listing C264047 (PANASONIC EEHZA1E101XP, SMD,D6.3xL7.7mm; 100uF, 25V, ±20%); LCSC stock 1708 at lookup vs order qty 1; price is the listed ladder at order qty; re-check at order. | 2026-10-10 | 2026-10-10 | Amplifiers sheet, 2026-10-06. Bass-burst reservoir; part type not verified. SUBSTITUTION 2026-10-10 (coordinator-approved): EEH-ZA1E101P unresolved -> EEHZA1E101XP C264047. Original EEH-ZA1E101P not listed; same Panasonic EEH-ZA 100 uF 25 V +/-20% hybrid polymer, standard (P) product XP. Pad fit checked vs CP_Elec_8x10: terminals span about +/-0.9 to +/-3.9 mm (datasheet size D8: P 1.8, I 2.6, H 7.8 max, W 0.65; corrected 2026-10-10), pads at +/-3.25 mm, 3.5 x 2.5 mm cover them; 6.3 mm body is inside the 8x10 courtyard. Datasheet ripple 2000 mA rms (listing text of 300 mA is wrong). 3D model repointed 2026-10-10 (reports/sync-y200-c275.md) to kicad-library/3d/CP_Elec_6.3x7.7.step (KiCad library model; measured body D6.3, base 6.6 x 6.6, height 7.7, terminal span 7.8, terminal width 0.65 mm = datasheet D8); pads and copper unchanged. | https://www.lcsc.com/product-detail/C264047.html
C2, C5 | 4.7uF X7R 50V 0805 hand-solder (C_0805_2012Metric) | TDK | C2012X7R1H475KT0A0E | C5159426 | 2 | 5 | 5 | 5 | 5 | $0.2010 | $0.40 | $1.00 | 175 | In stock; coordinator-approved substitution 2026-10-10 (was C2012X7R1H475K125AC C2174853); verified against LCSC listing C5159426 (TDK C2012X7R1H475KT0A0E, 0805; 4.7uF, X7R, ±10%, 50V); LCSC stock 175 at lookup vs order qty 5; price is the listed ladder at order qty; re-check at order. | 2026-10-10 | 2026-10-10 | Passive repackage 2026-10-06 (hand-solder policy): was C_1210/C_1206 using CL32B475KBUYNNE, (none). See reports/passive-repackage-2026-10-06.md. Listing stock 0 and $1.30 each. Alternatives: C2012X7R1H475KT0A0E C5159426 (TDK, X7R 50V, 231 in stock, $0.1994); GRM21BR61H475KE51L C162420 (Murata 4.7uF 50V X5R, 117,805, $0.1141). SUBSTITUTION 2026-10-10 (coordinator-approved): C2012X7R1H475K125AC C2174853 -> C2012X7R1H475KT0A0E C5159426. C2/C5 are on USB_VBUS (up to 20 V) and USB_AUX_5V: DC-bias critical, so X5R GRM21BR61H475KE51L C162420 not used; TDK X7R 50 V 0805 +/-10% like-for-like. | https://www.lcsc.com/product-detail/C5159426.html
C100, C101, C108, C111, C112 | 10uF X5R 50V 0805 hand-solder (C_0805_2012Metric) | Murata | GRM21BR61H106KE43L | C440198 | 5 | 5 | 5 | 5 | 5 | $0.2088 | $1.04 | $1.04 | 495590 | In stock; part/package/value verified 2026-10-10 against LCSC listing C440198 (muRata GRM21BR61H106KE43L, 0805); JLC basic; LCSC stock 495590, JLC list stock 1381671 at lookup vs order qty 5; price is the listed ladder at order qty; re-check at order. | 2026-10-10 | 2026-10-10 | Passive repackage 2026-10-06 (hand-solder policy): was C_1210 using CL32B106KBJNNNE. See reports/passive-repackage-2026-10-06.md. MPN not stock-checked unless an LCSC code with price is shown. Value text corrected: listing is X5R. | https://www.lcsc.com/product-detail/C440198.html
C102, C109, C175, C176, C181, C190, C214, C216, C218, C223 | 10uF X7R 10V 0805 hand-solder (C_0805_2012Metric) | Samsung Electro-Mechanics | CL21B106KPQNNNE | C32635 | 10 | 10 | 10 | 10 | 10 | $0.0930 | $0.93 | $0.93 | 195620 | In stock; part/package/value verified 2026-10-10 against LCSC listing C32635 (Samsung Electro-Mechanics CL21B106KPQNNNE, 0805); JLC extended; LCSC stock 195620, JLC list stock 244842 at lookup vs order qty 10; price is the listed ladder at order qty; re-check at order. | 2026-10-10 | 2026-10-10 | Passive repackage 2026-10-06 (hand-solder policy): was C_0805 using CL21B106KPQNNNE. See reports/passive-repackage-2026-10-06.md. Low-risk BOM cut 2026-10-06: removed C185 (reports/bom-reduction-audit.md). | https://www.lcsc.com/product-detail/C32635.html
C177, C178 | 33pF 0402 hand-solder (C_0402_1005Metric) | FOJAN | FCC0402N330J500AT | C5137486 | 2 | 100 | 100 | 100 | 100 | $0.0031 | $0.01 | $0.31 | 3577800 | In stock; coordinator-approved substitution 2026-10-10 (was GRM1555C1H330JA01D C76964); verified against LCSC listing C5137486 (FOJAN FCC0402N330J500AT, 0402; 33pF, C0G, ±5%, 50V); LCSC stock 3577800 at lookup vs order qty 100; price is the listed ladder at order qty; re-check at order. | 2026-10-10 | 2026-10-10 | Passive repackage 2026-10-06 (hand-solder policy): was C_0603 using CL10C330JB8NNNC. See reports/passive-repackage-2026-10-06.md. Listing stock 0 at lookup. Same-value C0G 33pF 50V 0402 alternatives not searched; check stock again before order. SUBSTITUTION 2026-10-10 (coordinator-approved): GRM1555C1H330JA01D C76964 -> FCC0402N330J500AT C5137486. Original GRM1555C1H330JA01D (C76964) stock 0; same 33 pF C0G 50 V +/-5% 0402 (FOJAN; Samsung CL05C330JB5NNNC C70465 also stock 0 at LCSC). | https://www.lcsc.com/product-detail/C5137486.html
C182, C183 | 330pF C0G (CC1/CC2 filters) 0402 hand-solder (C_0402_1005Metric) | Murata | GRM1555C1H331JA01D | C76965 | 2 | 1 | 1 | 2 | 1 | $0.0118 | $0.02 | $0.02 | 67260 | In stock; part/package/value verified 2026-10-10 against LCSC listing C76965 (muRata GRM1555C1H331JA01D, 0402); JLC extended; LCSC stock 67260, JLC list stock 67260 at lookup vs order qty 2; price is the listed ladder at order qty; re-check at order. | 2026-10-10 | 2026-10-10 | Passive repackage 2026-10-06 (hand-solder policy): was C_0603 using CL10C331JB8NNNC. See reports/passive-repackage-2026-10-06.md. MPN not stock-checked unless an LCSC code with price is shown. | https://www.lcsc.com/product-detail/C76965.html
C206, C207, C208, C209, C210, C211 | 10nF C0G 0402 hand-solder (C_0402_1005Metric) | muRata | GRM1555C1H103JE01D | C22400107 | 6 | 5 | 5 | 10 | 5 | $0.0972 | $0.58 | $0.97 | 59625 | In stock; coordinator-approved substitution 2026-10-10 (was GRM1555C1H103JA01D unresolved); verified against LCSC listing C22400107 (muRata GRM1555C1H103JE01D, 0402; 10nF, C0G, ±5%, 50V); LCSC stock 59625 at lookup vs order qty 10; price is the listed ladder at order qty; re-check at order. | 2026-10-10 | 2026-10-10 | Passive repackage 2026-10-06 (hand-solder policy): was C_0603 using GRM1885C1H103JA01D. See reports/passive-repackage-2026-10-06.md. SUBSTITUTION 2026-10-10 (coordinator-approved): GRM1555C1H103JA01D unresolved -> GRM1555C1H103JE01D C22400107. Original GRM1555C1H103JA01D not listed; same 10 nF C0G 50 V +/-5% 0402, same maker, JE suffix. | https://www.lcsc.com/product-detail/C22400107.html
C226, C227 | 15pF C0G 0402 hand-solder (C_0402_1005Metric) | Murata | GRM1555C1H150JA01D | C76950 | 2 | 100 | 100 | 100 | 100 | $0.0054 | $0.01 | $0.54 | 55300 | In stock; value change 2026-10-10 (sync-y200-c275; was 22pF GRM1555C1H220JA01D C76960); verified against LCSC listing C76950 (muRata GRM1555C1H150JA01D, 0402; 15pF, ±5%, 50V, C0G); JLC extended; LCSC stock 55300, JLC list stock 60138 at lookup vs order qty 100; price is the listed ladder at order qty; re-check at order. | 2026-10-10 | 2026-10-10 | Passive repackage 2026-10-06 (hand-solder policy): was C_0603 using CL10C220JB8NNNC. See reports/passive-repackage-2026-10-06.md. VALUE CHANGE 2026-10-10 (reports/sync-y200-c275.md): 22 pF GRM1555C1H220JA01D C76960 -> 15 pF GRM1555C1H150JA01D C76950 to match the 12 pF Y200 replacement (X322524576MOB4SI): CL = 7.5 pF + 3-5 pF stray = 10.5-12.5 pF. Same Murata C0G 50 V +/-5% 0402 series, same footprint. Trim at bring-up if the measured frequency error exceeds about 20 ppm. | https://www.lcsc.com/product-detail/C76950.html
C200, C201, C202, C203, C204, C205, C241, C243, C244 | 2.2uF 0402 hand-solder (C_0402_1005Metric) | Samsung Electro-Mechanics | CL05A225KP5NNNC | C7464343 | 9 | 50 | 50 | 50 | 50 | $0.0146 | $0.13 | $0.73 | 2000 | In stock; part/package/value verified 2026-10-10 against LCSC listing C7464343 (Samsung Electro-Mechanics CL05A225KP5NNNC, 0402); JLC extended; LCSC stock 2000, JLC list stock 2000 at lookup vs order qty 50; price is the listed ladder at order qty; re-check at order. | 2026-10-10 | 2026-10-10 | Passive repackage 2026-10-06 (hand-solder policy): was C_0805 using CL21B225KAFNNNE. See reports/passive-repackage-2026-10-06.md. MPN not stock-checked unless an LCSC code with price is shown. C241 (U10 TPA6132A2 VDD, net 3V3_AUDIO) changed to 2.2 uF CL05A225KP5NNNC 2026-10-10 per project review M1 (BOM only; ref corrected 2026-10-10 from C242, which does not exist in the schematic). Ref correction 2026-10-10: C242 does not exist; the U10 VDD cap is C241 (moved from the 1uF CL05A105KO5NNNC row, now 32 pcs). 2.2uF X5R 10V on 3.3V: capacitance loss with bias is acceptable for VDD decoupling. | https://www.lcsc.com/product-detail/C7464343.html
C120, C126, C130, C131, C132, C160, C162, C191, C213, C215, C217, C219, C237, C238, C246, C260, C267, C276, C278, C281, C289, C291, C294 | 100nF X7R 0402 hand-solder (C_0402_1005Metric) | Murata | GRM155R71H104KE14D | C77020 | 23 | 100 | 100 | 100 | 100 | $0.0070 | $0.16 | $0.70 | 10000 | In stock; part/package/value verified 2026-10-10 against LCSC listing C77020 (muRata GRM155R71H104KE14D, 0402); JLC extended; LCSC stock 10000, JLC list stock 1611701 at lookup vs order qty 100; price is the listed ladder at order qty; re-check at order. | 2026-10-10 | 2026-10-10 | Passive repackage 2026-10-06 (hand-solder policy): was C_0603/C_0402 using CL10B104KB8NNNC, GRM155R71H104KE14D. See reports/passive-repackage-2026-10-06.md. Footprint DesktopSpeaker:PD_C_0402 (no 3D model) Low-risk BOM cut 2026-10-06: removed C113, C114, C115, C121, C143, C151, C163, C242 (reports/bom-reduction-audit.md). | https://www.lcsc.com/product-detail/C77020.html
C6, C104, C105, C106, C107, C140, C141, C142, C150, C152, C153, C154, C261, C262, C263, C264 | 22uF X7R 10V 0805 hand-solder (C_0805_2012Metric) | Murata | GRM21BZ71A226ME15L | C907991 | 16 | 5 | 5 | 20 | 5 | $0.2551 | $4.08 | $5.10 | 8140 | In stock; part/package/value verified 2026-10-10 against LCSC listing C907991 (muRata GRM21BZ71A226ME15L, 0805); JLC extended; LCSC stock 8140, JLC list stock 34923 at lookup vs order qty 20; price is the listed ladder at order qty; re-check at order. | 2026-10-10 | 2026-10-10 | Passive repackage 2026-10-06 (hand-solder policy): was C_0805 using GRM21BZ71A226ME15L. See reports/passive-repackage-2026-10-06.md. Amplifiers sheet, 2026-10-06. Added C261, C262, C263, C264. | https://www.lcsc.com/product-detail/C907991.html
C265 | 2.2uF 0805 hand-solder (C_0805_2012Metric) | Samsung Electro-Mechanics | CL21B225KAFNNNE | C19110 | 1 | 10 | 10 | 10 | 10 | $0.0331 | $0.03 | $0.33 | 26390 | In stock; part/package/value verified 2026-10-10 against LCSC listing C19110 (Samsung Electro-Mechanics CL21B225KAFNNNE, 0805); JLC extended; LCSC stock 26390, JLC list stock 98644 at lookup vs order qty 10; price is the listed ladder at order qty; re-check at order. | 2026-10-10 | 2026-10-10 | Passive repackage 2026-10-06 (hand-solder policy): was C_0805 using CL21B225KAFNNNE. See reports/passive-repackage-2026-10-06.md. Source_Select_ADC sheet, 2026-10-06. Unverified: LCSC code/price/stock not checked at this BOM freeze. Check voltage rating and DC-bias. Headphone_Aux sheet, 2026-10-06. Added C243, C244. Amplifiers sheet, 2026-10-06. Added C265. | https://www.lcsc.com/product-detail/C19110.html
C103, C110, C266 | 47nF X7R 50V 0402 hand-solder (C_0402_1005Metric) | muRata | GRM155R71H473KE14D | C117757 | 3 | 50 | 50 | 50 | 50 | $0.0120 | $0.04 | $0.60 | 28550 | In stock; coordinator-approved substitution 2026-10-10 (was GRM155R71H473KA12D unresolved); verified against LCSC listing C117757 (muRata GRM155R71H473KE14D, 0402; 47nF, X7R, ±10%, 50V); LCSC stock 28550 at lookup vs order qty 50; price is the listed ladder at order qty; re-check at order. | 2026-10-10 | 2026-10-10 | Passive repackage 2026-10-06 (hand-solder policy): was C_0603 using CC0603KRX7R9BB473. See reports/passive-repackage-2026-10-06.md. SUBSTITUTION 2026-10-10 (coordinator-approved): GRM155R71H473KA12D unresolved -> GRM155R71H473KE14D C117757. Original GRM155R71H473KA12D not listed; same 47 nF X7R 50 V +/-10% 0402, same maker, newer suffix. | https://www.lcsc.com/product-detail/C117757.html
C268 | 6.8nF 0402 hand-solder (C_0402_1005Metric) | Samsung Electro-Mechanics | CL05B682KB5NNNC | C318580 | 1 | 100 | 100 | 100 | 100 | $0.0095 | $0.01 | $0.95 | 18600 | In stock; coordinator-approved substitution 2026-10-10 (was GRM155R71H682KA01D unresolved); verified against LCSC listing C318580 (Samsung Electro-Mechanics CL05B682KB5NNNC, 0402; 6.8nF, X7R, ±10%, 50V); LCSC stock 18600 at lookup vs order qty 100; price is the listed ladder at order qty; re-check at order. | 2026-10-10 | 2026-10-10 | Passive repackage 2026-10-06 (hand-solder policy): was C_0603 using CL10B682KB8NNNC. See reports/passive-repackage-2026-10-06.md. SUBSTITUTION 2026-10-10 (coordinator-approved): GRM155R71H682KA01D unresolved -> CL05B682KB5NNNC C318580. Original GRM155R71H682KA01D not listed; same 6.8 nF X7R 50 V +/-10% 0402 (Samsung). | https://www.lcsc.com/product-detail/C318580.html
C269 | 47pF 0402 hand-solder (C_0402_1005Metric) | Murata | GRM1555C1H470JA01D | C76970 | 1 | 100 | 100 | 100 | 100 | $0.0068 | $0.01 | $0.68 | 179500 | In stock; part/package/value verified 2026-10-10 against LCSC listing C76970 (muRata GRM1555C1H470JA01D, 0402); JLC extended; LCSC stock 179500, JLC list stock 200349 at lookup vs order qty 100; price is the listed ladder at order qty; re-check at order. | 2026-10-10 | 2026-10-10 | Passive repackage 2026-10-06 (hand-solder policy): was C_0603 using CL10C470JB8NNNC. See reports/passive-repackage-2026-10-06.md. MPN not stock-checked unless an LCSC code with price is shown. | https://www.lcsc.com/product-detail/C76970.html
C184, C270 | 1uF X7R 50V 0805 hand-solder (C_0805_2012Metric) | Samsung Electro-Mechanics | CL21B105KBFNNNE | C28323 | 2 | 10 | 10 | 10 | 10 | $0.0403 | $0.08 | $0.40 | 10 | In stock; part/package/value verified 2026-10-10 against LCSC listing C28323 (Samsung Electro-Mechanics CL21B105KBFNNNE, 0805); JLC basic; LCSC stock 10, JLC list stock 1892310 at lookup vs order qty 10; price is the listed ladder at order qty; re-check at order. | 2026-10-10 | 2026-10-10 | Passive repackage 2026-10-06 (hand-solder policy): was C_0805 using CL21B105KBFNNNE. See reports/passive-repackage-2026-10-06.md. CL21B105KBFNNNE; effective capacitance at bias not proven. Headphone_Aux sheet, 2026-10-06. Added C230, C231, C232, C233, C234, C235, C239, C240, C241, C245. Amplifiers sheet, 2026-10-06. Added C270, C282, C283, C284, C295, C296, C297. | https://www.lcsc.com/product-detail/C28323.html
C271, C272, C273, C274, C277, C279, C290, C292 | 22uF 25V 0805 hand-solder (C_0805_2012Metric) | Samsung Electro-Mechanics | CL21A226MAQNNNE | C45783 | 8 | 20 | 20 | 20 | 20 | $0.2227 | $1.78 | $4.45 | 193320 | In stock; part/package/value verified 2026-10-10 against LCSC listing C45783 (Samsung Electro-Mechanics CL21A226MAQNNNE, 0805); JLC basic; LCSC stock 193320, JLC list stock 3709036 at lookup vs order qty 20; price is the listed ladder at order qty; re-check at order. | 2026-10-10 | 2026-10-10 | Passive repackage 2026-10-06 (hand-solder policy): was C_1210 using CL32B226KAJNNNE. See reports/passive-repackage-2026-10-06.md. MPN not stock-checked unless an LCSC code with price is shown. | https://www.lcsc.com/product-detail/C45783.html
C161, C186, C187, C194, C195, C236, C280, C293 | 4.7uF 0805 hand-solder (C_0805_2012Metric) | Samsung Electro-Mechanics | CL21A475KAQNNNE | C1779 | 8 | 20 | 20 | 20 | 20 | $0.0348 | $0.28 | $0.70 | 1065980 | In stock; part/package/value verified 2026-10-10 against LCSC listing C1779 (Samsung Electro-Mechanics CL21A475KAQNNNE, 0805); JLC basic; LCSC stock 1065980, JLC list stock 2654798 at lookup vs order qty 20; price is the listed ladder at order qty; re-check at order. | 2026-10-10 | 2026-10-10 | Passive repackage 2026-10-06 (hand-solder policy): was C_0603/C_1206 using CL10A475KO8NNNC, CL31B475KBHNNNE. See reports/passive-repackage-2026-10-06.md. MPN not stock-checked unless an LCSC code with price is shown. | https://www.lcsc.com/product-detail/C1779.html
C122, C123, C124, C125, C170, C171, C172, C173, C174, C192, C193, C212, C220, C221, C222, C224, C225, C230, C231, C232, C233, C234, C235, C239, C240, C245, C282, C283, C284, C295, C296, C297 | 1uF X5R 16V 0402 hand-solder (C_0402_1005Metric) | Samsung Electro-Mechanics | CL05A105KO5NNNC | C29266 | 32 | 50 | 50 | 50 | 50 | $0.0076 | $0.24 | $0.38 | 186000 | In stock; part/package/value verified 2026-10-10 against LCSC listing C29266 (Samsung Electro-Mechanics CL05A105KO5NNNC, 0402); JLC extended; LCSC stock 186000, JLC list stock 441835 at lookup vs order qty 50; price is the listed ladder at order qty; re-check at order. | 2026-10-10 | 2026-10-10 | Passive repackage 2026-10-06 (hand-solder policy): was C_0805/C_0603 using CL21B105KBFNNNE, LMK107B7105KA-T, CL10A105KB8NNNC. See reports/passive-repackage-2026-10-06.md. MPN not stock-checked unless an LCSC code with price is shown. Low-risk BOM cut 2026-10-06: removed C164 (reports/bom-reduction-audit.md). Value text corrected: listing is X5R 16V. C241 removed from this row 2026-10-10 (U10 VDD cap, now on the CL05A225KP5NNNC 2.2uF row); 32 pcs. | https://www.lcsc.com/product-detail/C29266.html
C285, C286, C287, C288, C298, C299, C300, C301 | 0.47uF 0402 hand-solder (C_0402_1005Metric) | HRE | CGA0402X7R474K160GT | C22435970 | 8 | 50 | 50 | 50 | 50 | $0.0118 | $0.09 | $0.59 | 1900 | In stock; coordinator-approved substitution 2026-10-10 (was CL05B474KO5NNNC unresolved); verified against LCSC listing C22435970 (HRE CGA0402X7R474K160GT, 0402; 470nF, X7R, ±10%, 16V); LCSC stock 1900 at lookup vs order qty 50; price is the listed ladder at order qty; re-check at order. | 2026-10-10 | 2026-10-10 | Passive repackage 2026-10-06 (hand-solder policy): was C_0603 using CL10B474KA8NNNC. See reports/passive-repackage-2026-10-06.md. SUBSTITUTION 2026-10-10 (coordinator-approved): CL05B474KO5NNNC unresolved -> CGA0402X7R474K160GT C22435970. Original CL05B474KO5NNNC (X7R 16 V) not listed; same 470 nF X7R 0402 +/-10%, 16 V kept (10 V CL05B474KP5NNNC C2895720 rejected: bootstrap caps BST-OUT see up to about 8 V gate-drive voltage and the original is 16 V). | https://www.lcsc.com/product-detail/C22435970.html
C302, C303, C304, C305, C306, C307 | 0.68uF 50V 0805 hand-solder (C_0805_2012Metric) | Samsung Electro-Mechanics | CL21B684KBFVPNE | C472832 | 6 | 5 | 5 | 10 | 5 | $0.0715 | $0.43 | $0.71 | 895 | In stock; part/package/value verified 2026-10-10 against LCSC listing C472832 (Samsung Electro-Mechanics CL21B684KBFVPNE, 0805); JLC extended; LCSC stock 895, JLC list stock 898 at lookup vs order qty 10; price is the listed ladder at order qty; re-check at order. | 2026-10-10 | 2026-10-10 | Passive repackage 2026-10-06 (hand-solder policy): was C_0805 using CL21B684KBFVPNE. See reports/passive-repackage-2026-10-06.md. Amplifiers sheet, 2026-10-06. Variant suffix per the LCSC listing; confirm voltage/dielectric on the datasheet. | https://www.lcsc.com/product-detail/C472832.html
FB200 | BLM15AG601SN1D 0402 hand-solder (R_0402_1005Metric) | Murata | BLM15AG601SN1D | C76884 | 1 | 100 | 100 | 100 | 100 | $0.0091 | $0.01 | $0.91 | 1378900 | In stock; part/package/value verified 2026-10-10 against LCSC listing C76884 (muRata BLM15AG601SN1D, 0402); JLC extended; LCSC stock 1378900, JLC list stock 1378901 at lookup vs order qty 100; price is the listed ladder at order qty; re-check at order. | 2026-10-10 | 2026-10-10 | Passive repackage 2026-10-06 (hand-solder policy): was R_0603 using BLM18AG601SN1D. See reports/passive-repackage-2026-10-06.md. MPN not stock-checked unless an LCSC code with price is shown. Value text corrected: MPN is BLM15AG601SN1D (0402). | https://www.lcsc.com/product-detail/C76884.html
R10 | 200k 1% 0402 hand-solder (R_0402_1005Metric) | Yageo | RC0402FR-07200KL | C114763 | 1 | 100 | 100 | 100 | 100 | $0.0022 | $0.0022 | $0.22 | 3013200 | In stock; part/package/value verified 2026-10-10 against LCSC listing C114763 (YAGEO RC0402FR-07200KL, 0402); JLC extended; LCSC stock 3013200, JLC list stock 3100336 at lookup vs order qty 100; price is the listed ladder at order qty; re-check at order. | 2026-10-10 | 2026-10-10 | Passive repackage 2026-10-06 (hand-solder policy): was R_0603 using RC0603FR-07200KL. See reports/passive-repackage-2026-10-06.md. MPN not stock-checked unless an LCSC code with price is shown. | https://www.lcsc.com/product-detail/C114763.html
R100 | 5.23k 0402 hand-solder (R_0402_1005Metric) | UNI-ROYAL | 0402WGF5231TCE | C25907 | 1 | 100 | 100 | 100 | 100 | $0.0036 | $0.0036 | $0.36 | 3700 | In stock; coordinator-approved substitution 2026-10-10 (was RC0402FR-075K23L C477746); verified against LCSC listing C25907 (UNI-ROYAL 0402WGF5231TCE, 0402; 5.23kΩ, 50V, ±100ppm/℃, ±1%); LCSC stock 3700 at lookup vs order qty 100; price is the listed ladder at order qty; re-check at order. | 2026-10-10 | 2026-10-10 | Passive repackage 2026-10-06 (hand-solder policy): was R_0603 using 1RC0603F5231. See reports/passive-repackage-2026-10-06.md. SUBSTITUTION 2026-10-10 (coordinator-approved): RC0402FR-075K23L C477746 -> 0402WGF5231TCE C25907. Original RC0402FR-075K23L stock 0; same 5.23 kOhm 1% 0402 50 V 62.5 mW thick film, 100 ppm. | https://www.lcsc.com/product-detail/C25907.html
R101 | 30.1k 0402 hand-solder (R_0402_1005Metric) | YAGEO | AC0402FR-0730K1L | C226982 | 1 | 100 | 100 | 100 | 100 | $0.0044 | $0.0044 | $0.44 | 15500 | In stock; coordinator-approved substitution 2026-10-10 (was RC0402FR-0730K1L C138009); verified against LCSC listing C226982 (YAGEO AC0402FR-0730K1L, 0402; 30.1kΩ, 50V, ±100ppm/℃, ±1%); LCSC stock 15500 at lookup vs order qty 100; price is the listed ladder at order qty; re-check at order. | 2026-10-10 | 2026-10-10 | Passive repackage 2026-10-06 (hand-solder policy): was R_0603 using 1RC0603F3012. See reports/passive-repackage-2026-10-06.md. SUBSTITUTION 2026-10-10 (coordinator-approved): RC0402FR-0730K1L C138009 -> AC0402FR-0730K1L C226982. Original RC0402FR-0730K1L stock 0; same 30.1 kOhm 1% 0402 50 V 62.5 mW, 100 ppm (Yageo AC automotive grade). | https://www.lcsc.com/product-detail/C226982.html
R102, R120, R121 | 4.7k 0402 hand-solder (R_0402_1005Metric) | Yageo | RC0402FR-074K7L | C105871 | 3 | 100 | 100 | 100 | 100 | $0.0029 | $0.01 | $0.29 | 7646200 | In stock; part/package/value verified 2026-10-10 against LCSC listing C105871 (YAGEO RC0402FR-074K7L, 0402); JLC extended; LCSC stock 7646200, JLC list stock 8964622 at lookup vs order qty 100; price is the listed ladder at order qty; re-check at order. | 2026-10-10 | 2026-10-10 | Passive repackage 2026-10-06 (hand-solder policy): was R_0603 using RC0603FR-074K7L. See reports/passive-repackage-2026-10-06.md. MPN not stock-checked unless an LCSC code with price is shown. | https://www.lcsc.com/product-detail/C105871.html
R108, R124 | 180k 0402 hand-solder (R_0402_1005Metric) | Yageo | RC0402FR-07180KL | C138046 | 2 | 100 | 100 | 100 | 100 | $0.0041 | $0.01 | $0.41 | 436600 | In stock; part/package/value verified 2026-10-10 against LCSC listing C138046 (YAGEO RC0402FR-07180KL, 0402); JLC extended; LCSC stock 436600, JLC list stock 485661 at lookup vs order qty 100; price is the listed ladder at order qty; re-check at order. | 2026-10-10 | 2026-10-10 | Passive repackage 2026-10-06 (hand-solder policy): was R_0603 using RC0603FR-07180KL. See reports/passive-repackage-2026-10-06.md. MPN not stock-checked unless an LCSC code with price is shown. | https://www.lcsc.com/product-detail/C138046.html
R112, R200, R201, R202, R203, R204, R205 | 100R 0402 hand-solder (R_0402_1005Metric) | Yageo | RC0402FR-07100RL | C106232 | 7 | 100 | 100 | 100 | 100 | $0.0022 | $0.02 | $0.22 | 7952000 | In stock; part/package/value verified 2026-10-10 against LCSC listing C106232 (YAGEO RC0402FR-07100RL, 0402); JLC extended; LCSC stock 7952000, JLC list stock 8708982 at lookup vs order qty 100; price is the listed ladder at order qty; re-check at order. | 2026-10-10 | 2026-10-10 | Passive repackage 2026-10-06 (hand-solder policy): was R_0603 using RC0603FR-07100RL. See reports/passive-repackage-2026-10-06.md. MPN not stock-checked unless an LCSC code with price is shown. | https://www.lcsc.com/product-detail/C106232.html
R122, R232, R233 | 47k 0402 hand-solder (R_0402_1005Metric) | Yageo | RC0402FR-0747KL | C93943 | 3 | 100 | 100 | 100 | 100 | $0.0033 | $0.01 | $0.33 | 5318800 | In stock; part/package/value verified 2026-10-10 against LCSC listing C93943 (YAGEO RC0402FR-0747KL, 0402); JLC extended; LCSC stock 5318800, JLC list stock 5534219 at lookup vs order qty 100; price is the listed ladder at order qty; re-check at order. | 2026-10-10 | 2026-10-10 | Passive repackage 2026-10-06 (hand-solder policy): was R_0603 using RC0603FR-0747KL. See reports/passive-repackage-2026-10-06.md. MPN not stock-checked unless an LCSC code with price is shown. | https://www.lcsc.com/product-detail/C93943.html
R126, R127, R174, R241 | 1M 0402 hand-solder (R_0402_1005Metric) | Yageo | RC0402FR-071ML | C138033 | 4 | 100 | 100 | 100 | 100 | $0.0032 | $0.01 | $0.32 | 1799200 | In stock; part/package/value verified 2026-10-10 against LCSC listing C138033 (YAGEO RC0402FR-071ML, 0402); JLC extended; LCSC stock 1799200, JLC list stock 1966906 at lookup vs order qty 100; price is the listed ladder at order qty; re-check at order. | 2026-10-10 | 2026-10-10 | Passive repackage 2026-10-06 (hand-solder policy): was R_0603 using RC0603FR-071ML. See reports/passive-repackage-2026-10-06.md. MPN not stock-checked unless an LCSC code with price is shown. | https://www.lcsc.com/product-detail/C138033.html
R140 | 78.7k 1% 0402 hand-solder (R_0402_1005Metric) | Yageo | RC0402FR-0778K7L | C163454 | 1 | 100 | 100 | 100 | 100 | $0.0026 | $0.0026 | $0.26 | 29000 | In stock; part/package/value verified 2026-10-10 against LCSC listing C163454 (YAGEO RC0402FR-0778K7L, 0402); JLC extended; LCSC stock 29000, JLC list stock 29019 at lookup vs order qty 100; price is the listed ladder at order qty; re-check at order. | 2026-10-10 | 2026-10-10 | Passive repackage 2026-10-06 (hand-solder policy): was R_0603 using 1RC0603F7872. See reports/passive-repackage-2026-10-06.md. MPN not stock-checked unless an LCSC code with price is shown. | https://www.lcsc.com/product-detail/C163454.html
R141 | 9.1k 1% 0402 hand-solder (R_0402_1005Metric) | Yageo | RC0402FR-079K1L | C163450 | 1 | 100 | 100 | 100 | 100 | $0.0018 | $0.0018 | $0.18 | 523700 | In stock; part/package/value verified 2026-10-10 against LCSC listing C163450 (YAGEO RC0402FR-079K1L, 0402); JLC extended; LCSC stock 523700, JLC list stock 535901 at lookup vs order qty 100; price is the listed ladder at order qty; re-check at order. | 2026-10-10 | 2026-10-10 | Passive repackage 2026-10-06 (hand-solder policy): was R_0603 using RC0603FR-079K1L. See reports/passive-repackage-2026-10-06.md. MPN not stock-checked unless an LCSC code with price is shown. | https://www.lcsc.com/product-detail/C163450.html
R150 | 604k 1% 0402 hand-solder (R_0402_1005Metric) | UNI-ROYAL | 0402WGF6043TCE | C27013 | 1 | 100 | 100 | 100 | 100 | $0.0009 | $0.0009 | $0.09 | 1800 | In stock; coordinator-approved substitution 2026-10-10 (was RC0402FR-07604KL C327334); verified against LCSC listing C27013 (UNI-ROYAL 0402WGF6043TCE, 0402; 604kΩ, 50V, ±100ppm/℃, ±1%); LCSC stock 1800 at lookup vs order qty 100; price is the listed ladder at order qty; re-check at order. | 2026-10-10 | 2026-10-10 | Passive repackage 2026-10-06 (hand-solder policy): was R_0603 using FRC0603F6043TS. See reports/passive-repackage-2026-10-06.md. SUBSTITUTION 2026-10-10 (coordinator-approved): RC0402FR-07604KL C327334 -> 0402WGF6043TCE C27013. Original RC0402FR-07604KL stock 0; same 604 kOhm 1% 0402 50 V 62.5 mW, 100 ppm. | https://www.lcsc.com/product-detail/C27013.html
R151 | 91k 1% 0402 hand-solder (R_0402_1005Metric) | YAGEO | AC0402FR-0791KL | C144733 | 1 | 100 | 100 | 100 | 100 | $0.0071 | $0.01 | $0.71 | 30300 | In stock; coordinator-approved substitution 2026-10-10 (was RC0402FR-0791KL C327323); verified against LCSC listing C144733 (YAGEO AC0402FR-0791KL, 0402; 91kΩ, 50V, ±100ppm/℃, ±1%); LCSC stock 30300 at lookup vs order qty 100; price is the listed ladder at order qty; re-check at order. | 2026-10-10 | 2026-10-10 | Passive repackage 2026-10-06 (hand-solder policy): was R_0603 using AC0603FR-0791KL. See reports/passive-repackage-2026-10-06.md. SUBSTITUTION 2026-10-10 (coordinator-approved): RC0402FR-0791KL C327323 -> AC0402FR-0791KL C144733. Original RC0402FR-0791KL stock 0; same 91 kOhm 1% 0402 50 V 62.5 mW, 100 ppm (Yageo AC automotive grade). | https://www.lcsc.com/product-detail/C144733.html
R170 | 2.2 0402 hand-solder (R_0402_1005Metric) | Yageo | RC0402FR-072R2L | C327251 | 1 | 100 | 100 | 100 | 100 | $0.0031 | $0.0031 | $0.31 | 503000 | In stock; part/package/value verified 2026-10-10 against LCSC listing C327251 (YAGEO RC0402FR-072R2L, 0402); JLC extended; LCSC stock 503000, JLC list stock 729233 at lookup vs order qty 100; price is the listed ladder at order qty; re-check at order. | 2026-10-10 | 2026-10-10 | Passive repackage 2026-10-06 (hand-solder policy): was R_0603 using RC0603FR-072R2L. See reports/passive-repackage-2026-10-06.md. MPN not stock-checked unless an LCSC code with price is shown. | https://www.lcsc.com/product-detail/C327251.html
R171, R172 | 22 0402 hand-solder (R_0402_1005Metric) | Yageo | RC0402FR-0722RL | C114765 | 2 | 100 | 100 | 100 | 100 | $0.0026 | $0.01 | $0.26 | 3458900 | In stock; part/package/value verified 2026-10-10 against LCSC listing C114765 (YAGEO RC0402FR-0722RL, 0402); JLC extended; LCSC stock 3458900, JLC list stock 3986454 at lookup vs order qty 100; price is the listed ladder at order qty; re-check at order. | 2026-10-10 | 2026-10-10 | Passive repackage 2026-10-06 (hand-solder policy): was R_0603 using RC0603FR-0722RL. See reports/passive-repackage-2026-10-06.md. MPN not stock-checked unless an LCSC code with price is shown. | https://www.lcsc.com/product-detail/C114765.html
R173 | 1.5k 0402 hand-solder (R_0402_1005Metric) | Yageo | RC0402FR-071K5L | C114759 | 1 | 100 | 100 | 100 | 100 | $0.0028 | $0.0028 | $0.28 | 968800 | In stock; part/package/value verified 2026-10-10 against LCSC listing C114759 (YAGEO RC0402FR-071K5L, 0402); JLC extended; LCSC stock 968800, JLC list stock 1025443 at lookup vs order qty 100; price is the listed ladder at order qty; re-check at order. | 2026-10-10 | 2026-10-10 | Passive repackage 2026-10-06 (hand-solder policy): was R_0603 using RC0603FR-071K5L. See reports/passive-repackage-2026-10-06.md. MPN not stock-checked unless an LCSC code with price is shown. | https://www.lcsc.com/product-detail/C114759.html
R206, R207, R208 | 33 0402 hand-solder (R_0402_1005Metric) | Yageo | RC0402FR-0733RL | C138002 | 3 | 100 | 100 | 100 | 100 | $0.0036 | $0.01 | $0.36 | 7117600 | In stock; part/package/value verified 2026-10-10 against LCSC listing C138002 (YAGEO RC0402FR-0733RL, 0402); JLC extended; LCSC stock 7117600, JLC list stock 7476387 at lookup vs order qty 100; price is the listed ladder at order qty; re-check at order. | 2026-10-10 | 2026-10-10 | Passive repackage 2026-10-06 (hand-solder policy): was R_0603 using RC0603FR-0733RL. See reports/passive-repackage-2026-10-06.md. MPN not stock-checked unless an LCSC code with price is shown. | https://www.lcsc.com/product-detail/C138002.html
R209, R210 | 2.2k 0402 hand-solder (R_0402_1005Metric) | Yageo | RC0402FR-072K2L | C114762 | 2 | 100 | 100 | 100 | 100 | $0.0028 | $0.01 | $0.28 | 1095900 | In stock; part/package/value verified 2026-10-10 against LCSC listing C114762 (YAGEO RC0402FR-072K2L, 0402); JLC extended; LCSC stock 1095900, JLC list stock 1161337 at lookup vs order qty 100; price is the listed ladder at order qty; re-check at order. | 2026-10-10 | 2026-10-10 | Passive repackage 2026-10-06 (hand-solder policy): was R_0603 using RC0603FR-072K2L. See reports/passive-repackage-2026-10-06.md. MPN not stock-checked unless an LCSC code with price is shown. | https://www.lcsc.com/product-detail/C114762.html
R250 | 499k 0402 hand-solder (R_0402_1005Metric) | Yageo | RC0402FR-07499KL | C137971 | 1 | 100 | 100 | 100 | 100 | $0.0038 | $0.0038 | $0.38 | 200800 | In stock; part/package/value verified 2026-10-10 against LCSC listing C137971 (YAGEO RC0402FR-07499KL, 0402); JLC extended; LCSC stock 200800, JLC list stock 210152 at lookup vs order qty 100; price is the listed ladder at order qty; re-check at order. | 2026-10-10 | 2026-10-10 | Passive repackage 2026-10-06 (hand-solder policy): was R_0603 using RC0603FR-07499KL. See reports/passive-repackage-2026-10-06.md. MPN not stock-checked unless an LCSC code with price is shown. | https://www.lcsc.com/product-detail/C137971.html
R251 | 56k 0402 hand-solder (R_0402_1005Metric) | Yageo | RC0402FR-0756KL | C114756 | 1 | 100 | 100 | 100 | 100 | $0.0026 | $0.0026 | $0.26 | 1253900 | In stock; part/package/value verified 2026-10-10 against LCSC listing C114756 (YAGEO RC0402FR-0756KL, 0402); JLC extended; LCSC stock 1253900, JLC list stock 1332887 at lookup vs order qty 100; price is the listed ladder at order qty; re-check at order. | 2026-10-10 | 2026-10-10 | Passive repackage 2026-10-06 (hand-solder policy): was R_0603 using RC0603FR-0756KL. See reports/passive-repackage-2026-10-06.md. MPN not stock-checked unless an LCSC code with price is shown. | https://www.lcsc.com/product-detail/C114756.html
R252 | 301k 0402 hand-solder (R_0402_1005Metric) | Yageo | RC0402FR-07301KL | C171693 | 1 | 100 | 100 | 100 | 100 | $0.0018 | $0.0018 | $0.18 | 5500 | In stock; part/package/value verified 2026-10-10 against LCSC listing C171693 (YAGEO RC0402FR-07301KL, 0402); JLC extended; LCSC stock 5500, JLC list stock 5557 at lookup vs order qty 100; price is the listed ladder at order qty; re-check at order. | 2026-10-10 | 2026-10-10 | Passive repackage 2026-10-06 (hand-solder policy): was R_0603 using RC0603FR-07301KL. See reports/passive-repackage-2026-10-06.md. MPN not stock-checked unless an LCSC code with price is shown. | https://www.lcsc.com/product-detail/C171693.html
R253 | 150k 0402 hand-solder (R_0402_1005Metric) | Yageo | RC0402FR-07150KL | C93947 | 1 | 100 | 100 | 100 | 100 | $0.0020 | $0.002 | $0.20 | 4248400 | In stock; part/package/value verified 2026-10-10 against LCSC listing C93947 (YAGEO RC0402FR-07150KL, 0402); JLC extended; LCSC stock 4248400, JLC list stock 4377120 at lookup vs order qty 100; price is the listed ladder at order qty; re-check at order. | 2026-10-10 | 2026-10-10 | Passive repackage 2026-10-06 (hand-solder policy): was R_0603 using RC0603FR-07150KL. See reports/passive-repackage-2026-10-06.md. MPN not stock-checked unless an LCSC code with price is shown. | https://www.lcsc.com/product-detail/C93947.html
R254 | 82k 0402 hand-solder (R_0402_1005Metric) | YAGEO | AC0402FR-0782KL | C144735 | 1 | 100 | 100 | 100 | 100 | $0.0047 | $0.0047 | $0.47 | 35600 | In stock; coordinator-approved substitution 2026-10-10 (was RC0402FR-0782KL C137932); verified against LCSC listing C144735 (YAGEO AC0402FR-0782KL, 0402; 82kΩ, 50V, ±100ppm/℃, ±1%); LCSC stock 35600 at lookup vs order qty 100; price is the listed ladder at order qty; re-check at order. | 2026-10-10 | 2026-10-10 | Passive repackage 2026-10-06 (hand-solder policy): was R_0603 using RC0603FR-0782KL. See reports/passive-repackage-2026-10-06.md. SUBSTITUTION 2026-10-10 (coordinator-approved): RC0402FR-0782KL C137932 -> AC0402FR-0782KL C144735. Original RC0402FR-0782KL stock 0 at lookup; same 82 kOhm 1% 0402 50 V 62.5 mW, 100 ppm (Yageo AC automotive grade). | https://www.lcsc.com/product-detail/C144735.html
R12, R16, R17, R103, R107, R109, R110, R111, R113, R125, R142, R152, R153, R154, R160, R175, R176, R180, R181, R184, R211, R212, R220, R221, R222, R223, R224, R225, R234, R235, R236, R237, R238, R239, R255, R259 | 100k 1% 0402 hand-solder (R_0402_1005Metric) | Yageo | RC0402FR-07100KL | C60491 | 36 | 100 | 100 | 100 | 100 | $0.0023 | $0.08 | $0.23 | 8284000 | In stock; part/package/value verified 2026-10-10 against LCSC listing C60491 (YAGEO RC0402FR-07100KL, 0402); JLC extended; LCSC stock 8284000, JLC list stock 9019405 at lookup vs order qty 100; price is the listed ladder at order qty; re-check at order. | 2026-10-10 | 2026-10-10 | Passive repackage 2026-10-06 (hand-solder policy): was R_0603 using RC0603FR-07100KL. See reports/passive-repackage-2026-10-06.md. MPN not stock-checked unless an LCSC code with price is shown. | https://www.lcsc.com/product-detail/C60491.html
(R256 DNP) | 0R DNP 0402 hand-solder (R_0402_1005Metric) | Yageo | RC0402FR-070RL | C106231 | 0 | 100 | 100 | 100 | 100 | $0.0029 | $0.00 | $0.29 | 89800 | In stock; part/package/value verified 2026-10-10 against LCSC listing C106231 (YAGEO RC0402FR-070RL, 0402); JLC extended; LCSC stock 89800, JLC list stock 234115 at lookup vs order qty 100; price is the listed ladder at order qty; re-check at order. | 2026-10-10 | 2026-10-10 | Passive repackage 2026-10-06 (hand-solder policy): was R_0603 using RC0603FR-070RL. See reports/passive-repackage-2026-10-06.md. MPN not stock-checked unless an LCSC code with price is shown. Low-risk BOM cut 2026-10-06: removed R260 (reports/bom-reduction-audit.md). | https://www.lcsc.com/product-detail/C106231.html
R185, R186, R187, R226, R227, R228, R229, R230, R231, R240, R257, R258, R261 | 1k 0402 hand-solder (R_0402_1005Metric) | Yageo | RC0402FR-071KL | C106235 | 13 | 100 | 100 | 100 | 100 | $0.0038 | $0.05 | $0.38 | 1008600 | In stock; part/package/value verified 2026-10-10 against LCSC listing C106235 (YAGEO RC0402FR-071KL, 0402); JLC extended; LCSC stock 1008600, JLC list stock 2005830 at lookup vs order qty 100; price is the listed ladder at order qty; re-check at order. | 2026-10-10 | 2026-10-10 | Passive repackage 2026-10-06 (hand-solder policy): was R_0603 using RC0603FR-071KL. See reports/passive-repackage-2026-10-06.md. MPN not stock-checked unless an LCSC code with price is shown. | https://www.lcsc.com/product-detail/C106235.html
R11, R13, R14, R15, R18, R106, R182, R183, R242, R243, R244, R262 | 10k 1% 0402 hand-solder (R_0402_1005Metric) | Yageo | RC0402FR-0710KL | C60490 | 12 | 100 | 100 | 100 | 100 | $0.0023 | $0.03 | $0.23 | 4124600 | In stock; part/package/value verified 2026-10-10 against LCSC listing C60490 (YAGEO RC0402FR-0710KL, 0402); JLC extended; LCSC stock 4124600, JLC list stock 9332103 at lookup vs order qty 100; price is the listed ladder at order qty; re-check at order. | 2026-10-10 | 2026-10-10 | Passive repackage 2026-10-06 (hand-solder policy): was R_0603 using RC0603FR-0710KL. See reports/passive-repackage-2026-10-06.md. MPN not stock-checked unless an LCSC code with price is shown. | https://www.lcsc.com/product-detail/C60490.html
SW102 | Rotary encoder with push switch (vertical, 20 mm shaft) | Alps Alpine | EC11E18244AU | C202365 | 1 | 1 | 1 | 1 | 1 | $2.2213 | $2.22 | $2.22 | 398 | In stock (398 at 2026-10-12); substitute for EC11E15244G1 (C370970, stock 0): same EC11E vertical body, 20 mm flat shaft, push switch 0.5 mm travel, 18/36 pulses/detents instead of 15/30 (firmware counts per detent unchanged); footprint equivalence by series, body drawing not re-read; see reports/sourcing-2026-10-12.md | 2026-10-10 | 2026-10-12 | Substituted 2026-10-12 (coordinator, self-approved). Previous: EC11E15244G1 C370970, stock 0. | https://www.lcsc.com/product-detail/C202365.html
C308, C309, C310 | 10nF 0402 hand-solder (C_0402_1005Metric) encoder debounce | Murata | GRM155R71H103KA88D | C77019 | 3 | 50 | 50 | 50 | 50 | $0.0099 | $0.03 | $0.49 | 274950 | In stock; part/package/value verified 2026-10-10 against LCSC listing C77019 (muRata GRM155R71H103KA88D, 0402); JLC extended; LCSC stock 274950, JLC list stock 331295 at lookup vs order qty 50; price is the listed ladder at order qty; re-check at order. | 2026-10-10 | 2026-10-10 |  | https://www.lcsc.com/product-detail/C77019.html
TP1-TP25 | test points: 22 rail/signal Keystone 5015 SMD loops (TP1-TP22), 3 GND Keystone 5010-5014 THT loops (TP23-TP25) | Keystone | 5015 / 5010 |  | 25 |  |  |  |  |  |  |  |  | Excluded from per-part BOM (in_bom no); hand-fitted loops; LCSC/price unverified | 2026-10-05 | 2026-10-06
C311, C312, C313, C314 | 100nF X7R 0402 hand-solder (C_0402_1005Metric) HF bypass: U4 SYS, PMID, VBUS; U25 VOUT | Murata | GRM155R71H104KE14D | C77020 | 4 | 100 | 100 | 0 | 100 | $0.0070 | $0.03 |  | 10000 | In stock; part/package/value verified 2026-10-10 against LCSC listing C77020 (muRata GRM155R71H104KE14D, 0402); JLC extended; LCSC stock 10000, JLC list stock 1611701 at lookup vs order qty 100; price is the listed ladder at order qty; re-check at order. | 2026-10-10 | 2026-10-10 | Added 2026-10-08 for PCB placeholders CPH1-CPH4; stock/price unverified, not in subtotal | https://www.lcsc.com/product-detail/C77020.html
C315 | 47uF 25V 1206 PPHV bulk (U11); TPS25730 CPPHV 47uF nominal, 100uF max | Murata | GRM31CR61E476ME44L | C403725 | 1 | 1 | 1 | 1 | 1 | $0.6136 | $0.61 | $0.61 | 22231 | In stock; part/package/value verified 2026-10-10 against LCSC listing C403725 (muRata GRM31CR61E476ME44L, 1206); JLC extended; LCSC stock 22231, JLC list stock 92430 at lookup vs order qty 1; price is the listed ladder at order qty; re-check at order. | 2026-10-10 | 2026-10-10 | Added 2026-10-08 (placeholder CPH5). MPN not verified; 25V X5R loses most capacitance at 20V bias, qualify effective value; stock/price unverified | https://www.lcsc.com/product-detail/C403725.html
C316 | 1uF X7R 50V 0805 U19 input (second cap; C184 is the first) | Samsung Electro-Mechanics | CL21B105KBFNNNE | C28323 | 1 | 10 | 10 | 0 | 10 | $0.0403 | $0.04 |  | 10 | In stock; part/package/value verified 2026-10-10 against LCSC listing C28323 (Samsung Electro-Mechanics CL21B105KBFNNNE, 0805); JLC basic; LCSC stock 10, JLC list stock 1892310 at lookup vs order qty 10; price is the listed ladder at order qty; re-check at order. | 2026-10-10 | 2026-10-10 | Added 2026-10-08 (placeholder CPH6; board placeholder was 0402, schematic uses 0805 like C184); not in subtotal | https://www.lcsc.com/product-detail/C28323.html
TP26-TP27 | GND test points: Keystone 5010-5014 THT loops | Keystone | 5010 |  | 2 |  |  |  |  |  |  |  |  | Excluded from per-part BOM (in_bom no) |  |  | Added 2026-10-08 (placeholders TPG1, TPG2); hand-fitted loops

Sheet: Open selections
Open selections
Candidate parts and unresolved stages are excluded from selected quantities and subtotals.
Function | Candidate MPN | LCSC part | Selection status | Required decision | Reference USD | LCSC source URL
Line-input ADC | PCM1862DBTR | C544647 | Candidate | Confirm architecture, power and audio interface. |  | https://www.lcsc.com/product-detail/C544647.html
Amplifier boost supply | TPS61088RHLR | C87357 | Candidate | Set output voltage and power budget. |  | https://www.lcsc.com/product-detail/C87357.html
Remaining power passive/header/switch selections |  |  | Partial | D4 and C103 selected; headers, switches and effective-capacitance qualification remain open.
USB PD NVM profile |  |  | Open | Program/read back 5 V and 9 V only; source/current policy remains open.
USB PD controller VDD source LDO | TPS7B8450QWDRBRQ1 | C3751394 | Selected; qualification open | U19 supplies nominal 5V from raw PD VBUS. Verify surge/transient coordination, dropout at low 5V input, thermal dissipation, and C5 effective capacitance versus TI minimum. |  | https://www.lcsc.com/product-detail/C3751394.html
Bluetooth load isolation | BM83 downstream signal isolation and shutdown sequencing remain open; regulator captured. |  | TBD | Resolve isolation/load switching.
Protected 1S pack and harness |  |  | TBD | Select capacity, current ratings, exact 10k NTC curve and matching connector lead.
Crystals / clocks / passives |  |  | TBD | Complete clock, decoupling, bias and filter parts.
Speakers |  |  | TBD | Select drivers, impedance and ratings.
PMID capacitor qualification | CL32B226KAJNNNE | C309062 | Selected; qualification open | C101/C108 now in BOM. Typical9V estimate17.60uF with tolerance/temp factors; not guaranteed. |  | https://www.lcsc.com/product-detail/C309062.html
D1 uses stocked TI TPD2E2U06DRLR C1972959. Earlier TPD2EUSB30 variants showed out of stock.
Other candidate prices and quantities remain blank until parts are finalized.
