chithigun23/DesktopSpeaker/ai-files/cad/parts/nd65pg-1.png

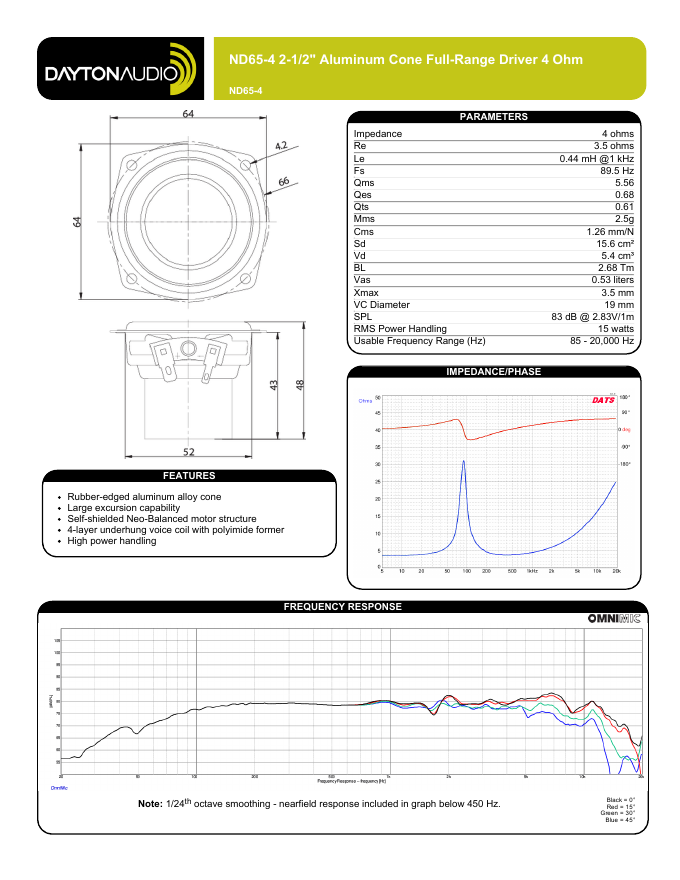
ai-files/cad/parts/nd65pg-1.png
