chithigun23/DesktopSpeaker/ai-files/pcb/work-route3/evidence/rt3-tiling-parts.png

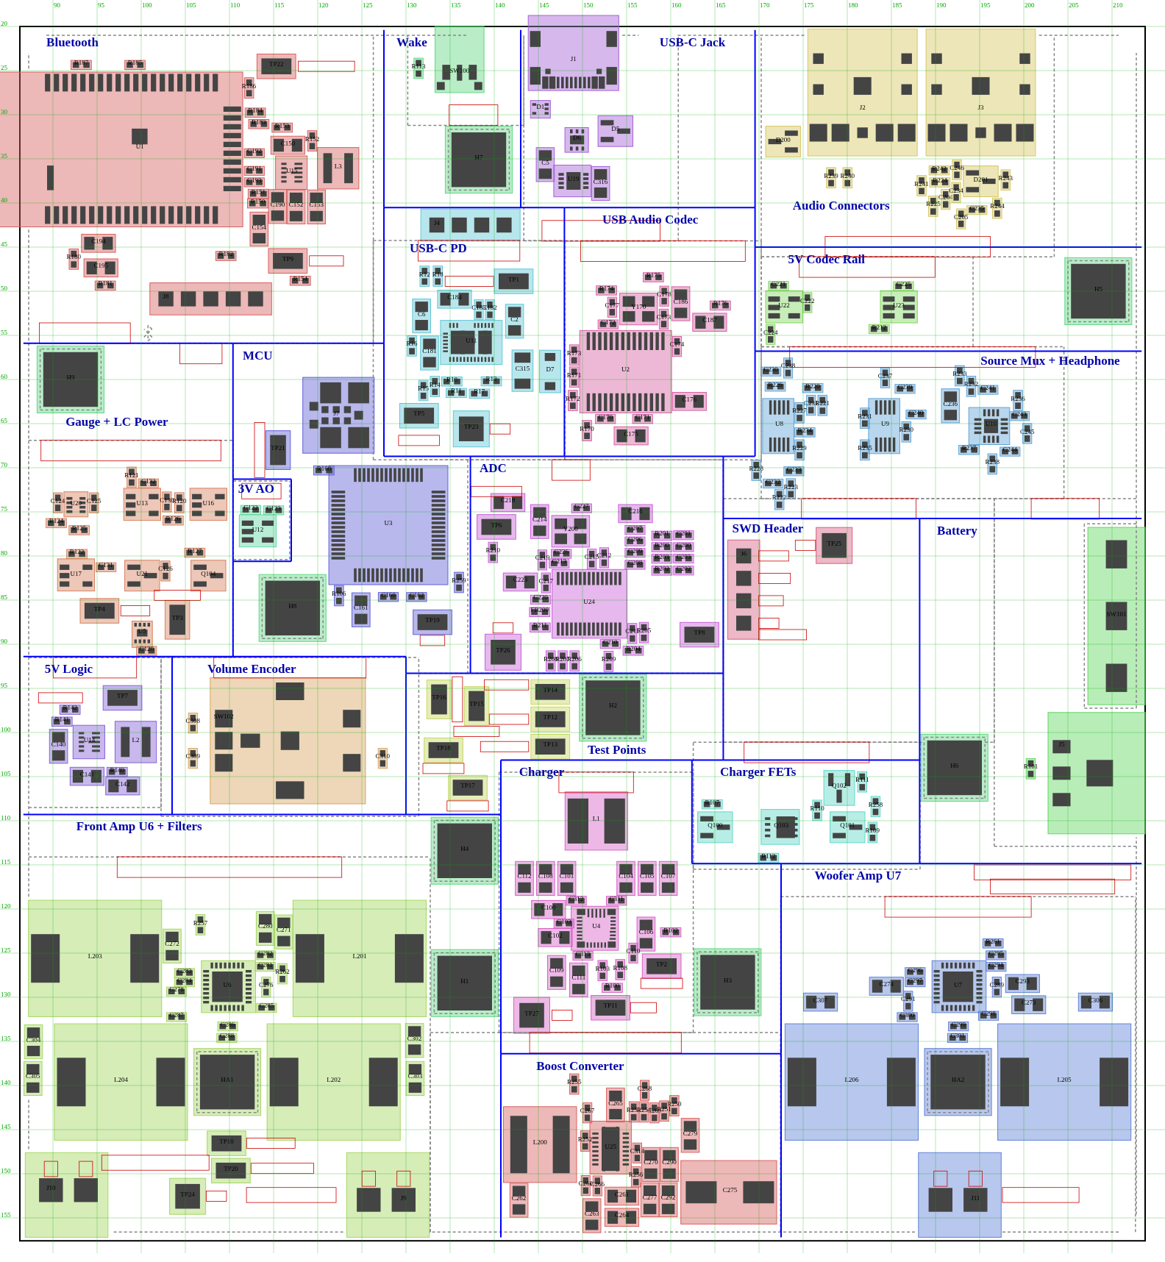
ai-files/pcb/work-route3/evidence/rt3-tiling-parts.png
