chithigun23/DesktopSpeaker/ai-files/reports/bom-before-reconcile.png

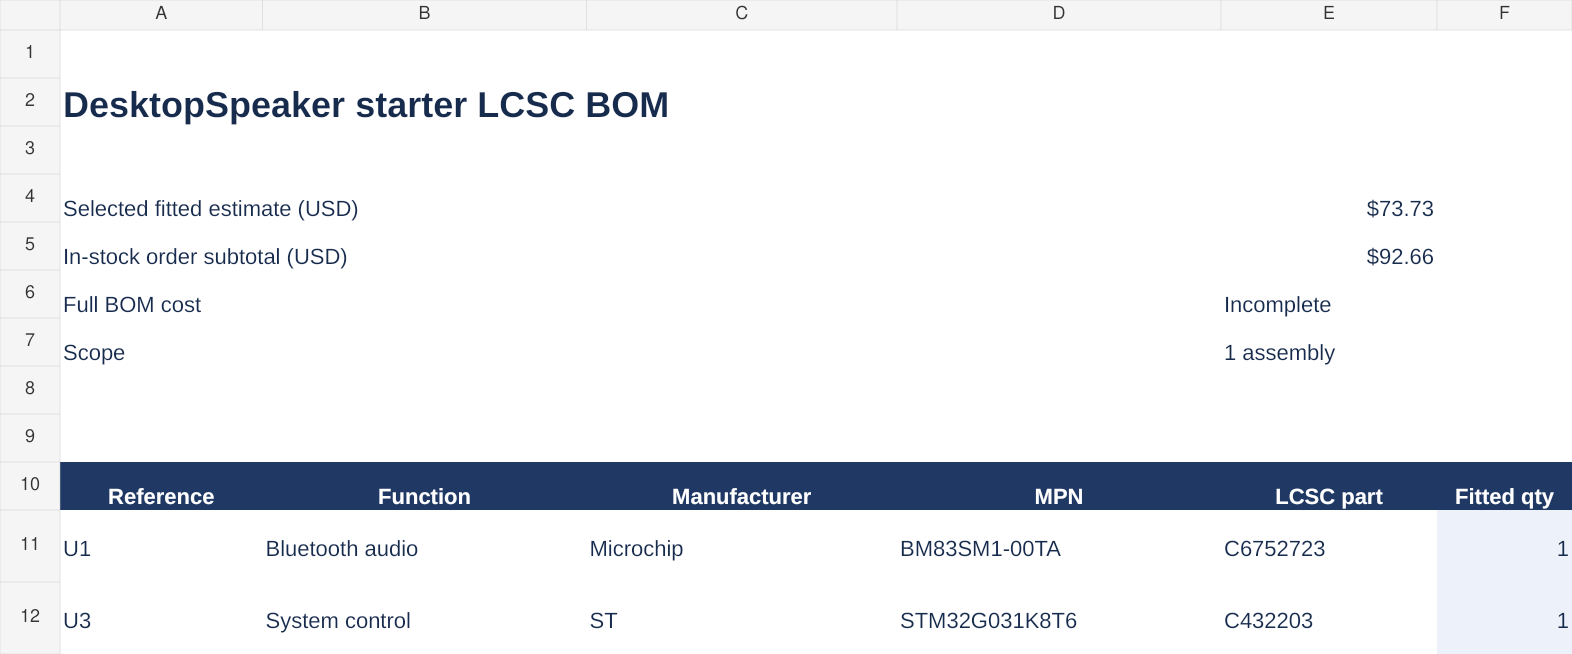
ai-files/reports/bom-before-reconcile.png
