chithigun23/DesktopSpeaker/ai-files/reports/bom-new-power.png

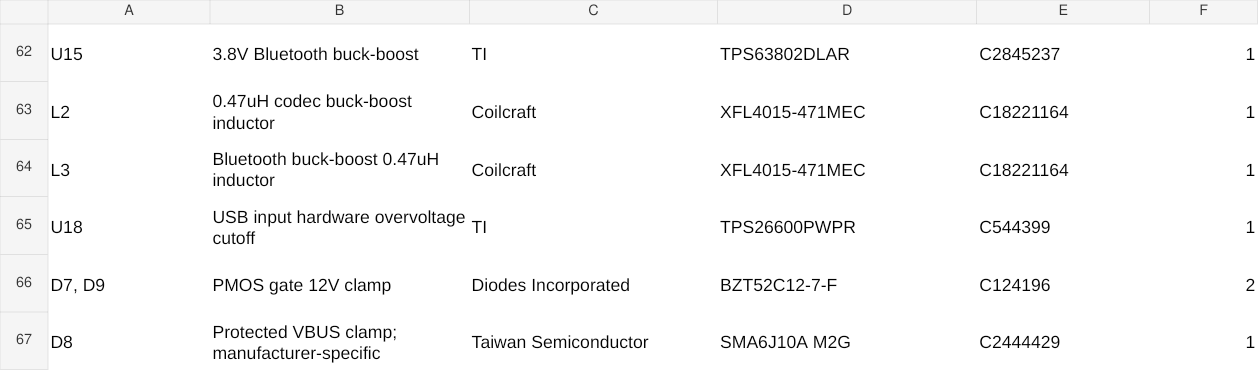
ai-files/reports/bom-new-power.png
