chithigun23/DesktopSpeaker/ai-files/reports/bom-open-selections.png

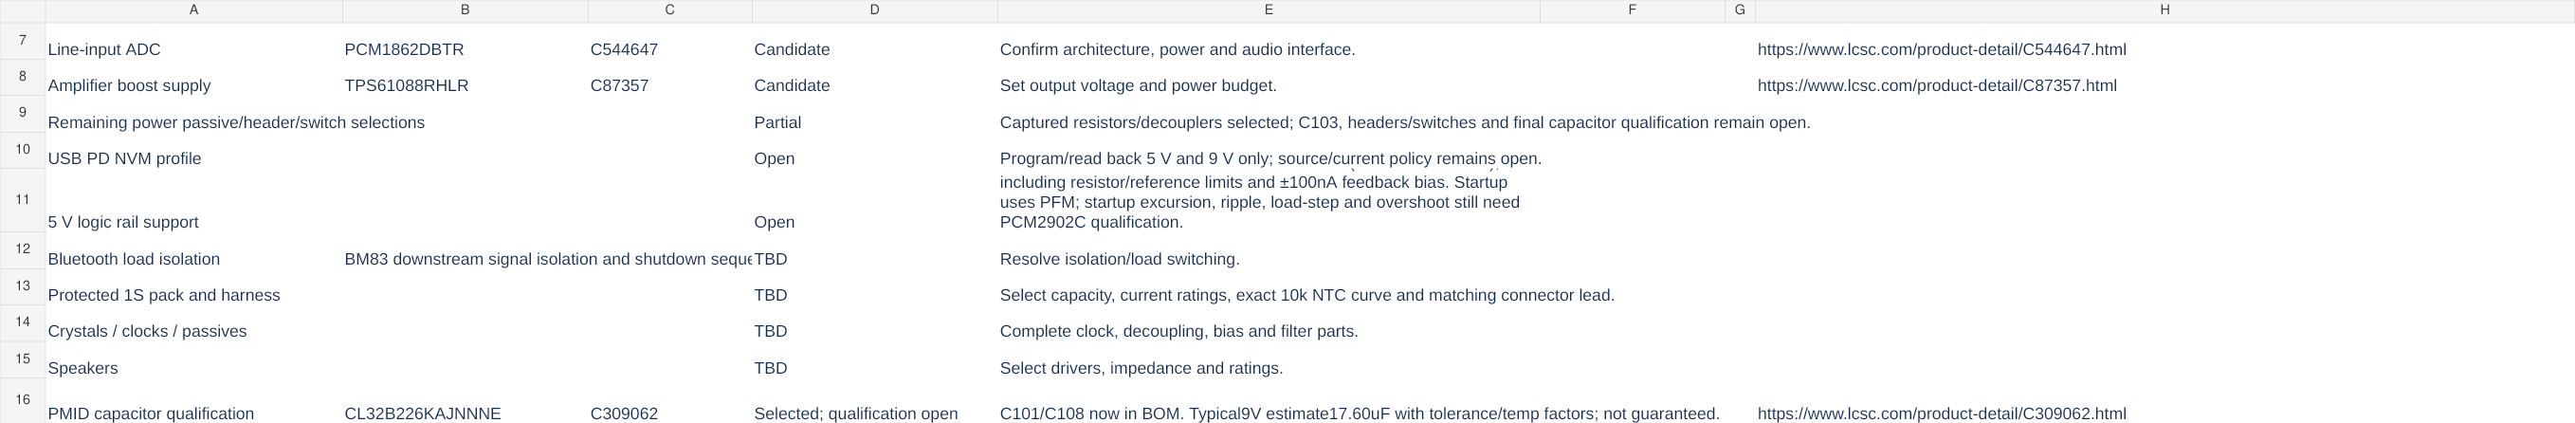
ai-files/reports/bom-open-selections.png
