chithigun23/DesktopSpeaker/ai-files/reports/bom-passive-selections.png

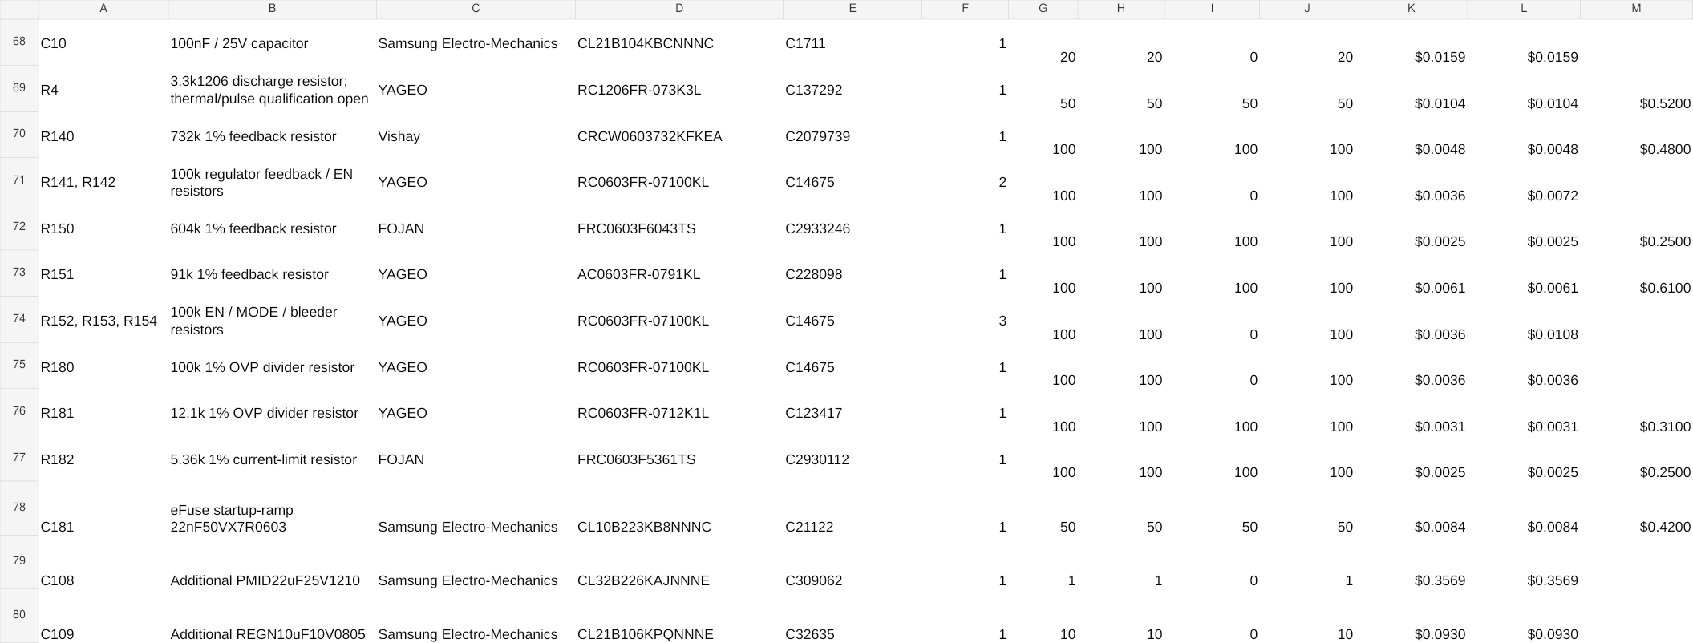
ai-files/reports/bom-passive-selections.png
