chithigun23/DesktopSpeaker/ai-files/reports/bom-replaced-power.png

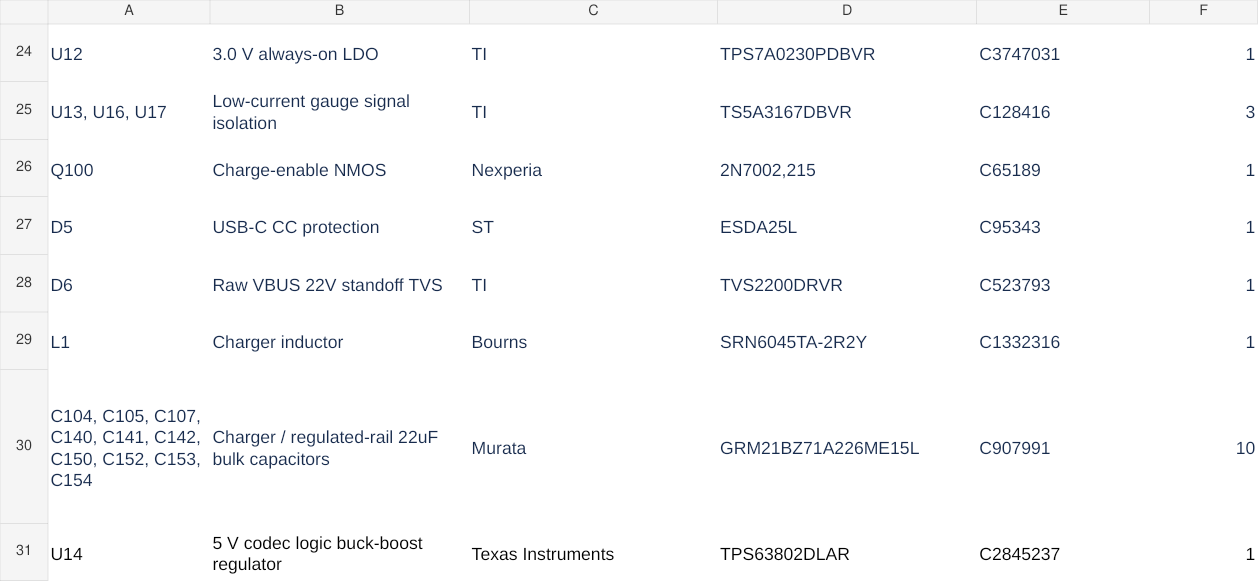
ai-files/reports/bom-replaced-power.png
