chithigun23/DesktopSpeaker/ai-files/reports/codec-parts.png

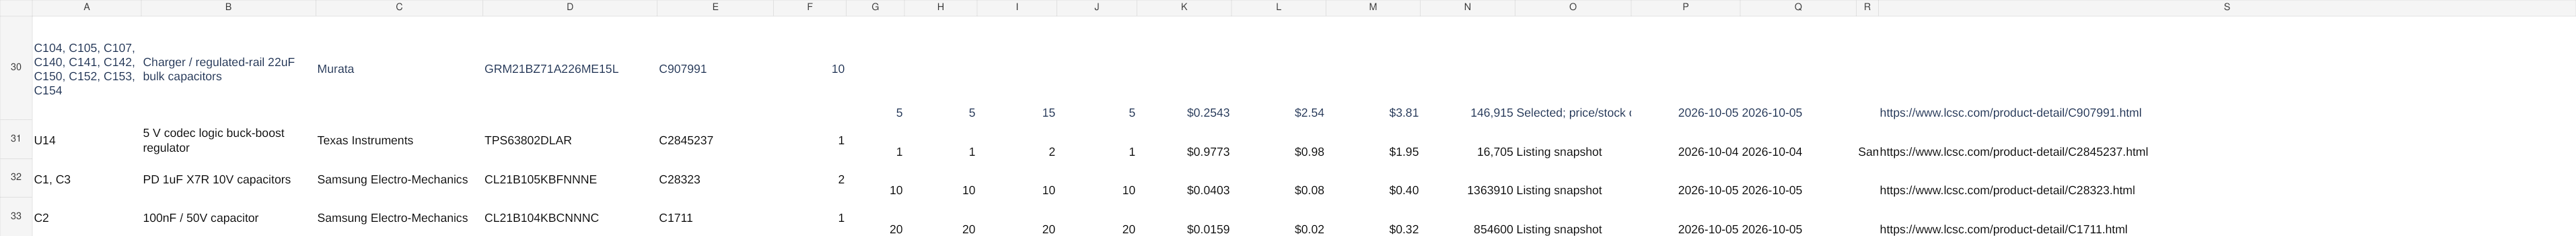
ai-files/reports/codec-parts.png
