chithigun23/DesktopSpeaker/ai-files/reports/gauge-interface-bom-render.png

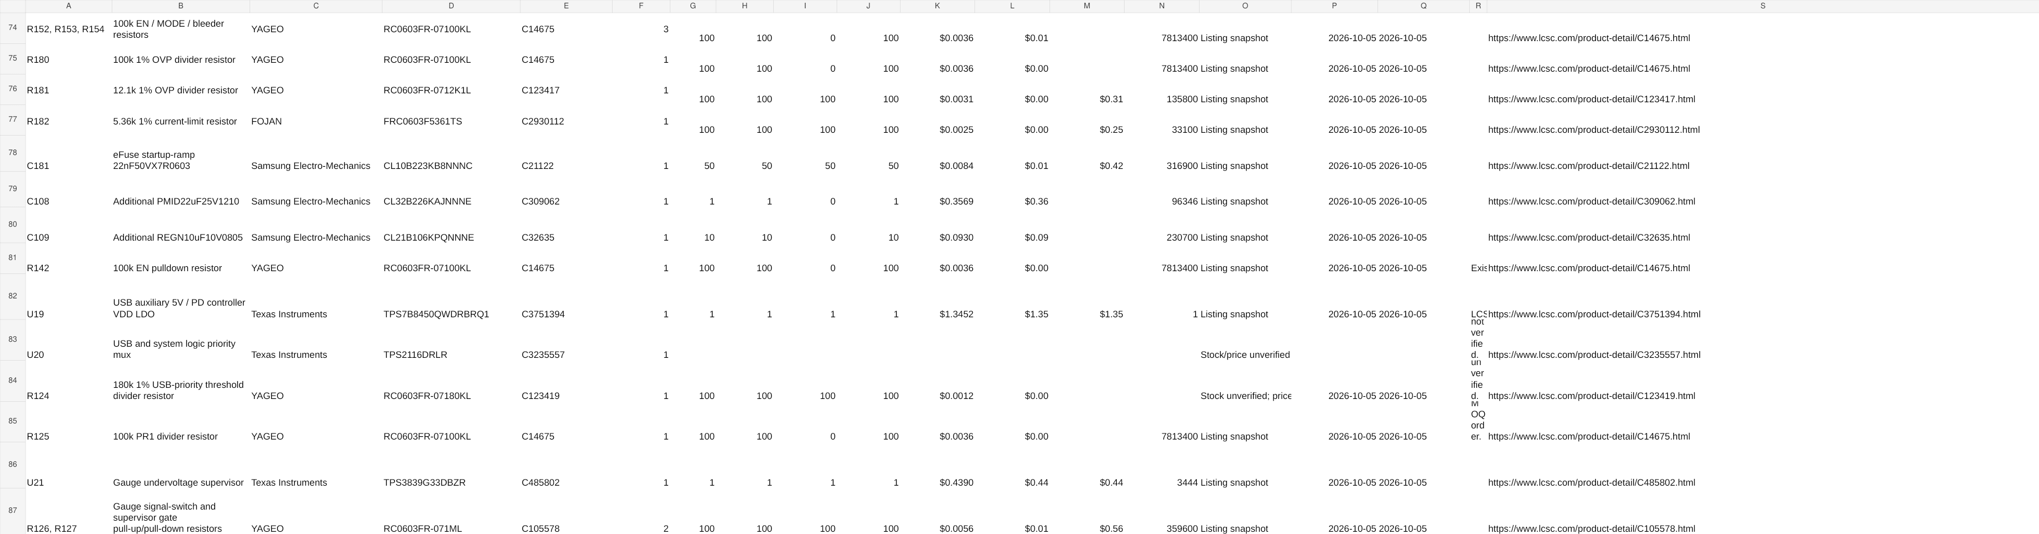
ai-files/reports/gauge-interface-bom-render.png
