chithigun23/DesktopSpeaker/ai-files/reports/gauge-interface-bom-totals-render.png

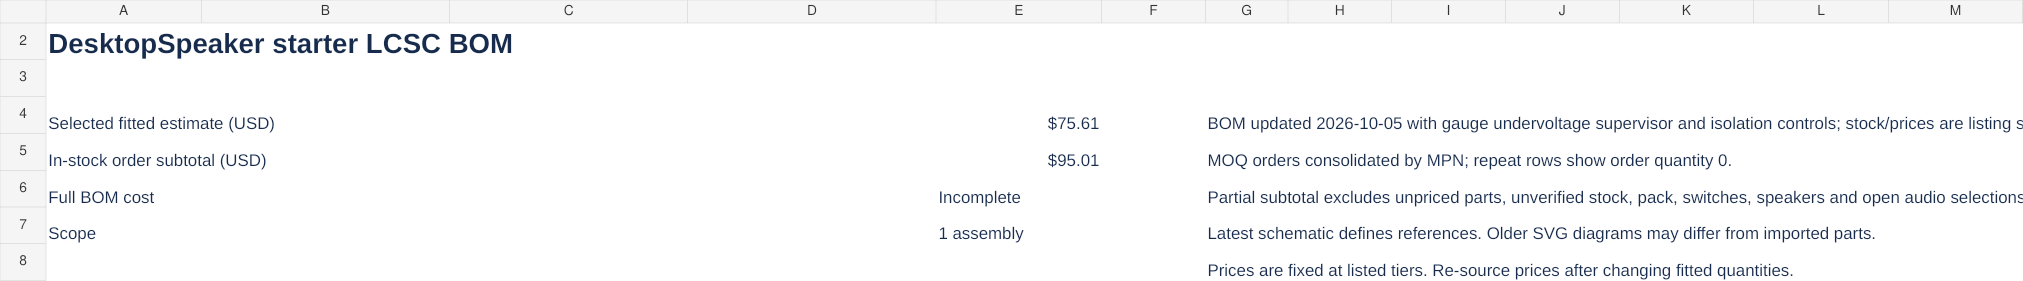
ai-files/reports/gauge-interface-bom-totals-render.png
