chithigun23/DesktopSpeaker/ai-files/reports/usb-aux-bom-changed-parts.png

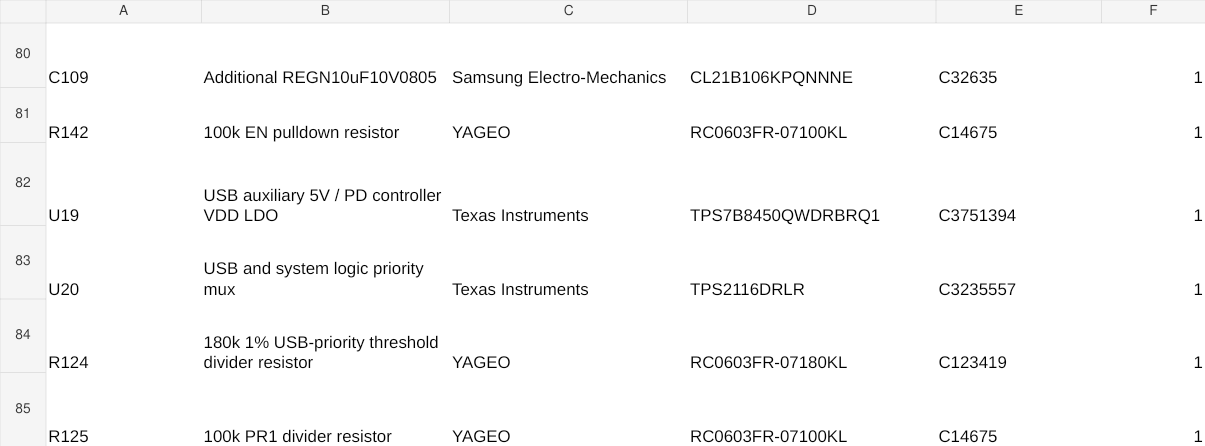
ai-files/reports/usb-aux-bom-changed-parts.png
