chithigun23/DesktopSpeaker/ai-files/reports/usb-aux-bom-order-pricing.png

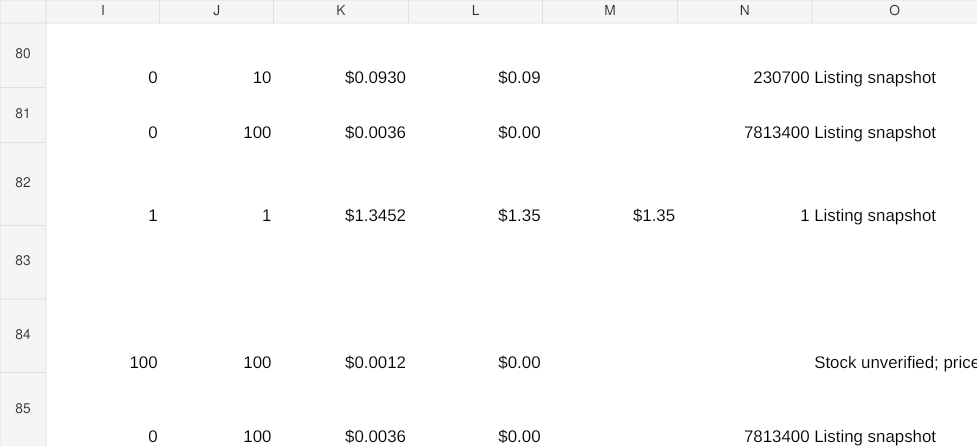
ai-files/reports/usb-aux-bom-order-pricing.png
