chithigun23/DesktopSpeaker/ai-files/reports/usb-aux-bom-rows.png

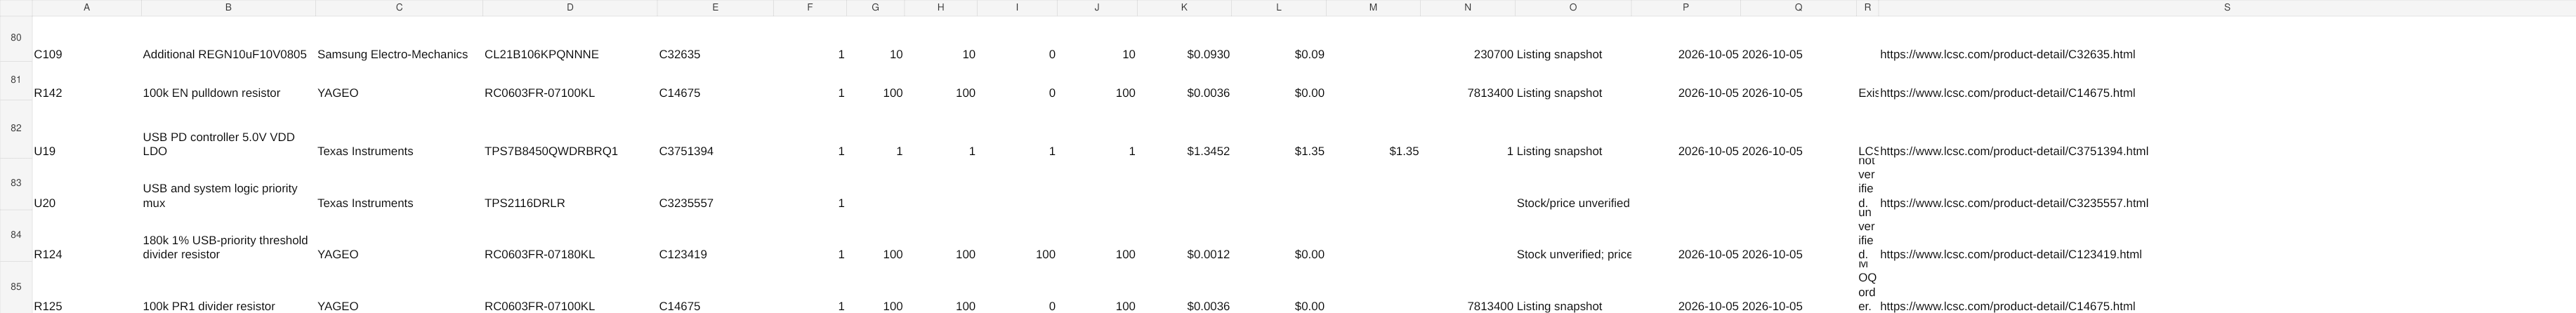
ai-files/reports/usb-aux-bom-rows.png
