chithigun23/DesktopSpeaker/ai-files/reports/vdd-ldo-bom-parts.png

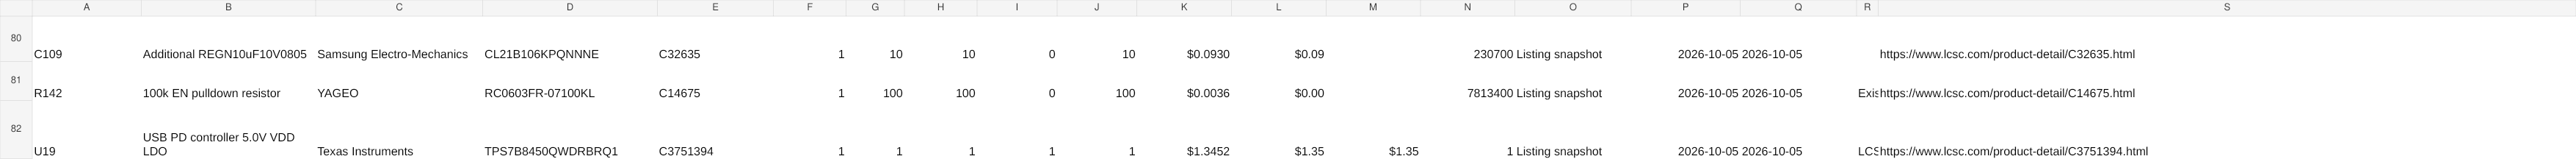
ai-files/reports/vdd-ldo-bom-parts.png
