chithigun23/DesktopSpeaker/ai-files/reports/website-build-evidence/nc-bom.png

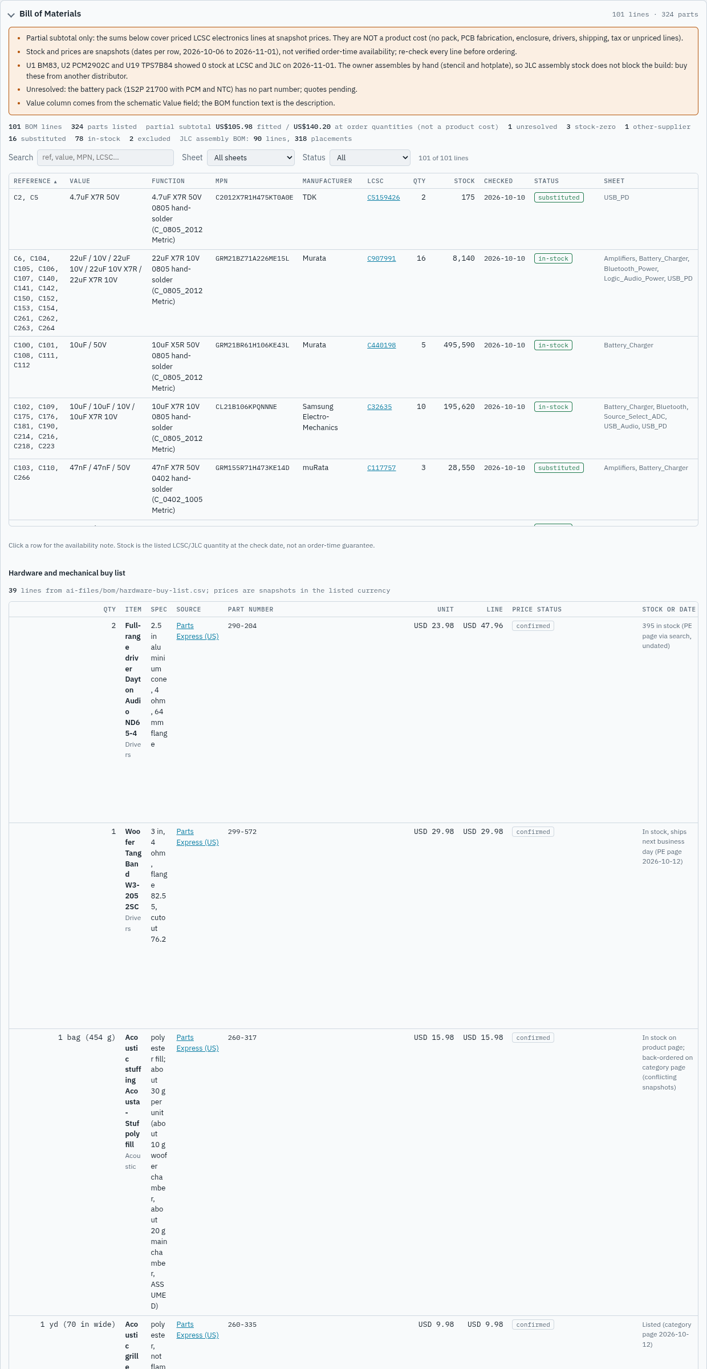
ai-files/reports/website-build-evidence/nc-bom.png
