chithigun23/DesktopSpeaker/ai-files/cad/DesktopSpeaker_internal.step

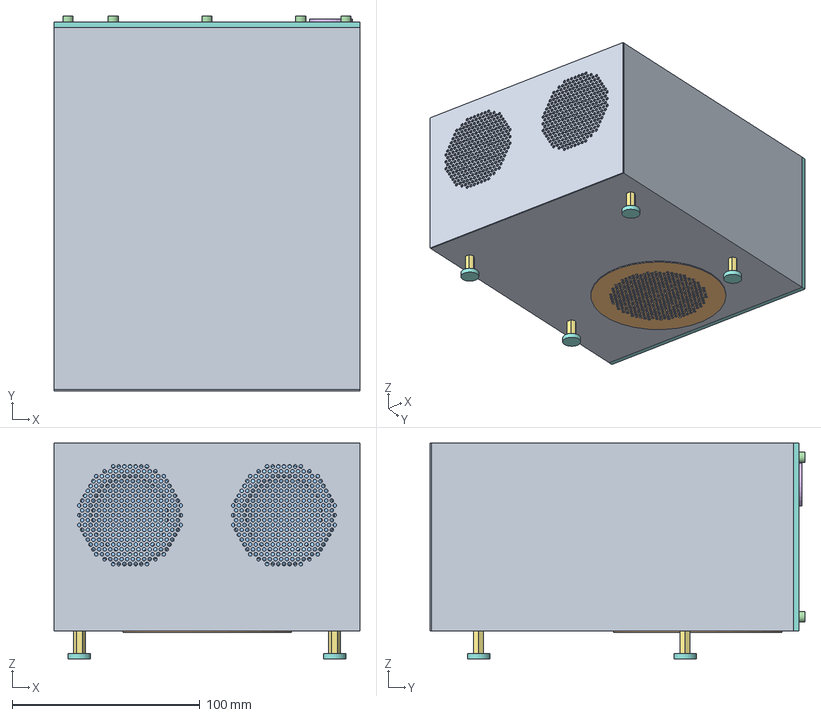
[picture p218: CAD file, 2026-10-06]
ai-files/cad/DesktopSpeaker_internal.step
163.0 x 199.6 x 115.0 mm
Shell_Box
Driver_FrontL_ND65-4
Driver_FrontR_ND65-4
Woofer_W3-2052SC_standin
Battery_Cell1_21700_50S
Battery_Cell2_21700_50S
Battery_PCM_board
PCB_136.9x127.8x1.6
PCB_U1
PCB_U3
PCB_U2
PCB_U24
PCB_U6
PCB_U7
PCB_U25
PCB_L200
PCB_C275
PCB_L201
PCB_L202
PCB_L203
PCB_L204
PCB_L205
PCB_L206
PCB_L1
PCB_L2
PCB_L3
PCB_U4
PCB_U11
PCB_J4
PCB_J6
PCB_J8
PCB_SW102
PCB_J1_USB-C
PCB_J2_3.5mm_jack
PCB_J3_3.5mm_jack
PCB_J5_MicroFit3_standin
PCB_J9_JST_B2P-VH_standin
PCB_J10_JST_B2P-VH_standin
PCB_J11_JST_B2P-VH_standin
PCB_SW100_tact_standin
PCB_SW100_plunger
SW101_rocker_D20_standin
Harness_J5_to_pack_schematic
Lid_rear
Grille_front_perforated
Grille_woofer_dia90
Insert_M3x5.7_DrvScrew_L1
Screw_M3x10_DrvScrew_L1
Insert_M3x5.7_DrvScrew_L2
Screw_M3x10_DrvScrew_L2
Insert_M3x5.7_DrvScrew_L3
Screw_M3x10_DrvScrew_L3
Insert_M3x5.7_DrvScrew_L4
Screw_M3x10_DrvScrew_L4
Insert_M3x5.7_DrvScrew_R1
Screw_M3x10_DrvScrew_R1
Insert_M3x5.7_DrvScrew_R2
Screw_M3x10_DrvScrew_R2
Insert_M3x5.7_DrvScrew_R3
Screw_M3x10_DrvScrew_R3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
