chithigun23/DesktopSpeaker/ai-files/cad/models-v13/downloads/easyeda_C124378/model_62d1dd00f91344f487735a33792f8f57.obj

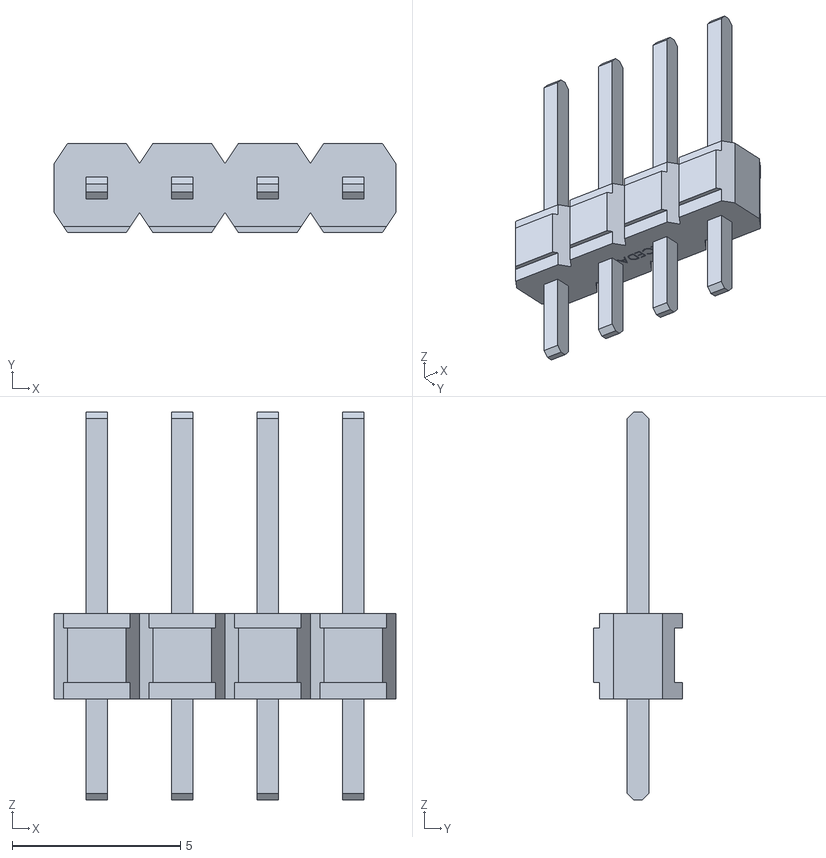
[picture p219: CAD file, 2026-11-02]
ai-files/cad/models-v13/downloads/easyeda_C124378/model_62d1dd00f91344f487735a33792f8f57.obj
10.2 x 2.66 x 11.5
