chithigun23/DesktopSpeaker/ai-files/cad/models-v13/downloads/easyeda_C1332316/model_45a643b41e1c49f092c5295806d5ed99.obj

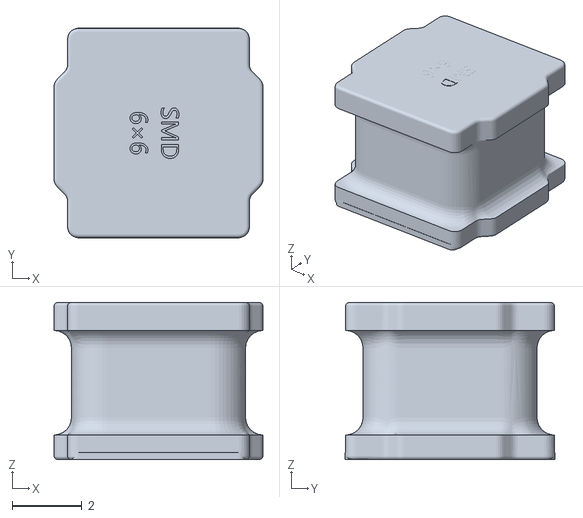
[picture p220: CAD file, 2026-11-02]
ai-files/cad/models-v13/downloads/easyeda_C1332316/model_45a643b41e1c49f092c5295806d5ed99.obj
6.00 x 6.02 x 4.52
