chithigun23/DesktopSpeaker/ai-files/cad/models-v13/downloads/easyeda_C160315/model_0122b456e2ab45a9ad6da6f6a6ef2c44.obj

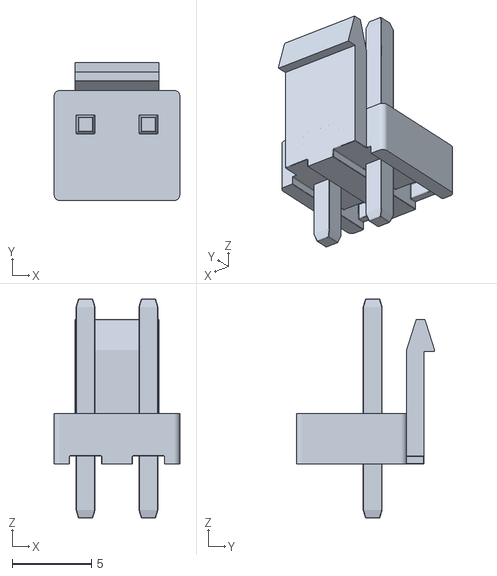
[picture p221: CAD file, 2026-11-02]
ai-files/cad/models-v13/downloads/easyeda_C160315/model_0122b456e2ab45a9ad6da6f6a6ef2c44.obj
7.92 x 8.70 x 13.8
