chithigun23/DesktopSpeaker/ai-files/cad/models-v13/downloads/easyeda_C202365/model_98040a81456e4e72ba6314de5f862cda.obj

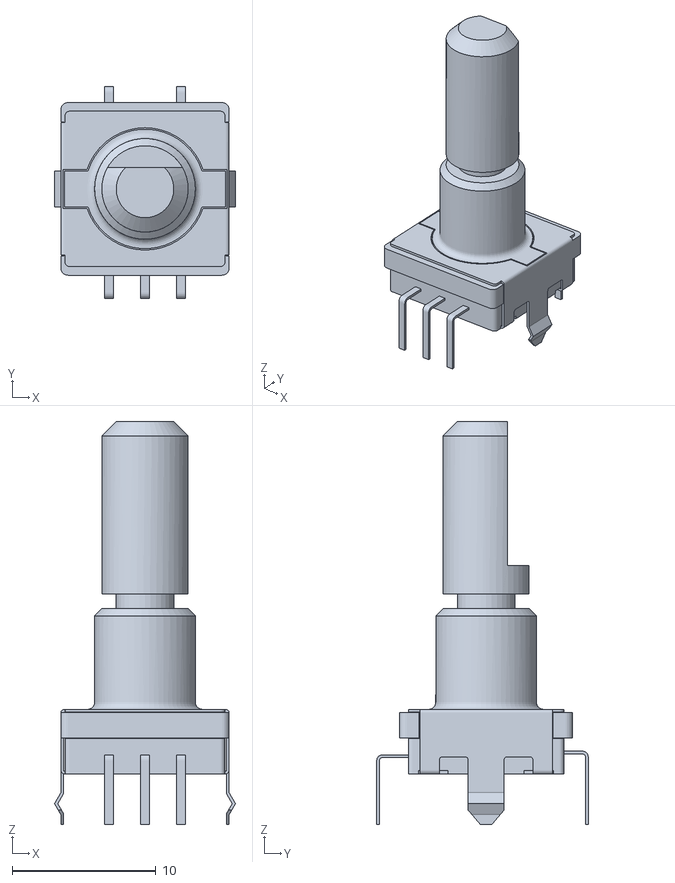
[picture p222: CAD file, 2026-11-02]
ai-files/cad/models-v13/downloads/easyeda_C202365/model_98040a81456e4e72ba6314de5f862cda.obj
12.6 x 14.7 x 28.0
