chithigun23/DesktopSpeaker/ai-files/cad/models-v13/downloads/easyeda_C238128/model_0d00f52e99524e2888e0ab2a427c6bd1.obj

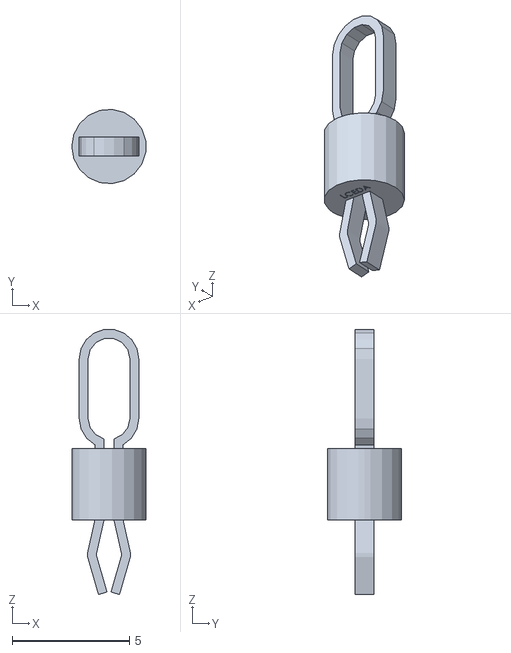
[picture p223: CAD file, 2026-11-02]
ai-files/cad/models-v13/downloads/easyeda_C238128/model_0d00f52e99524e2888e0ab2a427c6bd1.obj
3.17 x 3.16 x 11.3
