chithigun23/DesktopSpeaker/ai-files/cad/models-v13/downloads/easyeda_C2939173/model_fbf8285e3a7e48d5b2dc60c280a5d5d9.obj

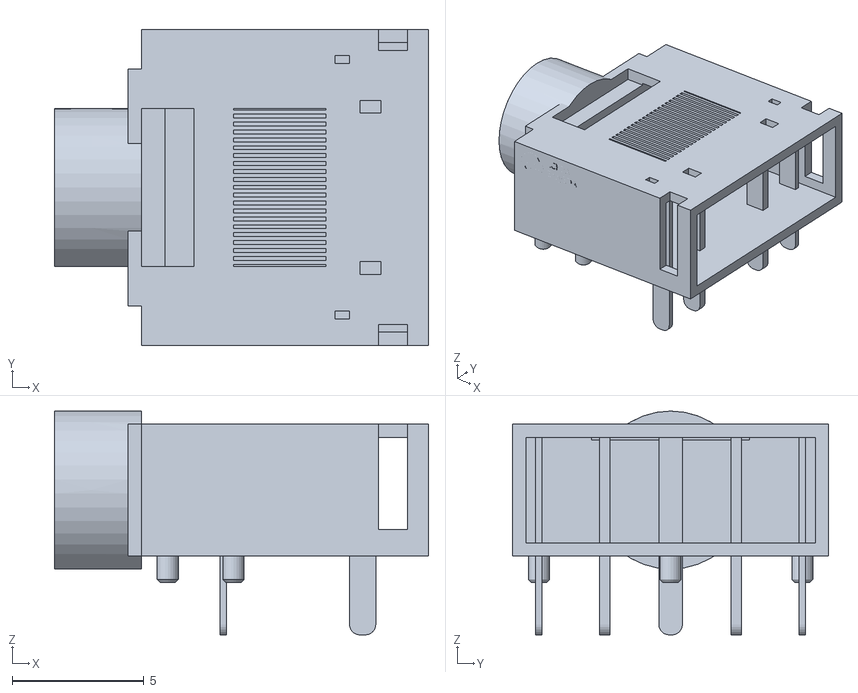
[picture p224: CAD file, 2026-11-02]
ai-files/cad/models-v13/downloads/easyeda_C2939173/model_fbf8285e3a7e48d5b2dc60c280a5d5d9.obj
14.2 x 12.0 x 8.50
