chithigun23/DesktopSpeaker/ai-files/cad/models-v13/downloads/easyeda_C2972219/model_4c08b1da814941cea2ab3941bedb16f7.obj

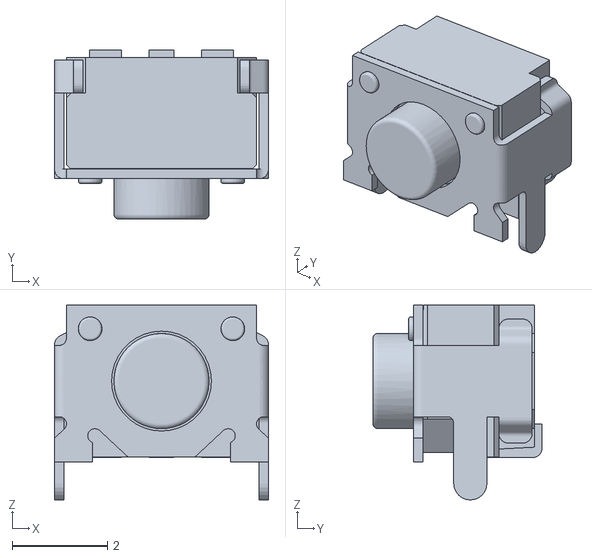
[picture p225: CAD file, 2026-11-02]
ai-files/cad/models-v13/downloads/easyeda_C2972219/model_4c08b1da814941cea2ab3941bedb16f7.obj
4.50 x 3.56 x 4.10
