chithigun23/DesktopSpeaker/ai-files/cad/models-v13/downloads/easyeda_C503478/model_aca6fa2f7c374f19a4c0e548bdfa642f.obj

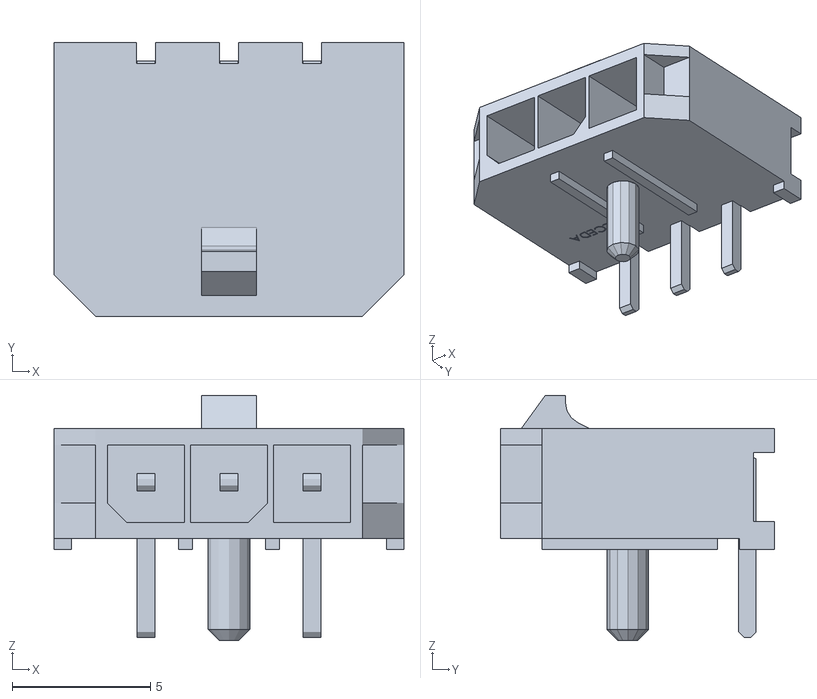
[picture p226: CAD file, 2026-11-02]
ai-files/cad/models-v13/downloads/easyeda_C503478/model_aca6fa2f7c374f19a4c0e548bdfa642f.obj
12.7 x 9.90 x 8.87
