chithigun23/DesktopSpeaker/ai-files/cad/models-v13/downloads/easyeda_C7245133/model_cf9d2492abe440bea24fab6a8e8c6bd0.obj

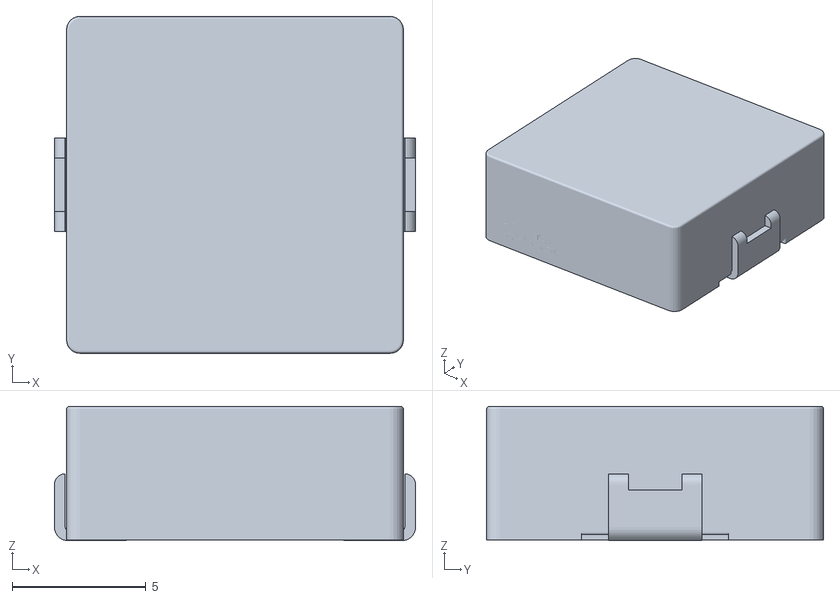
[picture p227: CAD file, 2026-11-02]
ai-files/cad/models-v13/downloads/easyeda_C7245133/model_cf9d2492abe440bea24fab6a8e8c6bd0.obj
13.5 x 12.6 x 5.02
