chithigun23/DesktopSpeaker/ai-files/cad/parts/ND65_3D/ND65-4 and 8.step

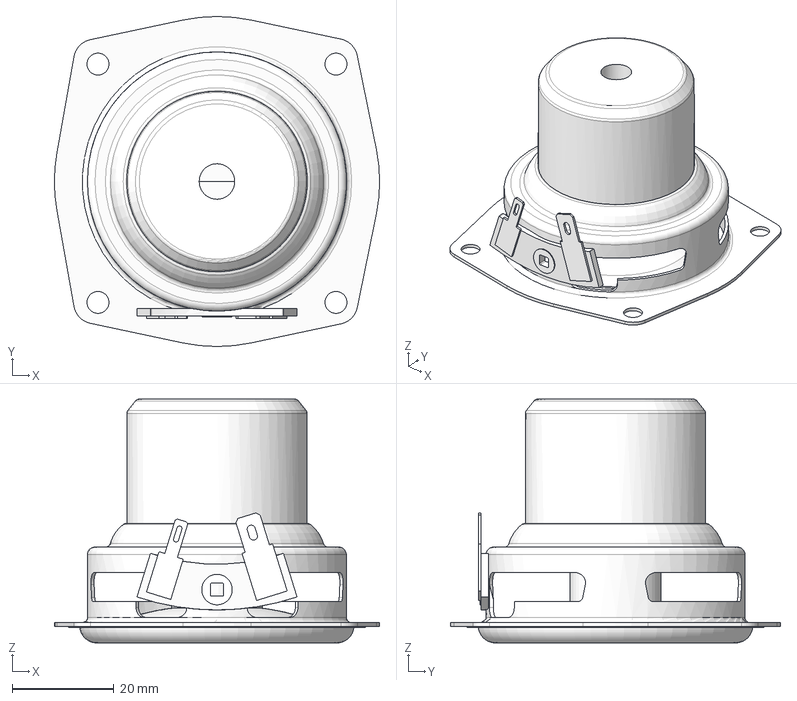
[picture p228: CAD file, 2026-10-05]
ai-files/cad/parts/ND65_3D/ND65-4 and 8.step
64.0 x 64.9 x 48.0 mm
