chithigun23/DesktopSpeaker/ai-files/cad/v13p4/2P/print/DesktopSpeaker_shell.stl

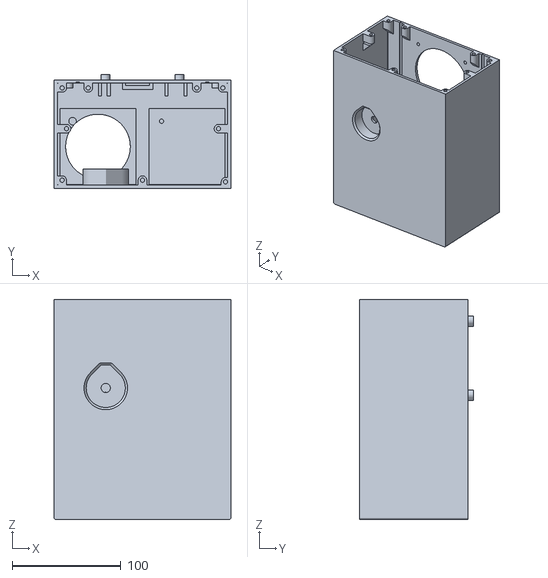
[picture p229: CAD file, 2026-11-02]
ai-files/cad/v13p4/2P/print/DesktopSpeaker_shell.stl
163.0 x 104.7 x 202.6
