chithigun23/DesktopSpeaker/ai-files/cad/v15/print/DesktopSpeaker_shell.stl

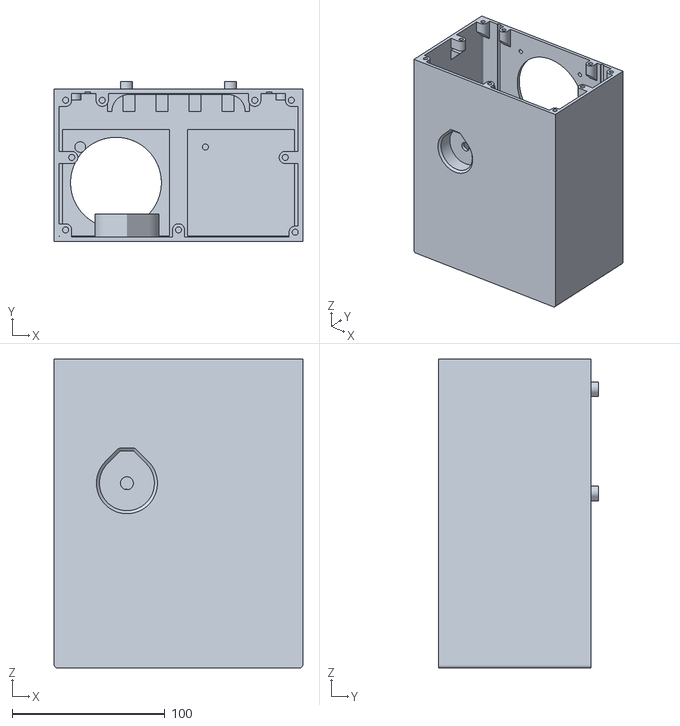
[picture p230: CAD file, 2026-11-03]
ai-files/cad/v15/print/DesktopSpeaker_shell.stl
163.0 x 104.7 x 202.6
