chithigun23/DesktopSpeaker/ai-files/candidates/DNH0008A.stp

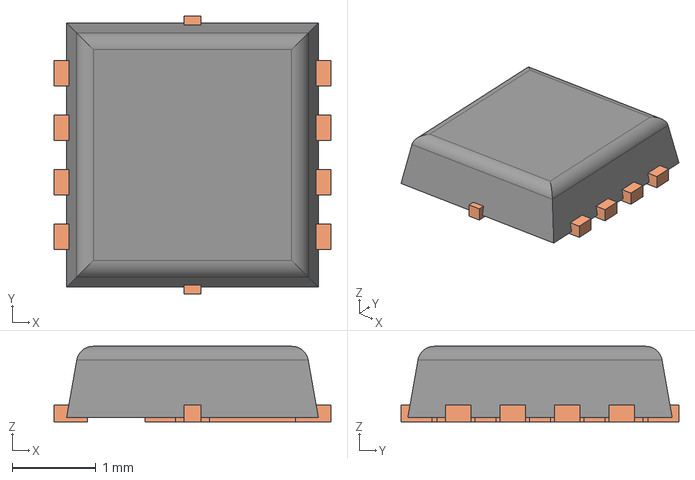
[picture p231: CAD file, 2026-10-05]
ai-files/candidates/DNH0008A.stp
3.30 x 3.31 x 0.9 mm
FRAME
