chithigun23/DesktopSpeaker/ai-files/candidates/TPS26600-vendor/PWP0016H.stp

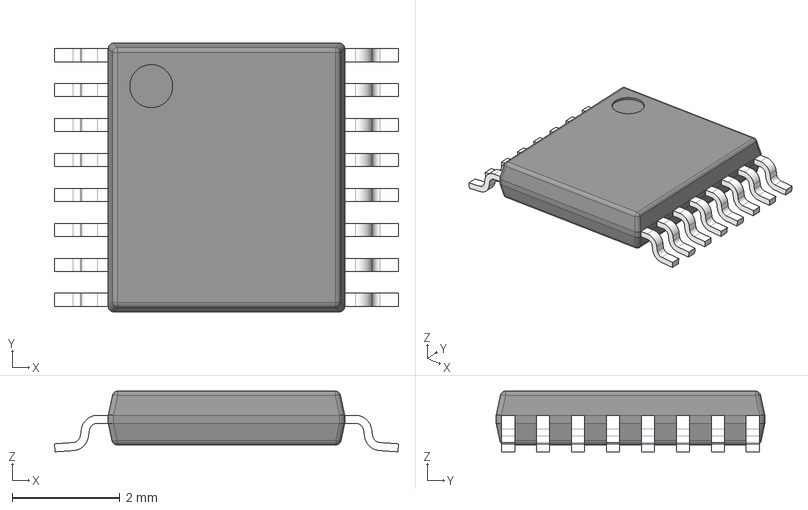
[picture p232: CAD file, 2026-10-05]
ai-files/candidates/TPS26600-vendor/PWP0016H.stp
6.40 x 5.00 x 1.13 mm
BODY-TSSOP
LEAD-TSSOP x 16
PIN1
DAP
