chithigun23/DesktopSpeaker/DesktopSpeaker-kicad/kicad-library/3d/SSOP-28_DB_5.3x10.2_P0.65_TI.step

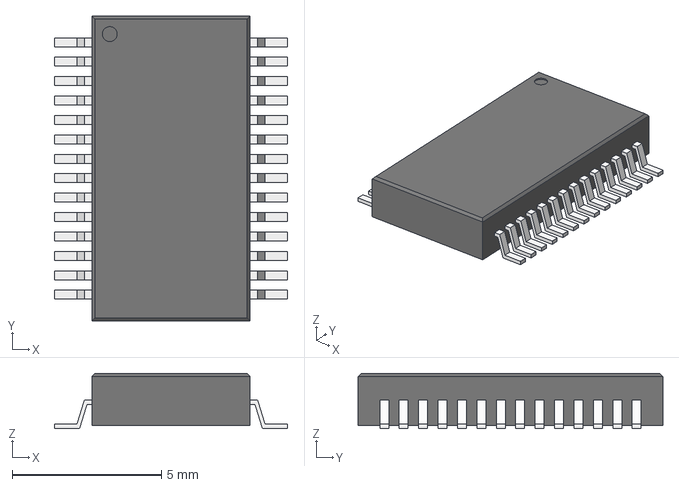
[picture p233: CAD file, 2026-11-02]
DesktopSpeaker-kicad/kicad-library/3d/SSOP-28_DB_5.3x10.2_P0.65_TI.step
7.80 x 10.2 x 1.85 mm
