chithigun23/DesktopSpeaker/ai-files/cad/models-v13/3d/Foot_Rubber_12x3.step

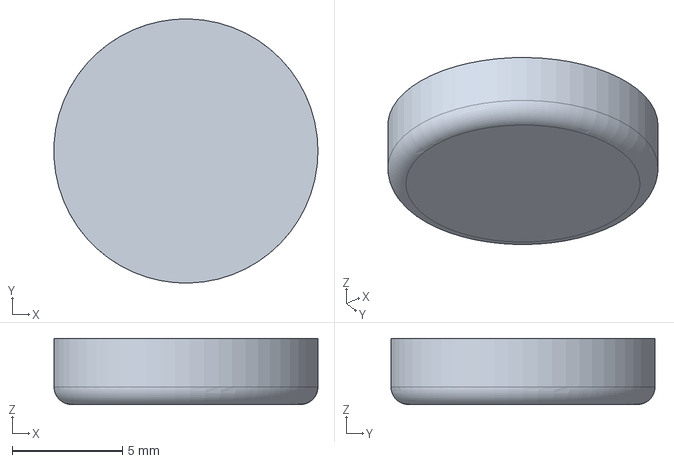
[picture p234: CAD file, 2026-11-02]
ai-files/cad/models-v13/3d/Foot_Rubber_12x3.step
12.0 x 12.0 x 3.00 mm
