chithigun23/DesktopSpeaker/ai-files/cad/v15/print/DesktopSpeaker_lid.stl

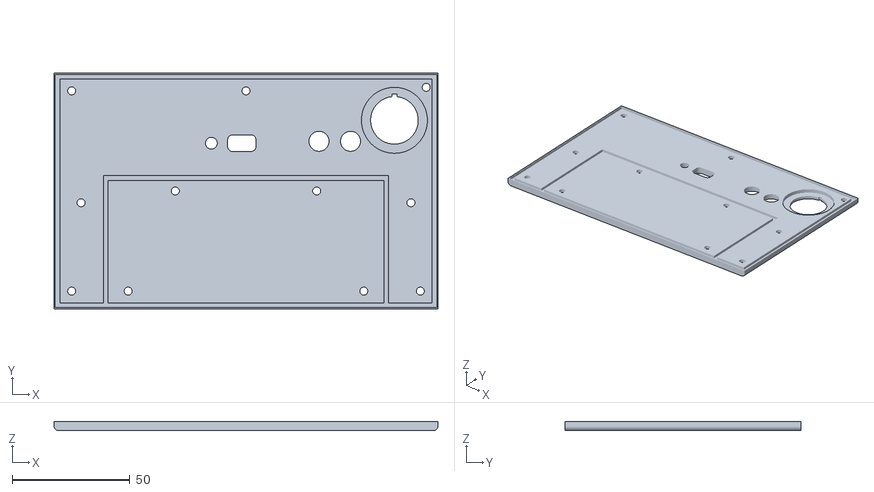
[picture p235: CAD file, 2026-11-03]
ai-files/cad/v15/print/DesktopSpeaker_lid.stl
163.0 x 100.0 x 4.00
