chithigun23/DesktopSpeaker/DesktopSpeaker-kicad/kicad-library/3d/Molex_Micro-Fit3_43650-0300_RA.step

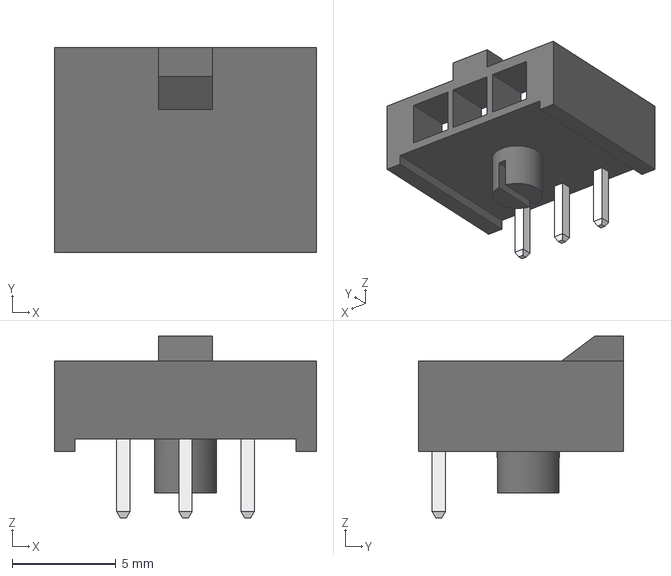
[picture p236: CAD file, 2026-11-02]
DesktopSpeaker-kicad/kicad-library/3d/Molex_Micro-Fit3_43650-0300_RA.step
12.6 x 9.90 x 8.77 mm
