chithigun23/DesktopSpeaker/ai-files/cad/models-v13/3d/Insert_Ruthex_RX-M3x5.7.step

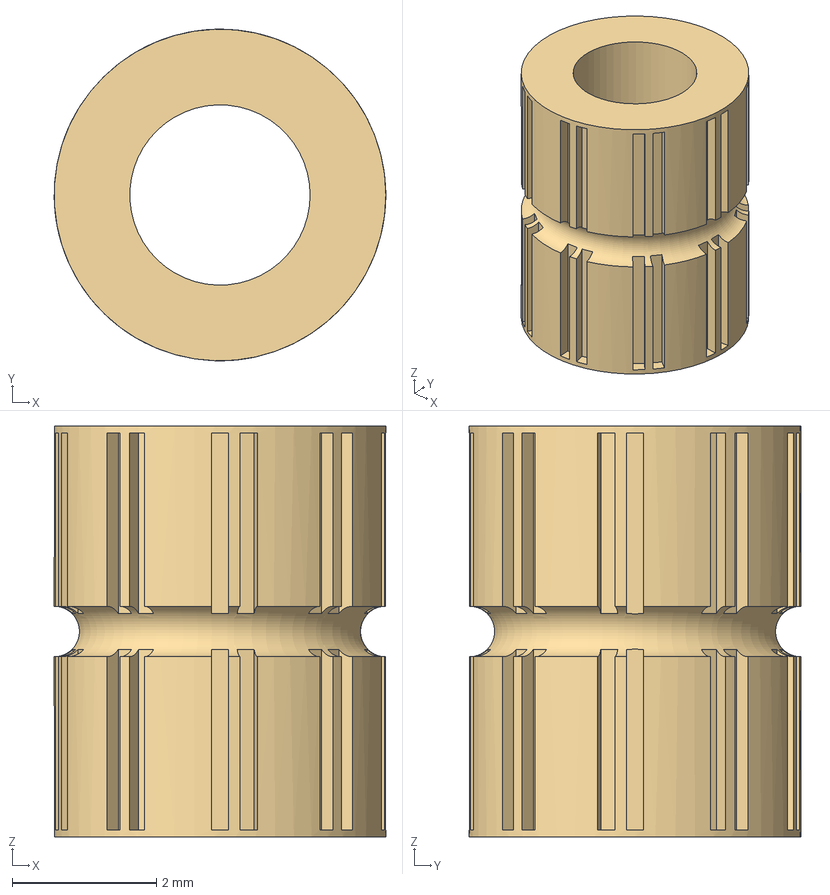
[picture p237: CAD file, 2026-11-02]
ai-files/cad/models-v13/3d/Insert_Ruthex_RX-M3x5.7.step
4.60 x 4.60 x 5.70 mm
