chithigun23/DesktopSpeaker/ai-files/cad/v15/print/DesktopSpeaker_woofer_chamber_insert.stl

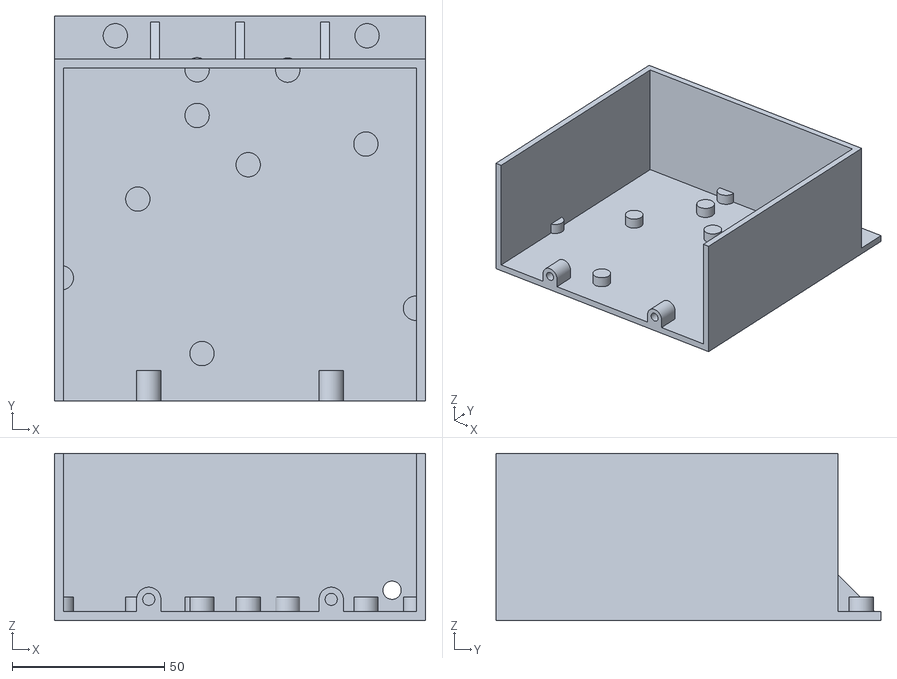
[picture p238: CAD file, 2026-11-03]
ai-files/cad/v15/print/DesktopSpeaker_woofer_chamber_insert.stl
122.0 x 126.6 x 55.0
