chithigun23/DesktopSpeaker/ai-files/candidates/TPS2116DRLR.step

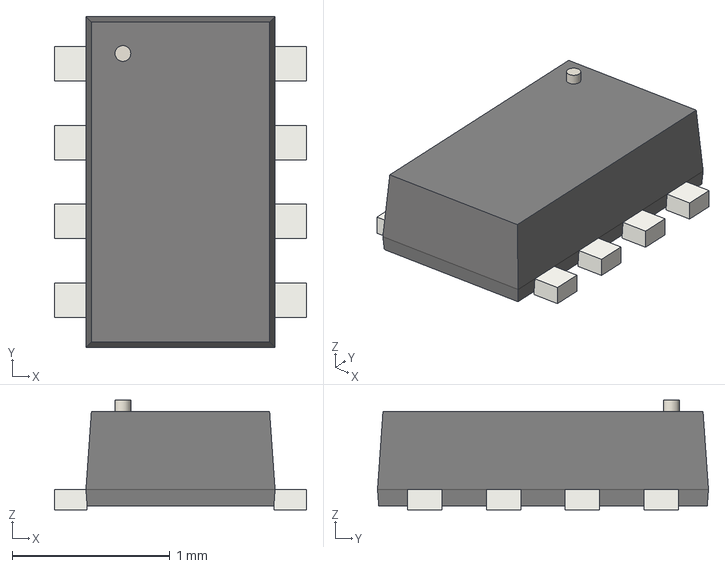
[picture p239: CAD file, 2026-10-05]
ai-files/candidates/TPS2116DRLR.step
1.60 x 2.10 x 0.695 mm
