chithigun23/DesktopSpeaker/DesktopSpeaker-kicad/kicad-library/3d/TE_1977066-1.step

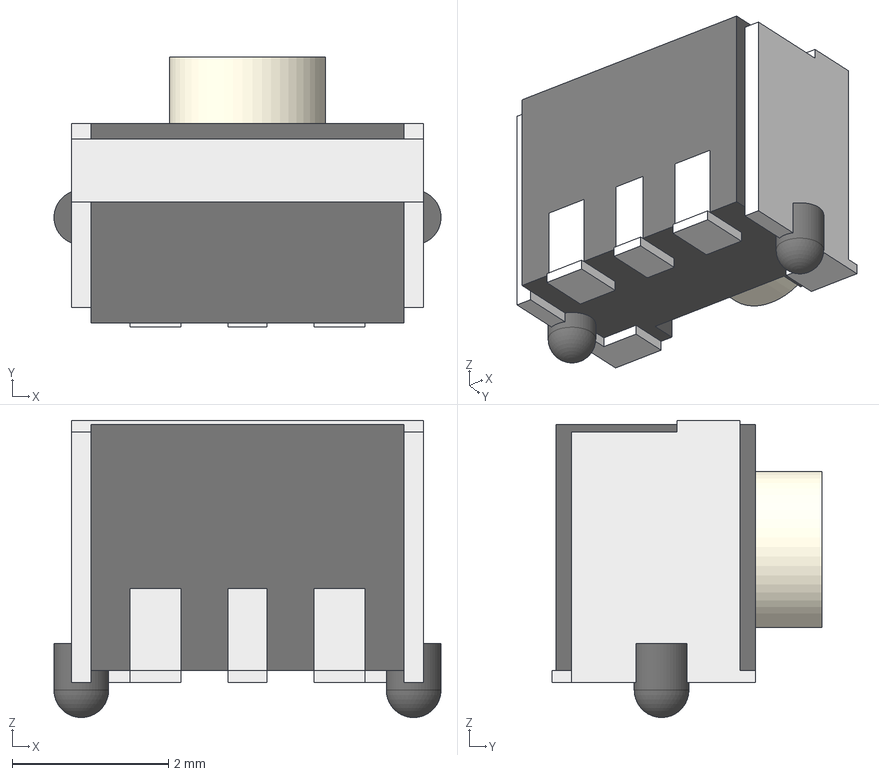
[picture p240: CAD file, 2026-11-02]
DesktopSpeaker-kicad/kicad-library/3d/TE_1977066-1.step
4.95 x 3.45 x 3.80 mm
