chithigun23/DesktopSpeaker/ai-files/cad/models-v13/3d/TangBand_W3-2052SC.step

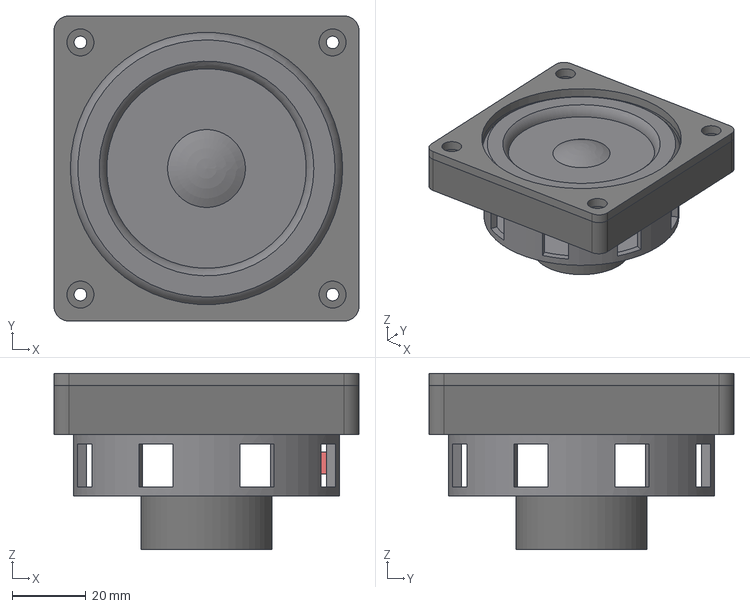
[picture p241: CAD file, 2026-11-02]
ai-files/cad/models-v13/3d/TangBand_W3-2052SC.step
82.5 x 82.5 x 47.8 mm
