chithigun23/DesktopSpeaker/ai-files/candidates/RQM0029A.stp

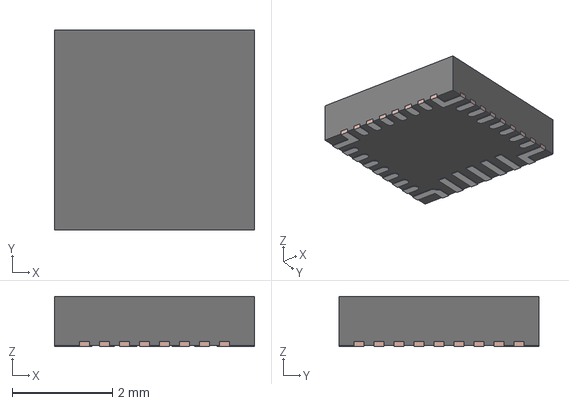
[picture p242: CAD file, 2026-10-05]
ai-files/candidates/RQM0029A.stp
4.00 x 4.00 x 1.00 mm
FRAME
MOLD
