chithigun23/DesktopSpeaker/DesktopSpeaker-kicad/kicad-library/3d/Keystone_5010-5014_TestPoint_THM.step

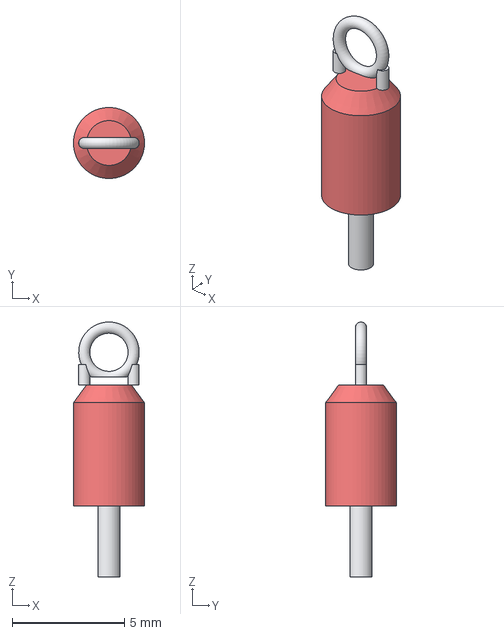
[picture p243: CAD file, 2026-11-02]
DesktopSpeaker-kicad/kicad-library/3d/Keystone_5010-5014_TestPoint_THM.step
3.17 x 3.17 x 11.4 mm
