chithigun23/DesktopSpeaker/ai-files/cad/models-v13/3d/HRO_TYPE-C-31-M-12.step

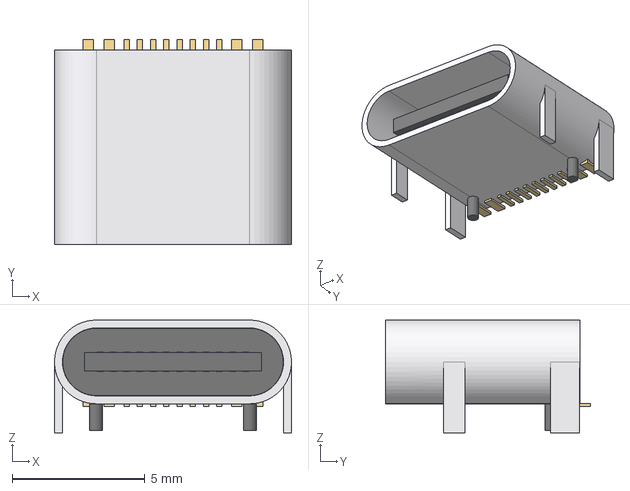
[picture p244: CAD file, 2026-11-02]
ai-files/cad/models-v13/3d/HRO_TYPE-C-31-M-12.step
8.94 x 7.75 x 4.26 mm
