chithigun23/DesktopSpeaker/DesktopSpeaker-kicad/kicad-library/3d/TSSOP-30_DBT_4.4x7.8_P0.5_TI.step

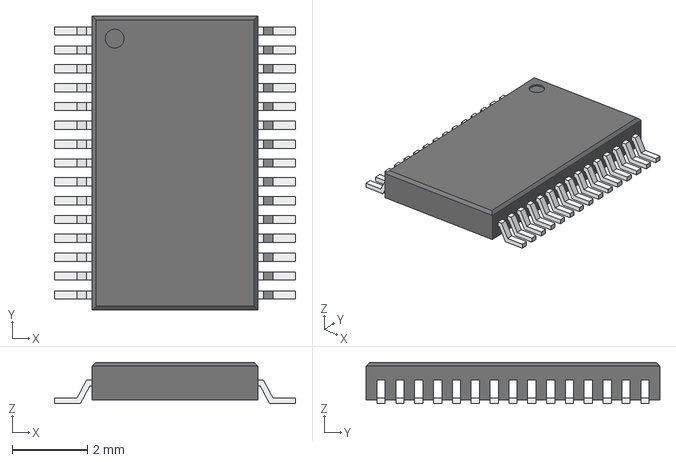
[picture p245: CAD file, 2026-11-02]
DesktopSpeaker-kicad/kicad-library/3d/TSSOP-30_DBT_4.4x7.8_P0.5_TI.step
6.40 x 7.80 x 1.10 mm
