chithigun23/DesktopSpeaker/ai-files/cad/models-v13/3d/Cell_Samsung_INR21700-50S.step

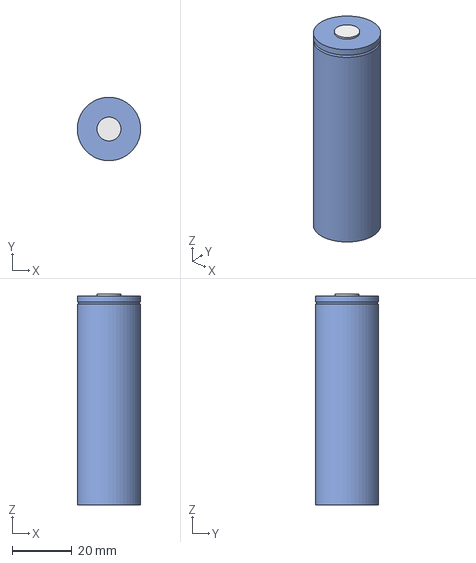
[picture p246: CAD file, 2026-11-02]
ai-files/cad/models-v13/3d/Cell_Samsung_INR21700-50S.step
21.2 x 21.2 x 70.7 mm
