chithigun23/DesktopSpeaker/DesktopSpeaker-kicad/kicad-library/3d/CP_Elec_6.3x7.7.step

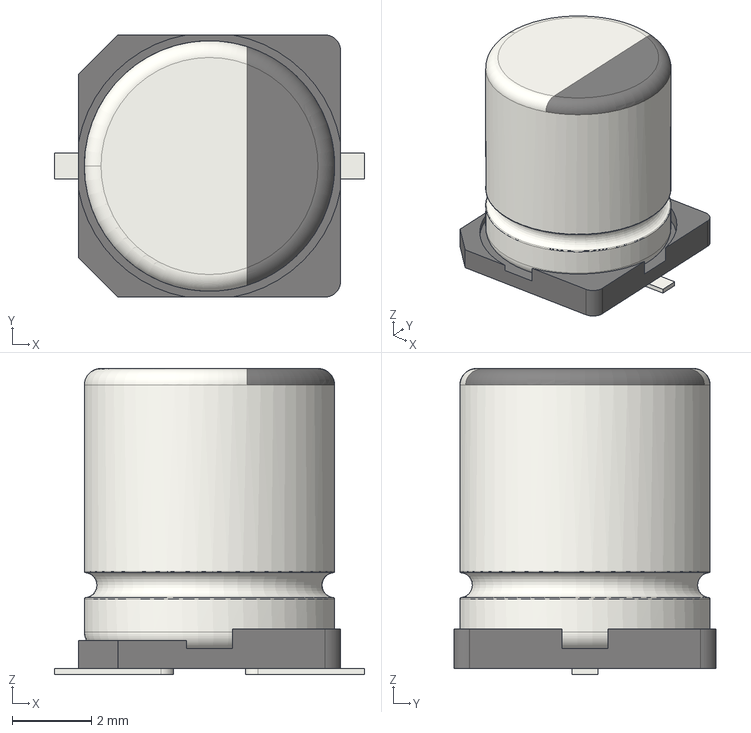
[picture p247: CAD file, 2026-10-10]
DesktopSpeaker-kicad/kicad-library/3d/CP_Elec_6.3x7.7.step
7.80 x 6.60 x 7.70 mm
