chithigun23/DesktopSpeaker/ai-files/cad/models-v13/3d/Stud_Wurth_971120321_M3x12_MF.step

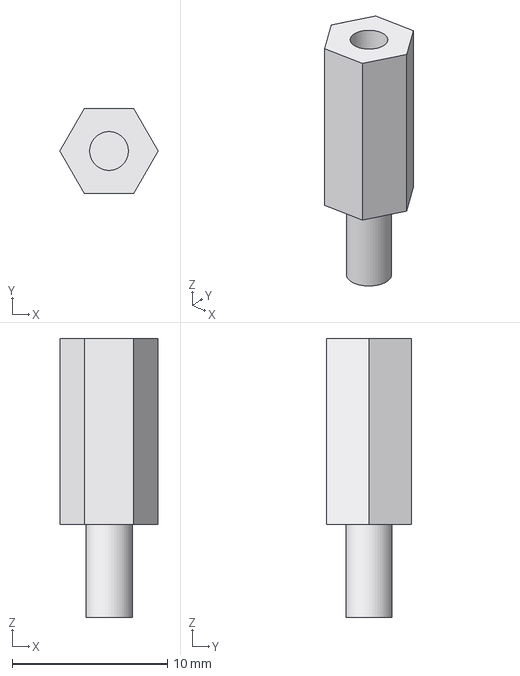
[picture p248: CAD file, 2026-11-02]
ai-files/cad/models-v13/3d/Stud_Wurth_971120321_M3x12_MF.step
6.35 x 5.50 x 18.0 mm
