chithigun23/DesktopSpeaker/DesktopSpeaker-kicad/kicad-library/3d/EC11E15244G1.step

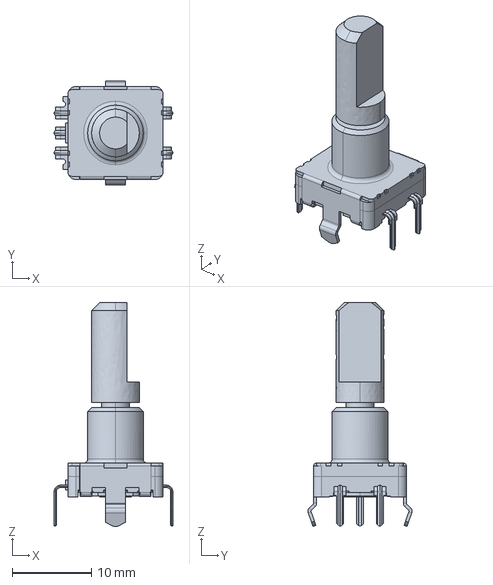
[picture p249: CAD file, 2026-10-06]
DesktopSpeaker-kicad/kicad-library/3d/EC11E15244G1.step
15.0 x 13.1 x 28.2 mm
