chithigun23/DesktopSpeaker/ai-files/cad/models-v13/3d/JST_B2P-VH_LF_SN.step

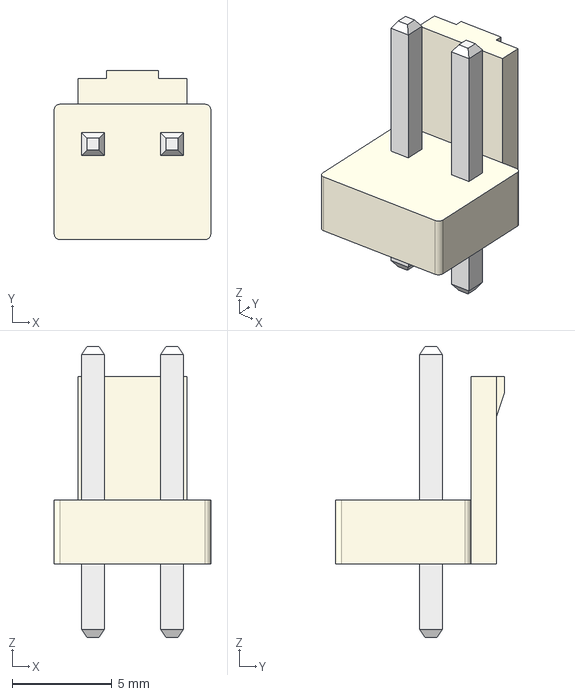
[picture p250: CAD file, 2026-11-02]
ai-files/cad/models-v13/3d/JST_B2P-VH_LF_SN.step
7.86 x 8.50 x 14.6 mm
