chithigun23/DesktopSpeaker/ai-files/cad/models-v13/3d/Spacer_Wurth_970100321_M3x10_FF.step

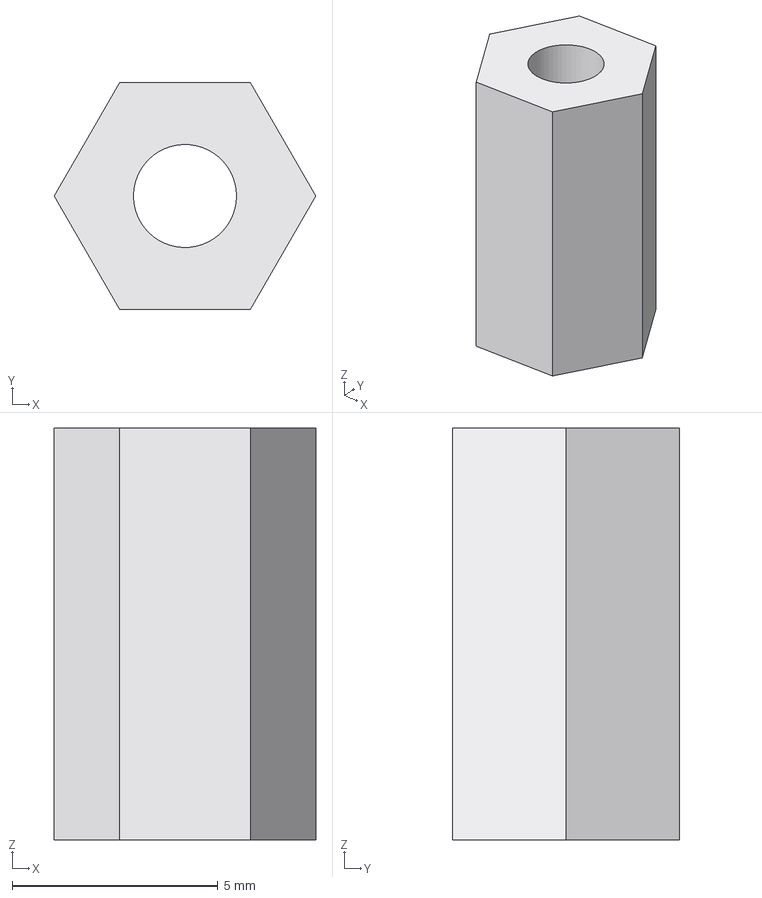
[picture p252: CAD file, 2026-11-02]
ai-files/cad/models-v13/3d/Spacer_Wurth_970100321_M3x10_FF.step
6.35 x 5.50 x 10.0 mm
