chithigun23/DesktopSpeaker/DesktopSpeaker-kicad/kicad-library/3d/R_0402_1005Metric.step

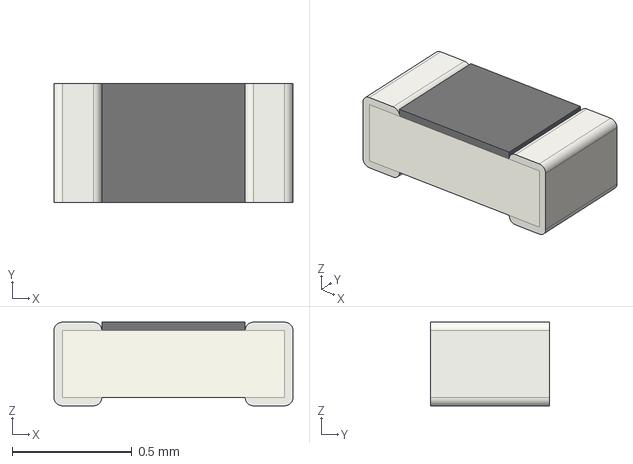
[picture p253: CAD file, 2026-10-05]
DesktopSpeaker-kicad/kicad-library/3d/R_0402_1005Metric.step
1.00 x 0.5 x 0.35 mm
