chithigun23/DesktopSpeaker/ai-files/cad/models-v13/3d/Knob_StandIn_D30x14_6mmD.step

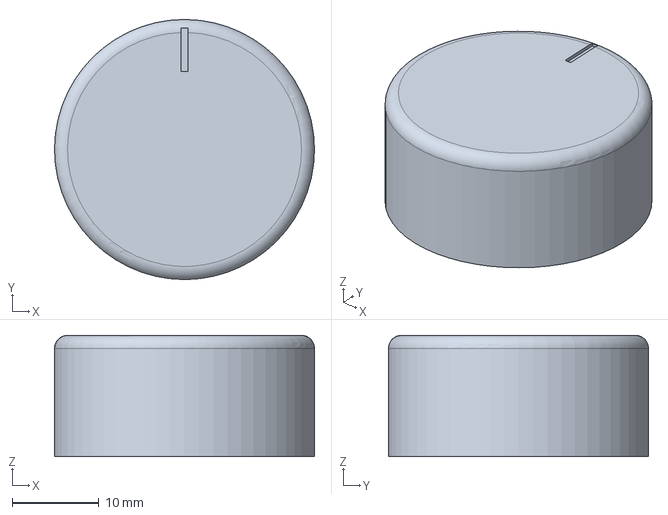
[picture p254: CAD file, 2026-11-02]
ai-files/cad/models-v13/3d/Knob_StandIn_D30x14_6mmD.step
30.0 x 30.0 x 14.0 mm
