chithigun23/DesktopSpeaker/DesktopSpeaker-kicad/kicad-library/3d/CP_Elec_8x10.step

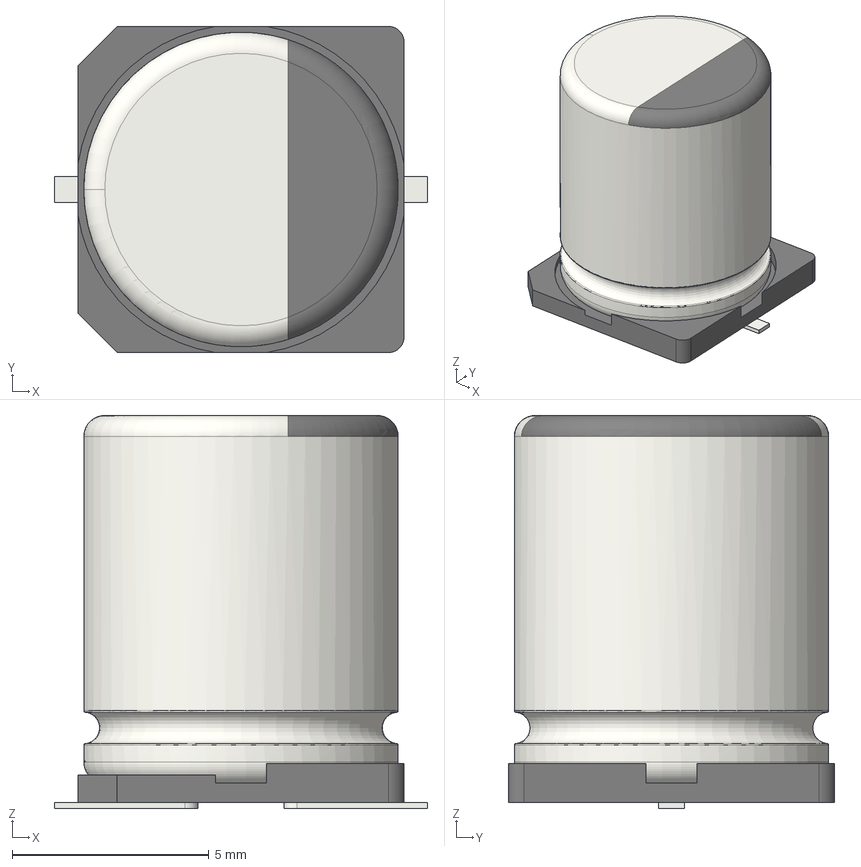
[picture p255: CAD file, 2026-10-05]
DesktopSpeaker-kicad/kicad-library/3d/CP_Elec_8x10.step
9.50 x 8.30 x 10.0 mm
