chithigun23/DesktopSpeaker/ai-files/cad/models-v13/3d/CW_GRB112B802BR1_Rocker.step

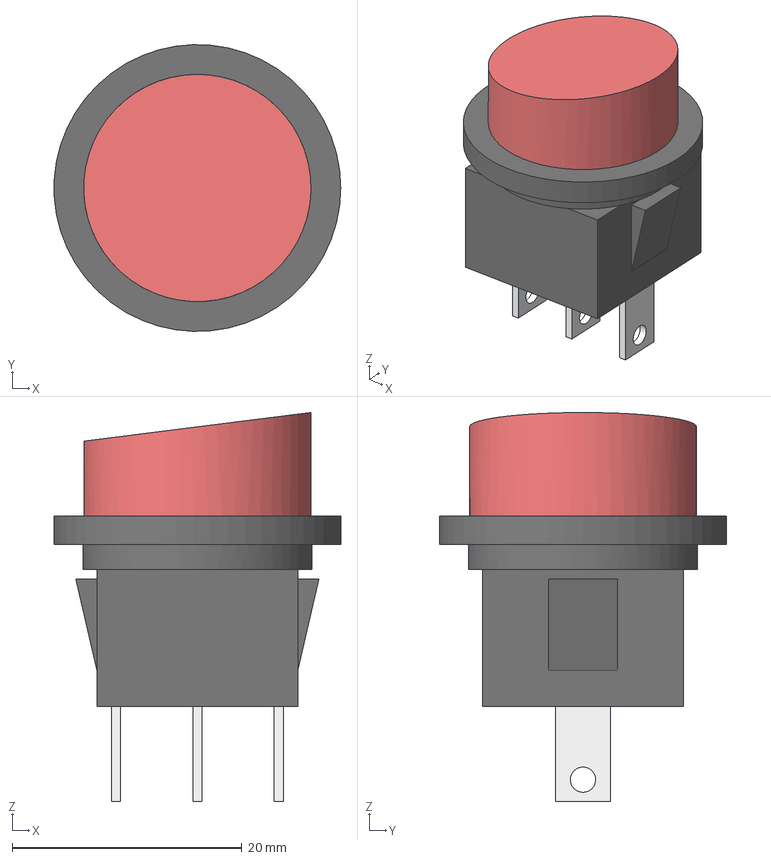
[picture p256: CAD file, 2026-11-02]
ai-files/cad/models-v13/3d/CW_GRB112B802BR1_Rocker.step
25.0 x 25.0 x 33.9 mm
