chithigun23/DesktopSpeaker/DesktopSpeaker-kicad/kicad-library/3d/L_Sunlord_MWSA1265S.step

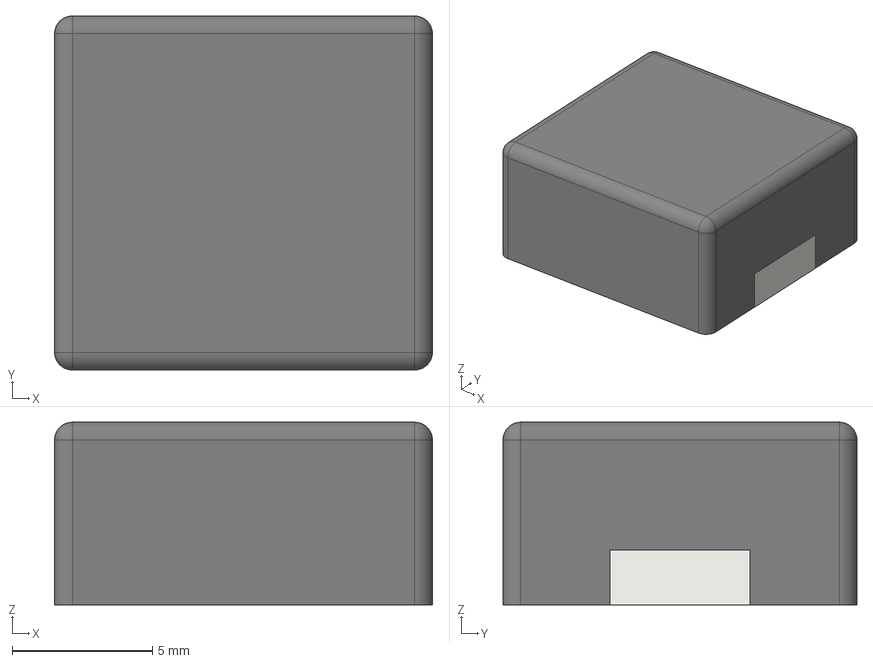
[picture p257: CAD file, 2026-10-05]
DesktopSpeaker-kicad/kicad-library/3d/L_Sunlord_MWSA1265S.step
13.5 x 12.6 x 6.50 mm
a9642296-8551-11ed-a139-00155d22e2d7_part
a96423d6-8551-11ed-a139-00155d22e2d7_part
a964244e-8551-11ed-a139-00155d22e2d7_part
