chithigun23/DesktopSpeaker/ai-files/cad/models-v13/3d/Keystone_5015_TestPoint_MicroMini.step

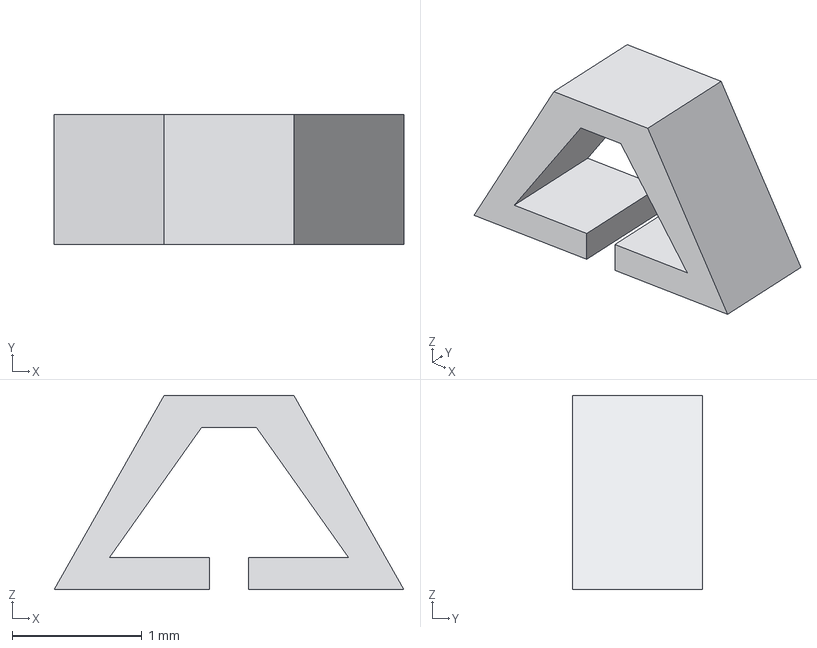
[picture p258: CAD file, 2026-11-02]
ai-files/cad/models-v13/3d/Keystone_5015_TestPoint_MicroMini.step
2.70 x 1.00 x 1.50 mm
