chithigun23/DesktopSpeaker/DesktopSpeaker-kicad/kicad-library/3d/L_Coilcraft_XAL7070-XXX.step

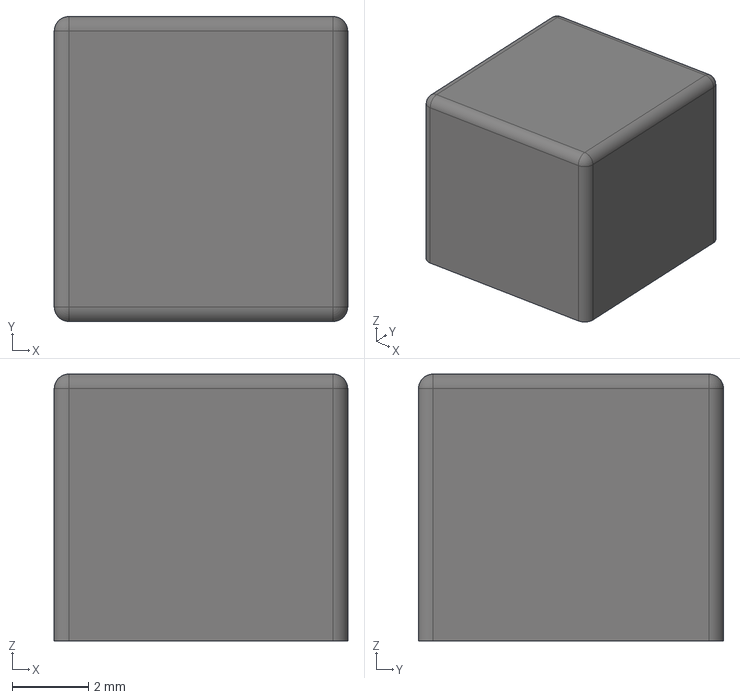
[picture p259: CAD file, 2026-10-05]
DesktopSpeaker-kicad/kicad-library/3d/L_Coilcraft_XAL7070-XXX.step
7.70 x 8.00 x 7.00 mm
