chithigun23/DesktopSpeaker/ai-files/cad/models-v13/3d/Cell_Molicel_INR21700-P45B.step

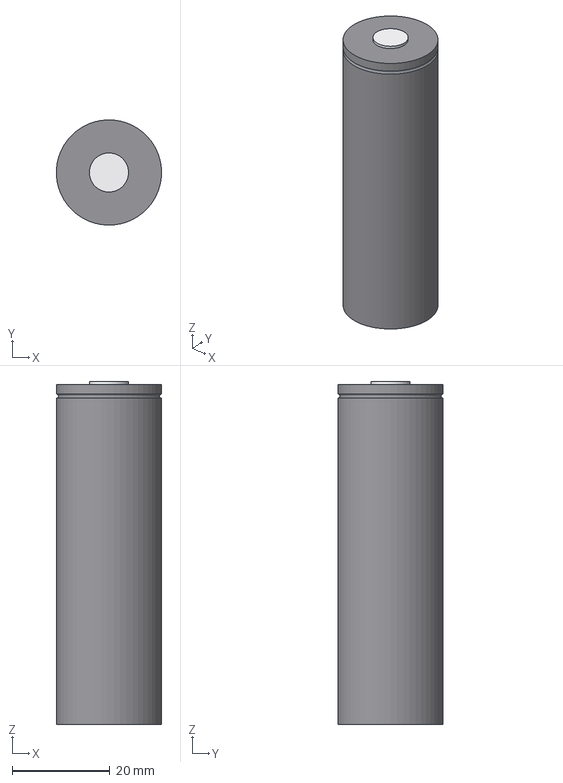
[picture p260: CAD file, 2026-11-02]
ai-files/cad/models-v13/3d/Cell_Molicel_INR21700-P45B.step
21.5 x 21.5 x 70.2 mm
