chithigun23/DesktopSpeaker/DesktopSpeaker-kicad/kicad-library/3d/PCM1862DBTR.step

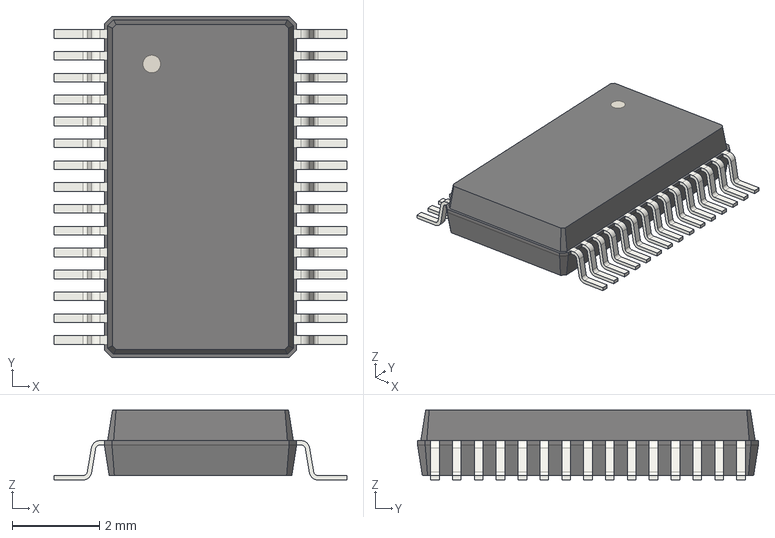
[picture p261: CAD file, 2026-10-05]
DesktopSpeaker-kicad/kicad-library/3d/PCM1862DBTR.step
6.70 x 7.80 x 1.60 mm
