chithigun23/DesktopSpeaker/DesktopSpeaker-kicad/kicad-library/3d/STM32G071RBT6.step

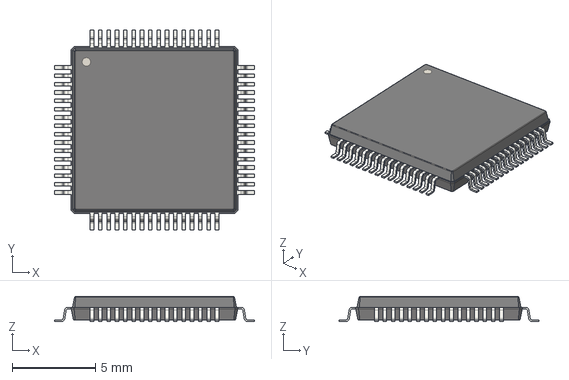
[picture p262: CAD file, 2026-10-05]
DesktopSpeaker-kicad/kicad-library/3d/STM32G071RBT6.step
12.0 x 12.0 x 1.50 mm
