chithigun23/DesktopSpeaker/DesktopSpeaker-kicad/kicad-library/3d/Crystal_SMD_3225-4Pin_3.2x2.5mm.step

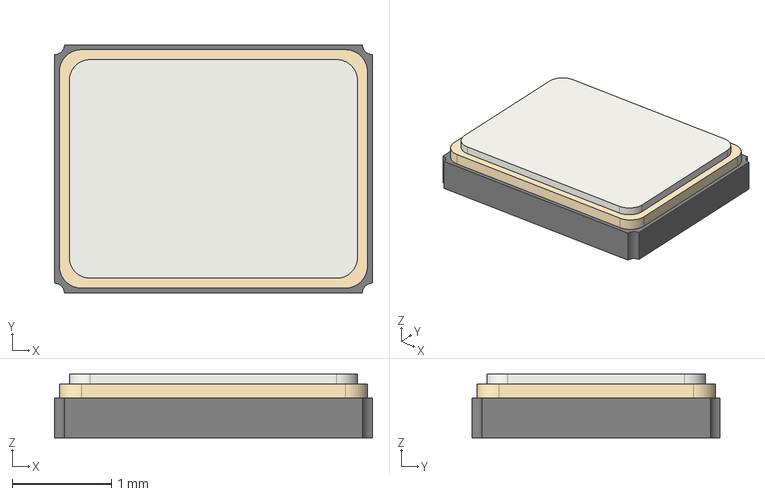
[picture p263: CAD file, 2026-10-05]
DesktopSpeaker-kicad/kicad-library/3d/Crystal_SMD_3225-4Pin_3.2x2.5mm.step
3.20 x 2.50 x 0.64 mm
