chithigun23/DesktopSpeaker/DesktopSpeaker-kicad/kicad-library/3d/PinHeader_1x05_P2.54mm_Vertical.step

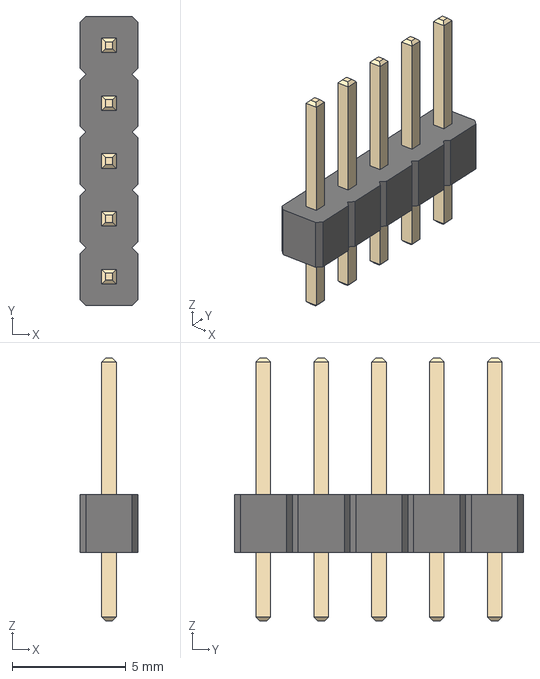
[picture p264: CAD file, 2026-10-05]
DesktopSpeaker-kicad/kicad-library/3d/PinHeader_1x05_P2.54mm_Vertical.step
2.54 x 12.7 x 11.5 mm
