chithigun23/DesktopSpeaker/DesktopSpeaker-kicad/kicad-library/3d/REF0038A.stp

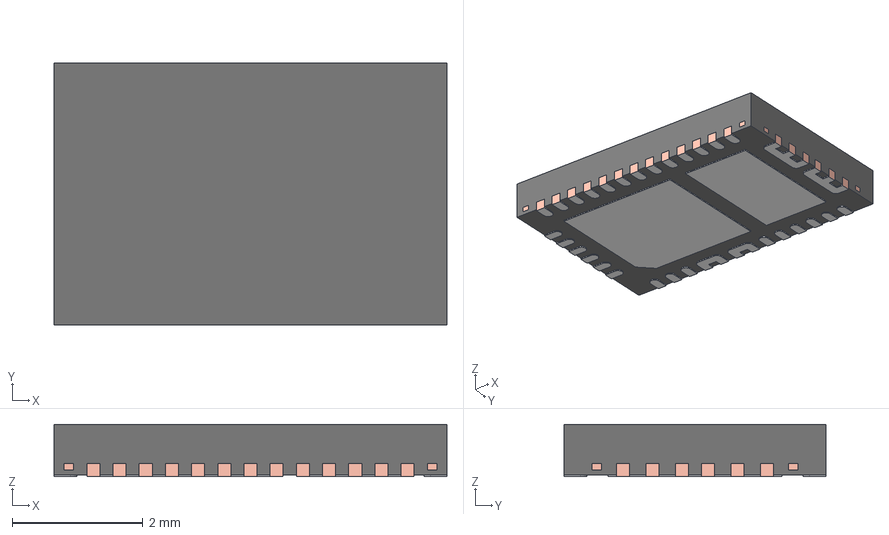
[picture p265: CAD file, 2026-10-05]
DesktopSpeaker-kicad/kicad-library/3d/REF0038A.stp
6.00 x 4.00 x 0.8 mm
BODY-QFN
FRAME-REF0038A
PIN1-ID
