chithigun23/DesktopSpeaker/DesktopSpeaker-kicad/kicad-library/3d/BZT52C12-7-F.step

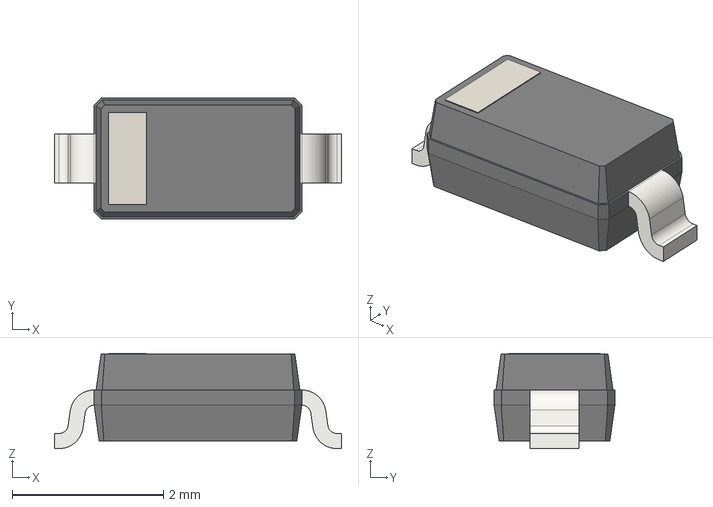
[picture p266: CAD file, 2026-10-05]
DesktopSpeaker-kicad/kicad-library/3d/BZT52C12-7-F.step
3.80 x 1.60 x 1.26 mm
