chithigun23/DesktopSpeaker/DesktopSpeaker-kicad/kicad-library/3d/TYPE-C-31-M-12.step

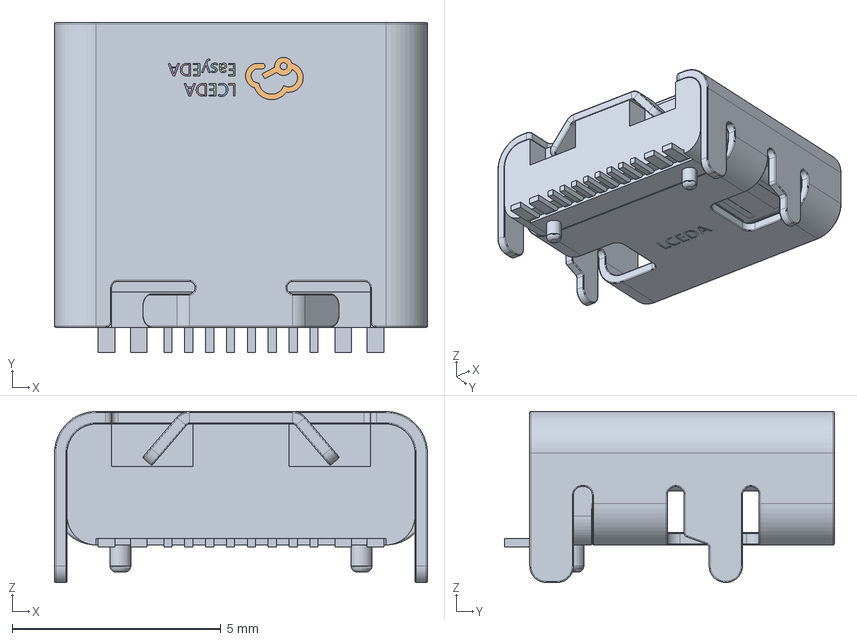
[picture p267: CAD file, 2026-10-05]
DesktopSpeaker-kicad/kicad-library/3d/TYPE-C-31-M-12.step
8.94 x 7.90 x 4.10 mm
