chithigun23/DesktopSpeaker/DesktopSpeaker-kicad/kicad-library/3d/Bourns_SRN6045TA-2R2Y.step

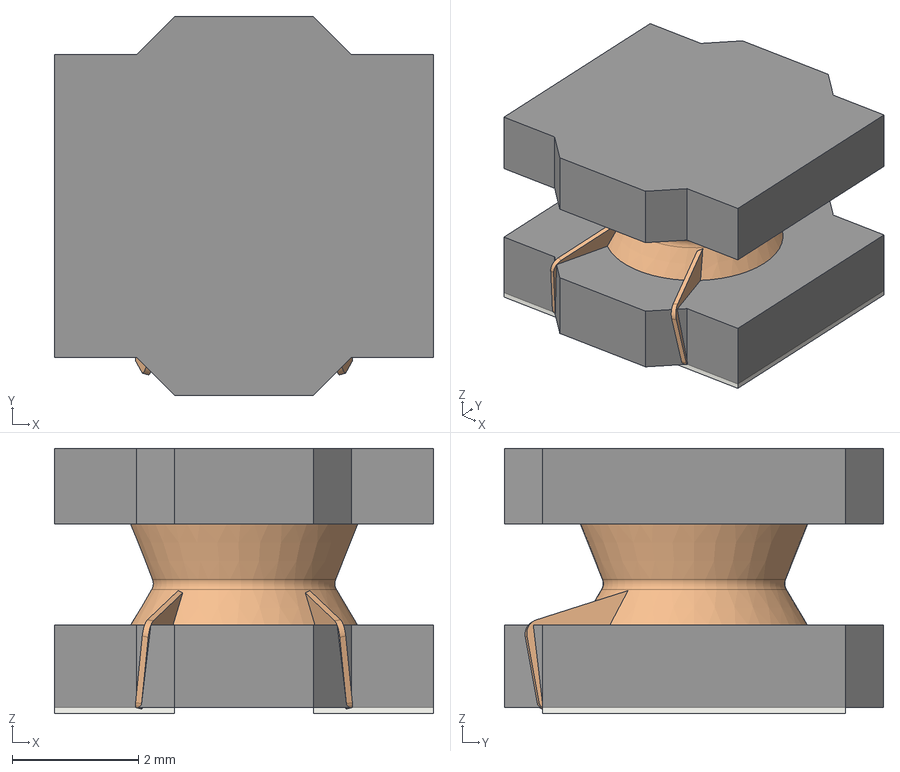
[picture p268: CAD file, 2026-10-05]
DesktopSpeaker-kicad/kicad-library/3d/Bourns_SRN6045TA-2R2Y.step
6.00 x 6.00 x 4.20 mm
