chithigun23/DesktopSpeaker/DesktopSpeaker-kicad/kicad-library/3d/TMUX1511PWR.step

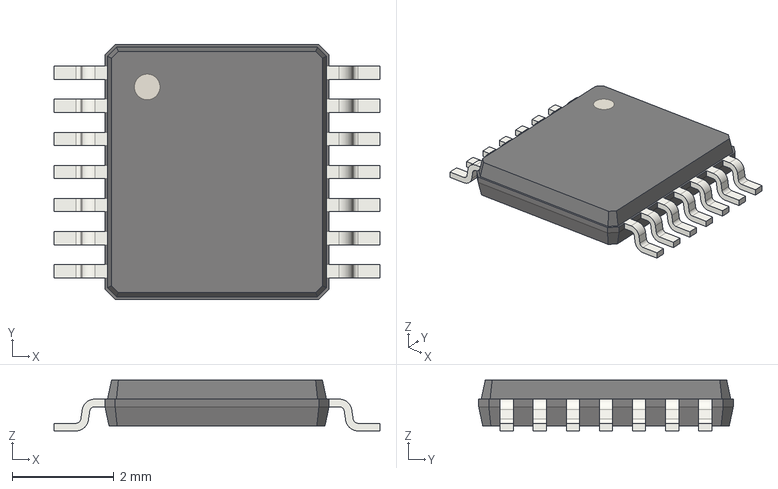
[picture p269: CAD file, 2026-10-05]
DesktopSpeaker-kicad/kicad-library/3d/TMUX1511PWR.step
6.40 x 5.00 x 1.00 mm
