chithigun23/DesktopSpeaker/DesktopSpeaker-kicad/kicad-library/3d/Coilcraft_XFL4015-471MEC.step

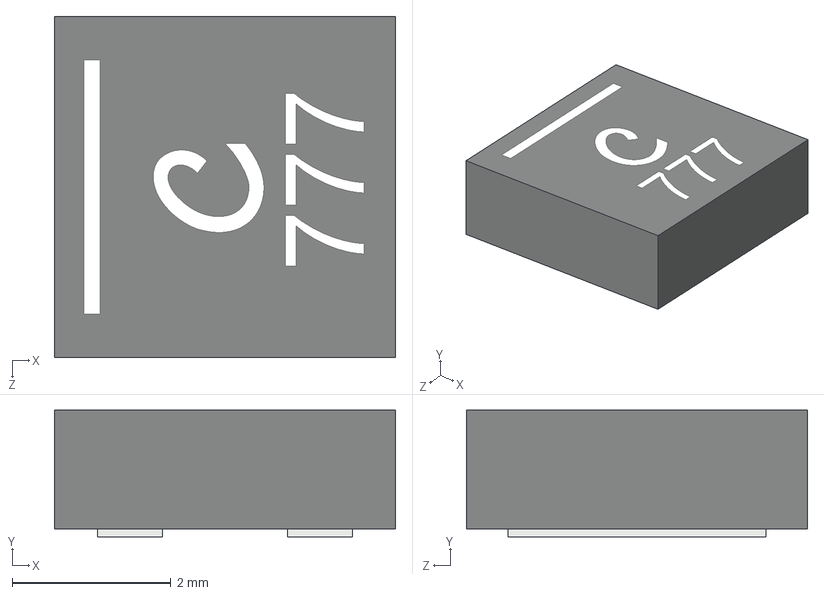
[picture p270: CAD file, 2026-10-05]
DesktopSpeaker-kicad/kicad-library/3d/Coilcraft_XFL4015-471MEC.step
4.30 x 1.60 x 4.30 mm
