chithigun23/DesktopSpeaker/DesktopSpeaker-kicad/kicad-library/3d/STUSB4500QTR.step

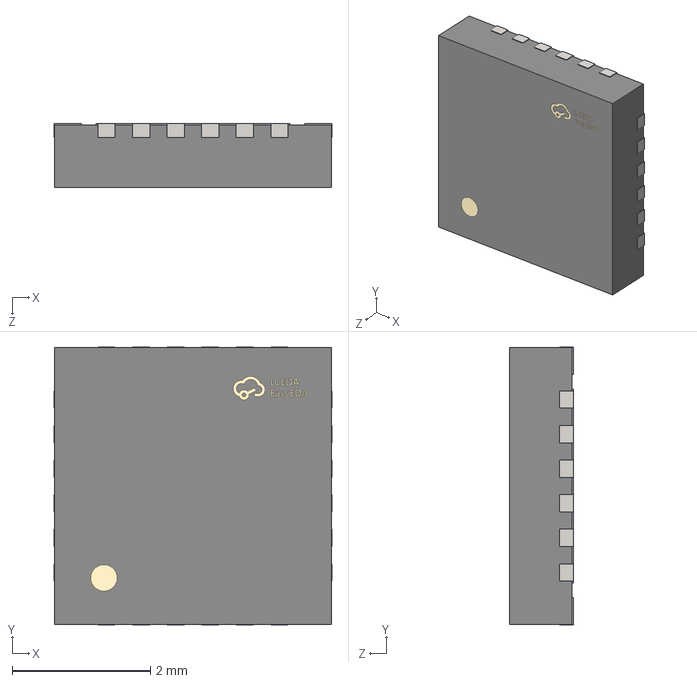
[picture p271: CAD file, 2026-10-05]
DesktopSpeaker-kicad/kicad-library/3d/STUSB4500QTR.step
4.02 x 4.02 x 0.92 mm
