chithigun23/DesktopSpeaker/DesktopSpeaker-kicad/kicad-library/3d/STL9P3LLH6.step

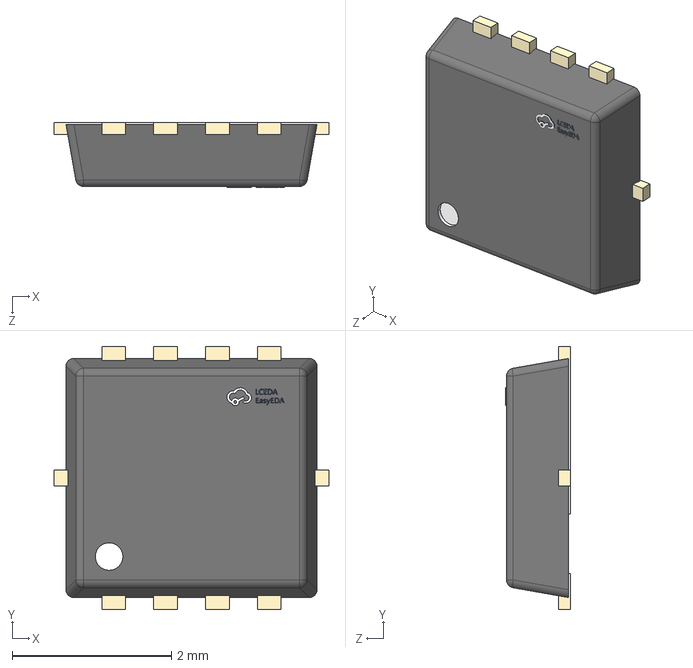
[picture p272: CAD file, 2026-10-05]
DesktopSpeaker-kicad/kicad-library/3d/STL9P3LLH6.step
3.45 x 3.30 x 0.81 mm
