chithigun23/DesktopSpeaker/DesktopSpeaker-kicad/kicad-library/3d/JST_B3P-VH.step

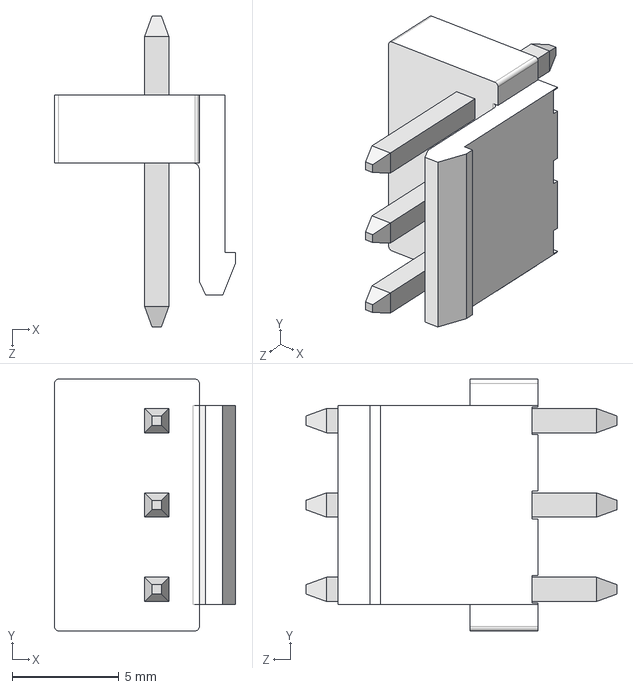
[picture p273: CAD file, 2026-10-05]
DesktopSpeaker-kicad/kicad-library/3d/JST_B3P-VH.step
8.50 x 11.8 x 14.6 mm
