chithigun23/DesktopSpeaker/DesktopSpeaker-kicad/kicad-library/3d/TPA6132A2RTER.step

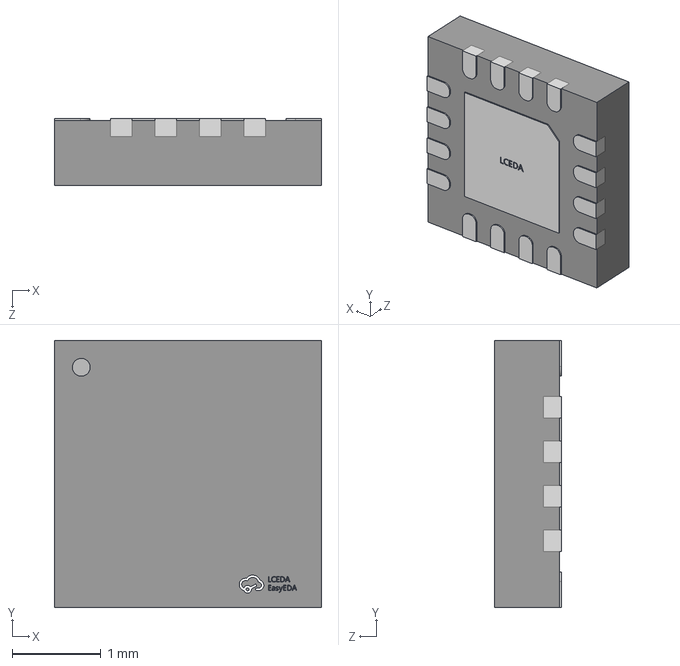
[picture p274: CAD file, 2026-10-05]
DesktopSpeaker-kicad/kicad-library/3d/TPA6132A2RTER.step
3.00 x 3.00 x 0.751 mm
