chithigun23/DesktopSpeaker/DesktopSpeaker-kicad/kicad-library/3d/PESD5V0S2BT.step

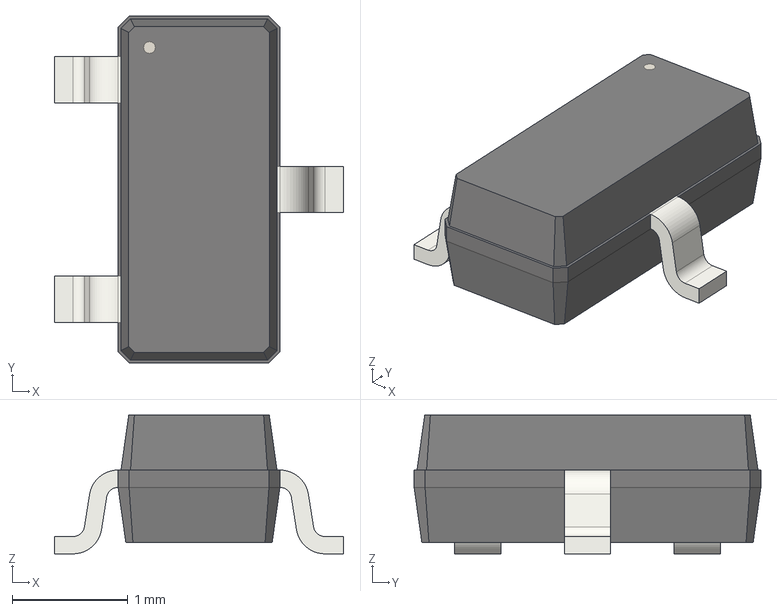
[picture p276: CAD file, 2026-10-05]
DesktopSpeaker-kicad/kicad-library/3d/PESD5V0S2BT.step
2.50 x 3.00 x 1.20 mm
