chithigun23/DesktopSpeaker/DesktopSpeaker-kicad/kicad-library/3d/TVS2200DRVR.step

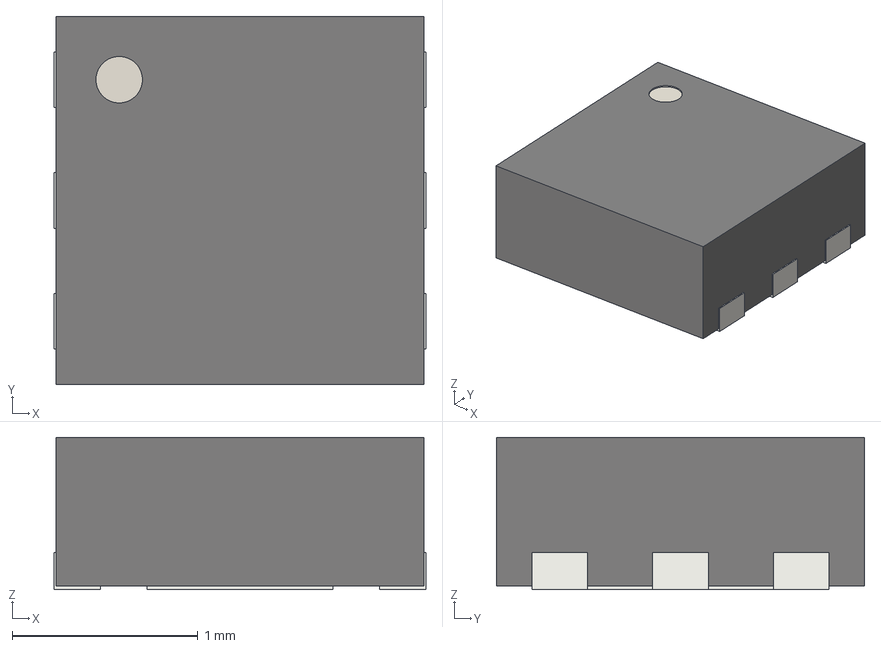
[picture p277: CAD file, 2026-10-05]
DesktopSpeaker-kicad/kicad-library/3d/TVS2200DRVR.step
2.00 x 1.98 x 0.82 mm
