chithigun23/DesktopSpeaker/DesktopSpeaker-kicad/kicad-library/3d/R_0603_1608Metric.step

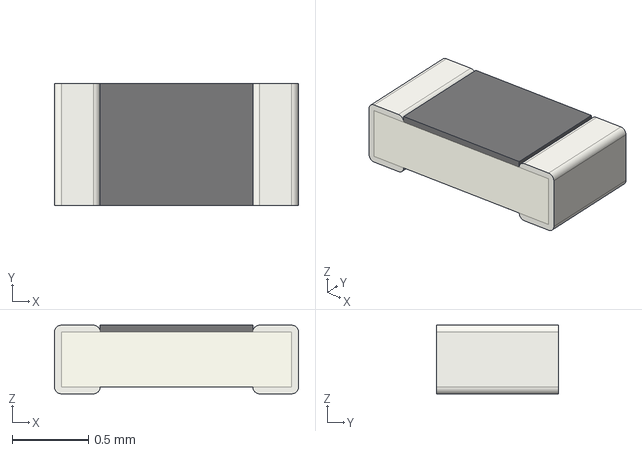
[picture p278: CAD file, 2026-10-05]
DesktopSpeaker-kicad/kicad-library/3d/R_0603_1608Metric.step
1.60 x 0.8 x 0.45 mm
