chithigun23/DesktopSpeaker/DesktopSpeaker-kicad/kicad-library/3d/PD_C_1210.step

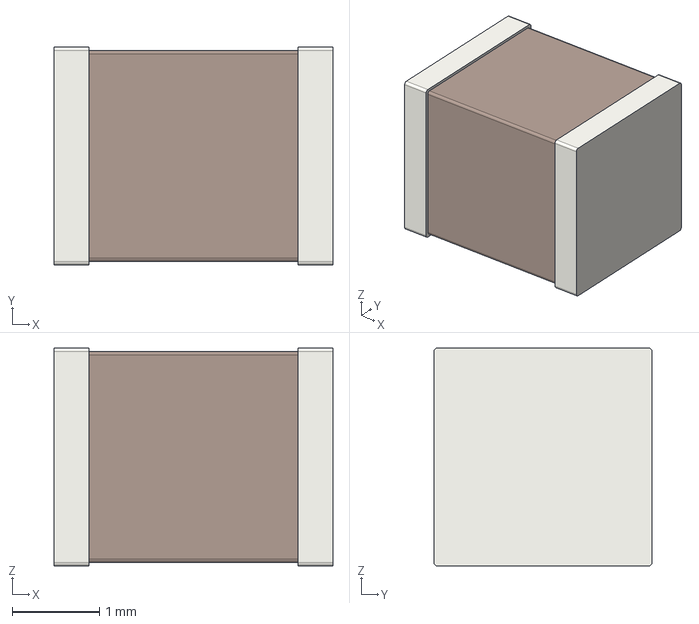
[picture p279: CAD file, 2026-10-05]
DesktopSpeaker-kicad/kicad-library/3d/PD_C_1210.step
3.20 x 2.50 x 2.50 mm
