chithigun23/DesktopSpeaker/DesktopSpeaker-kicad/kicad-library/3d/C_0603_1608Metric.step

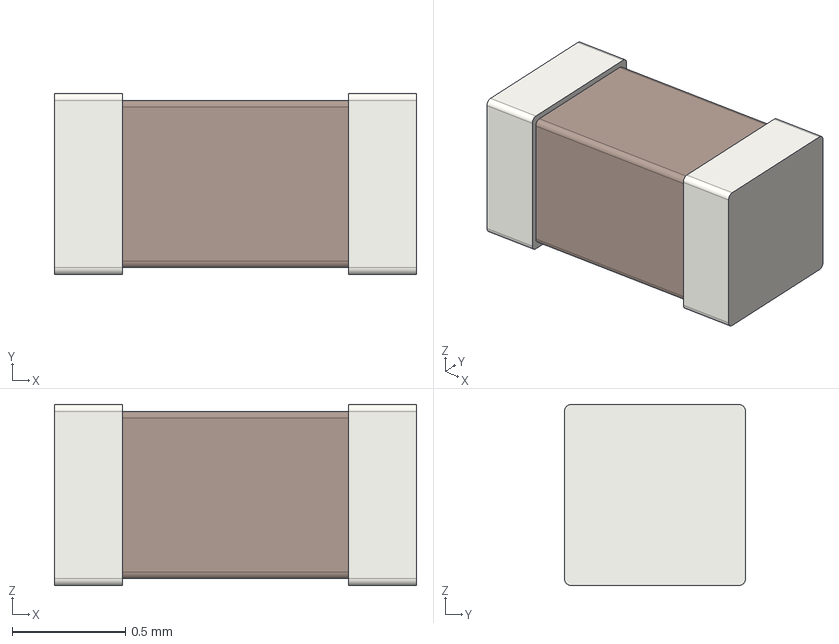
[picture p280: CAD file, 2026-10-05]
DesktopSpeaker-kicad/kicad-library/3d/C_0603_1608Metric.step
1.60 x 0.8 x 0.8 mm
