chithigun23/DesktopSpeaker/DesktopSpeaker-kicad/kicad-library/3d/TS5A23157DGSR.step

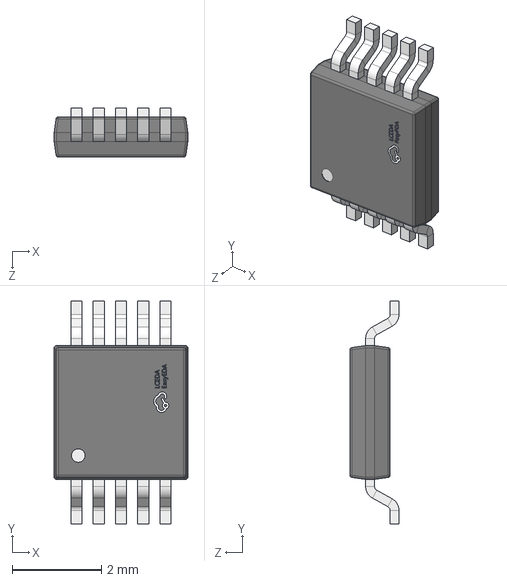
[picture p281: CAD file, 2026-10-05]
DesktopSpeaker-kicad/kicad-library/3d/TS5A23157DGSR.step
3.00 x 5.00 x 1.10 mm
