chithigun23/DesktopSpeaker/DesktopSpeaker-kicad/kicad-library/3d/PD_R_1206.step

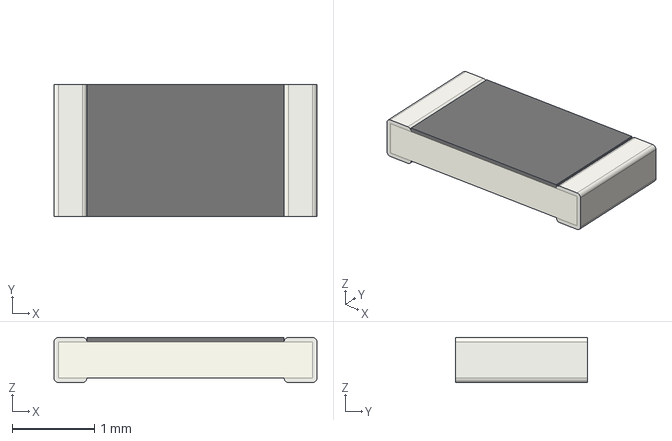
[picture p282: CAD file, 2026-10-05]
DesktopSpeaker-kicad/kicad-library/3d/PD_R_1206.step
3.20 x 1.60 x 0.55 mm
