chithigun23/DesktopSpeaker/DesktopSpeaker-kicad/kicad-library/3d/SMA6J10A.step

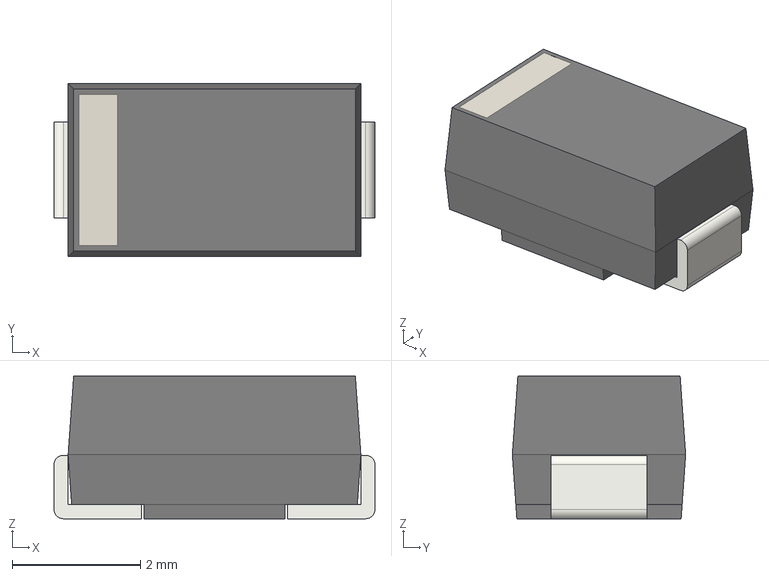
[picture p283: CAD file, 2026-10-05]
DesktopSpeaker-kicad/kicad-library/3d/SMA6J10A.step
5.00 x 2.70 x 2.22 mm
