chithigun23/DesktopSpeaker/DesktopSpeaker-kicad/kicad-library/3d/SMBJ10A.step

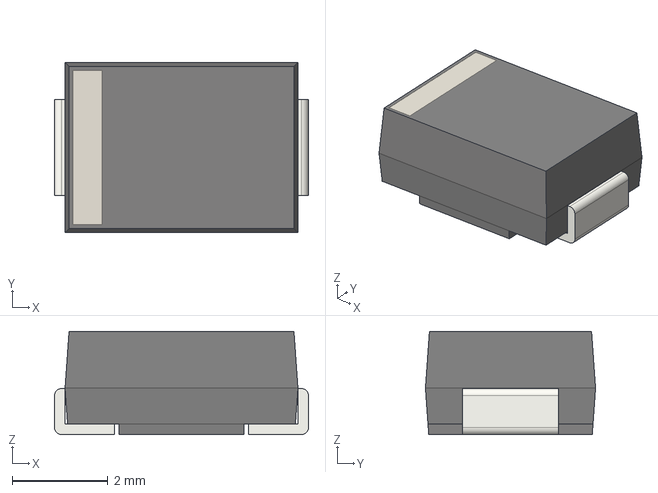
[picture p284: CAD file, 2026-10-05]
DesktopSpeaker-kicad/kicad-library/3d/SMBJ10A.step
5.30 x 3.55 x 2.15 mm
