chithigun23/DesktopSpeaker/DesktopSpeaker-kicad/kicad-library/3d/PD_C_1206.step

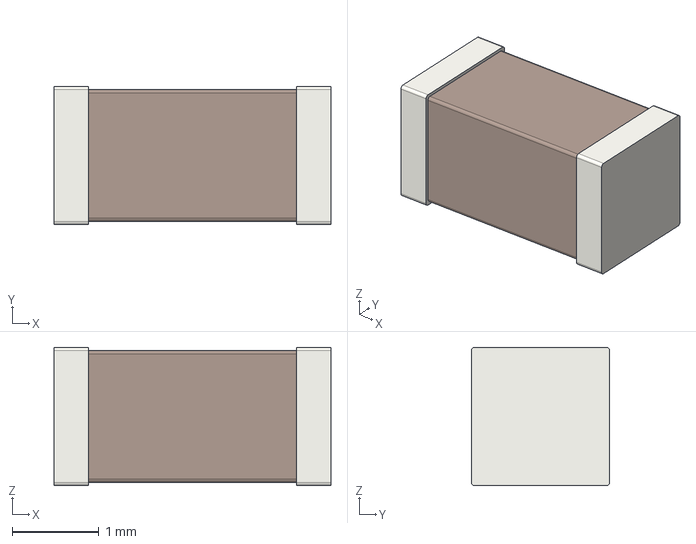
[picture p285: CAD file, 2026-10-05]
DesktopSpeaker-kicad/kicad-library/3d/PD_C_1206.step
3.20 x 1.60 x 1.60 mm
