chithigun23/DesktopSpeaker/DesktopSpeaker-kicad/kicad-library/3d/TPD2E2U06DRLR.step

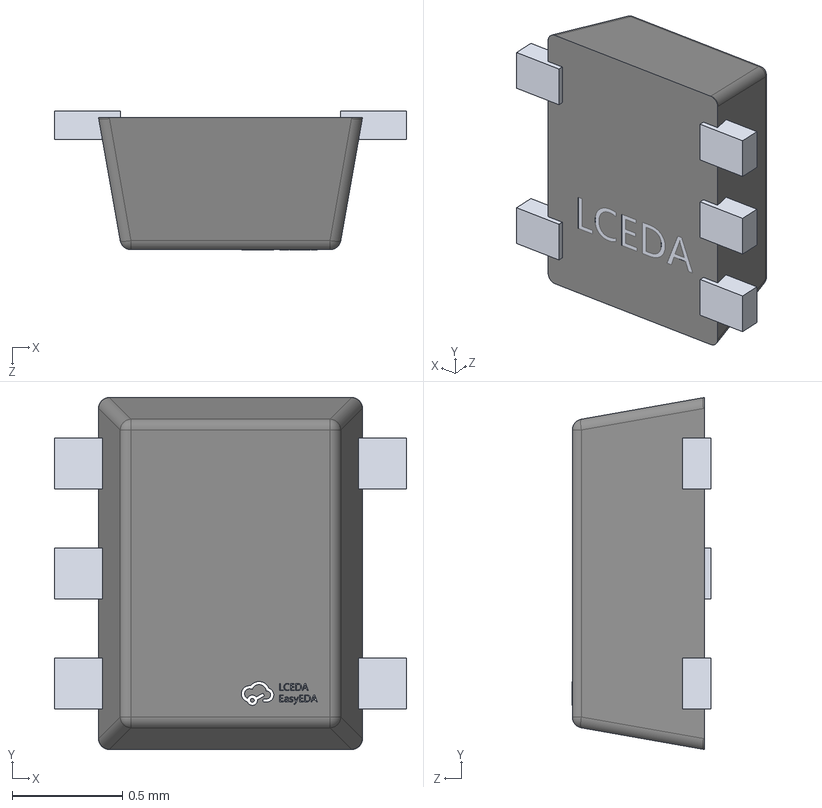
[picture p286: CAD file, 2026-10-05]
DesktopSpeaker-kicad/kicad-library/3d/TPD2E2U06DRLR.step
1.60 x 1.60 x 0.631 mm
