chithigun23/DesktopSpeaker/DesktopSpeaker-kicad/kicad-library/3d/BSC014N06NS.step

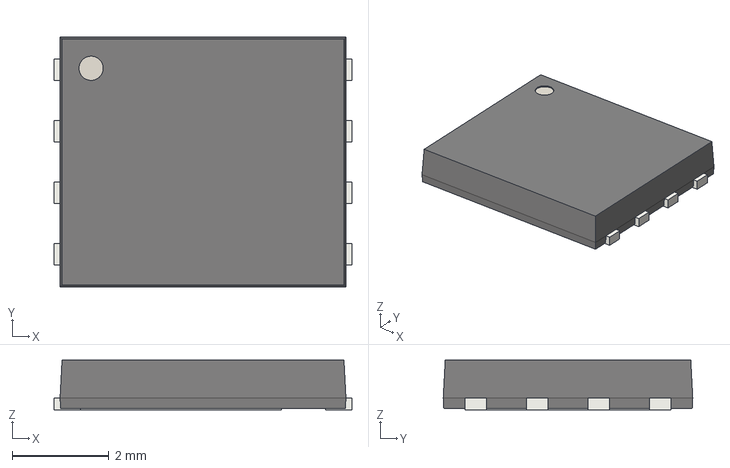
[picture p287: CAD file, 2026-10-05]
DesktopSpeaker-kicad/kicad-library/3d/BSC014N06NS.step
6.15 x 5.15 x 1.03 mm
