chithigun23/DesktopSpeaker/DesktopSpeaker-kicad/kicad-library/3d/TPS7A2033PDBVR.step

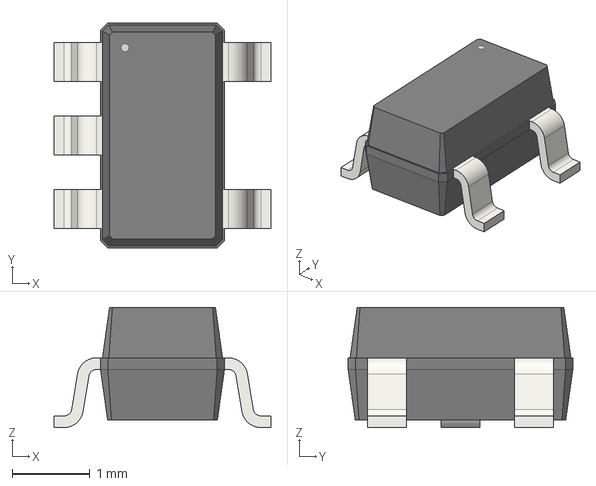
[picture p288: CAD file, 2026-10-05]
DesktopSpeaker-kicad/kicad-library/3d/TPS7A2033PDBVR.step
2.80 x 2.90 x 1.55 mm
