chithigun23/DesktopSpeaker/DesktopSpeaker-kicad/kicad-library/3d/TPS7B8450QWDRBRQ1.step

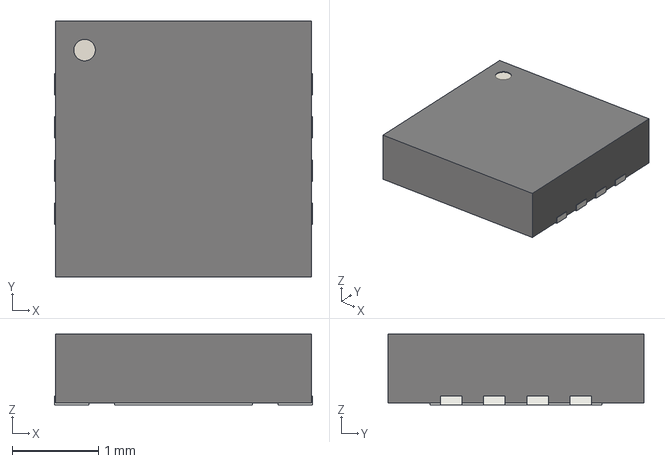
[picture p289: CAD file, 2026-10-05]
DesktopSpeaker-kicad/kicad-library/3d/TPS7B8450QWDRBRQ1.step
3.00 x 2.98 x 0.82 mm
