chithigun23/DesktopSpeaker/DesktopSpeaker-kicad/kicad-library/3d/C_0805_2012Metric.step

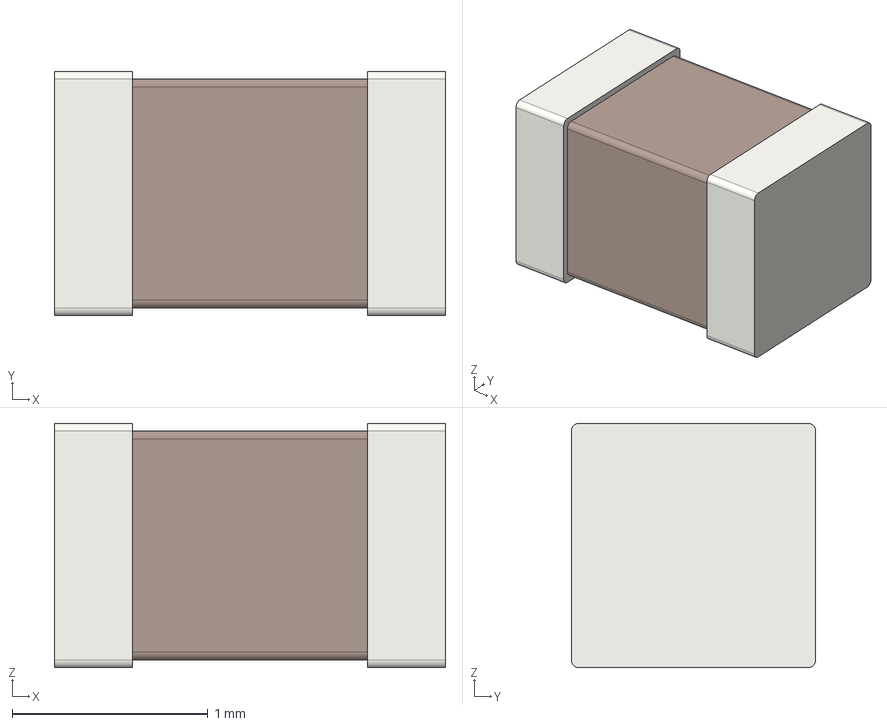
[picture p290: CAD file, 2026-10-05]
DesktopSpeaker-kicad/kicad-library/3d/C_0805_2012Metric.step
2.00 x 1.25 x 1.25 mm
