chithigun23/DesktopSpeaker/DesktopSpeaker-kicad/kicad-library/3d/STM32G031K8T6.step

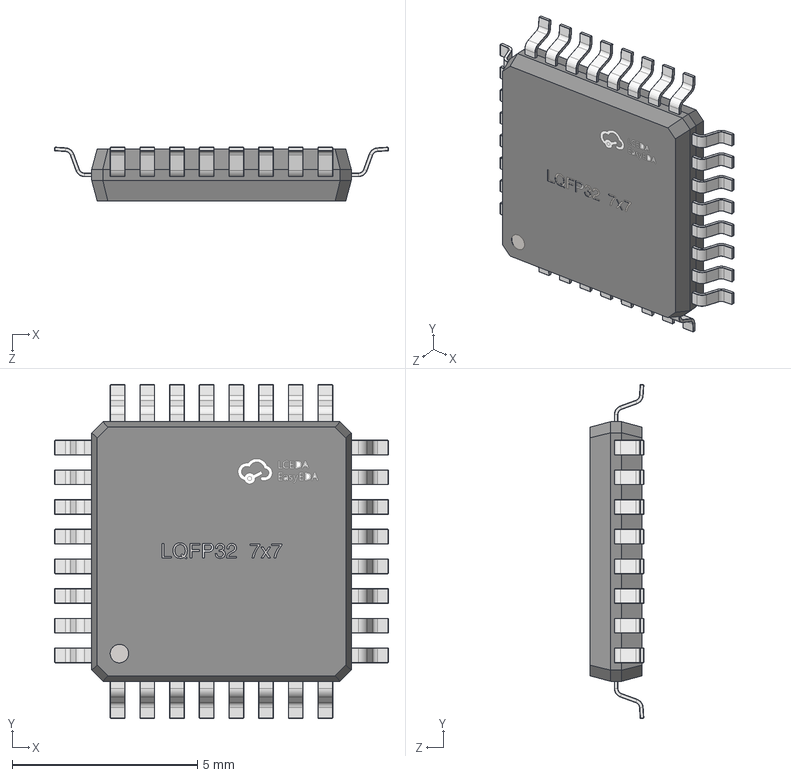
[picture p291: CAD file, 2026-09-27]
DesktopSpeaker-kicad/kicad-library/3d/STM32G031K8T6.step
9.01 x 9.01 x 1.45 mm
