chithigun23/DesktopSpeaker/DesktopSpeaker-kicad/kicad-library/3d/PCM2902CDBR.step

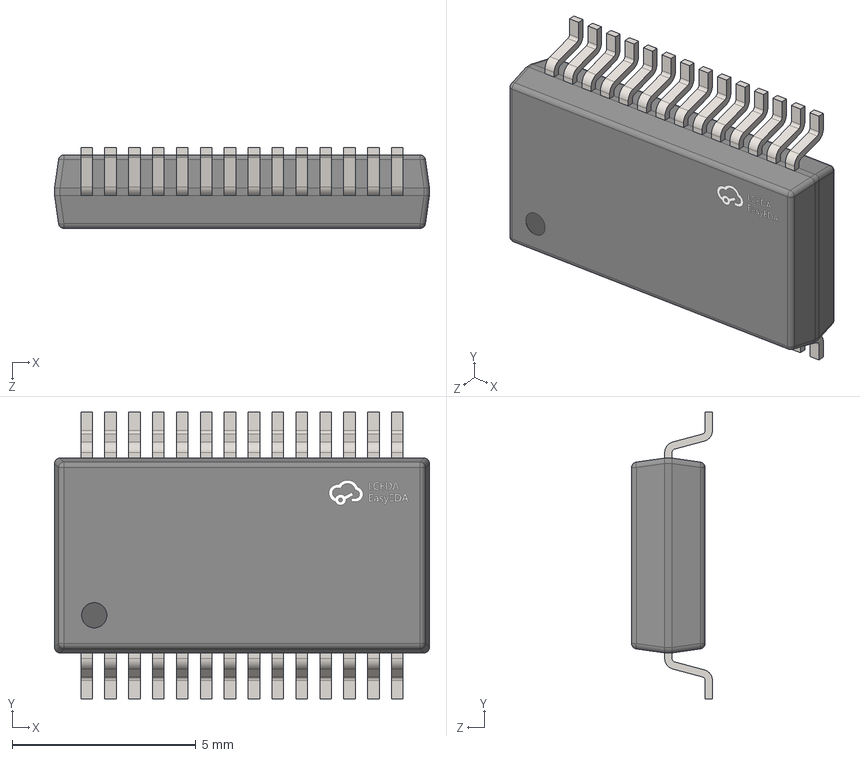
[picture p292: CAD file, 2026-09-27]
DesktopSpeaker-kicad/kicad-library/3d/PCM2902CDBR.step
10.2 x 7.80 x 2.20 mm
