chithigun23/DesktopSpeaker/DesktopSpeaker-kicad/kicad-library/3d/BM83SM1-00TA.step

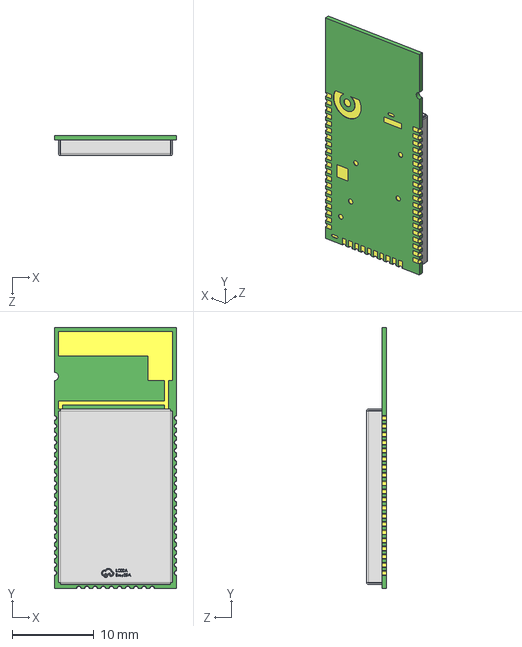
[picture p293: CAD file, 2026-09-27]
DesktopSpeaker-kicad/kicad-library/3d/BM83SM1-00TA.step
15.0 x 32.0 x 2.51 mm
