chithigun23/DesktopSpeaker/DesktopSpeaker-kicad/kicad-library/3d/TAS5825MRHBR.step

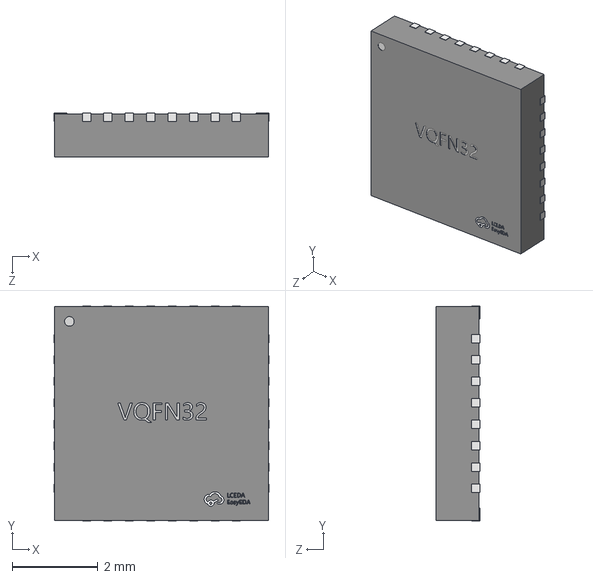
[picture p294: CAD file, 2026-09-27]
DesktopSpeaker-kicad/kicad-library/3d/TAS5825MRHBR.step
5.02 x 5.02 x 1.02 mm
