chithigun23/DesktopSpeaker/(list of files, cad)

Other CAD files:
ai-files/cad/v13p4/3P/print/DesktopSpeaker_shell.stl
DesktopSpeaker-kicad/kicad-library/3d/PJ-307.step
DesktopSpeaker-kicad/kicad-library/3d/BQ25895RTWR.step
DesktopSpeaker-kicad/kicad-library/3d/MAX17048G+T10.step
DesktopSpeaker-kicad/kicad-library/3d/TPS22917DBVR.step
DesktopSpeaker-kicad/kicad-library/3d/TPS26600PWPR_datasheet_EP.step
DesktopSpeaker-kicad/kicad-library/3d/TPS61023DRLT.step
DesktopSpeaker-kicad/kicad-library/3d/TPS61088RHLR.step
DesktopSpeaker-kicad/kicad-library/3d/TPS63802DLAR.step
ai-files/cad/DesktopSpeaker_internal.FCStd
ai-files/cad/models-v13/3d/Screw_ISO4762_M3x10.step
ai-files/cad/models-v13/3d/Screw_ISO4762_M3x16.step
ai-files/cad/parts/ND65_3D/ND65-4 and 8.stl
ai-files/cad/parts/ND65_3D/ND65-4_and_8.dwg
ai-files/cad/print/DesktopSpeaker_lid.stl
ai-files/cad/print/DesktopSpeaker_shell.stl
ai-files/cad/v12/print/DesktopSpeaker_lid.stl
ai-files/cad/v12/print/DesktopSpeaker_shell.stl
ai-files/cad/v12/print/DesktopSpeaker_woofer_chamber_insert.stl
ai-files/cad/v13p4/4P/print/DesktopSpeaker_lid.stl
ai-files/cad/v13p4/4P/print/DesktopSpeaker_shell.stl
ai-files/cad/v13p4/4P/print/DesktopSpeaker_woofer_chamber_insert.stl
ai-files/candidates/TPS26600-body-only-wrong-EP.step
