chithigun23/DesktopSpeaker/ai-files/cad/v13p4/3P/renders/assembled_front_right.png

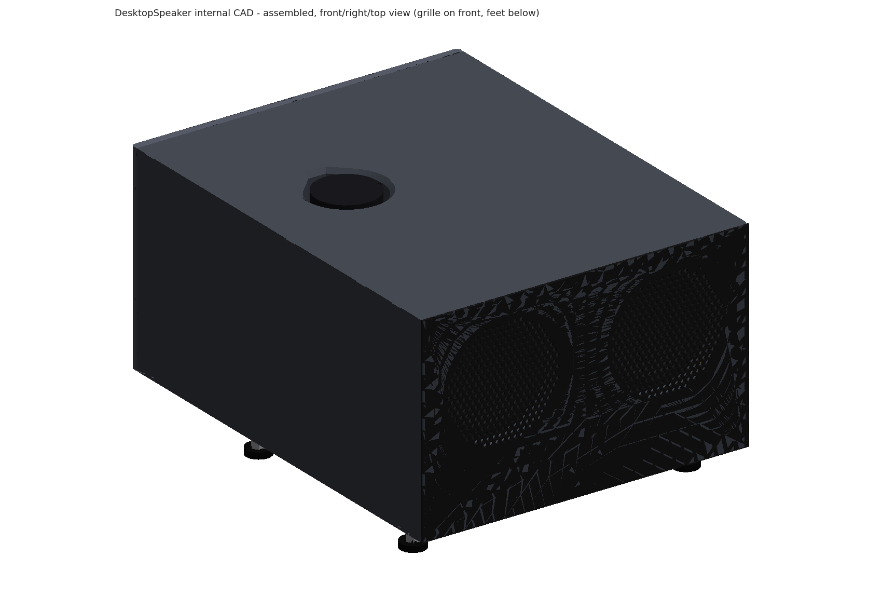
ai-files/cad/v13p4/3P/renders/assembled_front_right.png
