chithigun23/DesktopSpeaker/ai-files/cad/v13p4/3P/renders/assembled_underside.png

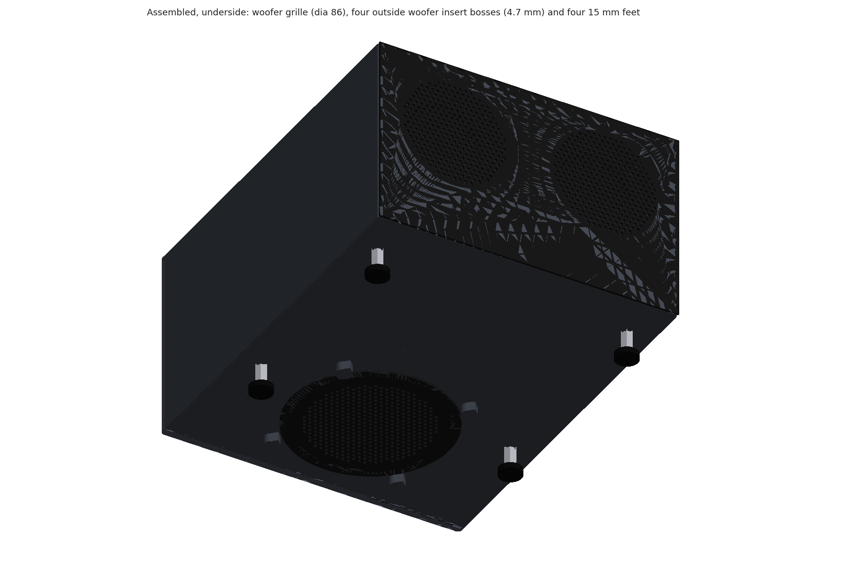
ai-files/cad/v13p4/3P/renders/assembled_underside.png
