chithigun23/DesktopSpeaker/ai-files/cad/v13p4/4P/renders/print_shell.png

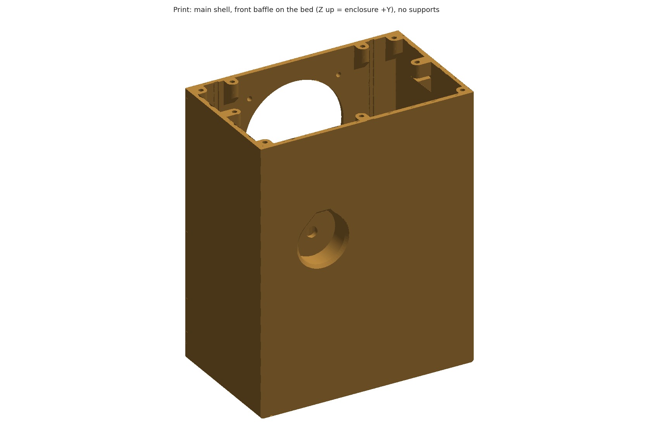
ai-files/cad/v13p4/4P/renders/print_shell.png
