chithigun23/DesktopSpeaker/ai-files/cad/v15/renders/print_insert.png

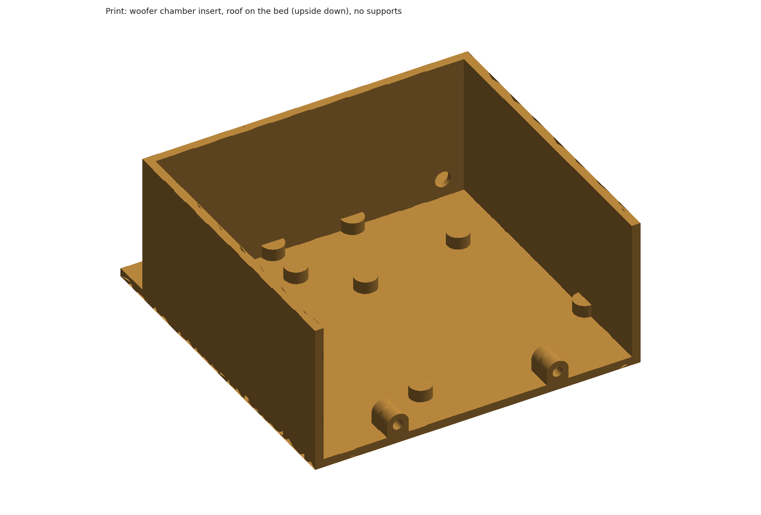
ai-files/cad/v15/renders/print_insert.png
