chithigun23/DesktopSpeaker/ai-files/cad/v15/renders/print_lid.png

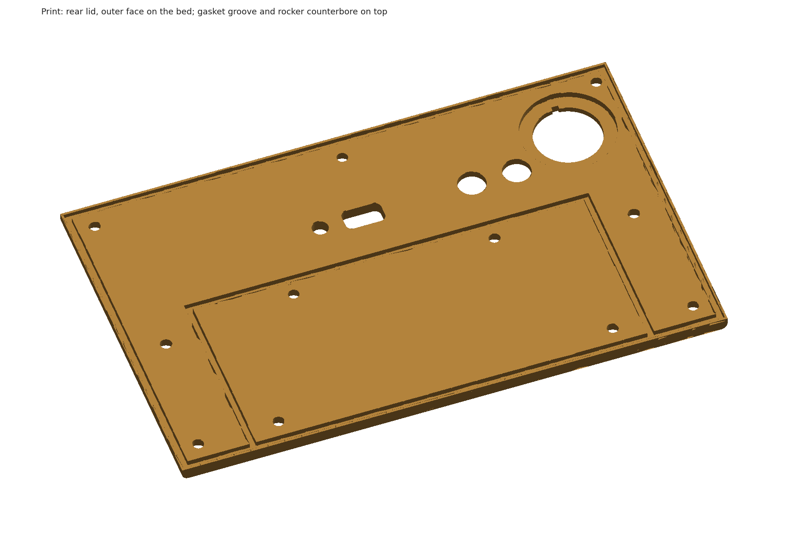
ai-files/cad/v15/renders/print_lid.png
