chithigun23/DesktopSpeaker/ai-files/cad/v15/renders/v15_wiring_drivers.png

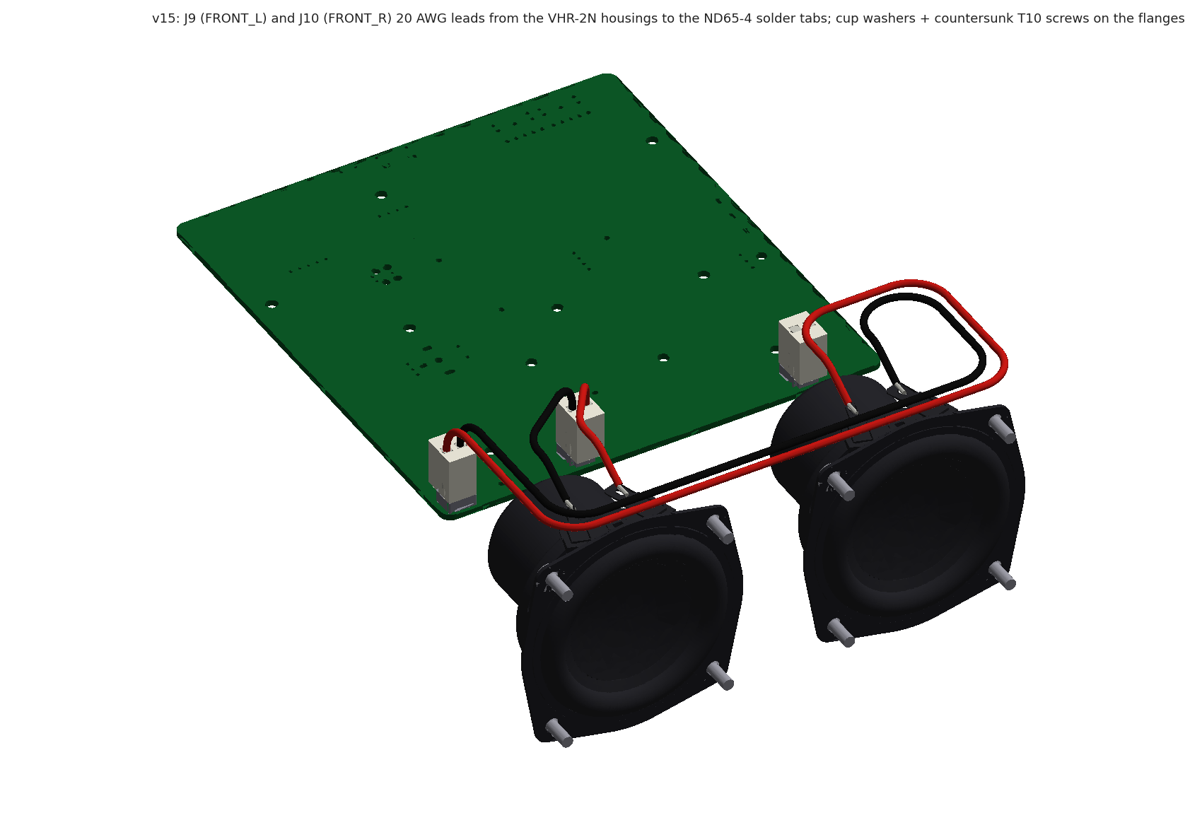
ai-files/cad/v15/renders/v15_wiring_drivers.png
