chithigun23/DesktopSpeaker/ai-files/reports/website-build-evidence/cad2-dark.png

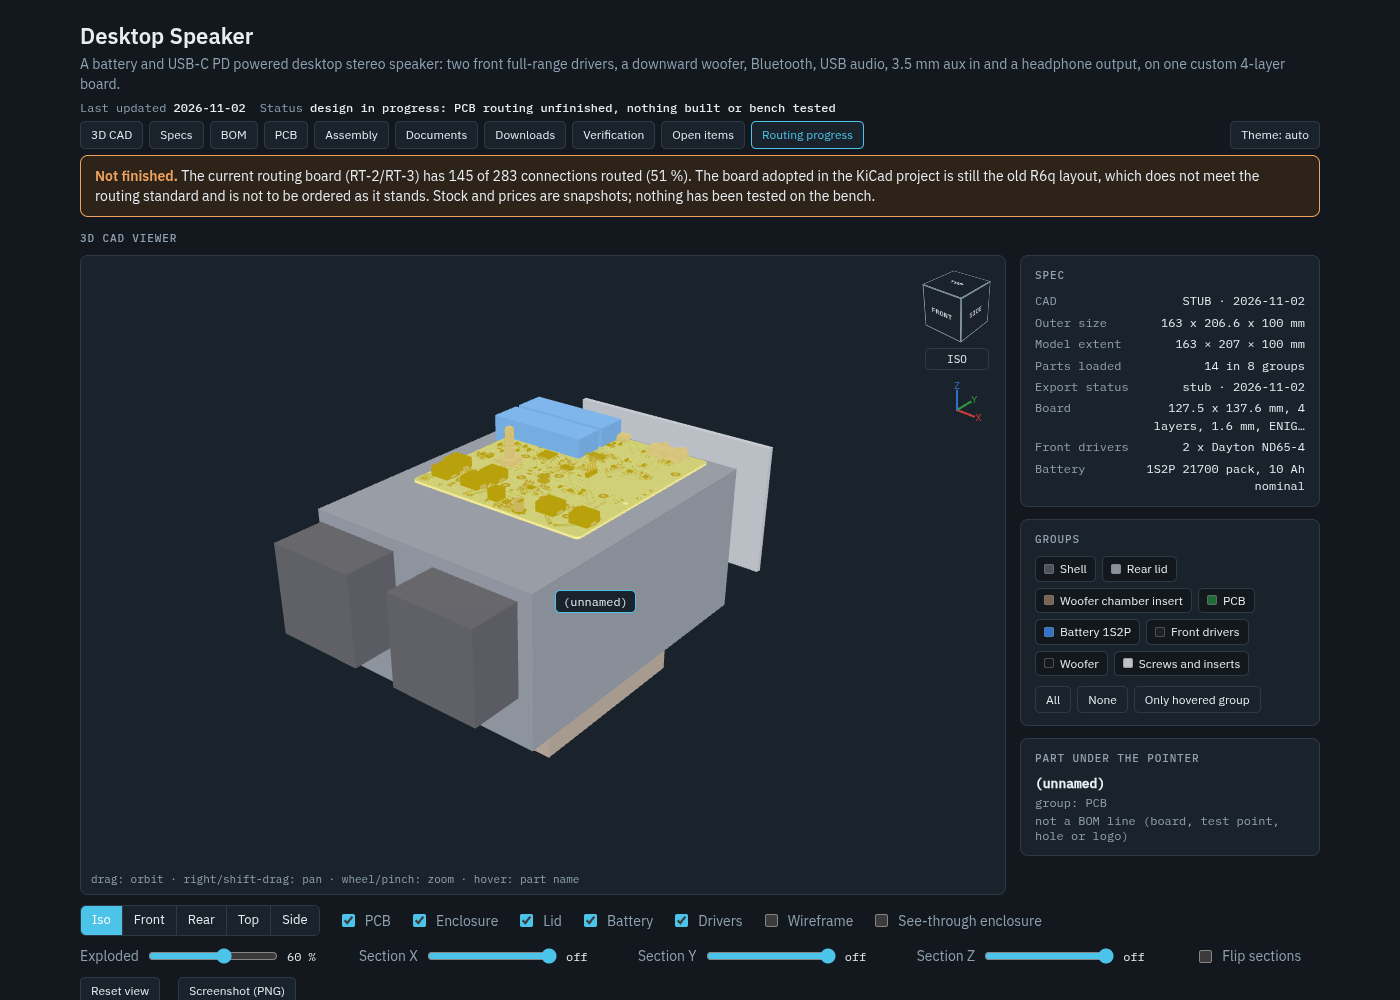
ai-files/reports/website-build-evidence/cad2-dark.png
