chithigun23/DesktopSpeaker/ai-files/reports/website-build-evidence/fin3-stub-view.png

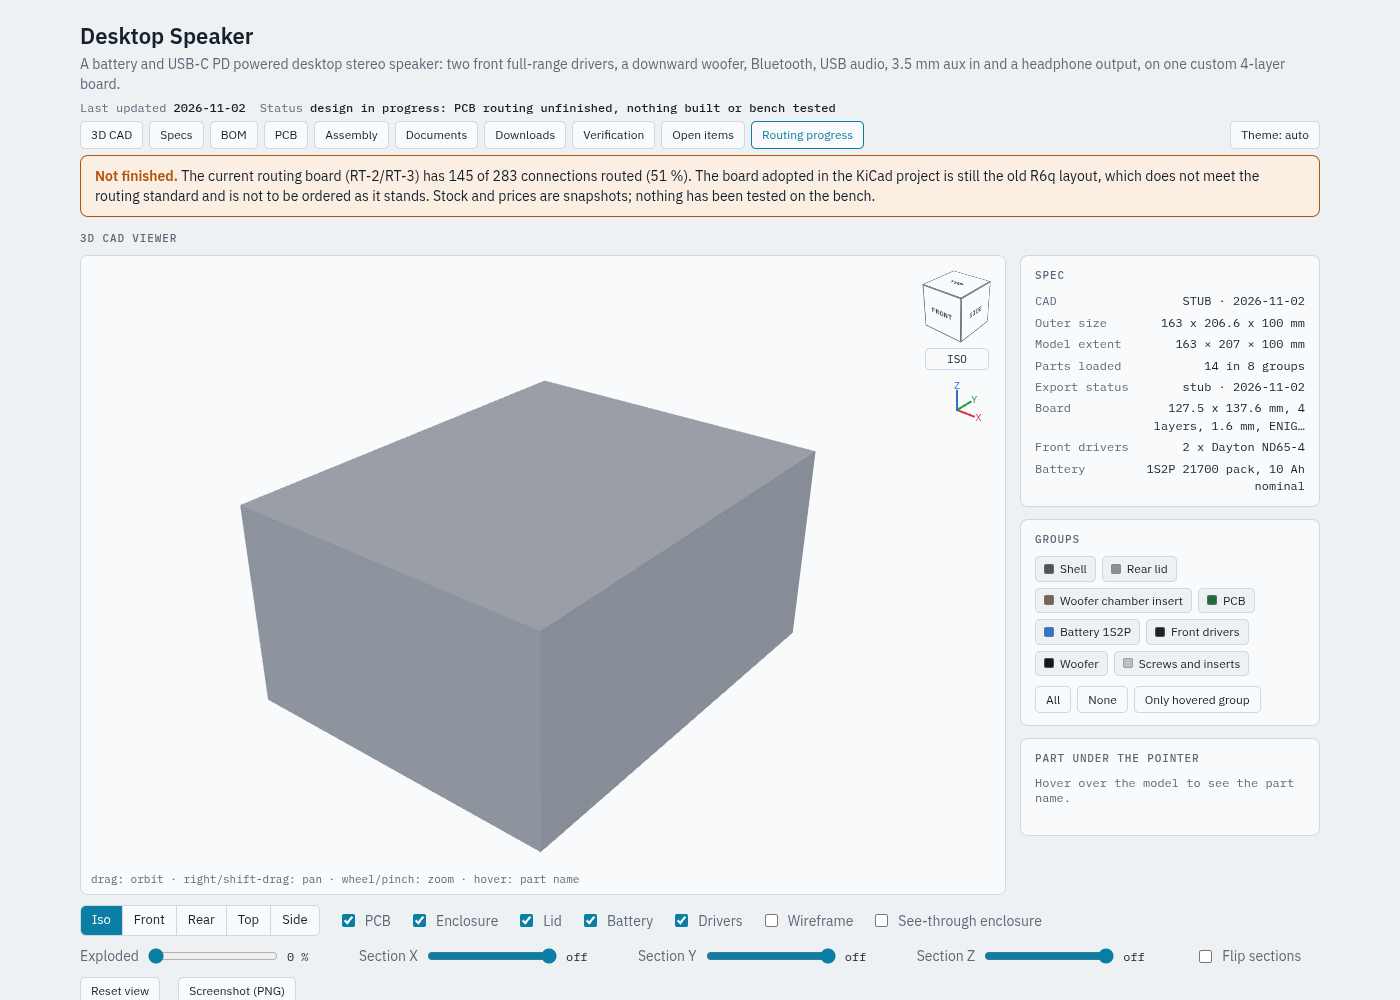
ai-files/reports/website-build-evidence/fin3-stub-view.png
