chithigun23/DesktopSpeaker/ai-files/reports/website-build-evidence/fin-cu-copper.png

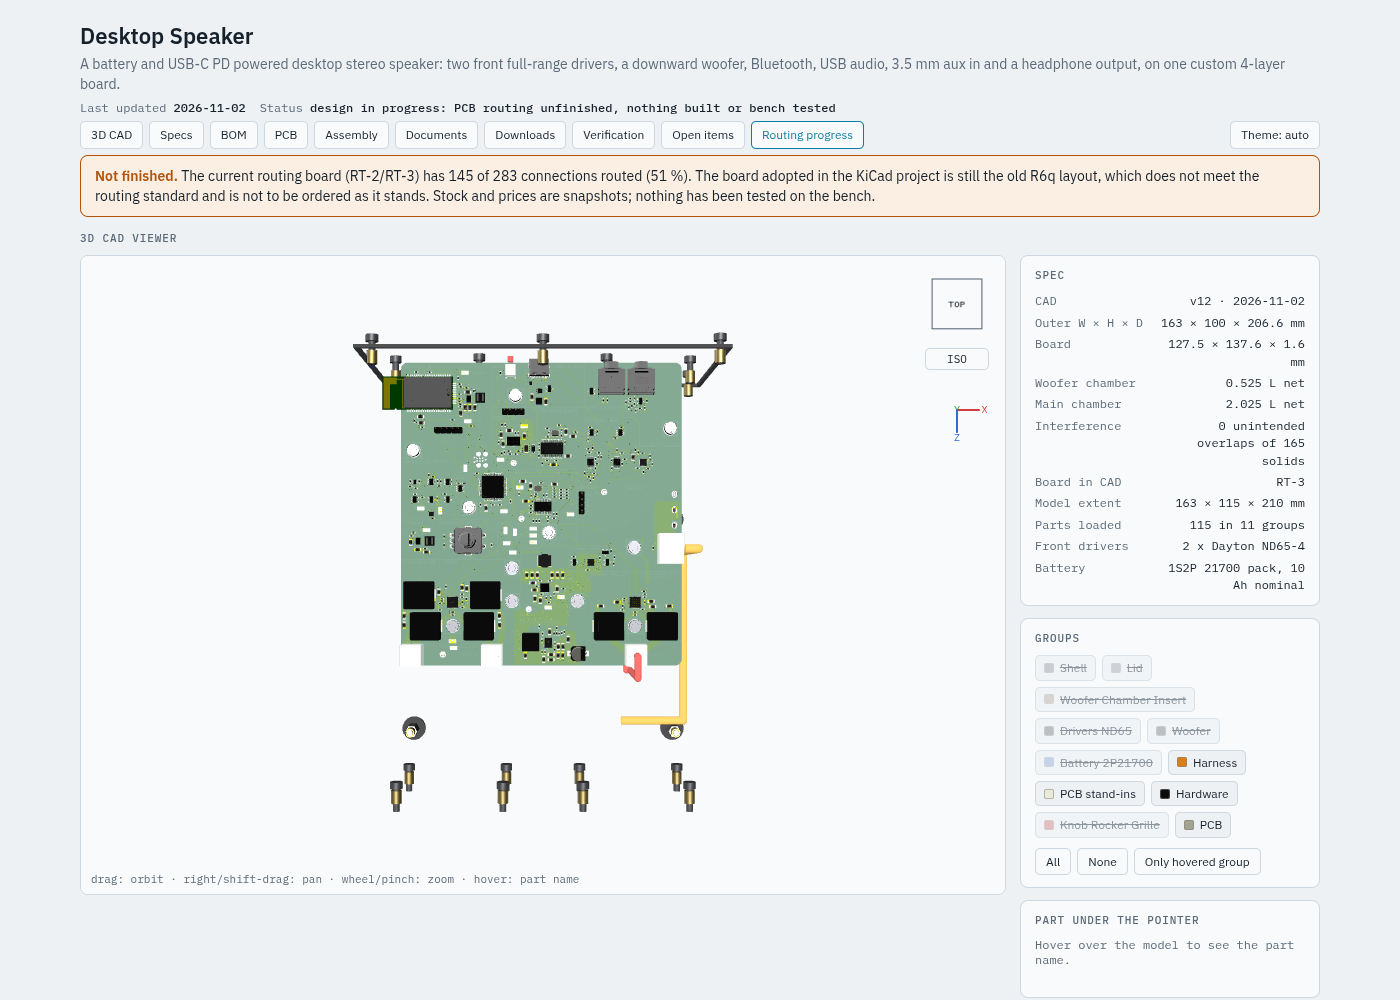
ai-files/reports/website-build-evidence/fin-cu-copper.png
