chithigun23/DesktopSpeaker/ai-files/reports/website-build-evidence/fin-m4-ctl.png

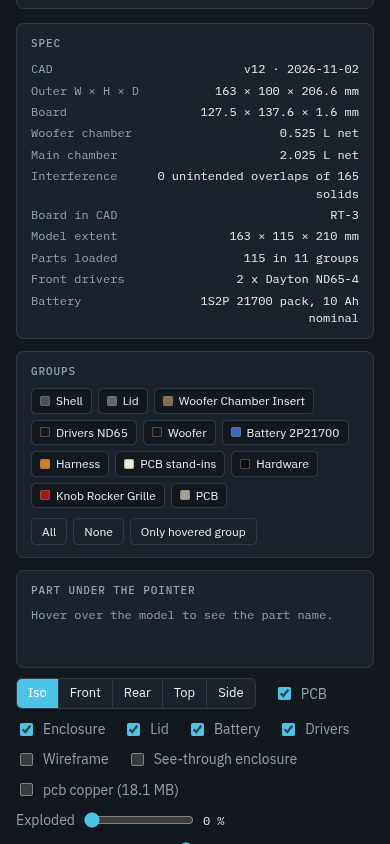
ai-files/reports/website-build-evidence/fin-m4-ctl.png
