chithigun23/DesktopSpeaker/ai-files/reports/website-build-evidence/fin-nocad-view.png

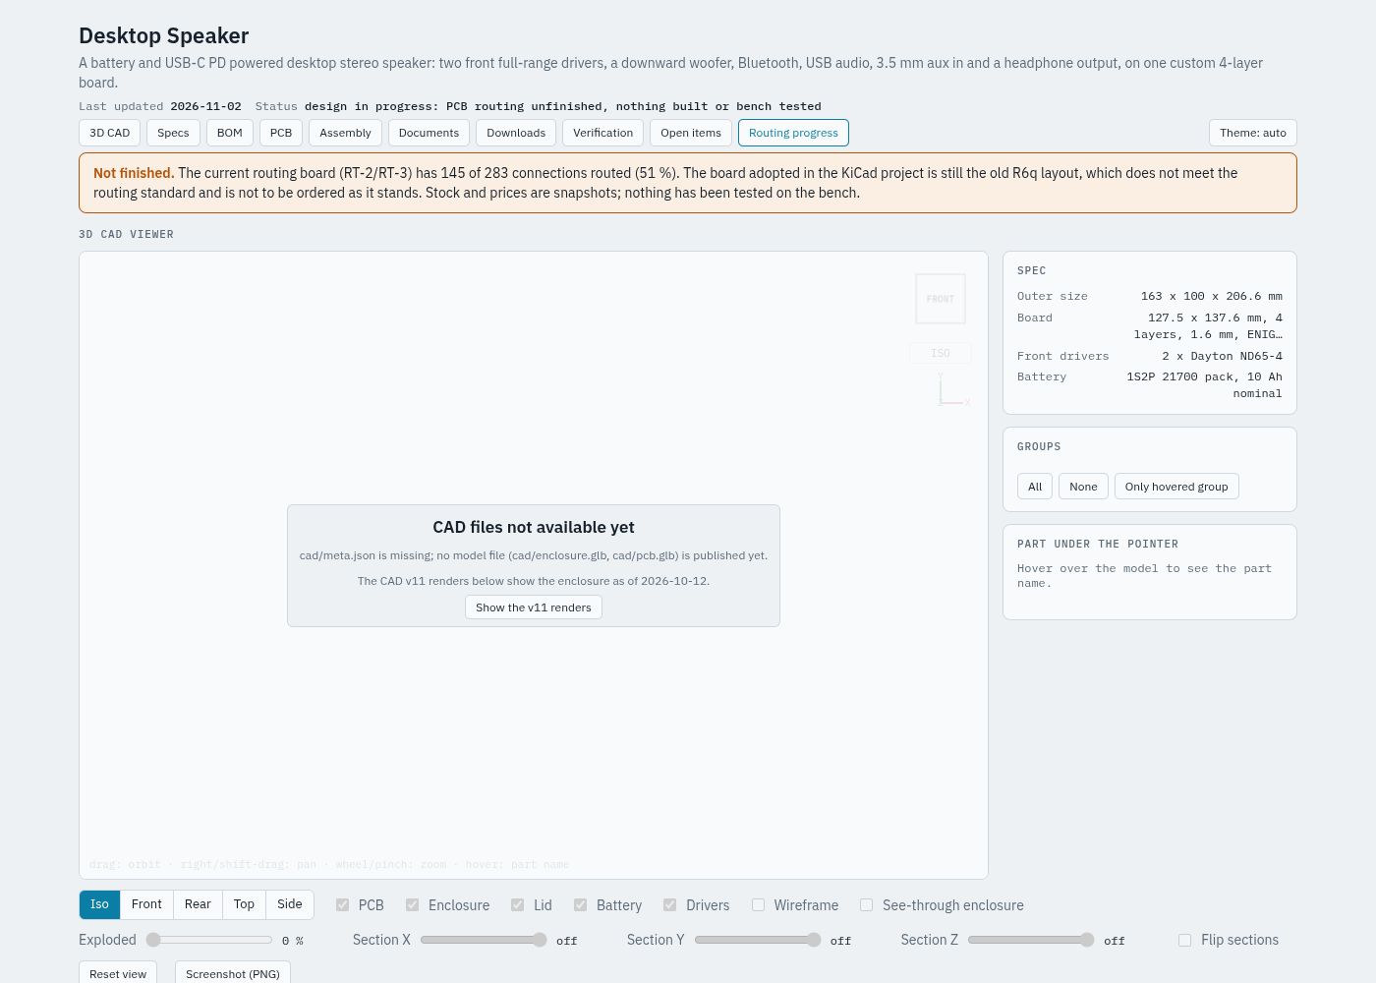
ai-files/reports/website-build-evidence/fin-nocad-view.png
