chithigun23/DesktopSpeaker/ai-files/reports/website-build-evidence/nc-pcb.png

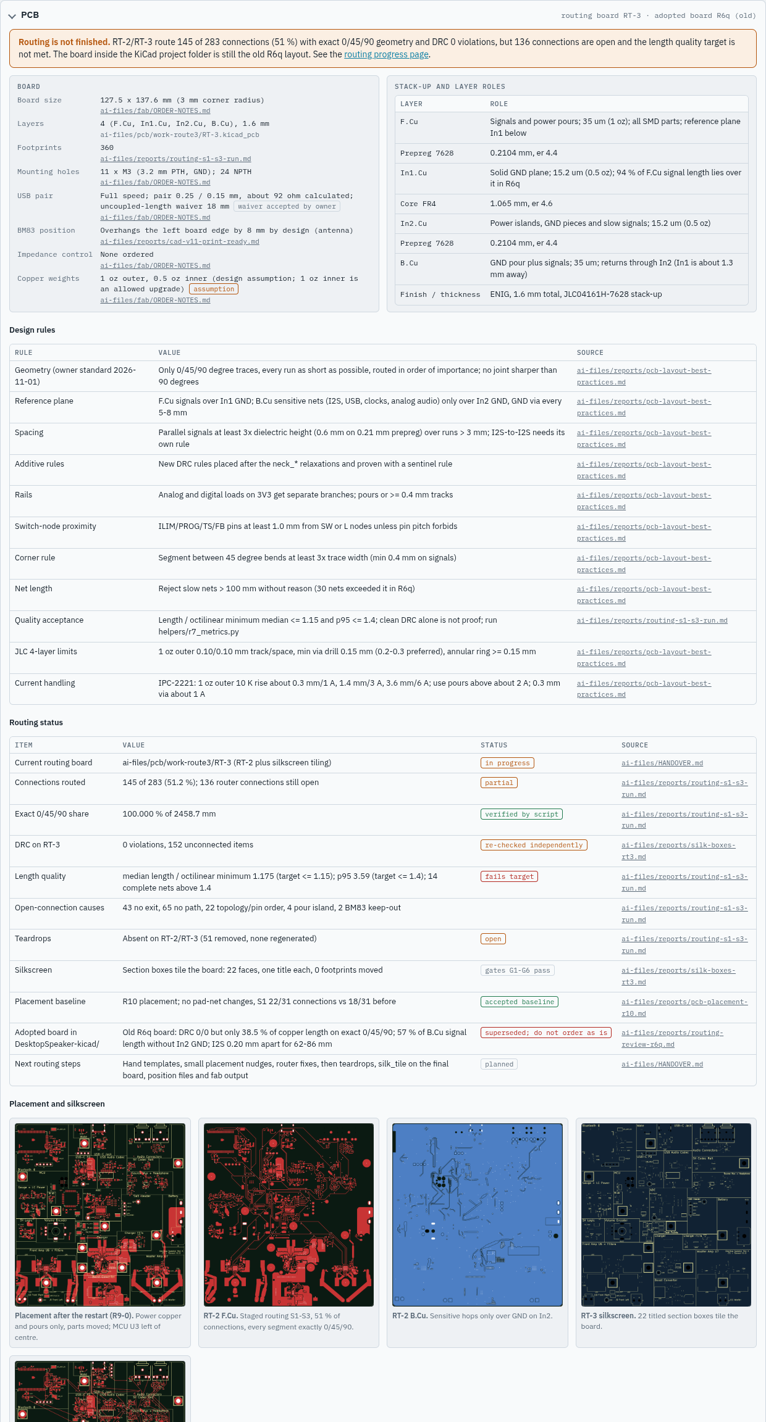
ai-files/reports/website-build-evidence/nc-pcb.png
