chithigun23/DesktopSpeaker/ai-files/reports/website-build-evidence/nc-ver.png

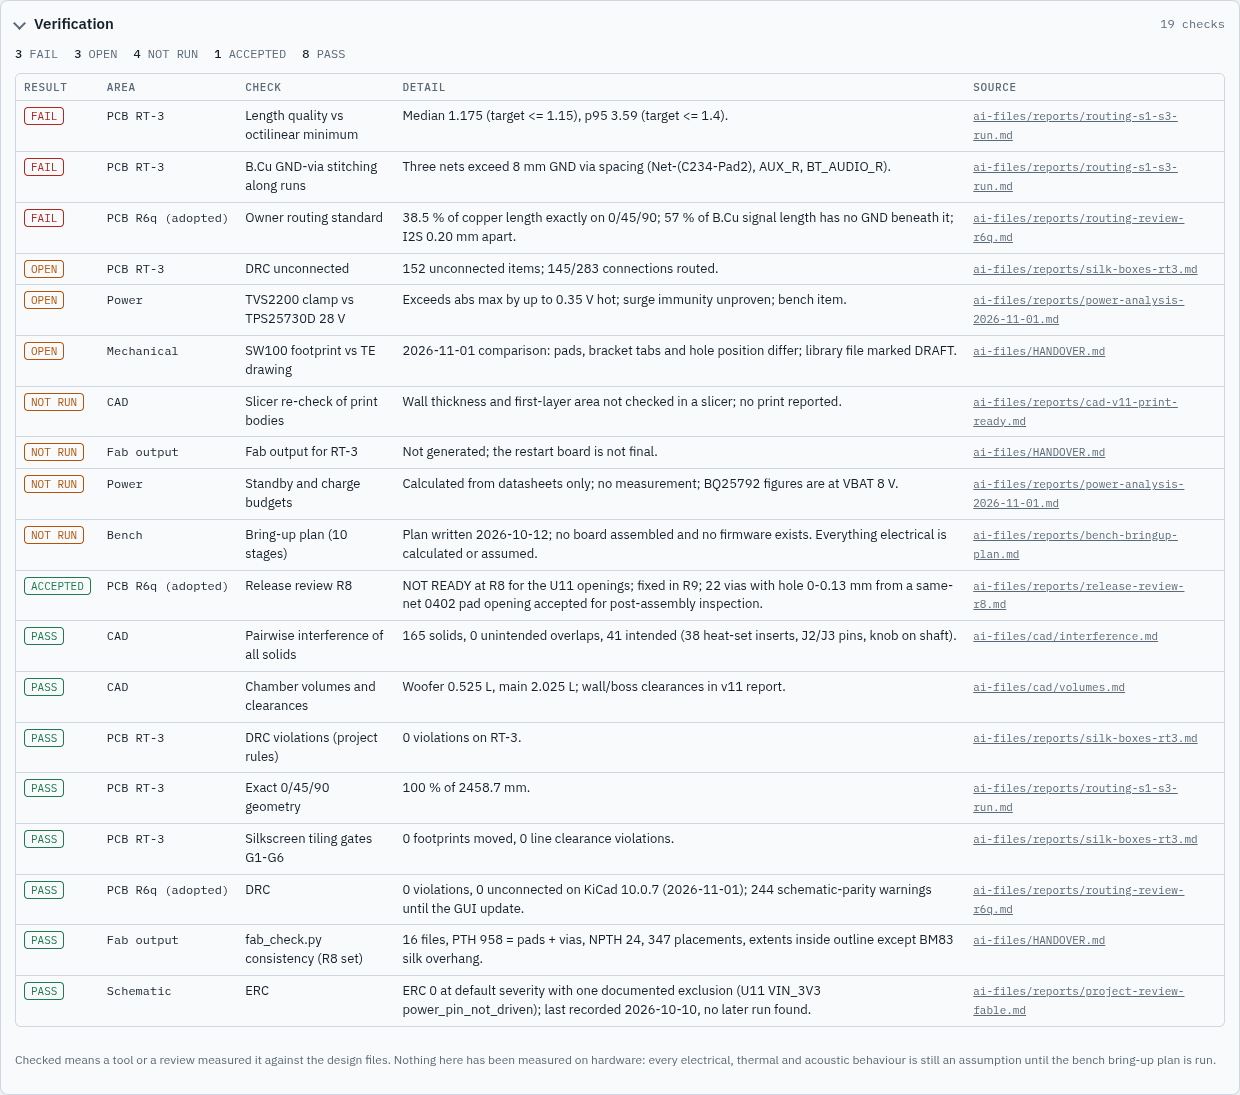
ai-files/reports/website-build-evidence/nc-ver.png
