chithigun23/DesktopSpeaker/ai-files/reports/website-build-evidence/real-explode.png

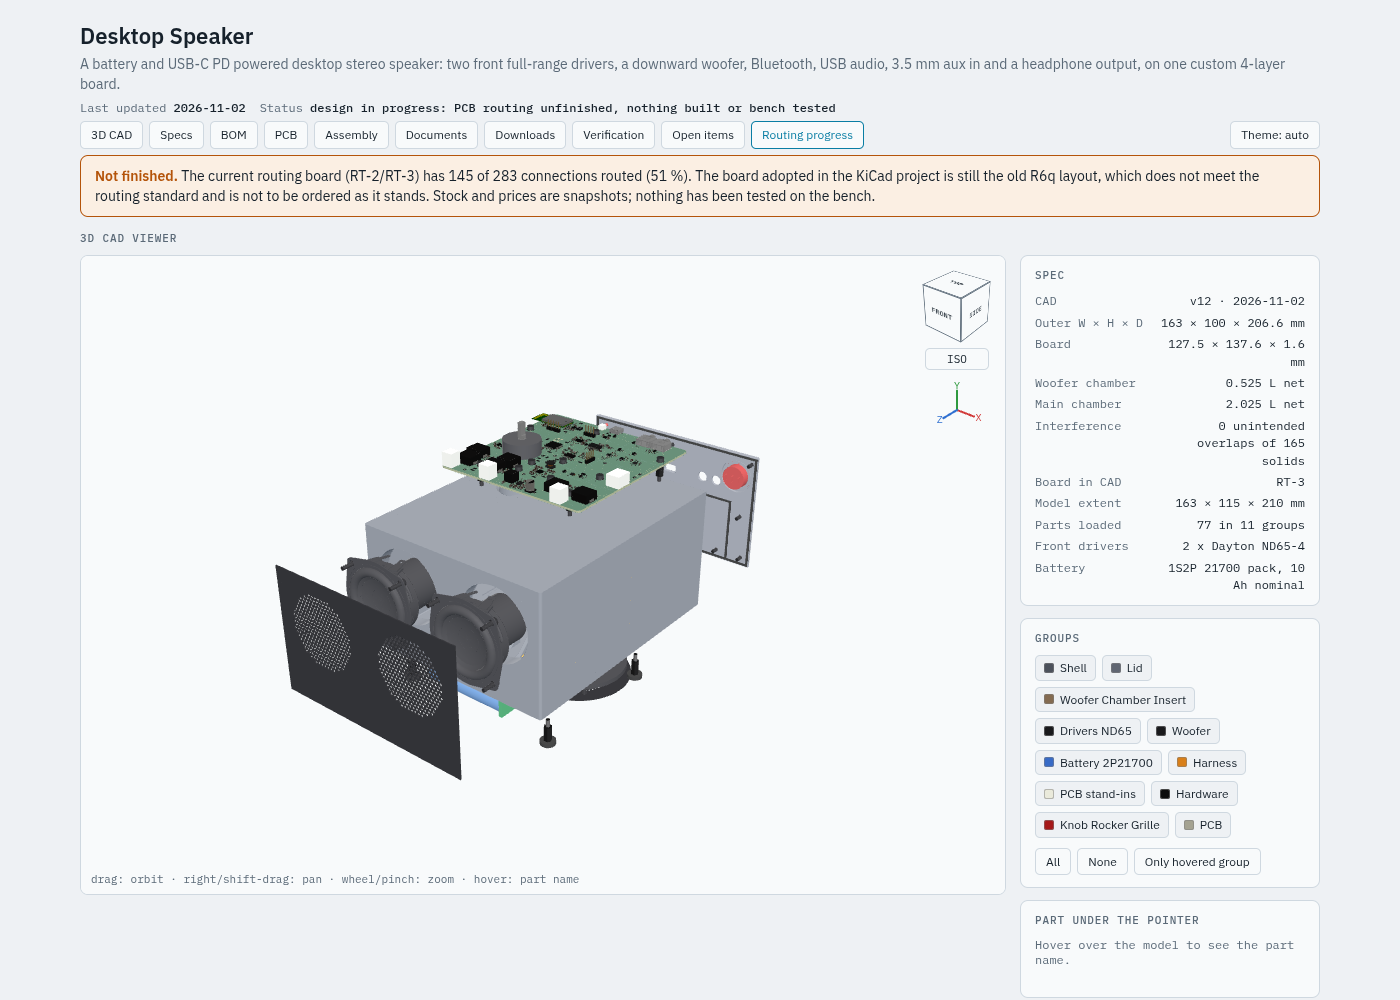
ai-files/reports/website-build-evidence/real-explode.png
