chithigun23/DesktopSpeaker/ai-files/reports/website-build-evidence/real-sectionx0.png

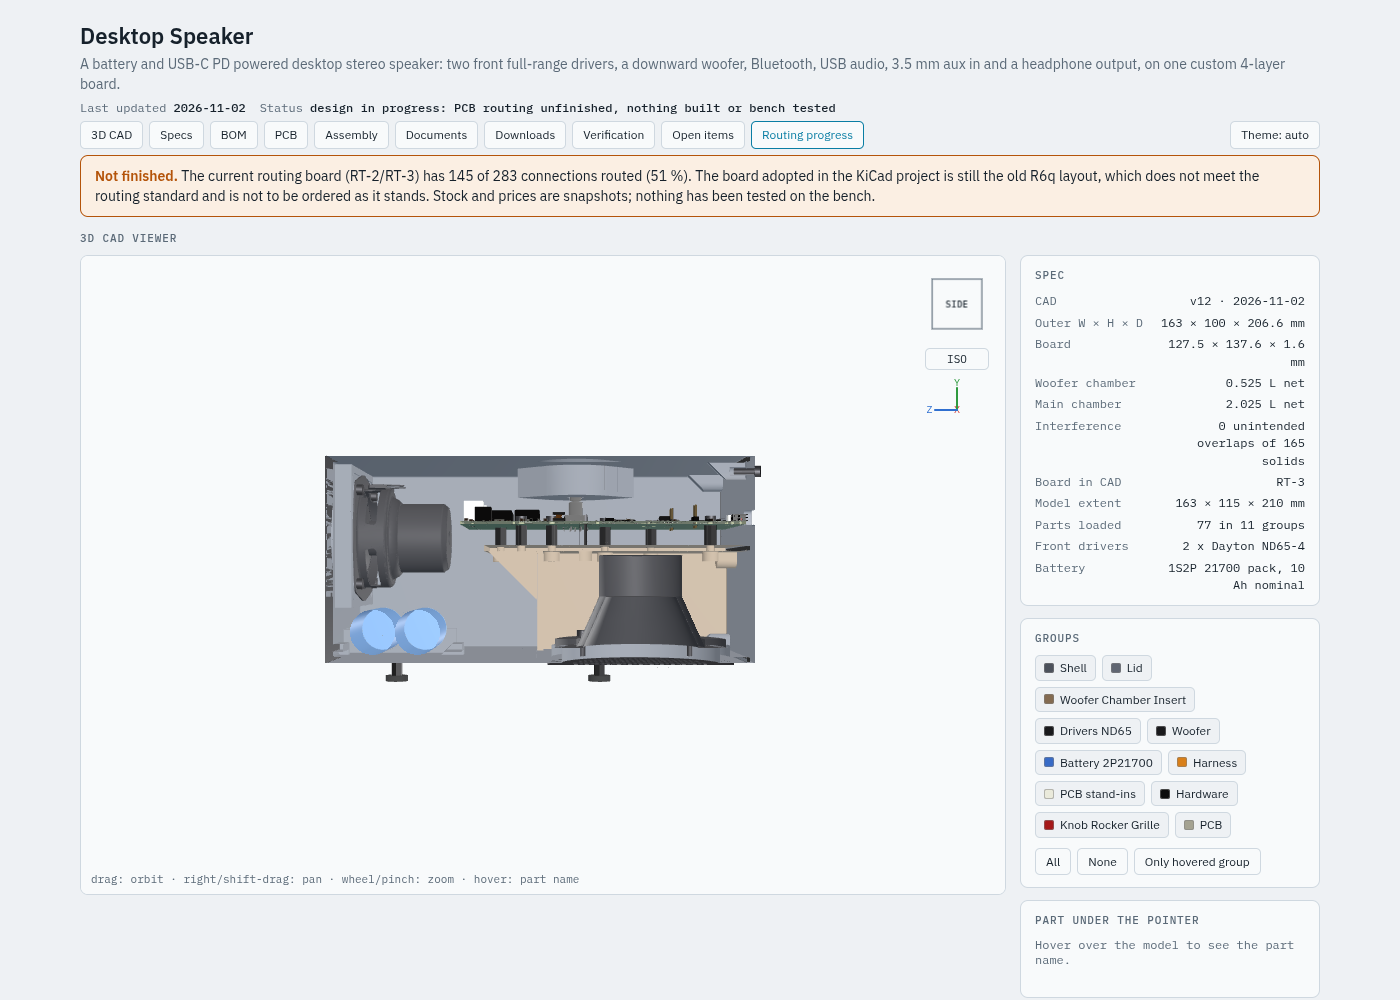
ai-files/reports/website-build-evidence/real-sectionx0.png
