chithigun23/DesktopSpeaker/ai-files/website/desktopSpeaker-site/cad/renders/v15_wiring_open_top.png

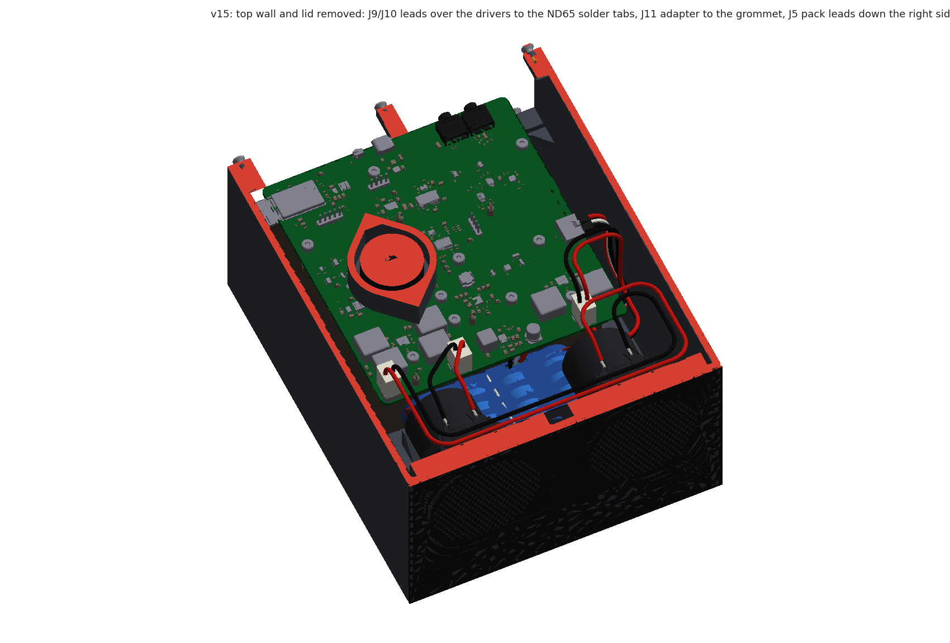
ai-files/website/desktopSpeaker-site/cad/renders/v15_wiring_open_top.png
