chithigun23/DesktopSpeaker/ai-files/website/desktopSpeaker-site/cad/renders/v15_wiring_woofer.png

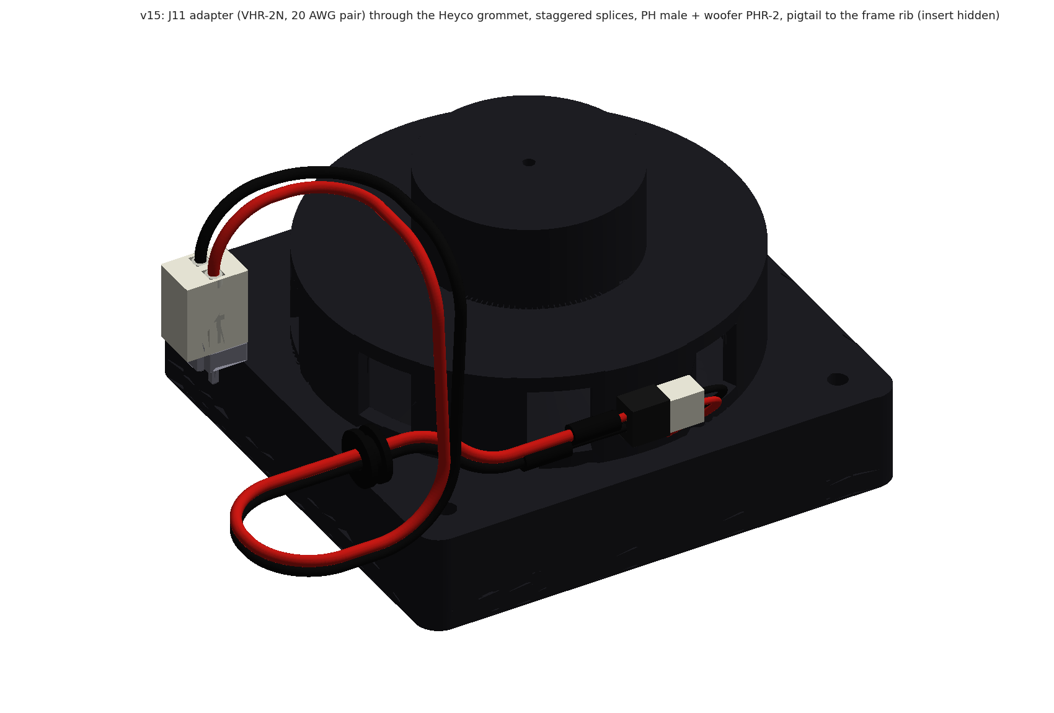
ai-files/website/desktopSpeaker-site/cad/renders/v15_wiring_woofer.png
