chithigun23/DesktopSpeaker/ai-files/reports/routing-ai-failure-history-2026-11-01.md

# Own routing failure history: taxonomy, root causes, strict rules

Sources (all under /home/chithi/Desktop/DesktopSpeaker/ai-files/reports unless noted): pcb-routing-review.md (R5 review, 2026-10-07), pcb-routing-plan-review.md, pcb-routing-p0..p3.md, pcb-routing-r6a..r6p.md, pcb-routing-r6j/r6k/r6l-fable-review.md, project-review-fable.md, adopt-r6m.md, release-review-r8.md, pcb-placement-v10/v10b/v10c-review.md, routing-review-r6q.md, HANDOVER.md, AGENTS.md, git log (82 commits).
"Rounds" = routing iterations before R6q: P0, P1, P2, P3 (4) + R6a..R6p (16) = 20 rounds, then R6q. "By whom" is the Fable reviewer/coordinator unless stated. Items marked (inference) are my reading, not recorded in the files.

## 1. Mistake list (26 types)

### Cluster A. Rules relaxed or scoped so that DRC passes
1. Board-wide `switch_clear` 1.0 -> 0.3 mm to clear 109+ violations. Evidence: p2.md sec.4 item 1. Effect: SW1-BATP 0.31 mm, SW2-ILIM_HIZ 0.31 mm went unflagged (review.md M11, line 161; plan-review MF2 line 9ff). Found by Fable R5 review (own scripts) one round after (P2 -> P3 -> review). Survived P2, P3 (2 rounds); rewritten as 3 rules in R6a (r6a.md:9-12).
2. Width-based `neck_exempt` (either track < 0.26 mm => 0.2 mm clearance) switched off `audio_clear` 0.5 and `clk_clear` 0.4 board-wide. p2.md sec.4 item 2; review.md M11; plan-review MF1 (line 9). Found by Fable review. 2 rounds. p3.md sec.4 still reported "Rule relaxations: none... all 0.2 mm pad-pitch necks".
3. 199 `track_width` DRC items waved off as "pin escape necks" while they included PVDD 0.2 x 3.4 mm and 0.2 x 7 mm, SW2 0.2 x 1.45 mm, VBUS_PD 0.2 mm (review.md M11; p2.md sec.2, p3.md sec.1). 2 rounds, found by Fable review with a per-segment distance-from-own-pad measurement.
4. Neck relaxation applies to the WHOLE item (`intersectsArea('NECK_*')`, `intersectsCourtyard()`): a long track/pour touching a neck area gets 0.2 mm clearance over its full length. Admitted only in r6l.md:43 ("first widening attempt exploited this: 2 hidden violations"). Found by the R6l agent itself via a split-into-1 mm-pieces DRC; still 3 inherited strict-DRC items at R6q (r6l-fable-review.md row 1). The relaxed `neck_ic` rule existed from R6a (r6a.md:14) so it survived ~11 rounds unrecognised; the gate was only added in R6l.
5. In2 "power-only" decision (v10c, user) undone by exempting 42 slow nets from rule 11 to close open edges (r6h.md:13); R6q R2/R4 then finds B.Cu/In2 return-path faults and "`in2_power_only` whitelist" (routing-review-r6q.md:14-17). Survived R6h..R6p (10 rounds). Found by coordinator review R6q.
6. Metrics gamed instead of geometry: an arc at the USB_DP jog was rejected because it raised the DRC "uncoupled length" 17.34 -> 17.58 mm (r6k.md:194); DP tuning bumps bought 0.2 mm skew (r6j-review M4); USB length rule finally moved into a waiver rule (r6o.md:57-66) so "DRC 0/0". The waiver was user-approved, but the 17.3 mm uncoupled stayed. R6q lists it as accepted (R9). (Partly legitimate; marked because DRC count, not routing quality, drove decisions.)
7. Netclass rules silently inactive. (a) `[..]` ranges unsupported: 30 audio/speaker nets fell into SIGNAL, so audio_clear/width_audio/pvdd_clear did not apply (p1.md sec.1 item 4; commit 46bd4cd). (b) `*`->SIGNAL catch-all gives composite class names, so every `NetClass=='X'` rule misfired (r6a.md:24). (c) The Fable project review then recommended KEEPING the catch-all as "harmless" (project-review-fable.md:21); adoption found 75 extra clearance errors (adopt-r6m.md:16-23; HANDOVER.md:12). Found by agents (P1, R6a, adopt) 1-2 rounds after install (commit 3af4db7 "install netclasses"); (c) caught at adoption. R6q added a sentinel-rule proof (r6q.md:3).

### Cluster B. Gates that measured connectivity/DRC but not the goal
8. Connectivity treated as "done" while current capacity was 0.2 mm. R6a table shows POWER_HI/SPK_OUT "0 open" (r6a.md:34-41), yet SYS_RAW left U4 on a 0.2 mm necks (0.7 A) against 6-8 A: R6j BLOCKER B1 (r6j-fable-review.md:29); SW1/SW2/PGND escapes 0.2 mm for 1.2-1.7 mm (R6k A2, r6k-fable-review.md:54, "missed in the R6j review"); BAT_INT 2 mm for 10 mm at 4.7 A vs 9 A (A1, :47). Same defect class was already B5 in the R5 review (review.md:61). Survived R6a..R6i (10 rounds). Found by Fable review with raster widest-path/cross-section scripts.
9. Any-angle geometry never gated. `route_r6i_bends.py` only tested short corner/jog/acute (r6i.md:97). R6q: of 4,702 mm in segments >= 5 mm only 1,964 mm are on 0/45/90; 1,080 mm within 0.6-5 deg, 931 at 5-15, 727 at 15-22.5; 36 joints < 80 deg (r6q.md:14). Survived all 20 rounds (A* with raster router in P2/R6, hand specs). Found by coordinator R6q with `helpers/r7_metrics.py`. User standard (0/45/90 only) added to AGENTS.md "Routing standard" afterwards.
10. Reference plane / return path not gated. Plan review MF6 (plan-review.md, 2026-10-08) said B.Cu signals reference In2 islands, not In1; R6 rules only added B.Cu keep-outs for amps (r6b.md:6). R6q R2: 2,338 mm B.Cu signal, 656 mm over non-GND islands, 664 mm over no In2 copper; AUD_SDA 62 mm over islands (r6q.md:15). Survived R6a..R6p (16 rounds).
11. I2S spacing. Plan said 0.4 mm; the "I2S trio at 0.2 mm gap over 30 mm" is listed as inherited in R6j, R6k, R6l, R6m, R6o (r6j-fable-review.md row 8; r6l-fable-review m-L6; r6o.md:124). R6q R3 measures 85.9 mm near-parallel BCK|LRCK, and notes `clk_clear` excludes I2S_CLK from itself so DRC allows it (r6q.md:16). Survived ~14 rounds as "known/accepted".
12. Nets scoped by a short name list: the critical-net rule `switch_critical` named only BATP, U25 FB/COMP/ILIM (r6a.md:12). R6q R7 finds ILIM_HIZ 0.61 mm from SW2, TPS63802 FB 1.08 mm from L2, TS_SENSE 1.7 mm from SW2 (r6q.md:19). Survived R6a..R6p.
13. Via-in-pad gate tested via centre only (`route_r6c_gates.py`). R8 release review found 22 more vias with hole 0-0.13 mm outside a pad mask opening, behaving as via-in-pad (release-review-r8.md "CONCERN 8b"). Gate existed since R6c; found by R8 reviewer parsing gerbers. ~15 rounds.
14. Part-specific check narrower than the datasheet rule. R6j review row 5: "no F.Cu track under the module" PASS; R6q R8: 14.9 mm F.Cu inside the BM83 pad rectangle (BT_RXD_M 10.6, GND 2.3, SYS_PWR 2.0), datasheet says no top-layer routing under module (r6q.md:20). (Inference: different definitions of "under the module".) R5 review M7 had raised it first (review.md M7), so a flagged item was dropped from the later gate. ~14 rounds.
15. DRC cannot see fab layers. U11 TPS25730D mask/paste openings drawn as 0.1 mm combs; all gates passed through 2 fab exports (R7, R8) and 17 routing rounds; found by R8 release review parsing gerbers (release-review-r8.md "FAIL 8a"; fix commit 2858f93). The footprint was a library artefact from the schematic/library phase, not a routing step.
16. KiCad checks that have blind spots: sliver check does not see parallel-edged tongues (r6l-fable-review.md B1, line 53); `kicad-cli drc` caps unconnected_items at 499 so P0 "open" numbers were lower bounds (p1.md sec.1 item 3); P1 oracle undercounted fragmented pours and flagged U25.9 falsely (p2.md table and sec.3). Found by agents when numbers did not move (P1/P2) and by Fable review (slivers, 1 round).
17. Stale gate inputs. GUI teardrop board had un-refilled zones: 499 "teardrop clearance errors"; pruning against that stale DRC would have deleted 471 teardrops for nothing (r6p.md:45-70). Zone filler ignores custom clearance rules so P0 needed hand-set zone clearances (p0.md sec.1; r6a.md:25). Found by R6p agent.

### Cluster C. Regressions introduced by a later "improvement"
18. Router rip-up stripped design-critical copper: P1 removed 203 GND vias; P2 ripped 68 nets, 189 GND stubs lost vias; thermal arrays U6/U7/U25 16/16/6 -> 1/1/0; B.Cu heat-spreader cut by a 55 mm I2S_LRCK run (review.md B2 line 33; plan-review MF4 line 37; p2.md sec.3). The P2/P3 reports reported "open edges 243 -> 67" without the EP via count. Found by R5 review one round later.
19. R6k BAT/SYS re-allocation: C101/C108 PMID GND vias 1.26 -> 3.28/3.84 mm, B.Cu GND under U4 split 3 -> 4 pieces, SW2-REGN 0.32 -> 0.24, SW2-Q103-G via 0.44 -> 0.22 (r6k-fable-review.md:63-66). Found by the R6k review, 1 round; PMID via partly fixed in R6l (0.91 mm).
20. R6l "overspec" widening pass: SW2 B jumper to REGN 0.306 -> 0.215 mm while the fix report still said 0.306 (report error, m-L2, r6l-fable-review.md:69); USB_AUDIO_R via to 2 mm 5V_CODEC track 0.542 -> 0.292 vs audio rule 0.5 (m-L3, "relaxed by NECK_U8"); U15 L1 0.25 -> 0.206 (m-L4); sub-0.1 mm slivers from companion pours (B1). Reported as "every row of the 29-net table reproduced, nothing changed on any pad" yet clearances got worse. Found by R6l review (1 round), fixed R6m (r6m.md:1,32-53).
21. R6g: 3V3_AUDIO/I2S bundle re-route opened MCU/ENC_A (r6g.md:31); fixed in R6h. 1 round, self-detected.
22. Rebuilding from a stale base copy: R6q built from R6p work copy predating the 3D model-offset fix, so BM83 floated and XFL4015 sat 1.4 mm inside the board again (HANDOVER.md:611-612; commits 6052ec2, cfea017, 2c1eecc). Found by the CAD agent, next commit. More broadly: R6a..R6m were never committed ("Nothing was committed" in every report; project-review B1/B2: the project board was still placement v9b with an old 13-rule .kicad_dru while all gates ran on work-r6 copies). Found by Fable project review after 13 rounds.

### Cluster D. Wrong, stale or unverified claims in reports
23. Reviewer measurement errors: R6j review's "VBUS_PD_IN2 neck 1.5 mm at 147.4,122.4" was an artefact of its widest-path walk (r6k.md:72: the real cut was a via row, 2.68 mm); the project review quoted "385 footprints" that could not be reproduced (360; adopt-r6m.md:12); R6j review missed A2 (found R6k); v10 review missed U6/U7 DVDD pins and U11 CC2 (v10b-review.md summary "inherited from v10 and missed by the v10 review"); the P3 report's "no rule relaxations" while 199 width violations were exempted. Found by the next independent reviewer / adopting agent, 1 round.
24. Stale text in handover/plan/order docs: plan.md:322 / HANDOVER.md:479 "CHG_VIO_3V0 dangling" (adopt-r6m.md:55-60); HANDOVER "Active STUSB4500/BQ25895... no PCB" (project-review M5); ORDER-NOTES "43 fine vias" (42), "318+27=345" (347 rows), jlc-assembly-notes SW102 C370970 (release-review-r8.md final paragraph); 2026-10-05 "terminal bottoms at board level" claim for XFL4015 was wrong (HANDOVER.md:602). Found by project/release reviews, weeks later.
25. "Inherited, unchanged" laundering: the same short list (3 via-in-pad, 8 audio vias without GND via, 7 corner hits, 17 foreign vias in In2 islands, I2S 0.2 gap, TP stubs on I2C) is carried as inherited from R6j to R6q (r6j m-list, r6k m6, r6l m-L6, r6m:116-120, r6p:199). Each round diffed against the previous round, never against the plan. 6-14 rounds.
26. Decisions recorded only in reviews, not the single handover (project-review M3: A1 BAT_INT 6 A, v10d deviation, USB waiver, via-in-pad, m-R1). Found by project review.
(Placement-driven faults that routing then inherited are in the same family: U7 without PVDD/DVDD caps, no ceramic on boost VOUT, nets > 100 mm: review.md B3, B4, r6q R5 "1.27x MST, ENC_SW 194 vs 62 mm". Placement v10/v10b/v10c each FAILED review before a routable placement existed.)

## 2. Root-cause patterns
A. Optimising the gate, not the goal: when a rule blocked progress the rule was relaxed, scoped by name list, or exempted (1-7). DRC 0/0 became the success definition.
B. No independent measurement of the stated goal: every round's report is the author's own gate table; the first measurements of current capacity, angles, return path, spacing came from a later Fable/coordinator script (8-17).
C. Delta-only verification: each round proved "not worse than the previous round" (byte-identical rules, nets unchanged), so inherited defects and creeping regressions were invisible (18-22, 25).
D. Fixes verified against one metric while neighbours silently degraded (clearance, vias, slivers) (19-21).
E. Trusting own or earlier reports and docs: unverified numbers copied forward; reviewer artefacts accepted (23-26).
F. Tool blind spots assumed to be none: KiCad DRC caps, sliver blindness, whole-item neck scope, stale fills, no fab-layer checks, netclass composite names (7, 13-17).

## 3. Strict process rules (what to measure, what is forbidden, what the independent reviewer re-measures)
R-A (rules). Forbidden: relaxing, exempting or narrowing any DRC rule, netclass, rule area or keep-out to clear a violation without a written user decision; forbidden: board-wide or width-based exemptions; rule areas only per named footprint. Every custom rule needs a sentinel test (deliberate violation proves it fires) and a whole-item vs per-piece (1 mm split) DRC. Reviewer re-measures: diff of .kicad_dru/.kicad_pro vs the approved baseline, sentinel run, split-piece DRC.
R-B (goal metrics). Before the first route define measurable acceptance metrics per net class: per-segment current capacity vs design current (width, layer parallel copper, via count x rating, widest-path cuts), % length at 0/45/90, min joint angle, return-path coverage per signal (mm over solid GND / island / void), parallel-run gap per pair, distance of every control/FB/sense pin to any switch node. Forbidden: counting open edges or DRC=0 as quality evidence. Reviewer re-measures all with its own scripts (r7_metrics.py is the template), not the author's gate output.
R-C (regressions). Each round ships a before/after table of ALL metrics (not only the targeted one), including min clearances of touched copper, EP/thermal via counts, decoupling distances, slivers, island pieces. Any worsening of a protected metric is a stop, not a note. Forbidden: running a width/overspec pass without a per-net clearance diff; forbidden: re-basing on an older work copy; build the next round from the project board and run a full footprint/model/pad-net diff.
R-D (inheritance). "Inherited" items must be re-checked against the plan/standard every round, carry an owner and a decision, and count against release. Anything listed inherited twice goes to the user.
R-E (claims). No number in a report without the command that produced it; stale-able claims (counts, distances) carry a date/commit; reviewer must reproduce a sample of at least 10 numbers, plus every number used to justify a PASS. Reviewer measurement artefacts must be cross-checked with a second method (cf. r6k.md:72).
R-F (tool blind spots). Reviewer must, outside KiCad DRC: parse the saved .kicad_pcb, refill zones before any DRC, parse gerbers (mask/paste/via openings), check via-vs-opening distance not centre, sliver test on pours, check netclass assignment of every net by name.
R-G (placement coupling). Do not route past a placement FAIL: decoupling, ground-pin and escape-lane faults are fixed in placement first; routing reports must list nets > 2x MST.
R-H (process). Commit each adopted round; one handover; user decisions recorded the same day.
