chithigun23/DesktopSpeaker/ai-files/reports/candidate-fixes-handoff.md

# Candidate fixes handoff (2026-10-05)

Files changed: candidates/TPS25730D_USB_PD_candidate.kicad_sch, candidates/Battery_Charger.kicad_sch, candidates/TPS25730D.kicad_sym (pin 36 split from RESERVED stack, now its own bottom pin), candidates/PD_C_0402.kicad_mod (new, no 3D model), helpers/build_tps25730d_candidate.py, helpers/build_bq25792_candidate.py (both regenerate the sheets), helpers/add_candidate_fix_bom.mjs, bom/ (new sheet "Candidate fixes" in the XLSX + candidate_fixes_BOM.csv; Selected BOM rows and main CSV untouched). PDFs refreshed. DesktopSpeaker-kicad/ not touched.

TPS25730D: R14/R15 10k SDA/SCL to LDO_3V3; R16 (PLUG_EVENT) / R17 (SINK_EN) 100k to LDO_3V3; ports PD_CAP_MIS/PLUG_FLIP/DBG_ACC deleted (pins have no-connect); D7 1N5819HW-7-F (C82544, 40 V 1 A SOD-123, PD_DIODE + PD_D_SOD123) cathode USB_VBUS, anode GND next to C2; C2 4.7uF/50V CL32B475KBUYNNE C170099 1210; C6 22uF GRM21BZ71A226ME15L C907991; pin 36 to GND via R18 10k; J4.1 now LDO_3V3 (reference only). ADCIN2 code 7 and TVS2200 unchanged.
BQ25792: C115 0.1uF 0402 on SYS (next to U4.25 rail); C113/C114/C115 = Murata GRM155R71H104KE14D C77020, footprint DesktopSpeaker:PD_C_0402; R103 100k (C14675); D+/D- ports removed, pins 6/7 no-connect, note says AUTO_INDET_EN=0, HVDCP_EN=0.

Verification: netlist diff (physical pin groups) shows only the intended nets changed (TPS: GND, USB_VBUS, LDO_3V3, PDCTRL_SDA/SCL, PD_PLUG_EVENT, PD_SINK_EN, new net R18-U11.36, /3V_AO J4.1 moved; BQ: GND and SYS_RAW gain C115). ERC totals TPS 74 -> 79, BQ 113 -> 112: pin_not_connected errors fall (12->9, 11->9), isolated_pin_label falls; increases are only footprint_link_issues (+6 TPS, +1 BQ) and lib_symbol_issues (+8, +2) from new parts and the candidate folder lacking the DesktopSpeaker library tables, same class as the inherited findings.

Open items for integration: copy PD_C_0402.kicad_mod into kicad-library/footprint (no 0402 3D model exists); root sheet needs ports/PWR_FLAGs per review section C (SDA/SCL, PLUG_EVENT, SINK_EN no-connect); BOM candidate rows are not in Selected BOM subtotals; main BOM row "R103, R106" still says 10k until integration; D7 reference collides with the old BZT52C12 D7 in the active BOM until old USB_PD sheet is replaced; 1N5819HW leakage (<=1 mA at 40 V) not bench-checked.
