chithigun23/DesktopSpeaker/ai-files/reports/pd-ovp-preview.pdf

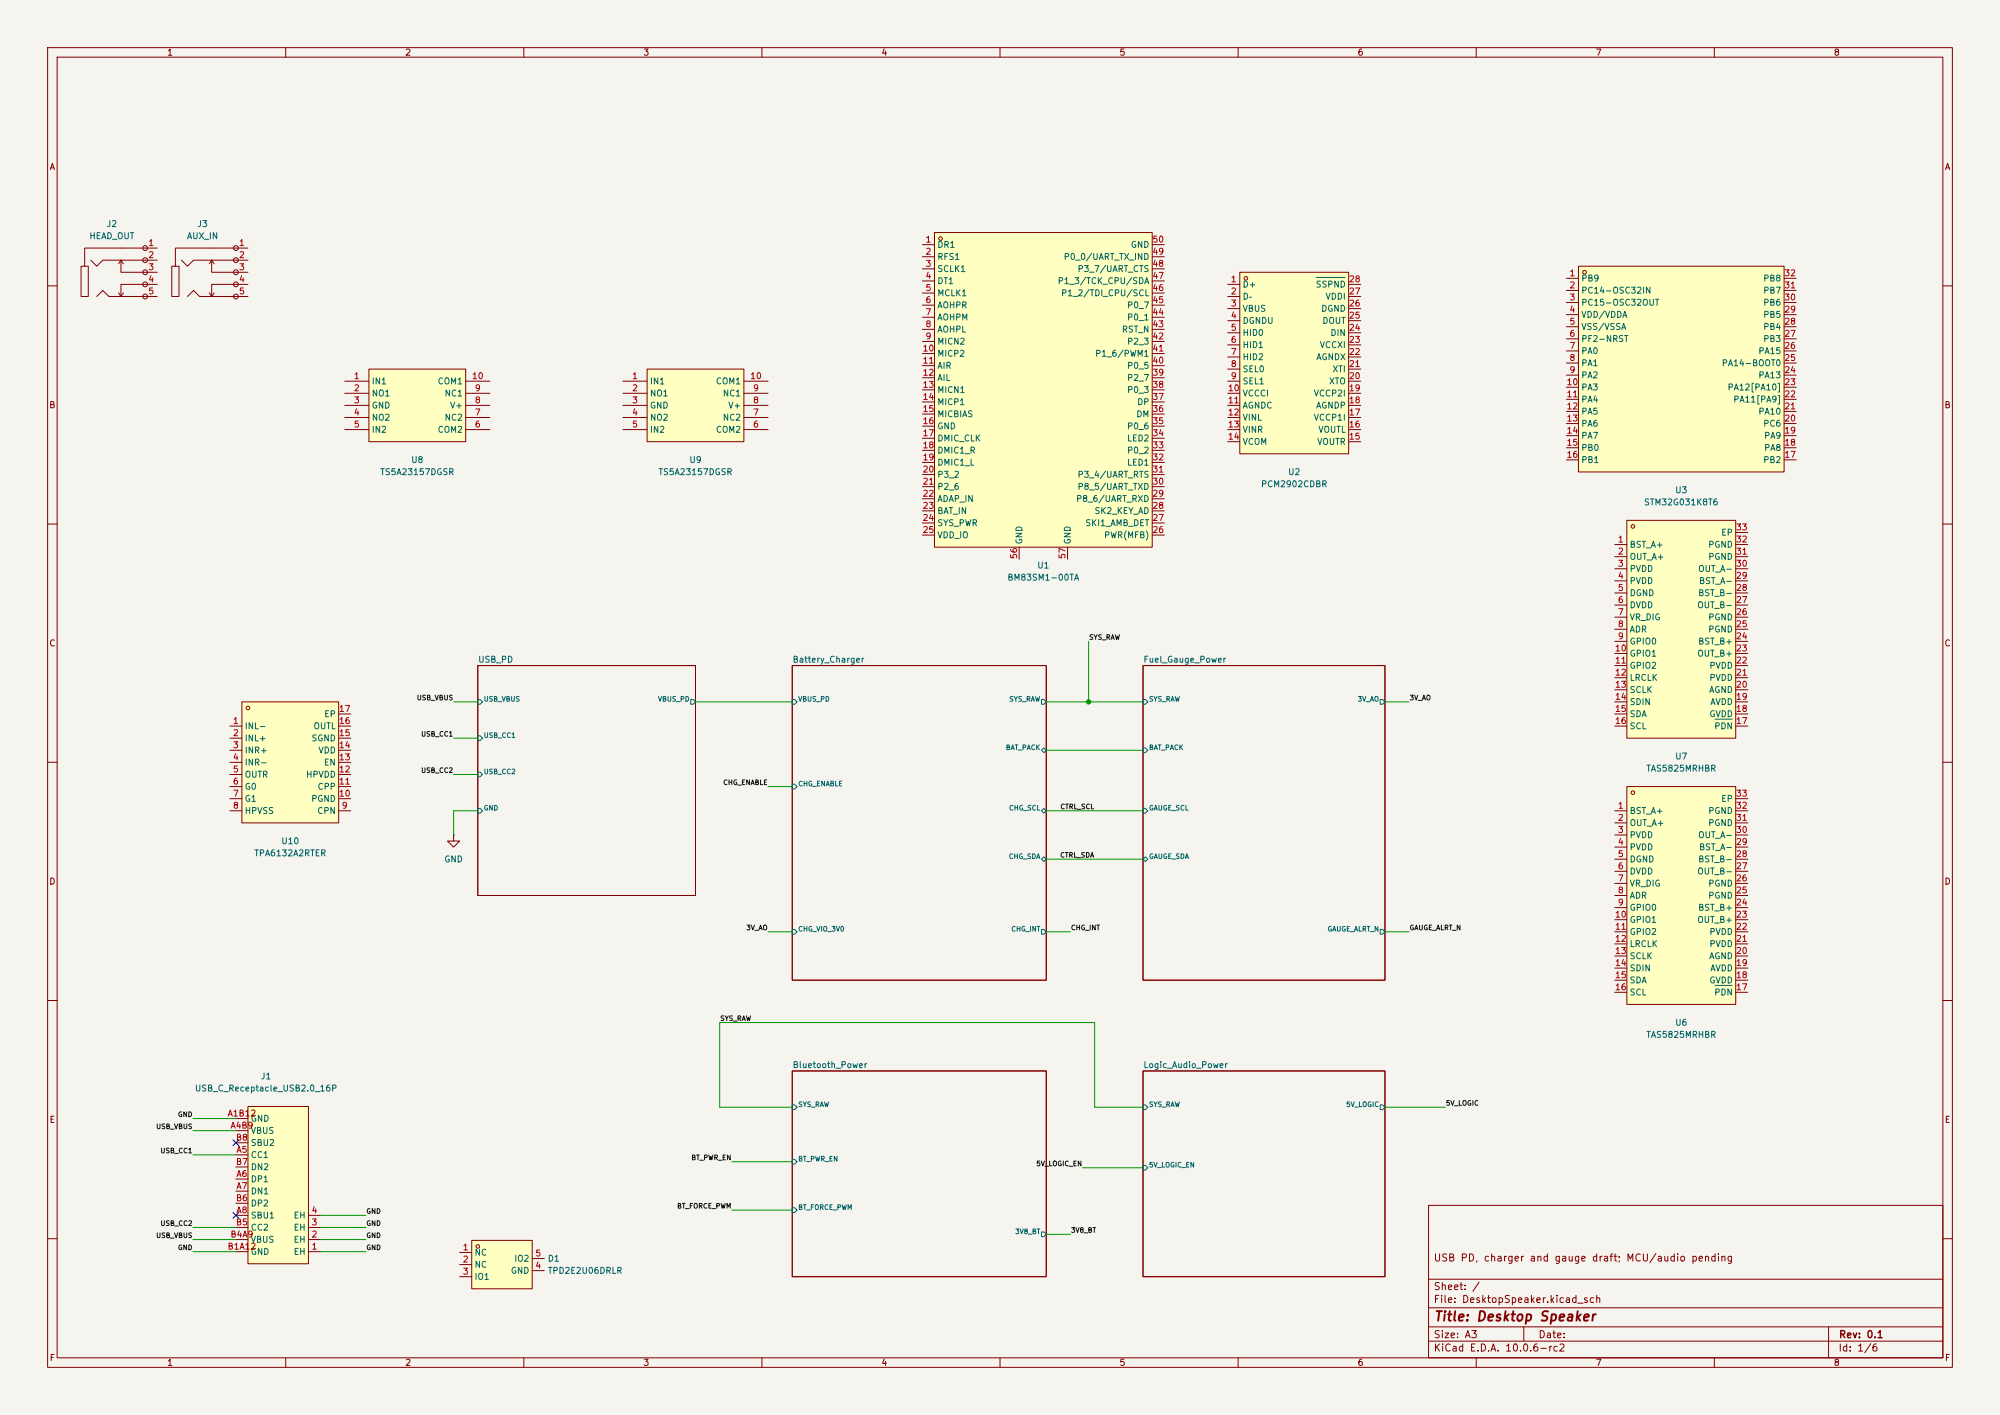
[picture p315: page 1]

USB PD, charger and gauge draft; MCU/audio pending

Size: A3 | Rev: 0.1 | F Date:
KiCad E.D.A. 10.0.6-rc2 | Id: 1/6

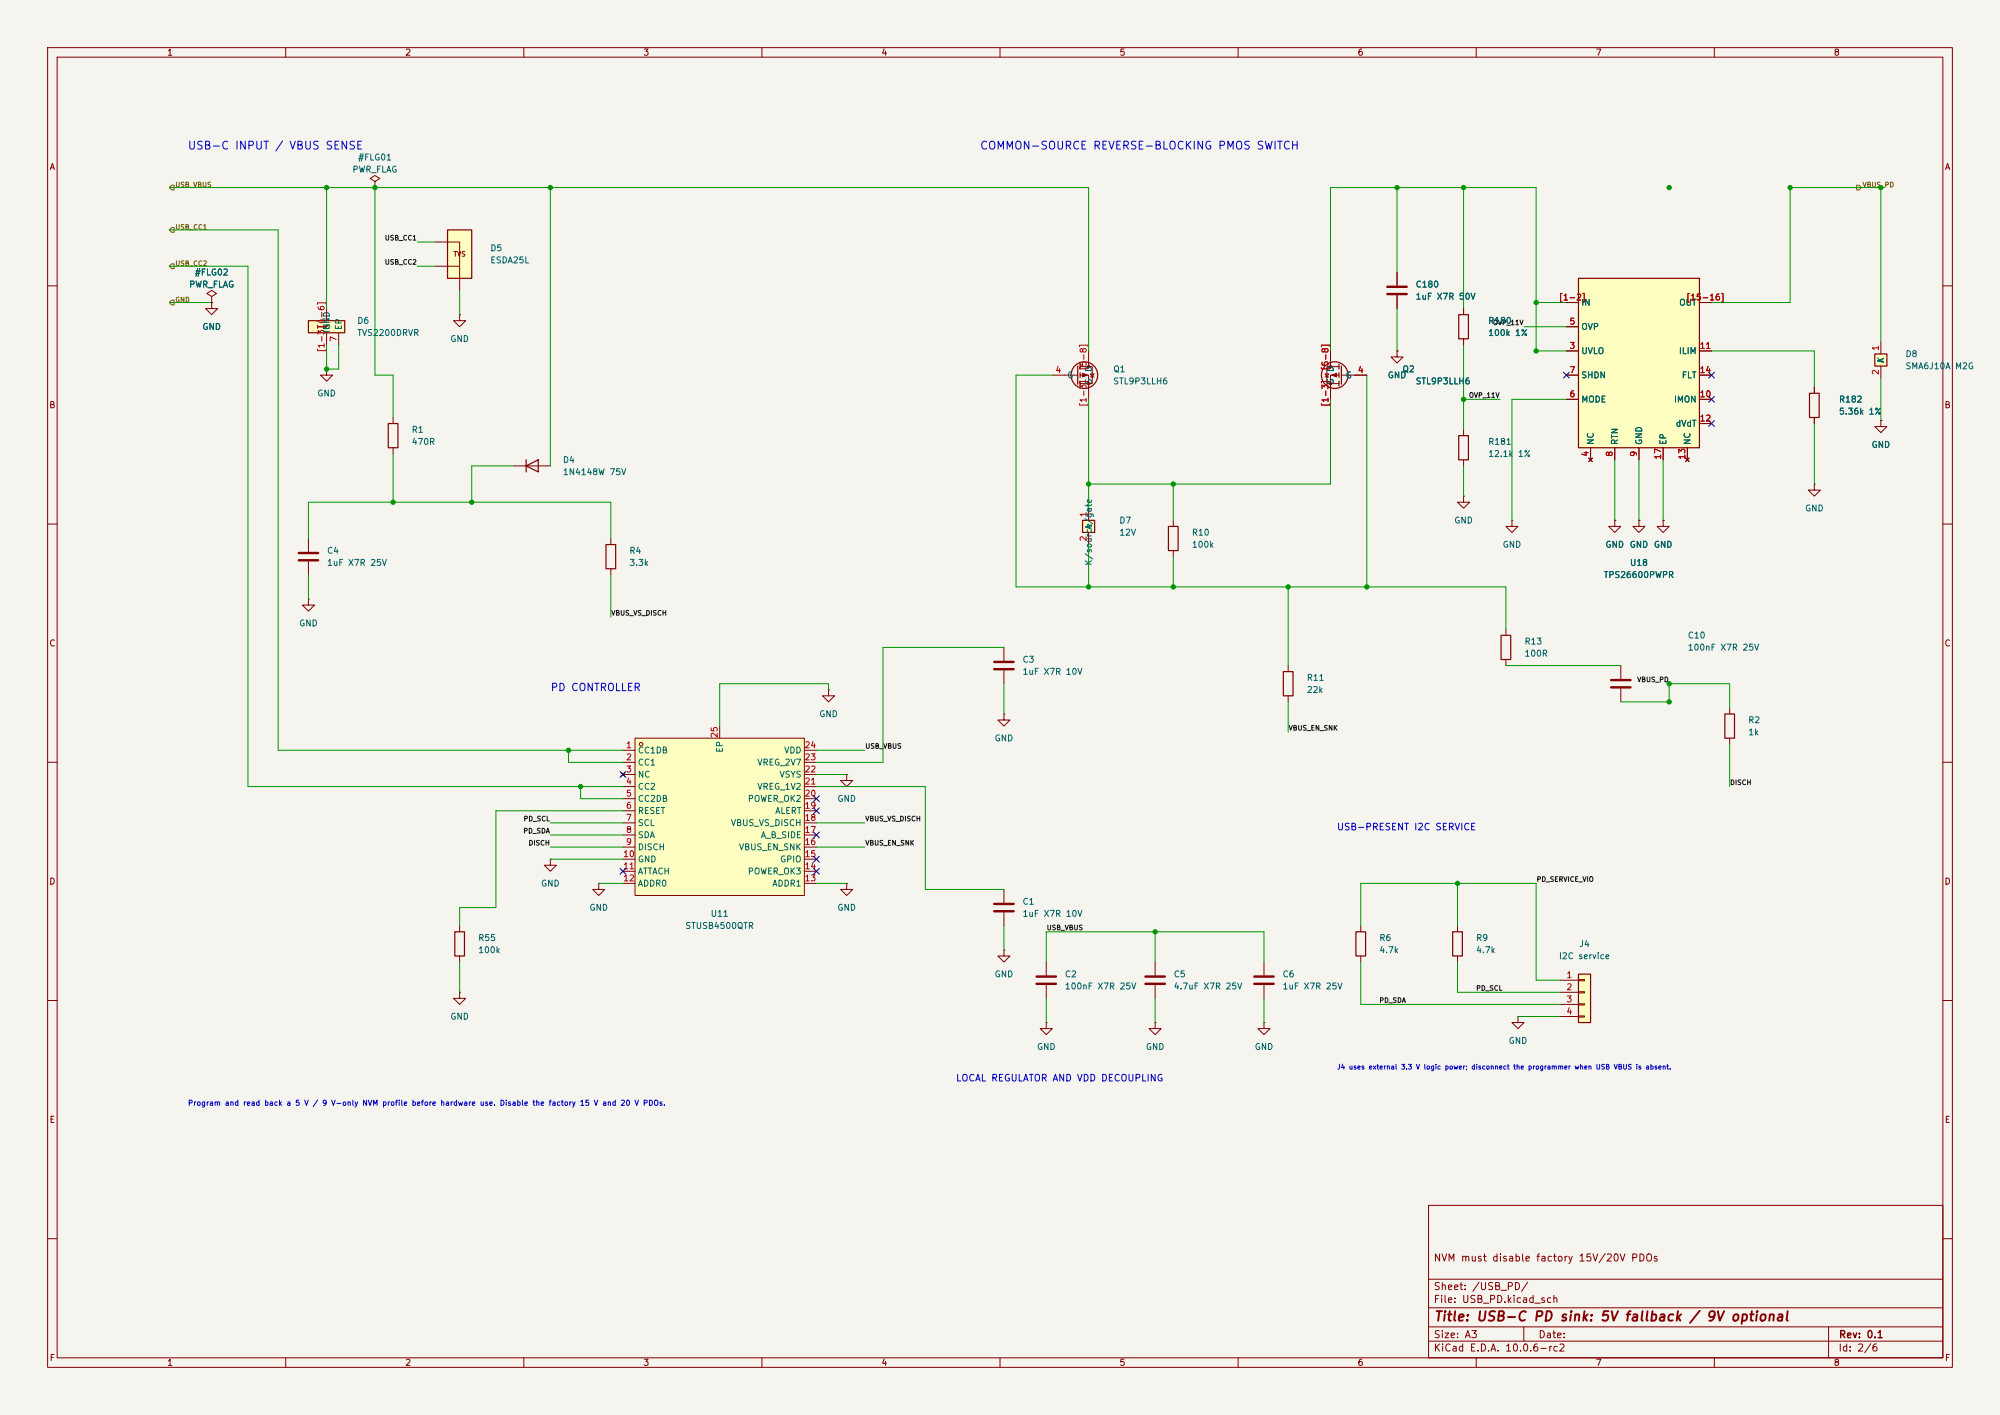
[picture p316: page 2]

USB-C INPUT / VBUS SENSE
GND USB_VBUS USB_CC2 USB_CC1

COMMON-SOURCE REVERSE-BLOCKING PMOS SWITCH

NVM must disable factory 15V/20V PDOs C2

LOCAL REGULATOR AND VDD DECOUPLING

Sheet: /USB_PD/
File: USB_PD.kicad_sch
Title: USB-C PD sink: 5V fallback / 9V optional

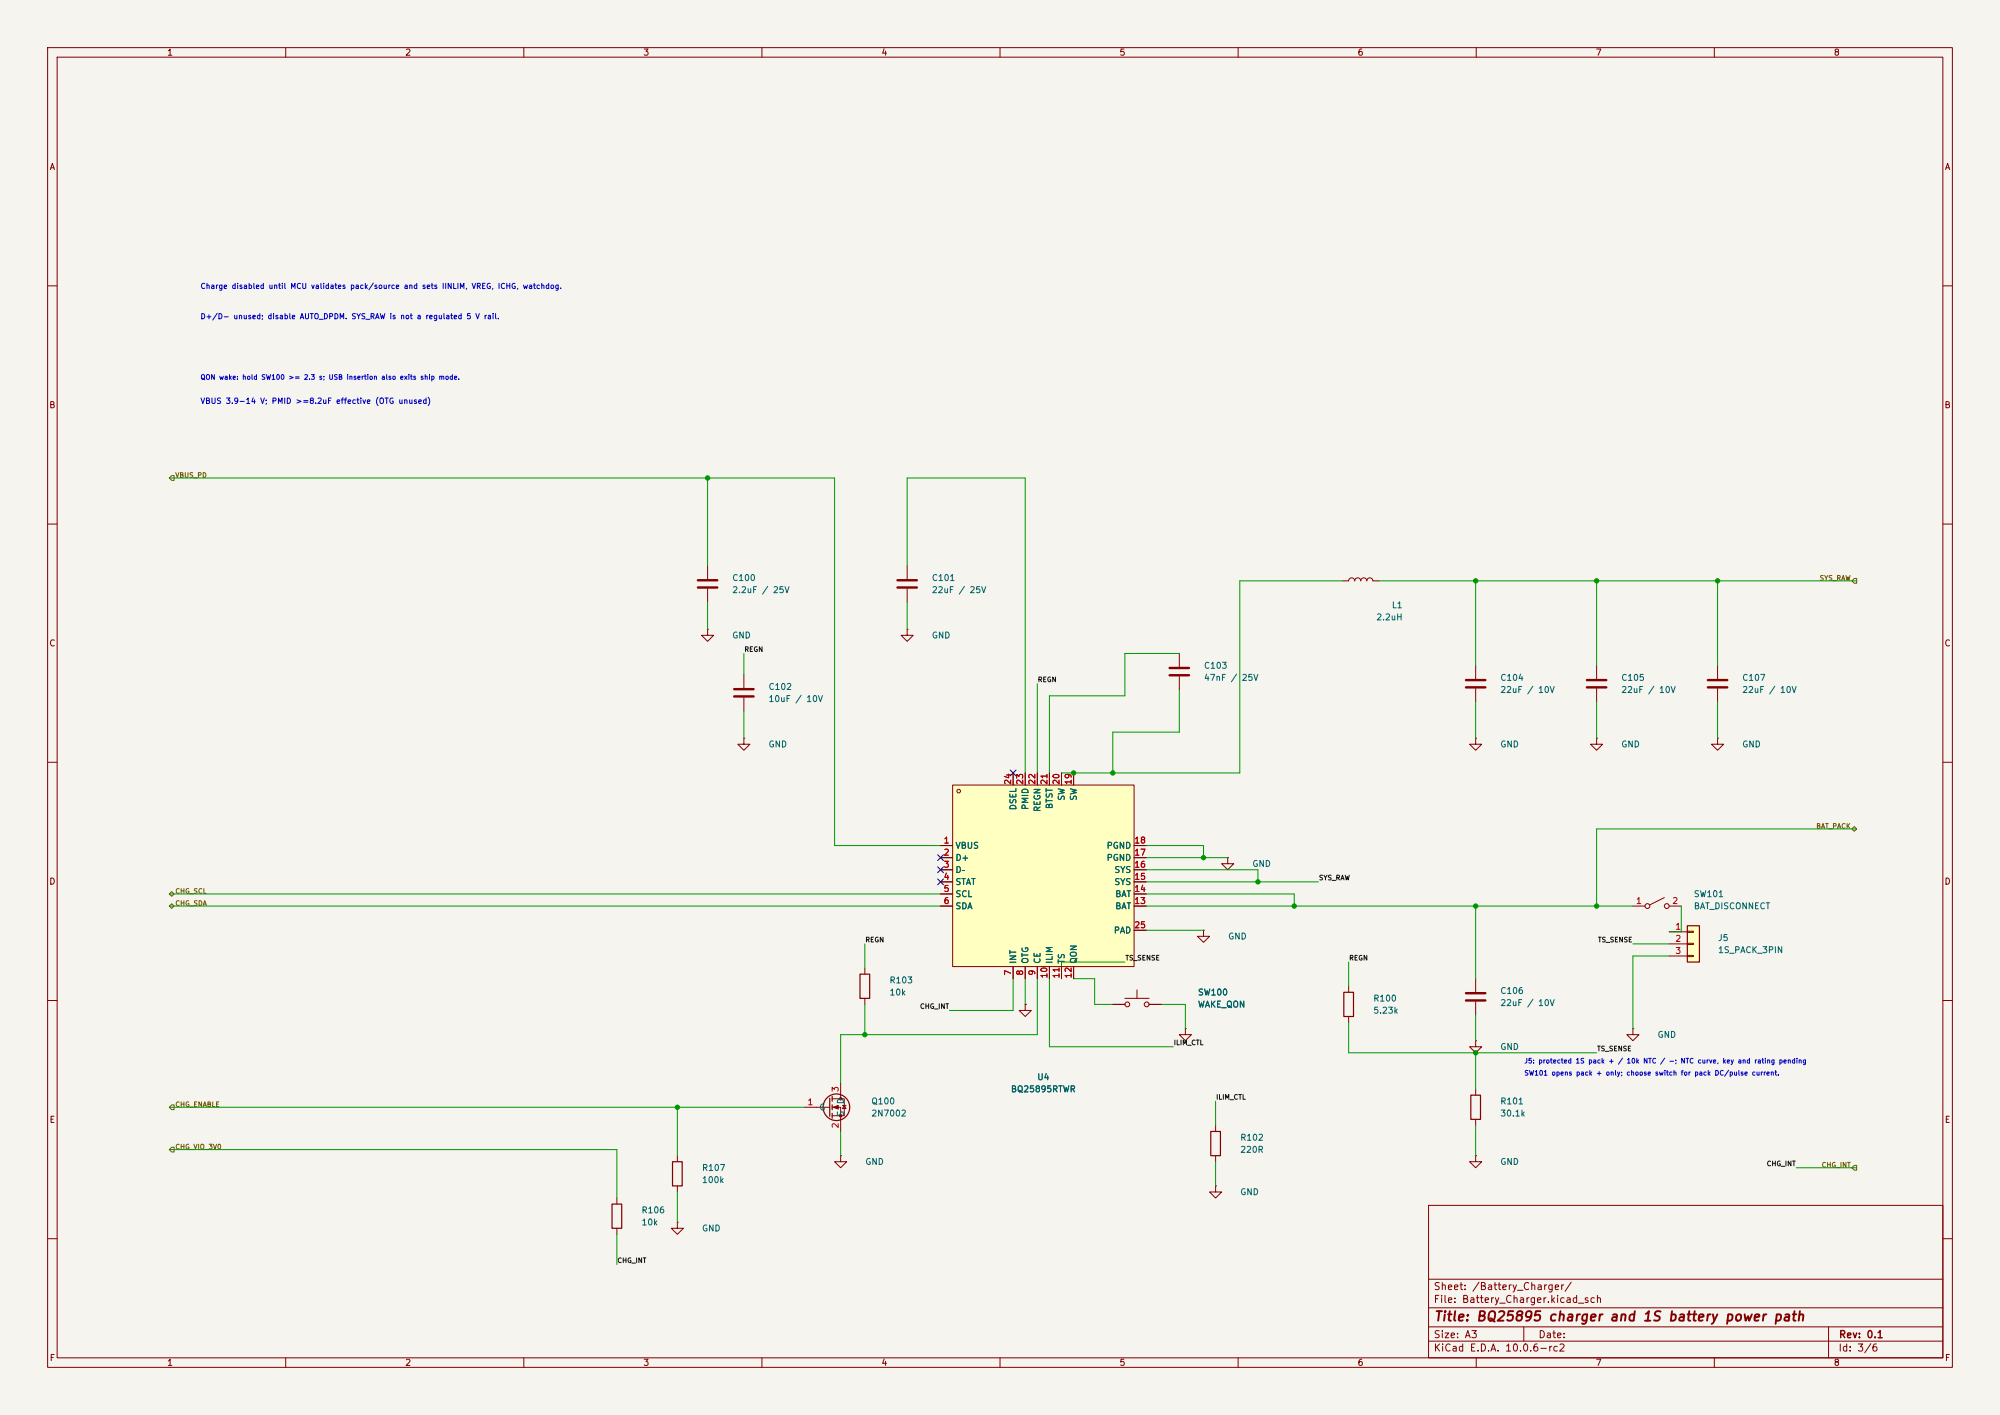
[picture p317: page 3]

QON wake: hold SW100 >= 2.3 s; USB insertion also exits ship mode.

8 CE 9 ILIM 10 TS 11 QON 12 BAT 13 BAT 14 SYS 15 SYS 16 PGND 17 PGND 18 SW 19 SW 20 BTST 21 REGN 22 PMID 23 DSEL 24 PAD 25 U4 BQ25895RTWR

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

J5: protected 1S pack + / 10k NTC / -; NTC curve, key and rating pending
SW101 opens pack + only; choose switch for pack DC/pulse current.

Sheet: /Battery_Charger/
File: Battery_Charger.kicad_sch
Title: BQ25895 charger and 1S battery power path

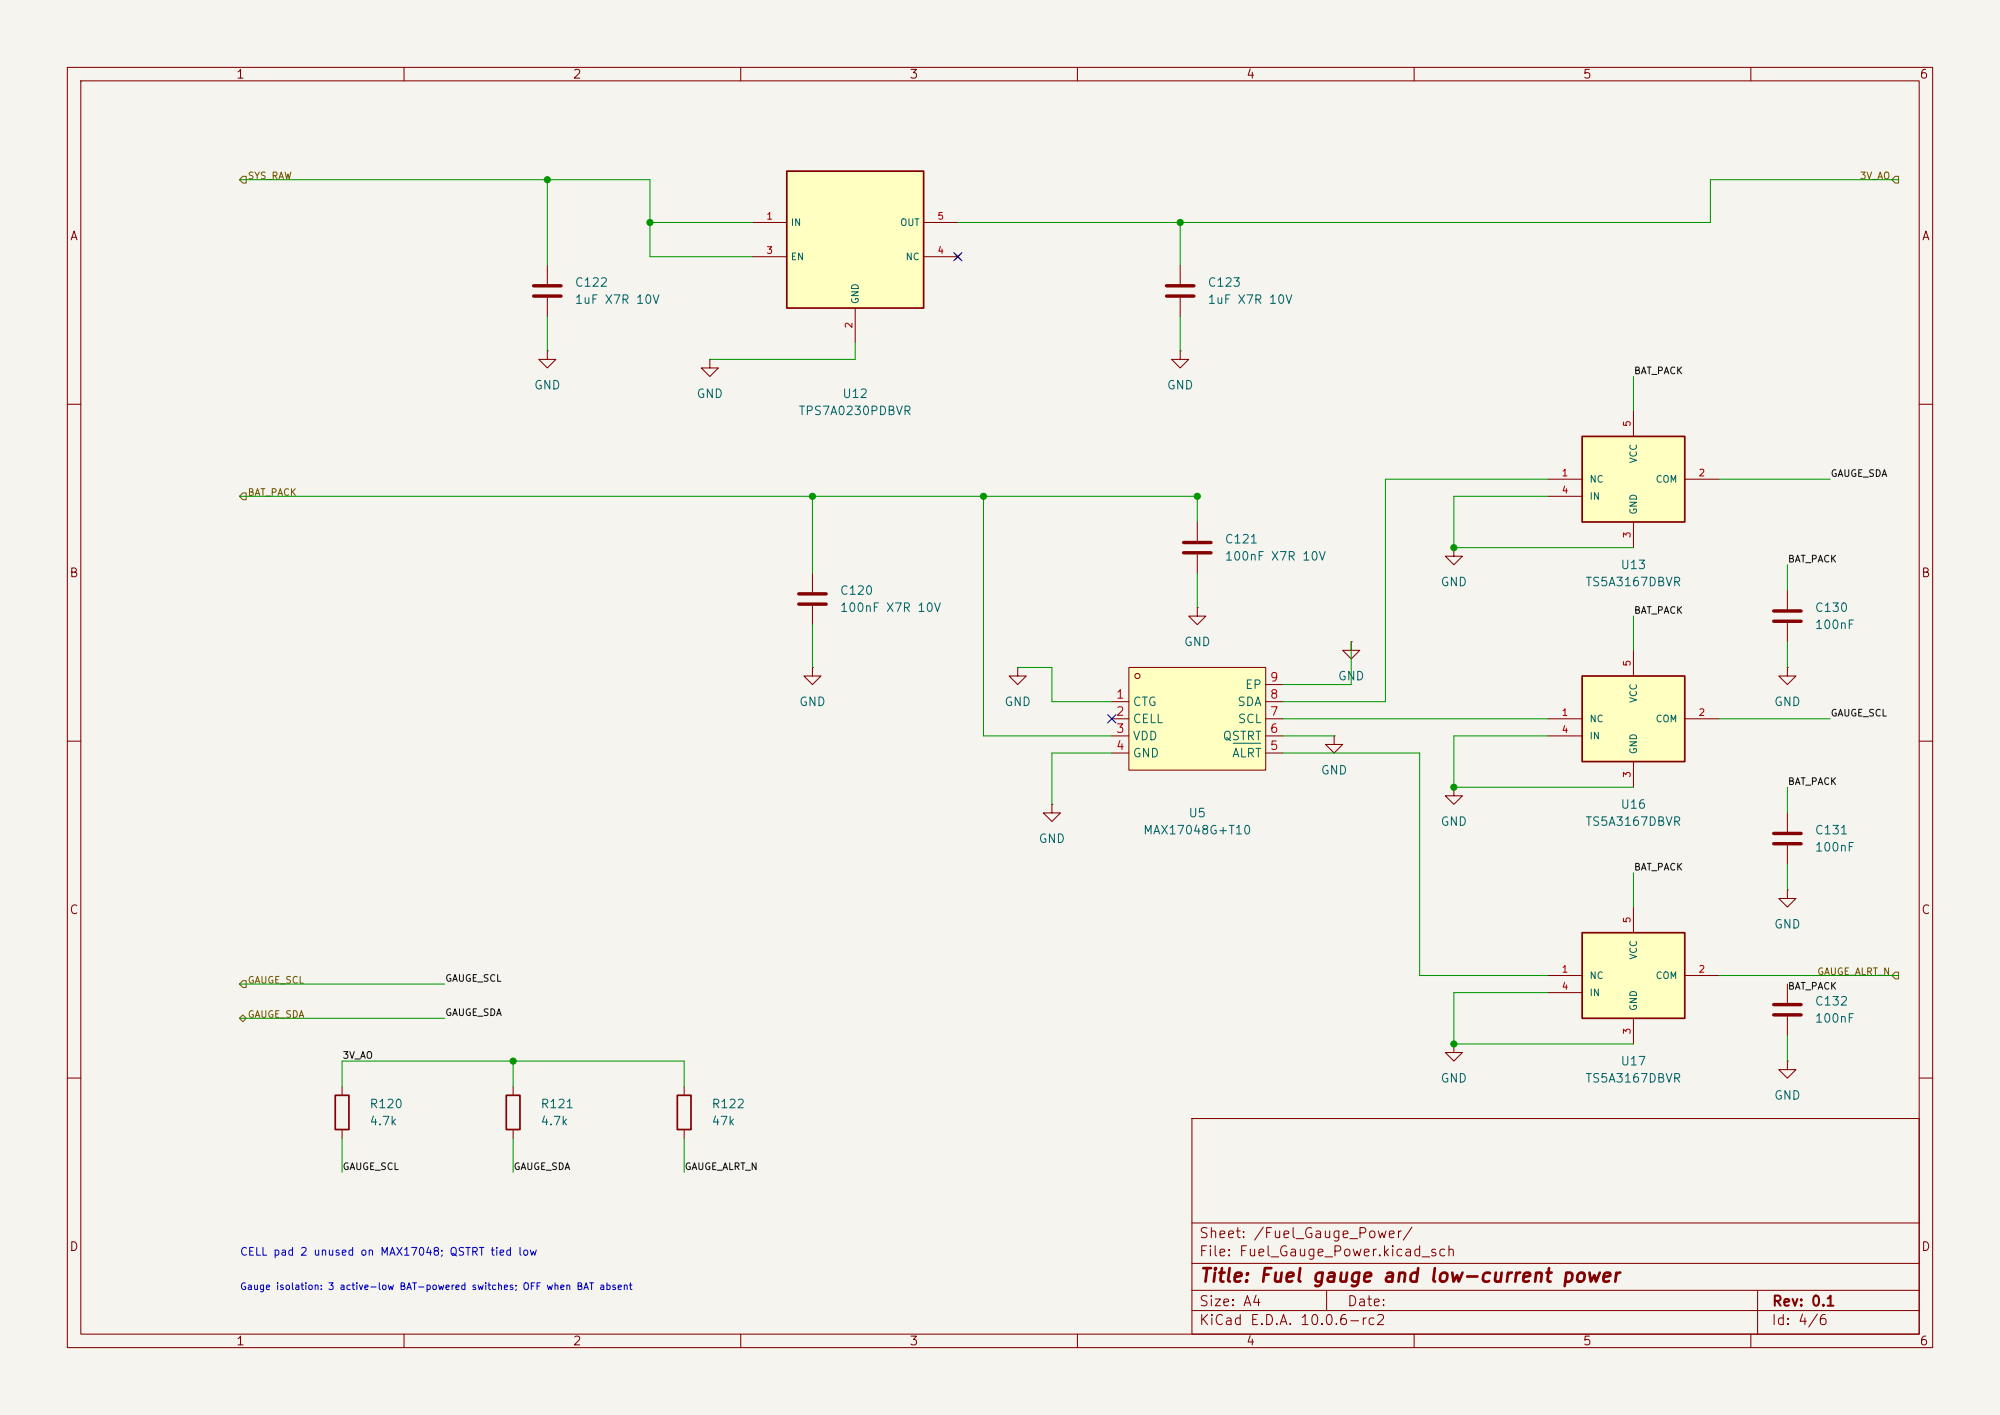
[picture p318: page 4]

GAUGE_SDA BAT_PACK CELL pad 2 unused on MAX17048; QSTRT tied low

Sheet: /Fuel_Gauge_Power/
File: Fuel_Gauge_Power.kicad_sch
Title: Fuel gauge and low-current power

Gauge isolation: 3 active-low BAT-powered switches; OFF when BAT absent

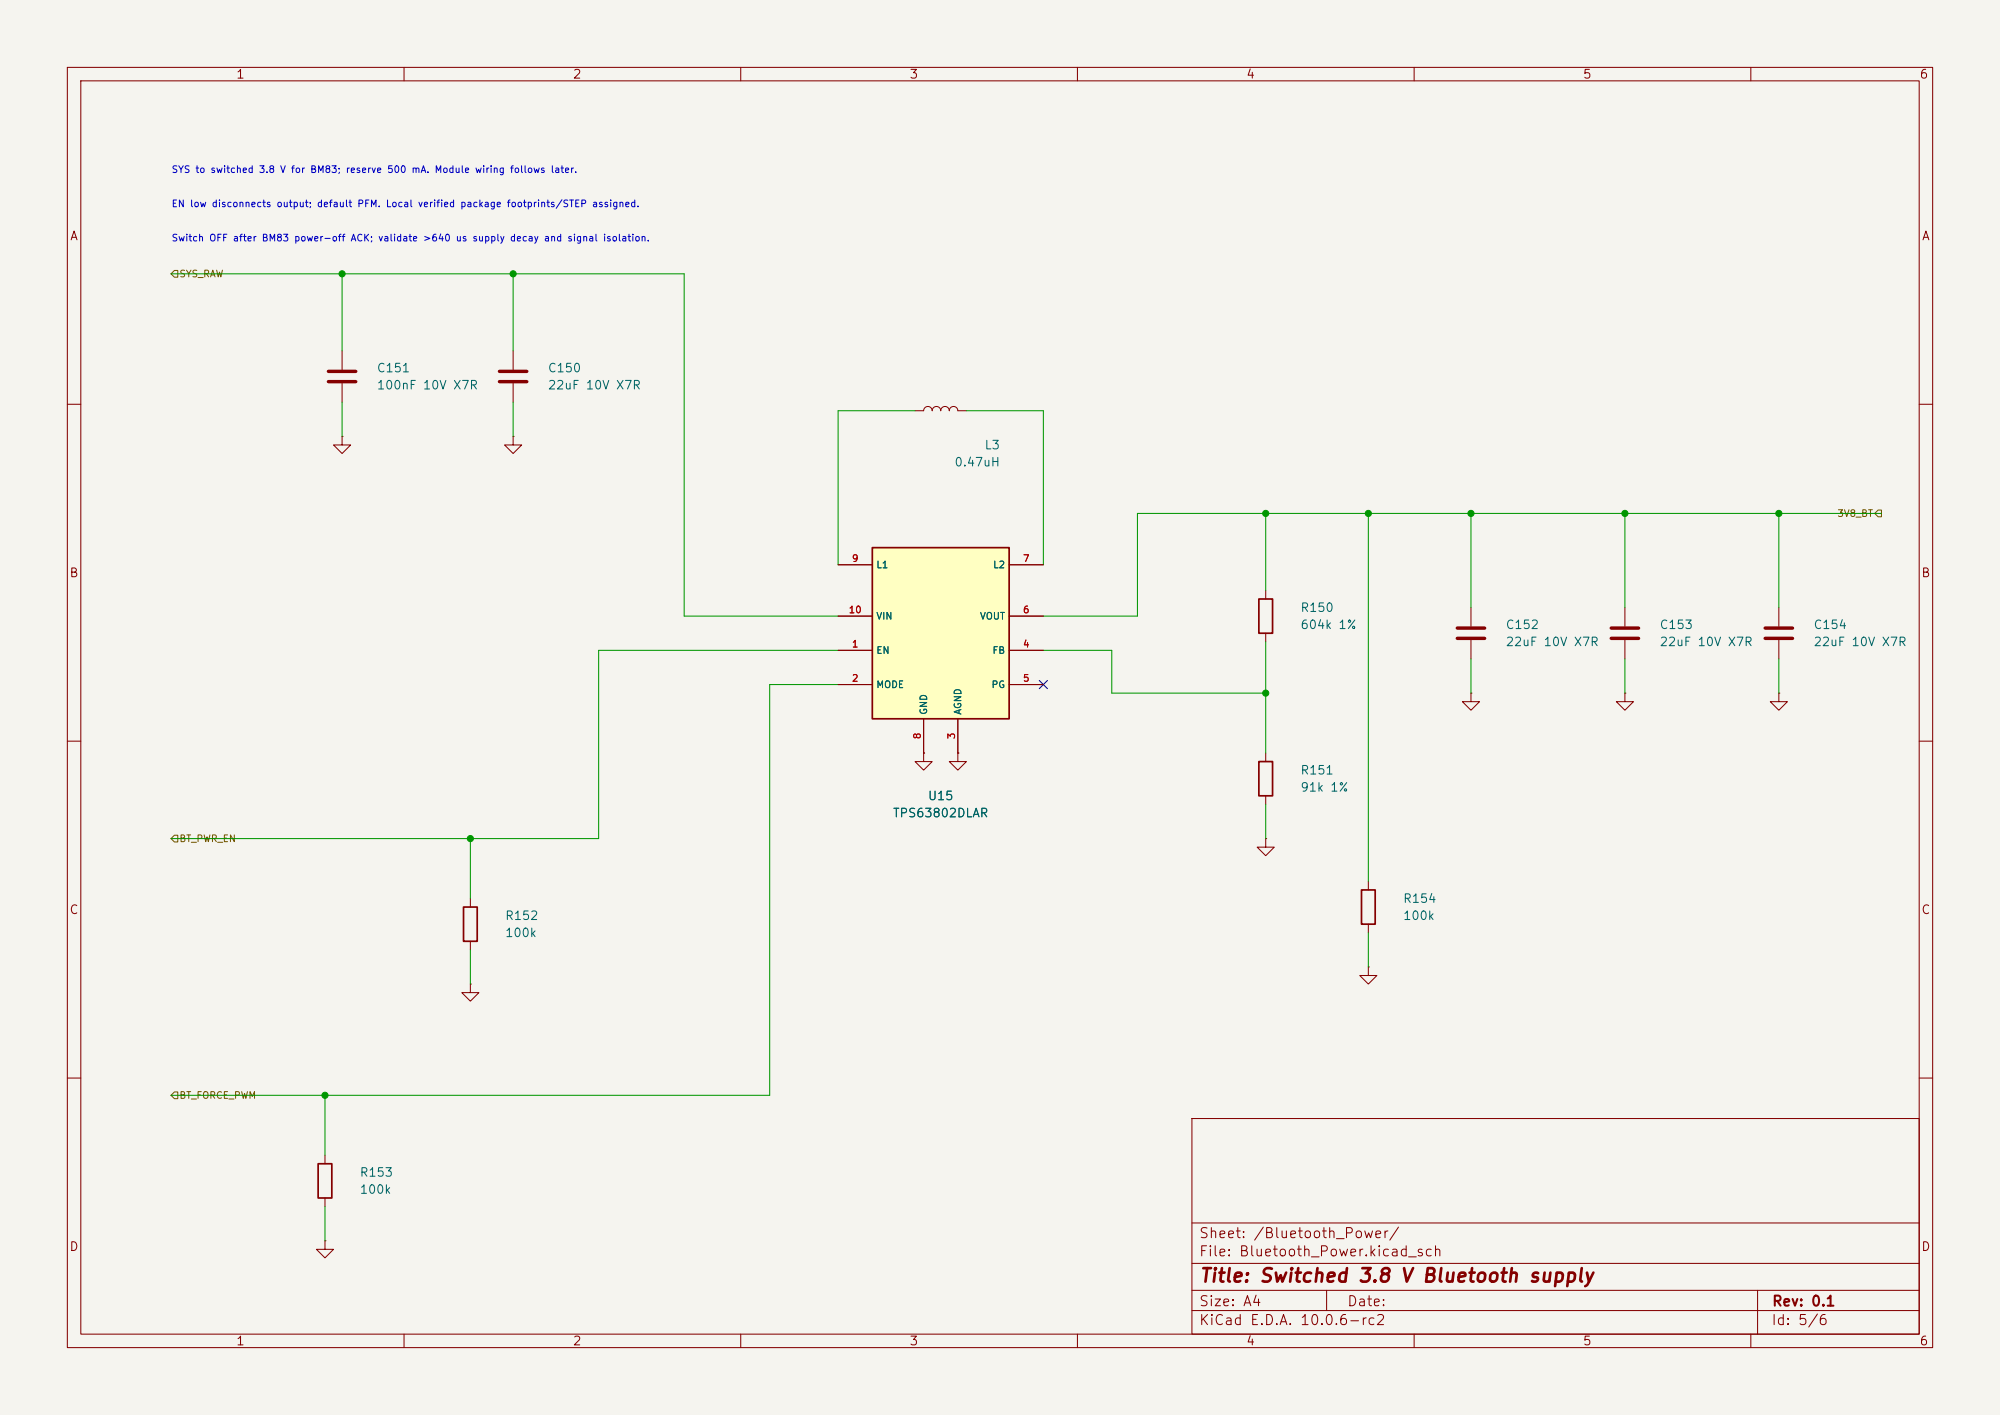
[picture p319: page 5]

Sheet: /Bluetooth_Power/
File: Bluetooth_Power.kicad_sch
Title: Switched 3.8 V Bluetooth supply

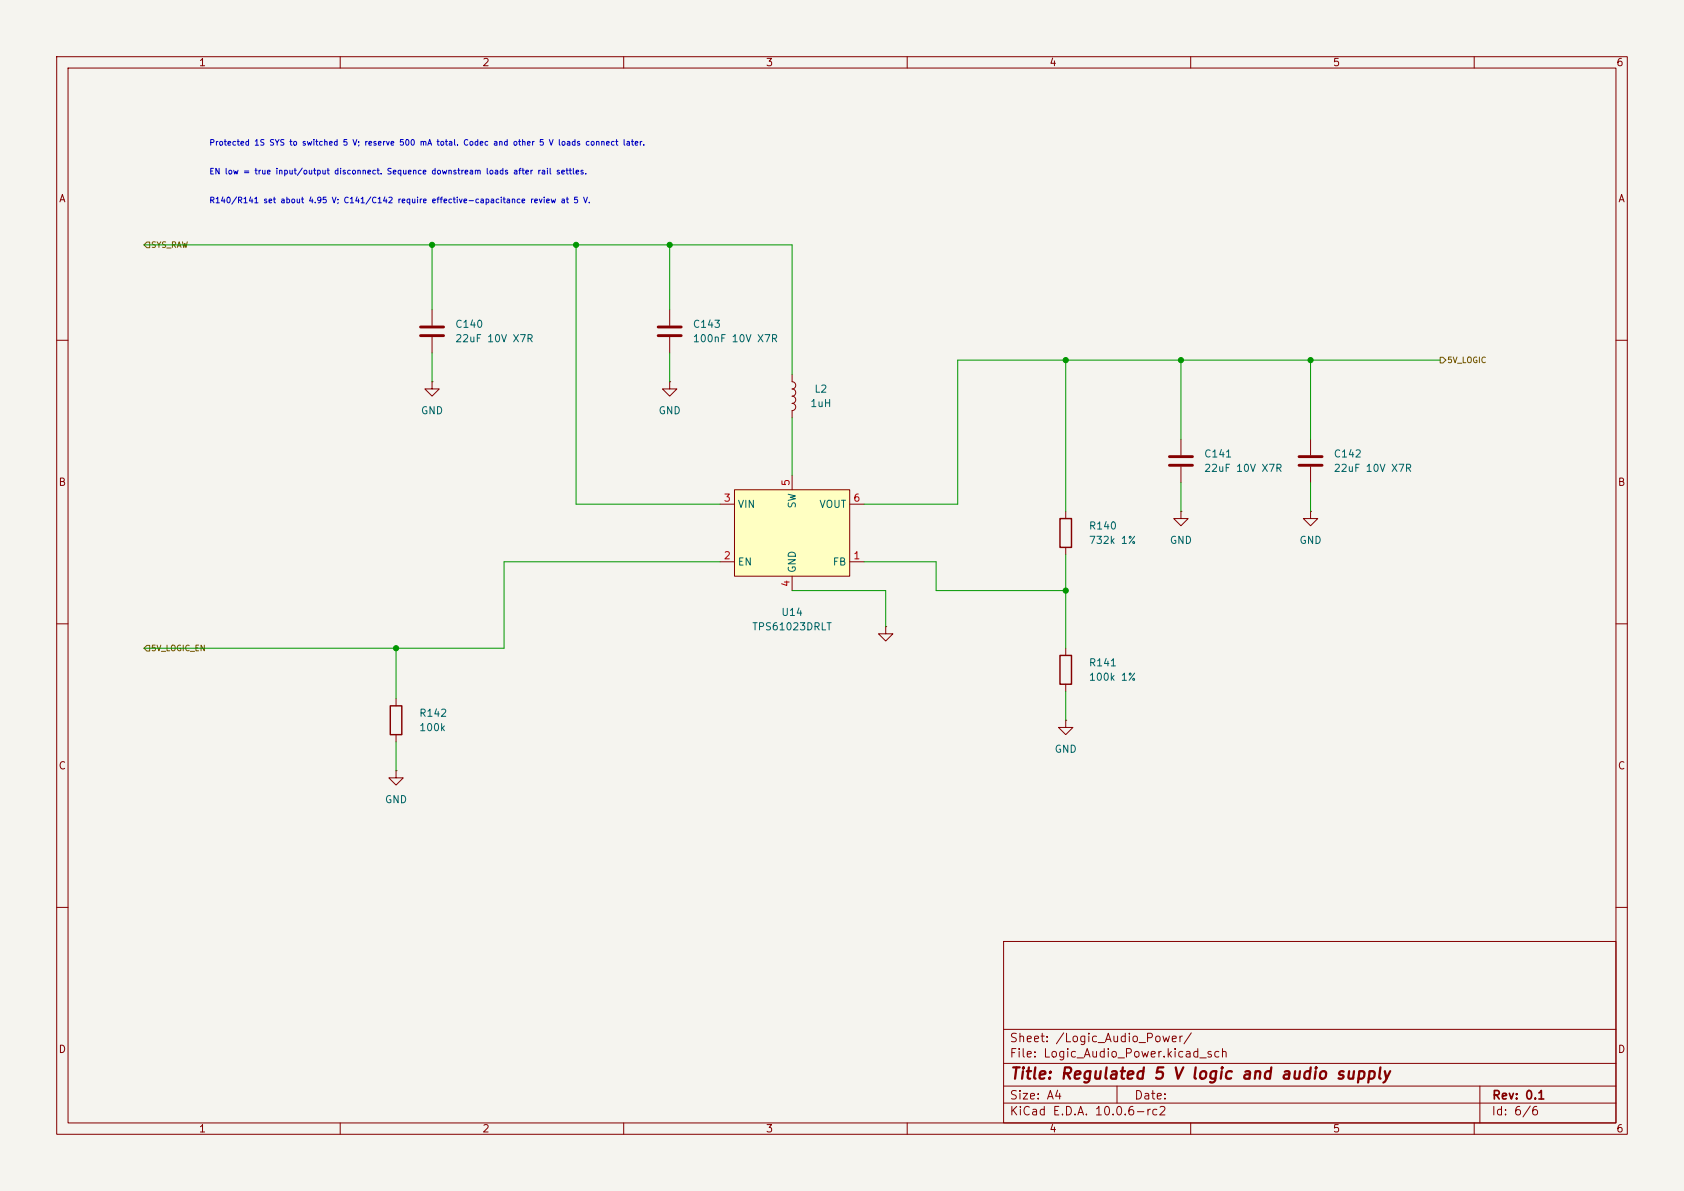
[picture p320: page 6]

Protected 1S SYS to switched 5 V; reserve 500 mA total. Codec and other 5 V loads connect later. R140/R141 set about 4.95 V; C141/C142 require effective-capacitance review at 5 V. EN low = true input/output disconnect. Sequence downstream loads after rail settles.

Sheet: /Logic_Audio_Power/
File: Logic_Audio_Power.kicad_sch
Title: Regulated 5 V logic and audio supply
