chithigun23/DesktopSpeaker/ai-files/reports/amp/amp.pdf

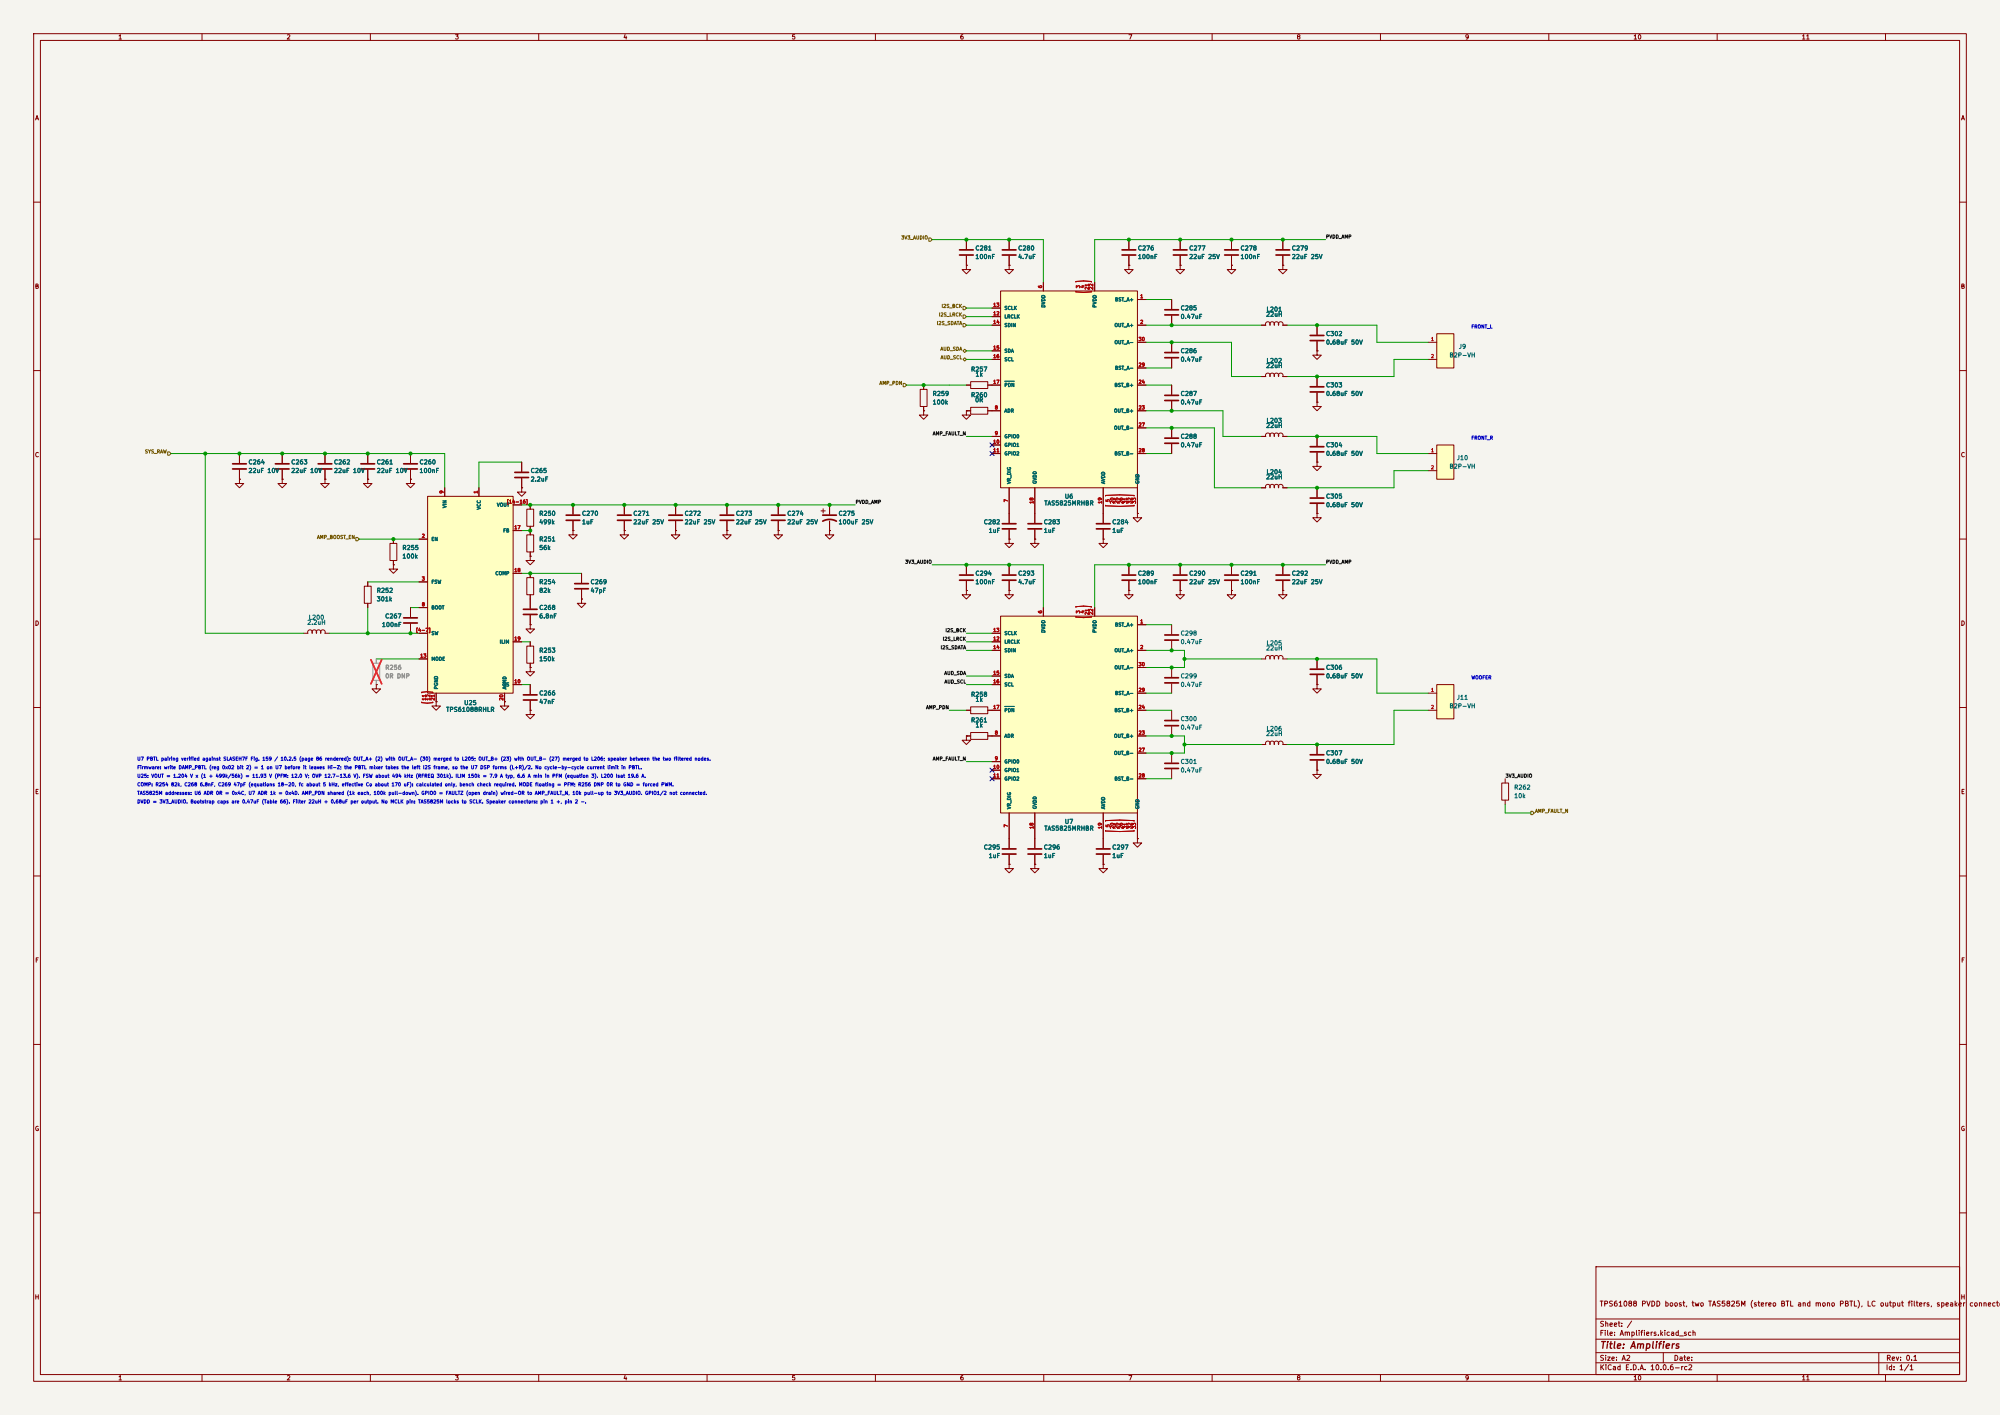
[picture p321: page 1]

TPS61088 PVDD boost, two TAS5825M (stereo BTL and mono PBTL), LC output filters, speaker connectors

Size: A2 | Rev: 0.1
KiCad E.D.A. 10.0.6-rc2 | Id: 1/1
