chithigun23/DesktopSpeaker/ai-files/reports/charger-review/after.pdf

USB PD, charger and gauge draft; MCU/audio pending

Size: A3 | Rev: 0.1 | F Date:
KiCad E.D.A. 10.0.6-rc2 | Id: 1/6

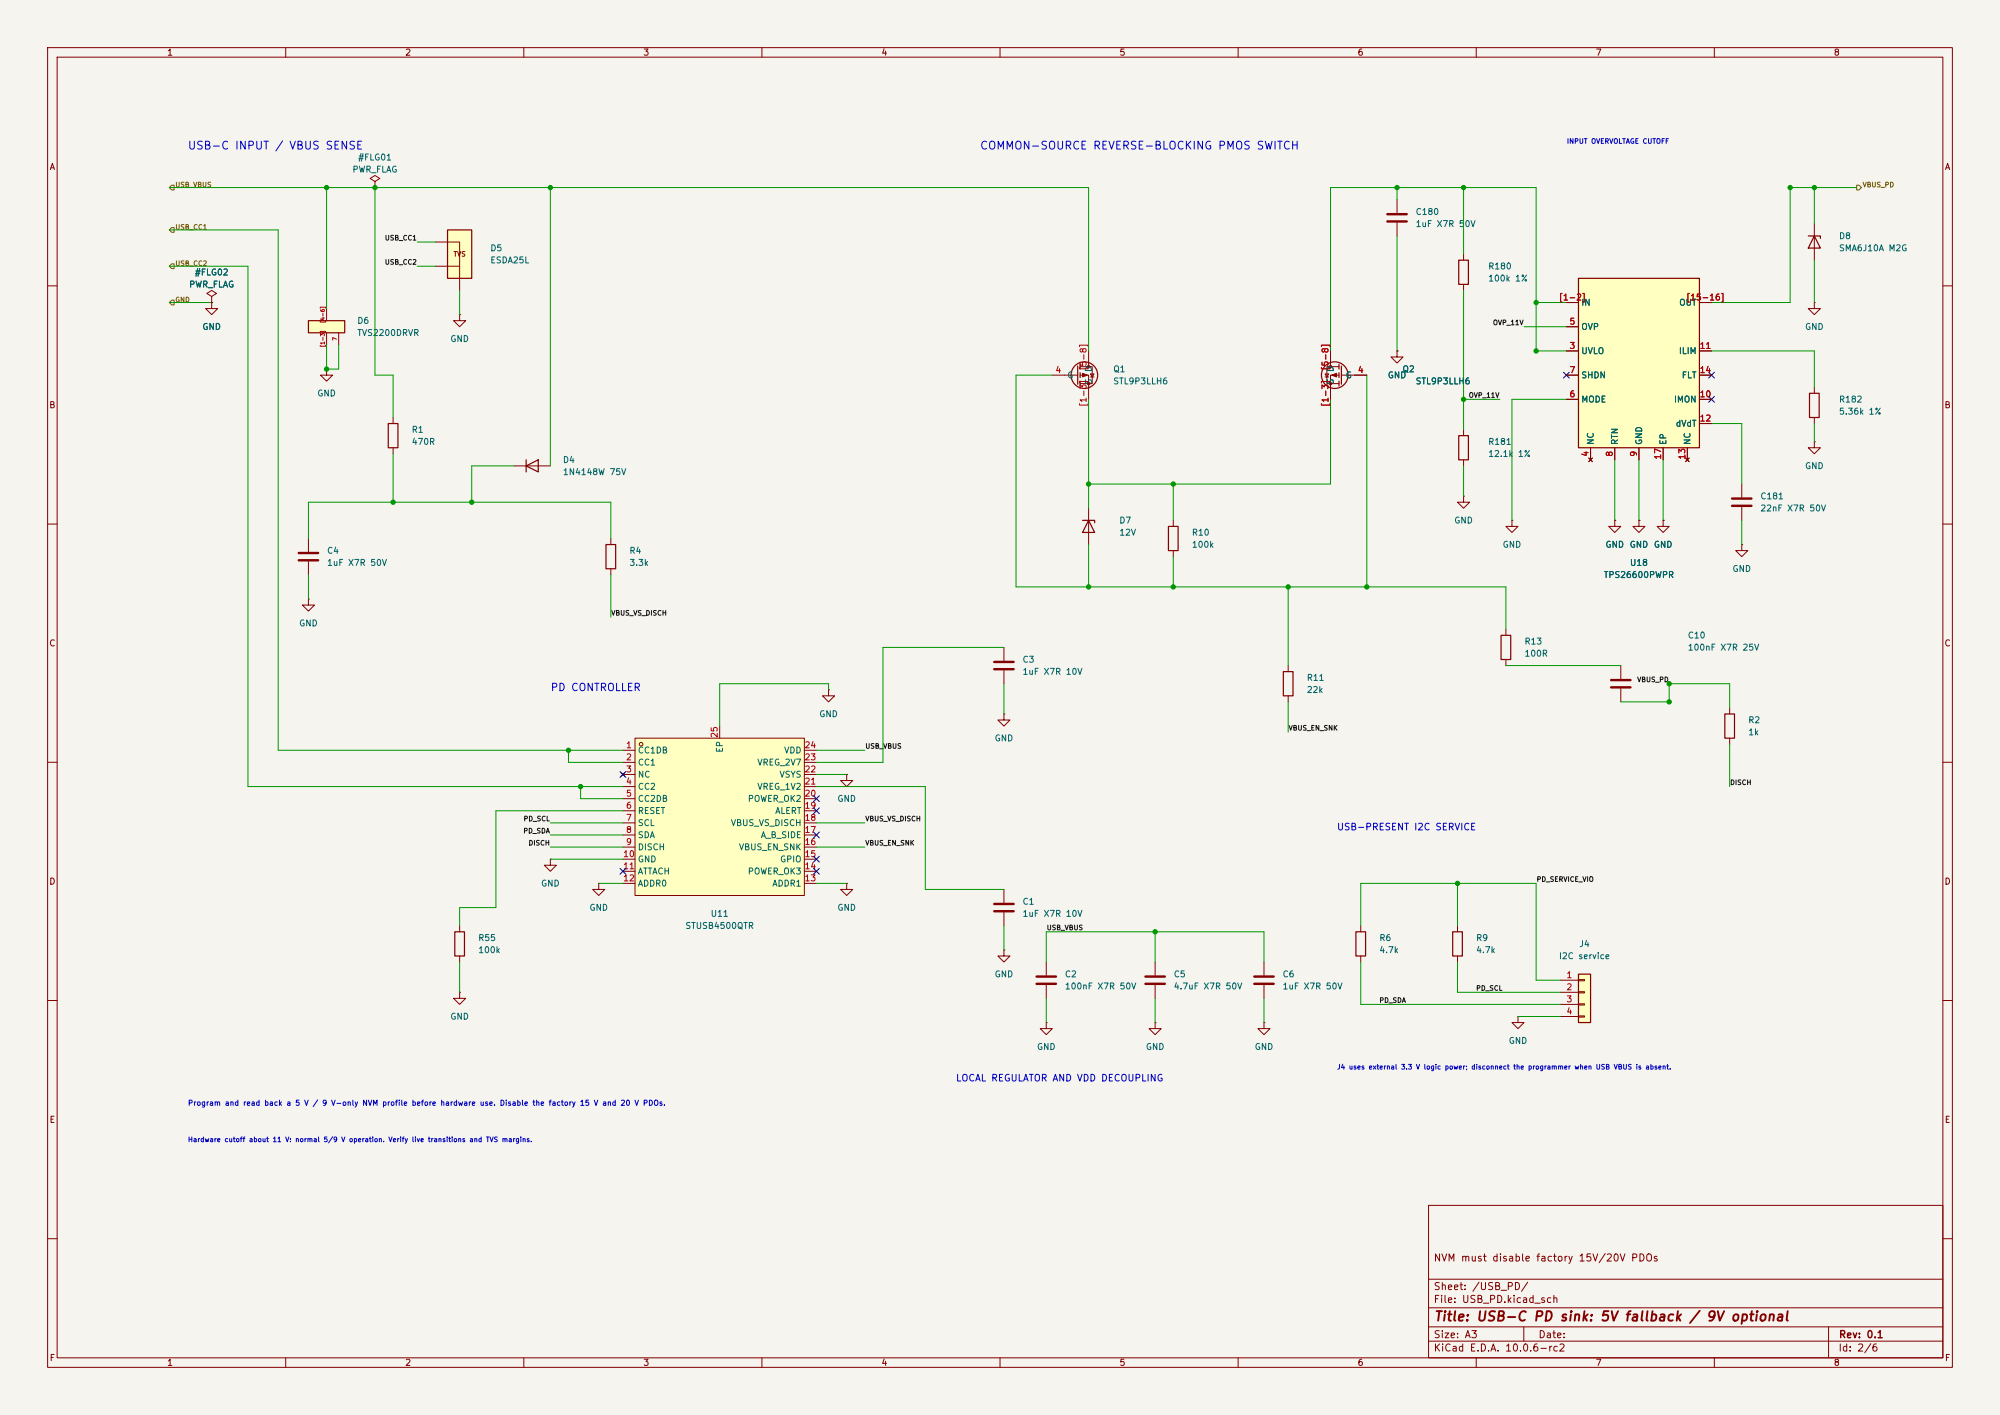
[picture p322: page 2]

USB-C INPUT / VBUS SENSE
GND USB_VBUS USB_CC1 USB_CC2

COMMON-SOURCE REVERSE-BLOCKING PMOS SWITCH

LOCAL REGULATOR AND VDD DECOUPLING

Program and read back a 5 V / 9 V-only NVM profile before hardware use. Disable the factory 15 V and 20 V PDOs.

NVM must disable factory 15V/20V PDOs

Sheet: /USB_PD/
File: USB_PD.kicad_sch
Title: USB-C PD sink: 5V fallback / 9V optional

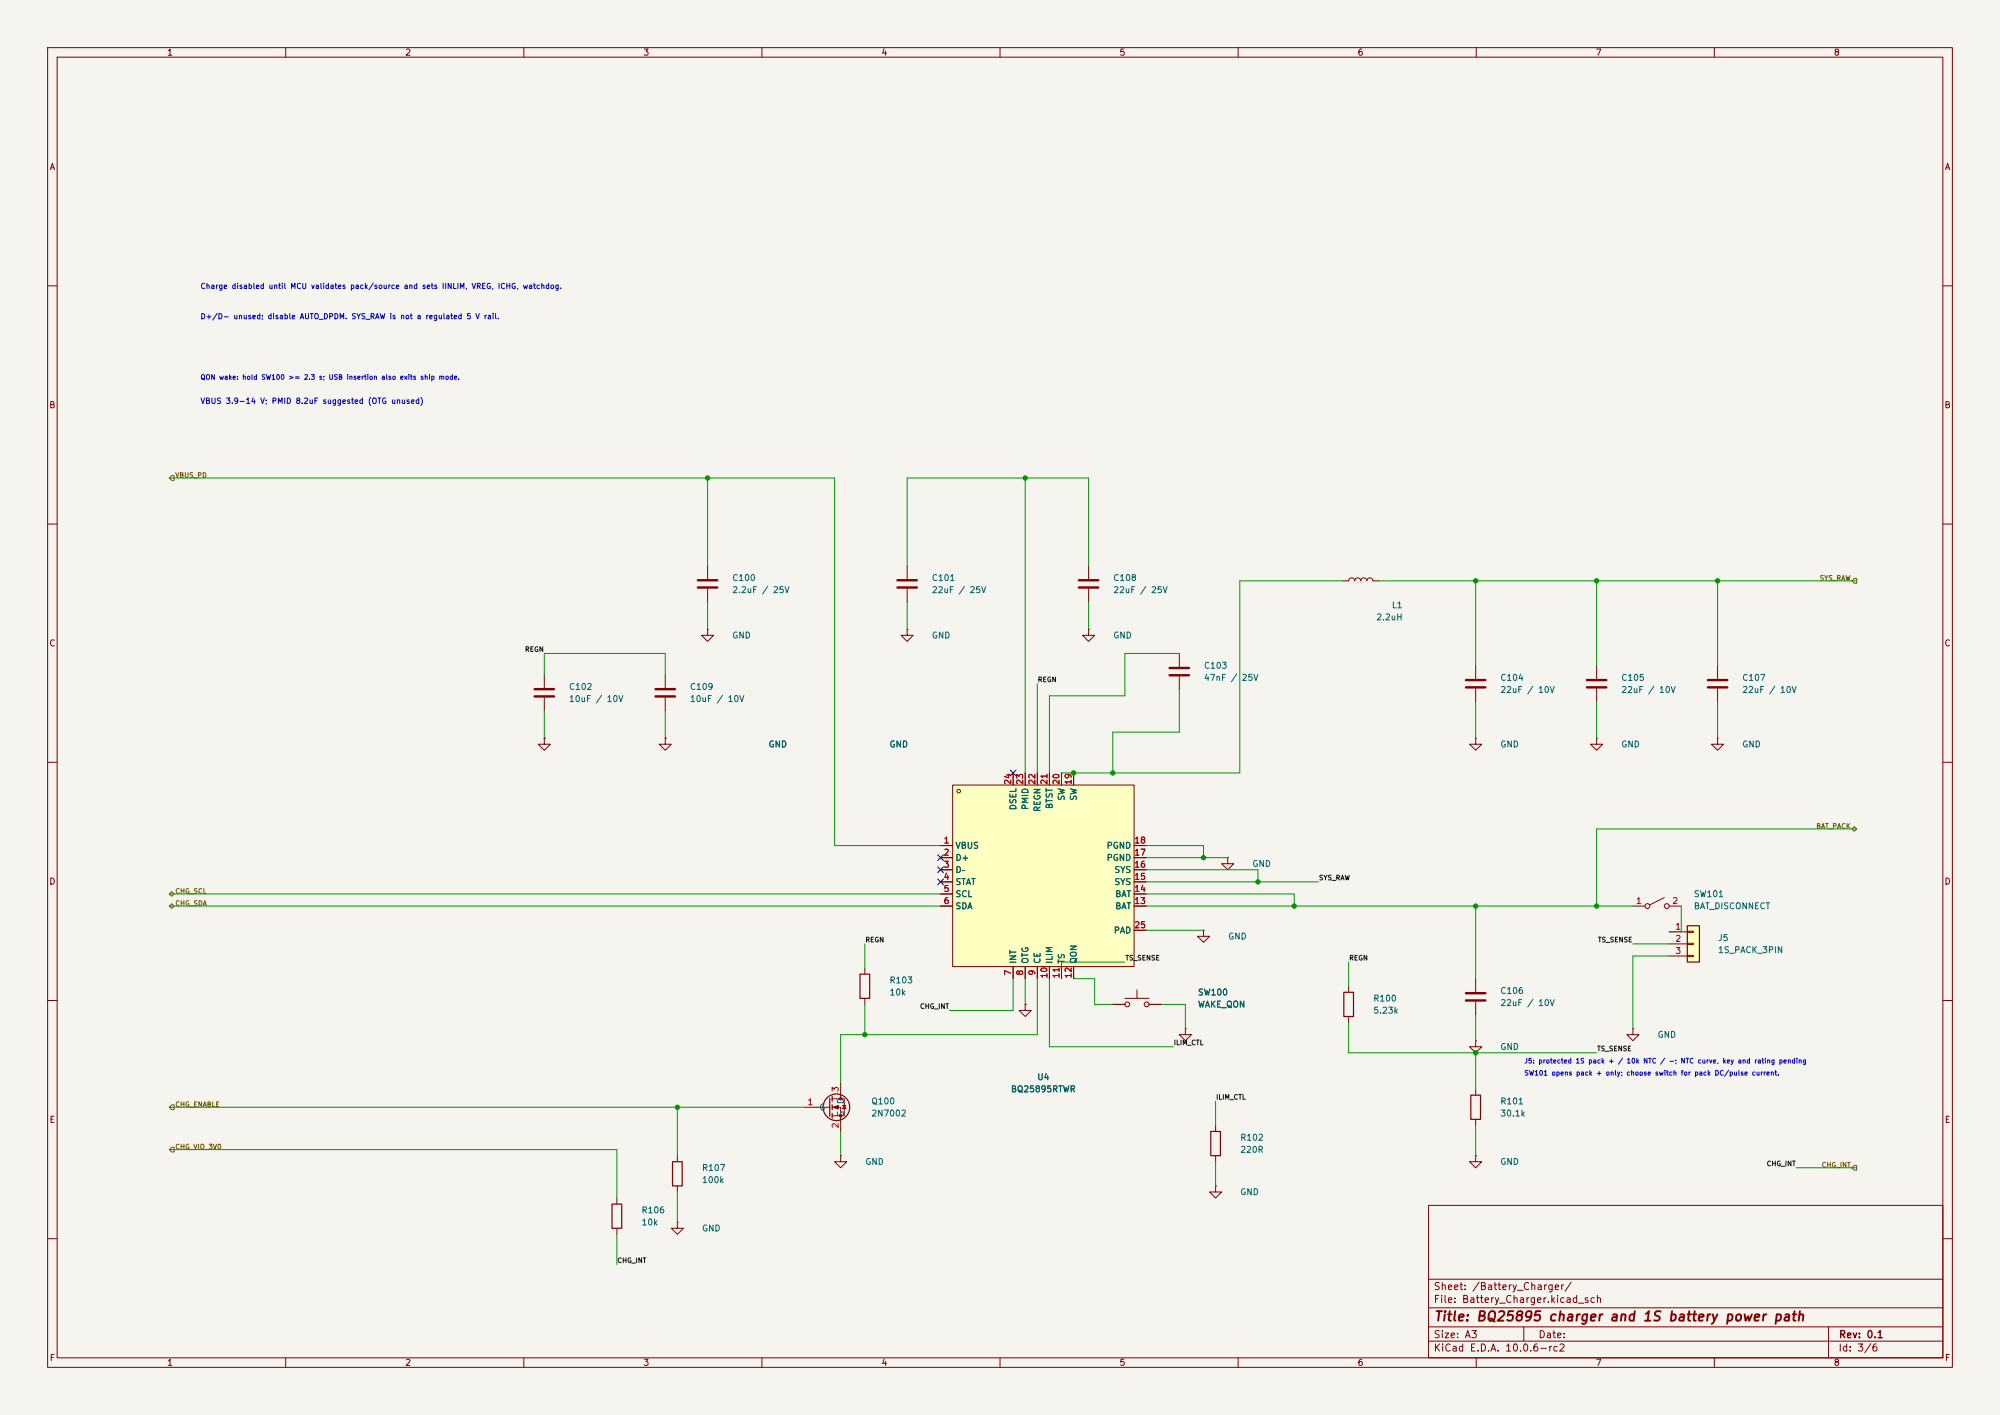
[picture p323: page 3]

Charge disabled until MCU validates pack/source and sets IINLIM, VREG, ICHG, watchdog.

D+/D- unused; disable AUTO_DPDM. SYS_RAW is not a regulated 5 V rail. VBUS 3.9-14 V; PMID 8.2uF suggested (OTG unused)

8 CE 9 ILIM 10 TS 11 QON 12 BAT 13 BAT 14 SYS 15 SYS 16 PGND 17 PGND 18 SW 19 SW 20 BTST 21 REGN 22 PMID 23 DSEL 24 PAD 25 U4 BQ25895RTWR

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

J5: protected 1S pack + / 10k NTC / -; NTC curve, key and rating pending

Sheet: /Battery_Charger/
File: Battery_Charger.kicad_sch
Title: BQ25895 charger and 1S battery power path


GAUGE_SDA BAT_PACK CELL pad 2 unused on MAX17048; QSTRT tied low

Sheet: /Fuel_Gauge_Power/
File: Fuel_Gauge_Power.kicad_sch
Title: Fuel gauge and low-current power

Gauge isolation: 3 active-low BAT-powered switches; OFF when BAT absent


Sheet: /Bluetooth_Power/
File: Bluetooth_Power.kicad_sch
Title: Switched 3.8 V Bluetooth supply


Protected 1S SYS to switched 5 V; reserve 500 mA total. Codec and other 5 V loads connect later. R140/R141 set about 4.95 V; C141/C142 require effective-capacitance review at 5 V. EN low = true input/output disconnect. Sequence downstream loads after rail settles.

Sheet: /Logic_Audio_Power/
File: Logic_Audio_Power.kicad_sch
Title: Regulated 5 V logic and audio supply
