chithigun23/DesktopSpeaker/ai-files/reports/u14-supply/after.pdf

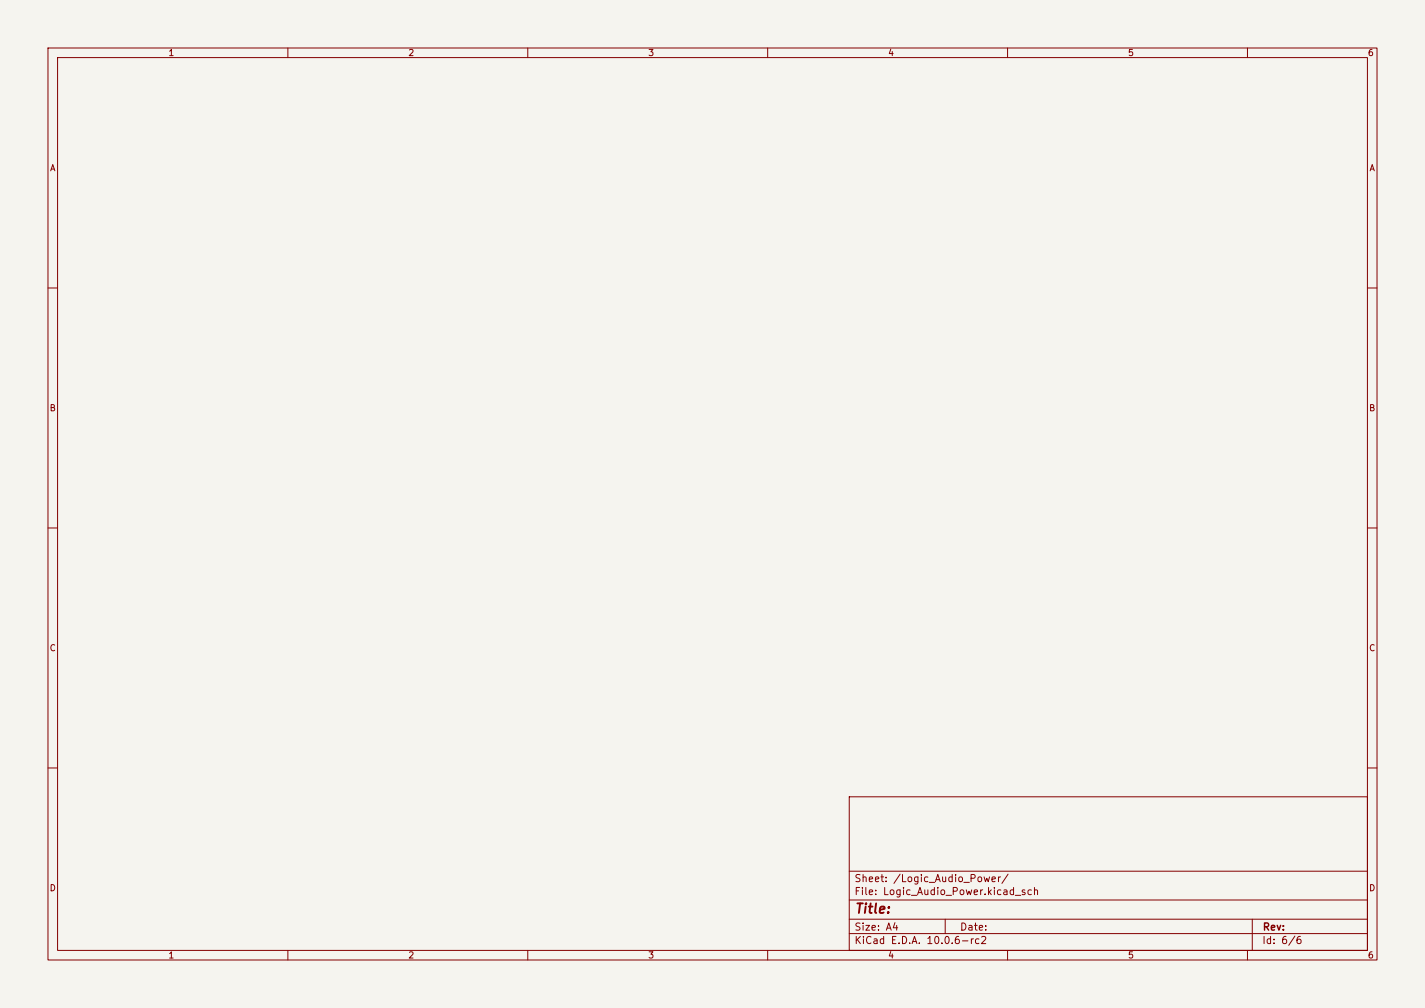
[picture p324: page 1]

Size: A4 | Rev:
KiCad E.D.A. 10.0.6-rc2 | Id: 6/6
