chithigun23/DesktopSpeaker/ai-files/reports/u14-supply/logic.pdf

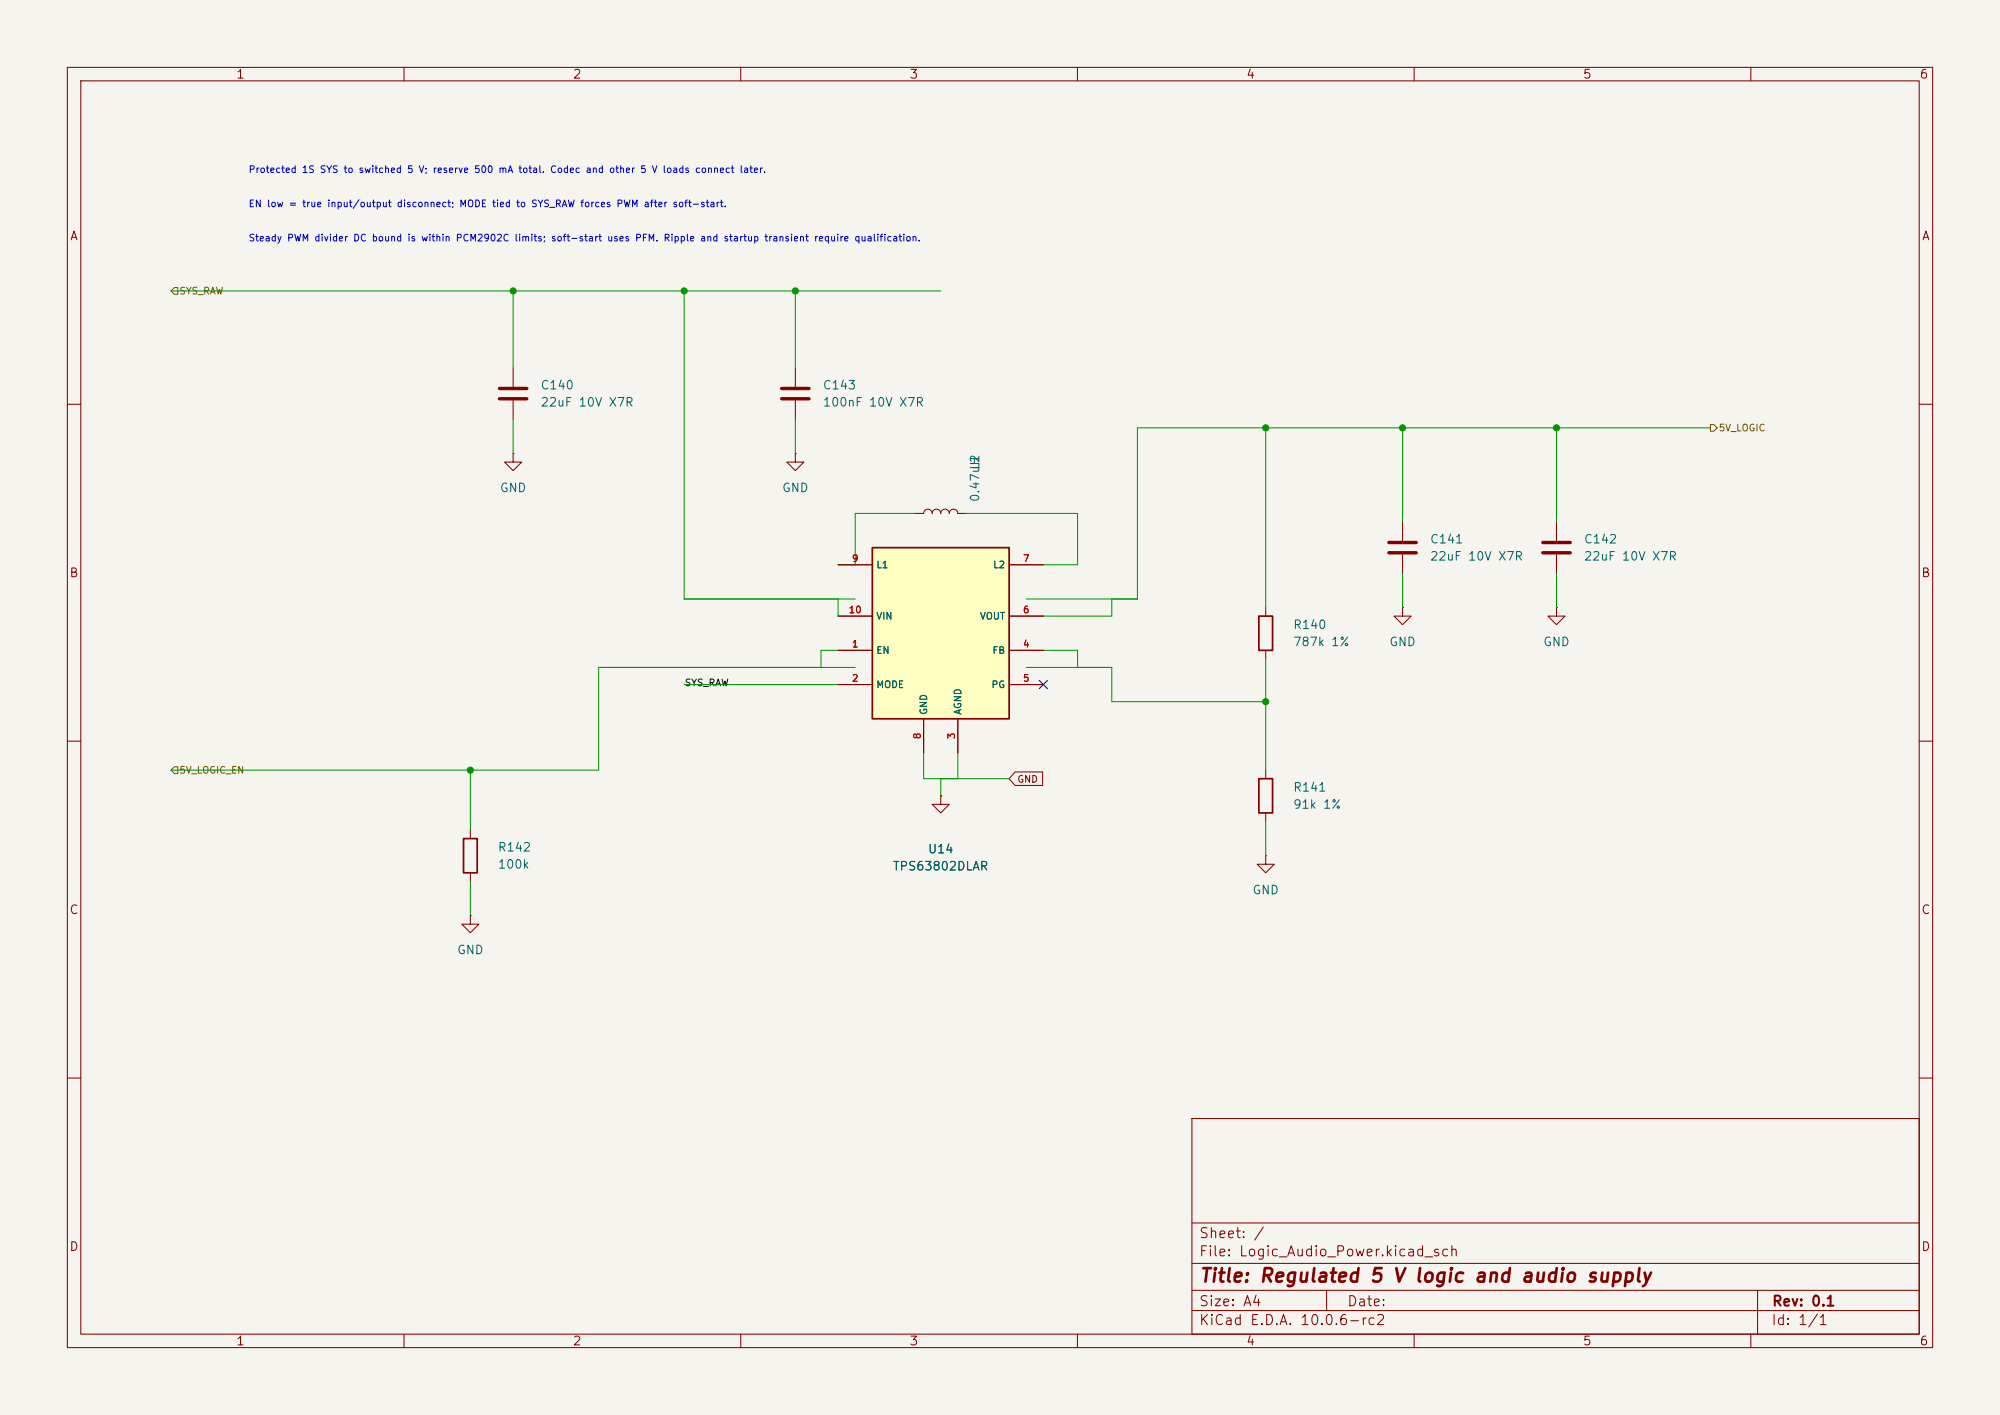
[picture p325: page 1]

Sheet: /
File: Logic_Audio_Power.kicad_sch
Title: Regulated 5 V logic and audio supply

Size: A4 | Rev: 0.1
KiCad E.D.A. 10.0.6-rc2 | Id: 1/1
