chithigun23/DesktopSpeaker/ai-files/reports/u14-supply/root.pdf

USB PD, charger and gauge draft; MCU/audio pending

Size: A3 | Rev: 0.1 | F Date:
KiCad E.D.A. 10.0.6-rc2 | Id: 1/6

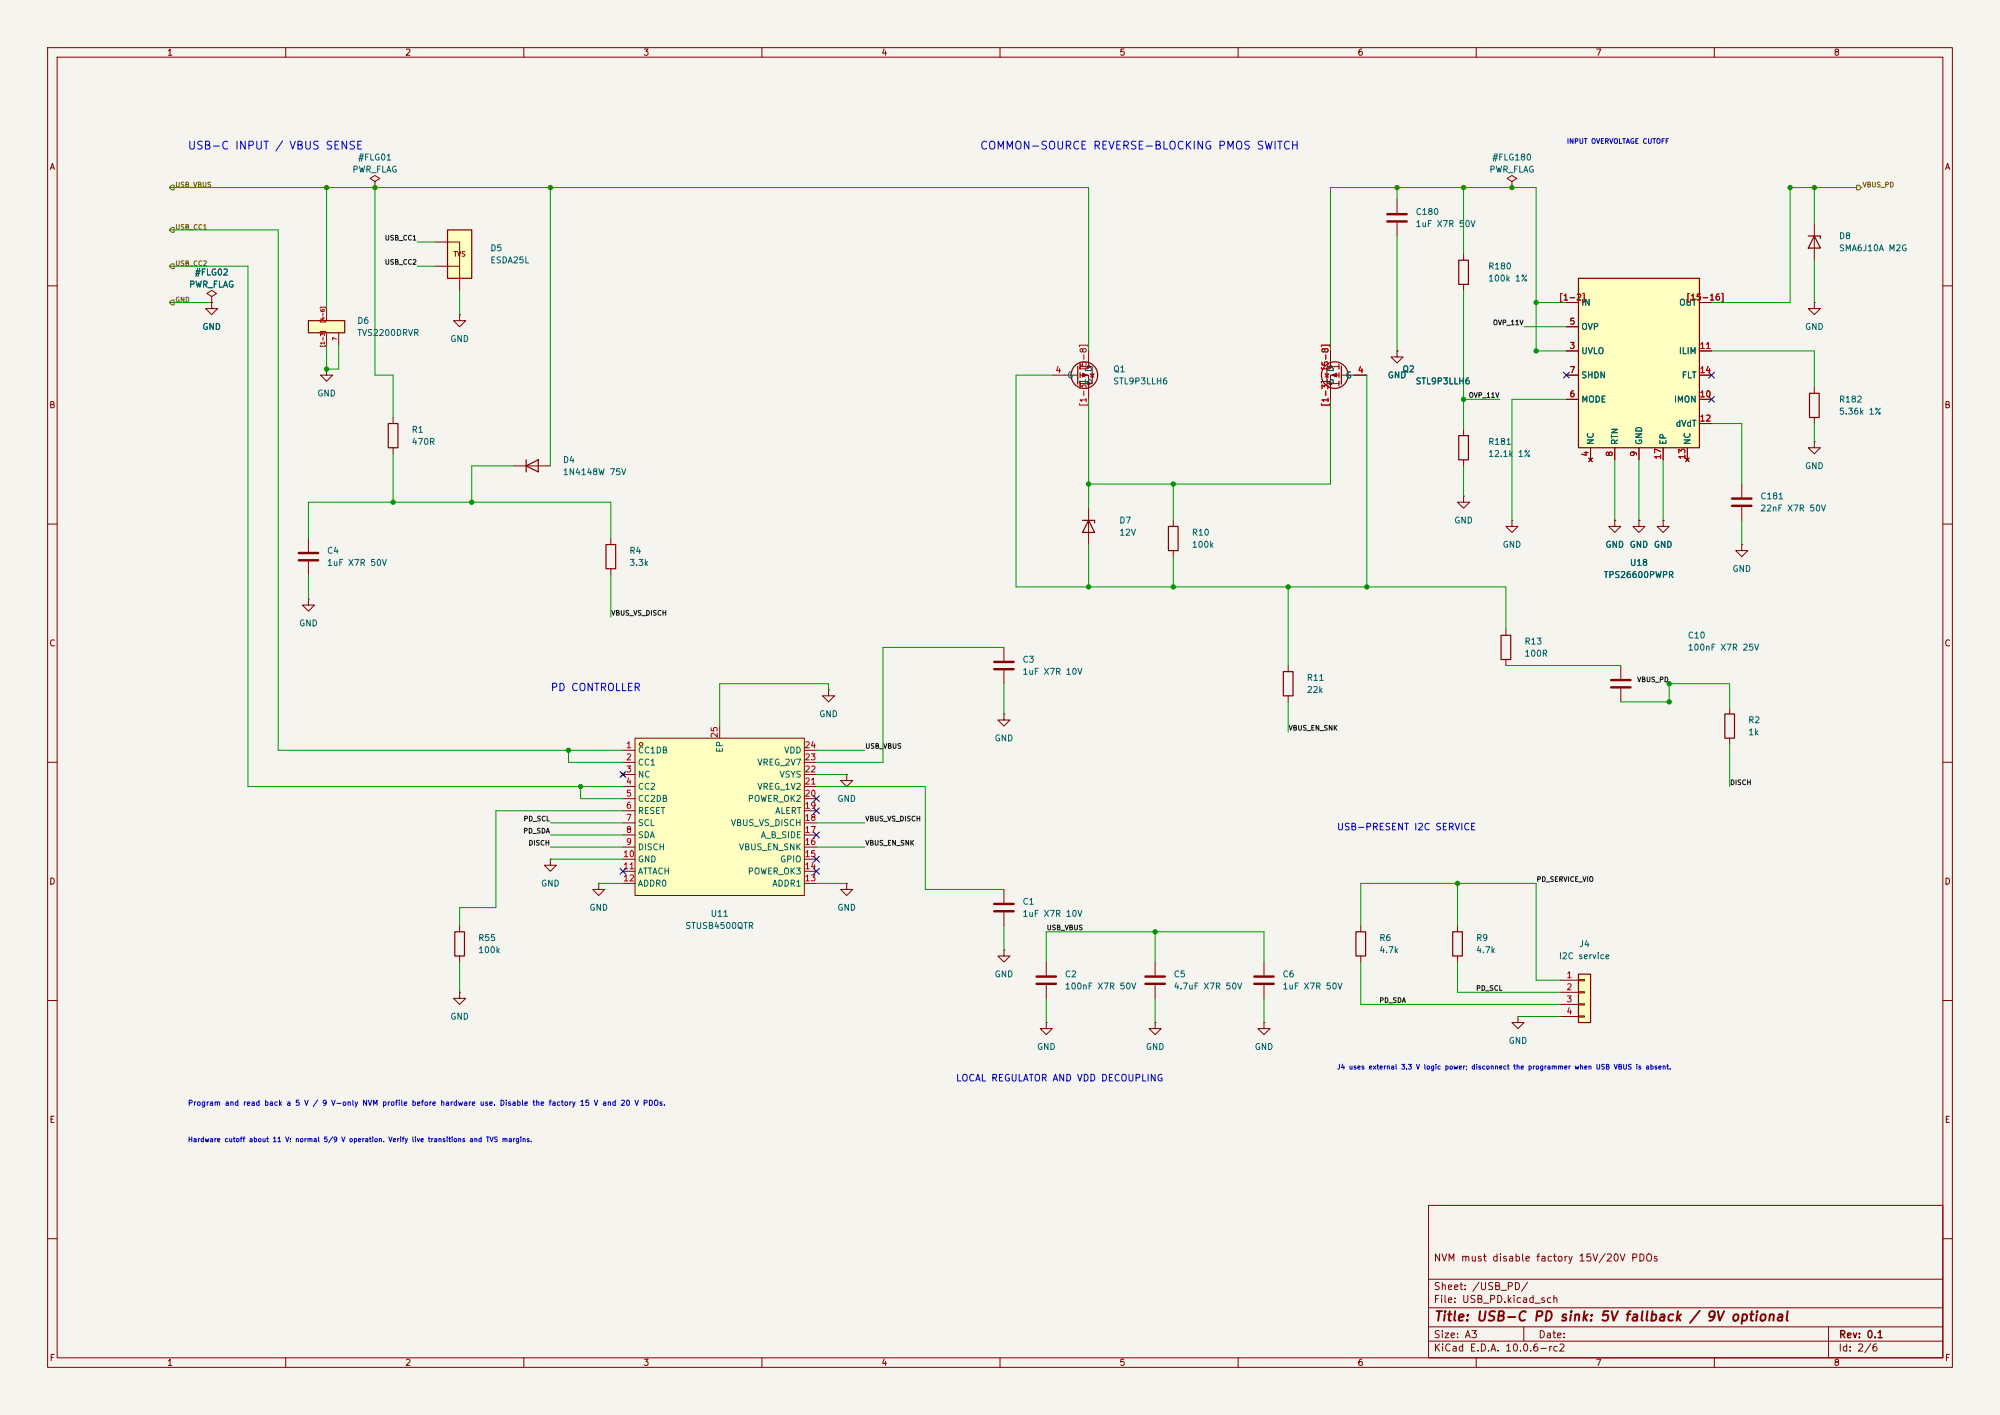
[picture p326: page 2]

USB-C INPUT / VBUS SENSE
USB_VBUS USB_CC1 USB_CC2 GND

COMMON-SOURCE REVERSE-BLOCKING PMOS SWITCH

LOCAL REGULATOR AND VDD DECOUPLING

Program and read back a 5 V / 9 V-only NVM profile before hardware use. Disable the factory 15 V and 20 V PDOs.

NVM must disable factory 15V/20V PDOs

Sheet: /USB_PD/
File: USB_PD.kicad_sch
Title: USB-C PD sink: 5V fallback / 9V optional

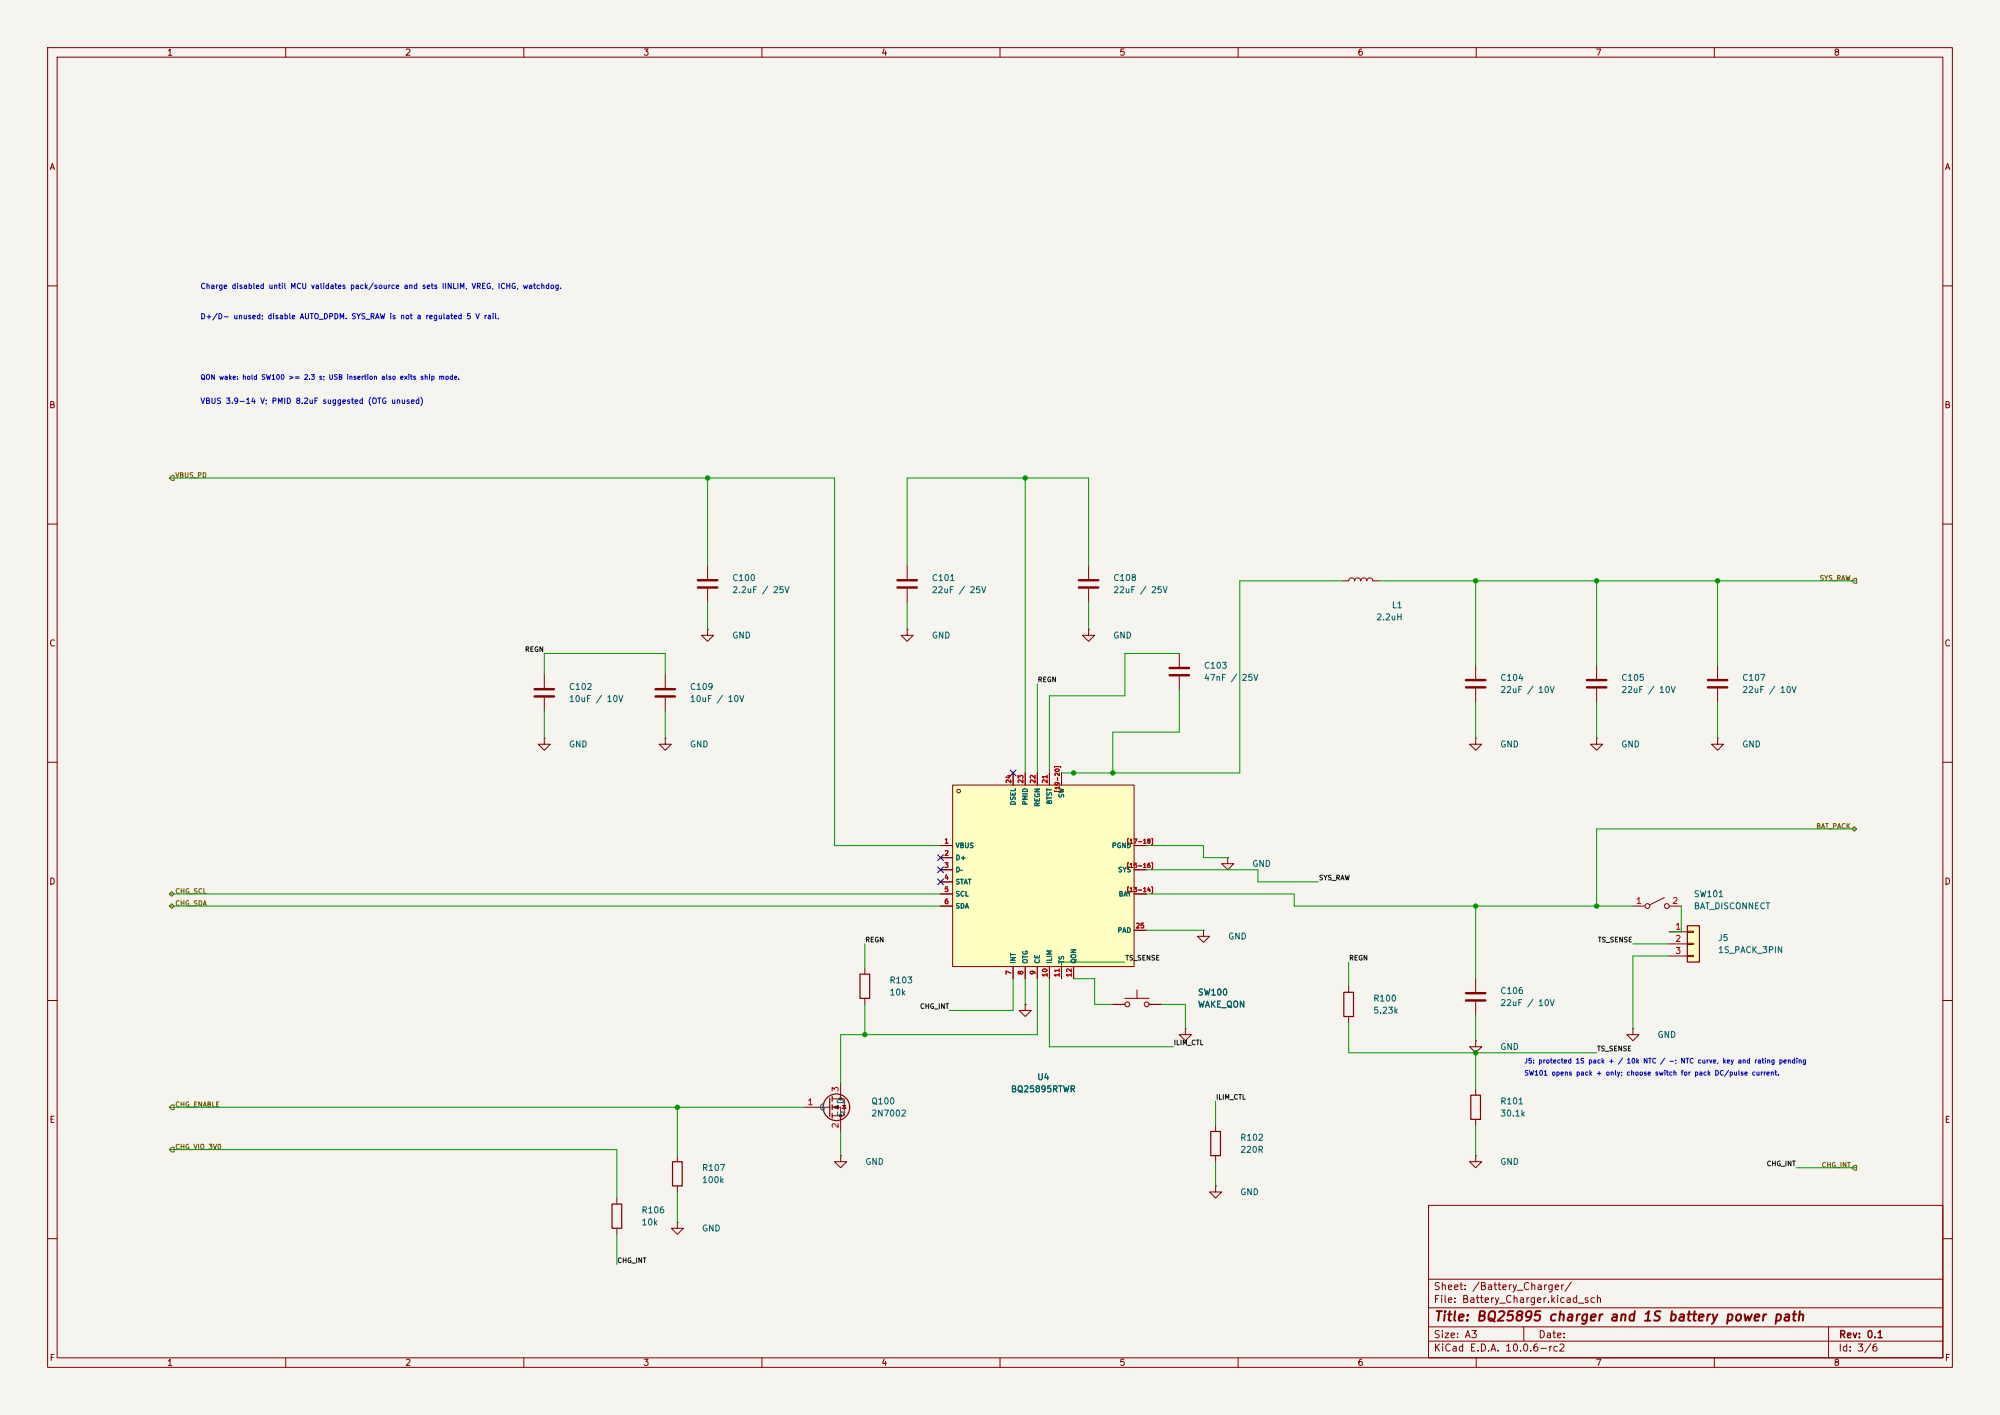
[picture p327: page 3]

Charge disabled until MCU validates pack/source and sets IINLIM, VREG, ICHG, watchdog. D+/D- unused; disable AUTO_DPDM. SYS_RAW is not a regulated 5 V rail. QON wake: hold SW100 >= 2.3 s; USB insertion also exits ship mode. VBUS 3.9-14 V; PMID 8.2uF suggested (OTG unused)

8 CE 9 ILIM 10 TS 11 QON 12 BTST 21 REGN 22 PMID 23 DSEL 24 PAD 25 BAT[13-14] SYS[15-16] PGND[17-18] SW[19-20] U4 BQ25895RTWR

8 CE 9 ILIM 10 TS 11 QON 12 BTST 21 REGN 22 PMID 23 DSEL 24 PAD 25 BAT[13-14] SYS[15-16] PGND[17-18] SW[19-20] SW100 WAKE_QON

J5: protected 1S pack + / 10k NTC / -; NTC curve, key and rating pending SW101 opens pack + only; choose switch for pack DC/pulse current. U4 BQ25895RTWR

Sheet: /Battery_Charger/
File: Battery_Charger.kicad_sch
Title: BQ25895 charger and 1S battery power path

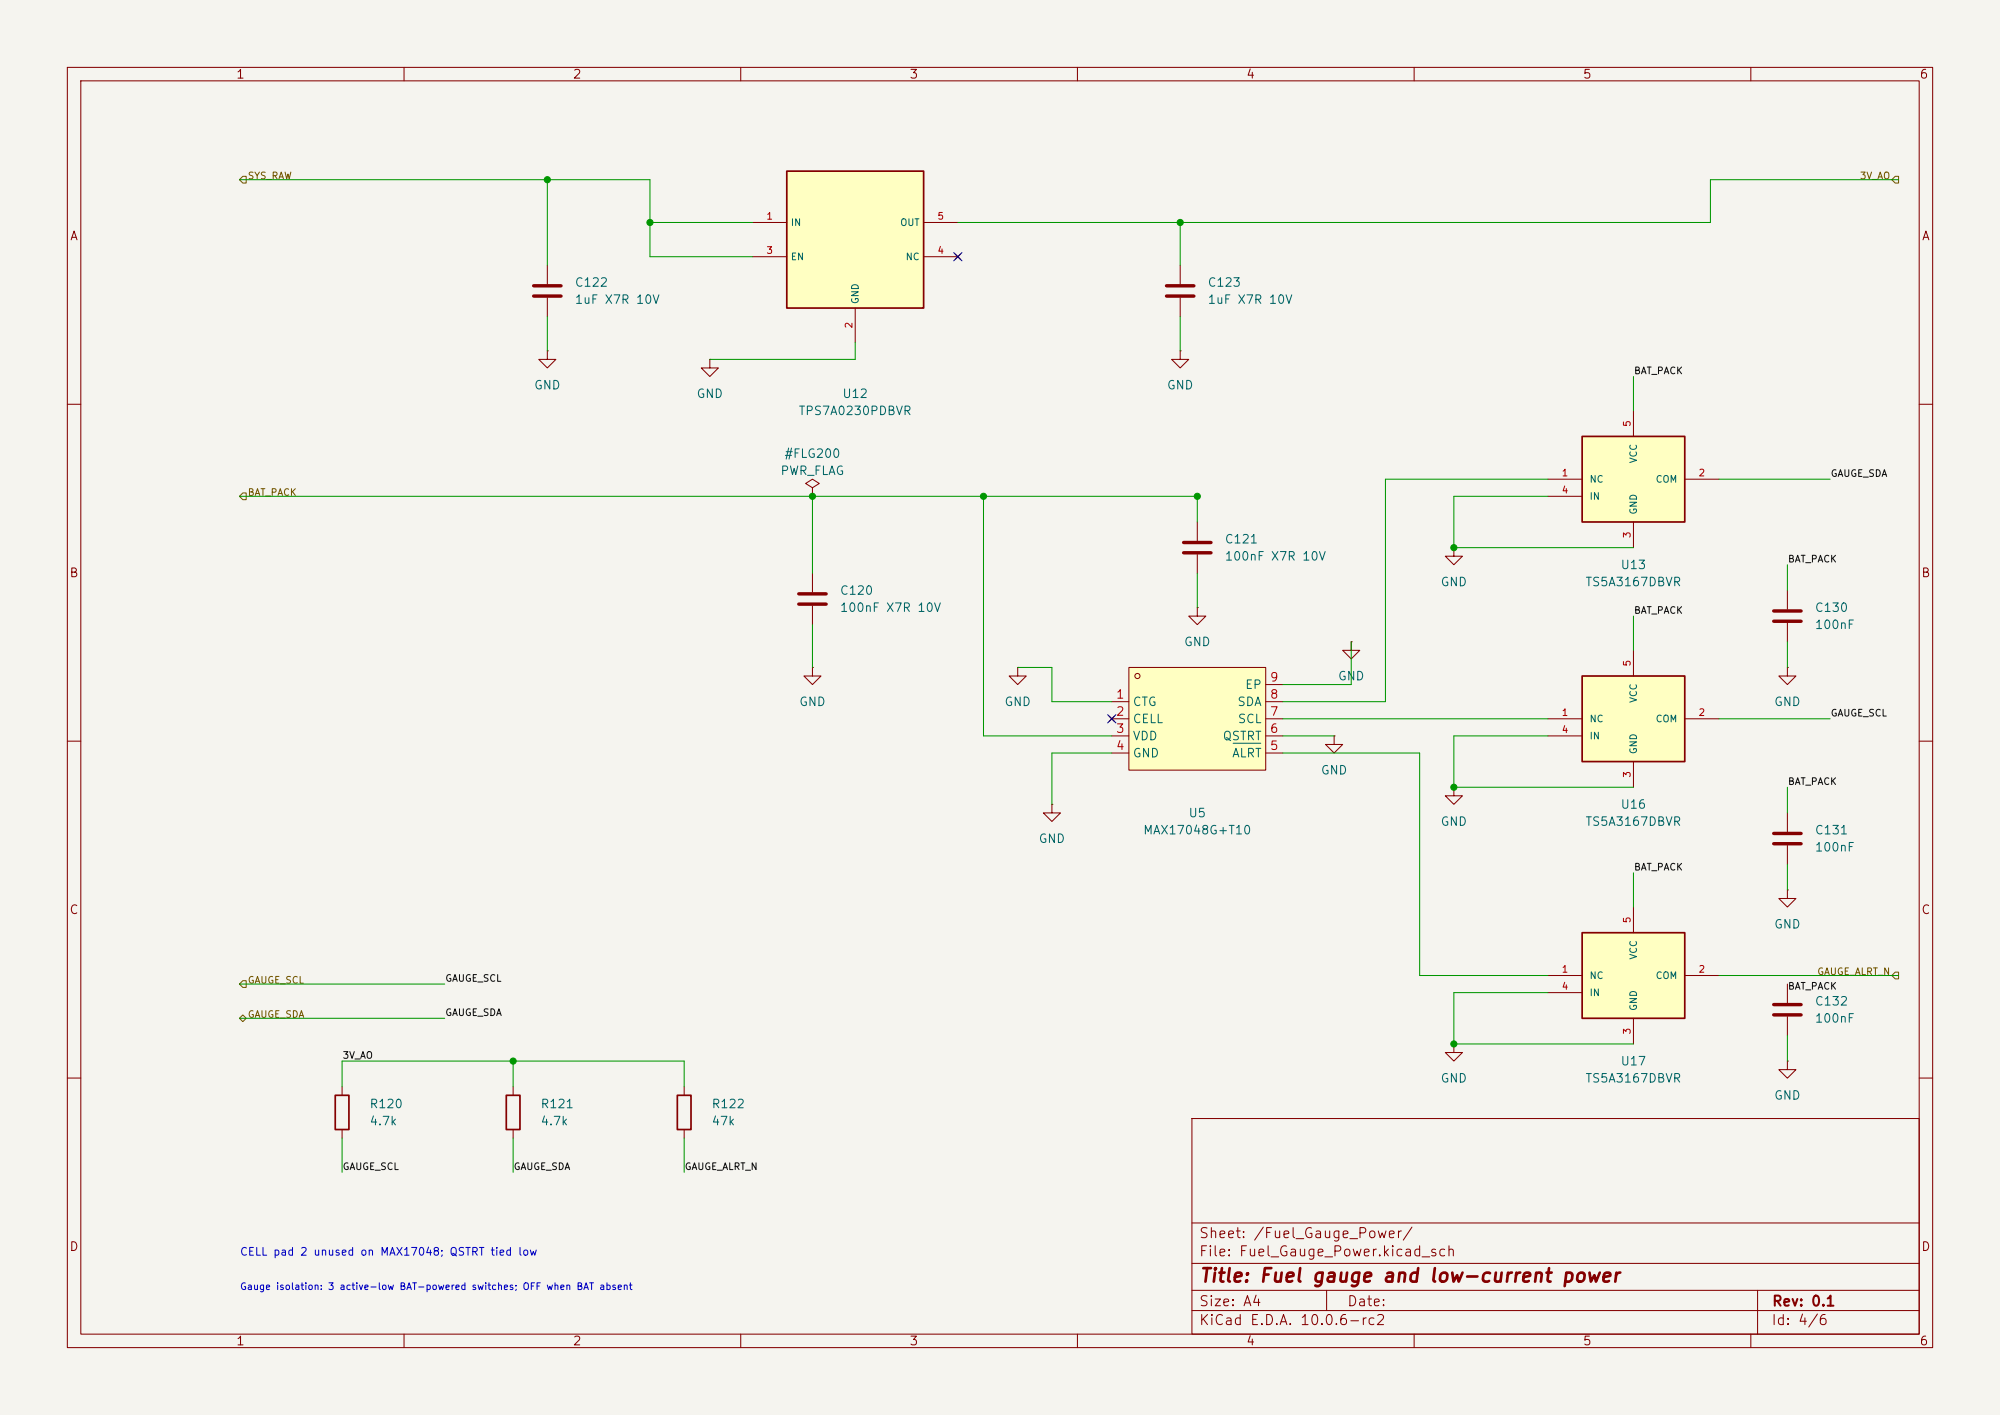
[picture p328: page 4]

BAT_PACK CELL pad 2 unused on MAX17048; QSTRT tied low

Sheet: /Fuel_Gauge_Power/
File: Fuel_Gauge_Power.kicad_sch
Title: Fuel gauge and low-current power

Gauge isolation: 3 active-low BAT-powered switches; OFF when BAT absent


Sheet: /Bluetooth_Power/
File: Bluetooth_Power.kicad_sch
Title: Switched 3.8 V Bluetooth supply

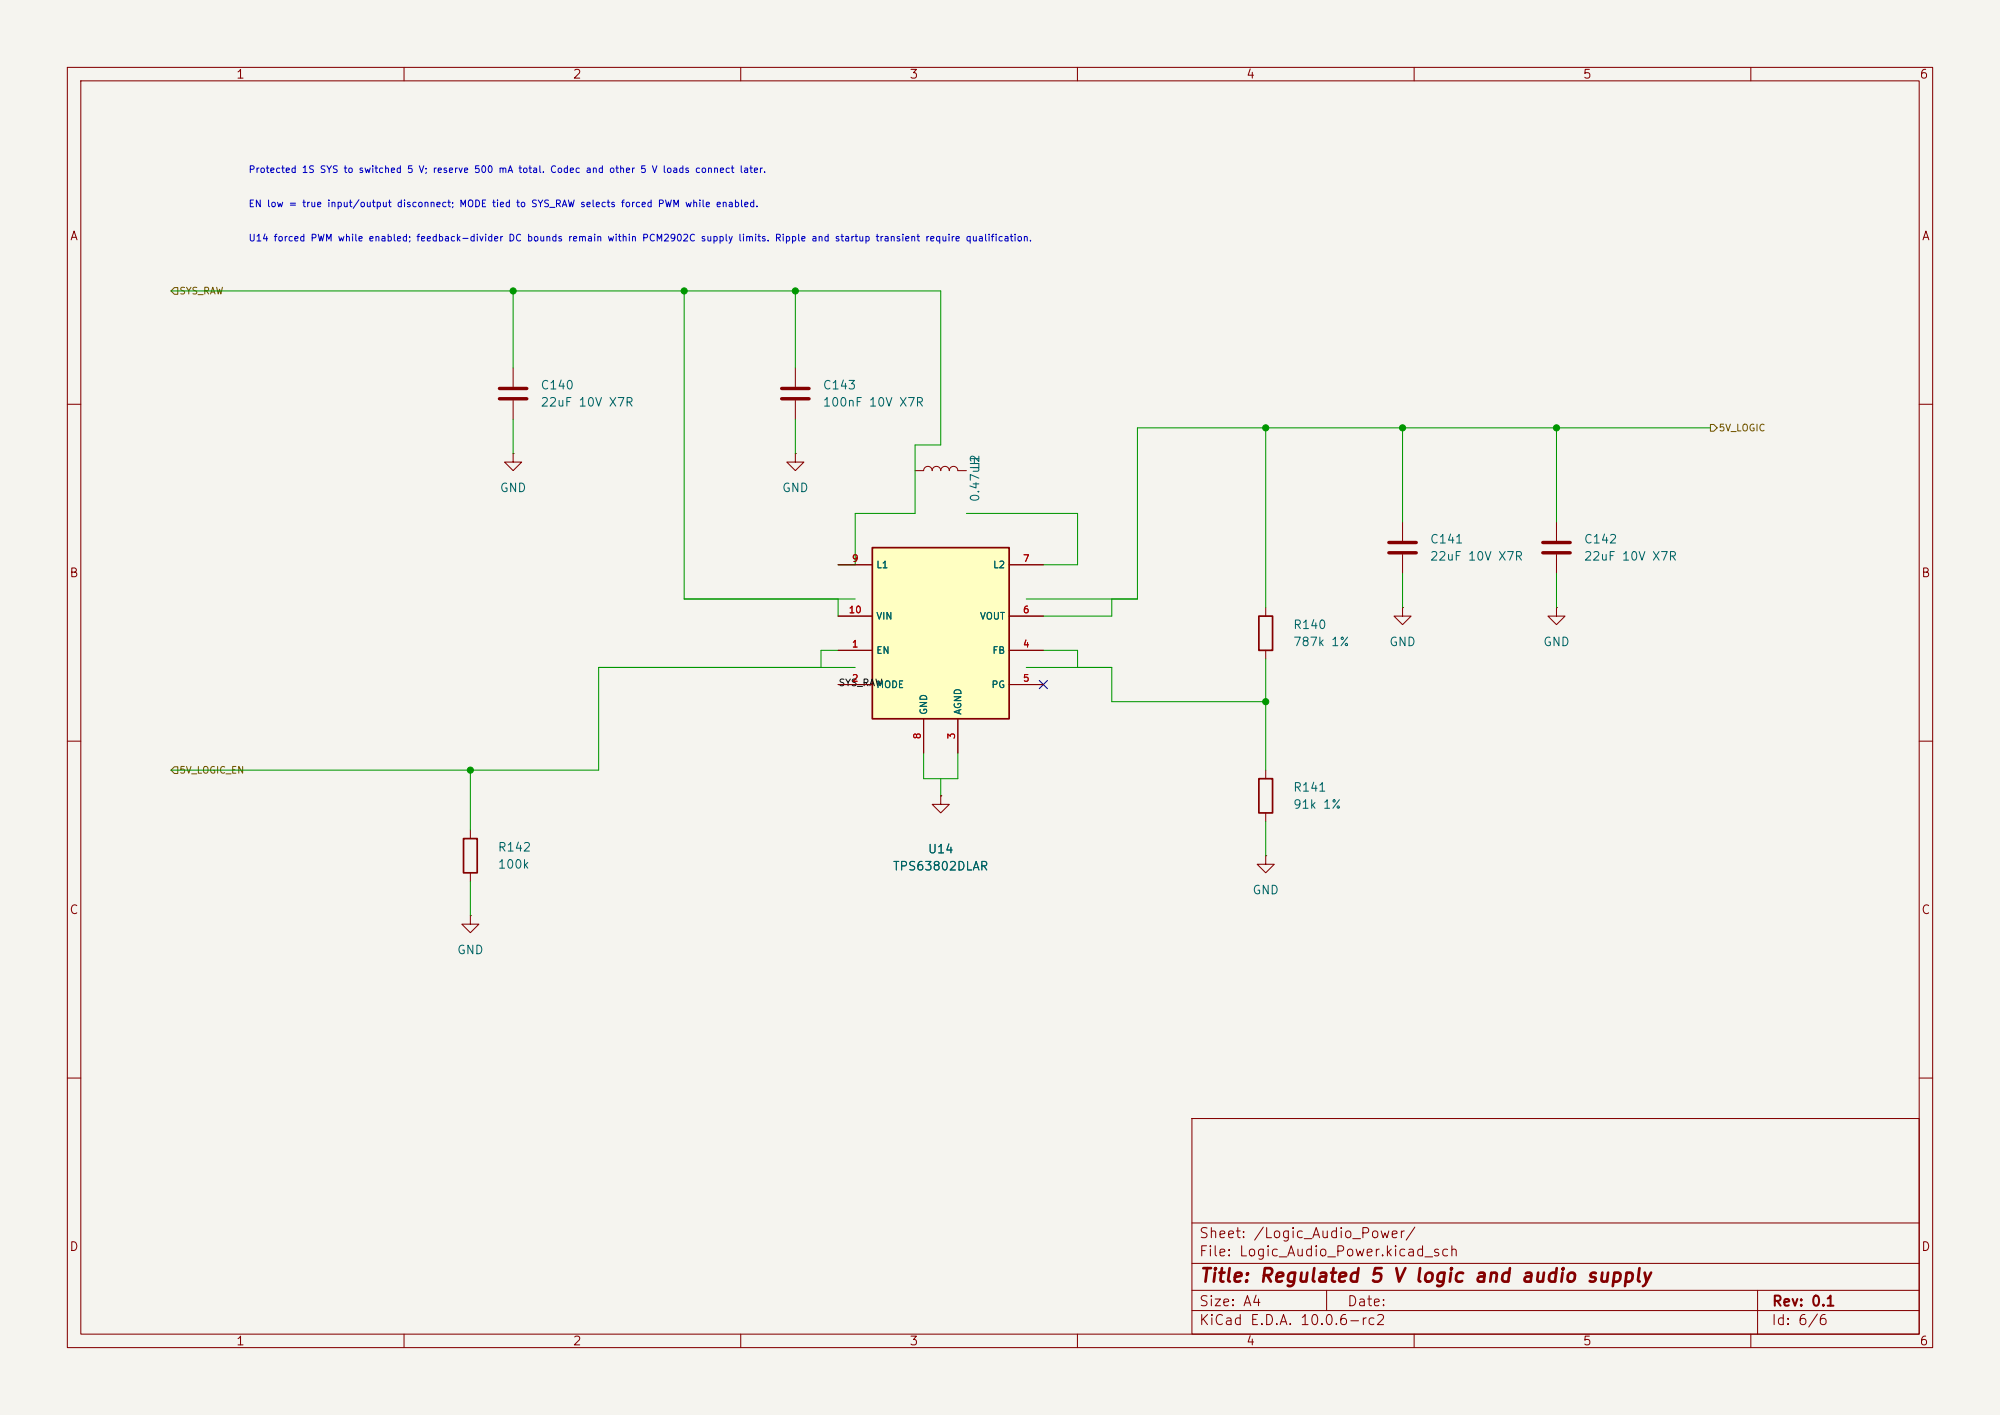
[picture p329: page 6]

Protected 1S SYS to switched 5 V; reserve 500 mA total. Codec and other 5 V loads connect later. EN low = true input/output disconnect; MODE tied to SYS_RAW selects forced PWM while enabled. U14 forced PWM while enabled; feedback-divider DC bounds remain within PCM2902C supply limits. Ripple and startup transient require qualification. U14

Sheet: /Logic_Audio_Power/
File: Logic_Audio_Power.kicad_sch
Title: Regulated 5 V logic and audio supply
