chithigun23/DesktopSpeaker/ai-files/DesktopSpeaker-preview.pdf

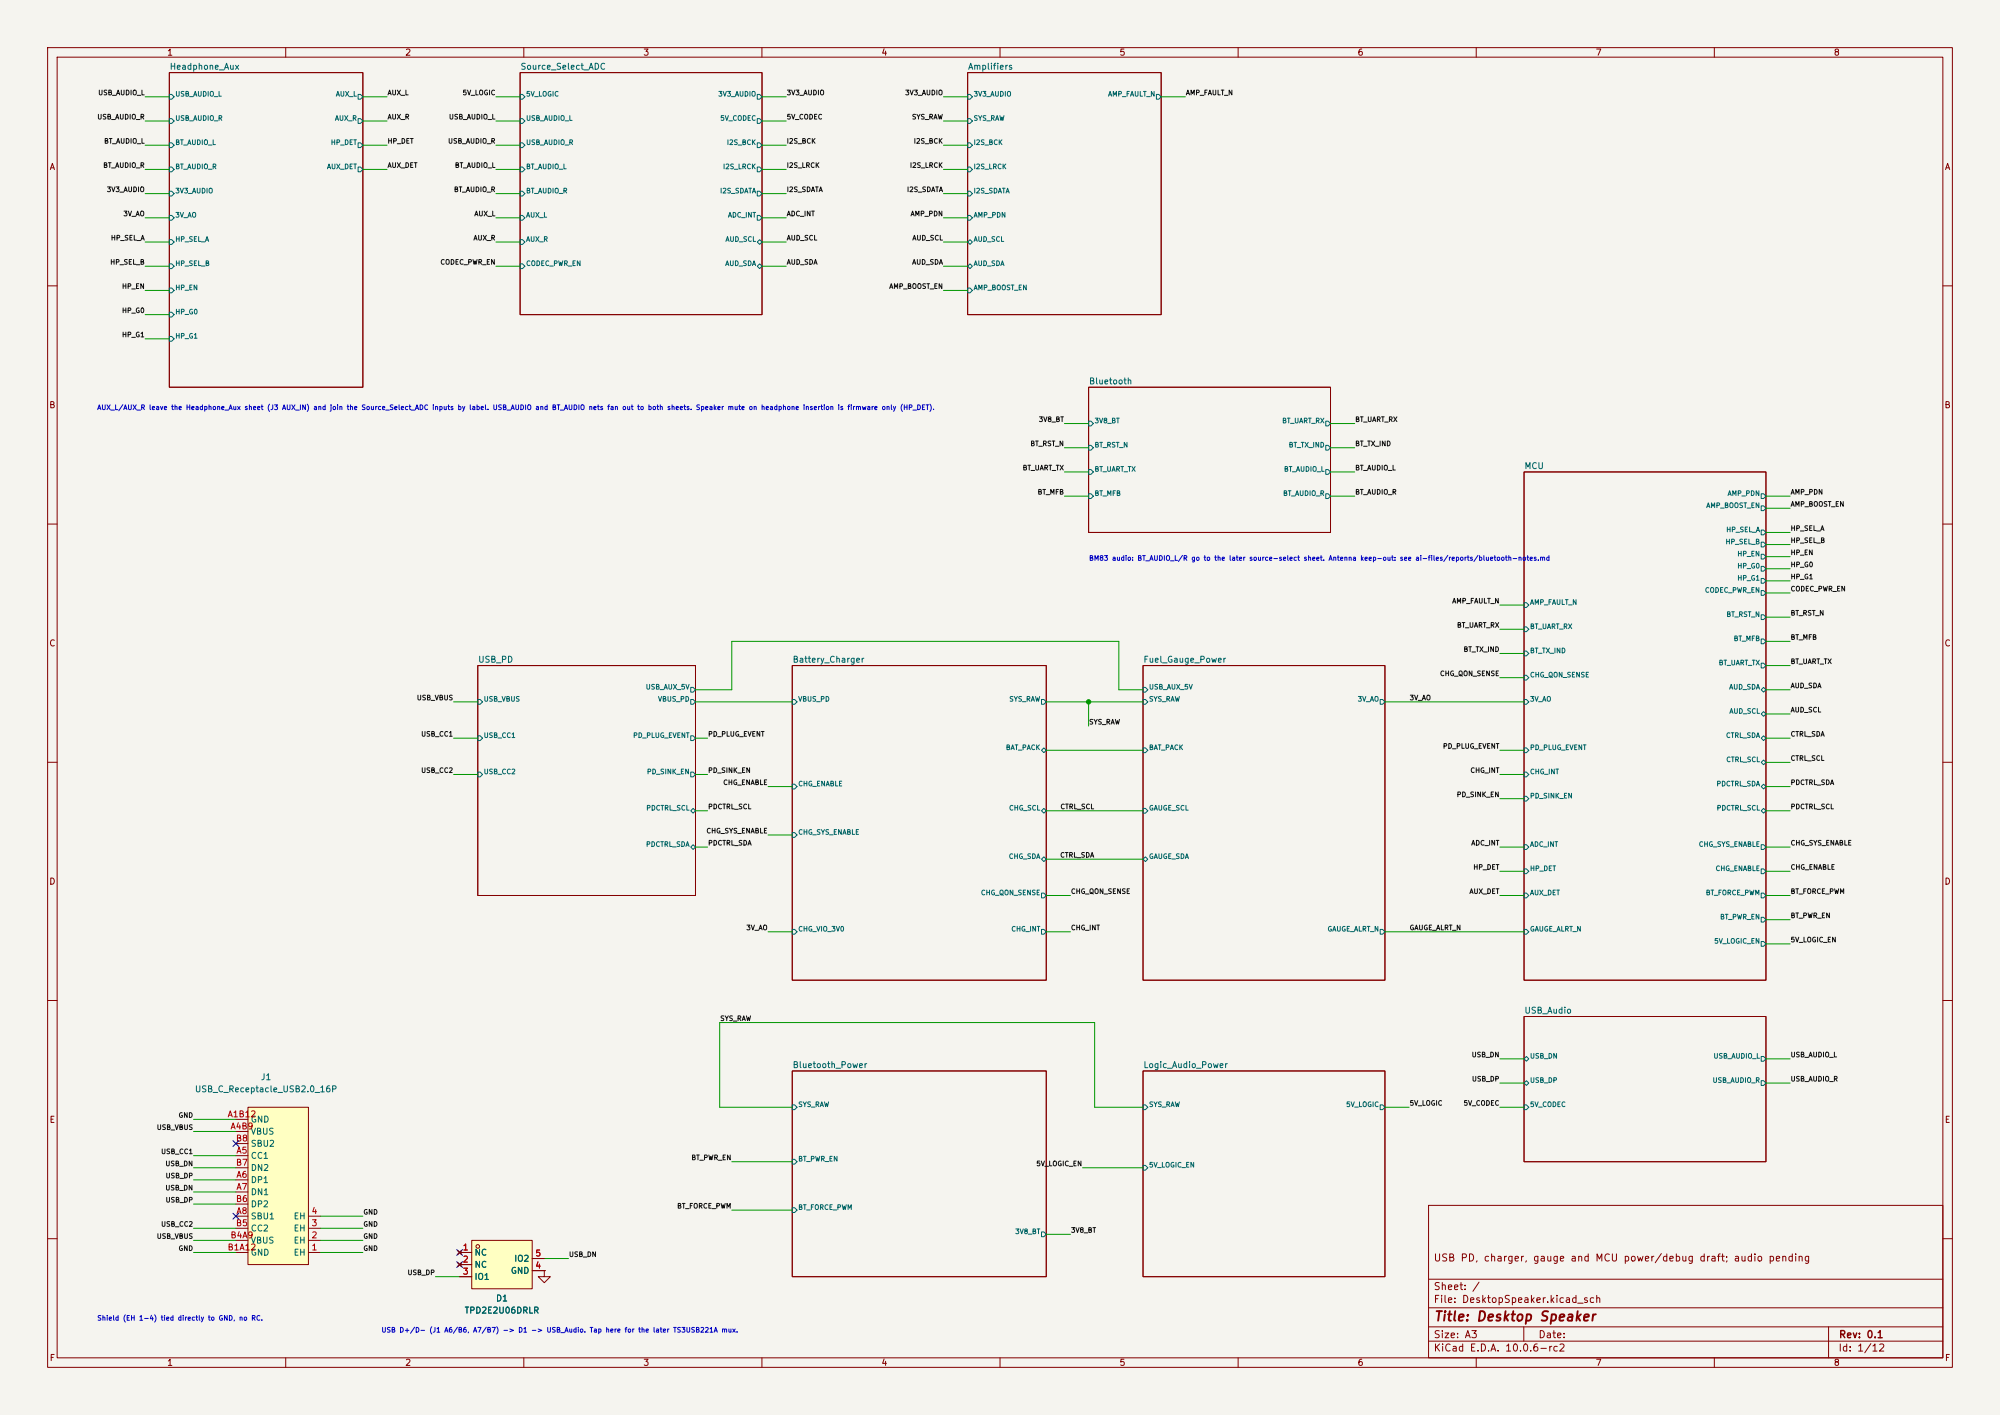
[picture p342: page 1]

AUX_L/AUX_R leave the Headphone_Aux sheet (J3 AUX_IN) and join the Source_Select_ADC inputs by label. USB_AUDIO and BT_AUDIO nets fan out to both sheets. Speaker mute on headphone insertion is firmware only (HP_DET).

BM83 audio: BT_AUDIO_L/R go to the later source-select sheet. Antenna keep-out: see ai-files/reports/bluetooth-notes.md

USB PD, charger, gauge and MCU power/debug draft; audio pending

Size: A3 | Rev: 0.1 | F Date:
KiCad E.D.A. 10.0.6-rc2 | Id: 1/12

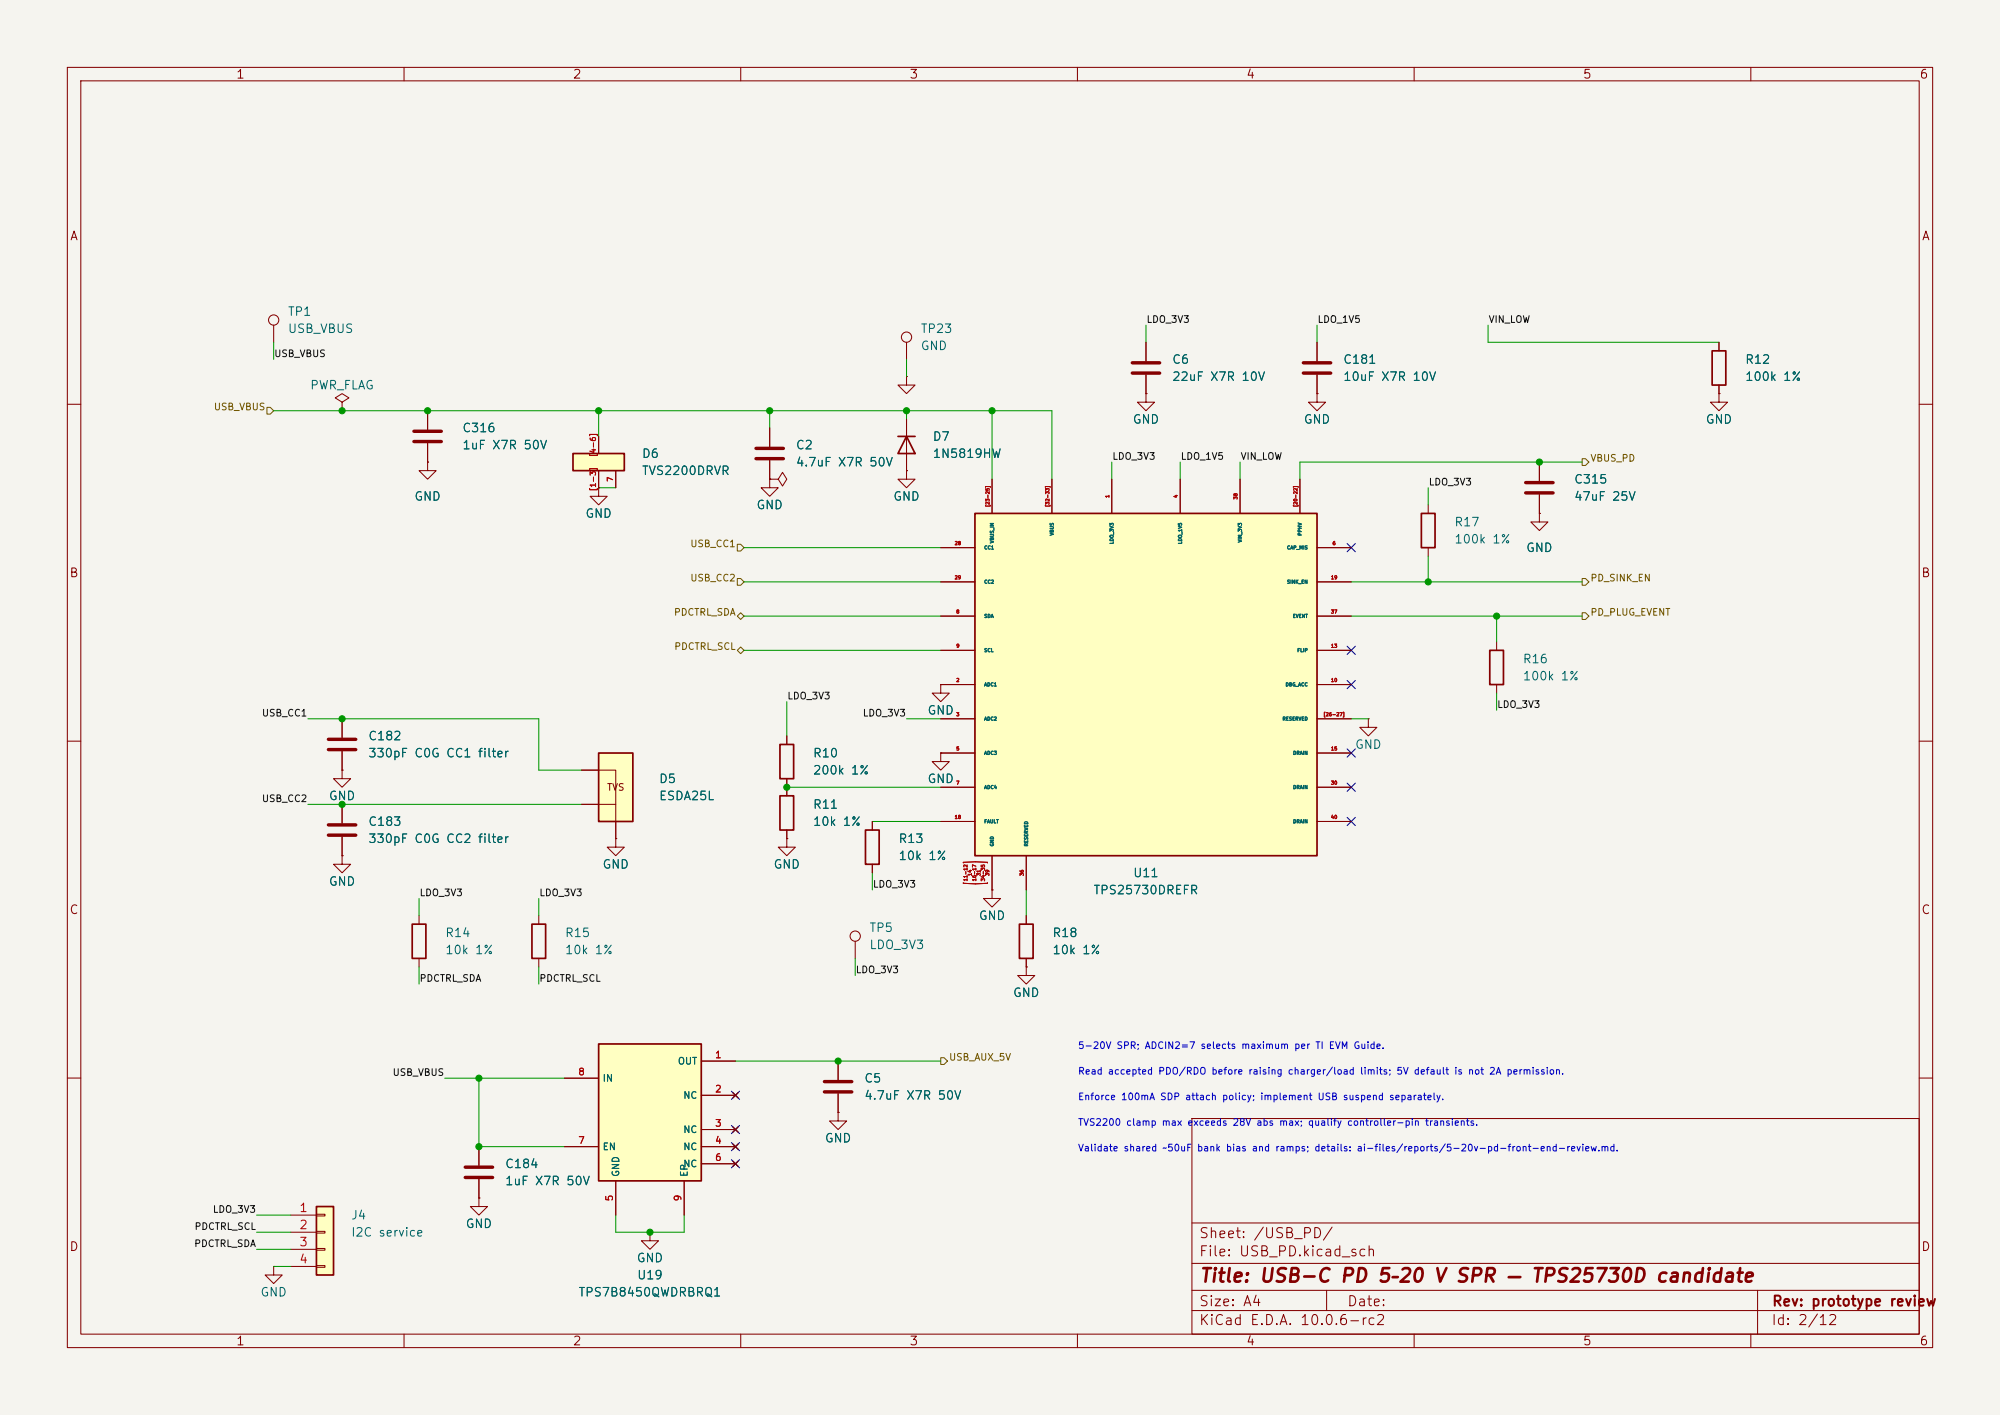
[picture p343: page 2]

Sheet: /USB_PD/
File: USB_PD.kicad_sch
Title: USB-C PD 5–20 V SPR — TPS25730D candidate

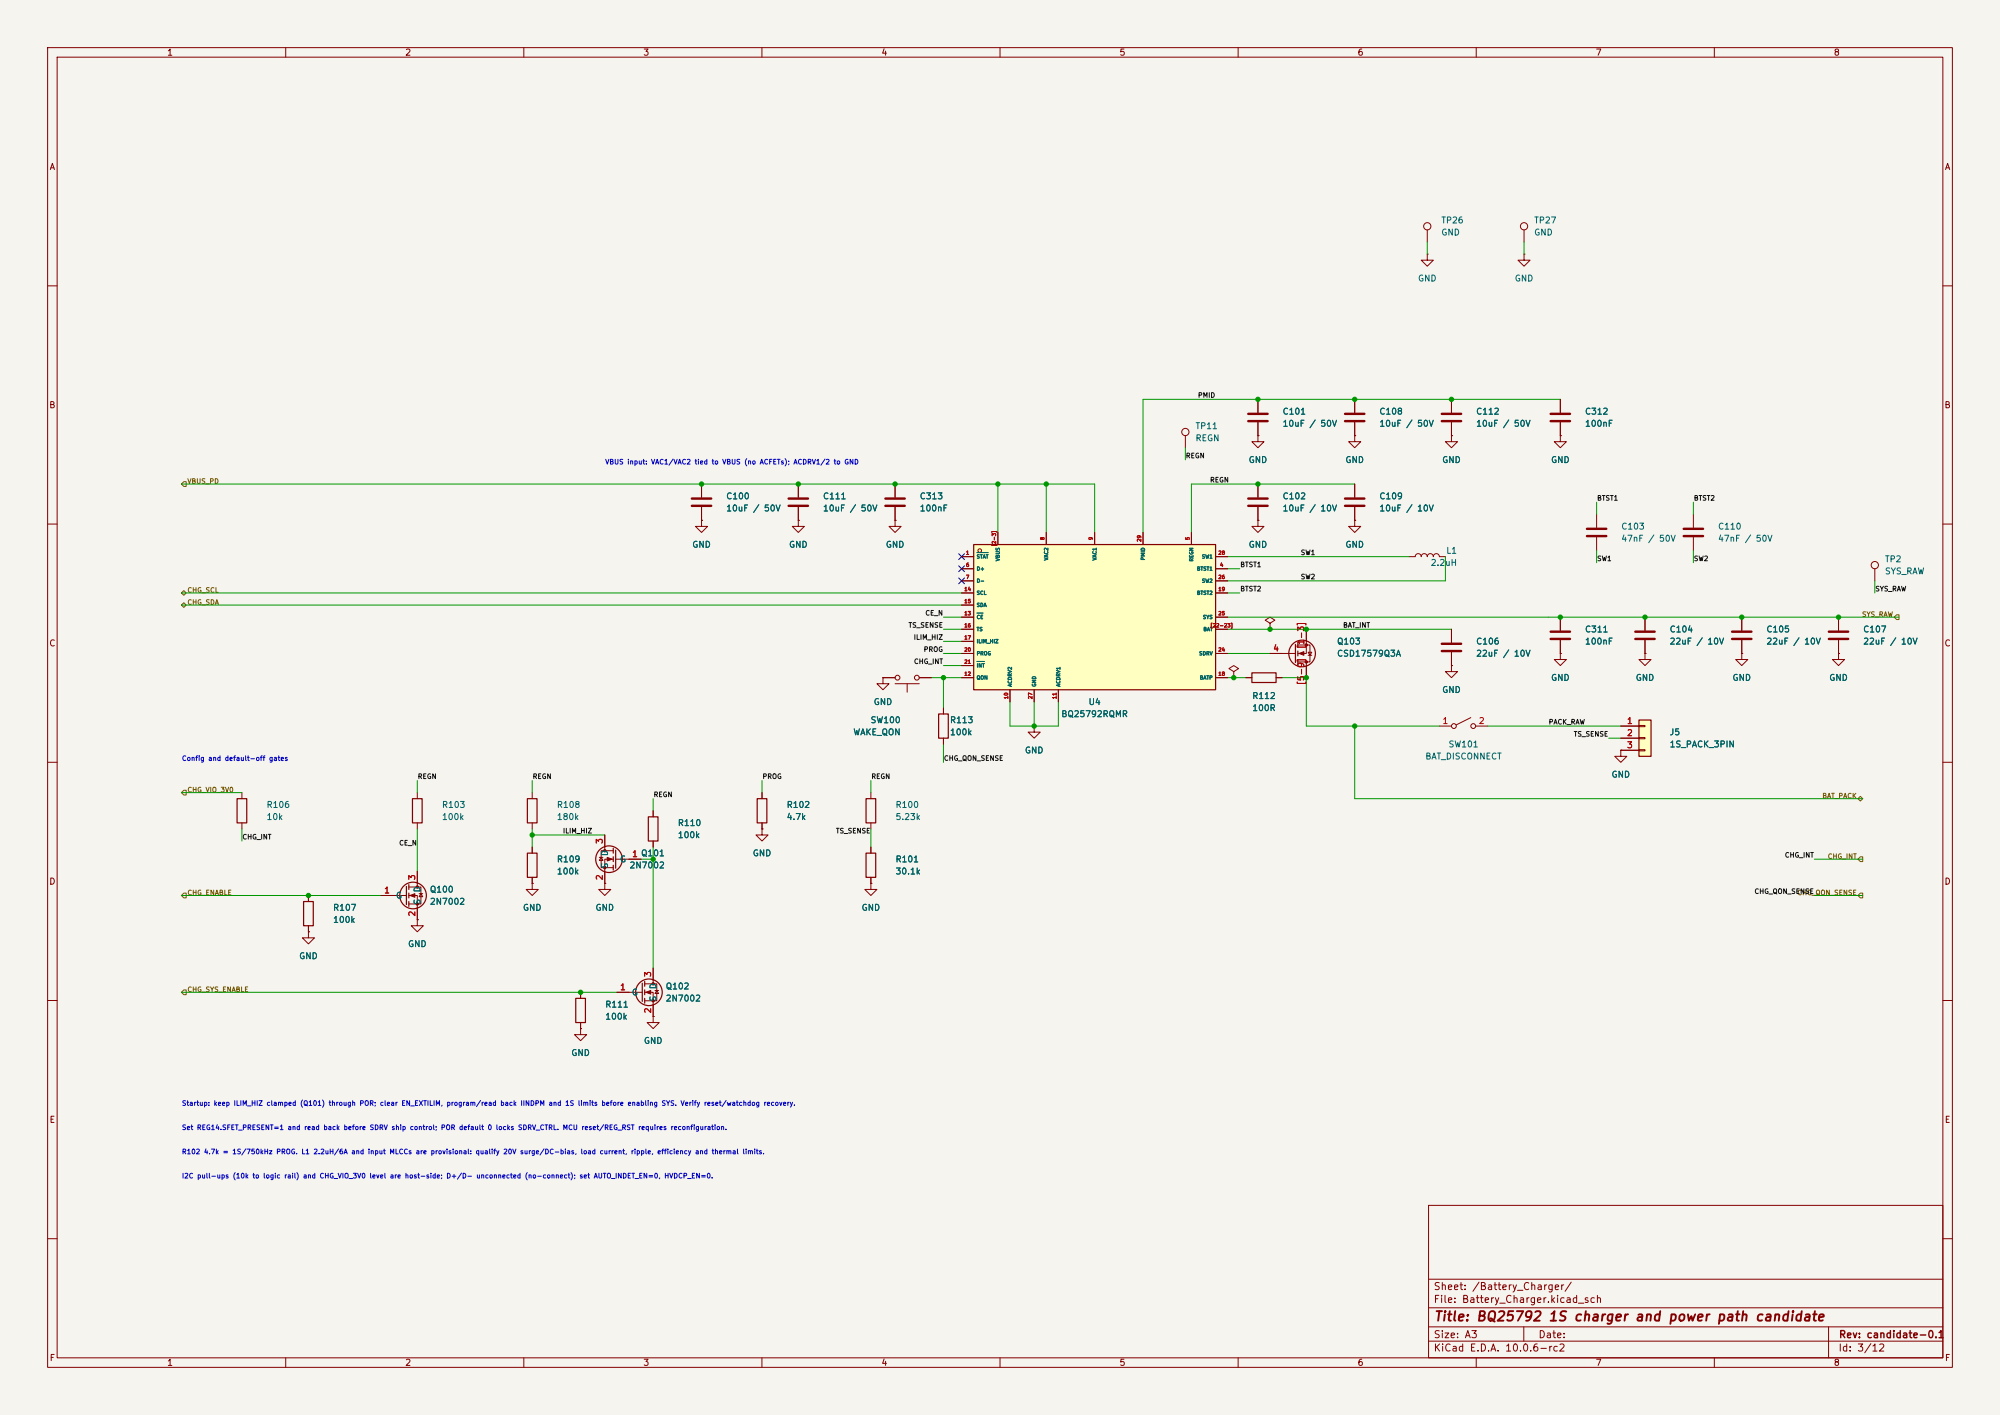
[picture p344: page 3]

VBUS input: VAC1/VAC2 tied to VBUS (no ACFETs); ACDRV1/2 to GND

Config and default-off gates

Startup: keep ILIM_HIZ clamped (Q101) through POR; clear EN_EXTILIM, program/read back IINDPM and 1S limits before enabling SYS. Verify reset/watchdog recovery.

I2C pull-ups (10k to logic rail) and CHG_VIO_3V0 level are host-side; D+/D- unconnected (no-connect); set AUTO_INDET_EN=0, HVDCP_EN=0. R102 4.7k = 1S/750kHz PROG. L1 2.2uH/6A and input MLCCs are provisional: qualify 20V surge/DC-bias, load current, ripple, efficiency and thermal limits. Set REG14.SFET_PRESENT=1 and read back before SDRV ship control; POR default 0 locks SDRV_CTRL. MCU reset/REG_RST requires reconfiguration.

Sheet: /Battery_Charger/
File: Battery_Charger.kicad_sch
Title: BQ25792 1S charger and power path candidate

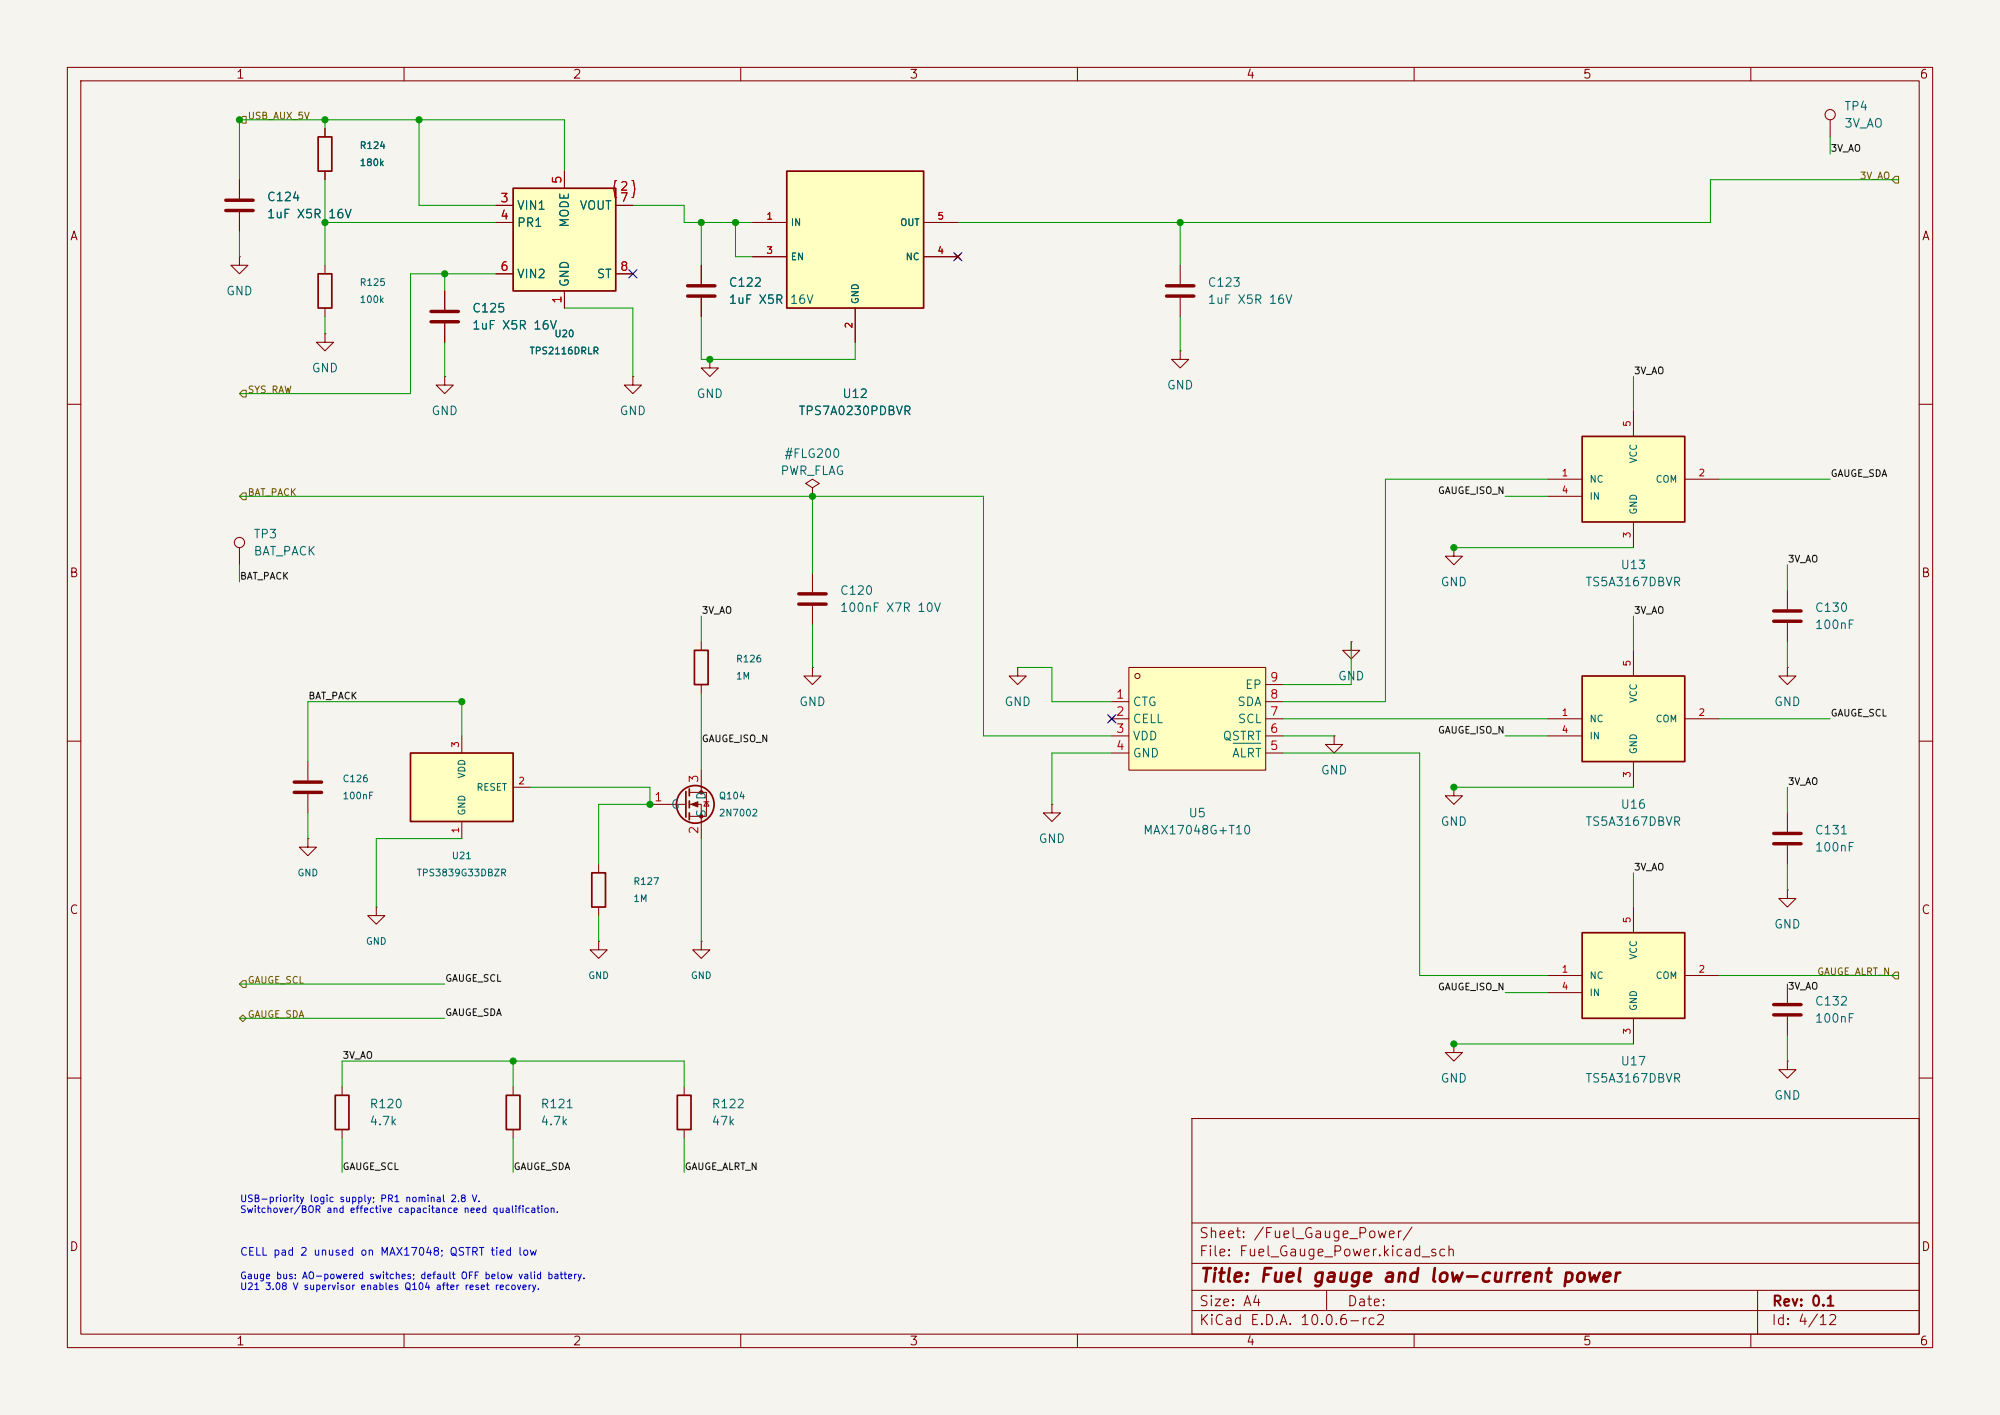
[picture p345: page 4]

USB-priority logic supply; PR1 nominal 2.8 V. Switchover/BOR and effective capacitance need qualification. Gauge bus: AO-powered switches; default OFF below valid battery. U21 3.08 V supervisor enables Q104 after reset recovery. CELL pad 2 unused on MAX17048; QSTRT tied low

Sheet: /Fuel_Gauge_Power/
File: Fuel_Gauge_Power.kicad_sch
Title: Fuel gauge and low-current power

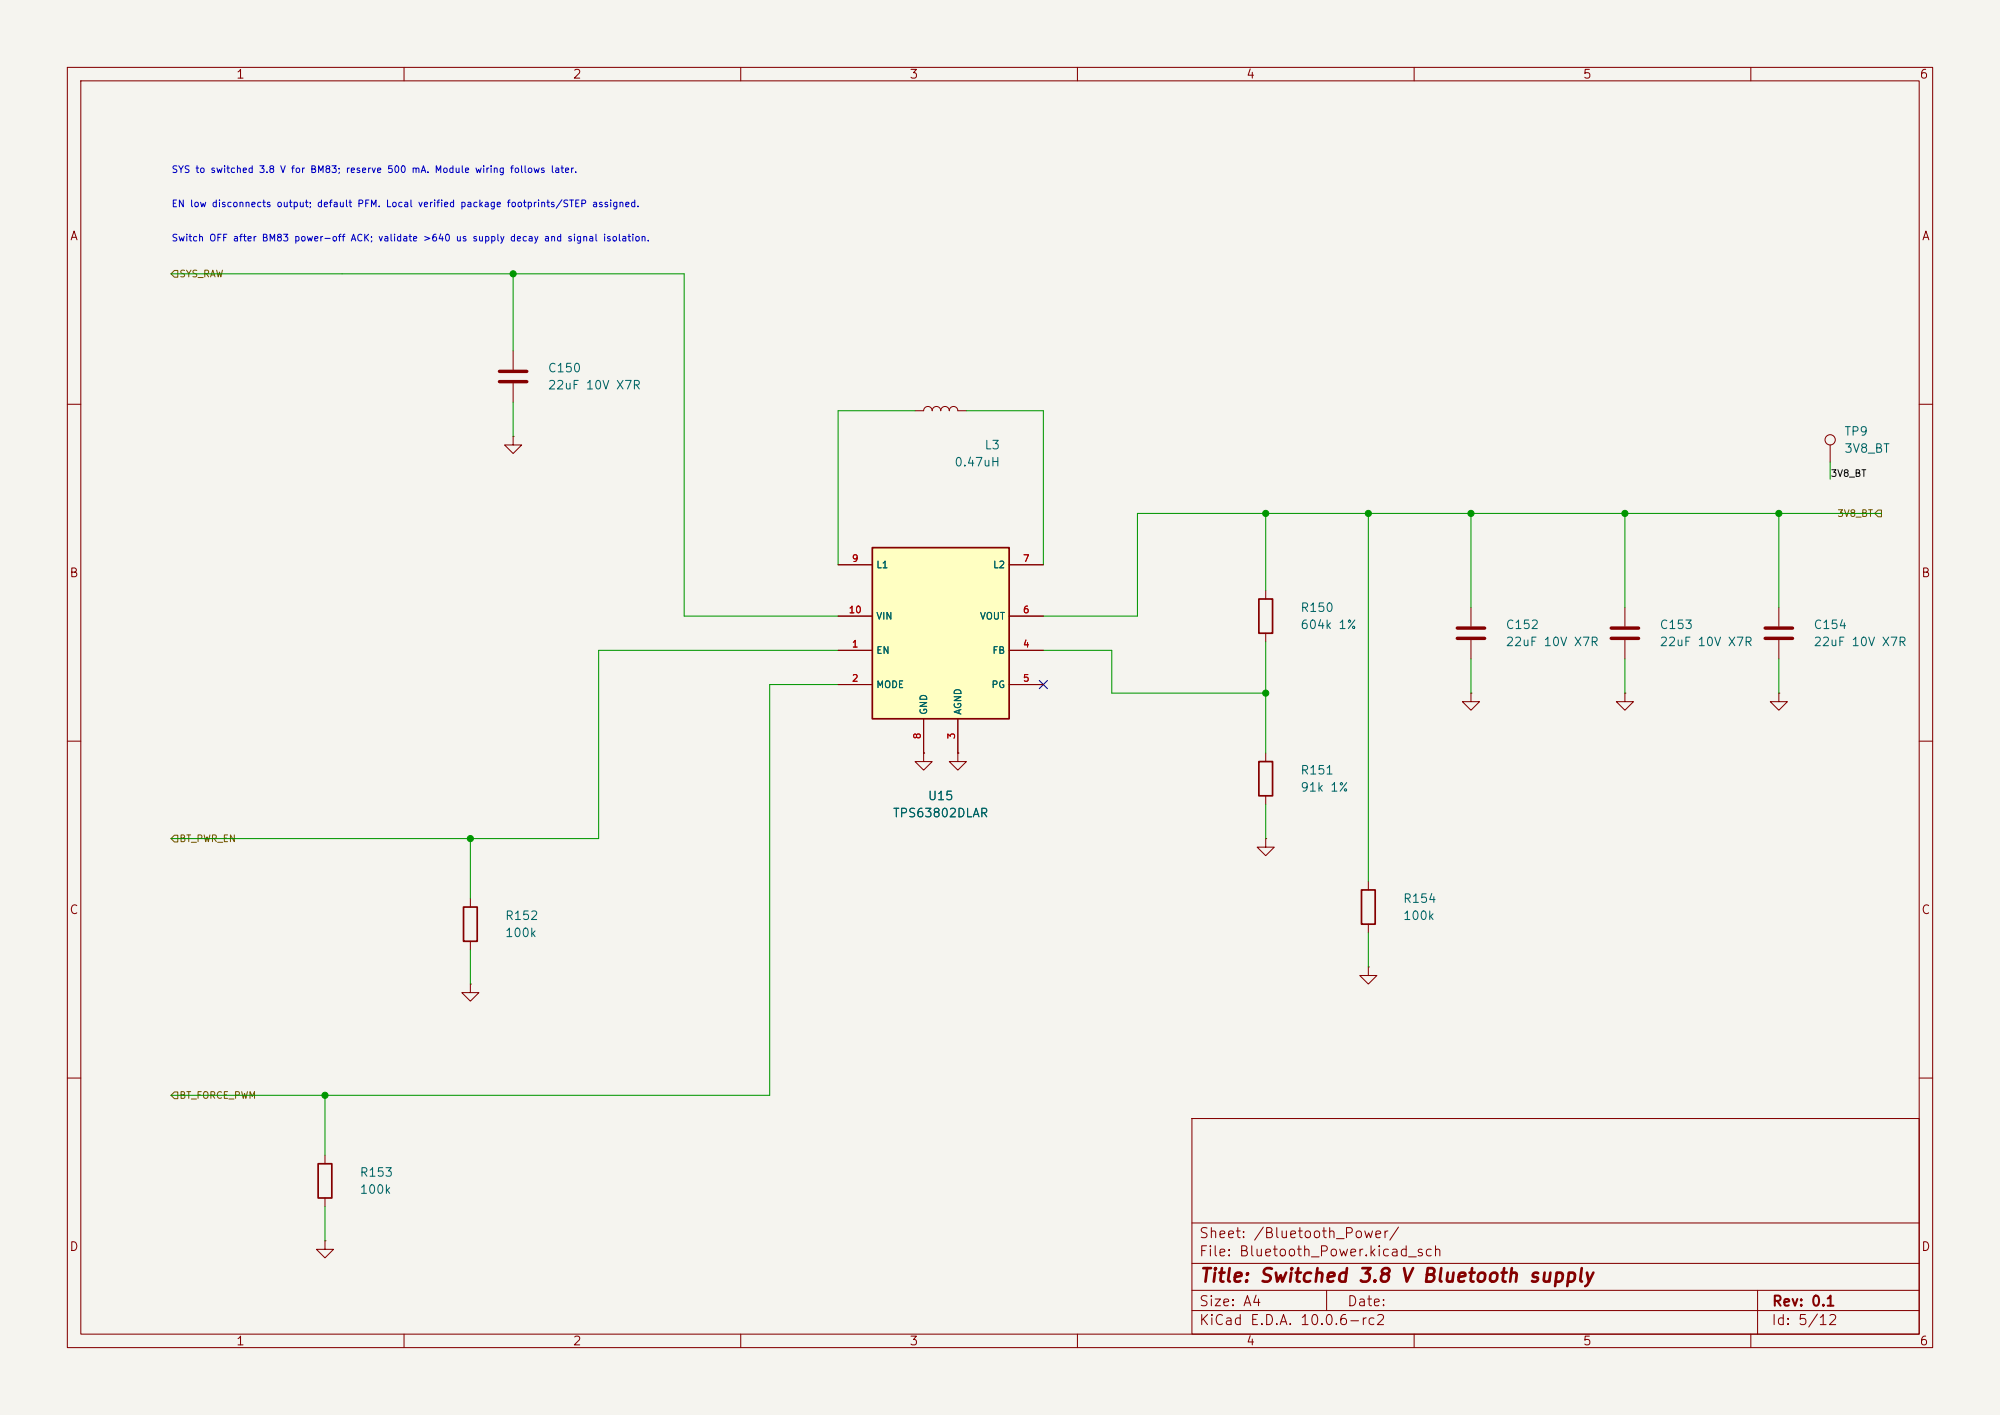
[picture p346: page 5]

Sheet: /Bluetooth_Power/
File: Bluetooth_Power.kicad_sch
Title: Switched 3.8 V Bluetooth supply

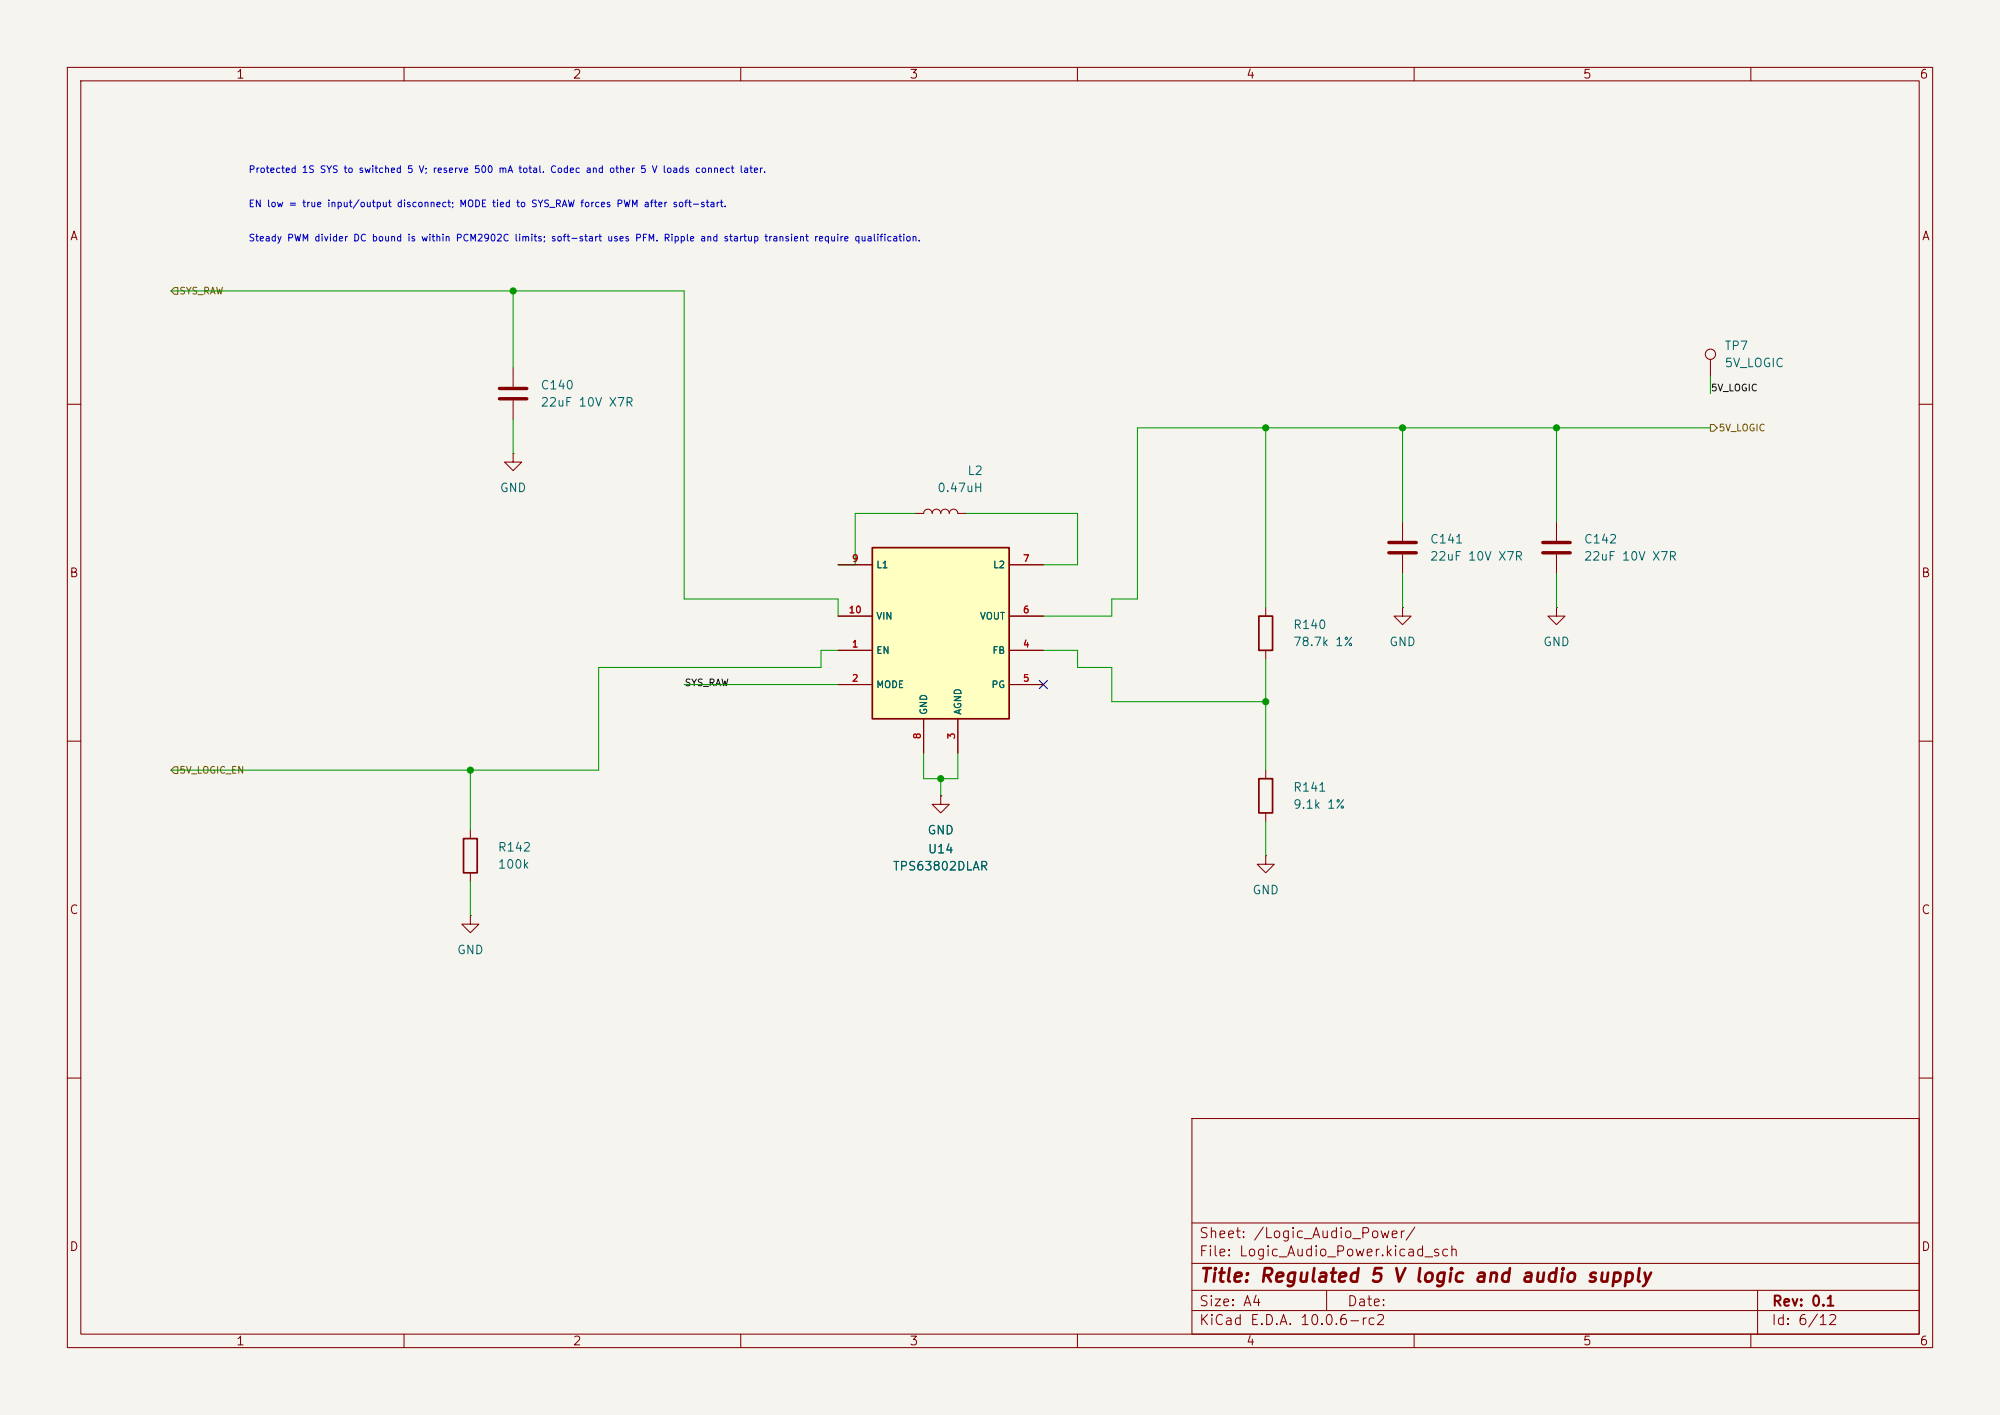
[picture p347: page 6]

Sheet: /Logic_Audio_Power/
File: Logic_Audio_Power.kicad_sch
Title: Regulated 5 V logic and audio supply

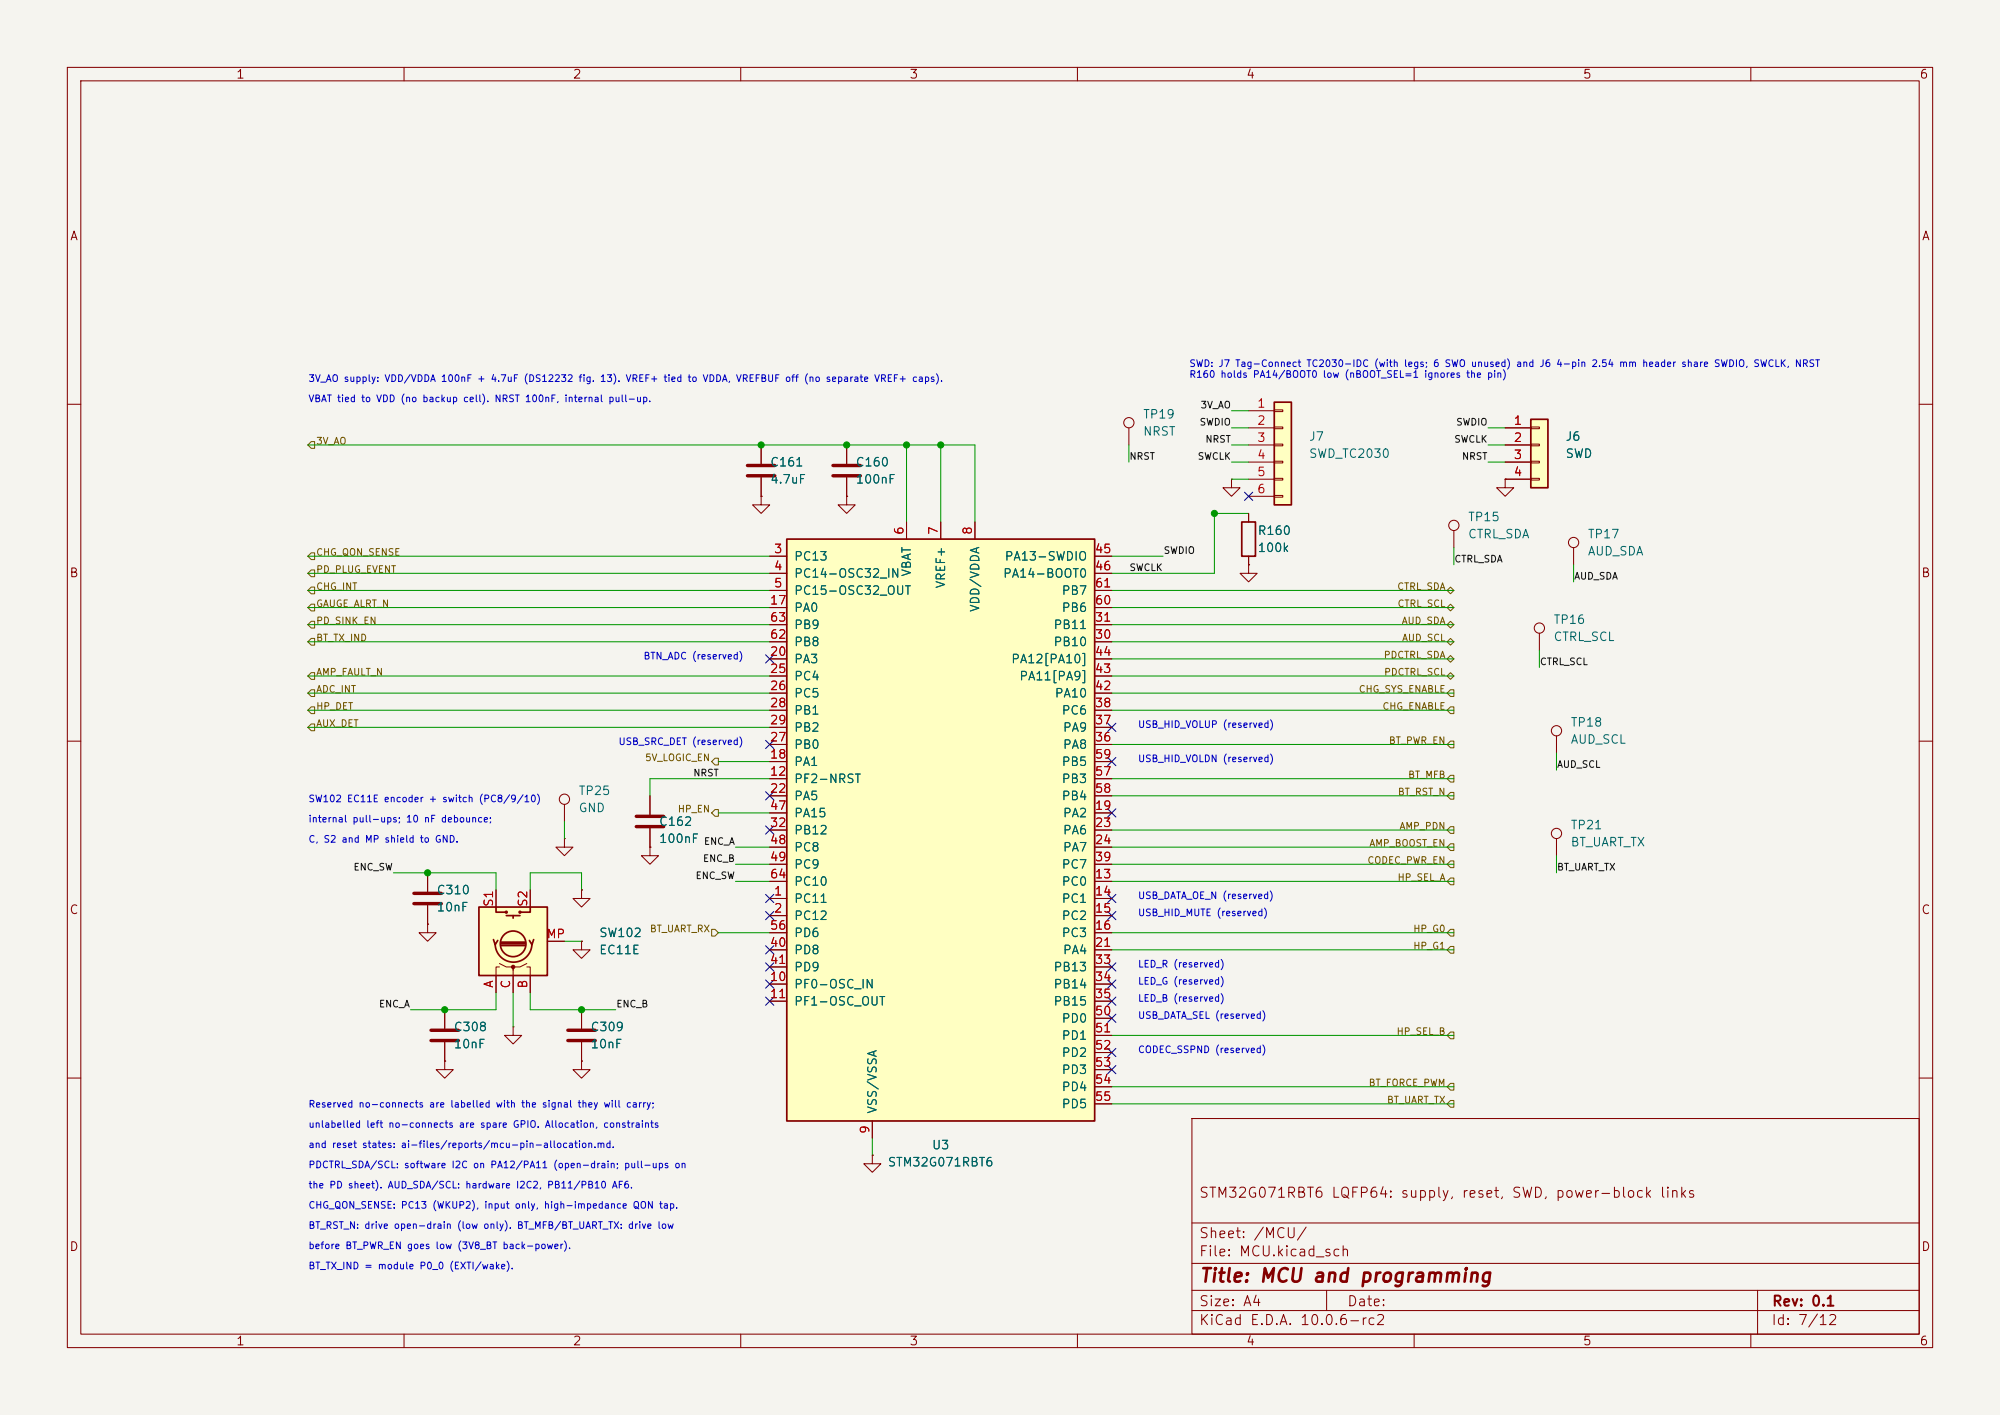
[picture p348: page 7]

7 VDD/VDDA 8 VSS/VSSA 9 PF0-OSC_IN 10 PF1-OSC_OUT 11 PF2-NRST 12 PC0 13 PC1 14 PC2 15 PC3 16 PA0 17 PA1 18 PA2 19 PA3 20 PA4 21 PA5 22 PA6 23 PA7 24 PC4 25 PC5 26 PB0 27 PB1 28 PB2 29 PB10 30 PB11 31 PB12 32 PB13 33 PB14 34 PB15 35 PA8 36 PA9 37 PC6 38 PC7 39 PD8 40 PD9 41 PA10 42 PA11[PA9] 43 PA12[PA10] 44 PA13-SWDIO 45 PA14-BOOT0 46 PA15 47 PC8 48 PC9 49 PD0 50 PD1 51 PD2 52 PD3 53 PD4 54 PD5 55 PD6 56 PB3 57 PB4 58 PB5 59 PB6 60 PB7 61 PB8 62 PB9 63 PC10 64 C308

7 VDD/VDDA 8 VSS/VSSA 9 PF0-OSC_IN 10 PF1-OSC_OUT 11 PF2-NRST 12 PC0 13 PC1 14 PC2 15 PC3 16 PA0 17 PA1 18 PA2 19 PA3 20 PA4 21 PA5 22 PA6 23 PA7 24 PC4 25 PC5 26 PB0 27 PB1 28 PB2 29 PB10 30 PB11 31 PB12 32 PB13 33 PB14 34 PB15 35 PA8 36 PA9 37 PC6 38 PC7 39 PD8 40 PD9 41 PA10 42 PA11[PA9] 43 PA12[PA10] 44 PA13-SWDIO 45 PA14-BOOT0 46 PA15 47 PC8 48 PC9 49 PD0 50 PD1 51 PD2 52 PD3 53 PD4 54 PD5 55 PD6 56 PB3 57 PB4 58 PB5 59 PB6 60 PB7 61 PB8 62 PB9 63 PC10 64 U3

unlabelled left no-connects are spare GPIO. Allocation, constraints Reserved no-connects are labelled with the signal they will carry;

BT_TX_IND = module P0_0 (EXTI/wake). the PD sheet). AUD_SDA/SCL: hardware I2C2, PB11/PB10 AF6. and reset states: ai-files/reports/mcu-pin-allocation.md. BT_RST_N: drive open-drain (low only). BT_MFB/BT_UART_TX: drive low
CHG_QON_SENSE: PC13 (WKUP2), input only, high-impedance QON tap. PDCTRL_SDA/SCL: software I2C on PA12/PA11 (open-drain; pull-ups on

STM32G071RBT6 LQFP64: supply, reset, SWD, power-block links

Sheet: /MCU/
File: MCU.kicad_sch
Title: MCU and programming

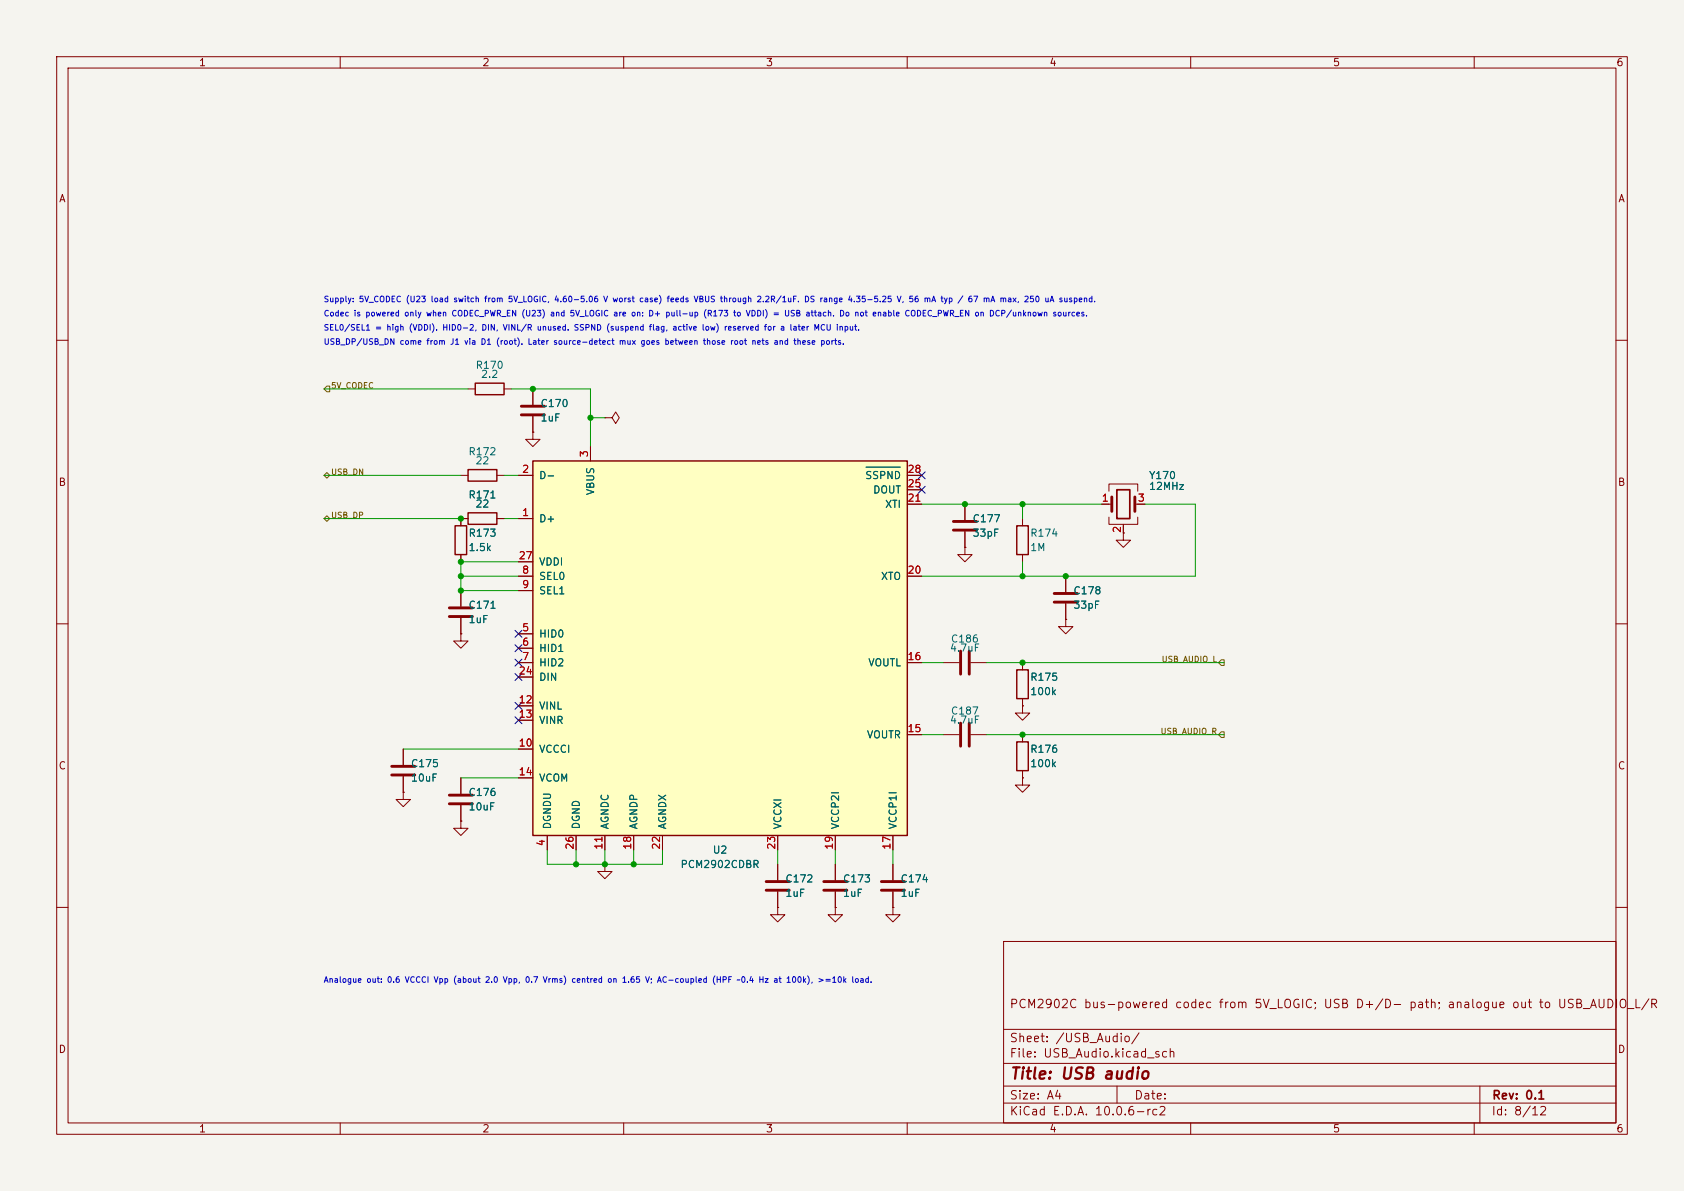
[picture p349: page 8]

USB_DP/USB_DN come from J1 via D1 (root). Later source-detect mux goes between those root nets and these ports. SEL0/SEL1 = high (VDDI). HID0-2, DIN, VINL/R unused. SSPND (suspend flag, active low) reserved for a later MCU input. Codec is powered only when CODEC_PWR_EN (U23) and 5V_LOGIC are on: D+ pull-up (R173 to VDDI) = USB attach. Do not enable CODEC_PWR_EN on DCP/unknown sources. Supply: 5V_CODEC (U23 load switch from 5V_LOGIC, 4.60-5.06 V worst case) feeds VBUS through 2.2R/1uF. DS range 4.35-5.25 V, 56 mA typ / 67 mA max, 250 uA suspend.

Analogue out: 0.6 VCCCI Vpp (about 2.0 Vpp, 0.7 Vrms) centred on 1.65 V; AC-coupled (HPF ~0.4 Hz at 100k), >=10k load.

PCM2902C bus-powered codec from 5V_LOGIC; USB D+/D- path; analogue out to USB_AUDIO_L/R

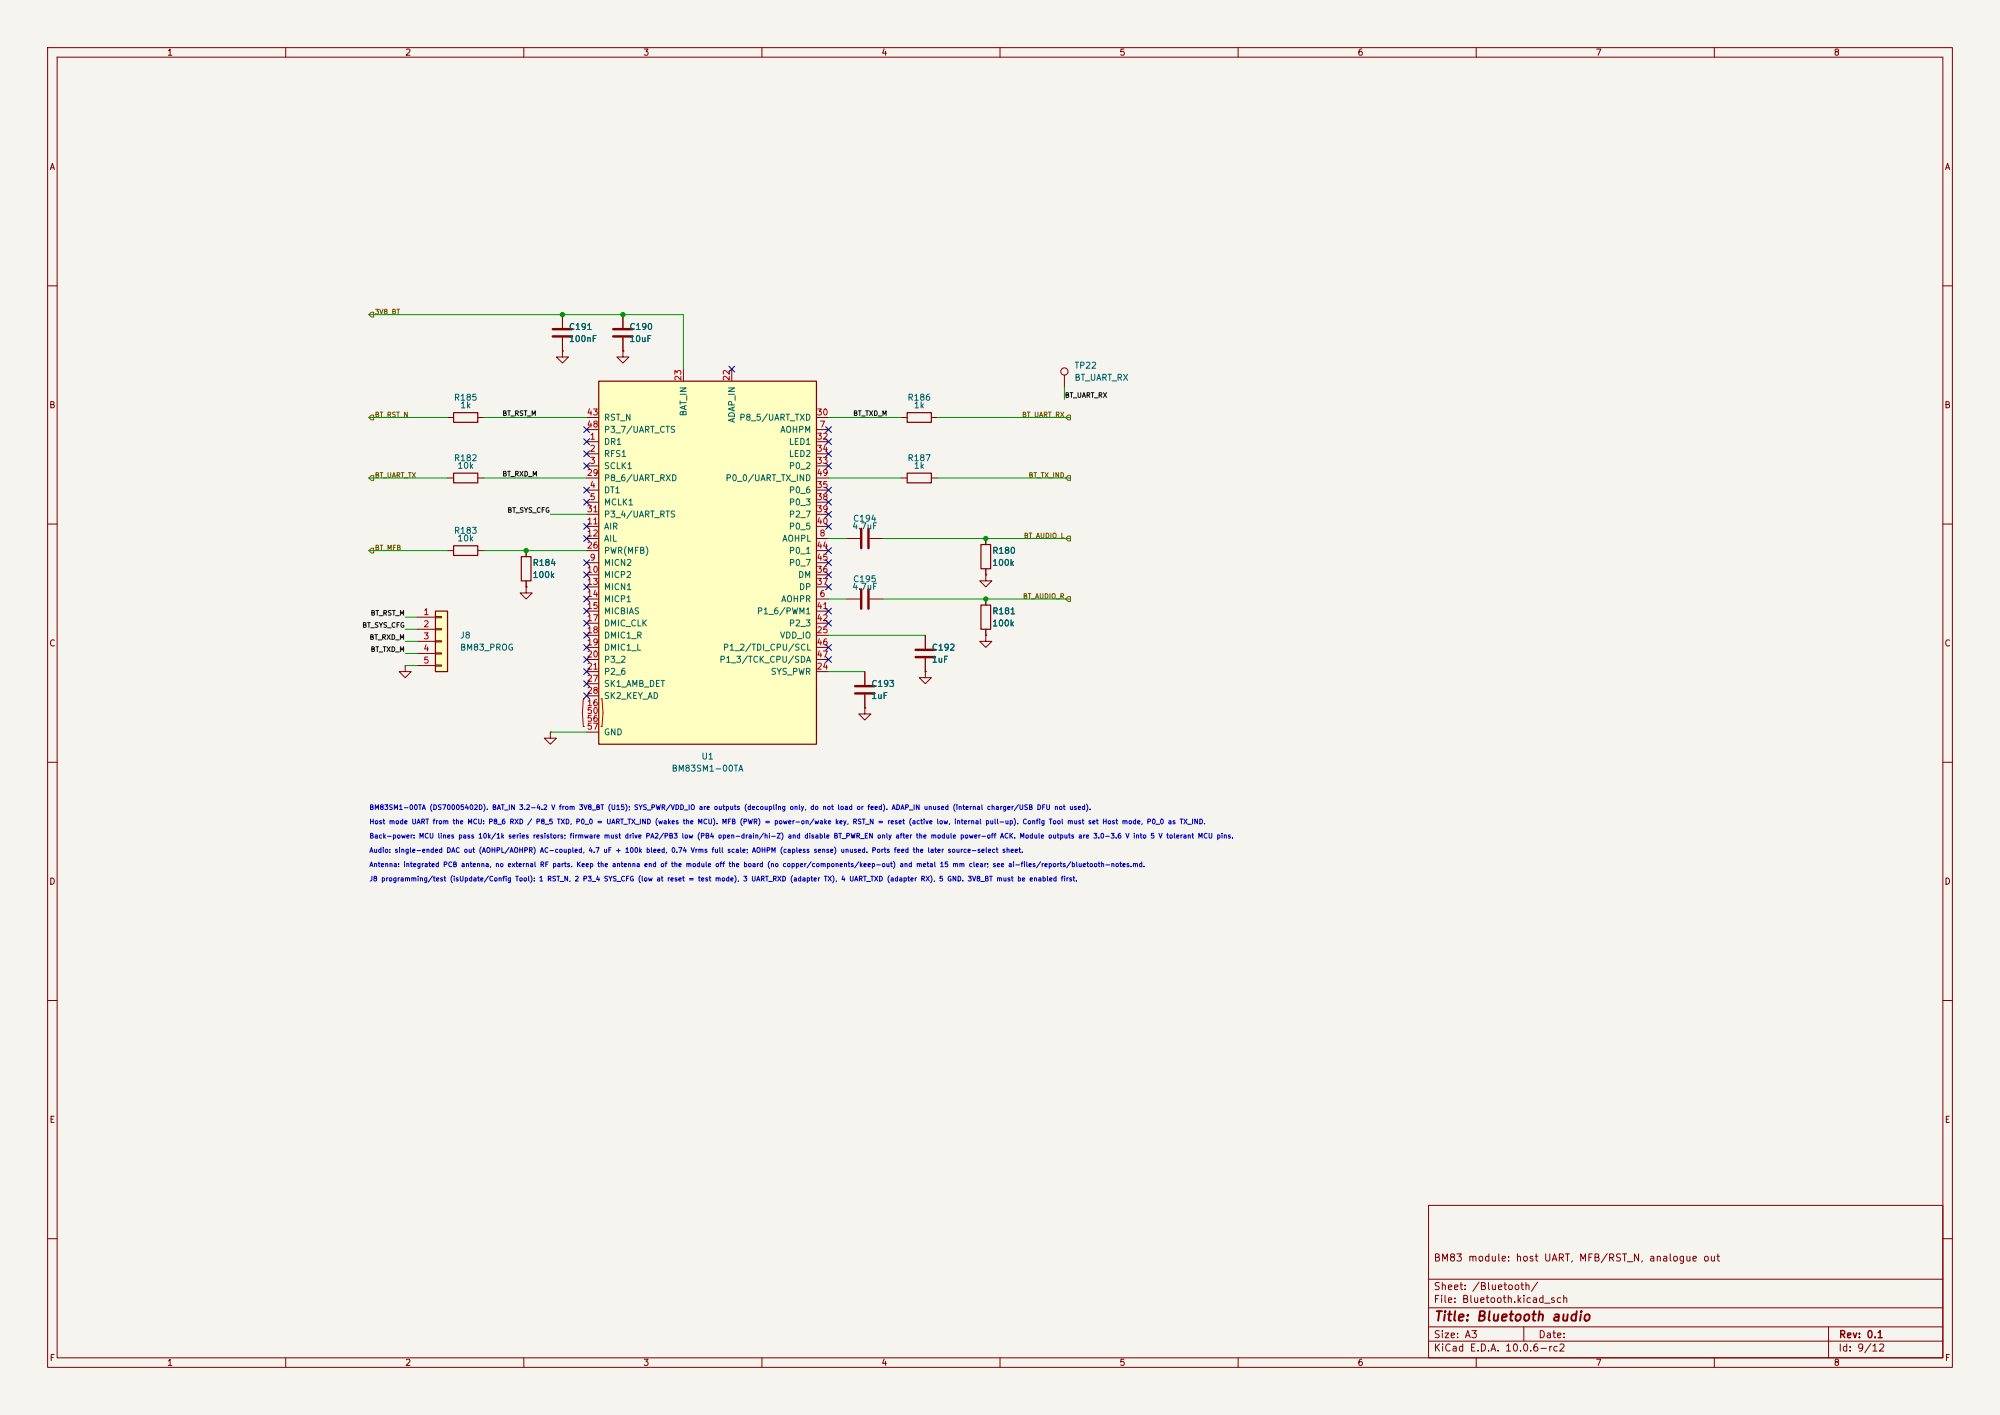
[picture p350: page 9]

BT_MFB
J8 programming/test (isUpdate/Config Tool): 1 RST_N, 2 P3_4 SYS_CFG (low at reset = test mode), 3 UART_RXD (adapter TX), 4 UART_TXD (adapter RX), 5 GND. 3V8_BT must be enabled first. Back-power: MCU lines pass 10k/1k series resistors; firmware must drive PA2/PB3 low (PB4 open-drain/hi-Z) and disable BT_PWR_EN only after the module power-off ACK. Module outputs are 3.0-3.6 V into 5 V tolerant MCU pins. Antenna: integrated PCB antenna, no external RF parts. Keep the antenna end of the module off the board (no copper/components/keep-out) and metal 15 mm clear; see ai-files/reports/bluetooth-notes.md. BM83SM1-00TA (DS70005402D). BAT_IN 3.2-4.2 V from 3V8_BT (U15); SYS_PWR/VDD_IO are outputs (decoupling only, do not load or feed). ADAP_IN unused (internal charger/USB DFU not used). Host mode UART from the MCU: P8_6 RXD / P8_5 TXD, P0_0 = UART_TX_IND (wakes the MCU). MFB (PWR) = power-on/wake key, RST_N = reset (active low, internal pull-up). Config Tool must set Host mode, P0_0 as TX_IND. Audio: single-ended DAC out (AOHPL/AOHPR) AC-coupled, 4.7 uF + 100k bleed, 0.74 Vrms full scale; AOHPM (capless sense) unused. Ports feed the later source-select sheet. R184

BM83 module: host UART, MFB/RST_N, analogue out

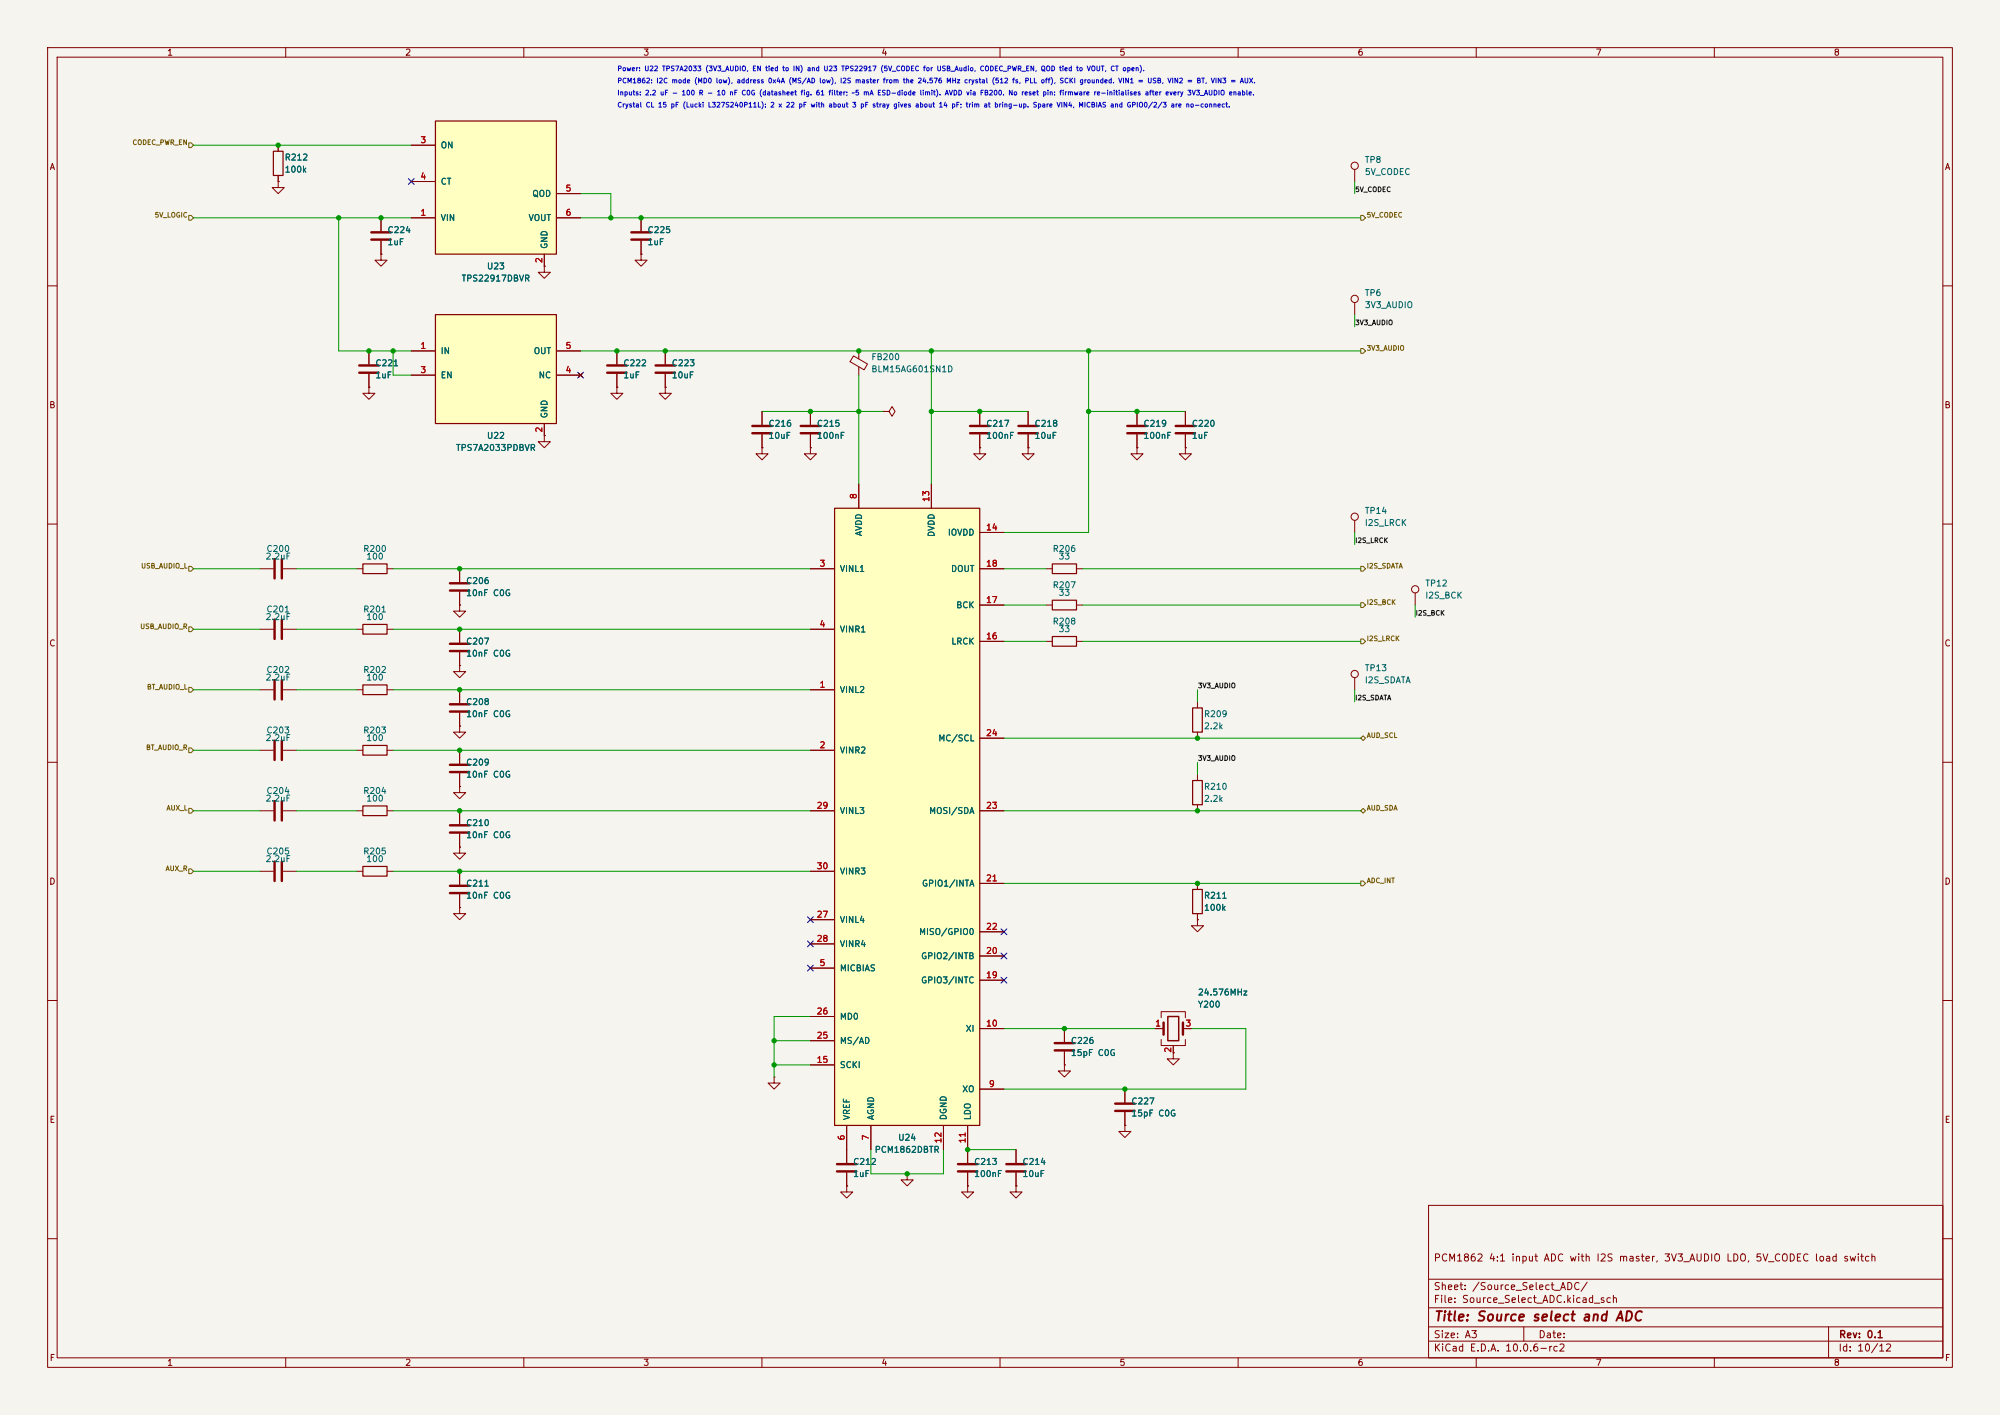
[picture p351: page 10]

Inputs: 2.2 uF - 100 R - 10 nF C0G (datasheet fig. 61 filter; ~5 mA ESD-diode limit). AVDD via FB200. No reset pin: firmware re-initialises after every 3V3_AUDIO enable. PCM1862: I2C mode (MD0 low), address 0x4A (MS/AD low), I2S master from the 24.576 MHz crystal (512 fs, PLL off), SCKI grounded. VIN1 = USB, VIN2 = BT, VIN3 = AUX. Power: U22 TPS7A2033 (3V3_AUDIO, EN tied to IN) and U23 TPS22917 (5V_CODEC for USB_Audio, CODEC_PWR_EN, QOD tied to VOUT, CT open).

Crystal CL 15 pF (Lucki L327S240P11L): 2 x 22 pF with about 3 pF stray gives about 14 pF; trim at bring-up. Spare VIN4, MICBIAS and GPIO0/2/3 are no-connect.

PCM1862 4:1 input ADC with I2S master, 3V3_AUDIO LDO, 5V_CODEC load switch

Sheet: /Source_Select_ADC/
File: Source_Select_ADC.kicad_sch
Title: Source select and ADC

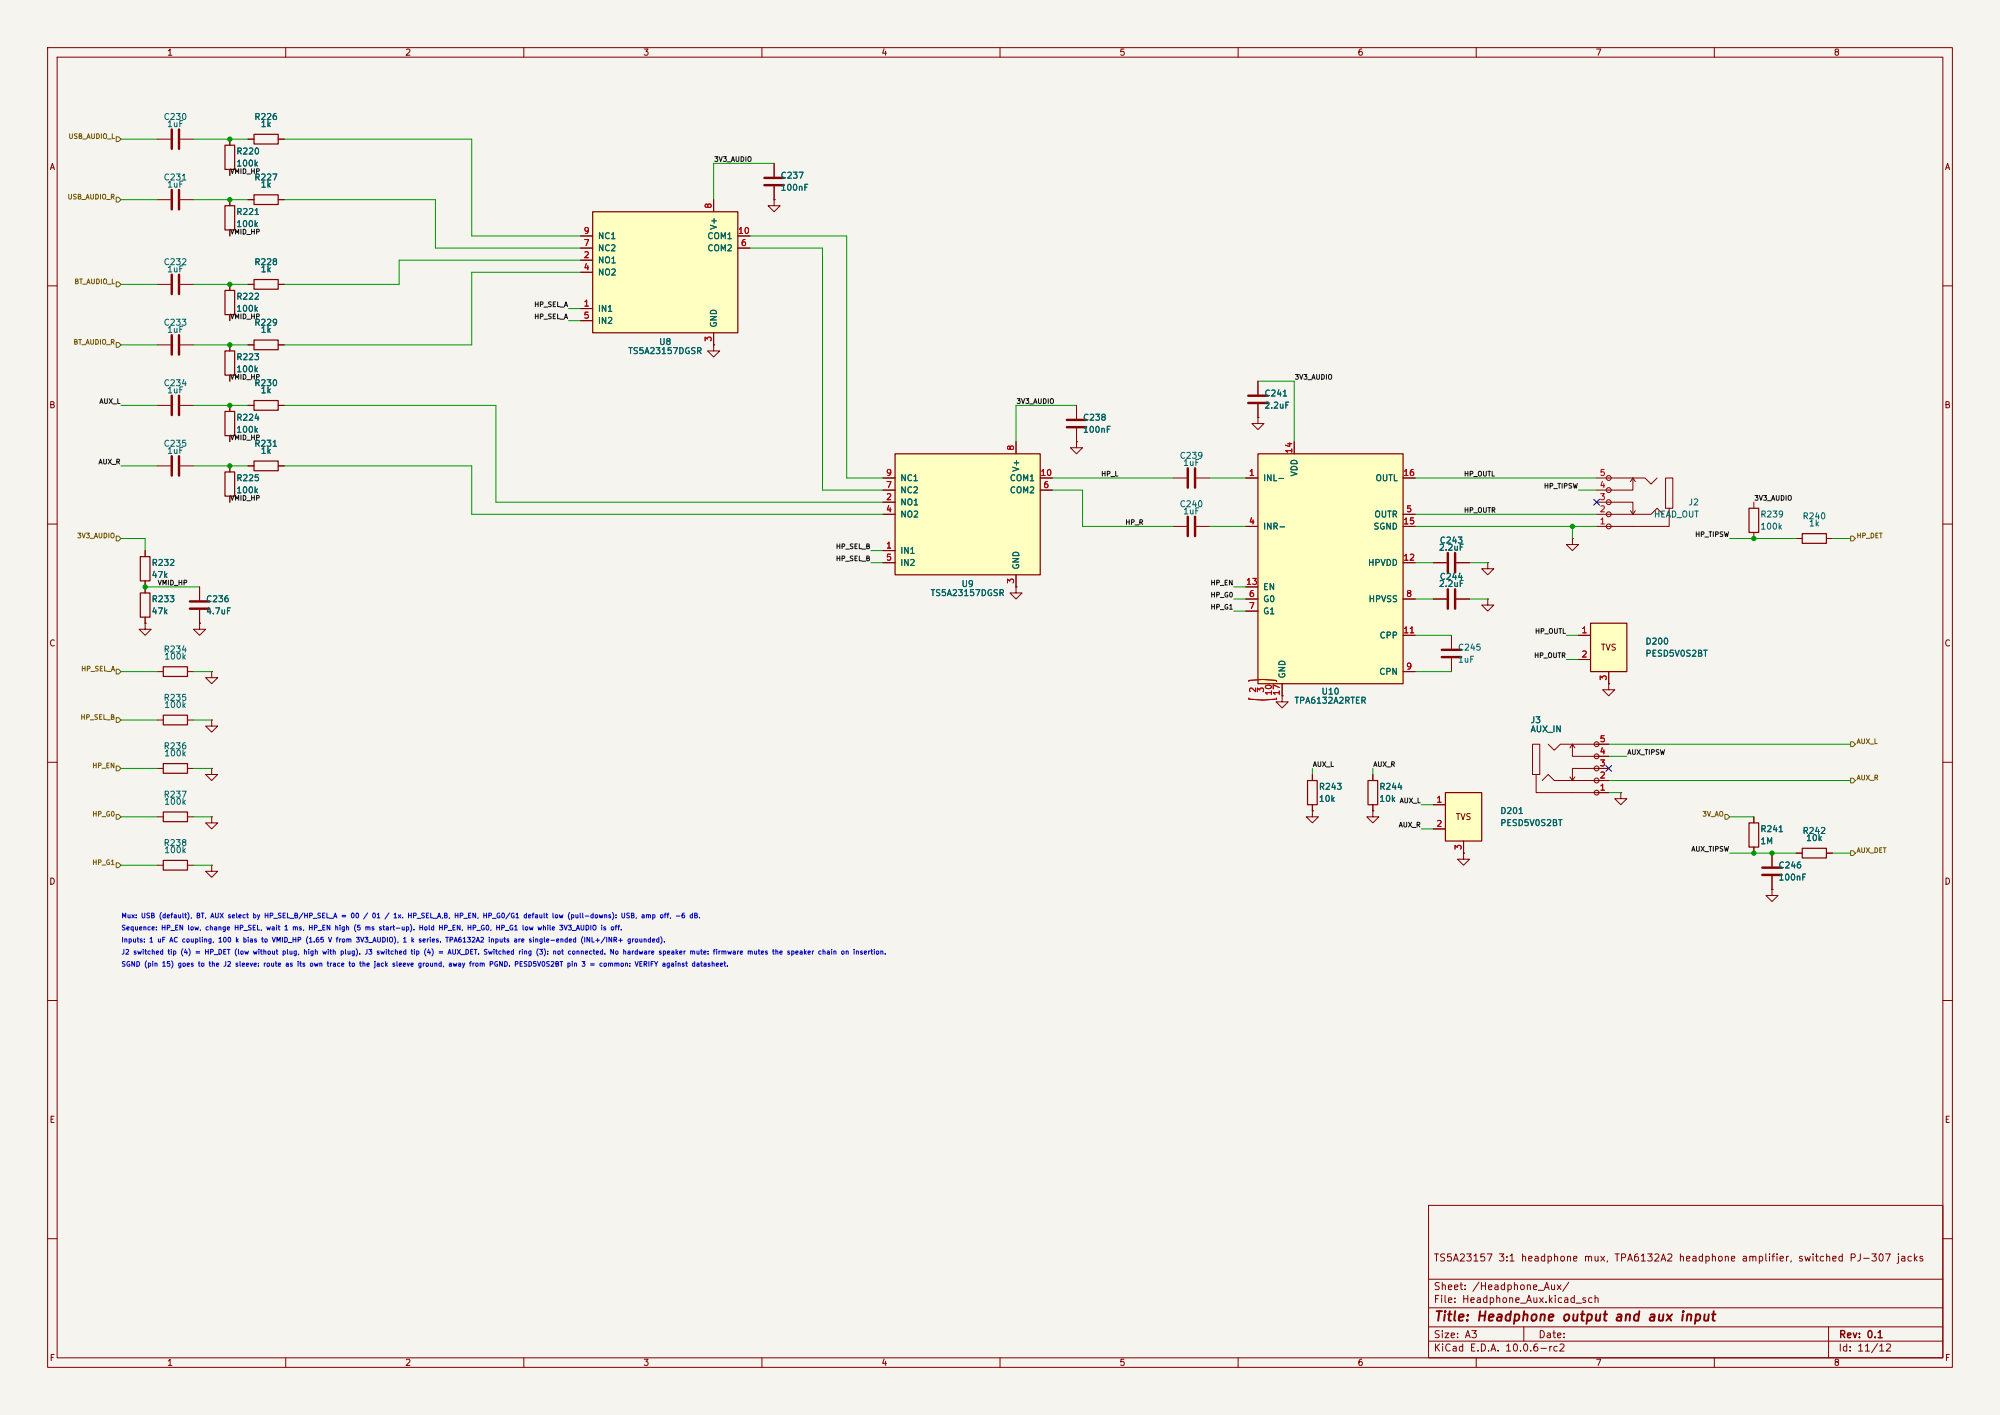
[picture p352: page 11]

SGND (pin 15) goes to the J2 sleeve: route as its own trace to the jack sleeve ground, away from PGND. PESD5V0S2BT pin 3 = common: VERIFY against datasheet. J2 switched tip (4) = HP_DET (low without plug, high with plug). J3 switched tip (4) = AUX_DET. Switched ring (3): not connected. No hardware speaker mute: firmware mutes the speaker chain on insertion.

TS5A23157 3:1 headphone mux, TPA6132A2 headphone amplifier, switched PJ-307 jacks

Sheet: /Headphone_Aux/
File: Headphone_Aux.kicad_sch
Title: Headphone output and aux input

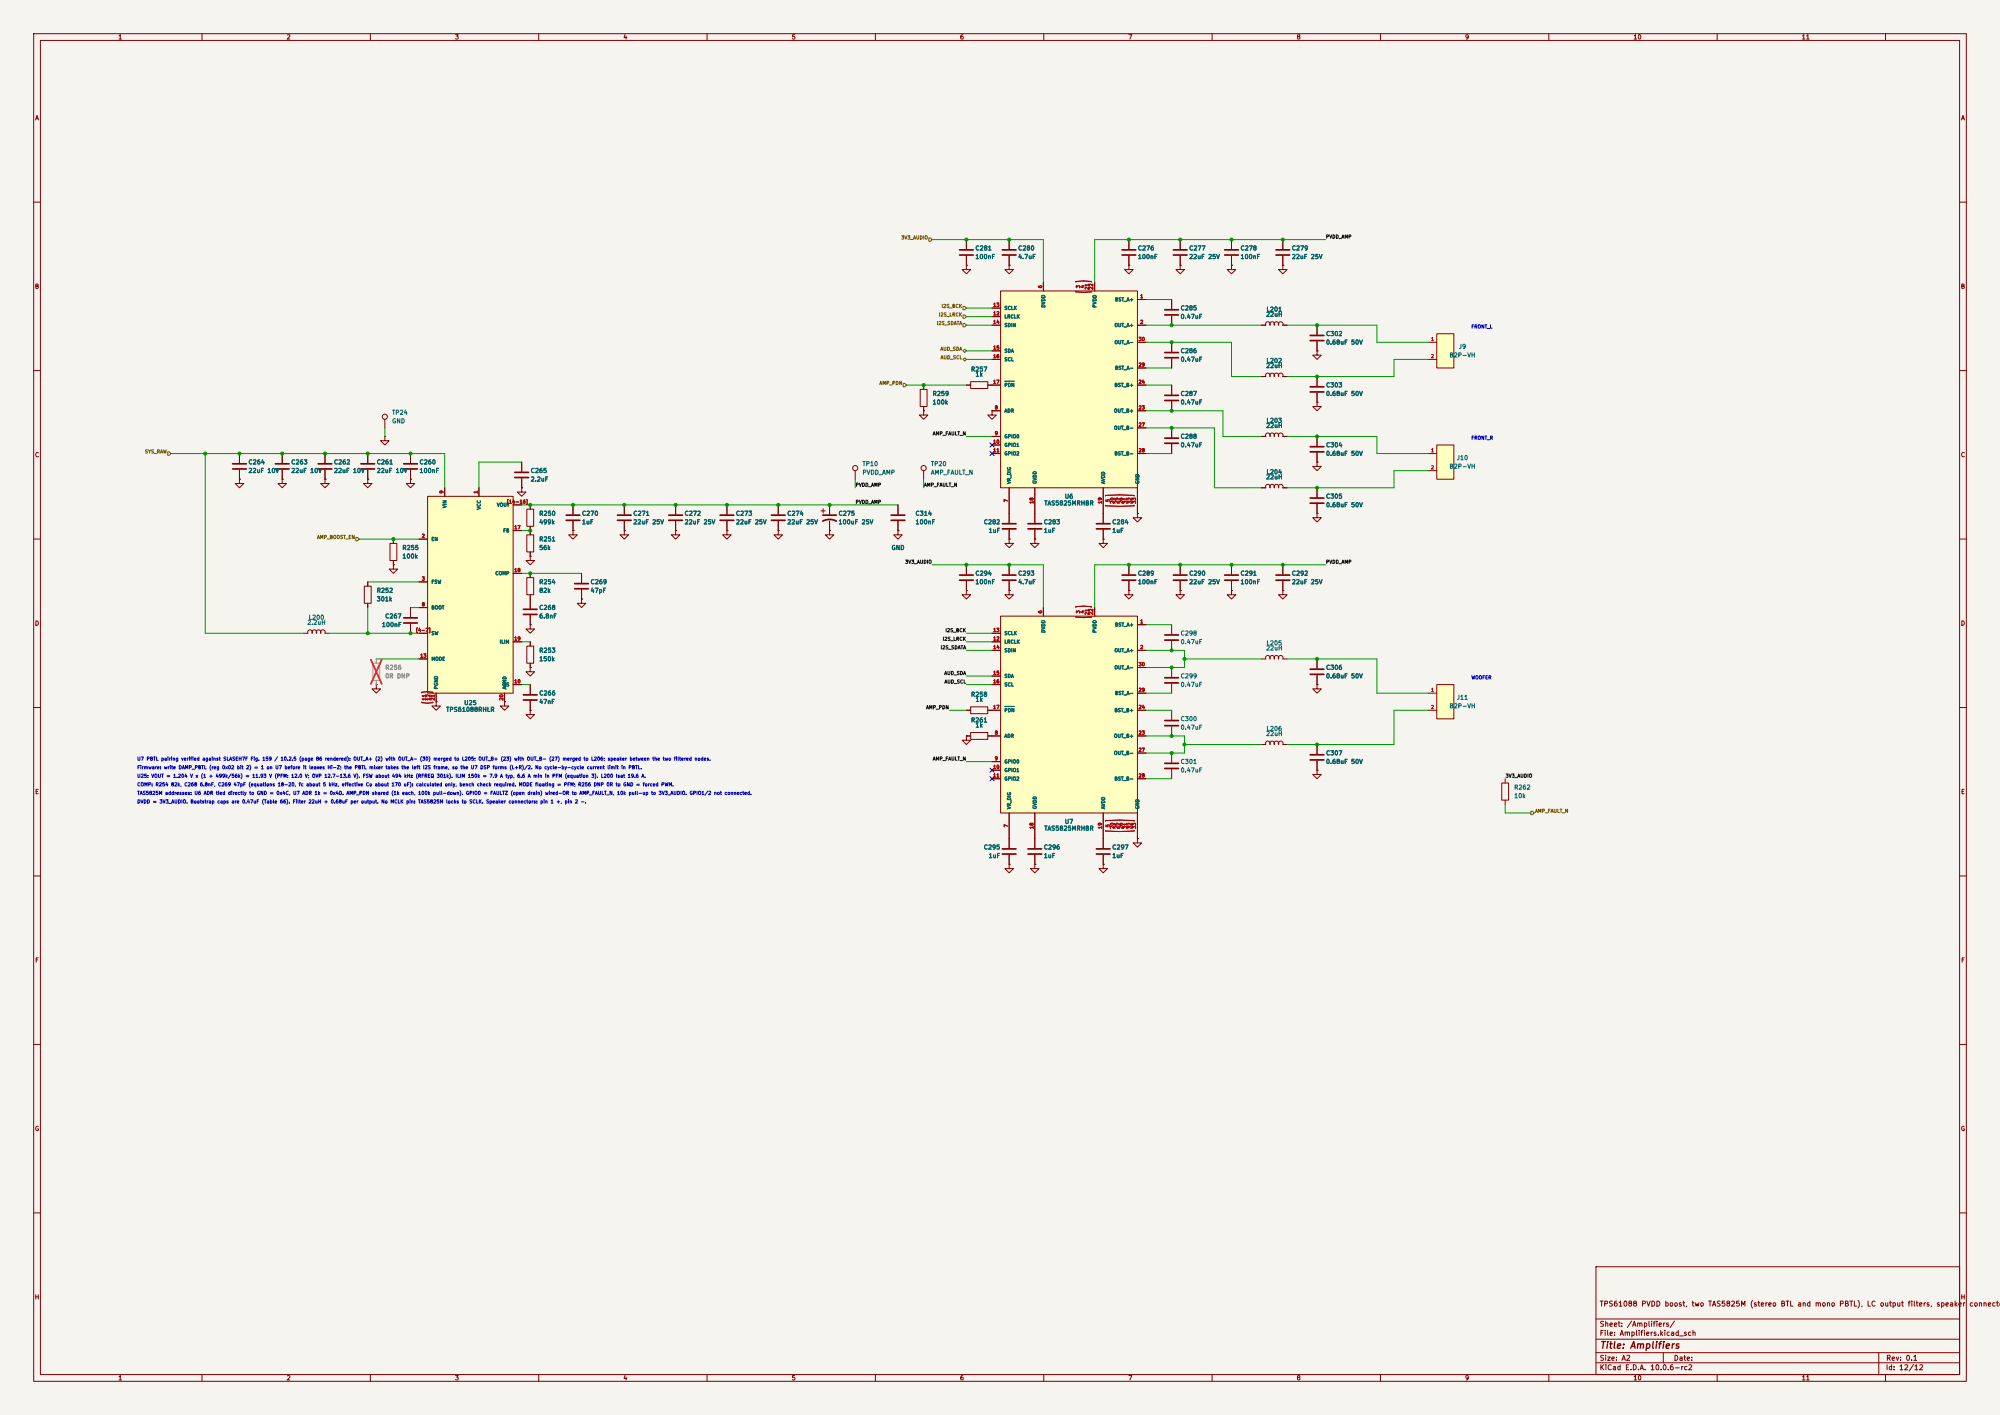
[picture p353: page 12]

FRONT_R WOOFER U7 PBTL pairing verified against SLASEH7F Fig. 159 / 10.2.5 (page 86 rendered): OUT_A+ (2) with OUT_A- (30) merged to L205; OUT_B+ (23) with OUT_B- (27) merged to L206; speaker between the two filtered nodes.

TPS61088 PVDD boost, two TAS5825M (stereo BTL and mono PBTL), LC output filters, speaker connectors
