chithigun23/DesktopSpeaker/ai-files/pcb/layout-top-colour.pdf

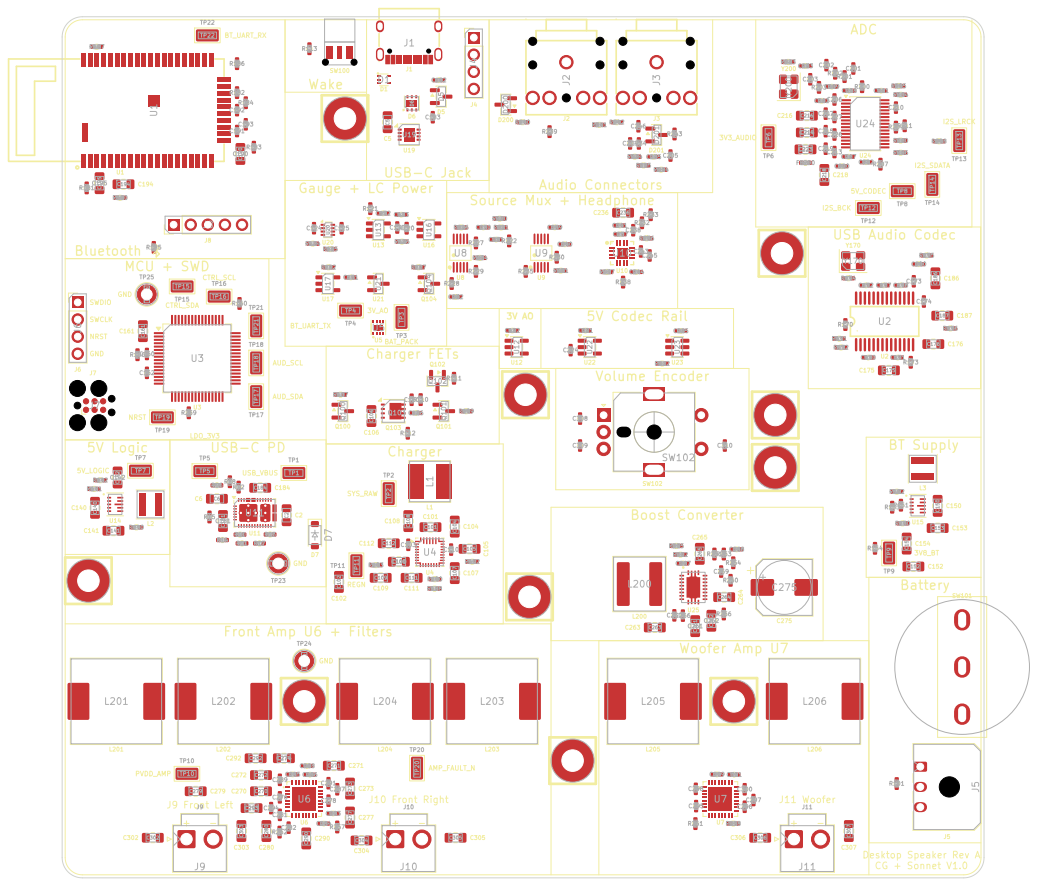
[picture p354: page 1]

USB Audio Codec

5V Codec Rail

Volume Encoder
