chithigun23/DesktopSpeaker/ai-files/pcb/layout-top.pdf

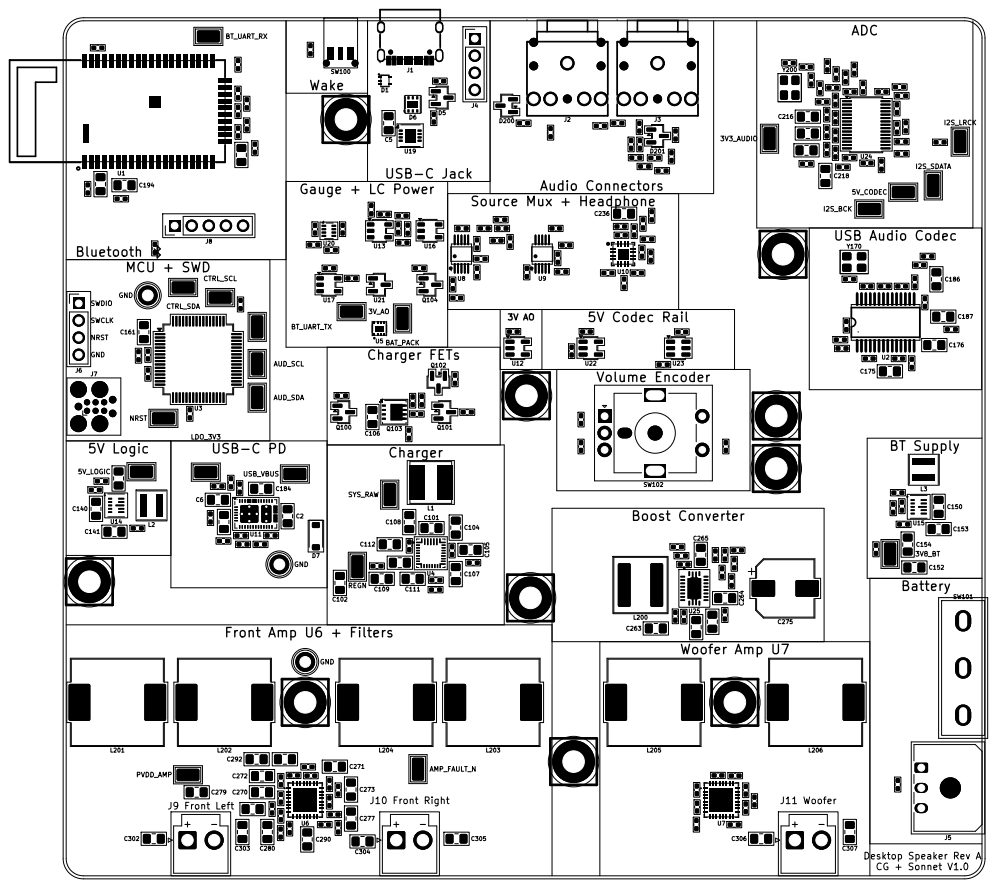
[picture p355: page 1]

Gauge + LC Power

Source Mux + Headphone

USB Audio Codec

5V Codec Rail
