chithigun23/DesktopSpeaker/ai-files/candidates/Battery_Charger-candidate.pdf

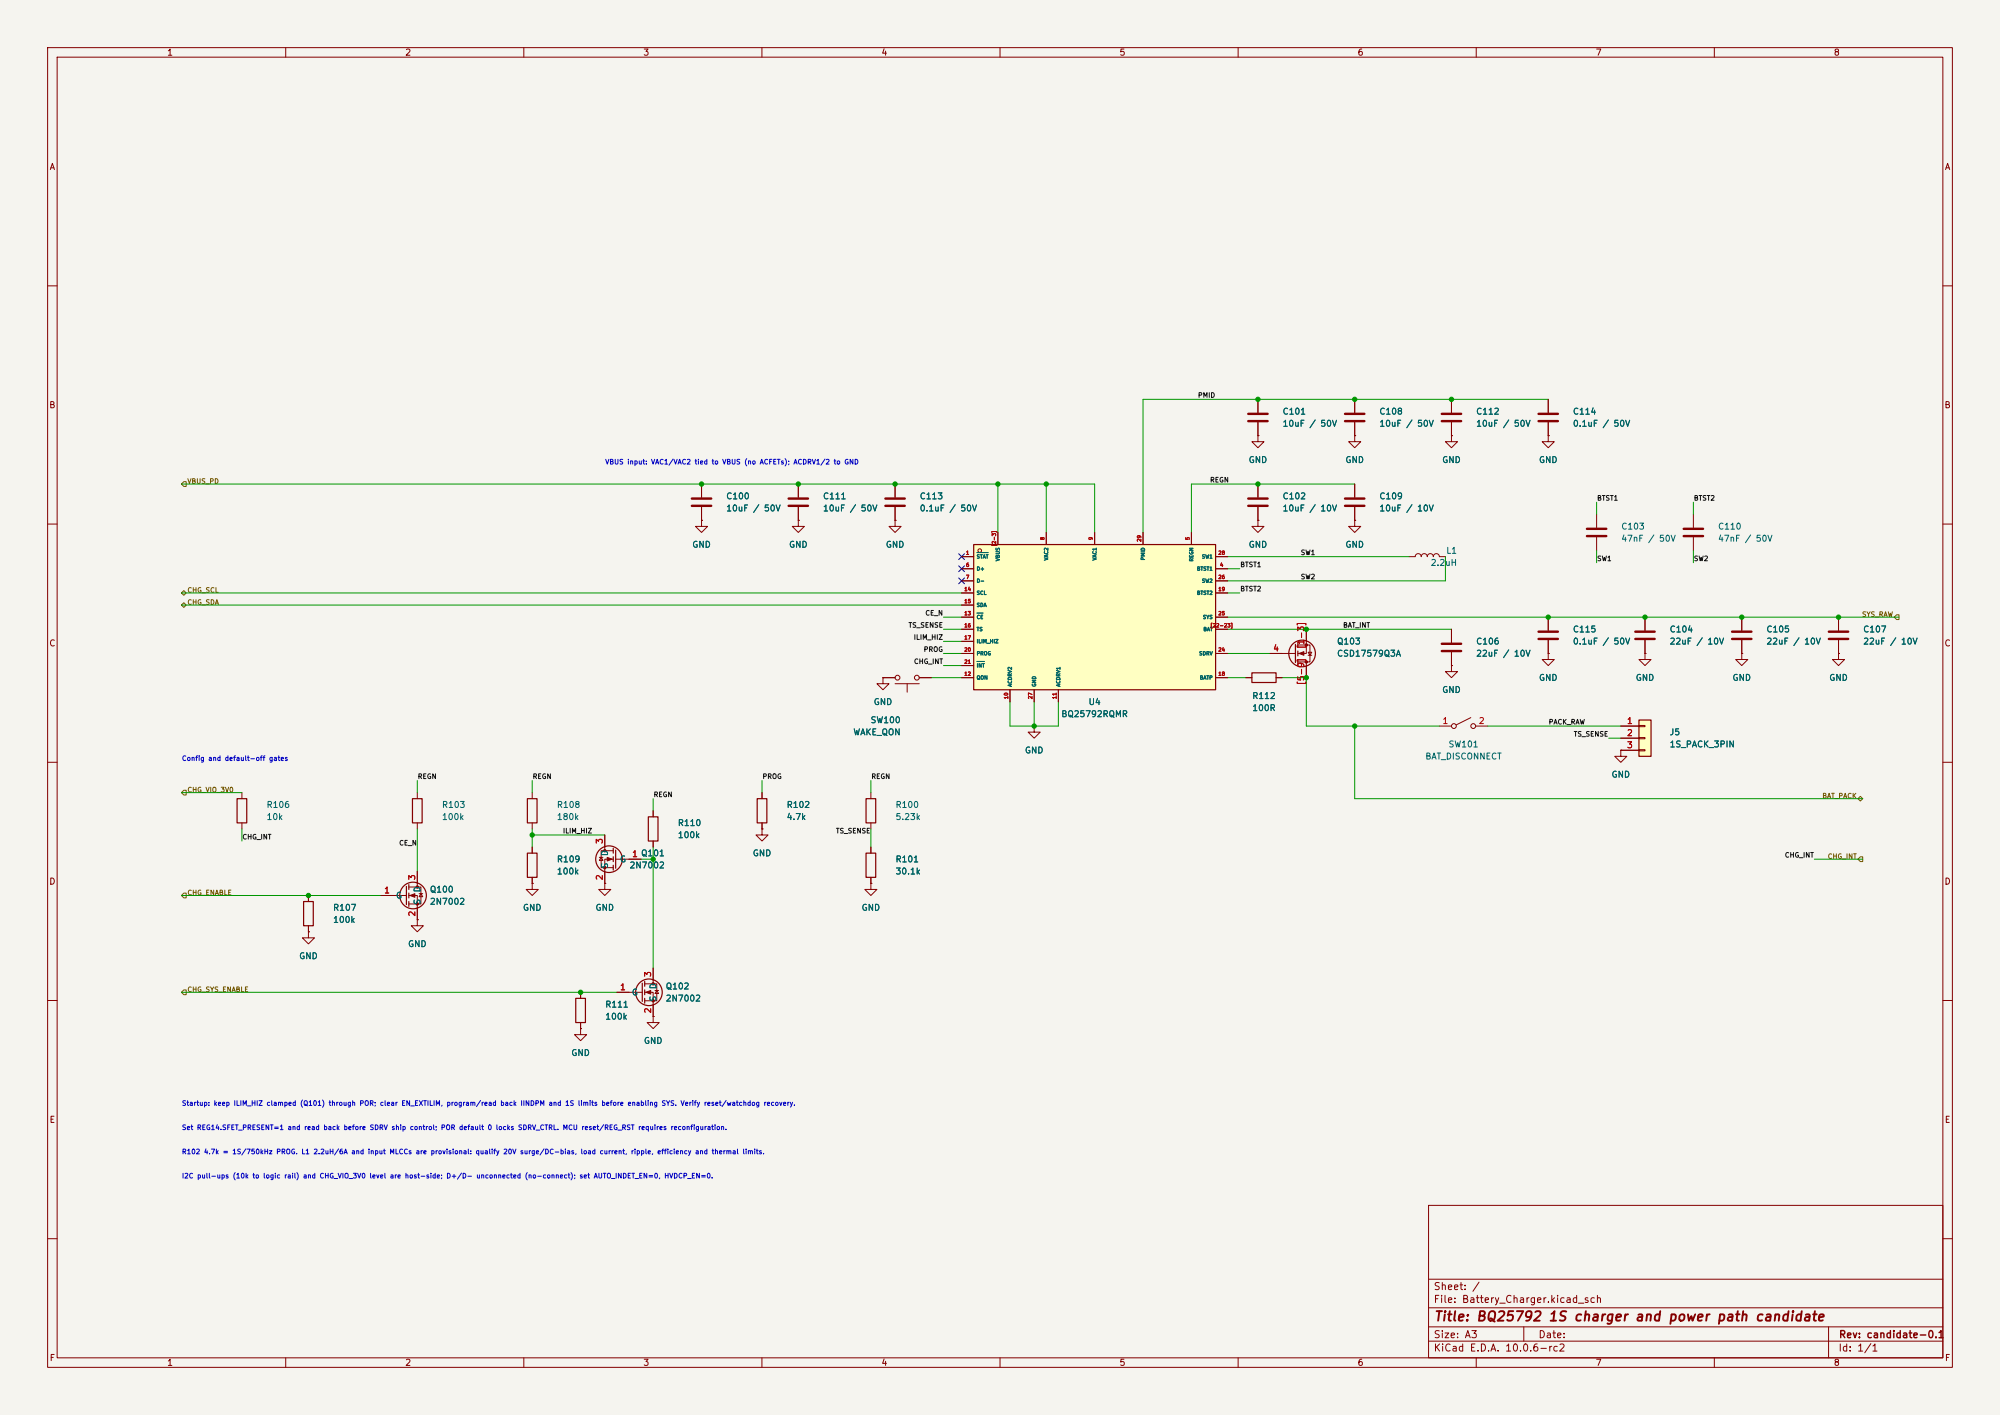
[picture p356: page 1]

VBUS input: VAC1/VAC2 tied to VBUS (no ACFETs); ACDRV1/2 to GND

Startup: keep ILIM_HIZ clamped (Q101) through POR; clear EN_EXTILIM, program/read back IINDPM and 1S limits before enabling SYS. Verify reset/watchdog recovery. Set REG14.SFET_PRESENT=1 and read back before SDRV ship control; POR default 0 locks SDRV_CTRL. MCU reset/REG_RST requires reconfiguration. R102 4.7k = 1S/750kHz PROG. L1 2.2uH/6A and input MLCCs are provisional: qualify 20V surge/DC-bias, load current, ripple, efficiency and thermal limits.

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

Sheet: /
File: Battery_Charger.kicad_sch
Title: BQ25792 1S charger and power path candidate

Size: A3 | Rev: candidate-0.1 | F Date:
KiCad E.D.A. 10.0.6-rc2 | Id: 1/1
