chithigun23/DesktopSpeaker/ai-files/candidates/TPS25730D_USB_PD_candidate.pdf

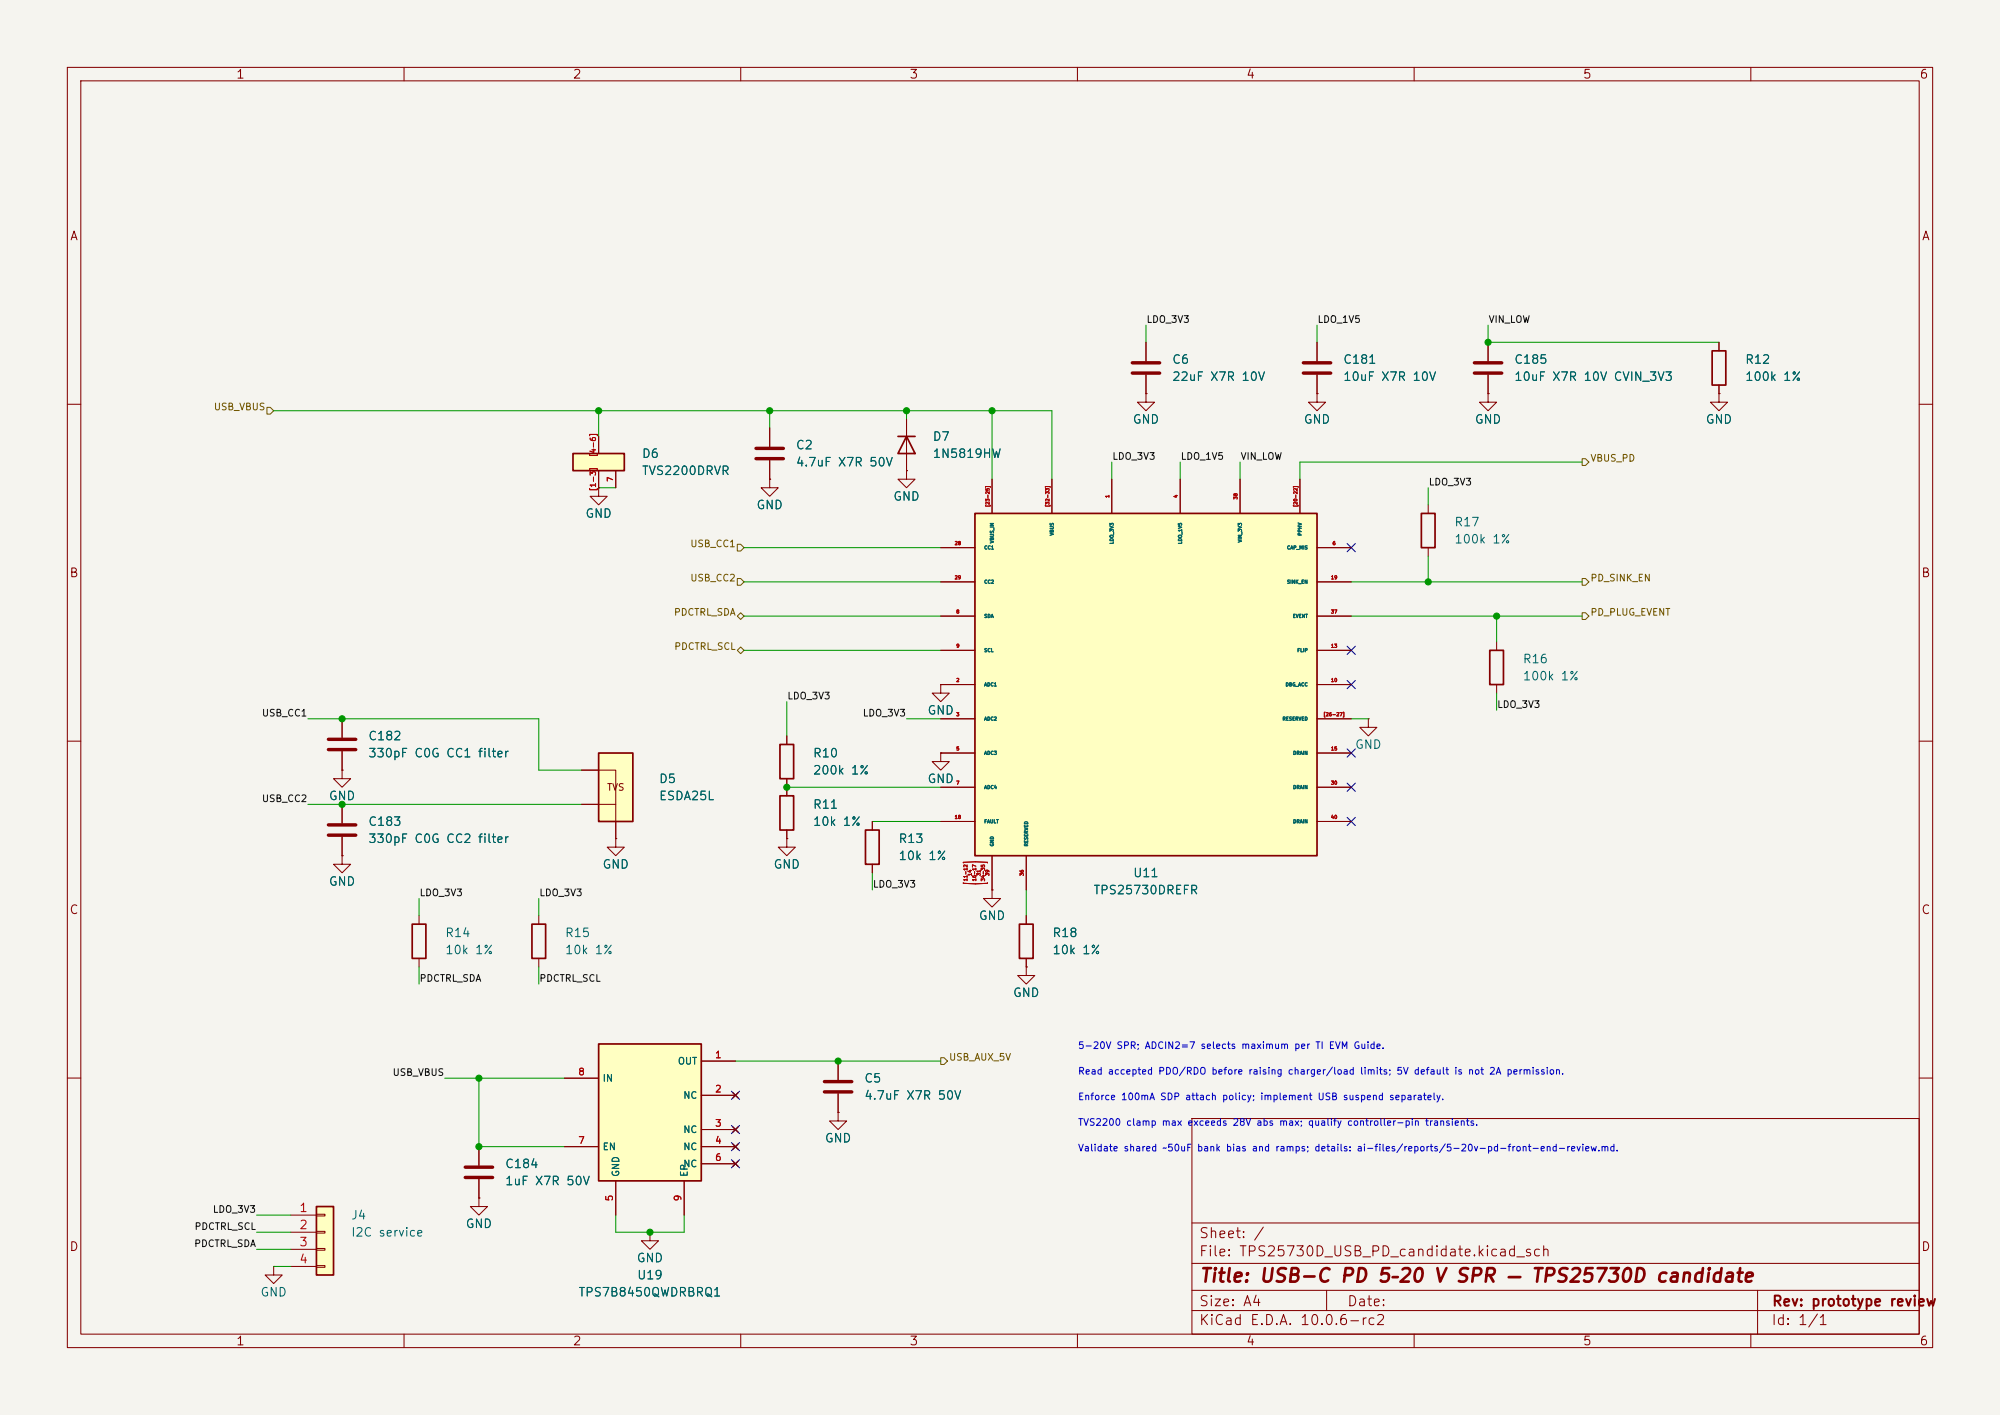
[picture p357: page 1]

Sheet: /
File: TPS25730D_USB_PD_candidate.kicad_sch
Title: USB-C PD 5–20 V SPR — TPS25730D candidate
KiCad E.D.A. 10.0.6-rc2
