chithigun23/DesktopSpeaker/ai-files/candidates/Fuel_Gauge_Power-candidate.pdf

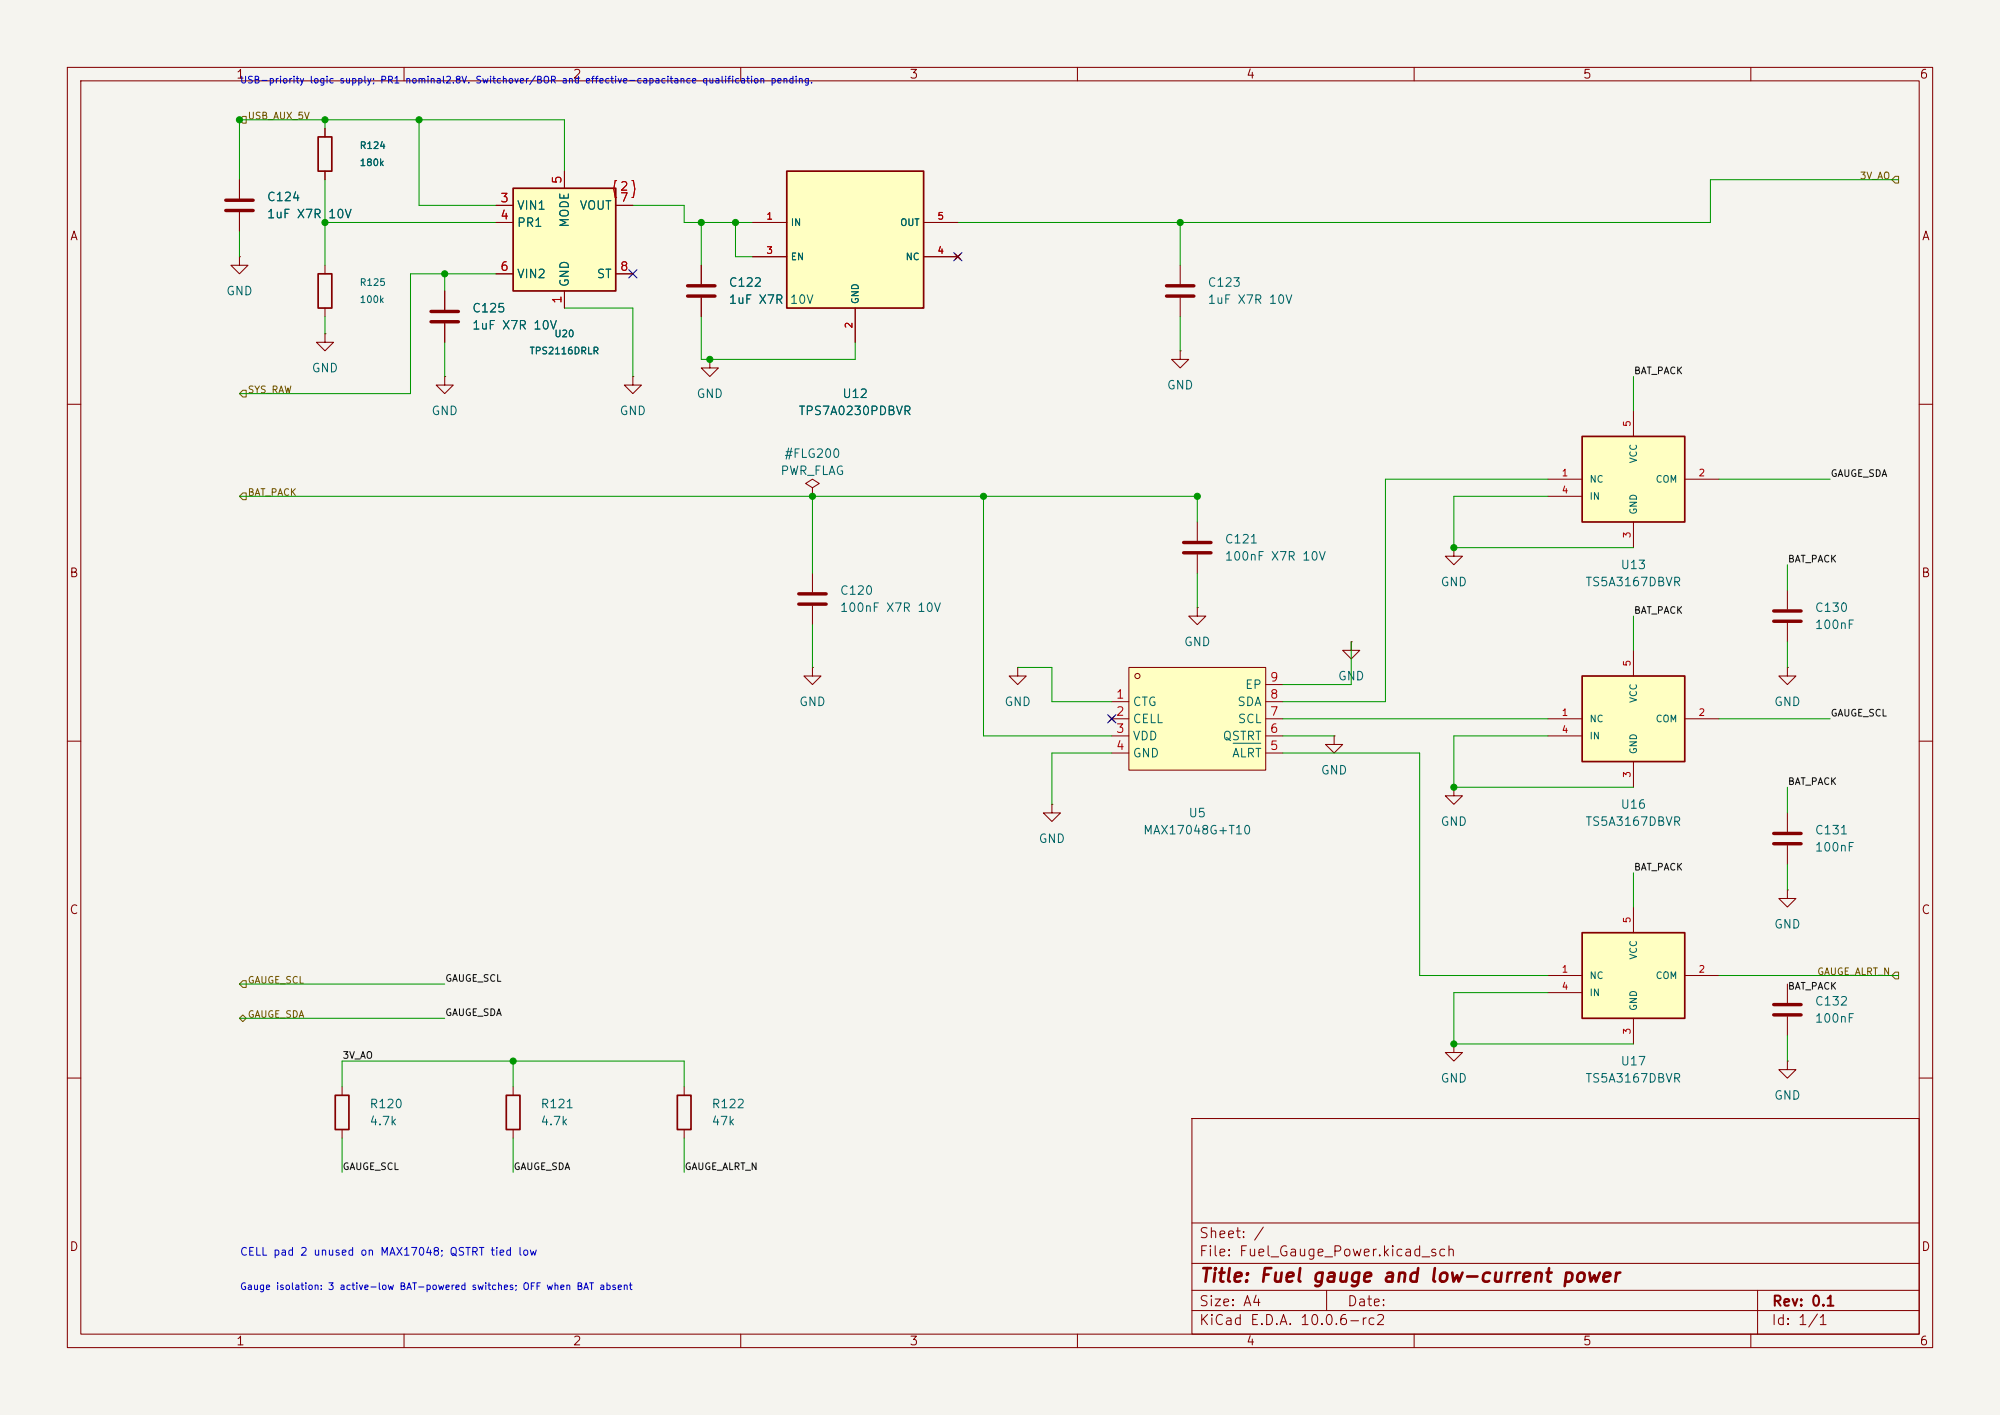
[picture p358: page 1]

Sheet: /
File: Fuel_Gauge_Power.kicad_sch
Title: Fuel gauge and low-current power

CELL pad 2 unused on MAX17048; QSTRT tied low

Gauge isolation: 3 active-low BAT-powered switches; OFF when BAT absent

Size: A4 | Rev: 0.1
KiCad E.D.A. 10.0.6-rc2 | Id: 1/1
