chithigun23/DesktopSpeaker/ai-files/candidates/reduced.pdf

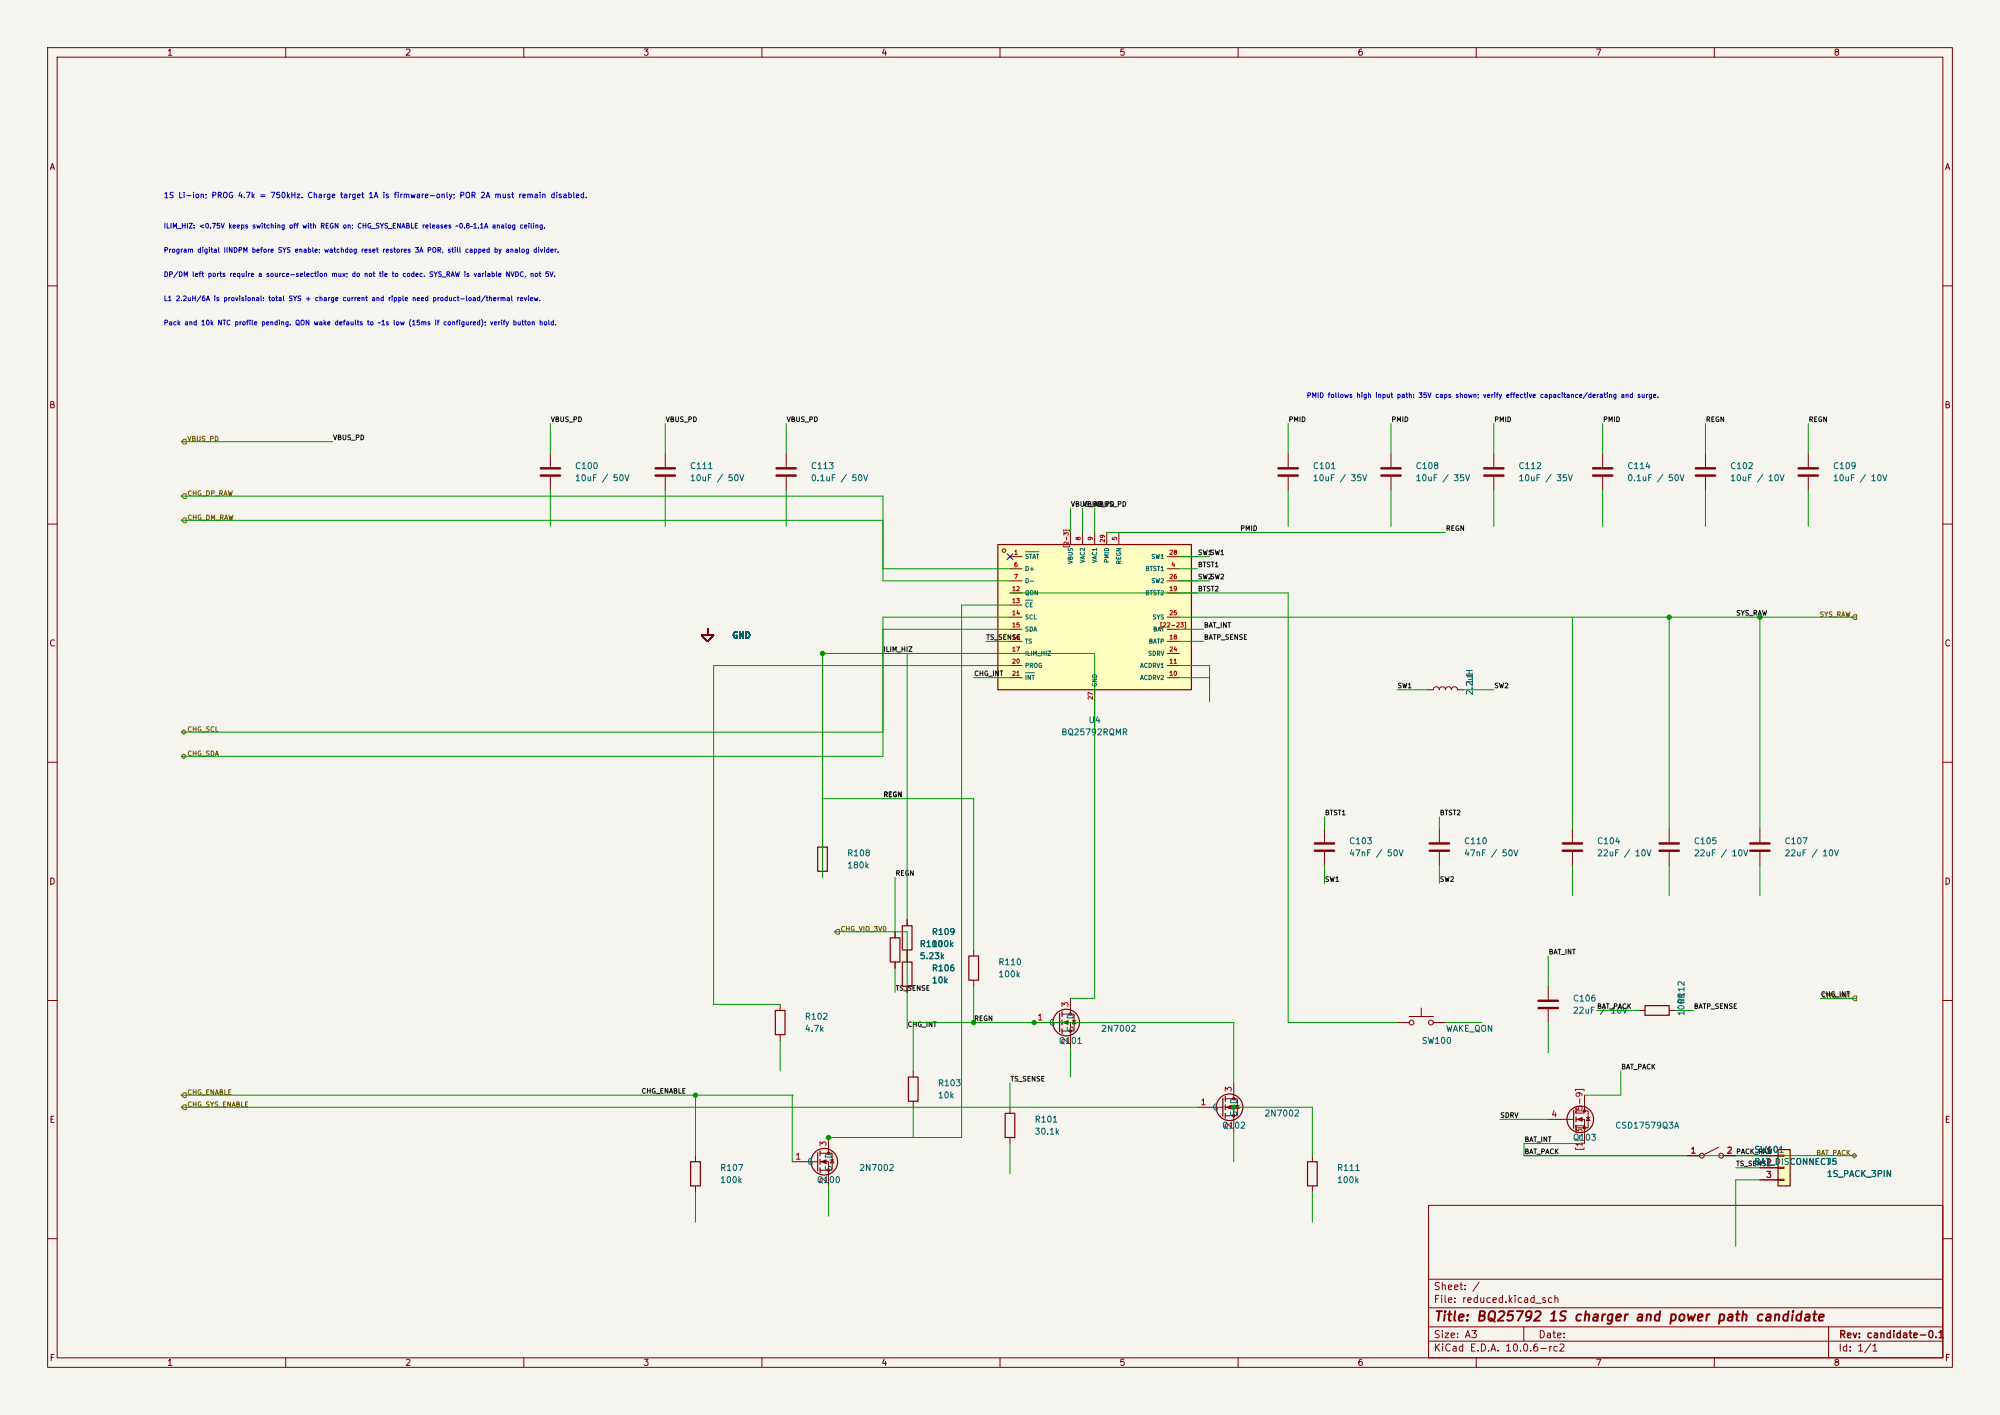
[picture p360: page 1]

ILIM_HIZ: <0.75V keeps switching off with REGN on; CHG_SYS_ENABLE releases ~0.8–1.1A analog ceiling. Program digital IINDPM before SYS enable; watchdog reset restores 3A POR, still capped by analog divider. DP/DM left ports require a source-selection mux; do not tie to codec. SYS_RAW is variable NVDC, not 5V. L1 2.2uH/6A is provisional: total SYS + charge current and ripple need product-load/thermal review. Pack and 10k NTC profile pending. QON wake defaults to ~1s low (15ms if configured); verify button hold.

Sheet: /
File: reduced.kicad_sch
Title: BQ25792 1S charger and power path candidate

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
