chithigun23/DesktopSpeaker/ai-files/reports/csd-stencil-review/footprint-review-large.pdf

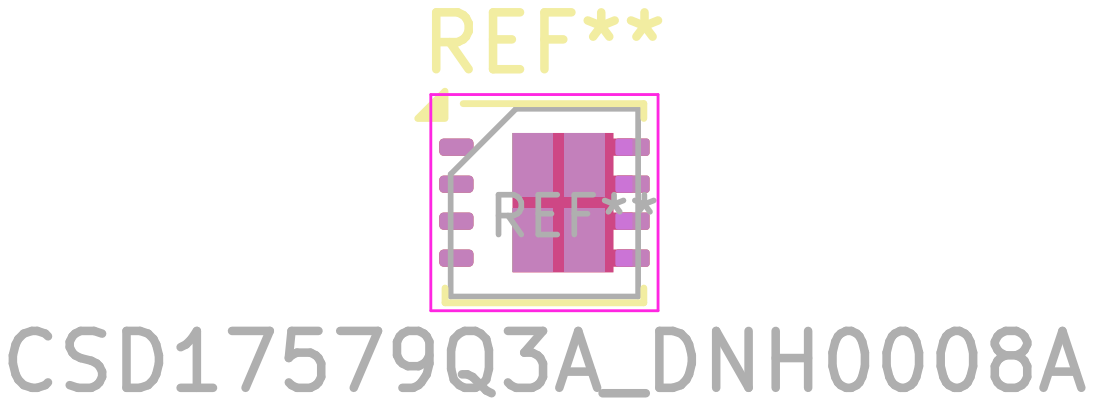
[picture p361: page 1]
