chithigun23/DesktopSpeaker/(list of files, drawings)

Other design files:
ai-files/cad/models-v13/downloads/easyeda_C124378/api.json
ai-files/cad/models-v13/downloads/easyeda_C160315/api.json
ai-files/cad/models-v13/downloads/easyeda_C165948/api.json
ai-files/cad/models-v13/downloads/easyeda_C202365/api.json
ai-files/cad/models-v13/downloads/easyeda_C238128/api.json
ai-files/cad/models-v13/downloads/easyeda_C264047/api.json
ai-files/cad/models-v13/downloads/easyeda_C503478/api.json
ai-files/cad/models-v13/downloads/easyeda_C1332316/api.json
ai-files/cad/models-v13/downloads/easyeda_C2939173/api.json
ai-files/cad/models-v13/downloads/easyeda_C2972219/api.json
ai-files/cad/models-v13/downloads/easyeda_C3911470/api.json
ai-files/cad/models-v13/downloads/easyeda_C7245133/api.json
ai-files/cad/work/pcb_estimate.json
ai-files/pcb/route-p0-batchA.dsn
ai-files/pcb/route-p0-batchB.dsn
ai-files/pcb/work-p1/A1-0.dsn
ai-files/pcb/work-p1/A1-0.in.dsn
ai-files/pcb/work-p1/A1-1.dsn
ai-files/pcb/work-p1/A1-1.in.dsn
ai-files/pcb/work-p1/A1-2.dsn
ai-files/pcb/work-p1/A1-2.in.dsn
ai-files/pcb/work-p1/A1-3.dsn
ai-files/pcb/work-p1/A1-3.in.dsn
ai-files/pcb/work-p1/A1-4.dsn
ai-files/pcb/work-p1/A1-4.in.dsn
ai-files/pcb/work-p1/A2-0.dsn
ai-files/pcb/work-p1/A2-0.in.dsn
ai-files/pcb/work-p1/A2-1.dsn
ai-files/pcb/work-p1/A2-1.in.dsn
ai-files/pcb/work-p1/A2-2.dsn
ai-files/pcb/work-p1/A2-2.in.dsn
ai-files/pcb/work-p1/B1-c1.dsn
ai-files/pcb/work-p1/B1-c1.in.dsn
ai-files/pcb/work-p1/B1-c2.dsn
ai-files/pcb/work-p1/B1-c2.in.dsn
ai-files/pcb/work-p1/B1-c3.dsn
ai-files/pcb/work-p1/B1-c3.in.dsn
ai-files/pcb/work-p1/B1-c4.dsn
ai-files/pcb/work-p1/B1-c4.in.dsn
ai-files/pcb/work-p1/B1-c5.dsn
ai-files/pcb/work-p1/B1-c5.in.dsn
ai-files/pcb/work-p1/B1-c6.dsn
ai-files/pcb/work-p1/B1-c6.in.dsn
ai-files/pcb/work-p1/B1-c7.dsn
ai-files/pcb/work-p1/B1-c7.in.dsn
ai-files/pcb/work-p1/B1-c8.dsn
ai-files/pcb/work-p1/B1-c8.in.dsn
ai-files/pcb/work-p1/B1-c9.dsn
ai-files/pcb/work-p1/B1-c9.in.dsn
ai-files/pcb/work-p1/B1-c10.dsn
ai-files/pcb/work-p1/B1-c10.in.dsn
ai-files/pcb/work-p1/B1-c11.dsn
ai-files/pcb/work-p1/B1-c11.in.dsn
ai-files/pcb/work-p1/B1-c12.dsn
ai-files/pcb/work-p1/B1-c12.in.dsn
ai-files/pcb/work-p1/B1-c13.dsn
ai-files/pcb/work-p1/B1-c13.in.dsn
ai-files/pcb/work-p1/B1-c14.dsn
ai-files/pcb/work-p1/B1-c14.in.dsn
ai-files/pcb/work-p1/B1-c15.dsn
ai-files/pcb/work-p1/B1-c15.in.dsn
ai-files/pcb/work-p1/B2-c1.dsn
ai-files/pcb/work-p1/B2-c1.in.dsn
ai-files/pcb/work-p1/B2-c2.dsn
ai-files/pcb/work-p1/B2-c2.in.dsn
ai-files/pcb/work-p1/B2-c3.dsn
ai-files/pcb/work-p1/B2-c3.in.dsn
ai-files/pcb/work-p1/B2-c4.dsn
ai-files/pcb/work-p1/B2-c4.in.dsn
ai-files/pcb/work-p1/B2-c5.dsn
ai-files/pcb/work-p1/B2-c5.in.dsn
ai-files/pcb/work-p1/B2-c6.dsn
ai-files/pcb/work-p1/B2-c6.in.dsn
ai-files/pcb/work-p1/B2-c7.dsn
ai-files/pcb/work-p1/B2-c7.in.dsn
ai-files/pcb/work-p1/B2-c8.dsn
ai-files/pcb/work-p1/B2-c8.in.dsn
ai-files/pcb/work-p1/B2-c9.dsn
ai-files/pcb/work-p1/B2-c9.in.dsn
ai-files/pcb/work-p1/B2-c10.dsn
ai-files/pcb/work-p1/B2-c10.in.dsn
ai-files/pcb/work-p1/B2-c11.dsn
ai-files/pcb/work-p1/B2-c11.in.dsn
ai-files/pcb/work-p1/B2-c12.dsn
ai-files/pcb/work-p1/B2-c12.in.dsn
ai-files/pcb/work-p1/B2-c13.dsn
ai-files/pcb/work-p1/B2-c13.in.dsn
ai-files/pcb/work-p1/B2-c14.dsn
ai-files/pcb/work-p1/B2-c14.in.dsn
ai-files/pcb/work-p1/B2-c15.dsn
ai-files/pcb/work-p1/B2-c15.in.dsn
ai-files/pcb/work-p1/B3-c1.dsn
ai-files/pcb/work-p1/B3-c1.in.dsn
ai-files/pcb/work-p1/B3-c2.dsn
ai-files/pcb/work-p1/B3-c2.in.dsn
ai-files/pcb/work-p1/B3-c3.dsn
ai-files/pcb/work-p1/B3-c3.in.dsn
ai-files/pcb/work-p1/B3-c4.dsn
ai-files/pcb/work-p1/B3-c4.in.dsn
ai-files/pcb/work-p1/B3-c5.dsn
ai-files/pcb/work-p1/B3-c5.in.dsn
ai-files/pcb/work-p1/B3-c6.dsn
ai-files/pcb/work-p1/B3-c6.in.dsn
ai-files/pcb/work-p1/B3-c7.dsn
ai-files/pcb/work-p1/B3-c7.in.dsn
ai-files/pcb/work-p1/B3-c8.dsn
ai-files/pcb/work-p1/B3-c8.in.dsn
ai-files/pcb/work-p1/B3-c9.dsn
ai-files/pcb/work-p1/B3-c9.in.dsn
ai-files/pcb/work-p1/B3-c10.dsn
ai-files/pcb/work-p1/B3-c10.in.dsn
ai-files/pcb/work-p1/B3-c11.dsn
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
