chithigun23/DesktopSpeaker/DesktopSpeaker-kicad/DesktopSpeaker.kicad_pcb

## KiCad design DesktopSpeaker-kicad/DesktopSpeaker.kicad_pcb (2026-10-12)

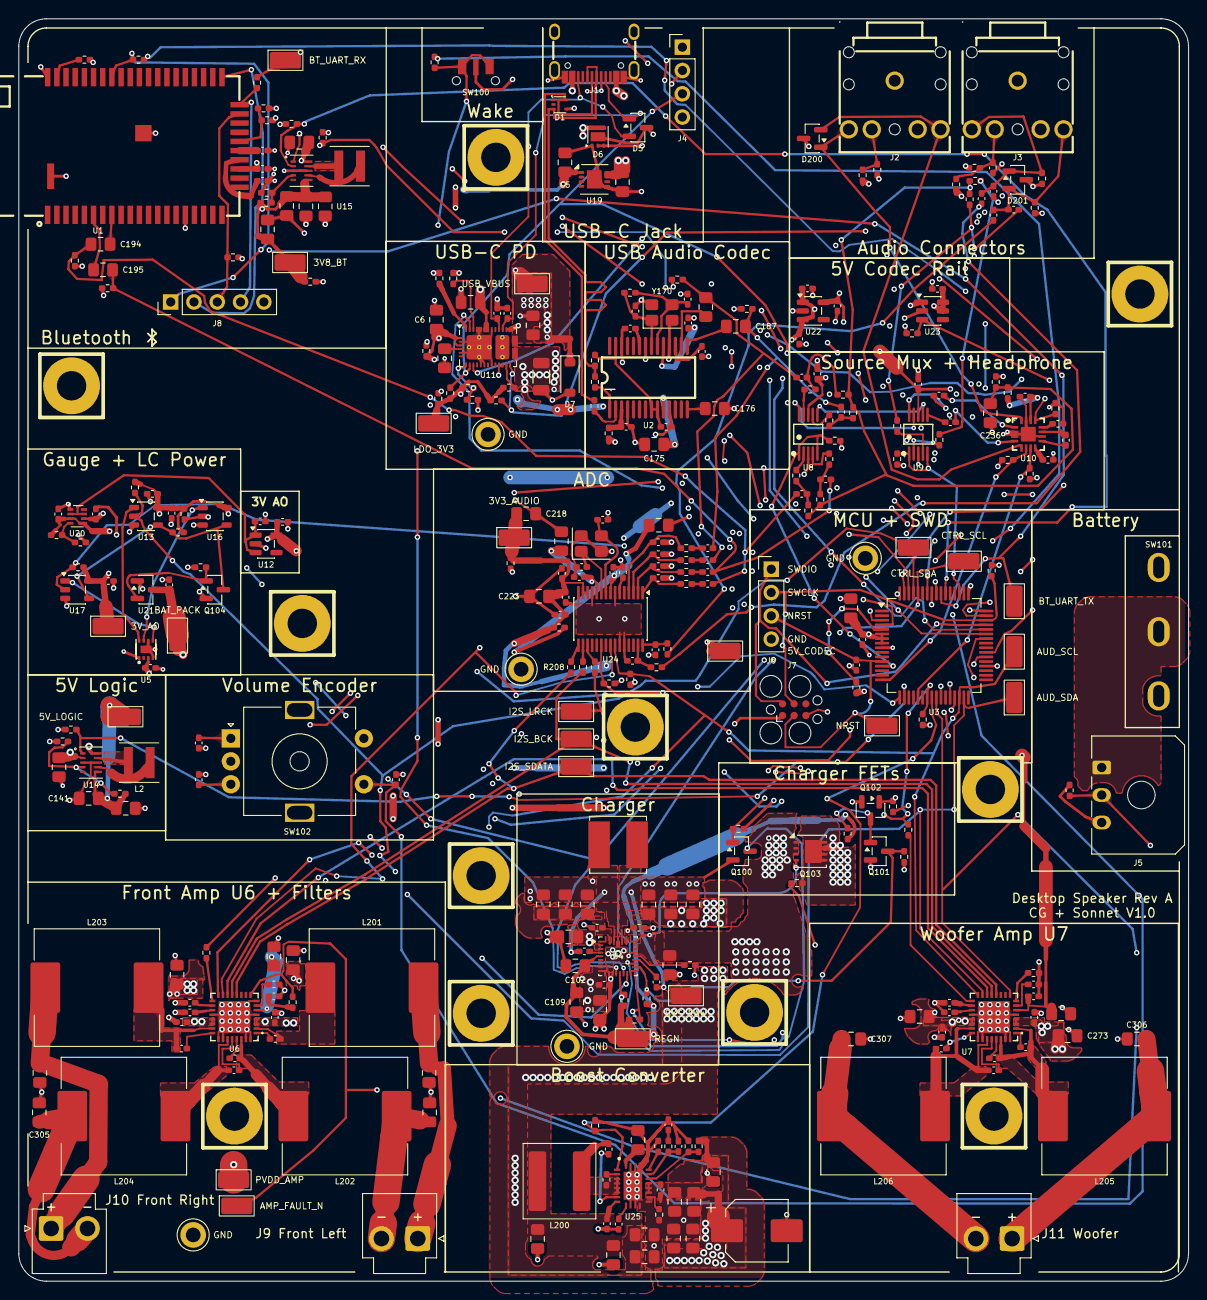
[picture p362: board DesktopSpeaker.kicad_pcb from above]

Board: 4 copper layers, 127.5 x 137.6 mm, 360 parts (1 on the bottom side), 208 nets.

Parts:
C2, C5: 4.7uF X7R 50V; C_0805_2012Metric_Pad1.18x1.45mm_HandSolder
C6: 22uF X7R 10V; C_0805_2012Metric_Pad1.18x1.45mm_HandSolder
C100, C101, C108, C111, C112: 10uF / 50V; C_0805_2012Metric_Pad1.18x1.45mm_HandSolder
C102, C109: 10uF / 10V; C_0805_2012Metric_Pad1.18x1.45mm_HandSolder
C103, C110: 47nF / 50V; C_0402_1005Metric_Pad0.74x0.62mm_HandSolder
C104, C105, C106, C107: 22uF / 10V; C_0805_2012Metric_Pad1.18x1.45mm_HandSolder
C120: 100nF X7R 10V; C_0402_1005Metric_Pad0.74x0.62mm_HandSolder
C122, C123, C124, C125: 1uF X5R 16V; C_0402_1005Metric_Pad0.74x0.62mm_HandSolder
C126, C130, C131, C132, C160, C162, C191, C213, C215, C217, C219, C237, C238, C246, C260, C267, C276, C278, C281, C289, C291, C294, C311, C312, C313, C314: 100nF; C_0402_1005Metric_Pad0.74x0.62mm_HandSolder
C140, C141, C142, C150, C152, C153, C154: 22uF 10V X7R; C_0805_2012Metric_Pad1.18x1.45mm_HandSolder
C161, C186, C187, C194, C195, C236, C280, C293: 4.7uF; C_0805_2012Metric_Pad1.18x1.45mm_HandSolder
C170, C171, C172, C173, C174, C192, C193, C212, C220, C221, C222, C224, C225, C230, C231, C232, C233, C234, C235, C239, C240, C245, C282, C283, C284, C295, C296, C297: 1uF; C_0402_1005Metric_Pad0.74x0.62mm_HandSolder
C175, C176, C190, C214, C216, C218, C223: 10uF; C_0805_2012Metric_Pad1.18x1.45mm_HandSolder
C177, C178: 33pF; C_0402_1005Metric_Pad0.74x0.62mm_HandSolder
C181: 10uF X7R 10V; C_0805_2012Metric_Pad1.18x1.45mm_HandSolder
C182: 330pF C0G CC1 filter; C_0402_1005Metric_Pad0.74x0.62mm_HandSolder
C183: 330pF C0G CC2 filter; C_0402_1005Metric_Pad0.74x0.62mm_HandSolder
C184, C316: 1uF X7R 50V; C_0805_2012Metric_Pad1.18x1.45mm_HandSolder
C200, C201, C202, C203, C204, C205, C241, C243, C244: 2.2uF; C_0402_1005Metric_Pad0.74x0.62mm_HandSolder
C206, C207, C208, C209, C210, C211: 10nF C0G; C_0402_1005Metric_Pad0.74x0.62mm_HandSolder
C226, C227: 15pF C0G; C_0402_1005Metric_Pad0.74x0.62mm_HandSolder
C261, C262, C263, C264: 22uF 10V; C_0805_2012Metric_Pad1.18x1.45mm_HandSolder
C265: 2.2uF; C_0805_2012Metric_Pad1.18x1.45mm_HandSolder
C266: 47nF; C_0402_1005Metric_Pad0.74x0.62mm_HandSolder
C268: 6.8nF; C_0402_1005Metric_Pad0.74x0.62mm_HandSolder
C269: 47pF; C_0402_1005Metric_Pad0.74x0.62mm_HandSolder
C270: 1uF; C_0805_2012Metric_Pad1.18x1.45mm_HandSolder
C271, C272, C273, C274, C277, C279, C290, C292: 22uF 25V; C_0805_2012Metric_Pad1.18x1.45mm_HandSolder
C275: 100uF 25V; CP_Elec_8x10
C285, C286, C287, C288, C298, C299, C300, C301: 0.47uF; C_0402_1005Metric_Pad0.74x0.62mm_HandSolder
C302, C303, C304, C305, C306, C307: 0.68uF 50V; C_0805_2012Metric_Pad1.18x1.45mm_HandSolder
C308, C309, C310: 10nF; C_0402_1005Metric_Pad0.74x0.62mm_HandSolder
C315: 47uF 25V; PD_C_1206
D1: TPD2E2U06DRLR
D5: ESDA25L
D6: TVS2200DRVR
D7: 1N5819HW; PD_D_SOD123
D200, D201: PESD5V0S2BT
FB200: BLM15AG601SN1D; R_0402_1005Metric_Pad0.72x0.64mm_HandSolder
H1, H2, H3, H4, H5, H6, H7, H8, H9: M3 PTH GND; MountingHole_3.2mm_M3_PTH_GND
HA1, HA2: M3 PTH GND; MountingHole_3.2mm_M3_PTH_GND
J1: USB_C_Receptacle_USB2.0_16P; TYPE-C-31-M-12
J2: HEAD_OUT; PJ-307
J3: AUX_IN; PJ-307
J4: I2C service; PD_SERVICE_HDR
J5: 1S_PACK_3PIN; Molex_Micro-Fit_3.0_43650-0300_1x03_P3.00mm_Horizontal
J6: SWD; PinHeader_1x04_P2.54mm_Vertical
J7: SWD_TC2030; Tag-Connect_TC2030-IDC-FP_2x03_P1.27mm_Vertical
J8: BM83_PROG; PinHeader_1x05_P2.54mm_Vertical
J9, J10, J11: B2P-VH; JST_B2P_VH_1x02_P3.96mm_Vertical
L1: 2.2uH; Bourns_SRN6045TA-2R2Y
L2, L3: 0.47uH; Coilcraft_XFL4015-471MEC
L200: 2.2uH; L_Coilcraft_XAL7070-XXX
L201, L202, L203, L204, L205, L206: 22uH; L_Sunlord_MWSA1265S
LOGO1: Orwellian Industries; Logo_Orwellian
Q100, Q101, Q102, Q104: 2N7002
Q103: CSD17579Q3A; CSD17579Q3A_DNH0008A
R10: 200k 1%; R_0402_1005Metric_Pad0.72x0.64mm_HandSolder
R11, R13, R14, R15, R18: 10k 1%; R_0402_1005Metric_Pad0.72x0.64mm_HandSolder
R12, R16, R17: 100k 1%; R_0402_1005Metric_Pad0.72x0.64mm_HandSolder
R100: 5.23k; R_0402_1005Metric_Pad0.72x0.64mm_HandSolder
R101: 30.1k; R_0402_1005Metric_Pad0.72x0.64mm_HandSolder
R102, R120, R121: 4.7k; R_0402_1005Metric_Pad0.72x0.64mm_HandSolder
R103, R107, R109, R110, R111, R113, R125, R142, R152, R153, R154, R160, R175, R176, R180, R181, R184, R211, R212, R220, R221, R222, R223, R224, R225, R234, R235, R236, R237, R238, R239, R255, R259: 100k; R_0402_1005Metric_Pad0.72x0.64mm_HandSolder
R106, R182, R183, R242, R243, R244, R262: 10k; R_0402_1005Metric_Pad0.72x0.64mm_HandSolder
R108, R124: 180k; R_0402_1005Metric_Pad0.72x0.64mm_HandSolder
R112: 100R; R_0402_1005Metric_Pad0.72x0.64mm_HandSolder
R122, R232, R233: 47k; R_0402_1005Metric_Pad0.72x0.64mm_HandSolder
R126, R127, R174, R241: 1M; R_0402_1005Metric_Pad0.72x0.64mm_HandSolder
R140: 78.7k 1%; R_0402_1005Metric_Pad0.72x0.64mm_HandSolder
R141: 9.1k 1%; R_0402_1005Metric_Pad0.72x0.64mm_HandSolder
R150: 604k 1%; R_0402_1005Metric_Pad0.72x0.64mm_HandSolder
R151: 91k 1%; R_0402_1005Metric_Pad0.72x0.64mm_HandSolder
R170: 2.2; R_0402_1005Metric_Pad0.72x0.64mm_HandSolder
R171, R172: 22; R_0402_1005Metric_Pad0.72x0.64mm_HandSolder
R173: 1.5k; R_0402_1005Metric_Pad0.72x0.64mm_HandSolder
R185, R186, R187, R226, R227, R228, R229, R230, R231, R240, R257, R258, R261: 1k; R_0402_1005Metric_Pad0.72x0.64mm_HandSolder
R200, R201, R202, R203, R204, R205: 100; R_0402_1005Metric_Pad0.72x0.64mm_HandSolder
R206, R207, R208: 33; R_0402_1005Metric_Pad0.72x0.64mm_HandSolder
R209, R210: 2.2k; R_0402_1005Metric_Pad0.72x0.64mm_HandSolder
R250: 499k; R_0402_1005Metric_Pad0.72x0.64mm_HandSolder
R251: 56k; R_0402_1005Metric_Pad0.72x0.64mm_HandSolder
R252: 301k; R_0402_1005Metric_Pad0.72x0.64mm_HandSolder
R253: 150k; R_0402_1005Metric_Pad0.72x0.64mm_HandSolder
R254: 82k; R_0402_1005Metric_Pad0.72x0.64mm_HandSolder
R256: 0R DNP; R_0402_1005Metric_Pad0.72x0.64mm_HandSolder
SW100: WAKE_QON; TE_1977066-1_Tact_RA_SMD
SW101: BAT_DISCONNECT; SHOUHAN_KCD1-201-R_Rocker_D20_Panel
SW102: EC11E; RotaryEncoder_Alps_EC11E-Switch_Vertical_H20mm_MountingHoles
TP1: USB_VBUS; TestPoint_Keystone_5015_Micro_Mini
TP2: SYS_RAW; TestPoint_Keystone_5015_Micro_Mini
TP3: BAT_PACK; TestPoint_Keystone_5015_Micro_Mini
TP4: 3V_AO; TestPoint_Keystone_5015_Micro_Mini
TP5: LDO_3V3; TestPoint_Keystone_5015_Micro_Mini
TP6: 3V3_AUDIO; TestPoint_Keystone_5015_Micro_Mini
TP7: 5V_LOGIC; TestPoint_Keystone_5015_Micro_Mini
TP8: 5V_CODEC; TestPoint_Keystone_5015_Micro_Mini
TP9: 3V8_BT; TestPoint_Keystone_5015_Micro_Mini
TP10: PVDD_AMP; TestPoint_Keystone_5015_Micro_Mini
TP11: REGN; TestPoint_Keystone_5015_Micro_Mini
TP12: I2S_BCK; TestPoint_Keystone_5015_Micro_Mini
TP13: I2S_LRCK; TestPoint_Keystone_5015_Micro_Mini
TP14: I2S_SDATA; TestPoint_Keystone_5015_Micro_Mini
TP15: CTRL_SDA; TestPoint_Keystone_5015_Micro_Mini
TP16: CTRL_SCL; TestPoint_Keystone_5015_Micro_Mini
TP17: AUD_SDA; TestPoint_Keystone_5015_Micro_Mini
TP18: AUD_SCL; TestPoint_Keystone_5015_Micro_Mini
TP19: NRST; TestPoint_Keystone_5015_Micro_Mini
TP20: AMP_FAULT_N; TestPoint_Keystone_5015_Micro_Mini
TP21: BT_UART_TX; TestPoint_Keystone_5015_Micro_Mini
TP22: BT_UART_RX; TestPoint_Keystone_5015_Micro_Mini
TP23, TP24, TP25, TP26, TP27: GND; TestPoint_Keystone_5010-5014_Multipurpose
U1: BM83SM1-00TA
U2: PCM2902CDBR
U3: STM32G071RBT6
U4: BQ25792RQMR
U5: MAX17048G+T10
U6, U7: TAS5825MRHBR
U8, U9: TS5A23157DGSR
U10: TPA6132A2RTER
U11: TPS25730DREFR; TPS25730D
U12: TPS7A0230PDBVR
U13, U16, U17: TS5A3167DBVR
U14, U15: TPS63802DLAR
U19: TPS7B8450QWDRBRQ1; TPS7B8450QWDRBRQ1_WSON-8
U20: TPS2116DRLR
U21: TPS3839G33DBZR
U22: TPS7A2033PDBVR
U23: TPS22917DBVR
U24: PCM1862DBTR
U25: TPS61088RHLR
Y170: 12MHz; Crystal_SMD_3225-4Pin_3.2x2.5mm
Y200: 24.576MHz; Crystal_SMD_3225-4Pin_3.2x2.5mm

Connections:
/3V3_AUDIO: C217.1, C218.1, C219.1, C220.1, C222.1, C223.1, C237.1, C238.1, C241.1, C280.1, C281.1, C293.1, C294.1, FB200.1, R209.1, R210.1, R232.1, R239.1, R262.1, TP6.1, U6.6, U7.6, U8.8, U9.8, U10.14, U22.5, U24.13, U24.14
/3V8_BT: C152.1, C153.1, C154.1, C190.1, C191.1, R150.1, R154.1, TP9.1, U1.23, U15.6
/3V_AO: C123.1, C130.1, C131.1, C132.1, C160.1, C161.1, J7.1, R106.1, R120.1, R121.1, R122.1, R126.1, R241.1, TP4.1, U3.6, U3.7, U3.8, U12.5, U13.5, U16.5, U17.5
/5V_CODEC: C225.1, R170.1, TP8.1, U23.5, U23.6
/5V_LOGIC: C141.1, C142.1, C221.1, C224.1, R140.1, TP7.1, U14.6, U22.1, U22.3, U23.1
/5V_LOGIC_EN: R142.1, U3.18, U14.1
/ADC_INT: R211.1, U3.26, U24.21
/AMP_BOOST_EN: R255.1, U3.24, U25.2
/AMP_FAULT_N: R262.2, TP20.1, U3.25, U6.9, U7.9
/AMP_PDN: R257.1, R258.1, R259.1, U3.23
/AUD_SCL: R209.2, TP18.1, U3.30, U6.16, U7.16, U24.24
/AUD_SDA: R210.2, TP17.1, U3.31, U6.15, U7.15, U24.23
/AUX_DET: R242.2, U3.29
/AUX_L: C204.1, C234.1, D201.1, J3.5, R243.1
/AUX_R: C205.1, C235.1, D201.2, J3.2, R244.1
/Amplifiers/PVDD_AMP: C270.1, C271.1, C272.1, C273.1, C274.1, C275.1, C276.1, C277.1, C278.1, C279.1, C289.1, C290.1, C291.1, C292.1, C314.1, R250.1, TP10.1, U6.3, U6.4, U6.21, U6.22, U7.3, U7.4, U7.21, U7.22, U25.14, U25.15, U25.16
/BT_AUDIO_L: C194.2, C202.1, C232.1, R180.1
/BT_AUDIO_R: C195.2, C203.1, C233.1, R181.1
/BT_FORCE_PWM: R153.1, U3.54, U15.2
/BT_MFB: R183.1, U3.57
/BT_PWR_EN: R152.1, U3.36, U15.1
/BT_RST_N: R185.1, U3.58
/BT_TX_IND: R187.2, U3.62
/BT_UART_RX: R186.2, TP22.1, U3.56
/BT_UART_TX: R182.1, TP21.1, U3.55
/Battery_Charger/BAT_INT: C106.1, Q103.1, Q103.2, Q103.3, U4.22, U4.23
/Battery_Charger/BTST1: C103.1, U4.4
/Battery_Charger/BTST2: C110.1, U4.19
/Battery_Charger/CE_N: Q100.3, R103.2, U4.13
/Battery_Charger/ILIM_HIZ: Q101.3, R108.2, R109.1, U4.17
/Battery_Charger/PACK_RAW: J5.1, SW101.2
/Battery_Charger/PMID: C101.1, C108.1, C112.1, C312.1, U4.29
/Battery_Charger/PROG: R102.1, U4.20
/Battery_Charger/REGN: C102.1, C109.1, R100.1, R103.1, R108.1, R110.1, TP11.1, U4.5
/Battery_Charger/SW1: C103.2, L1.1, U4.28
/Battery_Charger/SW2: C110.2, L1.2, U4.26
/Battery_Charger/TS_SENSE: J5.2, R100.2, R101.1, U4.16
/Battery_Charger/VBUS_PD: C100.1, C111.1, C313.1, C315.1, U4.2, U4.3, U4.8, U4.9, U11.20
/Bluetooth/BT_RST_M: J8.1, R185.2, U1.43
/Bluetooth/BT_RXD_M: J8.3, R182.2, U1.29
/Bluetooth/BT_SYS_CFG: J8.2, U1.31
/Bluetooth/BT_TXD_M: J8.4, R186.1, U1.30
/CHG_ENABLE: Q100.1, R107.1, U3.38
/CHG_INT: R106.2, U3.5, U4.21
/CHG_QON_SENSE: R113.2, U3.3
/CHG_SYS_ENABLE: Q102.1, R111.1, U3.42
/CODEC_PWR_EN: R212.1, U3.39, U23.3
/CTRL_SCL: R120.2, TP16.1, U3.60, U4.14, U16.2
/CTRL_SDA: R121.2, TP15.1, U3.61, U4.15, U13.2
/Fuel_Gauge_Power/BAT_PACK: C120.1, C126.1, Q103.5, Q103.6, Q103.7, Q103.8, Q103.9, R112.1, SW101.1, TP3.1, U5.3, U21.3
/Fuel_Gauge_Power/GAUGE_ISO_N: Q104.3, R126.2, U13.4, U16.4, U17.4
/Fuel_Gauge_Power/USB_AUX_5V: C5.1, C124.1, R124.1, U19.1, U20.3, U20.5
/GAUGE_ALRT_N: R122.2, U3.17, U17.2
/HP_DET: R240.2, U3.28
/HP_EN: R236.1, U3.47, U10.13
/HP_G0: R237.1, U3.16, U10.6
/HP_G1: R238.1, U3.21, U10.7
/HP_SEL_A: R234.1, U3.13, U8.1, U8.5
/HP_SEL_B: R235.1, U3.51, U9.1, U9.5
/Headphone_Aux/AUX_TIPSW: C246.1, J3.4, R241.2, R242.1
/Headphone_Aux/HP_L: C239.1, U9.10
/Headphone_Aux/HP_OUTL: D200.1, J2.5, U10.16
/Headphone_Aux/HP_OUTR: D200.2, J2.2, U10.5
/Headphone_Aux/HP_R: C240.1, U9.6
/Headphone_Aux/HP_TIPSW: J2.4, R239.2, R240.1
/Headphone_Aux/VMID_HP: C236.1, R220.2, R221.2, R222.2, R223.2, R224.2, R225.2, R232.2, R233.1
/I2S_BCK: R207.2, TP12.1, U6.13, U7.13
/I2S_LRCK: R208.2, TP14.1, U6.12, U7.12
/I2S_SDATA: R206.2, TP13.1, U6.14, U7.14
/MCU/ENC_A: C308.1, SW102.A, U3.48
/MCU/ENC_B: C309.1, SW102.B, U3.49
/MCU/ENC_SW: C310.1, SW102.S1, U3.64
/MCU/NRST: C162.1, J6.3, J7.3, TP19.1, U3.12
/MCU/SWCLK: J6.2, J7.4, R160.1, U3.46
/MCU/SWDIO: J6.1, J7.2, U3.45
/PDCTRL_SCL: J4.2, R15.2, U3.43, U11.9
/PDCTRL_SDA: J4.3, R14.2, U3.44, U11.8
/PD_PLUG_EVENT: R16.1, U3.4, U11.37
/PD_SINK_EN: R17.2, U3.63, U11.19
/SYS_RAW: C104.1, C105.1, C107.1, C125.1, C140.1, C150.1, C260.1, C261.1, C262.1, C263.1, C264.1, C311.1, L200.1, TP2.1, U4.25, U14.2, U14.10, U15.10, U20.6, U25.9
/USB_AUDIO_L: C186.2, C200.1, C230.1, R175.1
/USB_AUDIO_R: C187.2, C201.1, C231.1, R176.1
/USB_CC1: C182.1, D5.1, J1.A5, U11.28
/USB_CC2: C183.1, D5.2, J1.B5, U11.29
/USB_DN: D1.5, J1.A7, J1.B7, R172.1
/USB_DP: D1.3, J1.A6, J1.B6, R171.1, R173.1
/USB_PD/LDO_1V5: C181.1, U11.4
/USB_PD/LDO_3V3: C6.1, J4.1, R10.1, R13.1, R14.1, R15.1, R16.2, R17.1, TP5.1, U11.1, U11.3
/USB_PD/VIN_LOW: R12.1, U11.38
/USB_VBUS: C2.1, C184.1, C316.1, D6.4, D6.5, D6.6, D7.1, J1.A4B9, J1.B4A9, TP1.1, U11.23, U11.32, U19.7, U19.8
GND: C2.2, C5.2, C6.2, C100.2, C101.2, C102.2, C104.2, C105.2, C106.2, C107.2, C108.2, C109.2, C111.2, C112.2, C120.2, C122.2, C123.2, C124.2, C125.2, C126.2, C130.2, C131.2, C132.2, C140.2, C141.2, C142.2, C150.2, C152.2, C153.2, C154.2, C160.2, C161.2, C162.2, C170.2, C171.2, C172.2, C173.2, C174.2, C175.2, C176.2, C177.2, C178.2, C181.2, C182.2, C183.2, C184.2, C190.2, C191.2, C192.2, C193.2, C206.2, C207.2, C208.2, C209.2, C210.2, C211.2, C212.2, C213.2, C214.2, C215.2, C216.2, C217.2, C218.2, C219.2, C220.2, C221.2, C222.2, C223.2, C224.2, C225.2, C226.2, C227.2, C236.2, C237.2, C238.2, C241.2, C243.2, C244.2, C246.2, C260.2, C261.2, C262.2, C263.2, C264.2, C265.2, C266.2, C268.2, C269.2, C270.2, C271.2, C272.2, C273.2, C274.2, C275.2, C276.2, C277.2, C278.2, C279.2, C280.2, C281.2, C282.2, C283.2, C284.2, C289.2, C290.2, C291.2, C292.2, C293.2, C294.2, C295.2, C296.2, C297.2, C302.2, C303.2, C304.2, C305.2, C306.2, C307.2, C308.2, C309.2, C310.2, C311.2, C312.2, C313.2, C314.2, C315.2, C316.2, D1.4, D5.3, D6.1, D6.2, D6.3, D6.7, D7.2, D200.3, D201.3, H1.1, H2.1, H3.1, H4.1, H5.1, H6.1, H7.1, H8.1, H9.1, HA1.1, HA2.1, J1.1, J1.2, J1.3, J1.4, J1.A1B12, J1.B1A12, J2.1, J3.1, J4.4, J5.3, J6.4, J7.5, J8.5, Q100.2, Q101.2, Q102.2, Q104.2, R11.2, R12.2, R18.2, R101.2, R102.2, R107.2, R109.2, R111.2, R125.2, R127.2, R141.2, R142.2, R151.2, R152.2, R153.2, R154.2, R160.2, R175.2, R176.2, R180.2, R181.2, R184.2, R211.2, R212.2, R233.2, R234.2, R235.2, R236.2, R237.2, R238.2, R243.2, R244.2, R251.2, R253.2, R255.2, R256.2, R259.2, R261.1, SW100.2, SW102.C, SW102.MP, SW102.S2, TP23.1, TP24.1, TP25.1, TP26.1, TP27.1, U1.16, U1.50, U1.56, U1.57, U2.4, U2.11, U2.18, U2.22, U2.26, U3.9, U4.10, U4.11, U4.27, U5.1, U5.4, U5.6, U5.9, U6.5, U6.8, U6.20, U6.25, U6.26, U6.31, U6.32, U6.33, U7.5, U7.20, U7.25, U7.26, U7.31, U7.32, U7.33, U8.3, U9.3, U10.2, U10.3, U10.10, U10.15, U10.17, U11.2, U11.5, U11.11, U11.12, U11.14, U11.16, U11.17, U11.26, U11.27, U11.31, U11.34, U11.39, U12.2, U13.3, U14.3, U14.8, U15.3, U15.8, U16.3, U17.3, U19.5, U19.9, U20.1, U21.1, U22.2, U23.2, U24.7, U24.12, U24.15, U24.25, U24.26, U25.11, U25.12, U25.20, U25.21, Y170.2, Y170.4, Y200.2, Y200.4
unnamed: C200.2, R200.1
unnamed: C201.2, R201.1
unnamed: C202.2, R202.1
unnamed: C203.2, R203.1
unnamed: C204.2, R204.1
unnamed: C205.2, R205.1
unnamed: C230.2, R220.1, R226.1
unnamed: C231.2, R221.1, R227.1
unnamed: C232.2, R222.1, R228.1
unnamed: C233.2, R223.1, R229.1
unnamed: C234.2, R224.1, R230.1
unnamed: C235.2, R225.1, R231.1
unnamed: C268.1, R254.2
unnamed: C302.1, J9.1, L201.2
unnamed: C303.1, J9.2, L202.2
unnamed: C304.1, J10.1, L203.2
unnamed: C305.1, J10.2, L204.2
unnamed: C306.1, J11.1, L205.2
unnamed: C307.1, J11.2, L206.2
unnamed: Q101.1, Q102.3, R110.2
unnamed: Q103.4, U4.24
unnamed: Q104.1, R127.1, U21.2
unnamed: R18.1, U11.36
unnamed: C194.1, U1.8
unnamed: C195.1, U1.6
unnamed: R187.1, U1.49
unnamed: R183.2, R184.1, U1.26
unnamed: C193.1, U1.24
unnamed: C192.1, U1.25
unnamed: R171.2, U2.1
unnamed: R172.2, U2.2
unnamed: C171.1, R173.2, U2.8, U2.9, U2.27
unnamed: C170.1, R170.2, U2.3
unnamed: C175.1, U2.10
unnamed: C174.1, U2.17
unnamed: C173.1, U2.19
unnamed: C172.1, U2.23
unnamed: C176.1, U2.14
unnamed: C186.1, U2.16
unnamed: C187.1, U2.15
unnamed: C177.1, R174.1, U2.21, Y170.1
unnamed: C178.1, R174.2, U2.20, Y170.3
unnamed: R112.2, U4.18
unnamed: R113.1, SW100.1, U4.12
unnamed: C284.1, U6.19
unnamed: C285.1, U6.1
unnamed: C286.2, U6.29
unnamed: C287.1, U6.24
unnamed: C288.2, U6.28
unnamed: C283.1, U6.18
unnamed: C285.2, L201.1, U6.2
unnamed: C286.1, L202.1, U6.30
unnamed: C287.2, L203.1, U6.23
unnamed: C288.1, L204.1, U6.27
unnamed: C282.1, U6.7
unnamed: R257.2, U6.17
unnamed: R261.2, U7.8
unnamed: C297.1, U7.19
unnamed: C298.1, U7.1
unnamed: C299.2, U7.29
unnamed: C300.1, U7.24
unnamed: C301.2, U7.28
unnamed: C296.1, U7.18
unnamed: C298.2, C299.1, L205.1, U7.2, U7.30
unnamed: C300.2, C301.1, L206.1, U7.23, U7.27
unnamed: C295.1, U7.7
unnamed: R258.2, U7.17
unnamed: U8.10, U9.9
unnamed: U8.6, U9.7
unnamed: R226.2, U8.9
unnamed: R227.2, U8.7
unnamed: R228.2, U8.2
unnamed: R229.2, U8.4
unnamed: R230.2, U9.2
unnamed: R231.2, U9.4
unnamed: C245.2, U10.9
unnamed: C245.1, U10.11
unnamed: C243.1, U10.12
unnamed: C244.1, U10.8
unnamed: C239.2, U10.1
unnamed: C240.2, U10.4
unnamed: R10.2, R11.1, U11.7
unnamed: R13.2, U11.18
unnamed: C122.1, U12.1, U12.3, U20.2, U20.7
unnamed: U5.8, U13.1
unnamed: R140.2, R141.1, U14.4
unnamed: L2.1, U14.9
unnamed: L2.2, U14.7
unnamed: R150.2, R151.1, U15.4
unnamed: L3.1, U15.9
unnamed: L3.2, U15.7
unnamed: U5.7, U16.1
unnamed: U5.5, U17.1
unnamed: R124.2, R125.1, U20.4
unnamed: C215.1, C216.1, FB200.2, U24.8
unnamed: R207.1, U24.17
unnamed: R206.1, U24.18
unnamed: C213.1, C214.1, U24.11
unnamed: R208.1, U24.16
unnamed: C206.1, R200.2, U24.3
unnamed: C208.1, R202.2, U24.1
unnamed: C210.1, R204.2, U24.29
unnamed: C207.1, R201.2, U24.4
unnamed: C209.1, R203.2, U24.2
unnamed: C211.1, R205.2, U24.30
unnamed: C212.1, U24.6
unnamed: C226.1, U24.10, Y200.1
unnamed: C227.1, U24.9, Y200.3
unnamed: C267.1, U25.8
unnamed: C269.1, R254.1, U25.18
unnamed: R250.2, R251.1, U25.17
unnamed: R252.1, U25.3
unnamed: R253.1, U25.19
unnamed: R256.1, U25.13
unnamed: C266.1, U25.10
unnamed: C267.2, L200.2, R252.2, U25.4, U25.5, U25.6, U25.7
unnamed: C265.1, U25.1
