chithigun23/DesktopSpeaker/ai-files/candidates/Battery_Charger.kicad_sch

## KiCad design ai-files/candidates/Battery_Charger.kicad_sch (2026-10-05)

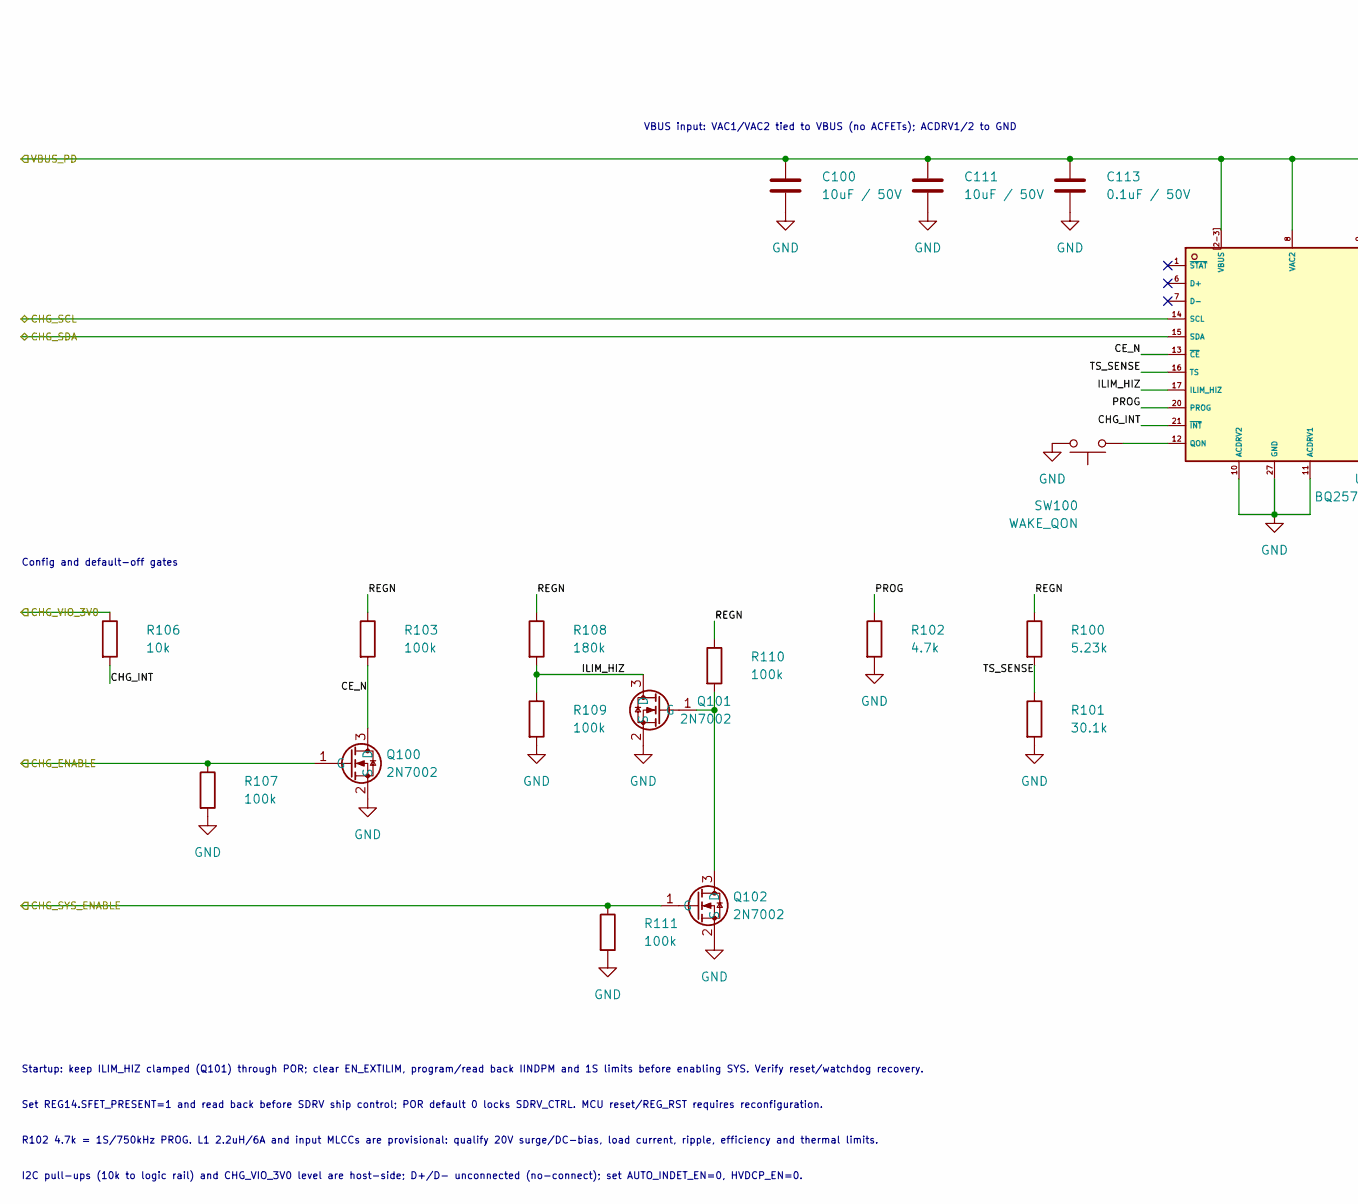
[picture p363: schematic Battery_Charger.kicad_sch, part in row 1, column 1]

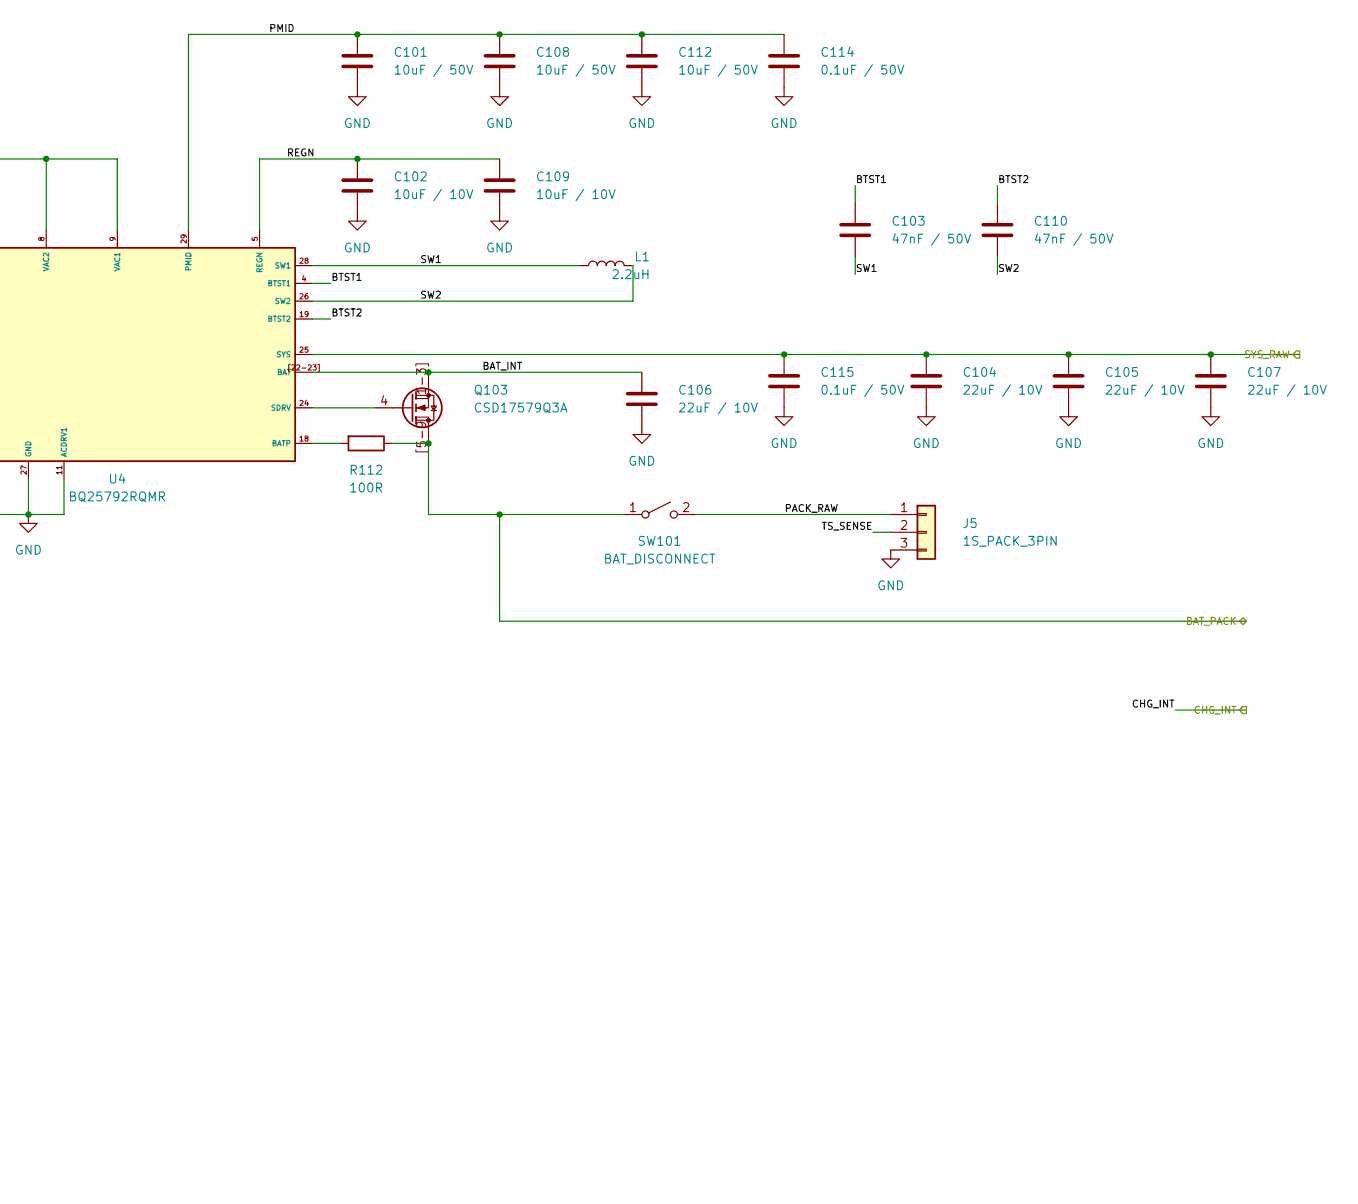
[picture p364: schematic Battery_Charger.kicad_sch, part in row 1, column 2]

Parts:
C100, C101, C108: 10uF / 50V; PD_C_1210; MPN CL32B106KBJNNNE; LCSC Part C138687
C102, C109: 10uF / 10V; PD_C_0805; MPN CL21B106KPQNNNE; LCSC Part C32635
C103, C110: 47nF / 50V; PD_C_0603; MPN CC0603KRX7R9BB473; LCSC C107093
C104, C105, C106, C107: 22uF / 10V; PD_C_0805; MPN GRM21BZ71A226ME15L; LCSC Part C907991
C111, C112: 10uF / 50V; PD_C_1210; MPN CL32B106KBJNNNE; LCSC C138687
C113, C114, C115: 0.1uF / 50V; PD_C_0402; MPN GRM155R71H104KE14D; LCSC C77020
J5: 1S_PACK_3PIN; JST_B3P_VH_1x03_P3.96mm_Vertical
L1: 2.2uH; SRN6045TA-2R2Y; MPN SRN6045TA-2R2Y; LCSC Part C1332316
Q100: 2N7002
Q101, Q102: 2N7002; MPN 2N7002,215; LCSC Part C65189
Q103: CSD17579Q3A; CSD17579Q3A_DNH0008A; MPN CSD17579Q3A; LCSC Part C97376
R100: 5.23k; PD_R_0603; MPN 1RC0603F5231; LCSC C54531489
R101: 30.1k; PD_R_0603; MPN 1RC0603F3012; LCSC C54531365
R102: 4.7k; PD_R_0603; MPN RC0603FR-074K7L; LCSC C99782
R103, R107, R109, R110, R111: 100k; PD_R_0603; MPN RC0603FR-07100KL; LCSC C14675
R106: 10k; PD_R_0603; MPN RC0603FR-0710KL; LCSC C98220
R108: 180k; PD_R_0603; MPN RC0603FR-07180KL; LCSC C123419
R112: 100R; PD_R_0603; MPN RC0603FR-07100RL; LCSC C105588
SW100: WAKE_QON
SW101: BAT_DISCONNECT
U4: BQ25792RQMR; MPN BQ25792RQMR; LCSC Part C2862876

Connections:
BAT_INT: C106.1, Q103.[1-3] (S), U4.[22-23] (BAT)
BAT_PACK: Q103.[5-9] (D), R112.1, SW101.1 (A)
BTST1: C103.1, U4.4 (BTST1)
BTST2: C110.1, U4.19 (BTST2)
CE_N: Q100.3 (D), R103.2, U4.13 (~CE)
CHG_ENABLE: Q100.1 (G), R107.1
CHG_INT: R106.2, U4.21 (~INT)
CHG_SCL: U4.14 (SCL)
CHG_SDA: U4.15 (SDA)
CHG_SYS_ENABLE: Q102.1 (G), R111.1
CHG_VIO_3V0: R106.1
GND: C100.2, C101.2, C102.2, C104.2, C105.2, C106.2, C107.2, C108.2, C109.2, C111.2, C112.2, C113.2, C114.2, C115.2, J5.3, Q100.2 (S), Q101.2 (S), Q102.2 (S), R101.2, R102.2, R107.2, R109.2, R111.2, SW100.2, U4.10 (ACDRV2), U4.11 (ACDRV1), U4.27 (GND)
ILIM_HIZ: Q101.3 (D), R108.2, R109.1, U4.17 (ILIM_HIZ)
unnamed: Q101.1 (G), Q102.3 (D), R110.2
unnamed: Q103.4 (G), U4.24 (SDRV)
unnamed: R112.2, U4.18 (BATP)
unnamed: SW100.1, U4.12 (QON)
PACK_RAW: J5.1, SW101.2 (B)
PMID: C101.1, C108.1, C112.1, C114.1, U4.29 (PMID)
PROG: R102.1, U4.20 (PROG)
REGN: C102.1, C109.1, R100.1, R103.1, R108.1, R110.1, U4.5 (REGN)
SW1: C103.2, L1.1, U4.28 (SW1)
SW2: C110.2, L1.2, U4.26 (SW2)
SYS_RAW: C104.1, C105.1, C107.1, C115.1, U4.25 (SYS)
TS_SENSE: J5.2, R100.2, R101.1, U4.16 (TS)
VBUS_PD: C100.1, C111.1, C113.1, U4.8 (VAC2), U4.9 (VAC1), U4.[2-3] (VBUS)

Notes on the sheet:
VBUS input: VAC1/VAC2 tied to VBUS (no ACFETs); ACDRV1/2 to GND
Config and default-off gates
Startup: keep ILIM_HIZ clamped (Q101) through POR; clear EN_EXTILIM, program/read back IINDPM and 1S limits before enabling SYS. Verify reset/watchdog recovery.
Set REG14.SFET_PRESENT=1 and read back before SDRV ship control; POR default 0 locks SDRV_CTRL. MCU reset/REG_RST requires reconfiguration.
R102 4.7k = 1S/750kHz PROG. L1 2.2uH/6A and input MLCCs are provisional: qualify 20V surge/DC-bias, load current, ripple, efficiency and thermal limits.
I2C pull-ups (10k to logic rail) and CHG_VIO_3V0 level are host-side; D+/D- unconnected (no-connect); set AUTO_INDET_EN=0, HVDCP_EN=0.
