chithigun23/DesktopSpeaker/ai-files/candidates/Fuel_Gauge_Power.kicad_sch

## KiCad design ai-files/candidates/Fuel_Gauge_Power.kicad_sch (2026-10-05)

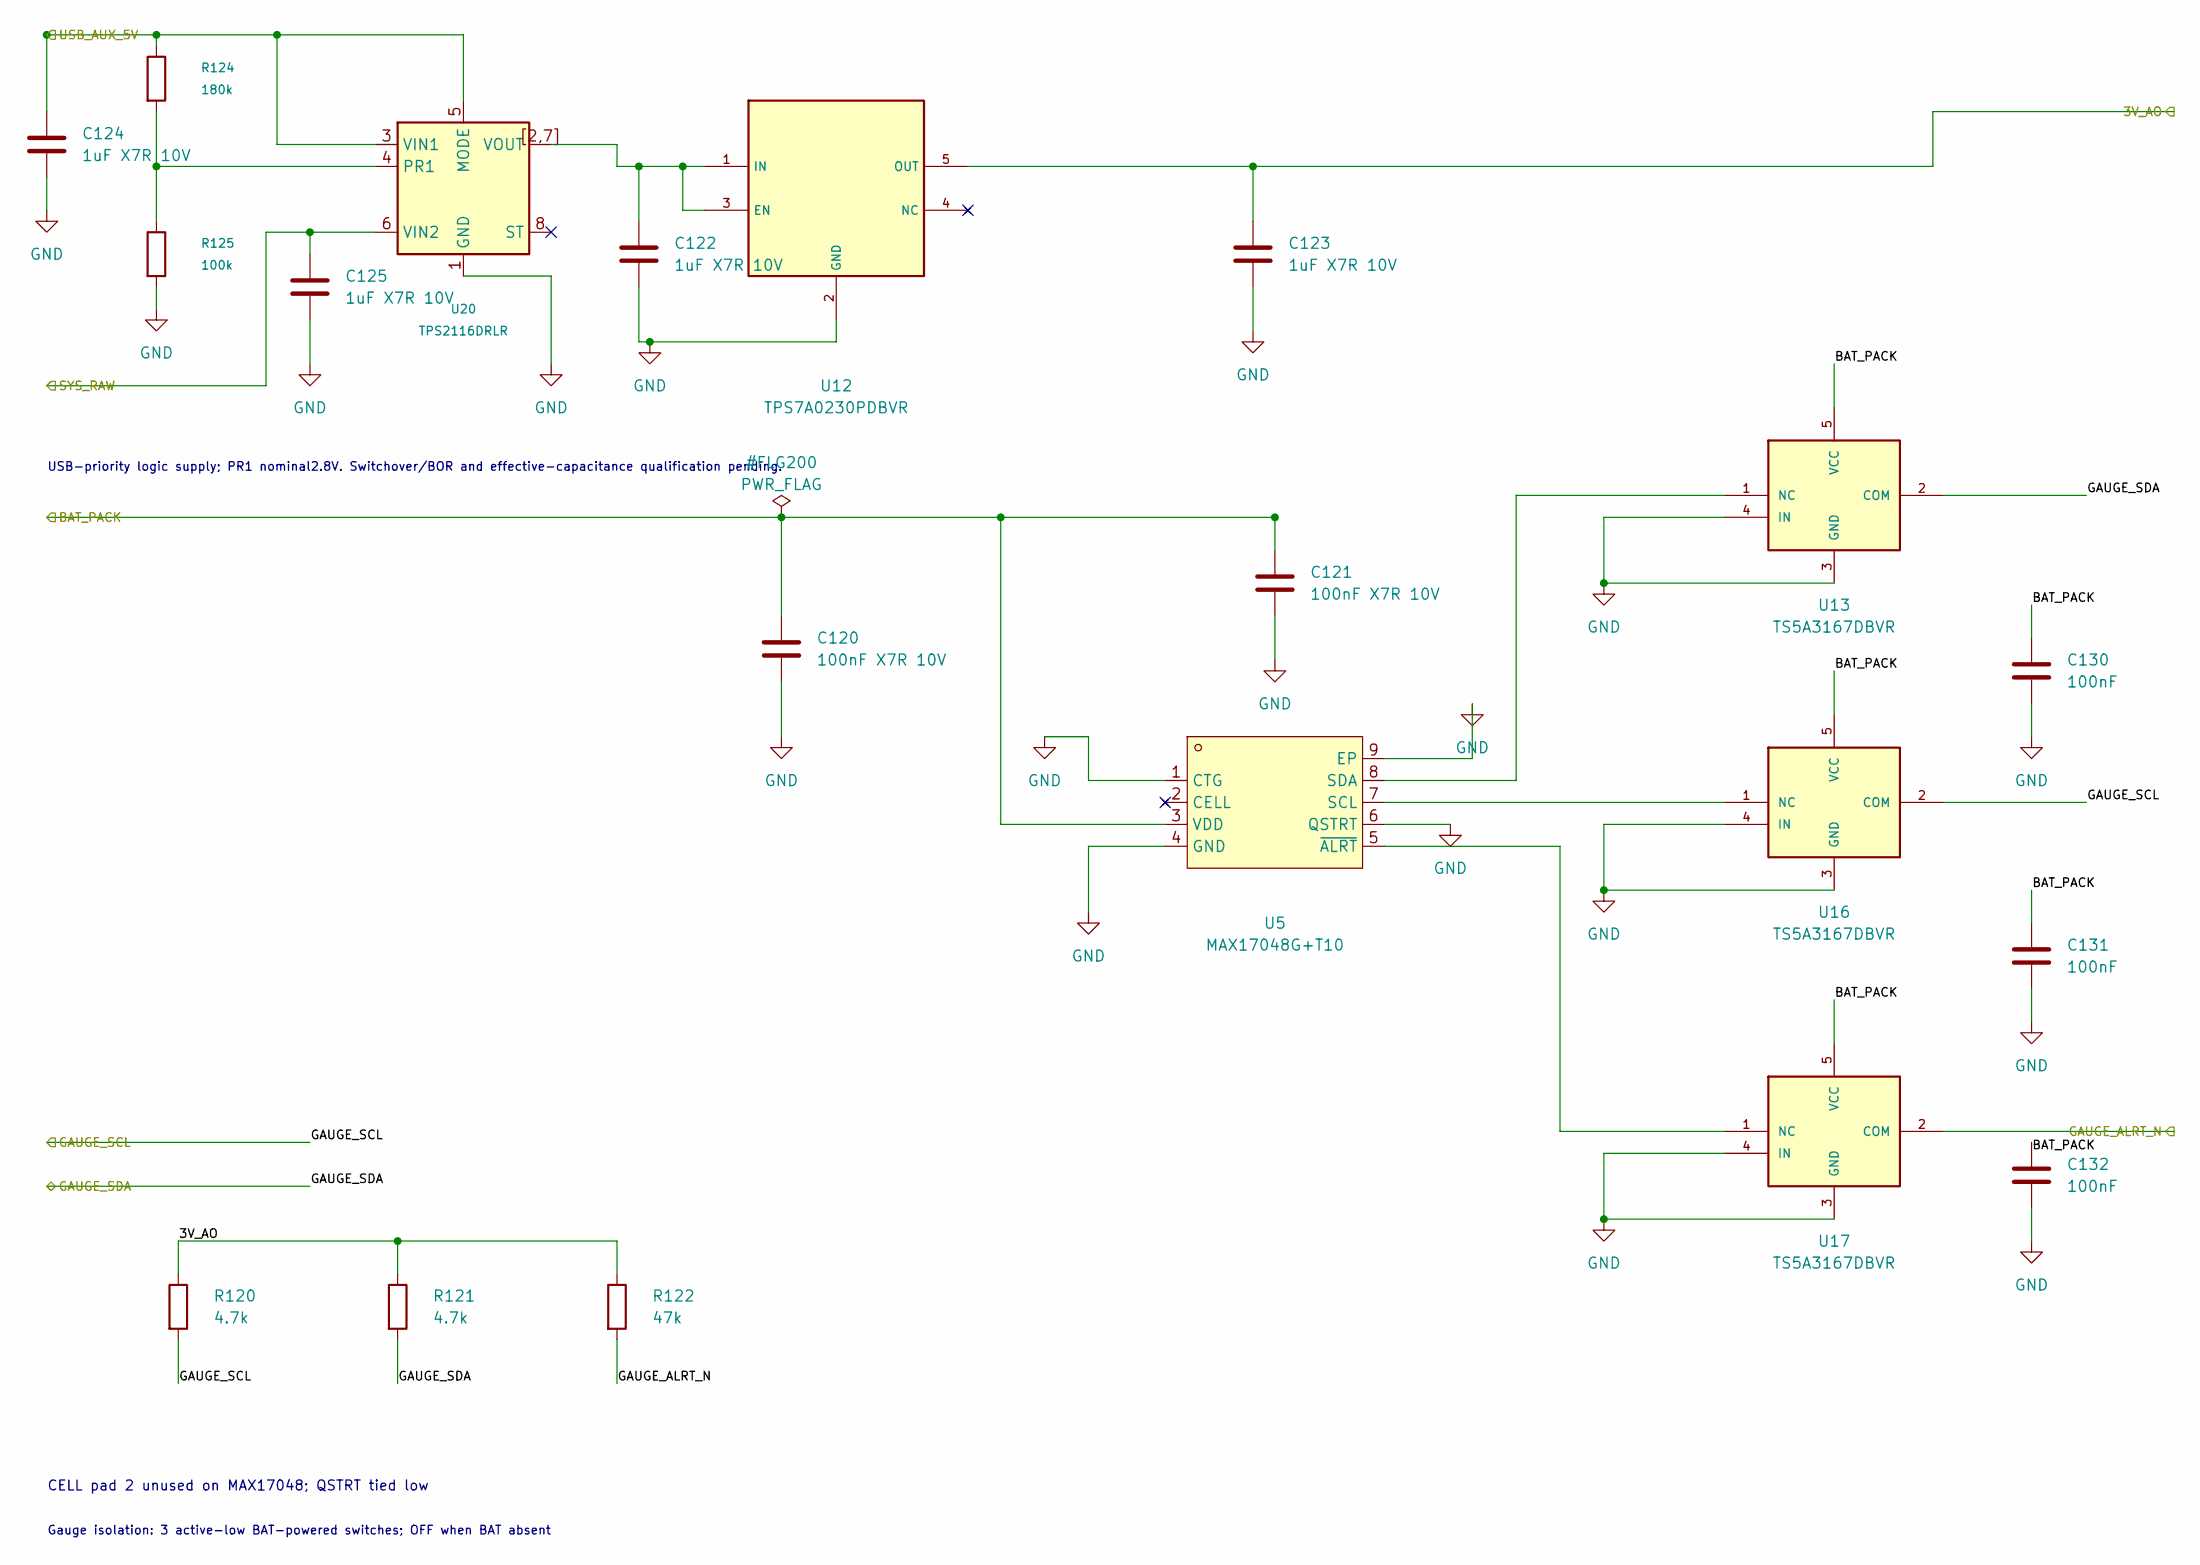
[picture p365: schematic Fuel_Gauge_Power.kicad_sch]

Parts:
C120, C121: 100nF X7R 10V; PD_C_0603; MPN CL10B104KB8NNNC; LCSC C1591
C122, C123, C124, C125: 1uF X7R 10V; PD_C_0603; MPN LMK107B7105KA-T; LCSC C92806
C130, C131, C132: 100nF; PD_C_0603; MPN CL10B104KB8NNNC; LCSC C1591
R120, R121: 4.7k; PD_R_0603; MPN RC0603FR-074K7L; LCSC C99782
R122: 47k; PD_R_0603; MPN RC0603FR-0747KL; LCSC C105579
R124: 180k; PD_R_0603
R125: 100k; PD_R_0603
U5: MAX17048G+T10; MPN MAX17048G+T10; LCSC Part C2682616
U12: TPS7A0230PDBVR; MPN TPS7A0230PDBVR; LCSC C3747031
U13, U16, U17: TS5A3167DBVR; MPN TS5A3167DBVR; LCSC C128416
U20: TPS2116DRLR; MPN TPS2116DRLR; LCSC C3235557

Connections:
3V_AO: C123.1, R120.1, R121.1, R122.1, U12.5 (OUT)
BAT_PACK: C120.1, C121.1, C130.1, C131.1, C132.1, U5.3 (VDD), U13.5 (VCC), U16.5 (VCC), U17.5 (VCC)
GAUGE_ALRT_N: R122.2, U17.2 (COM)
GAUGE_SCL: R120.2, U16.2 (COM)
GAUGE_SDA: R121.2, U13.2 (COM)
GND: C120.2, C121.2, C122.2, C123.2, C124.2, C125.2, C130.2, C131.2, C132.2, R125.2, U5.1 (CTG), U5.4 (GND), U5.6 (QSTRT), U5.9 (EP), U12.2 (GND), U13.3 (GND), U13.4 (IN), U16.3 (GND), U16.4 (IN), U17.3 (GND), U17.4 (IN), U20.1 (GND)
unnamed: C122.1, U12.1 (IN), U12.3 (EN), U20.[2,7] (VOUT)
unnamed: R124.2, R125.1, U20.4 (PR1)
unnamed: U5.8 (SDA), U13.1 (NC)
unnamed: U5.7 (SCL), U16.1 (NC)
unnamed: U5.5 (~ALRT), U17.1 (NC)
SYS_RAW: C125.1, U20.6 (VIN2)
USB_AUX_5V: C124.1, R124.1, U20.3 (VIN1), U20.5 (MODE)

Notes on the sheet:
CELL pad 2 unused on MAX17048; QSTRT tied low
Gauge isolation: 3 active-low BAT-powered switches; OFF when BAT absent
USB-priority logic supply; PR1 nominal2.8V. Switchover/BOR and effective-capacitance qualification pending.
