chithigun23/DesktopSpeaker/ai-files/candidates/TPS25730D_USB_PD_candidate.kicad_sch

## KiCad design ai-files/candidates/TPS25730D_USB_PD_candidate.kicad_sch (2026-10-05)

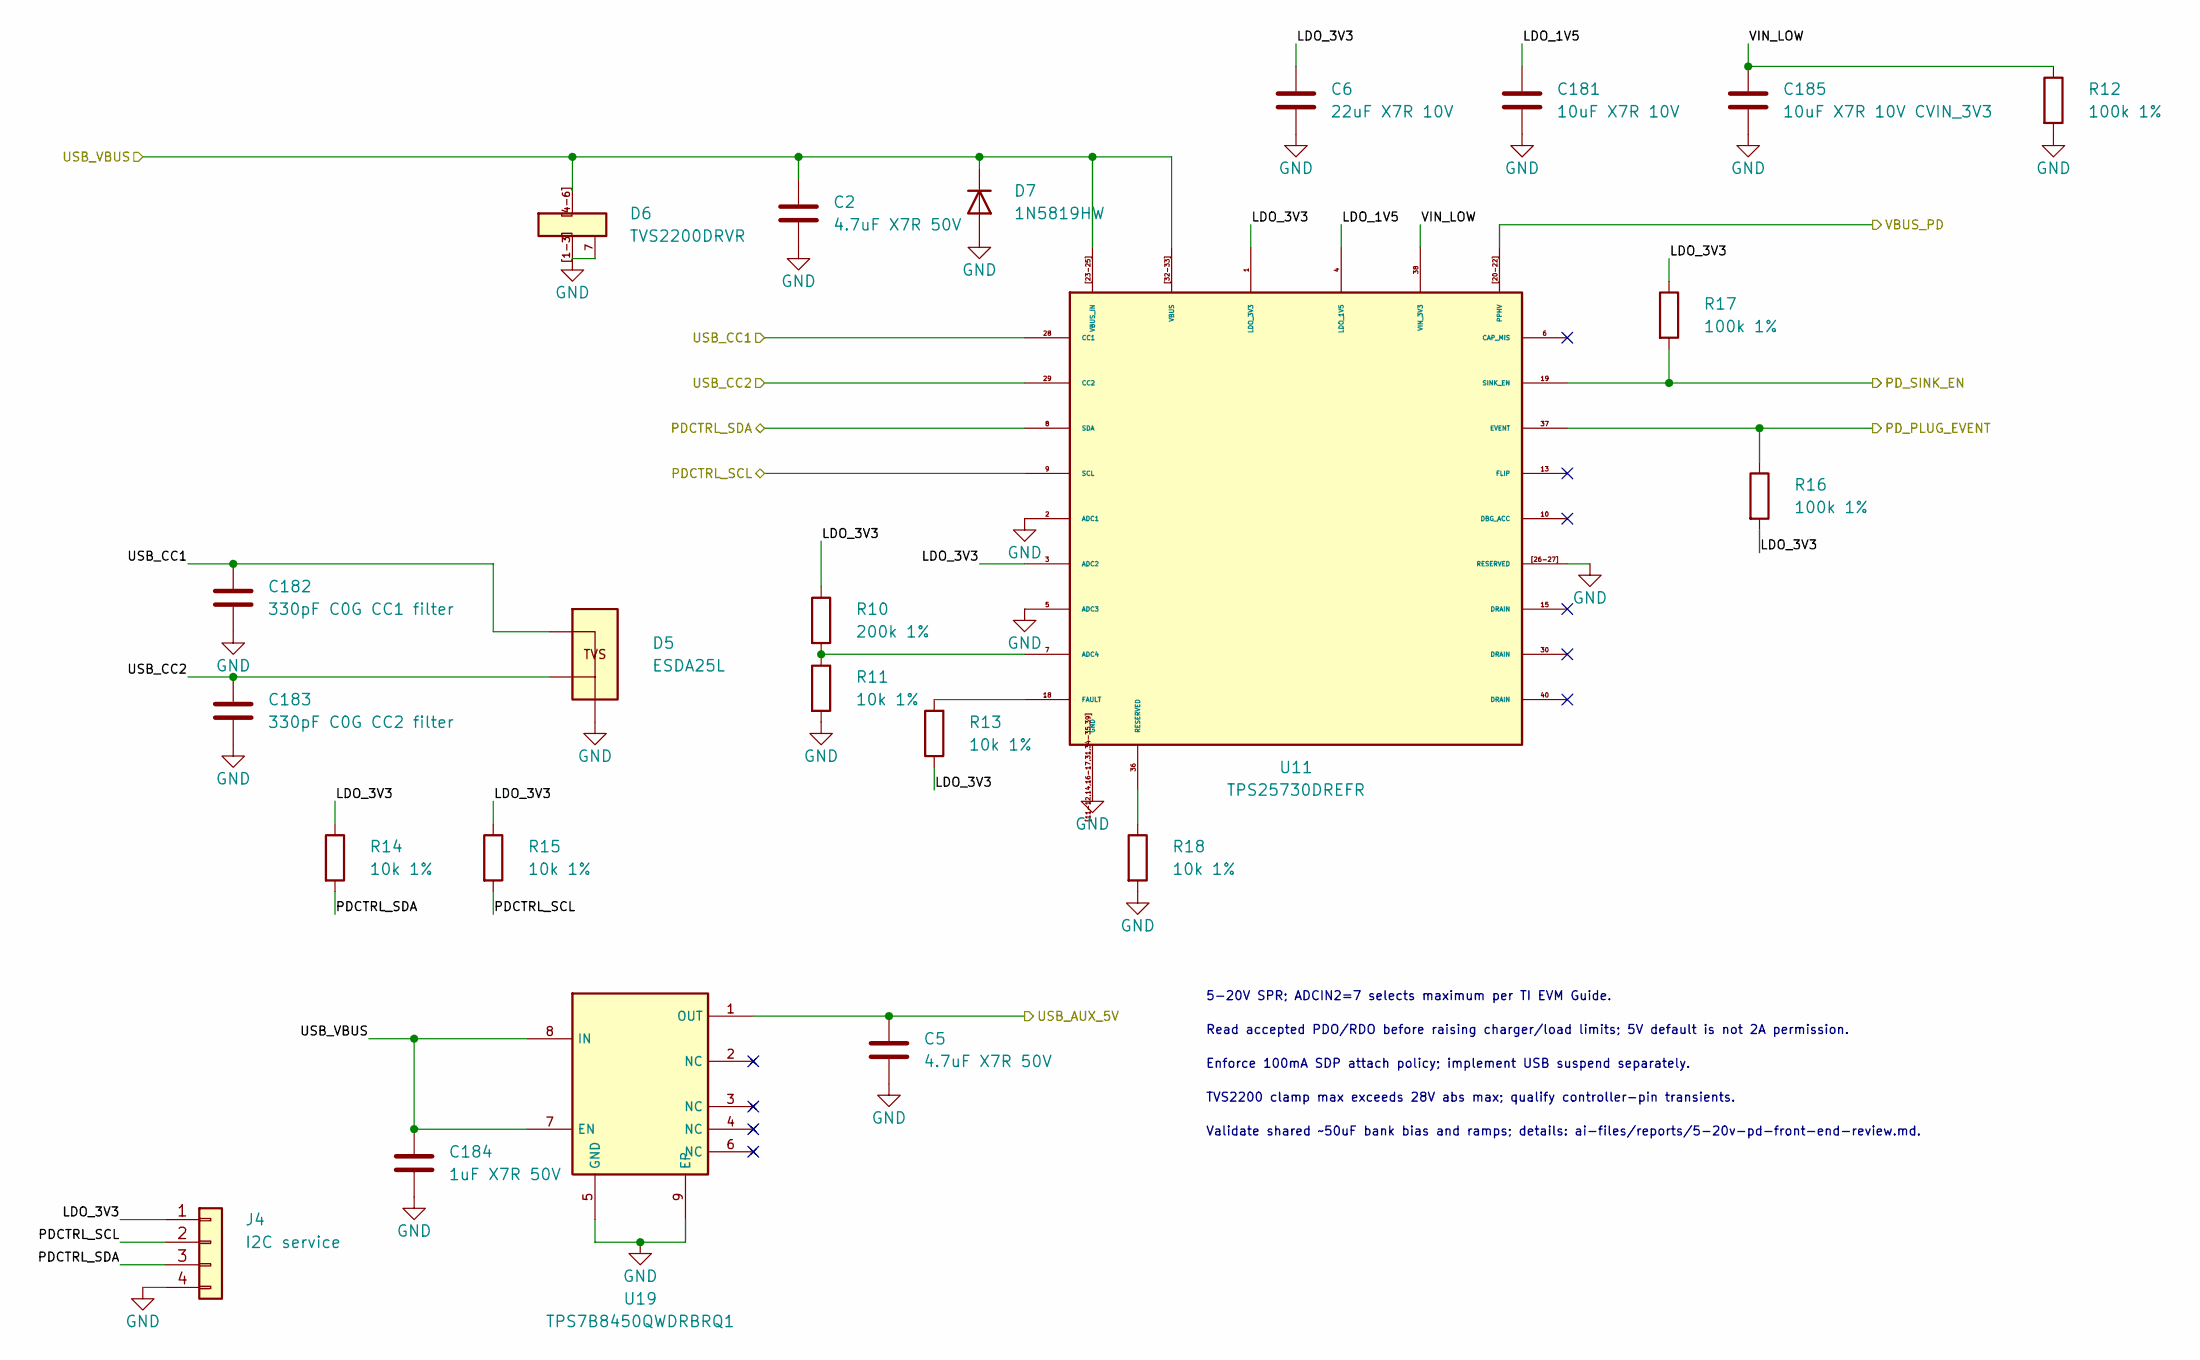
[picture p366: schematic TPS25730D_USB_PD_candidate.kicad_sch]

Parts:
C2: 4.7uF X7R 50V; PD_C_1210; MPN CL32B475KBUYNNE; LCSC Part C170099
C5: 4.7uF X7R 50V; PD_C_1206
C6: 22uF X7R 10V; PD_C_0805; MPN GRM21BZ71A226ME15L; LCSC Part C907991
C181: 10uF X7R 10V; PD_C_0805; MPN CL21B106KPQNNNE; LCSC Part C32635
C182: 330pF C0G CC1 filter; PD_C_0603
C183: 330pF C0G CC2 filter; PD_C_0603
C184: 1uF X7R 50V; PD_C_0805; MPN CL21B105KBFNNNE; LCSC Part C28323
C185: 10uF X7R 10V CVIN_3V3; PD_C_0805; MPN CL21B106KPQNNNE; LCSC Part C32635
D5: ESDA25L; MPN ESDA25L; LCSC Part C95343
D6: TVS2200DRVR; MPN TVS2200
D7: 1N5819HW; PD_D_SOD123; MPN 1N5819HW-7-F; LCSC Part C82544
J4: I2C service; PD_SERVICE_HDR
R10: 200k 1%; PD_R_0603
R11, R13, R14, R15, R18: 10k 1%; PD_R_0603; MPN RC0603FR-0710KL; LCSC Part C98220
R12, R16, R17: 100k 1%; PD_R_0603; MPN RC0603FR-07100KL; LCSC Part C14675
U11: TPS25730DREFR; Texas_REF0038A_WQFN-38-2EP_6x4mm_P0.4; MPN TPS25730DREFR; LCSC Part C22438973
U19: TPS7B8450QWDRBRQ1; TPS7B8450QWDRBRQ1_WSON-8; MPN TPS7B8450QWDRBRQ1; LCSC Part C3751394

Connections:
GND: C2.2, C5.2, C6.2, C181.2, C182.2, C183.2, C184.2, C185.2, D5.3 (GND/A), D6.7 (EP), D6.[1-3] (GND), D7.2 (A), J4.4, R11.2, R12.2, R18.2, U11.2 (ADC1), U11.5 (ADC3), U11.[11-12,14,16-17,31,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 (GND), U11.[26-27] (RESERVED), U19.5 (GND), U19.9 (EP)
LDO_1V5: C181.1, U11.4 (LDO_1V5)
LDO_3V3: C6.1, J4.1, R10.1, R13.1, R14.1, R15.1, R16.2, R17.1, U11.1 (LDO_3V3), U11.3 (ADC2)
unnamed: R10.2, R11.1, U11.7 (ADC4)
unnamed: R13.2, U11.18 (FAULT)
unnamed: R18.1, U11.36 (RESERVED)
PDCTRL_SCL: J4.2, R15.2, U11.9 (SCL)
PDCTRL_SDA: J4.3, R14.2, U11.8 (SDA)
PD_PLUG_EVENT: R16.1, U11.37 (EVENT)
PD_SINK_EN: R17.2, U11.19 (SINK_EN)
USB_AUX_5V: C5.1, U19.1 (OUT)
USB_CC1: C182.1, D5.1 (CC1/K1), U11.28 (CC1)
USB_CC2: C183.1, D5.2 (CC2/K2), U11.29 (CC2)
USB_VBUS: C2.1, C184.1, D6.[4-6] (IN), D7.1 (K), U11.[23-25] (VBUS_IN), U11.[32-33] (VBUS), U19.7 (EN), U19.8 (IN)
VBUS_PD: U11.[20-22] (PPHV)
VIN_LOW: C185.1, R12.1, U11.38 (VIN_3V3)

Notes on the sheet:
5-20V SPR; ADCIN2=7 selects maximum per TI EVM Guide.
Read accepted PDO/RDO before raising charger/load limits; 5V default is not 2A permission.
Enforce 100mA SDP attach policy; implement USB suspend separately.
TVS2200 clamp max exceeds 28V abs max; qualify controller-pin transients.
Validate shared ~50uF bank bias and ramps; details: ai-files/reports/5-20v-pd-front-end-review.md.
