chithigun23/DesktopSpeaker/ai-files/candidates/noq103.kicad_sch

## KiCad design ai-files/candidates/noq103.kicad_sch (2026-10-05)

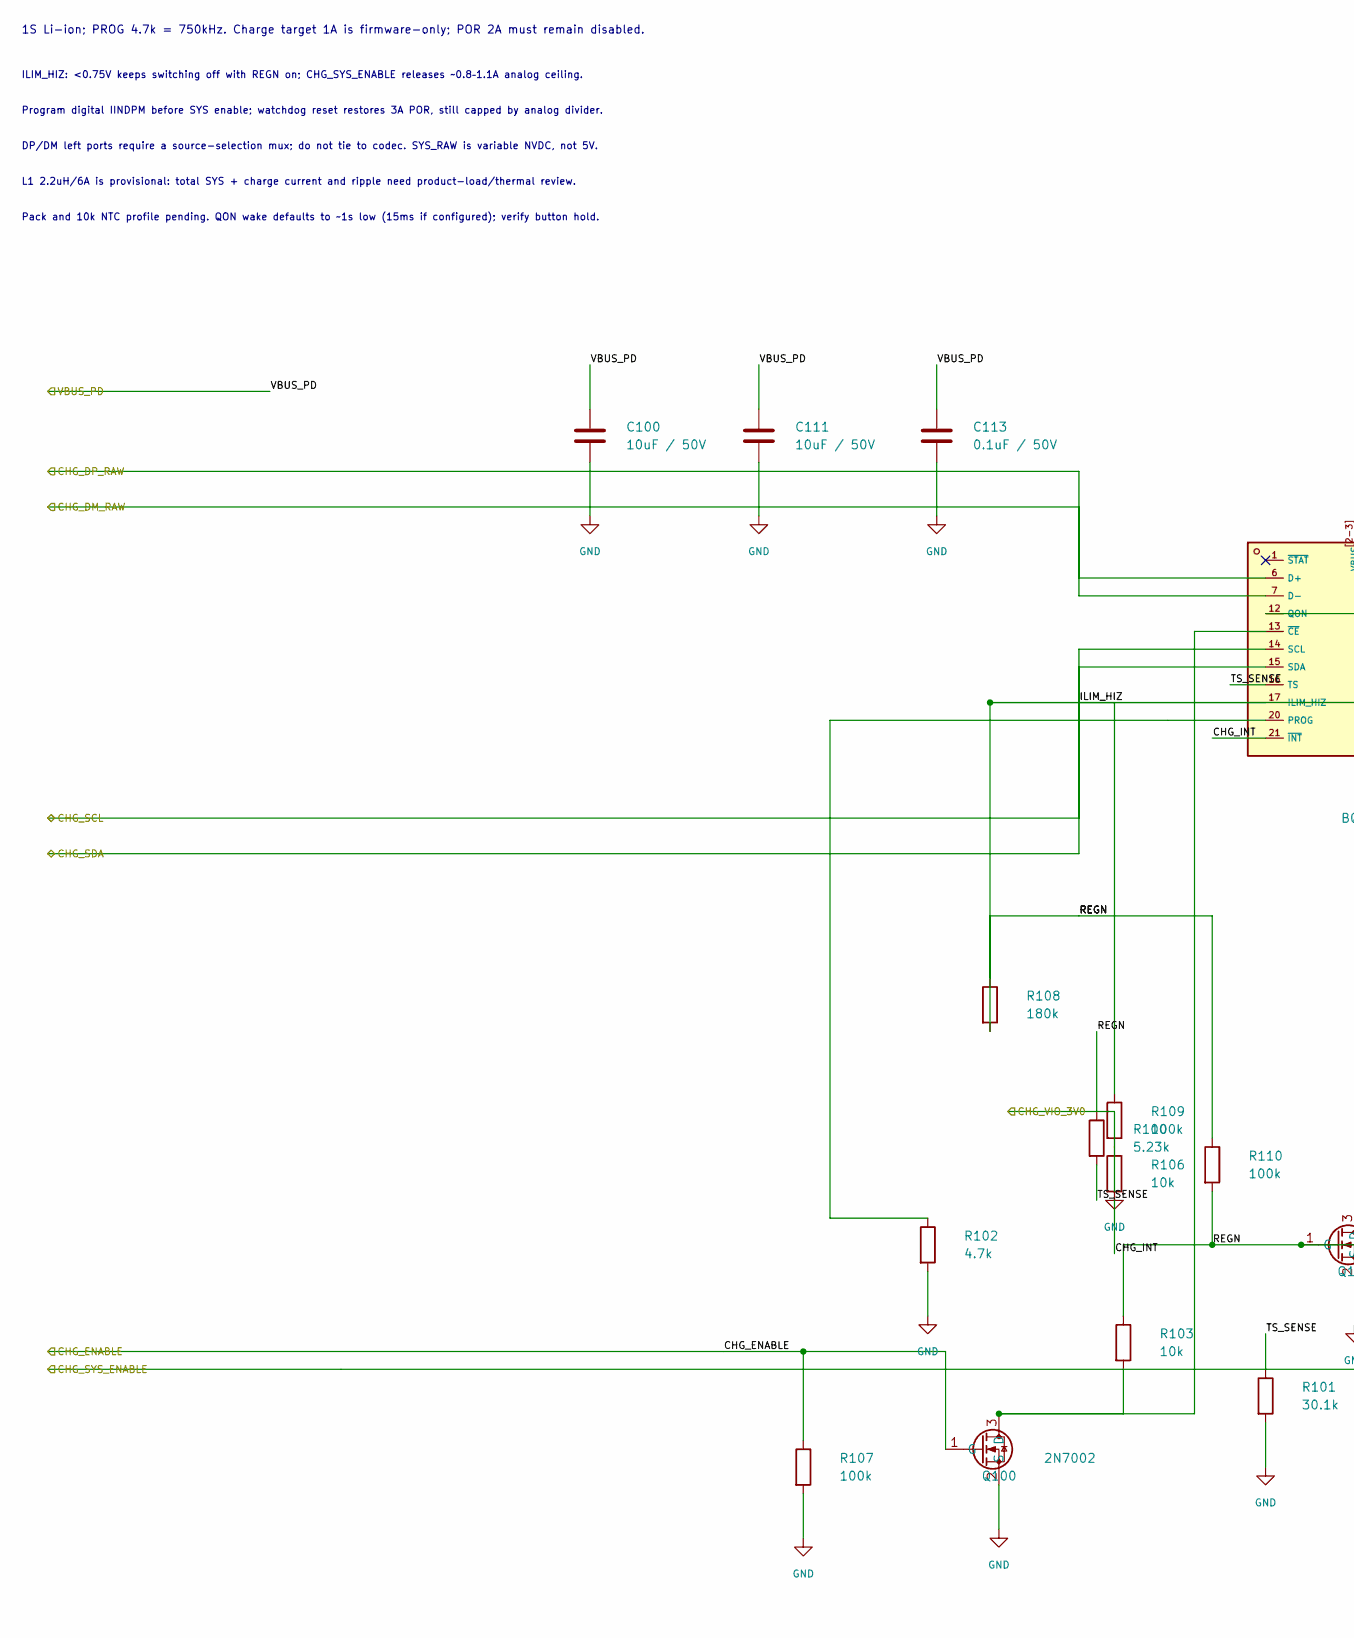
[picture p367: schematic noq103.kicad_sch, part in row 1, column 1]

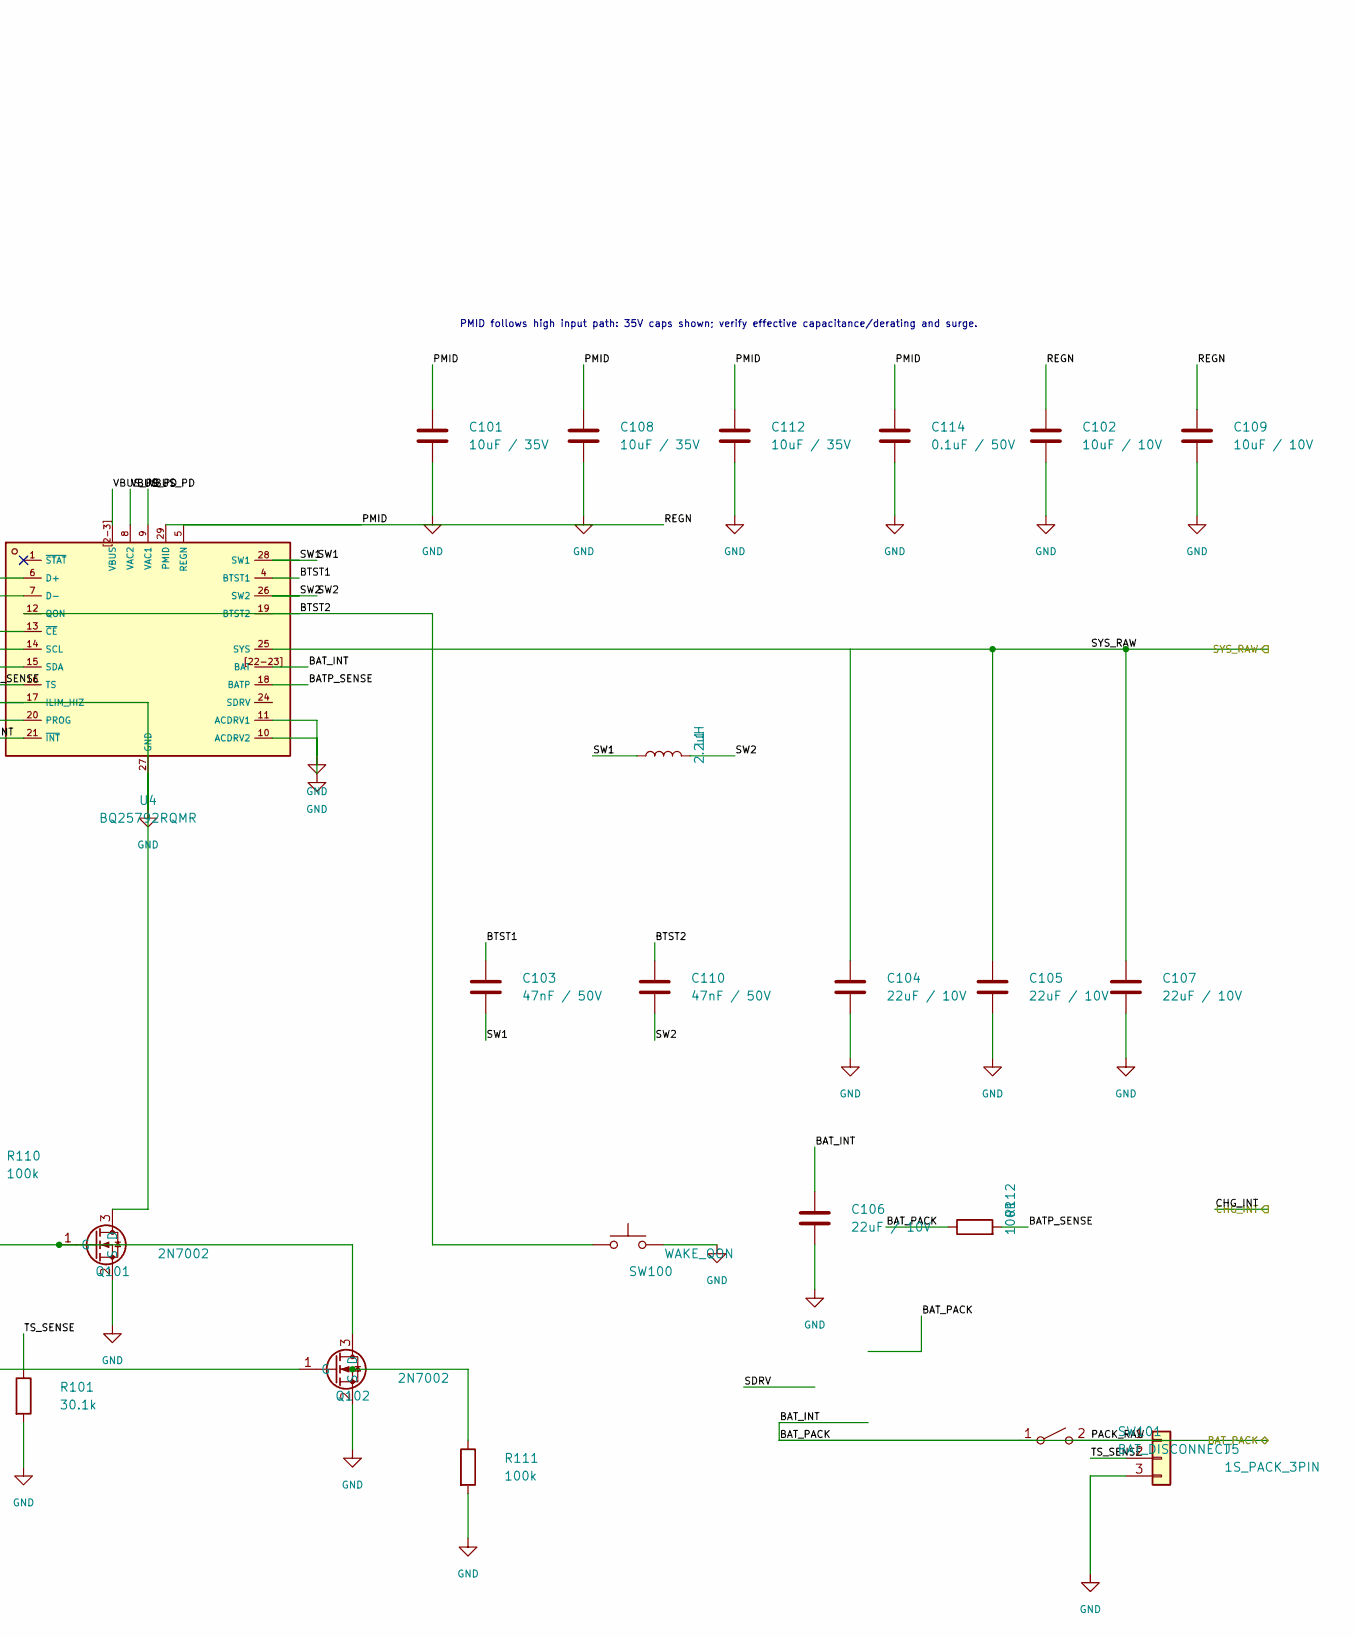
[picture p368: schematic noq103.kicad_sch, part in row 1, column 2]

Parts:
C100: 10uF / 50V; PD_C_1210; MPN CL21B225KBYNNNE; LCSC Part C2762602
C101, C108: 10uF / 35V; PD_C_1210; MPN CL32B226KAJNNNE; LCSC Part C309062
C102, C109: 10uF / 10V; PD_C_0805; MPN CL21B106KPQNNNE; LCSC Part C32635
C103: 47nF / 50V; PD_C_0603; MPN CC0603KRX7R9BB473; LCSC C107093
C104, C105, C106, C107: 22uF / 10V; PD_C_0805; MPN GRM21BZ71A226ME15L; LCSC Part C907991
C110: 47nF / 50V; PD_C_0603
C111: 10uF / 50V; PD_C_1210
C112: 10uF / 35V; PD_C_1210
C113, C114: 0.1uF / 50V; PD_C_0603
J5: 1S_PACK_3PIN; JST_B3P_VH_1x03_P3.96mm_Vertical
L1: 2.2uH; SRN6045TA-2R2Y; MPN SRN6045TA-2R2Y; LCSC Part C1332316
Q100, Q101, Q102: 2N7002
R100: 5.23k; PD_R_0603; MPN 1RC0603F5231; LCSC C54531489
R101: 30.1k; PD_R_0603; MPN 1RC0603F3012; LCSC C54531365
R102: 4.7k; PD_R_0603; MPN RC0603FR-07220RL; LCSC C107696
R103, R106: 10k; PD_R_0603; MPN RC0603FR-0710KL; LCSC C98220
R107: 100k; PD_R_0603; MPN RC0603FR-07100KL; LCSC C14675
R108: 180k; PD_R_0603
R109, R110, R111: 100k; PD_R_0603
R112: 100R; PD_R_0603
SW100: WAKE_QON
SW101: BAT_DISCONNECT
U4: BQ25792RQMR; MPN BQ25792RQMR; LCSC Part C2862876

Connections:
BATP_SENSE: R112.2, U4.18 (BATP)
BAT_INT: C106.1, J5.1, R112.1, SW101.1 (A), SW101.2 (B), U4.[22-23] (BAT)
BTST1: C103.1, U4.4 (BTST1)
BTST2: C110.1, SW100.1, U4.12 (QON), U4.19 (BTST2)
CHG_DM_RAW: U4.7 (D−)
CHG_DP_RAW: U4.6 (D+)
CHG_ENABLE: Q100.1 (G), R107.1
CHG_INT: R106.2, U4.21 (~INT)
CHG_SYS_ENABLE: Q102.1 (G)
GND: C100.2, C101.2, C102.2, C104.2, C105.2, C106.2, C107.2, C108.2, C109.2, C111.2, C112.2, C113.2, C114.2, J5.3, Q100.2 (S), Q101.2 (S), Q101.3 (D), Q102.2 (S), R101.2, R102.2, R106.1, R107.2, R108.2, R109.1, R109.2, R111.2, SW100.2, U4.10 (ACDRV2), U4.11 (ACDRV1), U4.14 (SCL), U4.15 (SDA), U4.17 (ILIM_HIZ), U4.27 (GND)
unnamed: Q100.3 (D), R103.2, U4.13 (~CE)
unnamed: R102.1, U4.20 (PROG)
PMID: C101.1, C102.1, C108.1, C109.1, C112.1, C114.1, Q101.1 (G), Q102.3 (D), R100.1, R103.1, R108.1, R110.1, R110.2, U4.5 (REGN), U4.29 (PMID)
SW1: C103.2, L1.1, U4.28 (SW1)
SW2: C110.2, L1.2, U4.26 (SW2)
SYS_RAW: C105.1, C107.1, U4.25 (SYS)
TS_SENSE: J5.2, R100.2, R101.1, U4.16 (TS)
VBUS_PD: C100.1, C111.1, C113.1, U4.8 (VAC2), U4.9 (VAC1), U4.[2-3] (VBUS)

Notes on the sheet:
1S Li-ion; PROG 4.7k = 750kHz. Charge target 1A is firmware-only; POR 2A must remain disabled.
ILIM_HIZ: <0.75V keeps switching off with REGN on; CHG_SYS_ENABLE releases ~0.8–1.1A analog ceiling.
Program digital IINDPM before SYS enable; watchdog reset restores 3A POR, still capped by analog divider.
DP/DM left ports require a source-selection mux; do not tie to codec. SYS_RAW is variable NVDC, not 5V.
L1 2.2uH/6A is provisional: total SYS + charge current and ripple need product-load/thermal review.
Pack and 10k NTC profile pending. QON wake defaults to ~1s low (15ms if configured); verify button hold.
PMID follows high input path: 35V caps shown; verify effective capacitance/derating and surge.
