chithigun23/DesktopSpeaker/ai-files/reports/u14-supply/Logic_Audio_Power.after.kicad_sch

## KiCad design ai-files/reports/u14-supply/Logic_Audio_Power.after.kicad_sch (2026-10-05)

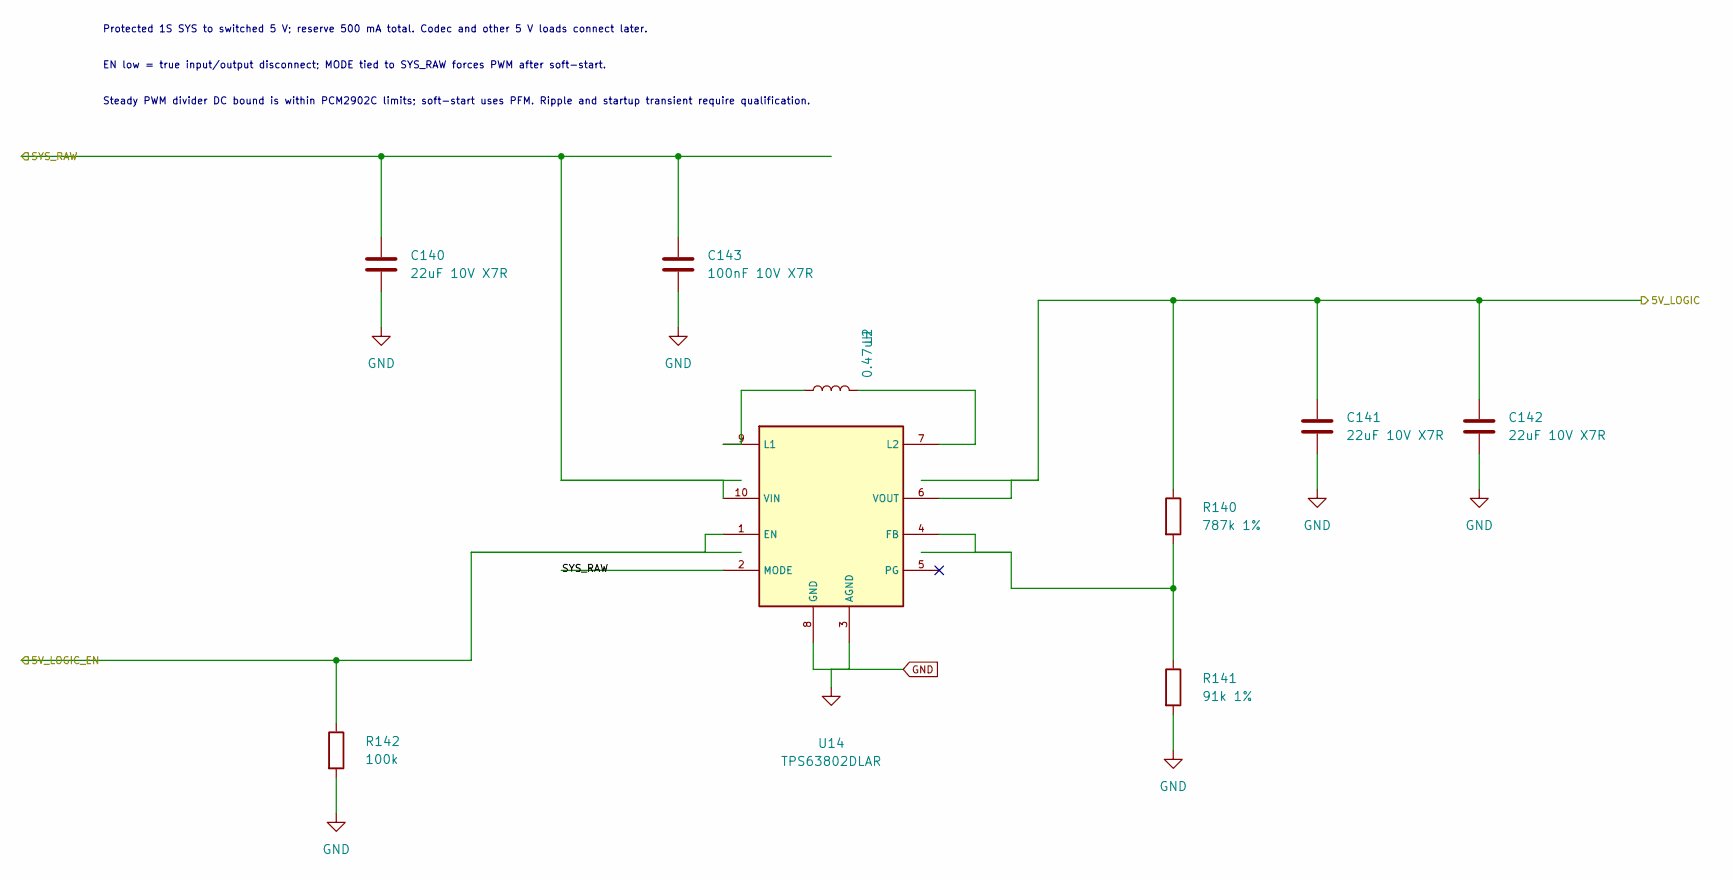
[picture p369: schematic Logic_Audio_Power.after.kicad_sch]

Parts:
C140, C141, C142: 22uF 10V X7R; PD_C_0805; MPN GRM21BZ71A226ME15L; LCSC Part C907991
C143: 100nF 10V X7R; PD_C_0603; MPN CL10B104KB8NNNC; LCSC Part C1591
L2: 0.47uH; Bourns_SRN6045TA-1R0Y; MPN SRN6045TA-1R0Y; LCSC Part C3013497
R140: 787k 1%; PD_R_0603; MPN CRCW0603732KFKEA; LCSC Part C2079739
R141: 91k 1%; PD_R_0603; MPN RC0603FR-07100KL; LCSC Part C14675
R142: 100k; PD_R_0603; MPN RC0603FR-07100KL; LCSC Part C14675
U14: TPS63802DLAR; MPN TPS61023DRLT; LCSC Part C1852149

Connections:
5V_LOGIC: C141.1, C142.1, R140.1, U14.6 (VOUT)
5V_LOGIC_EN: R142.1, U14.1 (EN)
GND: C140.2, C141.2, C142.2, C143.2, R141.2, R142.2
unnamed: L2.1, U14.9 (L1)
unnamed: L2.2, U14.7 (L2)
unnamed: R140.2, R141.1, U14.4 (FB)
unnamed: U14.3 (AGND), U14.8 (GND)
SYS_RAW: C140.1, C143.1, U14.2 (MODE), U14.10 (VIN)

Notes on the sheet:
Protected 1S SYS to switched 5 V; reserve 500 mA total. Codec and other 5 V loads connect later.
EN low = true input/output disconnect; MODE tied to SYS_RAW forces PWM after soft-start.
Steady PWM divider DC bound is within PCM2902C limits; soft-start uses PFM. Ripple and startup transient require qualification.
