chithigun23/DesktopSpeaker/ai-files/fab/draft-rt14/out/work/Amplifiers.kicad_sch

## KiCad design ai-files/fab/draft-rt14/out/work/Amplifiers.kicad_sch (2026-11-02)

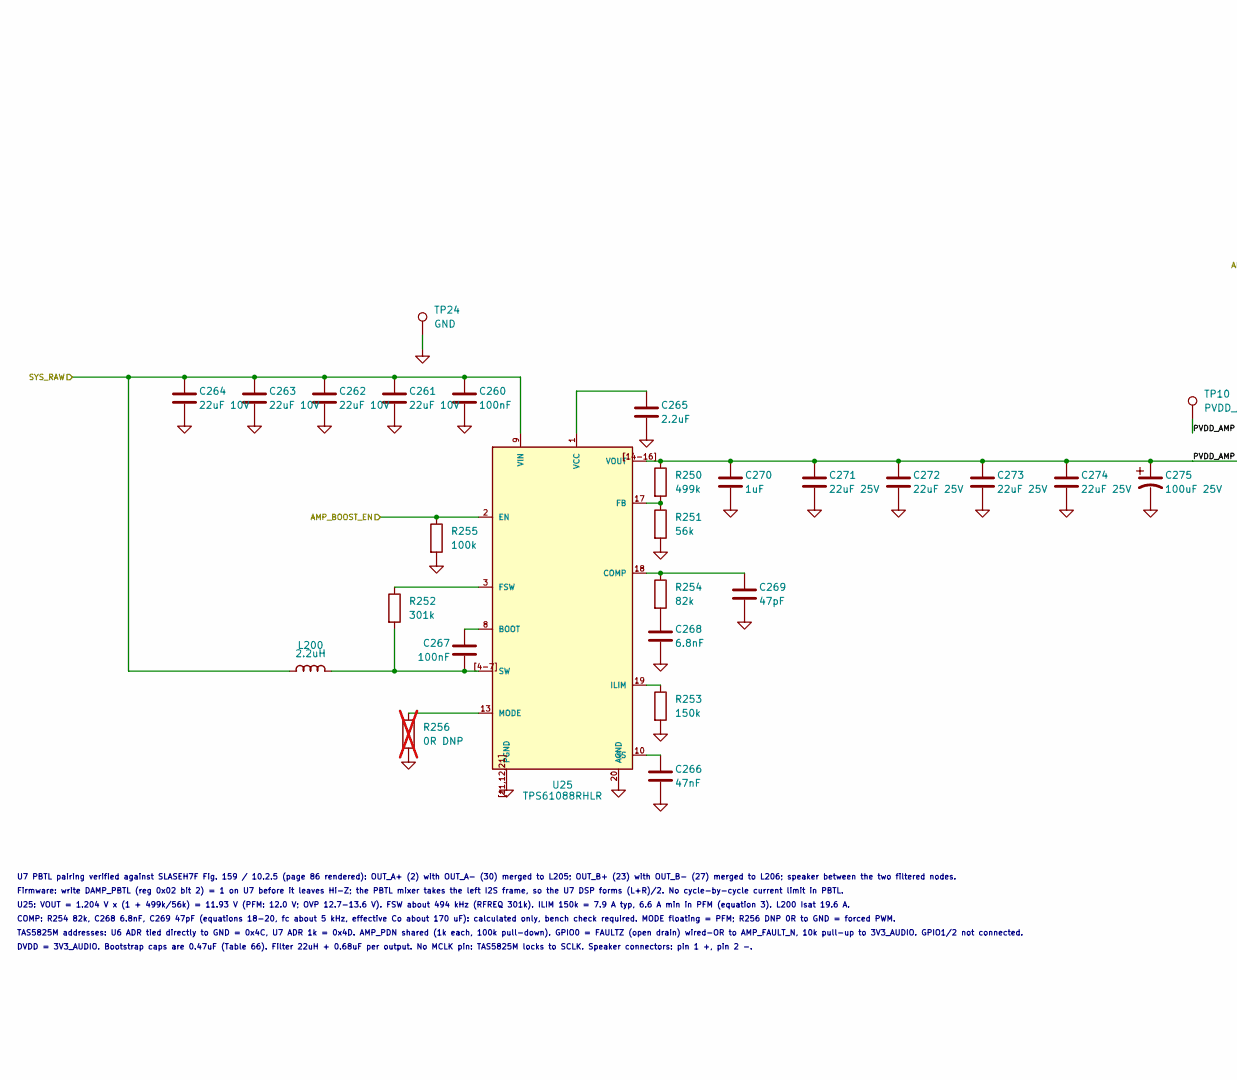
[picture p371: schematic Amplifiers.kicad_sch, part in row 1, column 1]

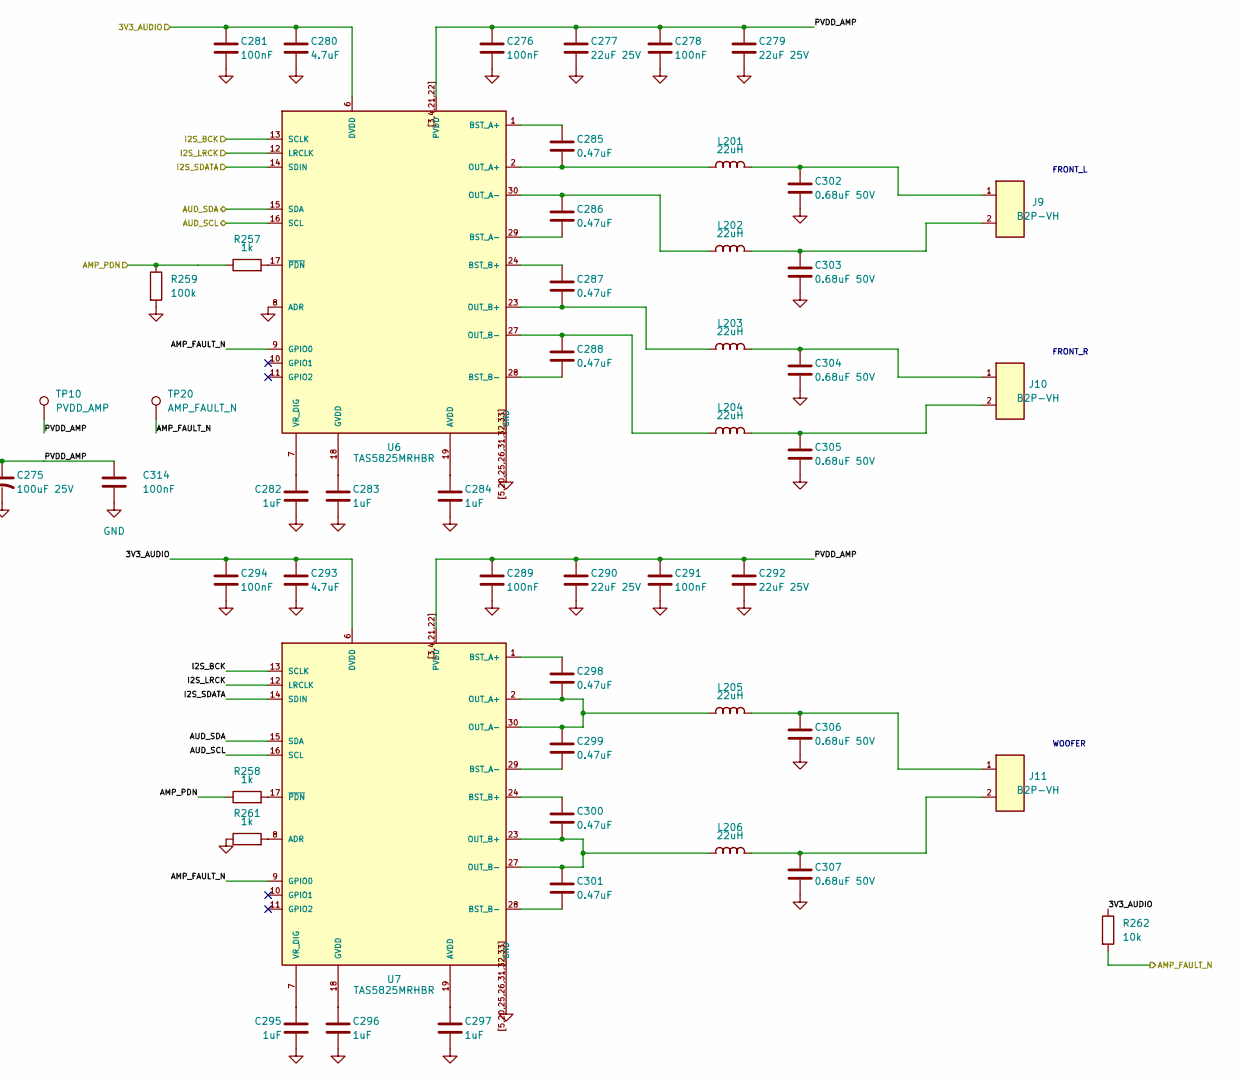
[picture p372: schematic Amplifiers.kicad_sch, part in row 1, column 2]

Parts:
C260, C267, C276, C278, C281, C289, C291, C294, C314: 100nF; C_0402_1005Metric_Pad0.74x0.62mm_HandSolder; MPN GRM155R71H104KE14D; LCSC C77020
C261, C262, C263, C264: 22uF 10V; C_0805_2012Metric_Pad1.18x1.45mm_HandSolder; MPN GRM21BZ71A226ME15L; LCSC C907991
C265: 2.2uF; C_0805_2012Metric_Pad1.18x1.45mm_HandSolder; MPN CL21B225KAFNNNE; LCSC C19110
C266: 47nF; C_0402_1005Metric_Pad0.74x0.62mm_HandSolder; MPN GRM155R71H473KE14D; LCSC C117757
C268: 6.8nF; C_0402_1005Metric_Pad0.74x0.62mm_HandSolder; MPN CL05B682KB5NNNC; LCSC C318580
C269: 47pF; C_0402_1005Metric_Pad0.74x0.62mm_HandSolder; MPN GRM1555C1H470JA01D; LCSC C76970
C270: 1uF; C_0805_2012Metric_Pad1.18x1.45mm_HandSolder; MPN CL21B105KBFNNNE; LCSC C28323
C271, C272, C273, C274, C277, C279, C290, C292: 22uF 25V; C_0805_2012Metric_Pad1.18x1.45mm_HandSolder; MPN CL21A226MAQNNNE; LCSC C45783
C275: 100uF 25V; CP_Elec_6.3x7.7; MPN EEHZA1E101XP; LCSC C264047
C280, C293: 4.7uF; C_0805_2012Metric_Pad1.18x1.45mm_HandSolder; MPN CL21A475KAQNNNE; LCSC C1779
C282, C283, C284, C295, C296, C297: 1uF; C_0402_1005Metric_Pad0.74x0.62mm_HandSolder; MPN CL05A105KO5NNNC; LCSC C29266
C285, C286, C287, C288, C298, C299, C300, C301: 0.47uF; C_0402_1005Metric_Pad0.74x0.62mm_HandSolder; MPN CGA0402X7R474K160GT; LCSC C22435970
C302, C303, C304, C305, C306, C307: 0.68uF 50V; C_0805_2012Metric_Pad1.18x1.45mm_HandSolder; MPN CL21B684KBFVPNE; LCSC C472832
J9, J10, J11: B2P-VH; JST_B2P_VH_1x02_P3.96mm_Vertical; MPN B2P-VH(LF)(SN); LCSC Part C160315
L200: 2.2uH; L_Coilcraft_XAL7070-XXX; MPN XAL7070-222MEC; LCSC C3911470
L201, L202, L203, L204, L205, L206: 22uH; L_Sunlord_MWSA1265S; MPN MWSA1265S-220MT; LCSC C7245133
R250: 499k; R_0402_1005Metric_Pad0.72x0.64mm_HandSolder; MPN RC0402FR-07499KL; LCSC C137971
R251: 56k; R_0402_1005Metric_Pad0.72x0.64mm_HandSolder; MPN RC0402FR-0756KL; LCSC C114756
R252: 301k; R_0402_1005Metric_Pad0.72x0.64mm_HandSolder; MPN RC0402FR-07301KL; LCSC C171693
R253: 150k; R_0402_1005Metric_Pad0.72x0.64mm_HandSolder; MPN RC0402FR-07150KL; LCSC C93947
R254: 82k; R_0402_1005Metric_Pad0.72x0.64mm_HandSolder; MPN AC0402FR-0782KL; LCSC C144735
R255, R259: 100k; R_0402_1005Metric_Pad0.72x0.64mm_HandSolder; MPN RC0402FR-07100KL; LCSC C60491
R256: 0R DNP; R_0402_1005Metric_Pad0.72x0.64mm_HandSolder; MPN RC0402FR-070RL; LCSC C106231; not fitted
R257, R258, R261: 1k; R_0402_1005Metric_Pad0.72x0.64mm_HandSolder; MPN RC0402FR-071KL; LCSC C106235
R262: 10k; R_0402_1005Metric_Pad0.72x0.64mm_HandSolder; MPN RC0402FR-0710KL; LCSC C60490
TP10: PVDD_AMP; TestPoint_Keystone_5015_Micro_Mini
TP20: AMP_FAULT_N; TestPoint_Keystone_5015_Micro_Mini
TP24: GND; TestPoint_Keystone_5010-5014_Multipurpose
U6, U7: TAS5825MRHBR; MPN TAS5825MRHBR; LCSC Part C471049
U25: TPS61088RHLR; MPN TPS61088RHLR; LCSC Part C87357

Connections:
3V3_AUDIO: C280.1, C281.1, C293.1, C294.1, R262.1, U6.6 (DVDD), U7.6 (DVDD)
AMP_BOOST_EN: R255.1, U25.2 (EN)
AMP_FAULT_N: R262.2, TP20.1, U6.9 (GPIO0), U7.9 (GPIO0)
AMP_PDN: R257.1, R258.1, R259.1
AUD_SCL: U6.16 (SCL), U7.16 (SCL)
AUD_SDA: U6.15 (SDA), U7.15 (SDA)
GND: C260.2, C261.2, C262.2, C263.2, C264.2, C265.2, C266.2, C268.2, C269.2, C270.2, C271.2, C272.2, C273.2, C274.2, C275.2 (-), C276.2, C277.2, C278.2, C279.2, C280.2, C281.2, C282.2, C283.2, C284.2, C289.2, C290.2, C291.2, C292.2, C293.2, C294.2, C295.2, C296.2, C297.2, C302.2, C303.2, C304.2, C305.2, C306.2, C307.2, C314.2, R251.2, R253.2, R255.2, R256.2, R259.2, R261.1, TP24.1, U6.8 (ADR), U6.[5,20,25,26,31,32,3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 (GND), U7.[5,20,25,26,31,32,3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 (GND), U25.20 (AGND), U25.[11,12,21] (PGND)
I2S_BCK: U6.13 (SCLK), U7.13 (SCLK)
I2S_LRCK: U6.12 (LRCLK), U7.12 (LRCLK)
I2S_SDATA: U6.14 (SDIN), U7.14 (SDIN)
unnamed: C265.1, U25.1 (VCC)
unnamed: C266.1, U25.10 (SS)
unnamed: C267.1, U25.8 (BOOT)
unnamed: C267.2, L200.2, R252.2, U25.[4-7] (SW)
unnamed: C268.1, R254.2
unnamed: C269.1, R254.1, U25.18 (COMP)
unnamed: C282.1, U6.7 (VR_DIG)
unnamed: C283.1, U6.18 (GVDD)
unnamed: C284.1, U6.19 (AVDD)
unnamed: C285.1, U6.1 (BST_A+)
unnamed: C285.2, L201.1, U6.2 (OUT_A+)
unnamed: C286.1, L202.1, U6.30 (OUT_A-)
unnamed: C286.2, U6.29 (BST_A-)
unnamed: C287.1, U6.24 (BST_B+)
unnamed: C287.2, L203.1, U6.23 (OUT_B+)
unnamed: C288.1, L204.1, U6.27 (OUT_B-)
unnamed: C288.2, U6.28 (BST_B-)
unnamed: C295.1, U7.7 (VR_DIG)
unnamed: C296.1, U7.18 (GVDD)
unnamed: C297.1, U7.19 (AVDD)
unnamed: C298.1, U7.1 (BST_A+)
unnamed: C298.2, C299.1, L205.1, U7.2 (OUT_A+), U7.30 (OUT_A-)
unnamed: C299.2, U7.29 (BST_A-)
unnamed: C300.1, U7.24 (BST_B+)
unnamed: C300.2, C301.1, L206.1, U7.23 (OUT_B+), U7.27 (OUT_B-)
unnamed: C301.2, U7.28 (BST_B-)
unnamed: C302.1, J9.1, L201.2
unnamed: C303.1, J9.2, L202.2
unnamed: C304.1, J10.1, L203.2
unnamed: C305.1, J10.2, L204.2
unnamed: C306.1, J11.1, L205.2
unnamed: C307.1, J11.2, L206.2
unnamed: R250.2, R251.1, U25.17 (FB)
unnamed: R252.1, U25.3 (FSW)
unnamed: R253.1, U25.19 (ILIM)
unnamed: R256.1, U25.13 (MODE)
unnamed: R257.2, U6.17 (~PDN)
unnamed: R258.2, U7.17 (~PDN)
unnamed: R261.2, U7.8 (ADR)
PVDD_AMP: C270.1, C271.1, C272.1, C273.1, C274.1, C275.1 (+), C276.1, C277.1, C278.1, C279.1, C289.1, C290.1, C291.1, C292.1, C314.1, R250.1, TP10.1, U6.[3,4,21,22] (PVDD), U7.[3,4,21,22] (PVDD), U25.[14-16] (VOUT)
SYS_RAW: C260.1, C261.1, C262.1, C263.1, C264.1, L200.1, U25.9 (VIN)

Notes on the sheet:
FRONT_L
FRONT_R
WOOFER
U7 PBTL pairing verified against SLASEH7F Fig. 159 / 10.2.5 (page 86 rendered): OUT_A+ (2) with OUT_A- (30) merged to L205; OUT_B+ (23) with OUT_B- (27) merged to L206; speaker between the two filtered nodes.
Firmware: write DAMP_PBTL (reg 0x02 bit 2) = 1 on U7 before it leaves Hi-Z; the PBTL mixer takes the left I2S frame, so the U7 DSP forms (L+R)/2. No cycle-by-cycle current limit in PBTL.
U25: VOUT = 1.204 V x (1 + 499k/56k) = 11.93 V (PFM: 12.0 V; OVP 12.7-13.6 V). FSW about 494 kHz (RFREQ 301k). ILIM 150k = 7.9 A typ, 6.6 A min in PFM (equation 3). L200 Isat 19.6 A.
COMP: R254 82k, C268 6.8nF, C269 47pF (equations 18-20, fc about 5 kHz, effective Co about 170 uF): calculated only, bench check required. MODE floating = PFM; R256 DNP 0R to GND = forced PWM.
TAS5825M addresses: U6 ADR tied directly to GND = 0x4C, U7 ADR 1k = 0x4D. AMP_PDN shared (1k each, 100k pull-down). GPIO0 = FAULTZ (open drain) wired-OR to AMP_FAULT_N, 10k pull-up to 3V3_AUDIO. GPIO1/2 not connected.
DVDD = 3V3_AUDIO. Bootstrap caps are 0.47uF (Table 66). Filter 22uH + 0.68uF per output. No MCLK pin: TAS5825M locks to SCLK. Speaker connectors: pin 1 +, pin 2 -.
