chithigun23/DesktopSpeaker/ai-files/fab/draft-rt14/out/work/Bluetooth.kicad_sch

## KiCad design ai-files/fab/draft-rt14/out/work/Bluetooth.kicad_sch (2026-10-10)

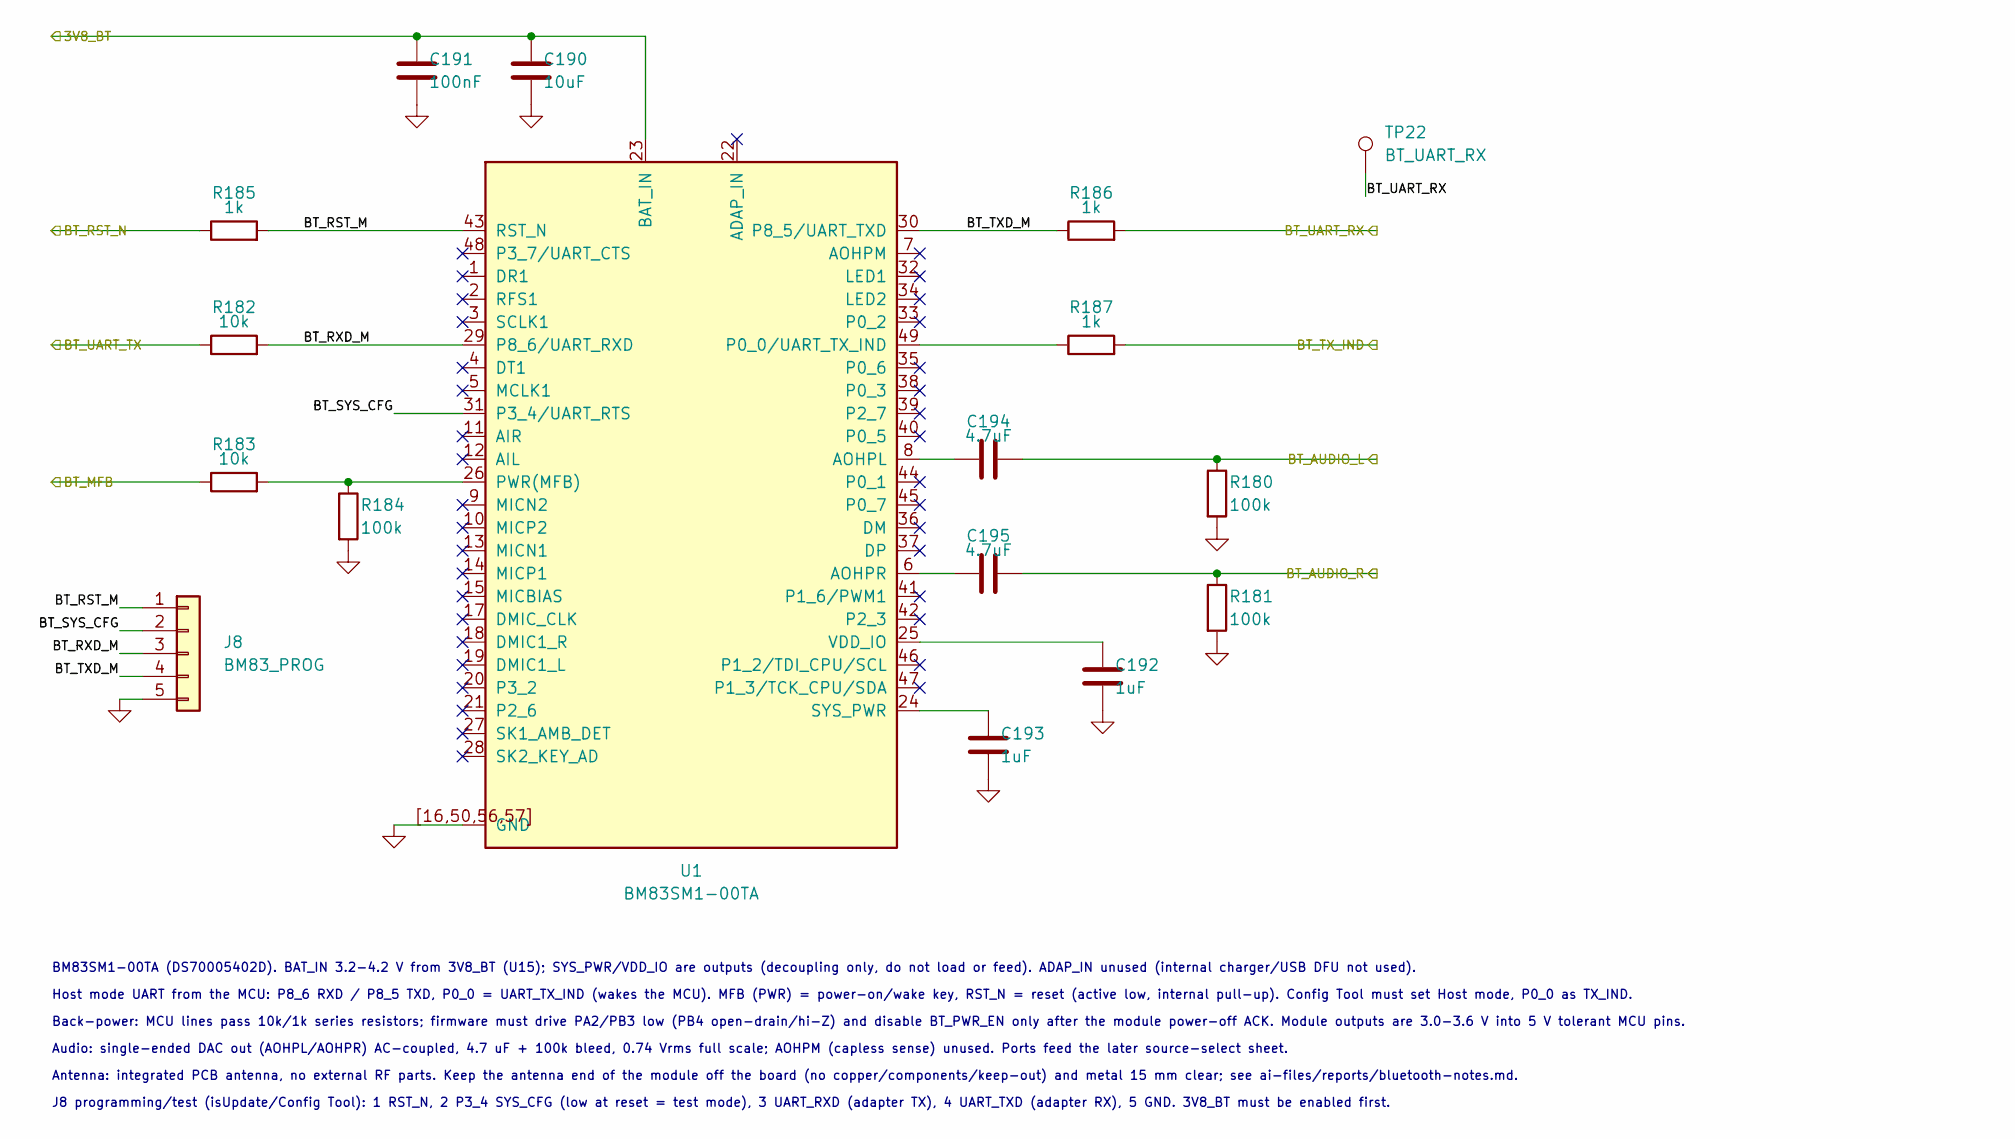
[picture p373: schematic Bluetooth.kicad_sch]

Parts:
C190: 10uF; C_0805_2012Metric_Pad1.18x1.45mm_HandSolder; MPN CL21B106KPQNNNE; LCSC C32635
C191: 100nF; C_0402_1005Metric_Pad0.74x0.62mm_HandSolder; MPN GRM155R71H104KE14D; LCSC C77020
C192, C193: 1uF; C_0402_1005Metric_Pad0.74x0.62mm_HandSolder; MPN CL05A105KO5NNNC; LCSC C29266
C194, C195: 4.7uF; C_0805_2012Metric_Pad1.18x1.45mm_HandSolder; MPN CL21A475KAQNNNE; LCSC C1779
J8: BM83_PROG; PinHeader_1x05_P2.54mm_Vertical; MPN XY-MTP254-1X5; LCSC C54110162
R180, R181, R184: 100k; R_0402_1005Metric_Pad0.72x0.64mm_HandSolder; MPN RC0402FR-07100KL; LCSC C60491
R182, R183: 10k; R_0402_1005Metric_Pad0.72x0.64mm_HandSolder; MPN RC0402FR-0710KL; LCSC C60490
R185, R186, R187: 1k; R_0402_1005Metric_Pad0.72x0.64mm_HandSolder; MPN RC0402FR-071KL; LCSC C106235
TP22: BT_UART_RX; TestPoint_Keystone_5015_Micro_Mini
U1: BM83SM1-00TA; MPN BM83SM1-00TA; LCSC Part C6752723

Connections:
3V8_BT: C190.1, C191.1, U1.23 (BAT_IN)
BT_AUDIO_L: C194.2, R180.1
BT_AUDIO_R: C195.2, R181.1
BT_MFB: R183.1
BT_RST_M: J8.1, R185.2, U1.43 (RST_N)
BT_RST_N: R185.1
BT_RXD_M: J8.3, R182.2, U1.29 (P8_6/UART_RXD)
BT_SYS_CFG: J8.2, U1.31 (P3_4/UART_RTS)
BT_TXD_M: J8.4, R186.1, U1.30 (P8_5/UART_TXD)
BT_TX_IND: R187.2
BT_UART_RX: R186.2, TP22.1
BT_UART_TX: R182.1
GND: C190.2, C191.2, C192.2, C193.2, J8.5, R180.2, R181.2, R184.2, U1.[16,50,56,57] (GND)
unnamed: C192.1, U1.25 (VDD_IO)
unnamed: C193.1, U1.24 (SYS_PWR)
unnamed: C194.1, U1.8 (AOHPL)
unnamed: C195.1, U1.6 (AOHPR)
unnamed: R183.2, R184.1, U1.26 (PWR(MFB))
unnamed: R187.1, U1.49 (P0_0/UART_TX_IND)

Notes on the sheet:
BM83SM1-00TA (DS70005402D). BAT_IN 3.2-4.2 V from 3V8_BT (U15); SYS_PWR/VDD_IO are outputs (decoupling only, do not load or feed). ADAP_IN unused (internal charger/USB DFU not used).
Host mode UART from the MCU: P8_6 RXD / P8_5 TXD, P0_0 = UART_TX_IND (wakes the MCU). MFB (PWR) = power-on/wake key, RST_N = reset (active low, internal pull-up). Config Tool must set Host mode, P0_0 as TX_IND.
Back-power: MCU lines pass 10k/1k series resistors; firmware must drive PA2/PB3 low (PB4 open-drain/hi-Z) and disable BT_PWR_EN only after the module power-off ACK. Module outputs are 3.0-3.6 V into 5 V tolerant MCU pins.
Audio: single-ended DAC out (AOHPL/AOHPR) AC-coupled, 4.7 uF + 100k bleed, 0.74 Vrms full scale; AOHPM (capless sense) unused. Ports feed the later source-select sheet.
Antenna: integrated PCB antenna, no external RF parts. Keep the antenna end of the module off the board (no copper/components/keep-out) and metal 15 mm clear; see ai-files/reports/bluetooth-notes.md.
J8 programming/test (isUpdate/Config Tool): 1 RST_N, 2 P3_4 SYS_CFG (low at reset = test mode), 3 UART_RXD (adapter TX), 4 UART_TXD (adapter RX), 5 GND. 3V8_BT must be enabled first.
