chithigun23/DesktopSpeaker/ai-files/fab/draft-rt14/out/work/Bluetooth_Power.kicad_sch

## KiCad design ai-files/fab/draft-rt14/out/work/Bluetooth_Power.kicad_sch (2026-11-02)

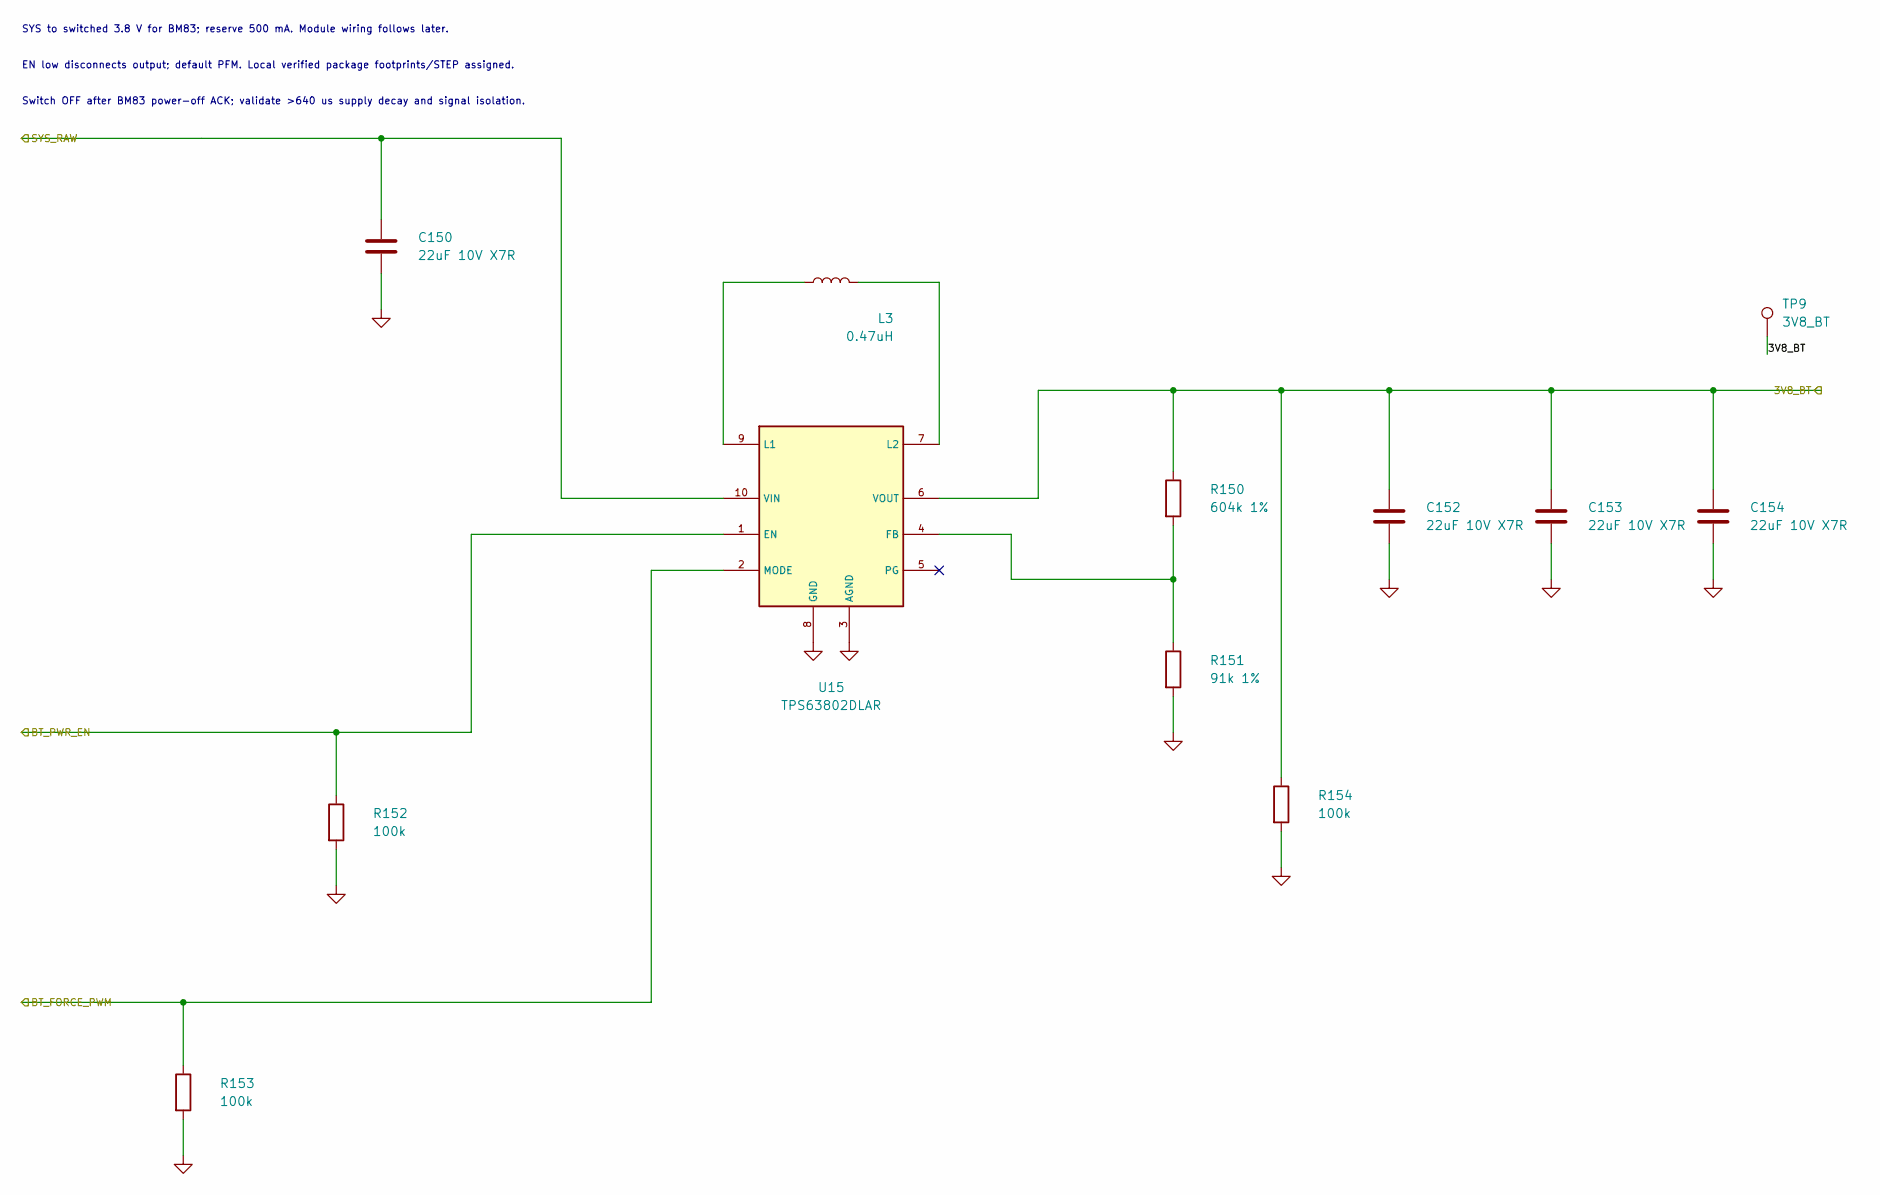
[picture p374: schematic Bluetooth_Power.kicad_sch]

Parts:
C150, C152, C153, C154: 22uF 10V X7R; C_0805_2012Metric_Pad1.18x1.45mm_HandSolder; MPN GRM21BZ71A226ME15L; LCSC C907991
L3: 0.47uH; Coilcraft_XFL4015-471MEC; MPN XFL4015-471MEC; LCSC Part C18221164
R150: 604k 1%; R_0402_1005Metric_Pad0.72x0.64mm_HandSolder; MPN 0402WGF6043TCE; LCSC C27013
R151: 91k 1%; R_0402_1005Metric_Pad0.72x0.64mm_HandSolder; MPN AC0402FR-0791KL; LCSC C144733
R152, R153, R154: 100k; R_0402_1005Metric_Pad0.72x0.64mm_HandSolder; MPN RC0402FR-07100KL; LCSC C60491
TP9: 3V8_BT; TestPoint_Keystone_5015_Micro_Mini
U15: TPS63802DLAR; MPN TPS63802DLAR; LCSC Part C2845237

Connections:
3V8_BT: C152.1, C153.1, C154.1, R150.1, R154.1, TP9.1, U15.6 (VOUT)
BT_FORCE_PWM: R153.1, U15.2 (MODE)
BT_PWR_EN: R152.1, U15.1 (EN)
GND: C150.2, C152.2, C153.2, C154.2, R151.2, R152.2, R153.2, R154.2, U15.3 (AGND), U15.8 (GND)
unnamed: L3.1, U15.9 (L1)
unnamed: L3.2, U15.7 (L2)
unnamed: R150.2, R151.1, U15.4 (FB)
SYS_RAW: C150.1, U15.10 (VIN)

Notes on the sheet:
SYS to switched 3.8 V for BM83; reserve 500 mA. Module wiring follows later.
EN low disconnects output; default PFM. Local verified package footprints/STEP assigned.
Switch OFF after BM83 power-off ACK; validate >640 us supply decay and signal isolation.
