chithigun23/DesktopSpeaker/ai-files/fab/draft-rt14/out/work/DesktopSpeaker.kicad_sch

## KiCad design ai-files/fab/draft-rt14/out/work/DesktopSpeaker.kicad_sch (2026-11-02)

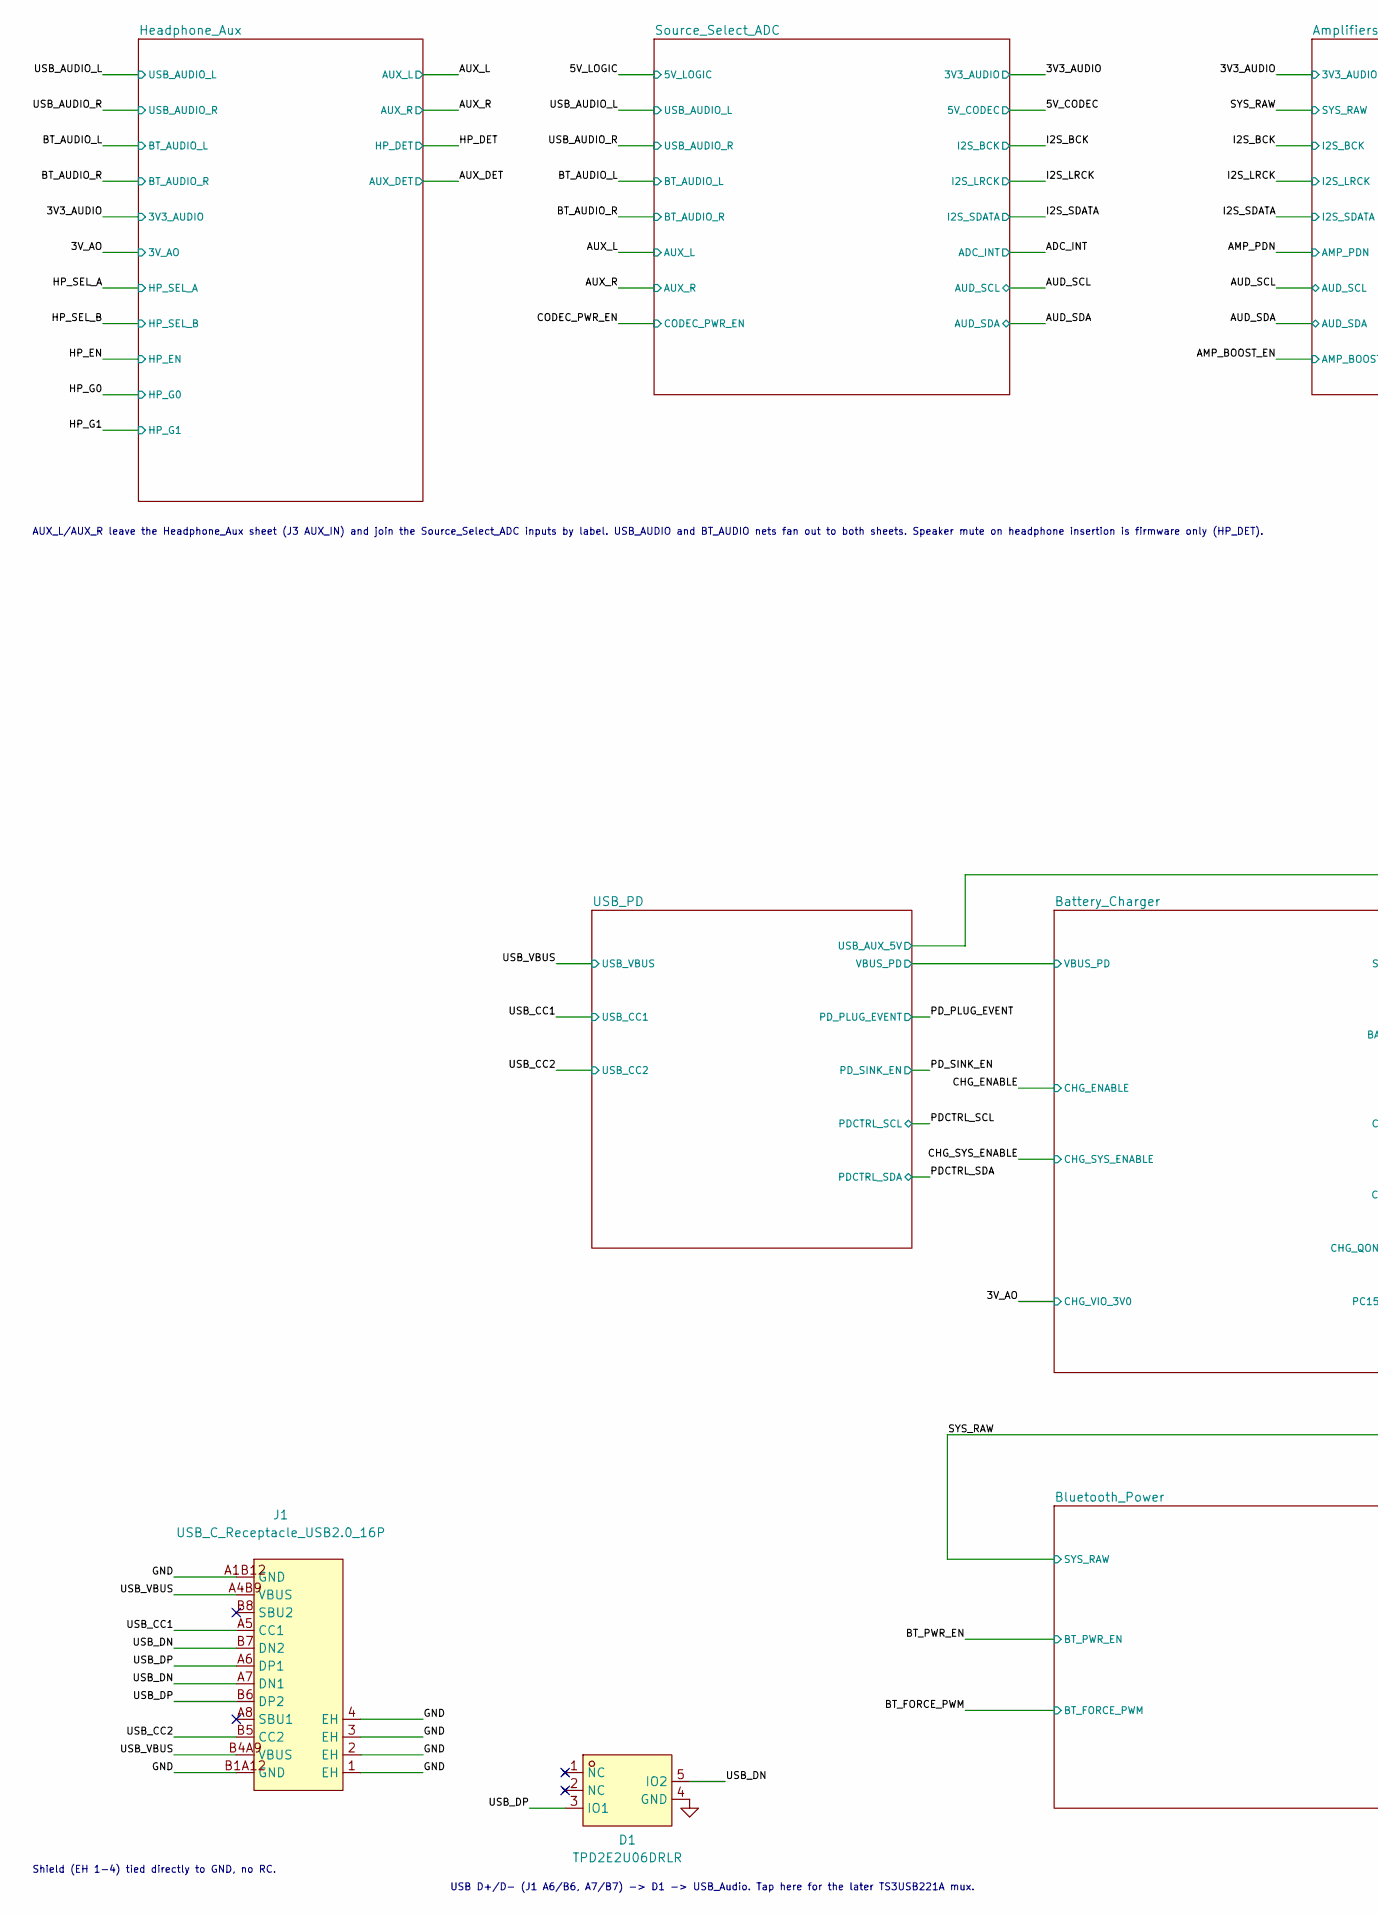
[picture p375: schematic DesktopSpeaker.kicad_sch, part in row 1, column 1]

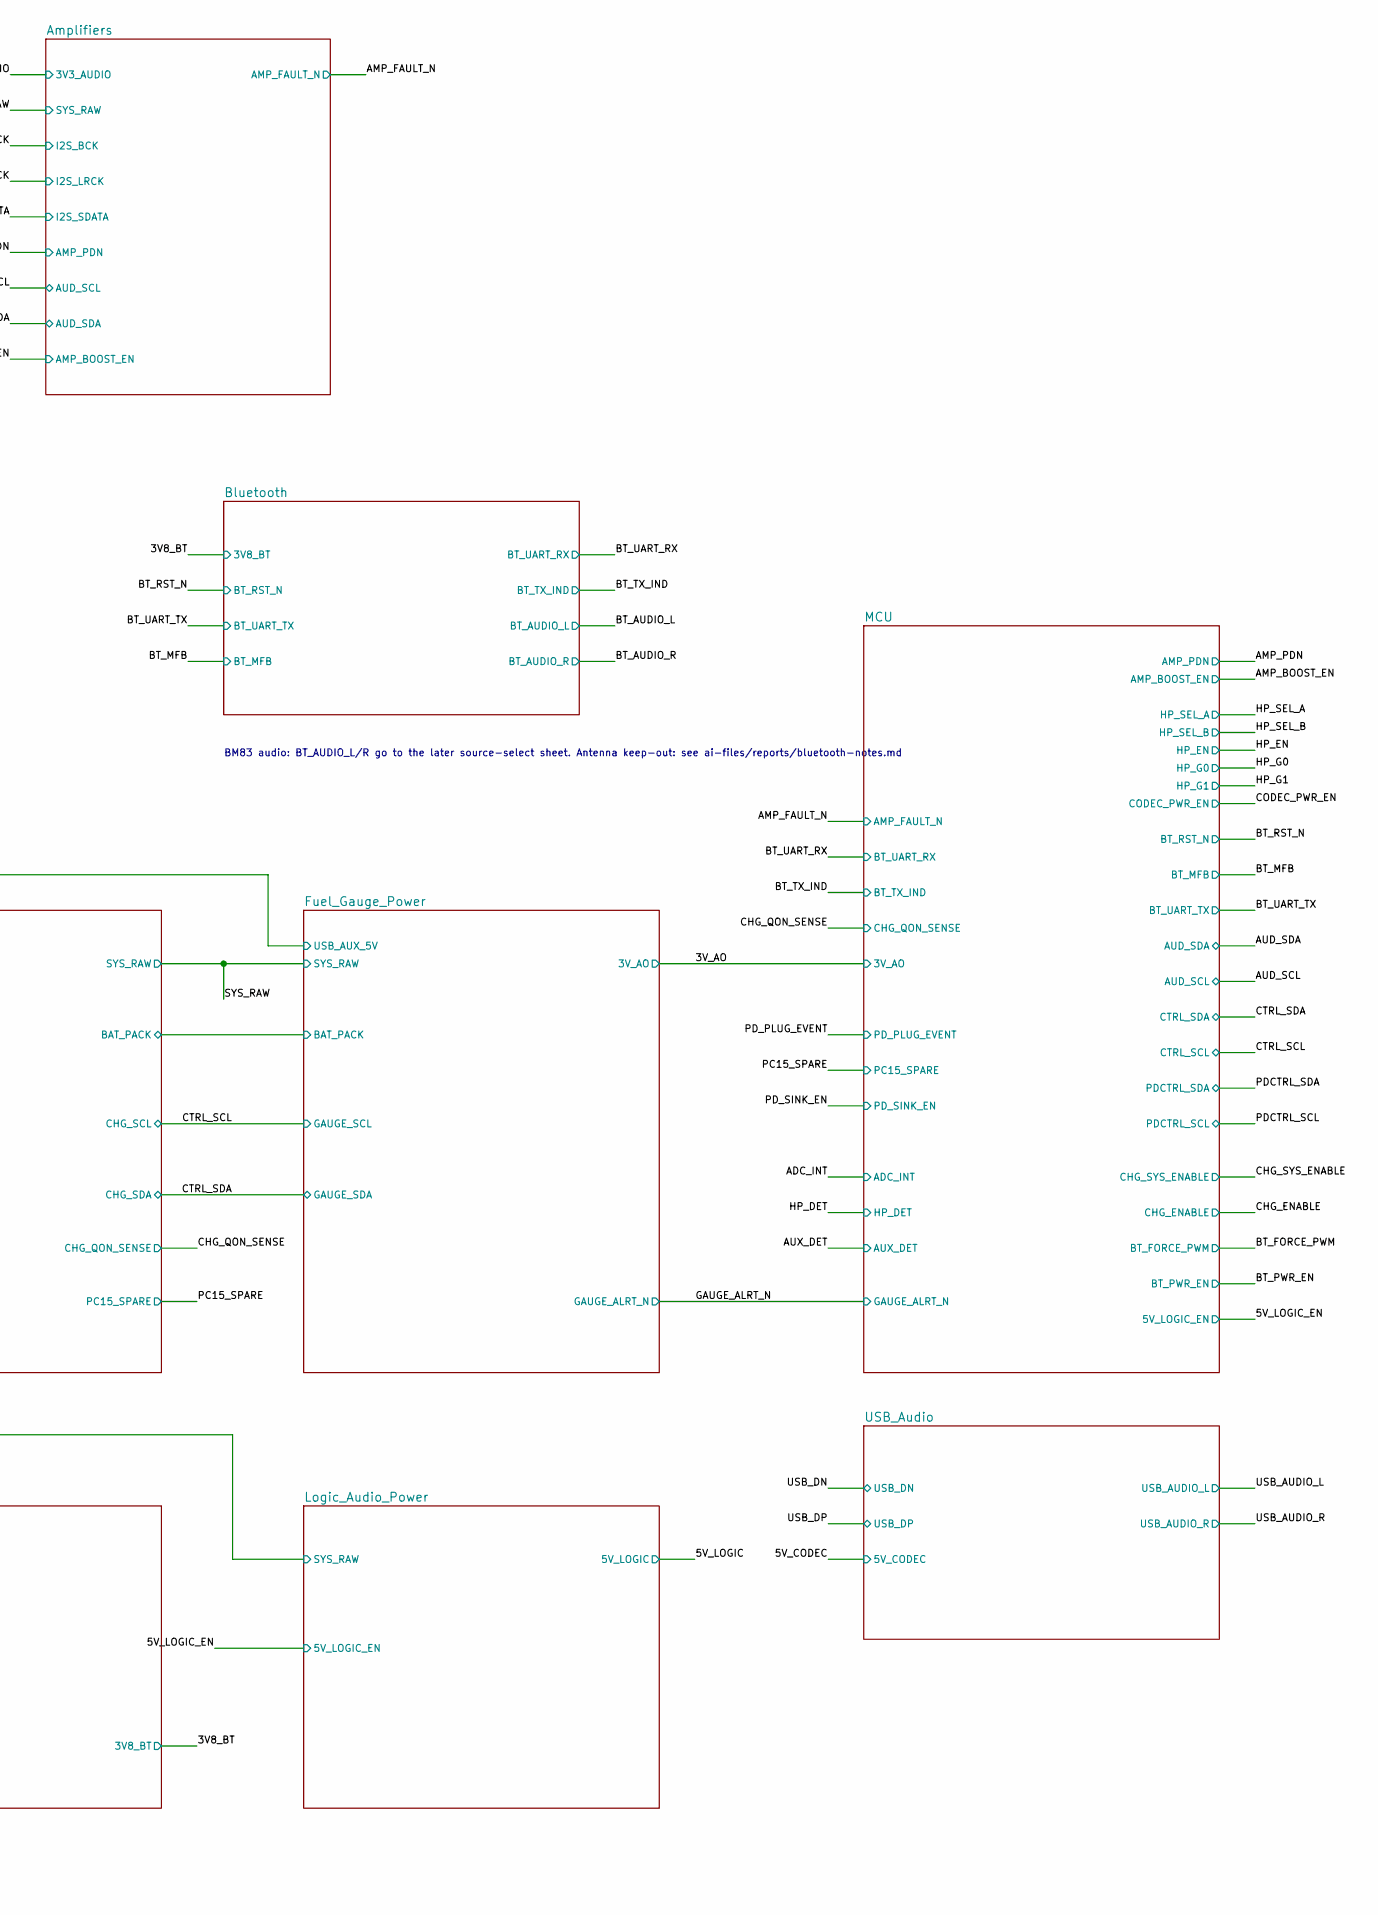
[picture p376: schematic DesktopSpeaker.kicad_sch, part in row 1, column 2]

Parts:
D1: TPD2E2U06DRLR; MPN TPD2E2U06DRLR; LCSC Part C1972959
J1: USB_C_Receptacle_USB2.0_16P; TYPE-C-31-M-12; MPN TYPE-C-31-M-12; LCSC Part C165948

Connections:
GND: D1.4 (GND), J1.1 (EH), J1.2 (EH), J1.3 (EH), J1.4 (EH), J1.A1B12 (GND), J1.B1A12 (GND)
USB_CC1: J1.A5 (CC1)
USB_CC2: J1.B5 (CC2)
USB_DN: D1.5 (IO2), J1.A7 (DN1), J1.B7 (DN2)
USB_DP: D1.3 (IO1), J1.A6 (DP1), J1.B6 (DP2)
USB_VBUS: J1.A4B9 (VBUS), J1.B4A9 (VBUS)

Notes on the sheet:
USB D+/D- (J1 A6/B6, A7/B7) -> D1 -> USB_Audio. Tap here for the later TS3USB221A mux.
Shield (EH 1-4) tied directly to GND, no RC.
BM83 audio: BT_AUDIO_L/R go to the later source-select sheet. Antenna keep-out: see ai-files/reports/bluetooth-notes.md
AUX_L/AUX_R leave the Headphone_Aux sheet (J3 AUX_IN) and join the Source_Select_ADC inputs by label. USB_AUDIO and BT_AUDIO nets fan out to both sheets. Speaker mute on headphone insertion is firmware only (HP_DET).
