chithigun23/DesktopSpeaker/ai-files/fab/draft-rt14/out/work/Fuel_Gauge_Power.kicad_sch

## KiCad design ai-files/fab/draft-rt14/out/work/Fuel_Gauge_Power.kicad_sch (2026-10-10)

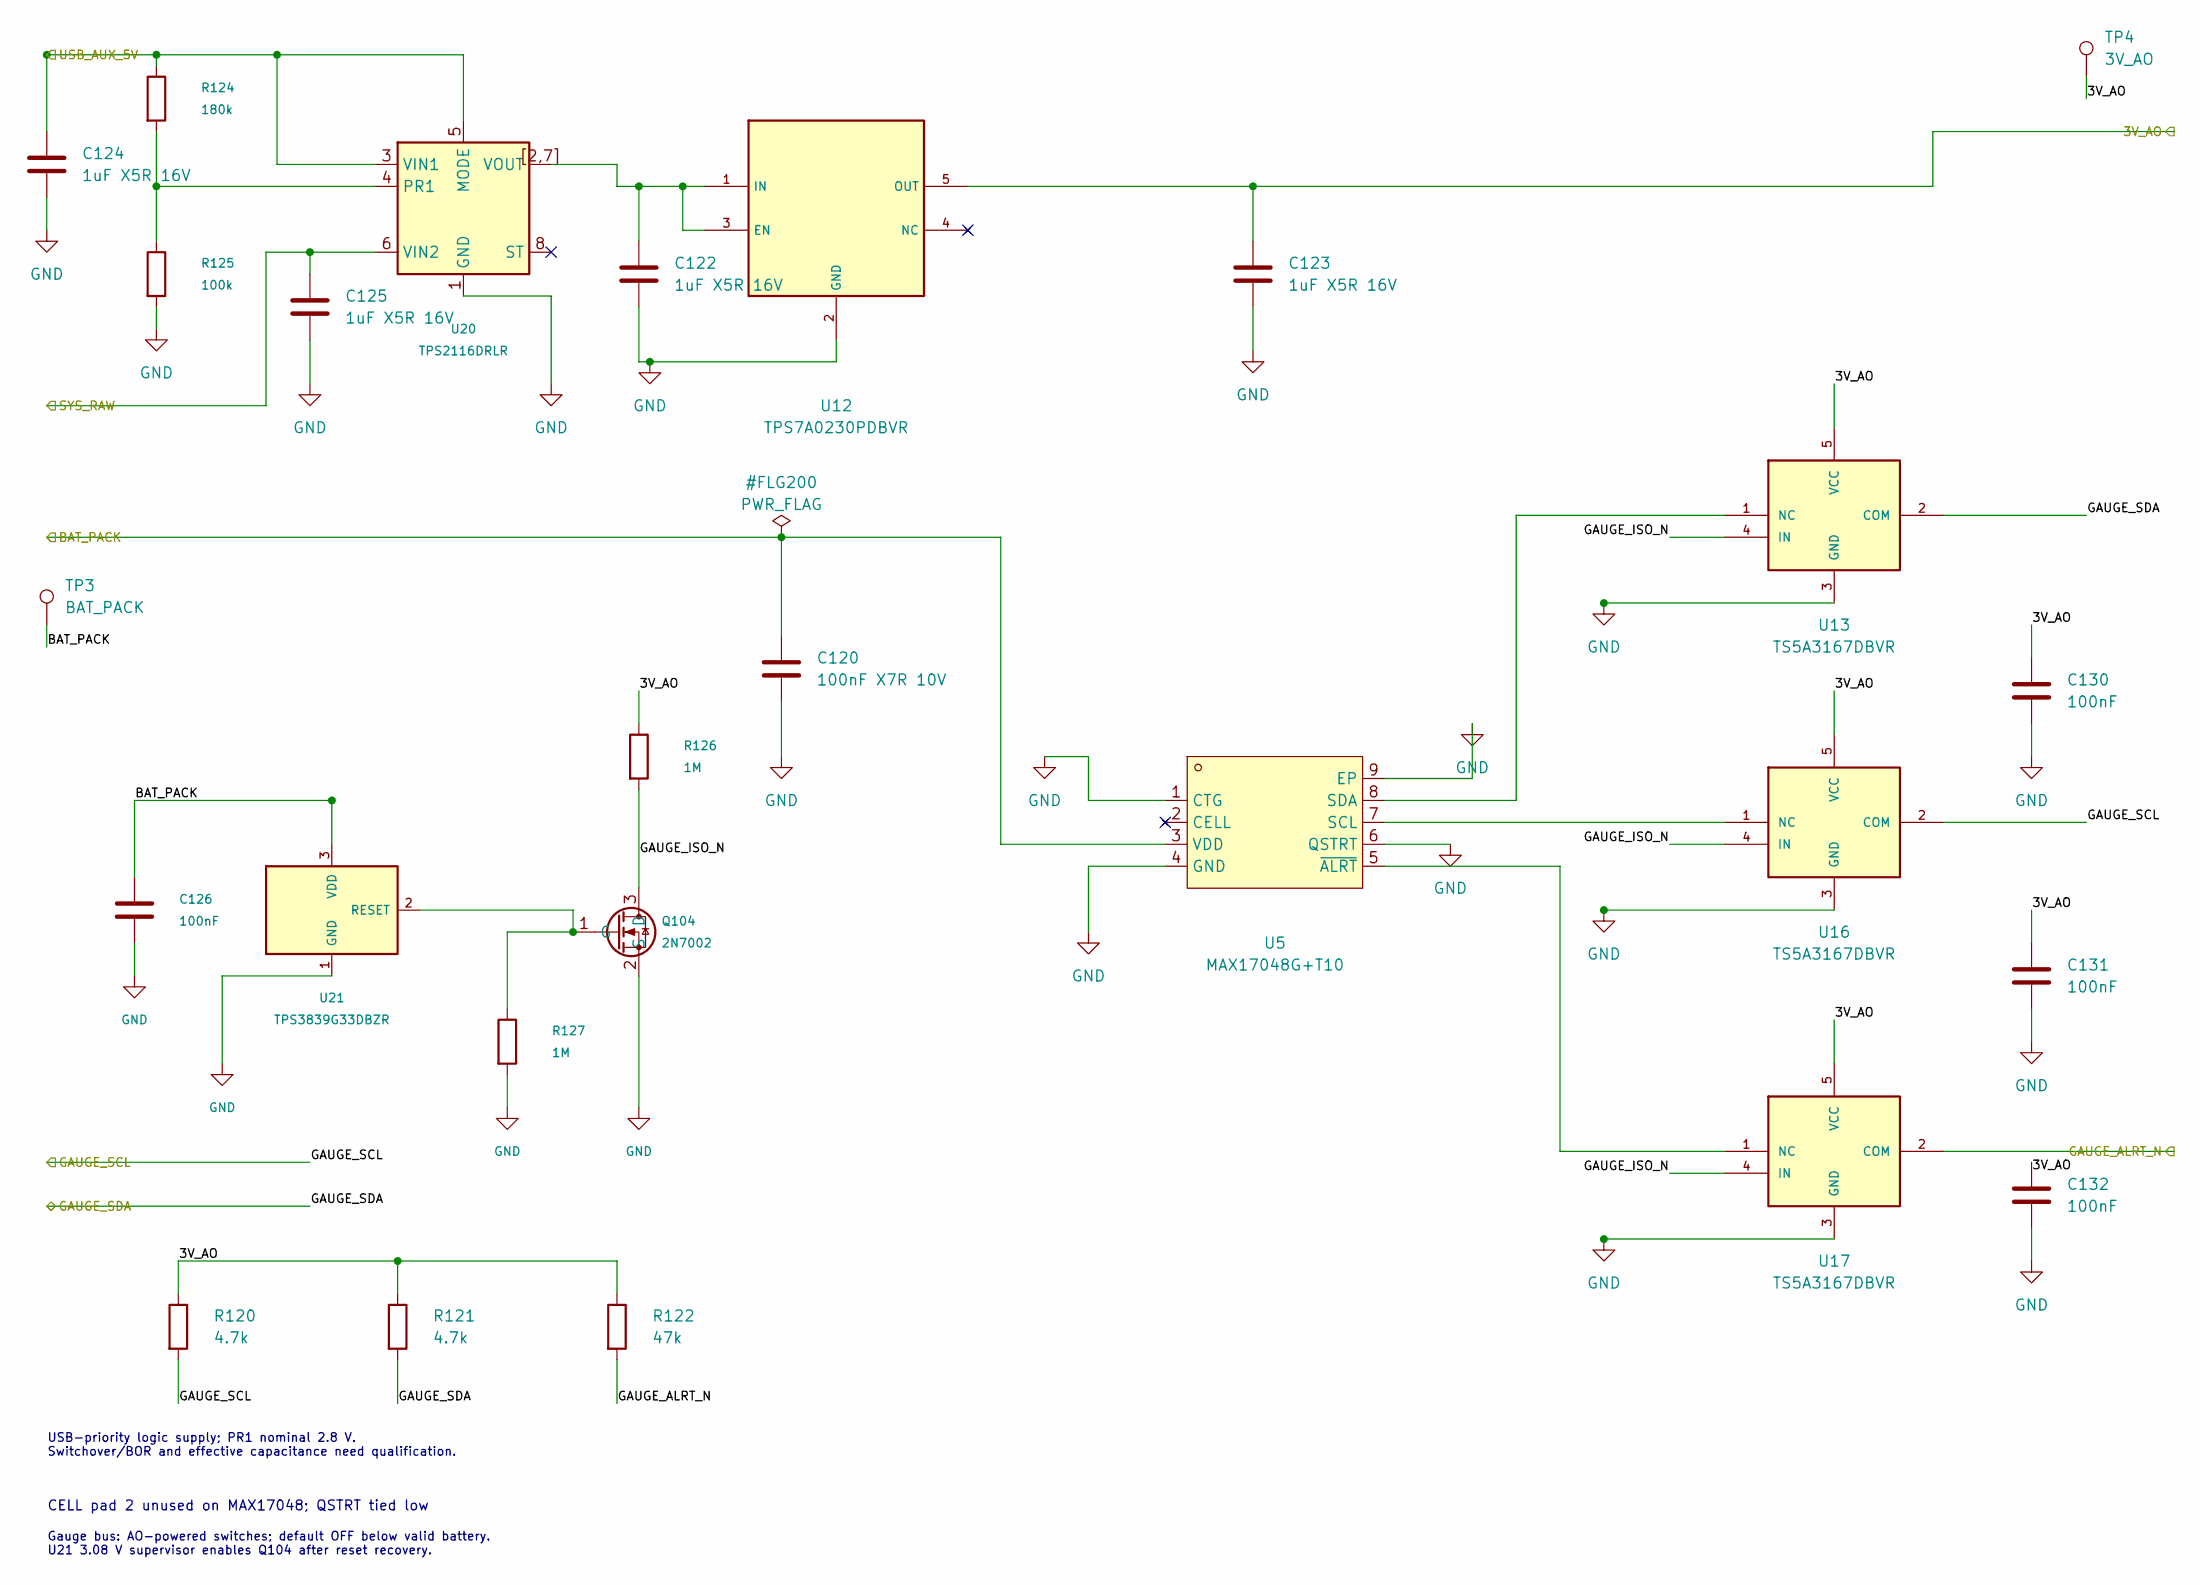
[picture p377: schematic Fuel_Gauge_Power.kicad_sch]

Parts:
C120: 100nF X7R 10V; C_0402_1005Metric_Pad0.74x0.62mm_HandSolder; MPN GRM155R71H104KE14D; LCSC C77020
C122, C123, C124, C125: 1uF X5R 16V; C_0402_1005Metric_Pad0.74x0.62mm_HandSolder; MPN CL05A105KO5NNNC; LCSC C29266
C126, C130, C131, C132: 100nF; C_0402_1005Metric_Pad0.74x0.62mm_HandSolder; MPN GRM155R71H104KE14D; LCSC C77020
Q104: 2N7002; MPN 2N7002,215; LCSC C65189
R120, R121: 4.7k; R_0402_1005Metric_Pad0.72x0.64mm_HandSolder; MPN RC0402FR-074K7L; LCSC C105871
R122: 47k; R_0402_1005Metric_Pad0.72x0.64mm_HandSolder; MPN RC0402FR-0747KL; LCSC C93943
R124: 180k; R_0402_1005Metric_Pad0.72x0.64mm_HandSolder; MPN RC0402FR-07180KL; LCSC C138046
R125: 100k; R_0402_1005Metric_Pad0.72x0.64mm_HandSolder; MPN RC0402FR-07100KL; LCSC C60491
R126, R127: 1M; R_0402_1005Metric_Pad0.72x0.64mm_HandSolder; MPN RC0402FR-071ML; LCSC C138033
TP3: BAT_PACK; TestPoint_Keystone_5015_Micro_Mini
TP4: 3V_AO; TestPoint_Keystone_5015_Micro_Mini
U5: MAX17048G+T10; MPN MAX17048G+T10; LCSC Part C2682616
U12: TPS7A0230PDBVR; MPN TPS7A0230PDBVR; LCSC C3747031
U13, U16, U17: TS5A3167DBVR; MPN TS5A3167DBVR; LCSC C128416
U20: TPS2116DRLR; MPN TPS2116DRLR; LCSC C3235557
U21: TPS3839G33DBZR; MPN TPS3839G33DBZR; LCSC Part C485802

Connections:
3V_AO: C123.1, C130.1, C131.1, C132.1, R120.1, R121.1, R122.1, R126.1, TP4.1, U12.5 (OUT), U13.5 (VCC), U16.5 (VCC), U17.5 (VCC)
BAT_PACK: C120.1, C126.1, TP3.1, U5.3 (VDD), U21.3 (VDD)
GAUGE_ALRT_N: R122.2, U17.2 (COM)
GAUGE_ISO_N: Q104.3 (D), R126.2, U13.4 (IN), U16.4 (IN), U17.4 (IN)
GAUGE_SCL: R120.2, U16.2 (COM)
GAUGE_SDA: R121.2, U13.2 (COM)
GND: C120.2, C122.2, C123.2, C124.2, C125.2, C126.2, C130.2, C131.2, C132.2, Q104.2 (S), R125.2, R127.2, U5.1 (CTG), U5.4 (GND), U5.6 (QSTRT), U5.9 (EP), U12.2 (GND), U13.3 (GND), U16.3 (GND), U17.3 (GND), U20.1 (GND), U21.1 (GND)
unnamed: C122.1, U12.1 (IN), U12.3 (EN), U20.[2,7] (VOUT)
unnamed: Q104.1 (G), R127.1, U21.2 (RESET)
unnamed: R124.2, R125.1, U20.4 (PR1)
unnamed: U5.8 (SDA), U13.1 (NC)
unnamed: U5.7 (SCL), U16.1 (NC)
unnamed: U5.5 (~ALRT), U17.1 (NC)
SYS_RAW: C125.1, U20.6 (VIN2)
USB_AUX_5V: C124.1, R124.1, U20.3 (VIN1), U20.5 (MODE)

Notes on the sheet:
CELL pad 2 unused on MAX17048; QSTRT tied low
Gauge bus: AO-powered switches; default OFF below valid battery. U21 3.08 V supervisor enables Q104 after reset recovery.
USB-priority logic supply; PR1 nominal 2.8 V. Switchover/BOR and effective capacitance need qualification.
