chithigun23/DesktopSpeaker/ai-files/fab/draft-rt14/out/work/Headphone_Aux.kicad_sch

## KiCad design ai-files/fab/draft-rt14/out/work/Headphone_Aux.kicad_sch (2026-10-10)

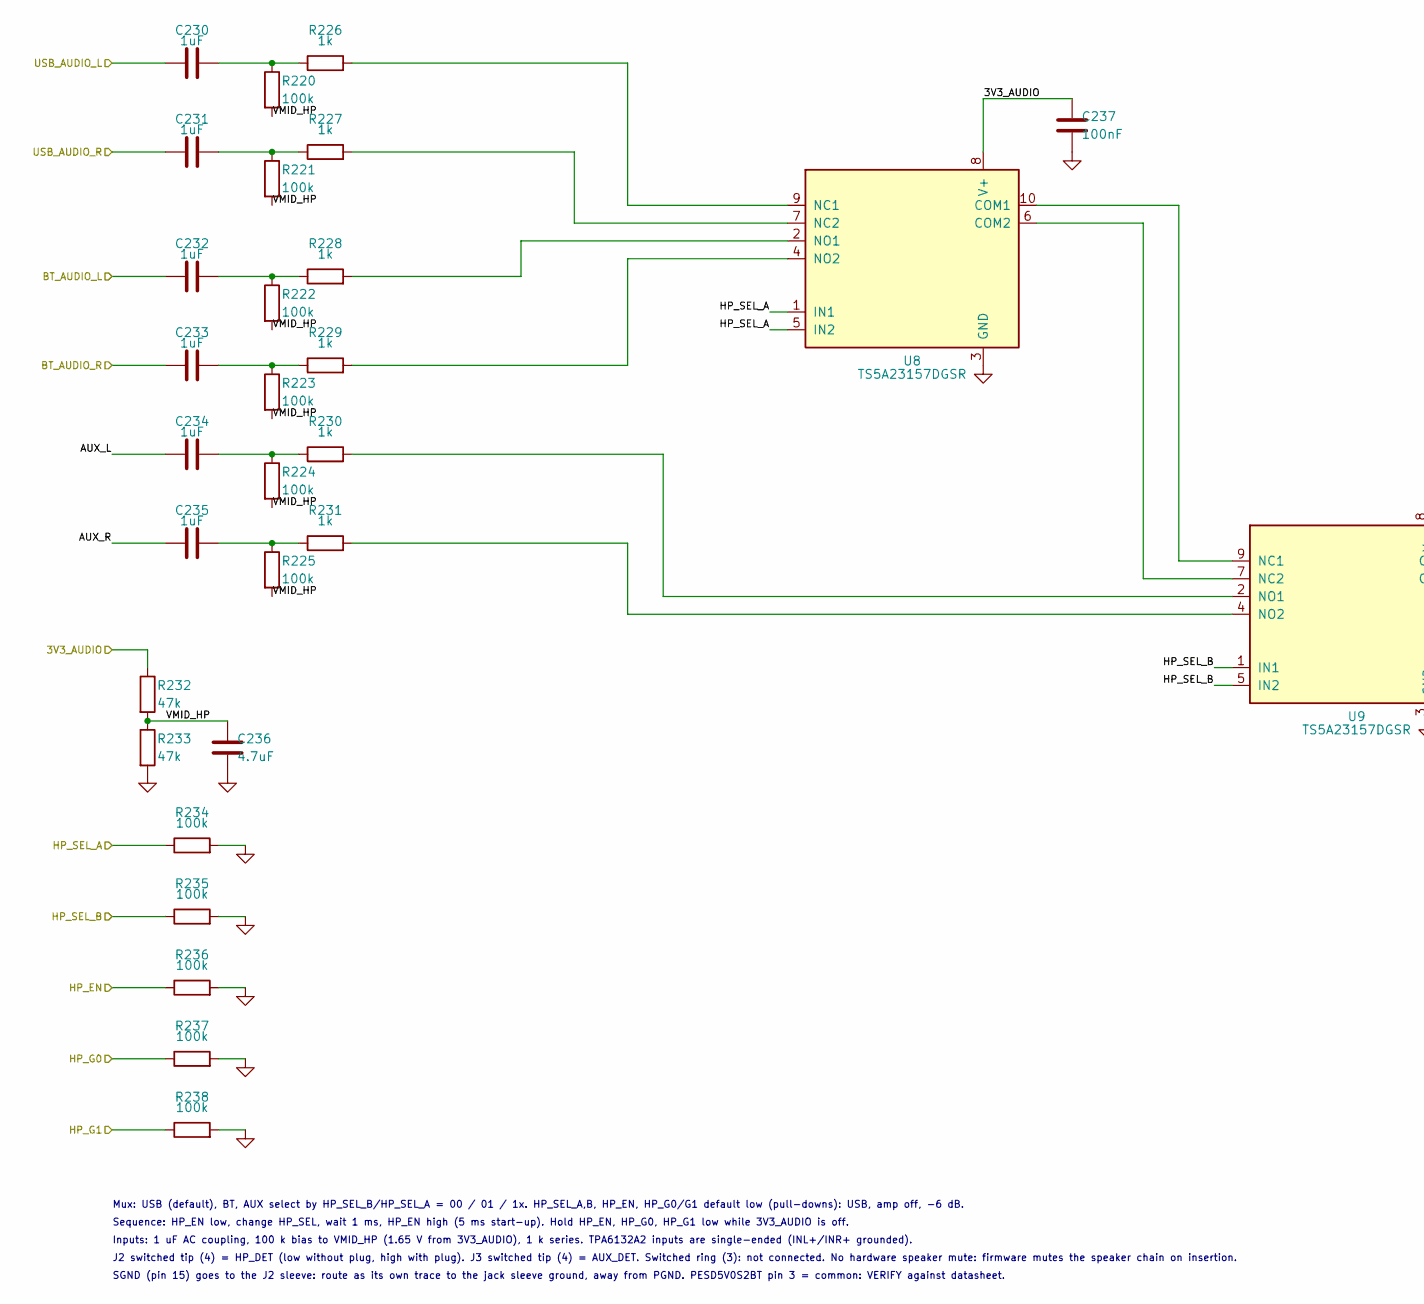
[picture p378: schematic Headphone_Aux.kicad_sch, part in row 1, column 1]

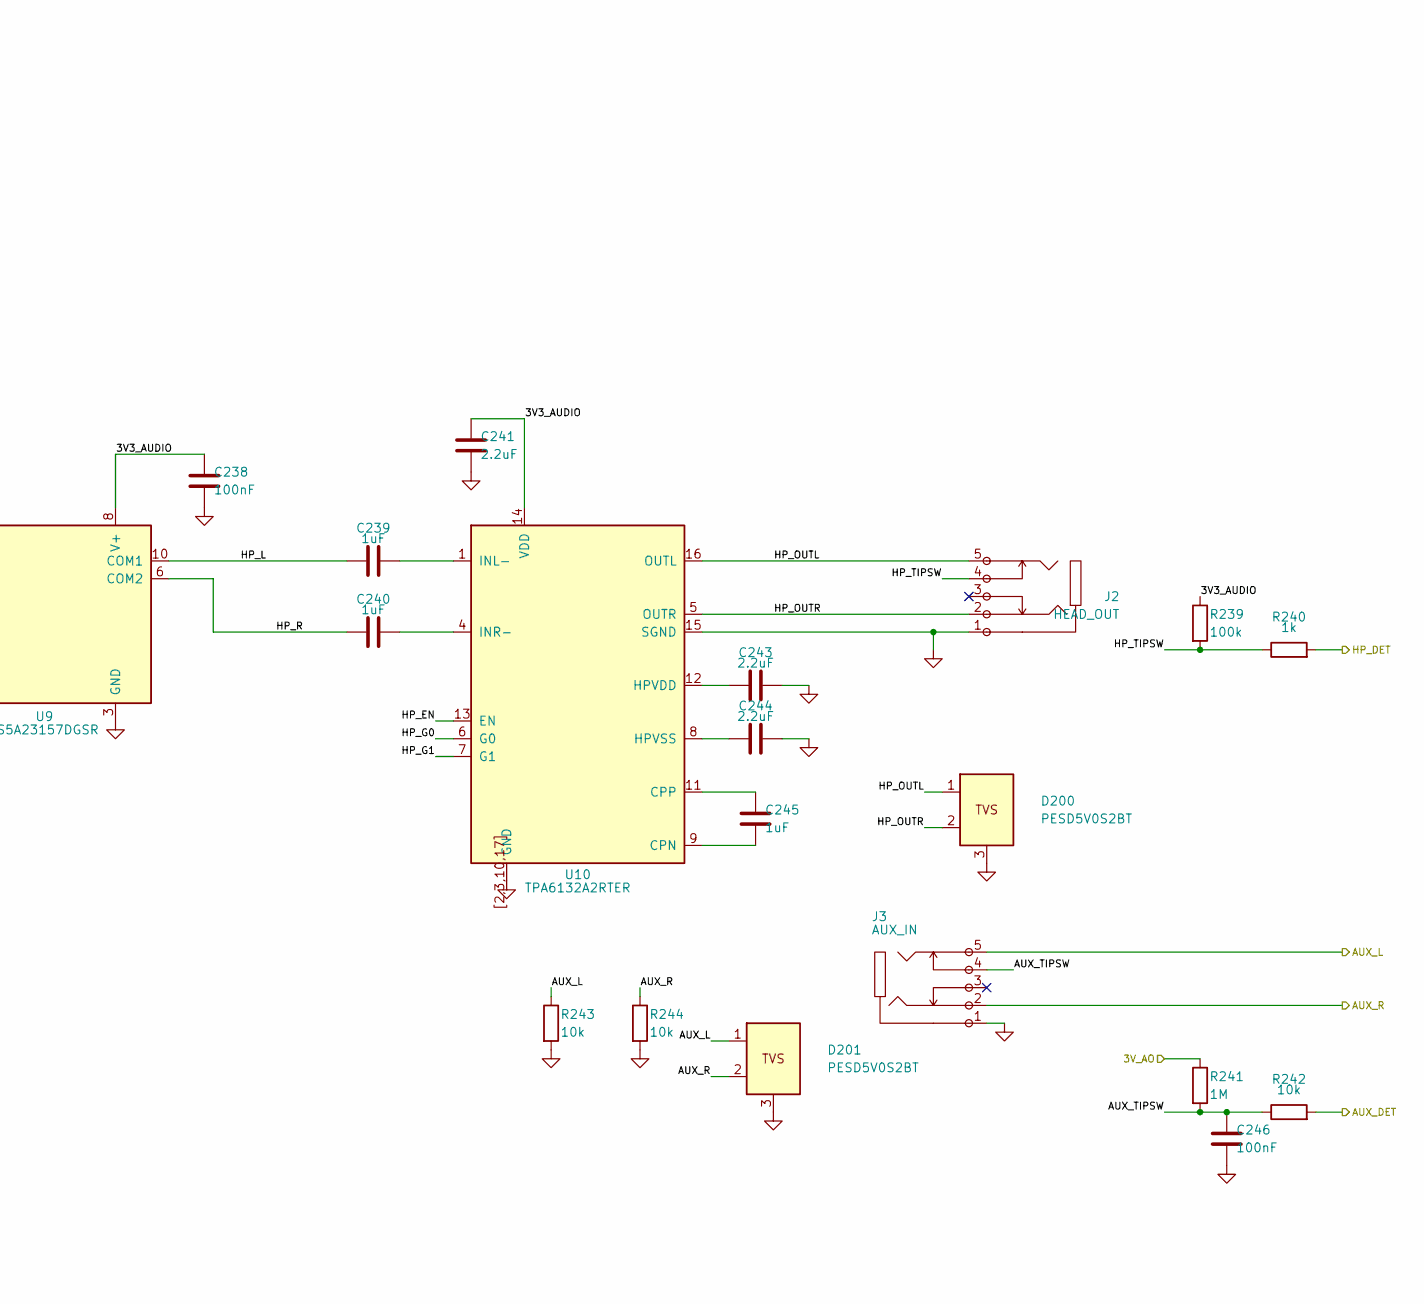
[picture p379: schematic Headphone_Aux.kicad_sch, part in row 1, column 2]

Parts:
C230, C231, C232, C233, C234, C235, C239, C240, C245: 1uF; C_0402_1005Metric_Pad0.74x0.62mm_HandSolder; MPN CL05A105KO5NNNC; LCSC C29266
C236: 4.7uF; C_0805_2012Metric_Pad1.18x1.45mm_HandSolder; MPN CL21A475KAQNNNE; LCSC C1779
C237, C238, C246: 100nF; C_0402_1005Metric_Pad0.74x0.62mm_HandSolder; MPN GRM155R71H104KE14D; LCSC C77020
C241, C243, C244: 2.2uF; C_0402_1005Metric_Pad0.74x0.62mm_HandSolder; MPN CL05A225KP5NNNC; LCSC C7464343
D200, D201: PESD5V0S2BT; MPN PESD5V0S2BT; LCSC Part C5380400
J2: HEAD_OUT; PJ-307; MPN PJ-307; LCSC Part C2939173
J3: AUX_IN; PJ-307; MPN PJ-307; LCSC Part C2939173
R220, R221, R222, R223, R224, R225, R234, R235, R236, R237, R238, R239: 100k; R_0402_1005Metric_Pad0.72x0.64mm_HandSolder; MPN RC0402FR-07100KL; LCSC C60491
R226, R227, R228, R229, R230, R231, R240: 1k; R_0402_1005Metric_Pad0.72x0.64mm_HandSolder; MPN RC0402FR-071KL; LCSC C106235
R232, R233: 47k; R_0402_1005Metric_Pad0.72x0.64mm_HandSolder; MPN RC0402FR-0747KL; LCSC C93943
R241: 1M; R_0402_1005Metric_Pad0.72x0.64mm_HandSolder; MPN RC0402FR-071ML; LCSC C138033
R242, R243, R244: 10k; R_0402_1005Metric_Pad0.72x0.64mm_HandSolder; MPN RC0402FR-0710KL; LCSC C60490
U8, U9: TS5A23157DGSR; MPN TS5A23157DGSR; LCSC Part C11133
U10: TPA6132A2RTER; MPN TPA6132A2RTER; LCSC Part C69901

Connections:
3V3_AUDIO: C237.1, C238.1, C241.1, R232.1, R239.1, U8.8 (V+), U9.8 (V+), U10.14 (VDD)
3V_AO: R241.1
AUX_DET: R242.2
AUX_L: C234.1, D201.1, J3.5 (TIP), R243.1
AUX_R: C235.1, D201.2, J3.2 (RING), R244.1
AUX_TIPSW: C246.1, J3.4 (TIP_SW), R241.2, R242.1
BT_AUDIO_L: C232.1
BT_AUDIO_R: C233.1
GND: C236.2, C237.2, C238.2, C241.2, C243.2, C244.2, C246.2, D200.3, D201.3, J2.1 (SLEEVE), J3.1 (SLEEVE), R233.2, R234.2, R235.2, R236.2, R237.2, R238.2, R243.2, R244.2, U8.3 (GND), U9.3 (GND), U10.15 (SGND), U10.[2,3,10,17] (GND)
HP_DET: R240.2
HP_EN: R236.1, U10.13 (EN)
HP_G0: R237.1, U10.6 (G0)
HP_G1: R238.1, U10.7 (G1)
HP_L: C239.1, U9.10 (COM1)
HP_OUTL: D200.1, J2.5 (TIP), U10.16 (OUTL)
HP_OUTR: D200.2, J2.2 (RING), U10.5 (OUTR)
HP_R: C240.1, U9.6 (COM2)
HP_SEL_A: R234.1, U8.1 (IN1), U8.5 (IN2)
HP_SEL_B: R235.1, U9.1 (IN1), U9.5 (IN2)
HP_TIPSW: J2.4 (TIP_SW), R239.2, R240.1
unnamed: C230.2, R220.1, R226.1
unnamed: C231.2, R221.1, R227.1
unnamed: C232.2, R222.1, R228.1
unnamed: C233.2, R223.1, R229.1
unnamed: C234.2, R224.1, R230.1
unnamed: C235.2, R225.1, R231.1
unnamed: C239.2, U10.1 (INL-)
unnamed: C240.2, U10.4 (INR-)
unnamed: C243.1, U10.12 (HPVDD)
unnamed: C244.1, U10.8 (HPVSS)
unnamed: C245.1, U10.11 (CPP)
unnamed: C245.2, U10.9 (CPN)
unnamed: R226.2, U8.9 (NC1)
unnamed: R227.2, U8.7 (NC2)
unnamed: R228.2, U8.2 (NO1)
unnamed: R229.2, U8.4 (NO2)
unnamed: R230.2, U9.2 (NO1)
unnamed: R231.2, U9.4 (NO2)
unnamed: U8.6 (COM2), U9.7 (NC2)
unnamed: U8.10 (COM1), U9.9 (NC1)
USB_AUDIO_L: C230.1
USB_AUDIO_R: C231.1
VMID_HP: C236.1, R220.2, R221.2, R222.2, R223.2, R224.2, R225.2, R232.2, R233.1

Notes on the sheet:
Mux: USB (default), BT, AUX select by HP_SEL_B/HP_SEL_A = 00 / 01 / 1x. HP_SEL_A,B, HP_EN, HP_G0/G1 default low (pull-downs): USB, amp off, -6 dB.
Sequence: HP_EN low, change HP_SEL, wait 1 ms, HP_EN high (5 ms start-up). Hold HP_EN, HP_G0, HP_G1 low while 3V3_AUDIO is off.
Inputs: 1 uF AC coupling, 100 k bias to VMID_HP (1.65 V from 3V3_AUDIO), 1 k series. TPA6132A2 inputs are single-ended (INL+/INR+ grounded).
J2 switched tip (4) = HP_DET (low without plug, high with plug). J3 switched tip (4) = AUX_DET. Switched ring (3): not connected. No hardware speaker mute: firmware mutes the speaker chain on insertion.
SGND (pin 15) goes to the J2 sleeve: route as its own trace to the jack sleeve ground, away from PGND. PESD5V0S2BT pin 3 = common: VERIFY against datasheet.
