chithigun23/DesktopSpeaker/ai-files/fab/draft-rt14/out/checks/kicad_pro-diff.txt

board-side .kicad_pro vs pristine project .kicad_pro: 0 differing keys
