chithigun23/DesktopSpeaker/ai-files/helpers/build_headphone_aux.py

#!/usr/bin/env python3
"""Create Headphone_Aux.kicad_sch (U8/U9 TS5A23157 mux, U10 TPA6132A2, J2 HEAD_OUT, J3 AUX_IN, D200/D201 ESD, passives),
move those parts out of the root keeping reference/value/UUID, add the root sheet block, connect the MCU reserved signals,
and fix the library symbols (functional pin grouping; pad numbers unchanged).  Guarded: refuses to run if the sheet exists.
Run from a clean tree.  Python 3, no dependencies."""
import re, sys, uuid, pathlib, shutil

ROOT = pathlib.Path('/home/chithi/Desktop/DesktopSpeaker/DesktopSpeaker-kicad')
LIB = ROOT / 'kicad-library/schematic'
FP = ROOT / 'kicad-library/footprint'
M3D = ROOT / 'kicad-library/3d'
OUT = ROOT / 'Headphone_Aux.kicad_sch'
if OUT.exists():
    sys.exit('Headphone_Aux.kicad_sch exists; refusing')
ROOT_UUID = 'feda53ed-537d-4f88-9436-c6075776255b'
SHEET_UUID = str(uuid.uuid4())
U = lambda: str(uuid.uuid4())
f = lambda v: ('%.4f' % v).rstrip('0').rstrip('.')
eff = '(effects (font (size 1.27 1.27)))'
hide = '(effects (font (size 1.27 1.27)) (hide yes))'

# ------------------------------------------------------------------ library symbols
def pin(t, x, y, a, name, num, ln=2.54):
    return f'(pin {t} line (at {f(x)} {f(y)} {a}) (length {f(ln)}) (name "{name}" {eff}) (number "{num}" {eff}))'

def make_sym(name, ref, ref_at, val_at, props, body, pins, hide_names=False):
    pn = '(pin_names (offset 1.016) (hide yes))' if hide_names else '(pin_names (offset 1.016))'
    base = (f'(property "Reference" "{ref}" (at {f(ref_at[0])} {f(ref_at[1])} 0) {eff}) '
            f'(property "Value" "{name}" (at {f(val_at[0])} {f(val_at[1])} 0) {eff}) '
            + ''.join(f'(property "{k}" "{v}" (at 0 0 0) {hide}) ' for k, v in props))
    unit = f'(symbol "{name}_0_1" {body}) (symbol "{name}_1_1" ' + ' '.join(pins) + ')'
    lib = (f'(kicad_symbol_lib (version 20250120) (generator "kicad_symbol_editor") (symbol "{name}" {pn} '
           f'(in_bom yes) (on_board yes) ' + base + unit + ' (embedded_fonts no)))\n')
    emb = (f'(symbol "{name}:{name}" {pn} (exclude_from_sim no) (in_bom yes) (on_board yes) (in_pos_files yes) '
           f'(duplicate_pin_numbers_are_jumpers no) ' + base + unit + ' (embedded_fonts no))')
    return lib, emb

def rect(x1, y1, x2, y2):
    return f'(rectangle (start {f(x1)} {f(y1)}) (end {f(x2)} {f(y2)}) (stroke (width 0.254) (type default)) (fill (type background)))'

DS = '${KIPRJMOD}/../ai-files/datasheets/'
# --- TS5A23157DGSR (VSSOP-10 DGS, SCDS165F table 5): 1 IN1, 2 NO1, 3 GND, 4 NO2, 5 IN2, 6 COM2, 7 NC2, 8 V+, 9 NC1, 10 COM1
ts_pins = [pin('passive', -17.78, 7.62, 0, 'NC1', '9'), pin('passive', -17.78, 5.08, 0, 'NC2', '7'),
           pin('passive', -17.78, 2.54, 0, 'NO1', '2'), pin('passive', -17.78, 0, 0, 'NO2', '4'),
           pin('input', -17.78, -7.62, 0, 'IN1', '1'), pin('input', -17.78, -10.16, 0, 'IN2', '5'),
           pin('passive', 17.78, 7.62, 180, 'COM1', '10'), pin('passive', 17.78, 5.08, 180, 'COM2', '6'),
           pin('power_in', 10.16, 15.24, 270, 'V+', '8'), pin('power_in', 10.16, -15.24, 90, 'GND', '3')]
ts_lib, ts_emb = make_sym('TS5A23157DGSR', 'U', (0, -14.6), (0, -16.5), [
    ('Footprint', 'DesktopSpeaker:TS5A23157DGSR'), ('Datasheet', DS + 'TS5A23157.pdf'),
    ('Manufacturer', 'Texas Instruments'), ('MPN', 'TS5A23157DGSR'), ('LCSC Part', 'C11133'),
    ('Description', 'Dual SPDT analog switch (2 x 1:2), 1.65-5.5 V, ~10 ohm, VSSOP-10 (DGS); pins grouped by function, pad numbers per SCDS165F')],
    rect(-15.24, 12.7, 15.24, -12.7), ts_pins)

# --- TPA6132A2RTER (WQFN-16 RTE + EP, SLOS597B): pads 2,3,10,17 are one native stack (all ground)
tp_pins = [pin('passive', -17.78, 12.7, 0, 'INL-', '1'), pin('passive', -17.78, 2.54, 0, 'INR-', '4'),
           pin('input', -17.78, -10.16, 0, 'EN', '13'), pin('input', -17.78, -12.7, 0, 'G0', '6'), pin('input', -17.78, -15.24, 0, 'G1', '7'),
           pin('passive', 17.78, 12.7, 180, 'OUTL', '16'), pin('passive', 17.78, 5.08, 180, 'OUTR', '5'), pin('passive', 17.78, 2.54, 180, 'SGND', '15'),
           pin('passive', 17.78, -5.08, 180, 'HPVDD', '12'), pin('passive', 17.78, -12.7, 180, 'HPVSS', '8'),
           pin('passive', 17.78, -20.32, 180, 'CPP', '11'), pin('passive', 17.78, -27.94, 180, 'CPN', '9'),
           pin('power_in', -7.62, 20.32, 270, 'VDD', '14'),
           pin('power_in', -10.16, -33.02, 90, 'GND', '[2,3,10,17]')]
tp_lib, tp_emb = make_sym('TPA6132A2RTER', 'U', (0, -49.9), (0, -51.8), [
    ('Footprint', 'DesktopSpeaker:TPA6132A2RTER'), ('Datasheet', DS + 'TPA6132A2.pdf'),
    ('Manufacturer', 'Texas Instruments'), ('MPN', 'TPA6132A2RTER'), ('LCSC Part', 'C69901'),
    ('Description', '25 mW capless stereo headphone amplifier with charge pump, WQFN-16 (RTE). GND stack = INL+ (2), INR+ (3), PGND (10), thermal pad (17); SGND (15) is separate for the jack sleeve')],
    rect(-15.24, 17.78, 15.24, -30.48), tp_pins)

# --- PESD5V0S2BT (SOT-23): 1 = K1, 2 = K2, 3 = common (VERIFY pin 3 against the Nexperia datasheet)
es_pins = [pin('passive', -6.35, 2.54, 0, '~', '1'), pin('passive', -6.35, -2.54, 0, '~', '2'), pin('passive', 0, -7.62, 90, '~', '3')]
es_body = (rect(-3.81, 5.08, 3.81, -5.08) +
           '(text "TVS" (at 0 0 0) (effects (font (size 1.27 1.27))))')
es_lib, es_emb = make_sym('PESD5V0S2BT', 'D', (7.62, 1.27), (7.62, -1.27), [
    ('Footprint', 'DesktopSpeaker:PESD5V0S2BT'), ('Datasheet', DS + 'PESD5V0S2BT.pdf'),
    ('Manufacturer', 'Nexperia'), ('MPN', 'PESD5V0S2BT'), ('LCSC Part', 'C5380400'),
    ('Description', 'Bidirectional two-line 5 V ESD protection diode, SOT-23: lines 1 and 2 each protected against common pin 3 (LCSC C5380400 is a DOWO second source; Nexperia part not stock-checked)')],
    es_body, es_pins, True)

for nm, txt in (('TS5A23157DGSR', ts_lib), ('TPA6132A2RTER', tp_lib), ('PESD5V0S2BT', es_lib)):
    p = LIB / f'{nm}.kicad_sym'
    if nm == 'PESD5V0S2BT' and p.exists(): sys.exit(f'{p} exists')
    p.write_text(txt)
# footprint + 3D model for PESD5V0S2BT: stock KiCad SOT-23 (same STEP already used by ESDA25L)
fp = (FP / 'ESDA25L.kicad_mod').read_text()
fp = fp.replace('(footprint "ESDA25L"', '(footprint "PESD5V0S2BT"', 1).replace('(property "Value" "ESDA25L"', '(property "Value" "PESD5V0S2BT"')
fp = fp.replace('kicad-library/3d/ESDA25L.step', 'kicad-library/3d/PESD5V0S2BT.step')
assert 'ESDA25L' not in fp
(FP / 'PESD5V0S2BT.kicad_mod').write_text(fp)
shutil.copyfile(M3D / 'ESDA25L.step', M3D / 'PESD5V0S2BT.step')

# ------------------------------------------------------------------ embedded library helpers
def grab(text, name):
    i = text.index(f'(symbol "{name}"'); d = 0; j = i
    while True:
        if text[j] == '(': d += 1
        elif text[j] == ')':
            d -= 1
            if d == 0: break
        j += 1
    return text[i:j + 1]
fg = (ROOT / 'Fuel_Gauge_Power.kicad_sch').read_text()
PD_C = grab(fg, 'PD_C:PD_C'); PD_R = grab(fg, 'PD_R:PD_R'); GND = grab(fg, 'power:GND')
rt = (ROOT / 'DesktopSpeaker.kicad_sch').read_text()
PJ = grab(rt, 'PJ-307:PJ-307')

def symblock(text, ref):
    k = text.index(f'(property "Reference" "{ref}"')
    a = text.rfind('(symbol (lib_id', 0, k); d = 0; e = a
    while True:
        if text[e] == '(': d += 1
        elif text[e] == ')':
            d -= 1
            if d == 0: break
        e += 1
    return a, e + 1, text[a:e + 1]
old = {}
for r in ('U8', 'U9', 'U10', 'J2', 'J3'):
    a, e, b = symblock(rt, r); old[r] = (a, e, b)

# ------------------------------------------------------------------ sheet building (local coords, y up, 1.27 mm grid)
OX, OY = 190.5, 95.25
def P(lx, ly):
    x, y = OX + lx, OY - ly
    for v in (x, y):
        assert abs(v / 1.27 - round(v / 1.27)) < 1e-3, ('off grid', lx, ly)
    return x, y
PT = lambda lx, ly: (OX + lx, OY - ly)      # text positions need not be on the grid
items = []
def wire(*pts):
    for a, b in zip(pts, pts[1:]):
        (x1, y1), (x2, y2) = P(*a), P(*b)
        items.append(f'(wire (pts (xy {f(x1)} {f(y1)}) (xy {f(x2)} {f(y2)})) (stroke (width 0) (type default)) (uuid "{U()}"))')
def junc(a):
    x, y = P(*a); items.append(f'(junction (at {f(x)} {f(y)}) (diameter 0) (color 0 0 0 0) (uuid "{U()}"))')
def nc(a):
    x, y = P(*a); items.append(f'(no_connect (at {f(x)} {f(y)}) (uuid "{U()}"))')
def hlabel(n, shape, a, ang):
    x, y = P(*a)
    j = 'left bottom' if ang == 0 else 'right bottom'
    items.append(f'(hierarchical_label "{n}" (shape {shape}) (at {f(x)} {f(y)} {ang}) (effects (font (size 1.0 1.0)) (justify {j})) (uuid "{U()}"))')
def label(n, a, just='left bottom'):
    x, y = P(*a); items.append(f'(label "{n}" (at {f(x)} {f(y)} 0) (effects (font (size 1 1)) (justify {just})) (uuid "{U()}"))')
def text(s, a, size=1):
    x, y = P(*a)
    items.append(f'(text "{s}" (at {f(x)} {f(y)} 0) (effects (font (size {size} {size})) (justify left bottom)) (uuid "{U()}"))')
pw = [1001]
def gnd(a):
    x, y = P(*a); n = pw[0]; pw[0] += 1
    items.append(f'(symbol (lib_id "power:GND") (at {f(x)} {f(y)} 0) (unit 1) (exclude_from_sim no) (in_bom no) (on_board no) (dnp no) (uuid "{U()}") '
                 f'(property "Reference" "#PWR{n}" (at {f(x)} {f(y+3.81)} 0) (effects (font (size 1.27 1.27)) (hide yes))) '
                 f'(property "Value" "GND" (at {f(x)} {f(y+5.08)} 0) (effects (font (size 1.27 1.27)) (hide yes))) '
                 f'(pin "1" (uuid "{U()}")) (instances (project "DesktopSpeaker" (path "/{ROOT_UUID}/{SHEET_UUID}" (reference "#PWR{n}") (unit 1)))))')
def passive(lib, ref, val, fp_, mpn, mfr, lcsc, a, rot, tpos, just='left'):
    x, y = P(*a)
    (rx, ry), (vx, vy) = [PT(*t) for t in tpos]
    j = f'(justify {just})' if just else ''
    tang = 270 if rot == 90 else 0
    items.append(f'(symbol (lib_id "{lib}") (at {f(x)} {f(y)} {rot}) (unit 1) (exclude_from_sim no) (in_bom yes) (on_board yes) (dnp no) (uuid "{U()}") '
                 f'(property "Reference" "{ref}" (at {f(rx)} {f(ry)} {tang}) (effects (font (size 1.27 1.27)) {j})) '
                 f'(property "Value" "{val}" (at {f(vx)} {f(vy)} {tang}) (effects (font (size 1.27 1.27)) {j})) '
                 f'(property "Footprint" "{fp_}" (at {f(x)} {f(y)} 0) (hide yes) (effects (font (size 1.27 1.27)))) '
                 f'(property "MPN" "{mpn}" (at {f(x)} {f(y)} 0) (hide yes) (effects (font (size 1.27 1.27)))) '
                 f'(property "Manufacturer" "{mfr}" (at {f(x)} {f(y)} 0) (hide yes) (effects (font (size 1 1)))) '
                 f'(property "LCSC" "{lcsc}" (at {f(x)} {f(y)} 0) (hide yes) (effects (font (size 1 1)))) '
                 f'(pin "1" (uuid "{U()}")) (pin "2" (uuid "{U()}")) '
                 f'(instances (project "DesktopSpeaker" (path "/{ROOT_UUID}/{SHEET_UUID}" (reference "{ref}") (unit 1)))))')
def res(ref, val, part, a, horizontal=False):
    mpn, mfr, lcsc = part; x, y = a
    if horizontal: passive('PD_R:PD_R', ref, val, 'DesktopSpeaker:PD_R_0603', mpn, mfr, lcsc, a, 90, ((x, y + 4.7), (x, y + 3.2)), just=None)
    else: passive('PD_R:PD_R', ref, val, 'DesktopSpeaker:PD_R_0603', mpn, mfr, lcsc, a, 0, ((x + 1.27, y + 1.27), (x + 1.27, y - 1.27)))
def cap(ref, val, part, a, horizontal=False):
    fp_, mpn, mfr, lcsc = part; x, y = a
    if horizontal: passive('PD_C:PD_C', ref, val, fp_, mpn, mfr, lcsc, a, 90, ((x, y + 4.7), (x, y + 3.2)), just=None)
    else: passive('PD_C:PD_C', ref, val, fp_, mpn, mfr, lcsc, a, 0, ((x + 1.27, y + 1.27), (x + 1.27, y - 1.27)))
def vcap(ref, val, part, top):   # vertical cap whose top pin sits at `top`; ground symbol below
    x, y = top; cap(ref, val, part, (x, y - 3.81)); gnd((x, y - 7.62))
def vres(ref, val, part, top):
    x, y = top; res(ref, val, part, (x, y - 3.81))

SAM = 'Samsung Electro-Mechanics'
C100N = ('DesktopSpeaker:PD_C_0603', 'CL10B104KB8NNNC', SAM, 'C1591')
C1U = ('DesktopSpeaker:PD_C_0805', 'CL21B105KBFNNNE', SAM, 'C28323')
C2U2 = ('DesktopSpeaker:PD_C_0805', 'CL21B225KAFNNNE', SAM, 'C19110')
C4U7 = ('DesktopSpeaker:PD_C_1206', 'CL31B475KBHNNNE', SAM, 'C51205')
RY = lambda mpn, lcsc: (mpn, 'YAGEO', lcsc)
R100K = RY('RC0603FR-07100KL', 'C14675'); R1K = RY('RC0603FR-071KL', 'C22548'); R47K = RY('RC0603FR-0747KL', 'C105579')
R10K = RY('RC0603FR-0710KL', 'C98220'); R1M = RY('RC0603FR-071ML', 'C105578')
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
