chithigun23/DesktopSpeaker/(commit log)

2026-09-27 Intial commit
    [BM83SM1-00TA.step, BQ25895RTWR.step, DesktopSpeaker.kicad_sch, MAX17048G+T10.step, PCM2902CDBR.step, STM32G031K8T6.step, TAS5825MRHBR.step]
2026-10-05 Capture and review speaker power subsystem schematics and libraries
    [2N7002.step, BSC014N06NS.step, BZT52C12-7-F.step, Battery_Charger.kicad_sch, Bluetooth_Power.kicad_sch, Bourns_SRN6045TA-1R0Y.step, Bourns_SRN6045TA-2R2Y.step, C_0603_1608Metric.step]
2026-10-05 Record 5-20V redesign direction and retain active hardware limits
    [USB_PD.kicad_sch]
2026-10-05 Select wide-range power architecture and record startup constraints
2026-10-05 Integrate USB auxiliary logic mux and reconcile active BOM
    [DesktopSpeaker.kicad_sch, DesktopSpeaker_LCSC_Starter_BOM.csv, DesktopSpeaker_LCSC_Starter_BOM.xlsx, Fuel_Gauge_Power.kicad_sch, RQM0029A.stp, TPS2116DRLR.step, USB_PD.kicad_sch]
2026-10-05 Prepare ship FET library and correct shared PD bulk capacitance target
    [DNH0008A.stp]
2026-10-05 Record input capacitor selection and review charger startup semantics
2026-10-05 Preserve isolated charger draft and explicit review findings
    [Battery_Charger.kicad_sch]
2026-10-05 Review all charger draft pin groups and retain metadata style gates
2026-10-05 Record independent power review and rough enclosure fit check
2026-10-05 Qualify gauge bus by battery voltage and reconcile supervisor BOM
    [DesktopSpeaker_LCSC_Starter_BOM.csv, DesktopSpeaker_LCSC_Starter_BOM.xlsx, Fuel_Gauge_Power.kicad_sch, TPS3839G33DBZ_SOT23.step]
2026-10-05 Checkpoint isolated BQ25792/TPS25730D/TPS2116 candidates, Q100 metadata and tool wrappers
    [Battery_Charger.kicad_sch, CSD17579Q3A-footprint-preview.kicad_pcb, CSD17579Q3A_DNH0008A.step, DNH0008A.stp, Fuel_Gauge_Power.kicad_sch, REF0038A.stp, REF0038A_alignment_preview.kicad_pcb, RQM0029A.stp]
2026-10-05 Redraw TPS25730D and BQ25792 candidates readable; record handoffs and 5-20 V PD scope decision
    [Battery_Charger.kicad_sch, TPS25730D_USB_PD_candidate.kicad_sch]
2026-10-05 Apply Opus-reviewed must-fix items to PD and charger candidates
    [Battery_Charger.kicad_sch, DesktopSpeaker_LCSC_Starter_BOM.xlsx, TPS25730D_USB_PD_candidate.kicad_sch, candidate_fixes_BOM.csv]
2026-10-05 Integrate TPS25730D PD and BQ25792 charger into active project (5-20 V); update BOM, plan, handover, preview
    [Battery_Charger.kicad_sch, DesktopSpeaker.kicad_sch, DesktopSpeaker_LCSC_Starter_BOM.csv, DesktopSpeaker_LCSC_Starter_BOM.xlsx, REF0038A.stp, USB_PD.kicad_sch]
2026-10-05 Select R10/C182/C183 parts; add pack, connector and switch options report
    [DesktopSpeaker_LCSC_Starter_BOM.csv, DesktopSpeaker_LCSC_Starter_BOM.xlsx, USB_PD.kicad_sch]
2026-10-05 Select J5 Micro-Fit, SW100 tactile and SW101 rocker; add footprints and decisions
    [Battery_Charger.kicad_sch, DesktopSpeaker_LCSC_Starter_BOM.csv, DesktopSpeaker_LCSC_Starter_BOM.xlsx]
2026-10-05 Capture MCU sheet (STM32G031) with pin allocation and power-block connections
    [DesktopSpeaker.kicad_sch, DesktopSpeaker_LCSC_Starter_BOM.csv, DesktopSpeaker_LCSC_Starter_BOM.xlsx, MCU.kicad_sch, PinHeader_1x05_P2.54mm_Vertical.step]
2026-10-05 Capture USB audio (PCM2902C) child sheet, J1 data path and D1 ground
    [Crystal_SMD_3225-4Pin_3.2x2.5mm.step, DesktopSpeaker.kicad_sch, DesktopSpeaker_LCSC_Starter_BOM.csv, DesktopSpeaker_LCSC_Starter_BOM.xlsx, USB_Audio.kicad_sch]
2026-10-05 Replace SWD header with TC2030-IDC and 4-pin header; set USB audio crystal caps and resistor parts
    [DesktopSpeaker_LCSC_Starter_BOM.csv, DesktopSpeaker_LCSC_Starter_BOM.xlsx, MCU.kicad_sch, USB_Audio.kicad_sch]
2026-10-05 Capture Bluetooth BM83 child sheet with MCU UART/reset/MFB connections
    [Bluetooth.kicad_sch, DesktopSpeaker.kicad_sch, DesktopSpeaker_LCSC_Starter_BOM.csv, DesktopSpeaker_LCSC_Starter_BOM.xlsx, MCU.kicad_sch]
2026-10-05 Add audio chain architecture decisions
2026-10-05 Swap MCU to STM32G071RBT6; full audio-chain pin allocation and QON sense
    Claude-Session: https://claude.ai/code/session_01N5RHheWSjDFDPbKVD5YVeJ
    [Battery_Charger.kicad_sch, DesktopSpeaker.kicad_sch, DesktopSpeaker_LCSC_Starter_BOM.csv, DesktopSpeaker_LCSC_Starter_BOM.xlsx, MCU.kicad_sch, STM32G071RBT6.step]
2026-10-05 Capture Source_Select_ADC sheet (PCM1862, 3V3_AUDIO LDO, codec load switch)
    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
    [DesktopSpeaker.kicad_sch, DesktopSpeaker_LCSC_Starter_BOM.csv, DesktopSpeaker_LCSC_Starter_BOM.xlsx, MCU.kicad_sch, PCM1862DBTR.step, Source_Select_ADC.kicad_sch, TPS22917DBVR.step, TPS7A2033PDBVR.step]
2026-10-05 Capture Headphone_Aux sheet (TS5A23157 mux, TPA6132A2, jacks) and wire MCU headphone signals
    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
    [DesktopSpeaker.kicad_sch, DesktopSpeaker_LCSC_Starter_BOM.csv, DesktopSpeaker_LCSC_Starter_BOM.xlsx, Headphone_Aux.kicad_sch, MCU.kicad_sch, PESD5V0S2BT.step, Source_Select_ADC.kicad_sch]
2026-10-05 Capture Amplifiers sheet (TPS61088 boost, TAS5825M x2, speaker outputs); correct PBTL pairing
    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
    [Amplifiers.kicad_sch, CP_Elec_8x10.step, DesktopSpeaker.kicad_sch, DesktopSpeaker_LCSC_Starter_BOM.csv, DesktopSpeaker_LCSC_Starter_BOM.xlsx, L_Coilcraft_XAL7070-XXX.step, L_Sunlord_MWSA1265S.step, MCU.kicad_sch]
2026-10-05 Final integration cleanup: BQ25792 symbol sync, BAT_INT/BATP flags, BOM sweep, plan and open-items list
    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
    [Battery_Charger.kicad_sch, DesktopSpeaker_LCSC_Starter_BOM.csv, DesktopSpeaker_LCSC_Starter_BOM.xlsx, USB_PD.kicad_sch]
2026-10-05 Add parametric FreeCAD model of speaker internals (real drivers, 2P 21700 pack, M3x10 hardware, estimated PCB)
    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
    [DesktopSpeaker_internal.FCStd, DesktopSpeaker_internal.step, ND65-4 and 8.step, ND65-4 and 8.stl, ND65-4_and_8.dwg, pcb_estimate.json]
2026-10-05 Repackage passives to 0402/0805 hand-solder footprints; update BOM and flags
    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
    [Amplifiers.kicad_sch, Battery_Charger.kicad_sch, Bluetooth.kicad_sch, Bluetooth_Power.kicad_sch, C_0402_1005Metric.step, DesktopSpeaker_LCSC_Starter_BOM.csv, DesktopSpeaker_LCSC_Starter_BOM.xlsx, Fuel_Gauge_Power.kicad_sch]
2026-10-05 Place all footprints on 114x92 mm board (no routing); update CAD from layout; add placement report and renders
    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
    [DesktopSpeaker.kicad_pcb, DesktopSpeaker_internal.FCStd, DesktopSpeaker_internal.step]
2026-10-05 Apply low-risk passive cuts (11 parts) and normalise BOM; add layout rules and BOM audit reports
    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
    [Amplifiers.kicad_sch, Battery_Charger.kicad_sch, Bluetooth_Power.kicad_sch, DesktopSpeaker_LCSC_Starter_BOM.csv, DesktopSpeaker_LCSC_Starter_BOM.xlsx, Fuel_Gauge_Power.kicad_sch, Headphone_Aux.kicad_sch, Logic_Audio_Power.kicad_sch]
2026-10-06 PCB placement v2: 116x96 mm, PTH GND mounting holes, zoning and distance check; CAD rebuilt
    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
    [DesktopSpeaker.kicad_pcb, DesktopSpeaker_internal.FCStd, DesktopSpeaker_internal.step]
2026-10-06 PCB placement v3: 116x112 mm, separation rules met, decoupling tightened; CAD rebuilt
    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
    [DesktopSpeaker.kicad_pcb, DesktopSpeaker_internal.FCStd, DesktopSpeaker_internal.step, pcb_estimate.json]
2026-10-06 Add PCB routing plan; install netclasses, custom DRC rules, stackup and teardrop parameters (no routing)
    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
    [DesktopSpeaker.kicad_pcb]
2026-10-06 WIP placement v4: tiled functional cells with section boxes (board larger than v3; compaction pending)
    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
    [DesktopSpeaker.kicad_pcb, DesktopSpeaker_internal.FCStd, DesktopSpeaker_internal.step]
2026-10-06 Placement v5: tiled functional cells at minimum separations, better decoupling, woofer chamber auto-sized; CAD rebuilt
    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
    [DesktopSpeaker.kicad_pcb, DesktopSpeaker_internal.FCStd, DesktopSpeaker_internal.step]
2026-10-06 Placement v6: shrink-wrapped tiles, 116x138 mm (area/depth targets unmet; decap snap pass pending)
    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
    [DesktopSpeaker.kicad_pcb, DesktopSpeaker_internal.FCStd, DesktopSpeaker_internal.step]
2026-10-06 Decap snap: 0402 decoupling caps against supply pins, reference labels on F.Fab; min_text_height restore
    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
    [DesktopSpeaker-v6.kicad_pcb, DesktopSpeaker.kicad_pcb]
2026-10-06 Placement v8: sequence-pair compaction, 121x127 mm, 10 PTH GND mounting holes, larger section titles; CAD refit (0 overlaps)
    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
    [DesktopSpeaker.kicad_pcb, DesktopSpeaker_internal.FCStd, DesktopSpeaker_internal.step]
2026-10-06 Placement v9: EC11E volume encoder, 25 test points, silkscreen pass (closed sections, border, hole squares, labels), Orwellian logo on back, CAD refit
    Claude-Session: https://claude.ai/code/session_016fe4xPJbEE2SjGafuyNLjb
    [Amplifiers.kicad_sch, Battery_Charger.kicad_sch, Bluetooth.kicad_sch, Bluetooth_Power.kicad_sch, DesktopSpeaker.kicad_pcb, DesktopSpeaker_LCSC_Starter_BOM.csv, DesktopSpeaker_internal.FCStd, DesktopSpeaker_internal.step]
2026-10-06 EC11E: official Alps STEP model linked to the footprint; CAD uses it
    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
    [DesktopSpeaker.kicad_pcb, DesktopSpeaker_internal.FCStd, DesktopSpeaker_internal.step, EC11E15244G1.step]
2026-10-06 Placement v9b: mounting holes moved (encoder support, woofer inductor row, amp gap); CAD refit
    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
    [DesktopSpeaker-p0-zones-vias.kicad_pcb, DesktopSpeaker-v9-placement.kicad_pcb, DesktopSpeaker.kicad_pcb, DesktopSpeaker_internal.FCStd, DesktopSpeaker_internal.step, route-p0-input.dsn]
2026-10-06 Restore placement v9b board with routing rules (netclasses/stackup) re-applied; build script re-applies rules; remove stale routing trial files
    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
    [DesktopSpeaker-p0-zones-vias.kicad_pcb, DesktopSpeaker-v9-placement.kicad_pcb, DesktopSpeaker-v9b-placement.kicad_pcb, route-p0-input.dsn]
2026-10-06 Routing phase 0: GND planes, In2 rail islands, F.Cu pours, 203 GND vias, rail vias; Freerouting trial (draft, not adopted); routing P0 scripts and report
    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
    [DesktopSpeaker-p0-routed.kicad_pcb, DesktopSpeaker-p0-zones-vias.kicad_pcb, DesktopSpeaker-v9-placement.kicad_pcb, route-p0-batchA.dsn, route-p0-batchB.dsn]
2026-10-07 Netclass patterns: expand [..] ranges to exact net names (KiCad patterns do not support ranges; 30 audio/speaker nets were falling into SIGNAL); routing P1 helper scripts and notes
    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
    [A1-0.dsn, A1-0.in.dsn, A1-1.dsn, A1-1.in.dsn, A1-2.dsn, A1-2.in.dsn, A1-3.dsn, A1-3.in.dsn]
2026-10-07 Routing P1-P3 scripts and notes, layout best-practices, routing review (draft board not adopted)
    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
2026-10-07 Routing plan: 0.5 oz inner copper at 15 K rise, In2 power-only
    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
2026-10-08 Schematic: add C311-C316, TP26/27; placement v10 to v10d (reviewed), reports and generators
    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
    [Amplifiers.kicad_sch, Battery_Charger.kicad_sch, DesktopSpeaker-v10d.kicad_pcb, DesktopSpeaker_LCSC_Starter_BOM.csv, USB_PD.kicad_sch]
2026-10-10 Routing R6a-R6m adopted into project board; ERC cleanup, MCU pin swaps, C241 2.2uF, SW100 footprint fix, reviews and helpers
    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
    [DesktopSpeaker.kicad_pcb, DesktopSpeaker.kicad_sch, Headphone_Aux.kicad_sch, MCU.kicad_sch, R6m-final.kicad_pcb, Source_Select_ADC.kicad_sch, USB_Audio.kicad_sch]
2026-10-10 BOM sourcing pass: LCSC codes, stock, coordinator-approved substitutions, xlsx refresh
    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
    [DesktopSpeaker_LCSC_Starter_BOM.csv, DesktopSpeaker_LCSC_Starter_BOM.xlsx]
2026-10-10 Y200 24.576 MHz crystal with 15 pF load caps, C275 3D model, schematic/PCB sourcing fields synced to BOM
    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
    [Amplifiers.kicad_sch, Battery_Charger.kicad_sch, Bluetooth.kicad_sch, Bluetooth_Power.kicad_sch, CP_Elec_6.3x7.7.step, DesktopSpeaker.kicad_pcb, DesktopSpeaker_LCSC_Starter_BOM.csv, DesktopSpeaker_LCSC_Starter_BOM.xlsx]
2026-10-10 Handover and plan refresh: PCB state, decisions, remaining steps, bench order
    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
2026-10-10 R6n adopted: J7 nets routed (0 open edges), stronger U4 PGND return
    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
    [R6n-final.kicad_pcb]
2026-10-11 Datasheet links for substituted parts, new datasheet PDFs, pin-allocation note fix
    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
2026-10-11 R6o adopted: DRC 0/0 (silk cleared, USB FS waiver rule, audio GND vias), library silk fixes, ignore intermediate boards
    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
2026-10-11 Track v10d placement inputs; ignore pre-R6m intermediate finals
    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
2026-10-11 R6p adopted: slow-signal geometry cleanup (16 nets shortened, -75 vias), teardrop strip/prune tools, fab export helper
    - Project board = R6p-final: DRC 0/0, 0 open edges, USB/I2S copper and footprints unchanged vs R6o; rules unchanged.
    - GUI teardrop pass of 2026-10-11 stripped (stale fills caused the 499 clearance items); U14-L2 GUI polyline redraw reverted to the 1.0 mm arc; td_curve_segcount back to 5.
    - helpers: route_td_strip.py, route_td_prune.py, route_r6p_geom/improve/cucmp/netsvg/try/dangle.py, fab_export.sh (gerbers, drills, JLC CPL).
    - .gitignore: KiCad local history, stray plugin log, work-r6 prl files, R6p finals tracked.
    - Handover: R6p update and revised remaining fab steps.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
2026-10-11 JLC assembly BOM from schematic fields (90 lines, 318 placements) with assembly notes
    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
2026-10-11 Fab order notes draft (stackup, finish, via covering, assembly scope, pre-order checklist)
    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
2026-10-11 Teardrop curve flag back to the KiCad 10 GUI value (1 = curved); handover wording
    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
2026-10-11 Teardrops applied on the R6p board (pads 1.0 mm, vias 0.6 mm, curved), refill, DRC 0/0; fab outputs R7 (gerbers, drills, position files)
    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
2026-10-11 3D model offsets: BM83 z -5.41 mm (was floating), XFL4015 z 1.5 mm (was inside the board), library and board; project file as saved by the GUI
    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
2026-10-11 CAD v11: enclosure rebuilt from the routed board (board STEP, real holes/courtyards), print-ready shell + woofer-chamber insert + lid (STL), gasket/cradle/grommet details; derived STEP/brep outputs u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
2026-10-11 Handover: CAD v11, mechanical decisions, 3D offset fix
    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
2026-10-11 Top-layer render of the final teardropped board
    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
2026-10-11 R6q: SW100 and R113 moved 4 mm away from the USB-C (lid web 0.4 -> 4.4 mm), QON/sense/GND re-routed, silk box adjusted; DRC 0/0, all gates equal to R6p (teardrops to follow)
    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
2026-10-11 fab_check.py: numeric consistency checks for fab outputs (layers, extents, flashes, drill hits, positions)
    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
2026-10-11 BOM workbook rows SW101/SW102 synced with the substitutions (guarded helper)
    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
2026-10-11 R6q with teardrops (1825 zones), DRC 0/0; fab outputs R8 (gerbers, drills, position files) replace R7; handover and order notes
    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
2026-10-11 JLC BOM regenerated with the SW102 substitution (jlc_bom.py helper); plan PCB status refreshed
    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
2026-10-11 Re-apply BM83/XFL4015 3D model offsets on the R6q board (lost when R6q was built from the R6p work copy)
    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
2026-10-11 CAD v11.1/v11.2: knob dish over SW102, rebuild from the R6q board (separate J1/SW100 lid openings), woofer cutout 76.2, rocker GRB112B802BR1 pocket; handover; ignore work-r6 gate files and CAD work b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
2026-10-11 Battery pack RFQ draft for the user
    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
2026-10-11 4K isometric 3D render of the final board
    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
2026-10-12 Bench bring-up plan (staged sheet with expected values and stop conditions); handover corrections from the netlist cross-check
    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
2026-10-12 Release review R8 (Fable): fix TPS25730D power-pad mask/paste openings (comb polygons -> solid rectangles, library + board), R256 DNP and SW101 pos-exclusion on the board; fab outputs R9; order/assem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
2026-11-01 Routing review R6q and restart decision: review report, metrics script, routing standard (AGENTS, best-practices s14), BOM restock findings, firmware spec, power analysis; handover and plan updated
2026-11-01 Hand-assembly (stencil and hotplate, leaded paste) research and rulebook HA rules
    Claude-Session: https://claude.ai/code/session_01V89GrHhHA3UBwbPNu3Fczr
2026-11-01 Placement R10 (I2S/I2C/USB topology fixes, verified: DRC 0, pad nets unchanged, HA8 pairs unchanged) as routing base
    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
2026-11-01 Router upgrade: BM83 keep-out, audio halo, GND stitching vias, SP3, pour check (S1 22/31, S2 55/95 on R10-0)
    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
2026-11-01 Staged routing S1-S3 (RT-2): 145/283 connections, exact 0/45/90, DRC 0; unrouted table and handover
    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
2026-11-02 Silkscreen section boxes tiling (RT-3) and charge policy (ICHG 4 A, 17 W input cap, firmware-only)
    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
2026-11-02 Routing progress site: silkscreen and charge policy done
    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
2026-11-02 Silkscreen: MCU title below U3, TC2030 label above J7 (gates pass, DRC unchanged)
    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
2026-11-02 CAD v12 rebuilt from board RT-3 (0 unintended overlaps, knob dish axis fixed), web export scripts and renders
    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
2026-11-02 Project website source (specs, BOM, interactive CAD viewer, routing progress sub-page)
    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
2026-11-02 CAD accuracy audit: models-v13 (19 verified/built STEP models), accuracy table (340/346 parts within 0.5 mm), v13 3D links applied to the project library
    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
2026-11-02 CAD v13 (audited models, real woofer geometry, 0 unintended overlaps), site data refresh, handover
    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
2026-11-02 RT-5: footprint fixes (PJ-307, BM83 pad 56, TE SW100, C275 land) on board and library, PROG routed, DRC 0
    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
2026-11-02 Site refresh: RT-5 status and footprint fixes
    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
2026-11-02 RT-9: PDCTRL_SCL and BT_SYS_CFG routed, 53 unconnected, DRC 0 (verified); schematic patch proposals P4/P5
    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
2026-11-02 Schematic patches P1/P4/P5 (CHG_INT not wired, PDCTRL_SDA on PB13, J7-3 NC) and synced board RT-9p: DRC 0, 50 unconnected (verified)
    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
2026-11-02 Site refresh: RT-9p status and schematic changes
    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
2026-11-02 Battery pack 1S3P/1S4P feasibility: 4P fits with a new shell cradle only, board unchanged
    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
2026-11-02 Draft release package on RT-14 (regen_final.sh, draft fab outputs, stencil report, hand-assembly sheet), CAD v14, release to-do
    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
2026-11-02 Battery 4P report: reconcile shell volume, mass and centre of mass with the final run
    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
2026-11-03 CAD v15 (1S4P pack, real wiring with crimps, countersunk T10 screws), pack decision docs, BOM and RFQ updates
    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
2026-11-03 Fastener schedule (T10 post-Torx, Bolt and Nut) and CAD completeness / project review reports
    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
2026-11-03 Review fixes: buy list, pack RFQ (fuse, thermal cut-off, 22.3 mm), mechanical BOM, plan and handover updated; status of every review finding
    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
2026-11-03 Web viewer: snapping view cube (faces, edges, corners), realistic PCB from RT-15H (mask, ENIG, silkscreen textures), refreshed gallery
    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
