chithigun23/DesktopSpeaker/(notices)

Notices in the files:
DesktopSpeaker-kicad/kicad-library/3d/PD_C_1206.step:
Copyright (C) 2017, kicad StepUp
This work is licensed under the [Creative Commons CC-BY-SA 4.0 License](https://creativecommons.org/licenses/by-sa/4.0/legalcode),
with the following exception:
To the extent that the creation of electronic designs that use 'Licensed Material' can be considered to be 'Adapted Material',
You are free to use the library data in your own projects without the obligation to share your project files under this or any other license agreement.
DesktopSpeaker-kicad/kicad-library/3d/SMA6J10A.step:
This program is free software: you can redistribute it and/or modify
it under the terms of the GNU General Public License as published by
the Free Software Foundation, either version 3 of the License, or
any later version.
itself might be covered by the GNU General Public License.
DesktopSpeaker-kicad/kicad-library/3d/R_0603_1608Metric.step:
Copyright (C) 2018, kicad StepUp
DesktopSpeaker-kicad/kicad-library/3d/TVS2200DRVR.step:
Copyright (C) 2020, kicad StepUp
DesktopSpeaker-kicad/kicad-library/3d/D_SOD-123.step:
Copyright (C) 2025, KiCAD
This work is licensed under the
[Creative Commons CC-BY-SA 4.0 License](https://creativecommons.org/licenses/by-sa/4.0/legalcode),
project files under this or any other license agreement. However, if you wish to distribute
DesktopSpeaker-kicad/kicad-library/3d/L_Coilcraft_XAL7070-XXX.step:
Copyright (C) 2024, KiCAD
